LcAvila/grade_moldes/src/main/webapp/assets/images/pecas/_substituidas/187.png

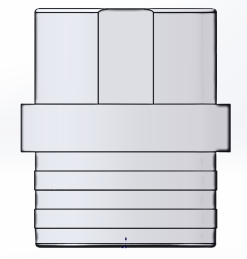
src/main/webapp/assets/images/pecas/_substituidas/187.png
