LcAvila/grade_moldes/src/main/webapp/assets/Produtos/00-00 - BASE DE DADOS/Embalagens/Caixas Master/Textura Papelão.png

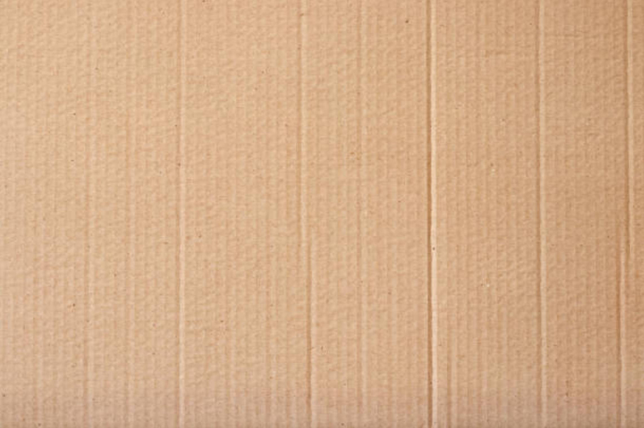
src/main/webapp/assets/Produtos/00-00 - BASE DE DADOS/Embalagens/Caixas Master/Textura Papelão.png
