LcAvila/grade_moldes/docs/desenhos-extraidos.md

# Desenhos extraídos das planilhas

Repositório: `C:\Users\Avila\AppData\Local\Temp\opencode\pastas`

| Molde | Peça injetada | Desenho da grade | Origem |
|---|---|---|---|
| **11A** | – | – | `C:\Users\Avila\AppData\Local\Temp\opencode\pastas\02-Cavidade não conforme\Colas\Bicos\Bico Frasco de Cola - Molde 11A\01-23.01.25 - Bico para frasco de cola 40g e 90g - 16 cav. - Molde 11A.xlsx` |
| **69** | – | – | `C:\Users\Avila\AppData\Local\Temp\opencode\pastas\02-Cavidade não conforme\Lapiseiras\Botões\Botão Lapiseira Turbo - 8 Cav - Molde 69\01-13.09.2018-Botão Lapiseira Turbo Plus - 8 Cav. - Molde 69.xls` |
| **81** | – | – | `C:\Users\Avila\AppData\Local\Temp\opencode\pastas\02-Cavidade não conforme\Reabastecedores\Anel\2017\03 - 28-04-17 - Anel Para Reabastecedor - 8 Cav. - Molde 81.xls` |
| **89** | – | – | `C:\Users\Avila\AppData\Local\Temp\opencode\pastas\02-Cavidade não conforme\Lapiseiras\Corpos\Corpo Lapiseira Aluno - 16 Cav - Molde 89\2019\01-05.02.19-Corpo Lapiseira Aluno - 16 Cav. - Molde 89.xls` |
| **97** | assets/images/pecas/97.png (1920×1080) | assets/desenhos/97-grade.svg (356×365) | `02-Cavidade não conforme\Esferográficas\Tampinhas\Tampinha Esf. - 64 Cav - Molde 97\2023\06- 21.07.23-Tampinha Esferográfica - Molde 97.xls` |
| **98** | assets/images/pecas/98.png (235×240) | assets/desenhos/98-grade.svg (356×365) | `02-Cavidade não conforme\Esferográficas\Conexão\Conexão Esf. - 64 Cav-Molde 98\2024\06-11.11.24-Conexão Esf. - 64 cav. - Molde 98.xls` |
| **101** | assets/images/pecas/101.png (1920×1080) | assets/desenhos/101-grade.svg (356×365) | `02-Cavidade não conforme\Hidrográficas\Tampinha\Tampinha Hidrog. Neo Pen - 64 Cav - Mol.101\2025\18-05.12.24-Tampinha Neo Pen - Molde 101.xls` |
| **107** | – | – | `C:\Users\Avila\AppData\Local\Temp\opencode\pastas\02-Cavidade não conforme\Esferográficas\Tampas\Tampa Esf. Top- 64 Cav- Molde 107\2025\10 -04.04.25 -Tampa Esf. Top-Economic - 64 cav. - Molde 107.xls` |
| **108** | – | assets/desenhos/108-grade.svg (467×465) | `02-Cavidade não conforme\Esferográficas\Corpos\Corpo 07- 64Cav - Molde 108\2020\01-06.02.20-Corpo Esf. 07-Econ. - Molde 108.xls` |
| **109** | – | assets/desenhos/109-grade.svg (538×544) | `02-Cavidade não conforme\Hidrográficas\Tampinha\Tampinha Hidrog. Color - 48 Cav - Molde 109\2025\04-14.05.25-Tampinha Hidr. Color - 48 cav. - Molde 109 (PP).xls` |
| **110** | assets/images/pecas/110.png (776×322) | assets/desenhos/110-grade.svg (538×544) | `02-Cavidade não conforme\Hidrográficas\Tampa\Tampa Hidrog. Color - 48 Cav - Molde 110\2025\05-11.02.25- Tampa Hidr. Color - 48 cav. - Molde 110 -.xls` |
| **115** | – | – | `C:\Users\Avila\AppData\Local\Temp\opencode\pastas\02-Cavidade não conforme\Esferográficas\Corpos\Corpo 07- 64 Cav - Molde 115\2018\05-25.06.18-Corpo Esf. 07 - 64 Cav. - Molde 115.xls` |
| **116** | – | – | `C:\Users\Avila\AppData\Local\Temp\opencode\pastas\02-Cavidade não conforme\Marcadores\Corpos Marcadores\Corpo Marcador Pincel - 16 Cav - Molde 116\2019\07-08.07.19-Corpo Pincel Permanente. - 16 cav. - Molde 116.xlsx` |
| **116A** | – | – | `C:\Users\Avila\AppData\Local\Temp\opencode\pastas\02-Cavidade não conforme\Marcadores\Corpos Marcadores\Corpo Marcador Q.B. - 16 Cav - Molde 116A\2025\02- 16.01.25 - Corpo Marcador Q.B. - 16 cav. - Molde 116A.xlsx` |
| **117** | – | – | `C:\Users\Avila\AppData\Local\Temp\opencode\pastas\02-Cavidade não conforme\Esferográficas\Tampas\Tampa Esf. 07- 64 Cav - Molde 117\2024\03-08.07.24-Tampa Esf. 07 - 64 cav. - Molde 117.xls` |
| **120** | – | assets/desenhos/120-grade.svg (467×465) | `02-Cavidade não conforme\Hidrográficas\Corpo\Corpo Hidrog. HNG - 64 Cav - Molde 120\2020\06-20.08.20-Corpo Hid. Neo Pen Gigante - 64 cav. - Molde 120.xls` |
| **121** | – | – | `C:\Users\Avila\AppData\Local\Temp\opencode\pastas\02-Cavidade não conforme\Hidrográficas\Corpo\Corpo Hidrog. HNM - 64 Cav - Molde 121\2025\05-23.05.25- Corpo Hid. Neo Pen Mirim - 64 cav. - Molde 121.xls` |
| **122** | – | – | `C:\Users\Avila\AppData\Local\Temp\opencode\pastas\02-Cavidade não conforme\Hidrográficas\Tampa\Tampa Hidrog. Neo Pen - 48 Cav - Molde 122\2025\04- 04.06.25- Tampa Neo Pen - 48 cav. - Molde 122.xls` |
| **128** | assets/images/pecas/128.png (1920×1080) | – | `02-Cavidade não conforme\Diversos\Apagador - Molde 128\2023\01-03.10.23-Apagador para Q.B. - 1 cav. - Molde 128.xlsx` |
| **129** | – | assets/desenhos/129-grade.svg (602×401) | `02-Cavidade não conforme\Colas\Tampas\Tampa para Cola 1000g - Molde 129\01-10-04-2025-Tampa para frasco de cola 500g e 1000g - 4 cav.xlsx` |
| **137** | – | – | `C:\Users\Avila\AppData\Local\Temp\opencode\pastas\02-Cavidade não conforme\Lapiseiras\Corpos\Corpo Lapiseira Turbo - 8 Cav - Molde 137\2018\02-16.03.18-Corpo Lapiseira Turbo Plus - 08 Cav. - Molde 137.xls` |
| **138** | – | – | `C:\Users\Avila\AppData\Local\Temp\opencode\pastas\02-Cavidade não conforme\Esferográficas\Corpos\Corpo Top - 64 Cav - Molde 138\2018\06-20.09.18-Corpo Esf. Top - 64 Cav. - Molde 138.xls` |
| **139** | – | – | `C:\Users\Avila\AppData\Local\Temp\opencode\pastas\02-Cavidade não conforme\Esferográficas\Tampas\Tampa Esf. Top- 64 Cav - Molde 139\2025\04-09.06.25-Tampa Esf. Top-Economic - 64 cav. - Molde 139.xls` |
| **140** | assets/images/pecas/140.png (1920×1080) | assets/desenhos/140-grade.svg (356×365) | `02-Cavidade não conforme\Esferográficas\Tampinhas\Tampinha Esf. - 64 Cav - Molde 140\2024\04-02.09.24 - Tampinha Esferográfica - Molde 140.xls` |
| **143** | – | assets/desenhos/143-grade.svg (467×465) | `02-Cavidade não conforme\Esferográficas\Corpos\Corpo 07-Economic - 64 Cav - Molde 143\2020\01-09.12.19Corpo Esf. 07-Econ. - Molde 143.xls` |
| **144** | – | – | `C:\Users\Avila\AppData\Local\Temp\opencode\pastas\02-Cavidade não conforme\Hidrográficas\Corpo\Corpo Hidrog. HNG - 64 Cav - Molde 144\2016\02-22-02-16-Corpo NPG-64Cav-Mol 144-Lamb 47-21-1.xls` |
| **145A** | – | – | `C:\Users\Avila\AppData\Local\Temp\opencode\pastas\02-Cavidade não conforme\Colas\Tampas\Tampa para Cola 40 e 90g - Molde 145A\06 - 16.06.25- Tampa para frasco de cola 40g e 90g - 16 cav. - Molde 145A.xlsx` |
| **145B** | – | – | `C:\Users\Avila\AppData\Local\Temp\opencode\pastas\02-Cavidade não conforme\Marcadores\Tampas Marcadores\Tampa Marcador Pincel - 16 Cav - Molde 145B\2025\03 - 19.03.25 - Tampa Pincel - 16 cav. - Molde 145B.xlsx` |
| **145C** | – | – | `C:\Users\Avila\AppData\Local\Temp\opencode\pastas\02-Cavidade não conforme\Marcadores\Tampinhas Marcadores\Tampinha Marc. Pincel e Q.B. - 16 Cav - Molde 145C\2025\03 - 03.06.25 - Tampinha Pincel-Q.B. - 16 cav. - Molde 145C.xlsx` |
| **145D** | – | – | `C:\Users\Avila\AppData\Local\Temp\opencode\pastas\02-Cavidade não conforme\Reabastecedores\Tampas\Tampa p- Reabastecedor Q.B.- 16 Cav-Molde 145D\2024\05-29.11.24-Tampa Reab. Q.B. - 16 cav. - Molde 145D.xlsx` |
| **145E** | – | – | `C:\Users\Avila\AppData\Local\Temp\opencode\pastas\02-Cavidade não conforme\Reabastecedores\Tampas\Tampa p- Reabastecedor Pincel- 16 Cav-Molde 145E\2025\01-09.06.25 -Tampa Reab. Pincel - Molde 145E.xlsx` |
| **146** | assets/images/pecas/146.png (1920×1080) | assets/desenhos/146-grade.svg (356×365) | `02-Cavidade não conforme\Hidrográficas\Tampinha\Tampinha Hidrog. Neo Pen - 64 Cav - Mol.146\2024\06-07.10.24-Tampinha Neo Pen - Molde 146.xls` |
| **147A** | – | – | `C:\Users\Avila\AppData\Local\Temp\opencode\pastas\02-Cavidade não conforme\Hidrográficas\Tampa\Tampa Hidrog. Color - 32 Cav - Molde 147A\2024\02- 18.12.24 - Tampa Hidr. Color - 32 cav. - Molde 147A.xls` |
| **147B** | – | – | `C:\Users\Avila\AppData\Local\Temp\opencode\pastas\02-Cavidade não conforme\Hidrográficas\Tampinha\Tampinha Hidrog. Color - 32 Cav - Molde 147B\2025\01-29.10.22-Tampinha Hidr. Color - 32 cav. - Molde 147B.xls` |
| **148** | assets/images/pecas/148.png (1920×1080) | – | `02-Cavidade não conforme\Hidrográficas\Corpo\Corpo Hidrog. Color - 64 Cav - Molde 148\2025\02 - 12.02.25 - Corpo Hid. Color - 64 cav. - Molde 148.xls` |
| **150** | assets/images/pecas/150.png (709×258) | – | `02-Cavidade não conforme\Hidrográficas\Microline\Conexão Microline - 16 Cav- Molde 150\2025\04-17.06.25-Conexão Microline - 16 cav. - Molde 150.xlsx` |
| **151** | – | – | `C:\Users\Avila\AppData\Local\Temp\opencode\pastas\02-Cavidade não conforme\Hidrográficas\Microline\Tampinha Microline - 16 Cav - Molde 151\2025\02- 06.02.25- Tampinha Microline - 16 cav. - Molde 151.xlsx` |
| **152** | – | – | `C:\Users\Avila\AppData\Local\Temp\opencode\pastas\02-Cavidade não conforme\Hidrográficas\Microline\Tampa Microline - 16 Cav - Molde 152\2020\04-18.11.20-Tampa Hidr. Microline - 16 cav. - Molde 152.xlsx` |
| **153** | – | – | `C:\Users\Avila\AppData\Local\Temp\opencode\pastas\02-Cavidade não conforme\Esferográficas\Corpos\Corpo 07 Plus- 16 Cav - Molde 153\2019\02-08-05-2019 - Corpo Esf. 07 Plus - 16 cav. - Molde 153.xlsx` |
| **154** | assets/images/pecas/154.png (1249×702) | – | `02-Cavidade não conforme\Esferográficas\Tampas\Tampa Esf. 07 Plus- 16 Cav- Molde 154\2019\02-11.03.19-Tampa Esf. 07 Plus - 16 cav. - Molde 154.xlsx` |
| **156** | assets/images/pecas/156.png (1920×1080) | assets/desenhos/156-grade.svg (885×537) | `02-Cavidade não conforme\Esferográficas\Tampinhas\Tampinha Esf. - 16 Cav - Molde 156\2020\01-06-08-20-Tampinha Esf. - 16 cav. - Molde 156.xlsx` |
| **157** | assets/images/pecas/157.png (1920×1080) | – | `02-Cavidade não conforme\Reabastecedores\Bico\Bico p- Reabastecedor - 16 Cav - Molde 157\2025\01-25.01.25-Bico para reabastecedor - 16 cav. - Molde 157.xlsx` |
| **158** | – | – | `C:\Users\Avila\AppData\Local\Temp\opencode\pastas\02-Cavidade não conforme\Lapiseiras\Botões\Botão Lapiseira Técnico - 16 Cav - Molde 158\2024\02-20.08.24 - Botão lapiseira Técnico - 16 cav. - Molde 158.xlsx` |
| **159** | – | – | `C:\Users\Avila\AppData\Local\Temp\opencode\pastas\02-Cavidade não conforme\Lapiseiras\Corpos\Corpo Lapiseira Técnico - 16 Cav - Molde 159\2024\02-07.08.24-Corpo Lap. Técnico - 16 cav. - Molde 159.xlsx` |
| **160** | – | – | `C:\Users\Avila\AppData\Local\Temp\opencode\pastas\02-Cavidade não conforme\Lapiseiras\Dianteiras\Dianteira Lapiseira Técnico - 16 Cav-Molde 160\2024\03-29.10.24-Dianteira Lap. Técnico - 16 cav. - Molde 160.xlsx` |
| **161** | – | – | `C:\Users\Avila\AppData\Local\Temp\opencode\pastas\02-Cavidade não conforme\Marcadores\Tampas Marcadores\Tampa Marcador Q.B. - 12 Cav-Molde 161\2017\01-04.01.17-Tampa MarcQ.B. - 12 Cav. - Molde 161.xls` |
| **162** | – | – | `C:\Users\Avila\AppData\Local\Temp\opencode\pastas\02-Cavidade não conforme\Marcadores\Tampas Marcadores\Tampa Marcador Destaq - 16 Cav - Molde 162\2025\03-05.06.25-Tampa Marc. Destaq - 16 cav.xlsx` |
| **163** | – | – | `C:\Users\Avila\AppData\Local\Temp\opencode\pastas\02-Cavidade não conforme\Marcadores\Tampinhas Marcadores\Tampinha Marcador Destaq - 16 Cav - Molde 163\2025\01 - 21.01.25 - Tampinha Marc. Destaq - 16 cav. - Molde 163.xlsx` |
| **164** | – | – | `C:\Users\Avila\AppData\Local\Temp\opencode\pastas\02-Cavidade não conforme\Marcadores\Corpos Marcadores\Corpo Marcador Destaq - 16 Cav - Molde 164\2025\04-06.06.25-Corpo Marc. Destaq - 16 cav.xlsx` |
| **165** | – | assets/desenhos/165-grade.svg (534×519) | `02-Cavidade não conforme\Esferográficas\Corpos\Corpo 07- 64 Cav - Molde 165\2025\01- 25.02.25-Corpo Esf. 07-Econ. - Molde 165.xls` |
| **167** | – | – | `C:\Users\Avila\AppData\Local\Temp\opencode\pastas\02-Cavidade não conforme\Esferográficas\Tampinhas\Tampinha Esf. - 64 Cav - Molde 167\2014\01-25-11-2014-Tampinha Esf. -64Cav.-Mol.167-Cor.SW 1308.xls` |
| **167A** | assets/images/pecas/167A.png (240×241) | assets/desenhos/167A-grade.svg (356×365) | `02-Cavidade não conforme\Esferográficas\Conexão\Conexão Esf. - 64 Cav. Molde 167A\2024\04 - 03.10.24 - Conexão Esf. - 64 cav. - Molde 167A -.xls` |
| **168** | – | assets/desenhos/168-grade.svg (356×365) | `02-Cavidade não conforme\Esferográficas\Conexão\Conexão Esf. - 64 Cav-Molde 168\2024\01-24.04.24-Conexão Esf. - 64 cav. - Molde 168.xls` |
| **169** | – | – | `C:\Users\Avila\AppData\Local\Temp\opencode\pastas\02-Cavidade não conforme\Hidrográficas\Tampa\Tampa Hidrog. Neo Pen - 64 Cav - Molde 169\2025\04-17.06.25-Tampa Neo Pen - 64 cav. - Molde 169 - - - Copia.xls` |
| **173** | assets/images/pecas/173.png (1034×331) | – | `02-Cavidade não conforme\Hidrográficas\Esferográficas Especiais\Tampa Tinteiro- 8 Cav - Molde 173\22-03-2022-Tampa para Esf. Tinteiro - 8 cav. - Molde 173.xlsx` |
| **181** | – | – | `C:\Users\Avila\AppData\Local\Temp\opencode\pastas\02-Cavidade não conforme\Esferográficas\Tampas\Tampa Esf. 07- 64 Cav - Molde 181\2025\04- 15.05.25- Tampa Esf. 07 - 64 cav. - Molde 181.xls` |
| **183** | – | – | `C:\Users\Avila\AppData\Local\Temp\opencode\pastas\02-Cavidade não conforme\Esferográficas\Corpos\Corpo 07 Vip retrátil - 24 Cav - molde 183\2025\02-22.02.25- Corpo 07 Esf. 07 Vip retrátil - 24 cav - Copia.xls` |
| **184** | – | – | `C:\Users\Avila\AppData\Local\Temp\opencode\pastas\02-Cavidade não conforme\Esferográficas\Clip Esf 07 VIP Retrátil - 24 Cav - Molde 184\2025\01-07.02.25- Clip Esf. 07 Vip retrátil - 24 cav. - Molde 184.xls` |
| **185** | – | – | `C:\Users\Avila\AppData\Local\Temp\opencode\pastas\02-Cavidade não conforme\Esferográficas\Botão Vip\2025\01-18.01.25- Botão Esf. 07 Vip retrátil - 24 cav. - Molde 185.xls` |
| **186** | assets/images/pecas/186.png (1000×230) | – | `02-Cavidade não conforme\Esferográficas\Estojo Magister - 8 cav. - Molde 186\05- 31.01.25 - Corpo de estojo Magister - 8 cav. - Molde 186.xlsx` |
| **187** | assets/images/pecas/187.png (247×259) | – | `02-Cavidade não conforme\Esferográficas\Conector para estojo Magister - Molde 187\08-24-01-25-Conector para estojo de esferográfica - Molde 187.xlsx` |
| **188** | – | – | `C:\Users\Avila\AppData\Local\Temp\opencode\pastas\02-Cavidade não conforme\Colas\Bicos\Bico Para Frasco de Cola - 16 Cav. - Molde 188\05-15.05.25 - Bico para frasco de cola 40g e 90g - 16 cav. - Molde 188.xlsx` |
| **189** | assets/images/pecas/189.png (1129×623) | – | `02-Cavidade não conforme\Marcadores\Tampas Marcadores\Tampa Marcador Q.B. - 16 Cav. - Molde 189\2025\03-21.05.25-Tampa Marc. Q.B. - 16 cav. - Molde 189.xlsx` |
| **190** | – | assets/desenhos/190-grade.svg (534×519) | `02-Cavidade não conforme\Esferográficas\Corpos\Corpo Top - 64 Cav - Molde 190\2025\03-26.05.25-Corpo Esf. Top-Jet Lux - Molde 190.xls` |
| **191** | – | – | `C:\Users\Avila\AppData\Local\Temp\opencode\pastas\02-Cavidade não conforme\Marcadores\Corpos Marcadores\Corpo Marcador Pincel - 16 Cav - Molde 191\2025\02-12.02.25- Corpo Pincel Permanente. - 16 cav. - Molde 191 -.xlsx` |
| **192** | – | assets/desenhos/192-grade.svg (534×519) | `02-Cavidade não conforme\Esferográficas\Corpos\Corpo 07 - 64 cav - Molde 192\2025\03-11.02.25- Corpo Esf. 07 - 64 cav. - Molde  192.xls` |
| **193** | – | – | `C:\Users\Avila\AppData\Local\Temp\opencode\pastas\02-Cavidade não conforme\Hidrográficas\Microline\Tampa Microline - 32 Cav - Molde 193\2025\01-17.01.25-Tampa Hidr. Microline - 32 cav. - Molde 193.xls` |
| **194** | – | assets/desenhos/194-grade.svg (534×519) | `02-Cavidade não conforme\Hidrográficas\Corpo\Corpo Hidrog. HNG - 64 Cav - Molde 194\2024\06-21.03.24- Corpo Hid. Neo Pen Gigante - 64 cav. - Molde 194.xls` |
| **195** | – | – | `C:\Users\Avila\AppData\Local\Temp\opencode\pastas\02-Cavidade não conforme\Hidrográficas\Corpo\Corpo Hidrog. HNM - 64 Cav - Molde 195\2022\08-21.09.2022-Corpo Hid. Neo Pen Mirim - 64 cav. - Molde 195.xls` |
| **197** | – | assets/desenhos/197-grade.svg (534×519) | `02-Cavidade não conforme\Esferográficas\Corpos\Corpo 07 - 64 cav - Molde 197\2025\01-05.02.25-Corpo Esf. 07-Econ. - Molde 197.xls` |
| **199** | – | assets/desenhos/199-grade.svg (534×519) | `02-Cavidade não conforme\Hidrográficas\Corpo\Corpo Hidrog. HNG - 64 Cav - Molde 199\2025\06-11.06.25-Corpo Hid. Neo Pen Gigante - 64 cav. - Molde 199.xls` |
| **200** | – | assets/desenhos/200-grade.svg (554×550) | `02-Cavidade não conforme\Esferográficas\Conexão\Conexão Esf. - 96 Cav-Molde 200\03-17-04-2025-Conexão Esf. - 96 cav. - Molde 200.xlsx` |
| **202** | – | – | `C:\Users\Avila\AppData\Local\Temp\opencode\pastas\02-Cavidade não conforme\Colas\Arruela\01-22-11-23-Arruela de vedação para cola - 2 cav. - Molde 202.xlsx` |
