LcAvila/grade_moldes/src/main/webapp/assets/images/molde 188/informações bico cola molde 188.txt

BICO PARA FRASCO DE COLA 40G E 90G					
Molde 188 - Compactor CEM-002					

Cota		Nomenclatura					
A		FURO MENOR					
A1		TOPO					
B		FURO MAIOR					
B1		DIÂMETRO DO FURO MAIOR					
C		DIÂMETRO MAIOR					
D		ANEL DE VEDAÇÃO
