LcAvila/grade_moldes/src/main/webapp/assets/images/molde 202/informações arruela molde 202.txt

Arruela de vedação					
Molde 202                                                           					

Legenda															
															
		Cota		Nomenclatura											
		A		DIÂMETRO MAIOR											
		B		DIÂMETRO MENOR
