LcAvila/grade_moldes/src/main/webapp/assets/Produtos/00-00 - BASE DE DADOS/Embalagens/Caixas Master/25.10.03.01-R00 - 16612 - Caixa Master N°01 (Paletização).pdf

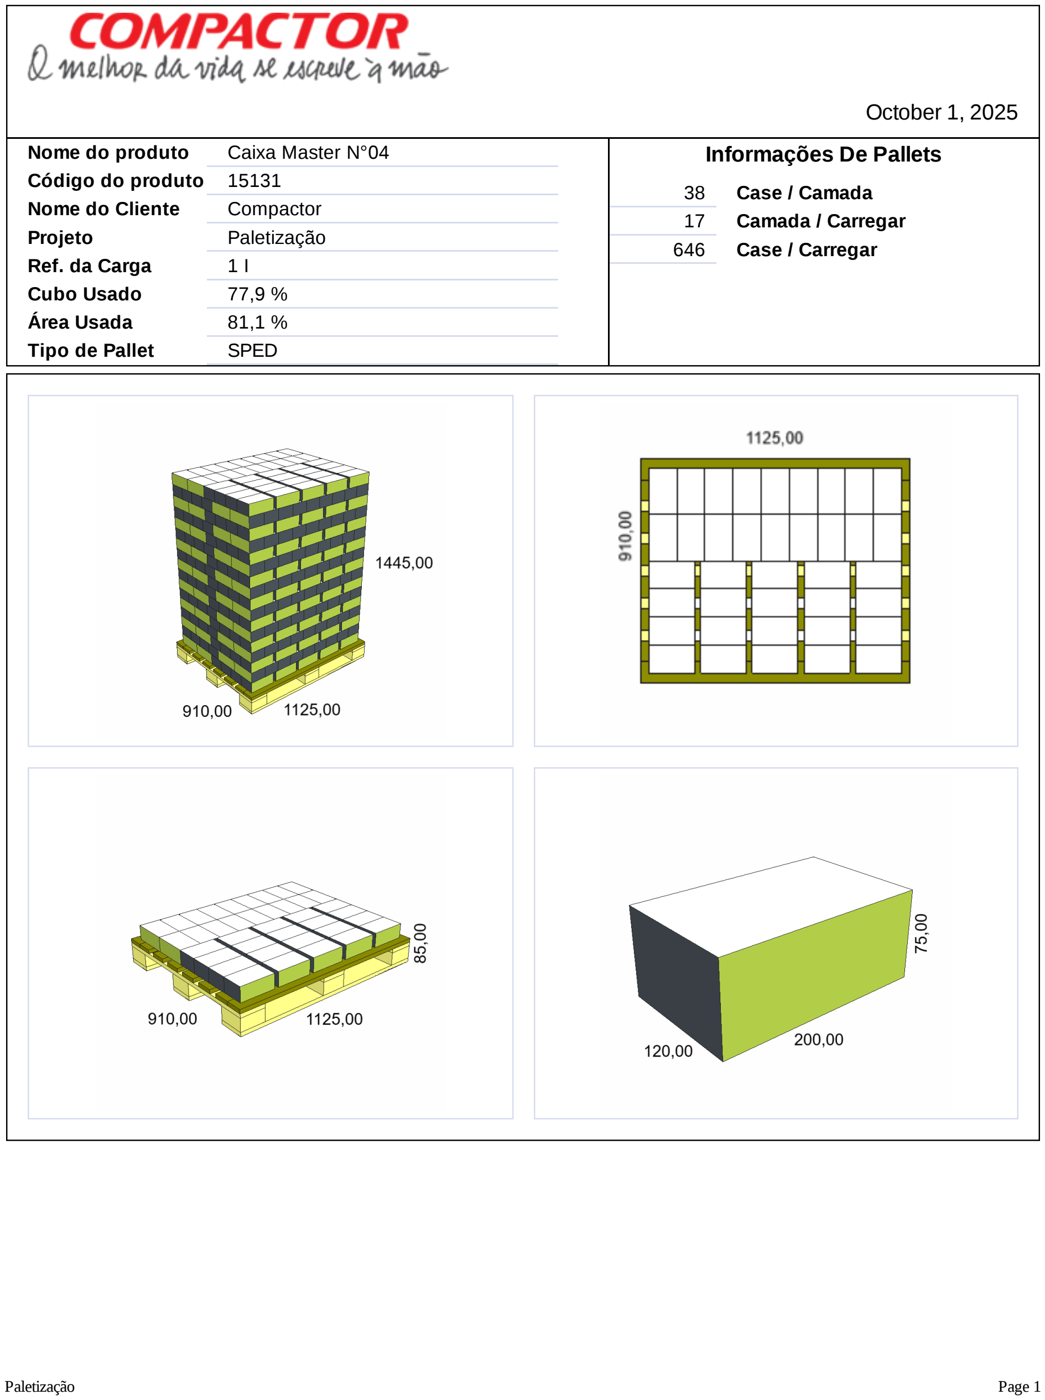
[picture p3: page 1]

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
age 1

O

c

t

o

b

e

r

1, 2

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
aixa

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
tizaçã

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
1 I Cubo Usado | 77,9
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
Paletização | Page 2
Dimensões | Peso
ComprimentLoargura | Altura | Líquido | Bruto
Case (ID) | 200,00 | 120,00 | 75,00 mm | 1,0000 kg | 1,5000 kg
Case (OD) | 205,00 | 125,00 | 85,00 mm | 1,0000 kg | 1,5000 kg
Produto | 1125,00 | 910,00 | 1445,00 mm | 646,0000 kg | 969,0000 kg
Carregar | 1200,00 | 1000,00 | 1590,00 mm | 969,0000 kg | 996,0000 kg
Suspensão | -37,50 | -45,00 | mm

Para uma caixa com C= ? cm, L= ? cm e A= ? cm feita com Papelão Ondulado onda B (resist. coluna: ? kgf/cm), contendo um peso máximo de ? kg/caixa, usada em mercado interno, temos:
:: Empilhamento máximo de ? caixas. Obs.: o empilhamento máximo foi limitado pela altura útil (empilhamento sem limitação: ? caixas)

:: O peso máximo suportado pela última caixa é de ? kg.
:: Estes cálculos são meramente orientativos.

Criador do Relatório : suporte@compactor.com.br
