LcAvila/grade_moldes/src/main/webapp/assets/Produtos/00-00 - BASE DE DADOS/Embalagens/Caixas Master/25.10.03.04-R00 - 15876 - Caixa Master N°06 (Paletização).pdf

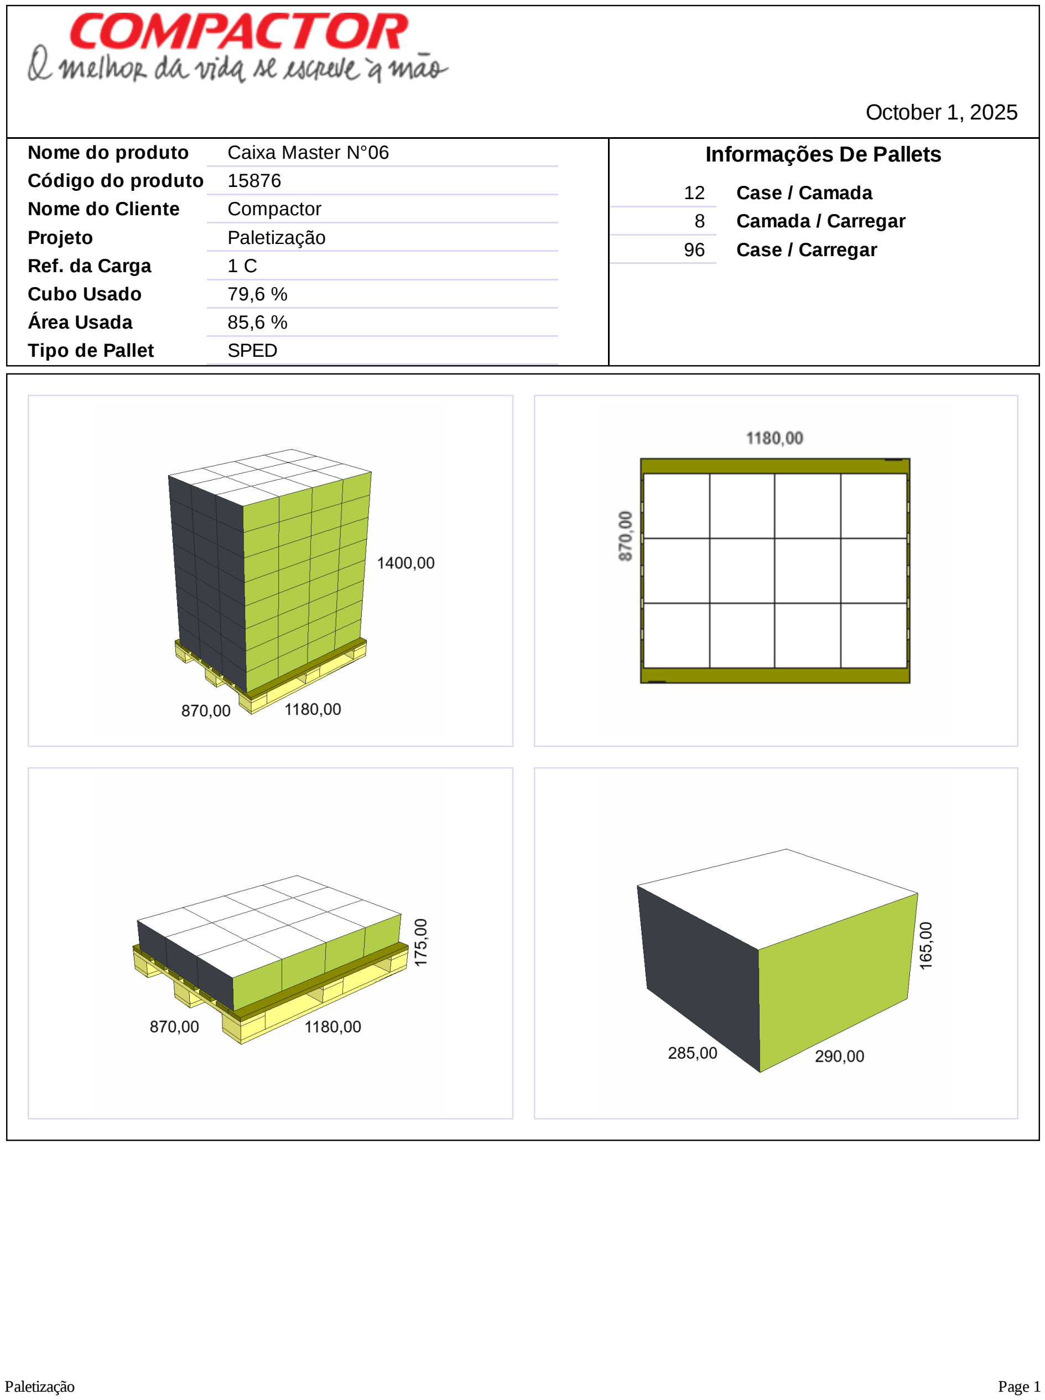
[picture p9: page 1]

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
age 1

O

c

t

o

b

e

r

1, 2

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
aixa

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
tizaçã

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
Paletização | Page 2
Dimensões | Peso
ComprimentLoargura | Altura | Líquido | Bruto
Case (ID) | 290,00 | 285,00 | 165,00 mm | 1,0000 kg | 1,5000 kg
Case (OD) | 295,00 | 290,00 | 175,00 mm | 1,0000 kg | 1,5000 kg
Produto | 1180,00 | 870,00 | 1400,00 mm | 96,0000 kg | 144,0000 kg
Carregar | 1200,00 | 1000,00 | 1545,00 mm | 144,0000 kg | 171,0000 kg
Suspensão | -10,00 | -65,00 | mm

Para uma caixa com C= ? cm, L= ? cm e A= ? cm feita com Papelão Ondulado onda B (resist. coluna: ? kgf/cm), contendo um peso máximo de ? kg/caixa, usada em mercado interno, temos:
:: Empilhamento máximo de ? caixas. Obs.: o empilhamento máximo foi limitado pela altura útil (empilhamento sem limitação: ? caixas)

:: O peso máximo suportado pela última caixa é de ? kg.
:: Estes cálculos são meramente orientativos.

Criador do Relatório : suporte@compactor.com.br
