LcAvila/grade_moldes/src/main/webapp/assets/Produtos/00-00 - BASE DE DADOS/Embalagens/Caixas Master/25.10.03.08-R00 - 15836 - Caixa Master N°10 (Paletização).pdf

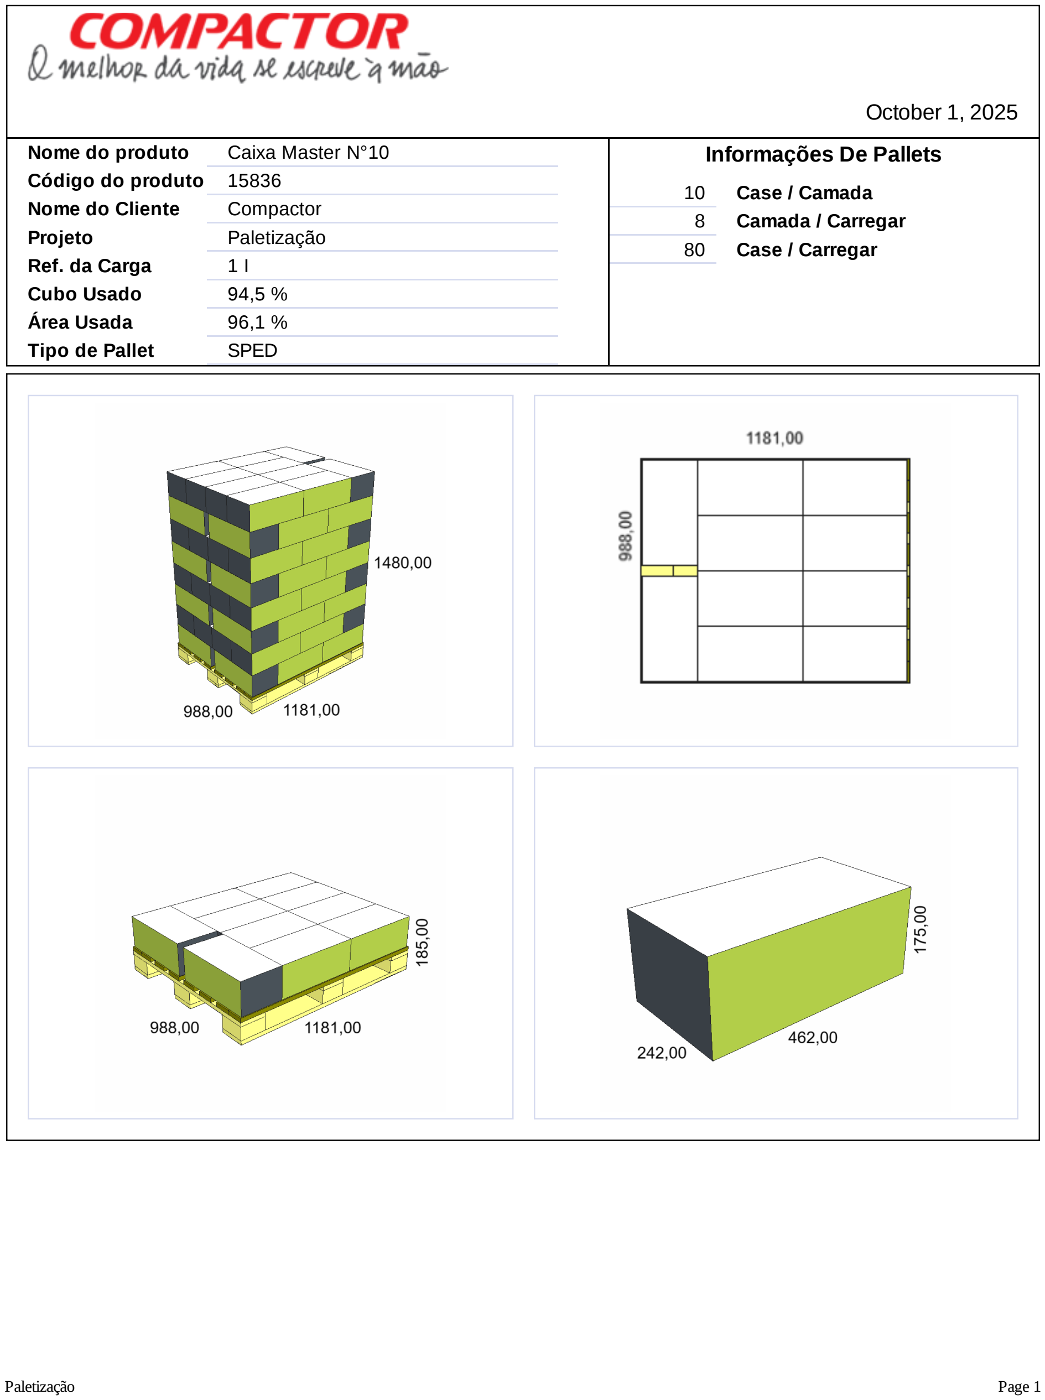
[picture p12: page 1]

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
age 1

O

c

t

o

b

e

r

1, 2

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
aixa

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
tizaçã

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
1 I Cubo Usado | 94,5
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
Paletização | Page 2
Dimensões | Peso
ComprimentLoargura | Altura | Líquido | Bruto
Case (ID) | 462,00 | 242,00 | 175,00 mm | 1,0000 kg | 1,5000 kg
Case (OD) | 467,00 | 247,00 | 185,00 mm | 1,0000 kg | 1,5000 kg
Produto | 1181,00 | 988,00 | 1480,00 mm | 80,0000 kg | 120,0000 kg
Carregar | 1200,00 | 1000,00 | 1625,00 mm | 120,0000 kg | 147,0000 kg
Suspensão | -9,50 | -6,00 | mm

Para uma caixa com C= ? cm, L= ? cm e A= ? cm feita com Papelão Ondulado onda B (resist. coluna: ? kgf/cm), contendo um peso máximo de ? kg/caixa, usada em mercado interno, temos:
:: Empilhamento máximo de ? caixas. Obs.: o empilhamento máximo foi limitado pela altura útil (empilhamento sem limitação: ? caixas)

:: O peso máximo suportado pela última caixa é de ? kg.
:: Estes cálculos são meramente orientativos.

Criador do Relatório : suporte@compactor.com.br
