LcAvila/grade_moldes/src/main/webapp/assets/Produtos/00-00 - BASE DE DADOS/Embalagens/Caixas Master/25.10.03.09-R00 - 15124 - Caixa Master N°11 (Paletização).pdf

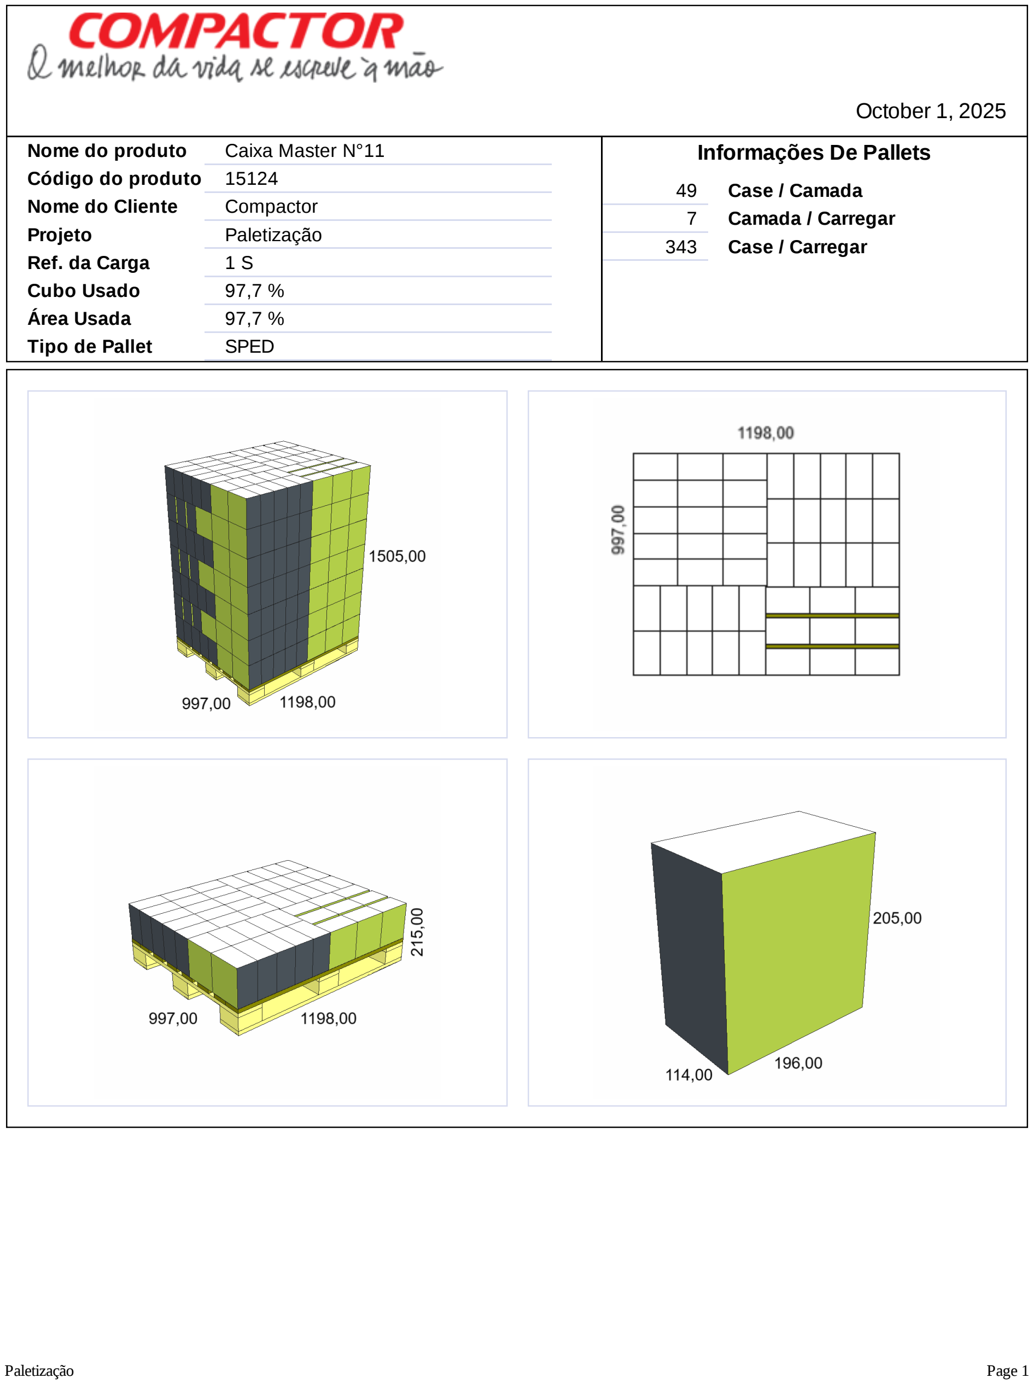
[picture p13: page 1]

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
age 1

O

c

t

o

b

e

r

1, 2

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
aixa

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
tizaçã

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
Paletização | Page 2
Dimensões | Peso
ComprimentLoargura | Altura | Líquido | Bruto
Case (ID) | 196,00 | 114,00 | 205,00 mm | 1,0000 kg | 1,5000 kg
Case (OD) | 201,00 | 119,00 | 215,00 mm | 1,0000 kg | 1,5000 kg
Produto | 1198,00 | 997,00 | 1505,00 mm | 343,0000 kg | 514,5000 kg
Carregar | 1200,00 | 1000,00 | 1650,00 mm | 514,5000 kg | 541,5000 kg
Suspensão | -1,00 | -1,50 | mm

Para uma caixa com C= ? cm, L= ? cm e A= ? cm feita com Papelão Ondulado onda B (resist. coluna: ? kgf/cm), contendo um peso máximo de ? kg/caixa, usada em mercado interno, temos:
:: Empilhamento máximo de ? caixas. Obs.: o empilhamento máximo foi limitado pela altura útil (empilhamento sem limitação: ? caixas)

:: O peso máximo suportado pela última caixa é de ? kg.
:: Estes cálculos são meramente orientativos.

Criador do Relatório : suporte@compactor.com.br
