LcAvila/grade_moldes/src/main/webapp/assets/Produtos/00-00 - BASE DE DADOS/Embalagens/Caixas Master/25.10.03.100-R00 - 17081 - Caixa Master N°120 (Paletização).pdf

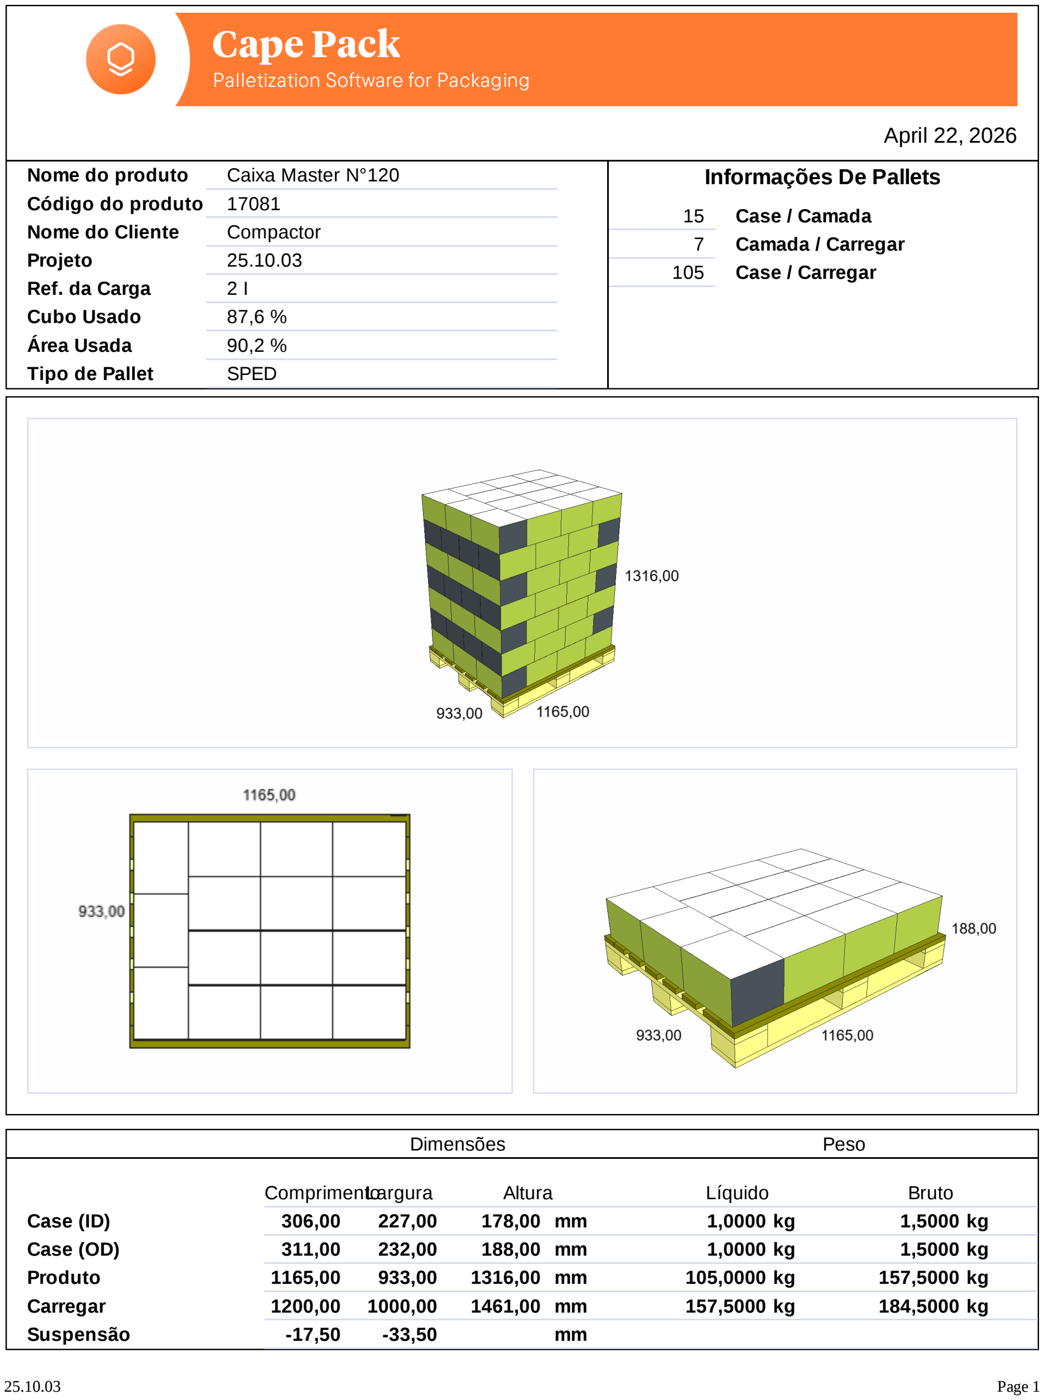
[picture p15: page 1]

25.10.03 | Page 1

April 22, 2026

Nome do produto Caixa Master N°120 Código do produto 17081
Nome do Cliente | Compactor
Projeto | 25.10.03
Ref. da Carga | 2 I
Cubo Usado | 87,6 %
Área Usada | 90,2 %
Tipo de Pallet | SPED

Informações De Pallets

15 | Case / Camada
7 | Camada / Carregar
105 | Case / Carregar
Dimensões | Peso
ComprimentLoargura | Altura | Líquido | Bruto
Case (ID) | 306,00 | 227,00 | 178,00 mm | 1,0000 kg | 1,5000 kg
Case (OD) | 311,00 | 232,00 | 188,00 mm | 1,0000 kg | 1,5000 kg
Produto | 1165,00 | 933,00 | 1316,00 mm | 105,0000 kg | 157,5000 kg
Carregar | 1200,00 | 1000,00 | 1461,00 mm | 157,5000 kg | 184,5000 kg
Suspensão | -17,50 | -33,50 | mm

25.10.03 | Page 2

Para uma caixa com C= ? cm, L= ? cm e A= ? cm feita com Papelão Ondulado onda B (resist. coluna: ? kgf/cm), contendo um peso máximo de ? kg/caixa, usada em mercado interno, temos:
:: Empilhamento máximo de ? caixas. Obs.: o empilhamento máximo foi limitado pela altura útil (empilhamento sem limitação: ? caixas)

:: O peso máximo suportado pela última caixa é de ? kg.
:: Estes cálculos são meramente orientativos.

Criador do Relatório : suporte@compactor.com.br
