LcAvila/grade_moldes/src/main/webapp/assets/Produtos/00-00 - BASE DE DADOS/Embalagens/Caixas Master/25.10.03.101-R00 - 17100 - Caixa Master N°121 (Paletização).pdf

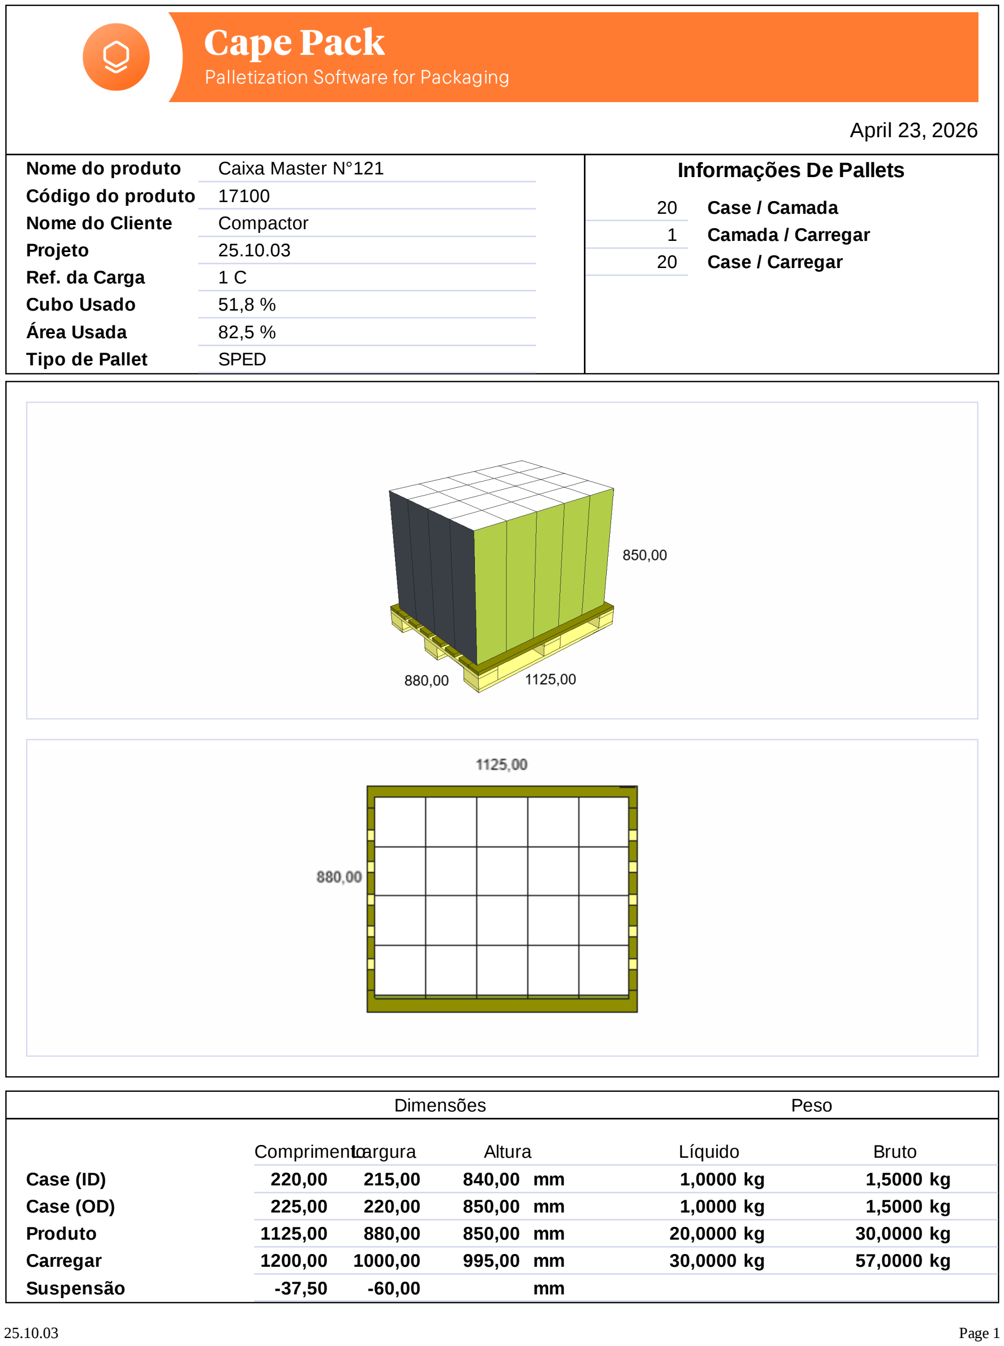
[picture p16: page 1]

25.10.03 | Page 1

April 23, 2026

Nome do produto Caixa Master N°121 Código do produto 17100
Nome do Cliente | Compactor
Projeto | 25.10.03
Ref. da Carga | 1 C
Cubo Usado | 51,8 %
Área Usada | 82,5 %
Tipo de Pallet | SPED

Informações De Pallets

20 | Case / Camada
1 | Camada / Carregar
20 | Case / Carregar
Dimensões | Peso
ComprimentLoargura | Altura | Líquido | Bruto
Case (ID) | 220,00 | 215,00 | 840,00 mm | 1,0000 kg | 1,5000 kg
Case (OD) | 225,00 | 220,00 | 850,00 mm | 1,0000 kg | 1,5000 kg
Produto | 1125,00 | 880,00 | 850,00 mm | 20,0000 kg | 30,0000 kg
Carregar | 1200,00 | 1000,00 | 995,00 mm | 30,0000 kg | 57,0000 kg
Suspensão | -37,50 | -60,00 | mm

25.10.03 | Page 2

Para uma caixa com C= ? cm, L= ? cm e A= ? cm feita com Papelão Ondulado onda B (resist. coluna: ? kgf/cm), contendo um peso máximo de ? kg/caixa, usada em mercado interno, temos:
:: Empilhamento máximo de ? caixas. Obs.: o empilhamento máximo foi limitado pela altura útil (empilhamento sem limitação: ? caixas)

:: O peso máximo suportado pela última caixa é de ? kg.
:: Estes cálculos são meramente orientativos.

Criador do Relatório : suporte@compactor.com.br
