LcAvila/grade_moldes/src/main/webapp/assets/Produtos/00-00 - BASE DE DADOS/Embalagens/Caixas Master/25.10.03.102-R00 - 17109 - Caixa Master N°122 (Paletização).pdf

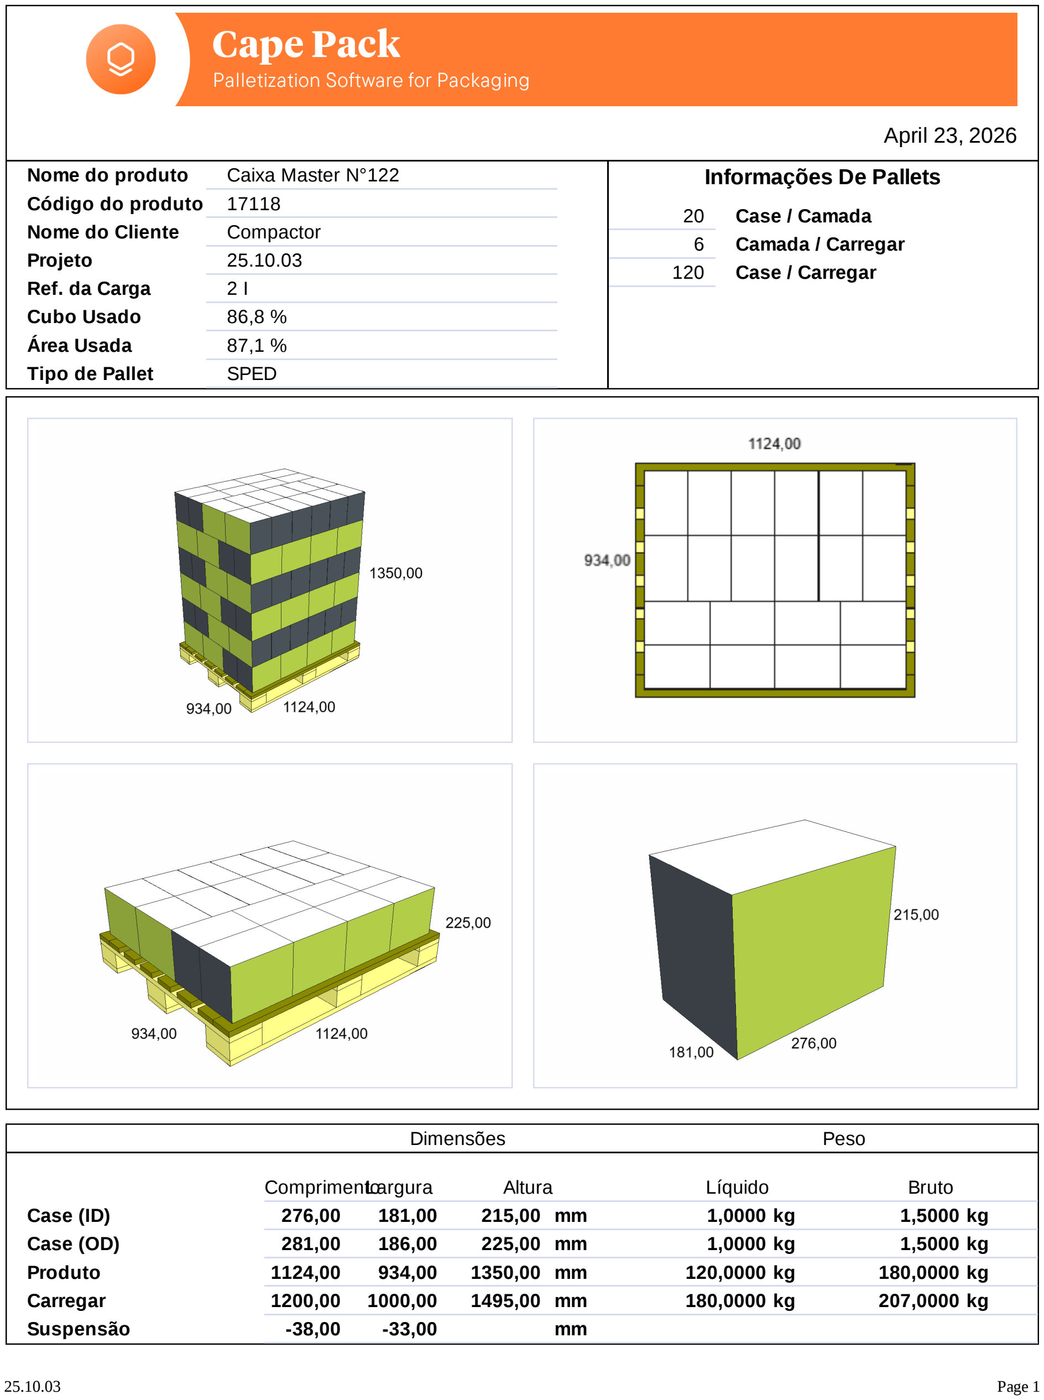
[picture p17: page 1]

25.10.03 | Page 1

April 23, 2026

Nome do produto Caixa Master N°122 Código do produto 17118
Nome do Cliente | Compactor
Projeto | 25.10.03
Ref. da Carga | 2 I
Cubo Usado | 86,8 %
Área Usada | 87,1 %
Tipo de Pallet | SPED

Informações De Pallets

20 | Case / Camada
6 | Camada / Carregar
120 | Case / Carregar
Dimensões | Peso
ComprimentLoargura | Altura | Líquido | Bruto
Case (ID) | 276,00 | 181,00 | 215,00 mm | 1,0000 kg | 1,5000 kg
Case (OD) | 281,00 | 186,00 | 225,00 mm | 1,0000 kg | 1,5000 kg
Produto | 1124,00 | 934,00 | 1350,00 mm | 120,0000 kg | 180,0000 kg
Carregar | 1200,00 | 1000,00 | 1495,00 mm | 180,0000 kg | 207,0000 kg
Suspensão | -38,00 | -33,00 | mm

25.10.03 | Page 2

Para uma caixa com C= ? cm, L= ? cm e A= ? cm feita com Papelão Ondulado onda B (resist. coluna: ? kgf/cm), contendo um peso máximo de ? kg/caixa, usada em mercado interno, temos:
:: Empilhamento máximo de ? caixas. Obs.: o empilhamento máximo foi limitado pela altura útil (empilhamento sem limitação: ? caixas)

:: O peso máximo suportado pela última caixa é de ? kg.
:: Estes cálculos são meramente orientativos.

Criador do Relatório : suporte@compactor.com.br
