LcAvila/grade_moldes/src/main/webapp/assets/Produtos/00-00 - BASE DE DADOS/Embalagens/Caixas Master/25.10.03.13-R00 - 15596 - Caixa Master N°16 (Paletização).pdf

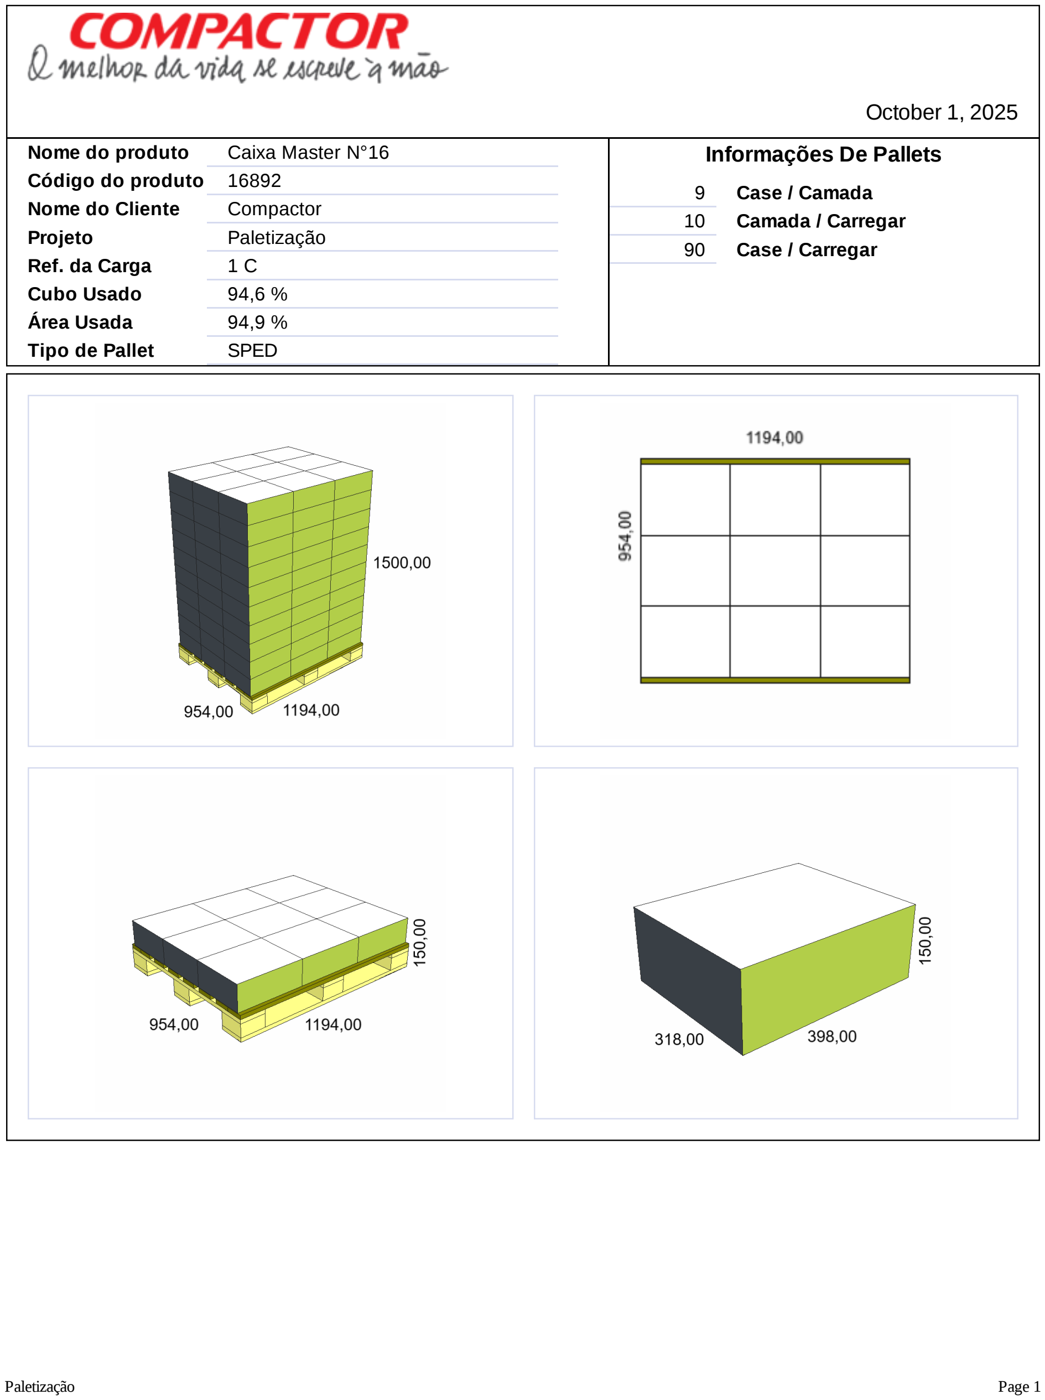
[picture p20: page 1]

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
age 1

O

c

t

o

b

e

r

1, 2

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
aixa

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
tizaçã

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
Paletização | Page 2
Dimensões | Peso
ComprimentLoargura | Altura | Líquido | Bruto
Case (ID) | 398,00 | 318,00 | 150,00 mm | 1,0000 kg | 1,5000 kg
Case (OD) | 398,00 | 318,00 | 150,00 mm | 1,0000 kg | 1,5000 kg
Produto | 1194,00 | 954,00 | 1500,00 mm | 90,0000 kg | 135,0000 kg
Carregar | 1200,00 | 1000,00 | 1645,00 mm | 135,0000 kg | 162,0000 kg
Suspensão | -3,00 | -23,00 | mm

Para uma caixa com C= ? cm, L= ? cm e A= ? cm feita com Papelão Ondulado onda B (resist. coluna: ? kgf/cm), contendo um peso máximo de ? kg/caixa, usada em mercado interno, temos:
:: Empilhamento máximo de ? caixas. Obs.: o empilhamento máximo foi limitado pela altura útil (empilhamento sem limitação: ? caixas)

:: O peso máximo suportado pela última caixa é de ? kg.
:: Estes cálculos são meramente orientativos.

Criador do Relatório : suporte@compactor.com.br
