LcAvila/grade_moldes/src/main/webapp/assets/Produtos/00-00 - BASE DE DADOS/Embalagens/Caixas Master/25.10.03.17-R00 - 15227 - Caixa Master N°20 (Paletização).pdf

P

a


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
age 1

O

c

t

o

b

e

r

1, 2

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
aixa

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
tizaçã

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
1 I Cubo Usado | 89,0
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
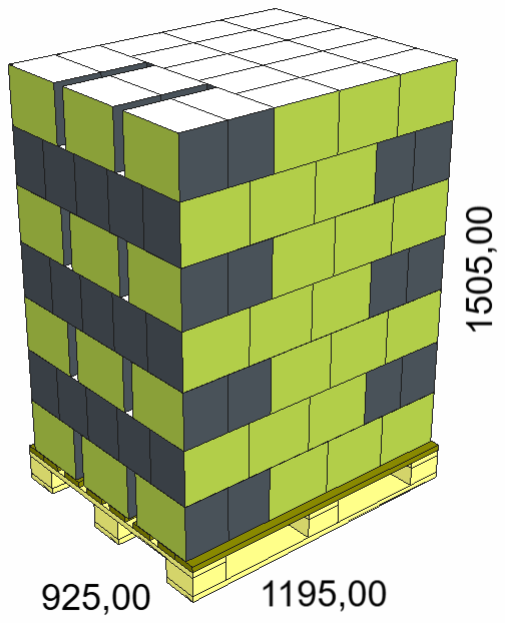
[picture p27: figure]
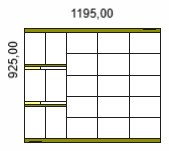
[picture p28: figure]
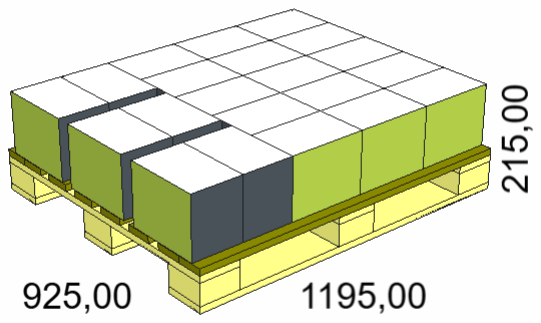
[picture p29: figure]
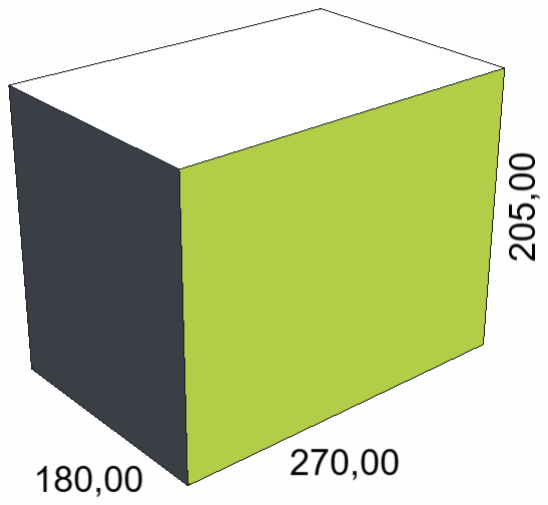
[picture p30: figure]

Paletização | Page 2
Dimensões | Peso
ComprimentLoargura | Altura | Líquido | Bruto
Case (ID) | 270,00 | 180,00 | 205,00 mm | 1,0000 kg | 1,5000 kg
Case (OD) | 275,00 | 185,00 | 215,00 mm | 1,0000 kg | 1,5000 kg
Produto | 1195,00 | 925,00 | 1505,00 mm | 147,0000 kg | 220,5000 kg
Carregar | 1200,00 | 1000,00 | 1650,00 mm | 220,5000 kg | 247,5000 kg
Suspensão | -2,50 | -37,50 | mm

Para uma caixa com C= ? cm, L= ? cm e A= ? cm feita com Papelão Ondulado onda B (resist. coluna: ? kgf/cm), contendo um peso máximo de ? kg/caixa, usada em mercado interno, temos:
:: Empilhamento máximo de ? caixas. Obs.: o empilhamento máximo foi limitado pela altura útil (empilhamento sem limitação: ? caixas)

:: O peso máximo suportado pela última caixa é de ? kg.
:: Estes cálculos são meramente orientativos.

Criador do Relatório : suporte@compactor.com.br
