LcAvila/grade_moldes/src/main/webapp/assets/Produtos/00-00 - BASE DE DADOS/Embalagens/Caixas Master/25.10.03.18-R00 - 15904 - Caixa Master N°21 (Paletização).pdf

P

a


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
age 1

O

c

t

o

b

e

r

1, 2

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
aixa

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
tizaçã

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
1 I Cubo Usado | 77,6
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
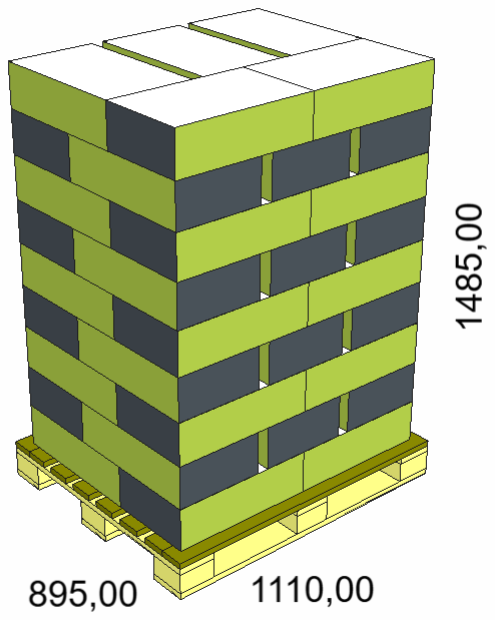
[picture p31: figure]
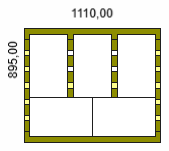
[picture p32: figure]
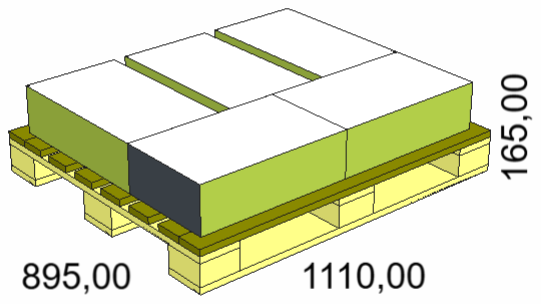
[picture p33: figure]
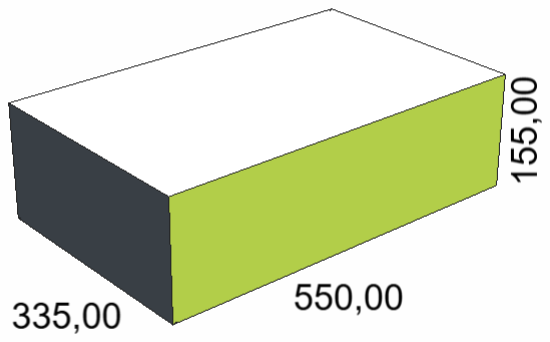
[picture p34: figure]

Paletização | Page 2
Dimensões | Peso
ComprimentLoargura | Altura | Líquido | Bruto
Case (ID) | 550,00 | 335,00 | 155,00 mm | 1,0000 kg | 1,5000 kg
Case (OD) | 555,00 | 340,00 | 165,00 mm | 1,0000 kg | 1,5000 kg
Produto | 1110,00 | 895,00 | 1485,00 mm | 45,0000 kg | 67,5000 kg
Carregar | 1200,00 | 1000,00 | 1630,00 mm | 67,5000 kg | 94,5000 kg
Suspensão | -45,00 | -52,50 | mm

Para uma caixa com C= ? cm, L= ? cm e A= ? cm feita com Papelão Ondulado onda B (resist. coluna: ? kgf/cm), contendo um peso máximo de ? kg/caixa, usada em mercado interno, temos:
:: Empilhamento máximo de ? caixas. Obs.: o empilhamento máximo foi limitado pela altura útil (empilhamento sem limitação: ? caixas)

:: O peso máximo suportado pela última caixa é de ? kg.
:: Estes cálculos são meramente orientativos.

Criador do Relatório : suporte@compactor.com.br
