LcAvila/grade_moldes/src/main/webapp/assets/Produtos/00-00 - BASE DE DADOS/Embalagens/Caixas Master/25.10.03.19-R00 - 15006 - Caixa Master N°22 (Paletização).pdf

P

a


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
age 1

O

c

t

o

b

e

r

1, 2

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
aixa

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
tizaçã

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
1 I Cubo Usado | 65,2
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
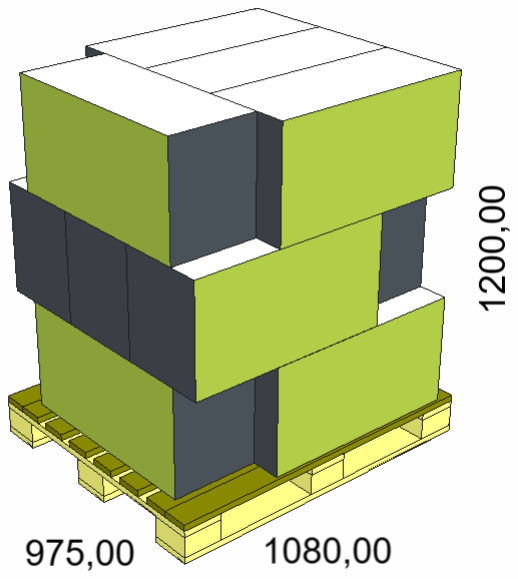
[picture p35: figure]
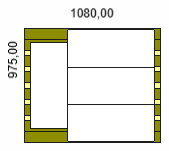
[picture p36: figure]
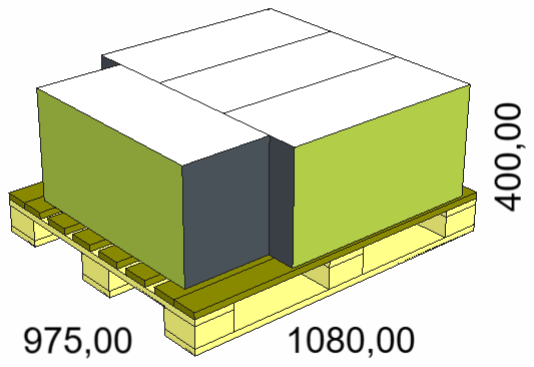
[picture p37: figure]
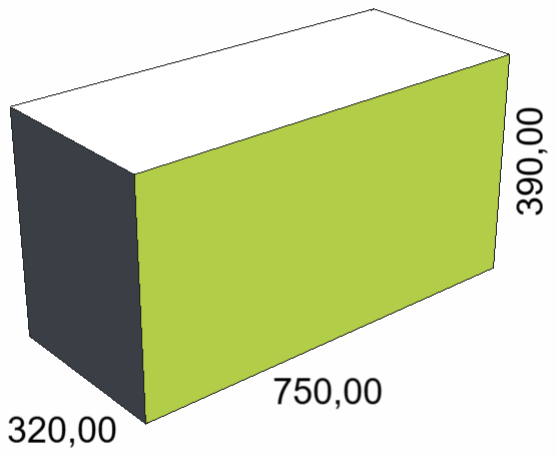
[picture p38: figure]

Paletização | Page 2
Dimensões | Peso
ComprimentLoargura | Altura | Líquido | Bruto
Case (ID) | 750,00 | 320,00 | 390,00 mm | 1,0000 kg | 1,5000 kg
Case (OD) | 755,00 | 325,00 | 400,00 mm | 1,0000 kg | 1,5000 kg
Produto | 1080,00 | 975,00 | 1200,00 mm | 12,0000 kg | 18,0000 kg
Carregar | 1200,00 | 1000,00 | 1345,00 mm | 18,0000 kg | 45,0000 kg
Suspensão | -60,00 | -12,50 | mm

Para uma caixa com C= ? cm, L= ? cm e A= ? cm feita com Papelão Ondulado onda B (resist. coluna: ? kgf/cm), contendo um peso máximo de ? kg/caixa, usada em mercado interno, temos:
:: Empilhamento máximo de ? caixas. Obs.: o empilhamento máximo foi limitado pela altura útil (empilhamento sem limitação: ? caixas)

:: O peso máximo suportado pela última caixa é de ? kg.
:: Estes cálculos são meramente orientativos.

Criador do Relatório : suporte@compactor.com.br
