LcAvila/grade_moldes/src/main/webapp/assets/Produtos/00-00 - BASE DE DADOS/Embalagens/Caixas Master/25.10.03.21-R00 - 15913 - Caixa Master N°24 (Paletização).pdf

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
age 1

O

c

t

o

b

e

r

1, 2

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
aixa

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
tizaçã

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
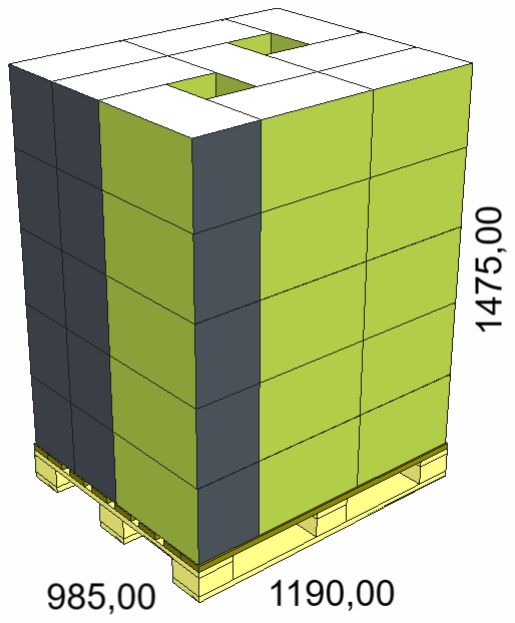
[picture p39: figure]
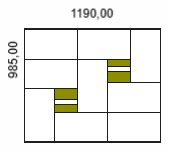
[picture p40: figure]
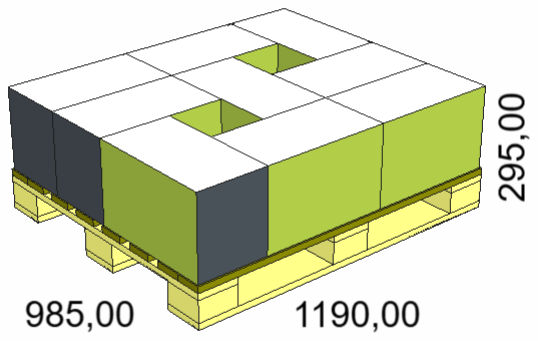
[picture p41: figure]
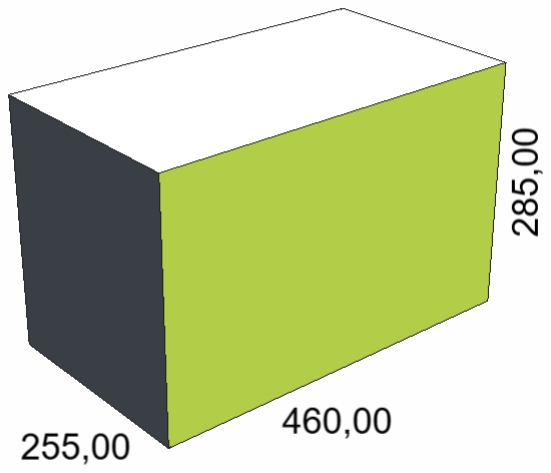
[picture p42: figure]

Paletização | Page 2
Dimensões | Peso
ComprimentLoargura | Altura | Líquido | Bruto
Case (ID) | 460,00 | 255,00 | 285,00 mm | 1,0000 kg | 1,5000 kg
Case (OD) | 465,00 | 260,00 | 295,00 mm | 1,0000 kg | 1,5000 kg
Produto | 1190,00 | 985,00 | 1475,00 mm | 45,0000 kg | 67,5000 kg
Carregar | 1200,00 | 1000,00 | 1620,00 mm | 67,5000 kg | 94,5000 kg
Suspensão | -5,00 | -7,50 | mm

Para uma caixa com C= ? cm, L= ? cm e A= ? cm feita com Papelão Ondulado onda B (resist. coluna: ? kgf/cm), contendo um peso máximo de ? kg/caixa, usada em mercado interno, temos:
:: Empilhamento máximo de ? caixas. Obs.: o empilhamento máximo foi limitado pela altura útil (empilhamento sem limitação: ? caixas)

:: O peso máximo suportado pela última caixa é de ? kg.
:: Estes cálculos são meramente orientativos.

Criador do Relatório : suporte@compactor.com.br
