LcAvila/grade_moldes/src/main/webapp/assets/Produtos/00-00 - BASE DE DADOS/Embalagens/Caixas Master/25.10.03.23-R00 - 15231 - Caixa Master N°26 (Paletização).pdf

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
age 1

O

c

t

o

b

e

r

1, 2

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
aixa

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
tizaçã

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
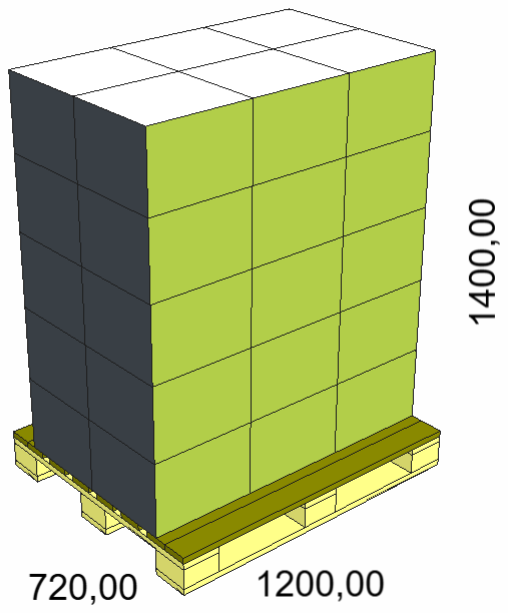
[picture p47: figure]
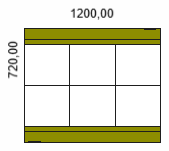
[picture p48: figure]
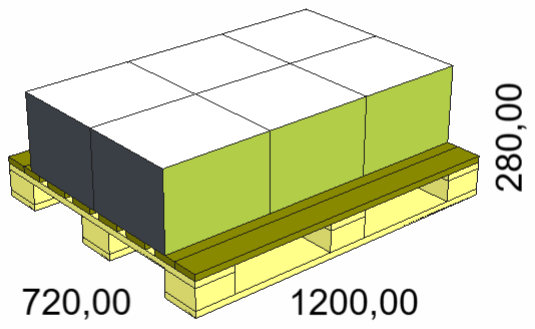
[picture p49: figure]
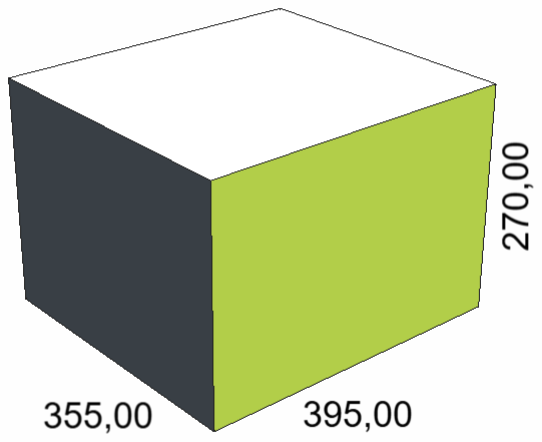
[picture p50: figure]

Paletização | Page 2
Dimensões | Peso
ComprimentLoargura | Altura | Líquido | Bruto
Case (ID) | 395,00 | 355,00 | 270,00 mm | 1,0000 kg | 1,5000 kg
Case (OD) | 400,00 | 360,00 | 280,00 mm | 1,0000 kg | 1,5000 kg
Produto | 1200,00 | 720,00 | 1400,00 mm | 30,0000 kg | 45,0000 kg
Carregar | 1200,00 | 1000,00 | 1545,00 mm | 45,0000 kg | 72,0000 kg
Suspensão | 0,00 | -140,00 | mm

Para uma caixa com C= ? cm, L= ? cm e A= ? cm feita com Papelão Ondulado onda B (resist. coluna: ? kgf/cm), contendo um peso máximo de ? kg/caixa, usada em mercado interno, temos:
:: Empilhamento máximo de ? caixas. Obs.: o empilhamento máximo foi limitado pela altura útil (empilhamento sem limitação: ? caixas)

:: O peso máximo suportado pela última caixa é de ? kg.
:: Estes cálculos são meramente orientativos.

Criador do Relatório : suporte@compactor.com.br
