LcAvila/grade_moldes/src/main/webapp/assets/Produtos/00-00 - BASE DE DADOS/Embalagens/Caixas Master/25.10.03.24-R00 - 15235 - Caixa Master N°27 (Paletização).pdf

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
age 1

O

c

t

o

b

e

r

1, 2

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
aixa

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
tizaçã

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
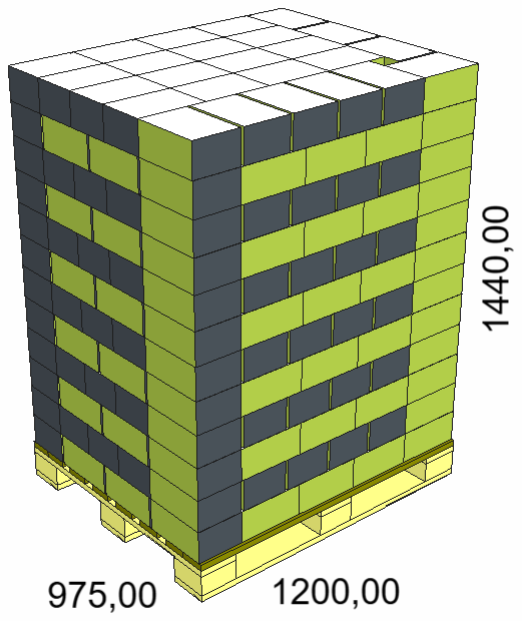
[picture p51: figure]
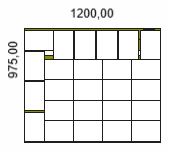
[picture p52: figure]
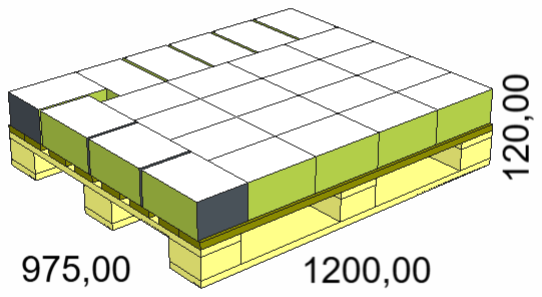
[picture p53: figure]
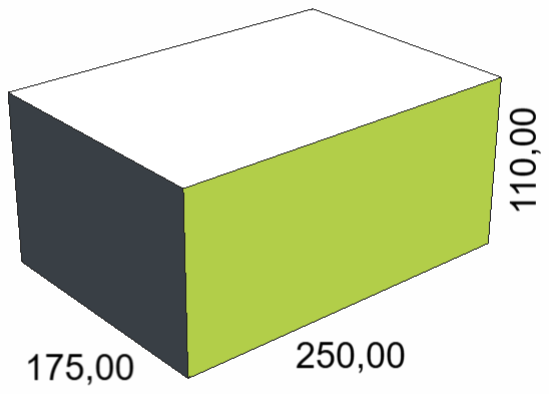
[picture p54: figure]

Paletização | Page 2
Dimensões | Peso
ComprimentLoargura | Altura | Líquido | Bruto
Case (ID) | 250,00 | 175,00 | 110,00 mm | 1,0000 kg | 1,5000 kg
Case (OD) | 255,00 | 180,00 | 120,00 mm | 1,0000 kg | 1,5000 kg
Produto | 1200,00 | 975,00 | 1440,00 mm | 300,0000 kg | 450,0000 kg
Carregar | 1200,00 | 1000,00 | 1585,00 mm | 450,0000 kg | 477,0000 kg
Suspensão | 0,00 | -12,50 | mm

Para uma caixa com C= ? cm, L= ? cm e A= ? cm feita com Papelão Ondulado onda B (resist. coluna: ? kgf/cm), contendo um peso máximo de ? kg/caixa, usada em mercado interno, temos:
:: Empilhamento máximo de ? caixas. Obs.: o empilhamento máximo foi limitado pela altura útil (empilhamento sem limitação: ? caixas)

:: O peso máximo suportado pela última caixa é de ? kg.
:: Estes cálculos são meramente orientativos.

Criador do Relatório : suporte@compactor.com.br
