LcAvila/grade_moldes/src/main/webapp/assets/Produtos/00-00 - BASE DE DADOS/Embalagens/Caixas Master/25.10.03.27-R00 - 15007 - Caixa Master N°30 (Paletização).pdf

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
age 1

O

c

t

o

b

e

r

1, 2

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
aixa

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
tizaçã

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
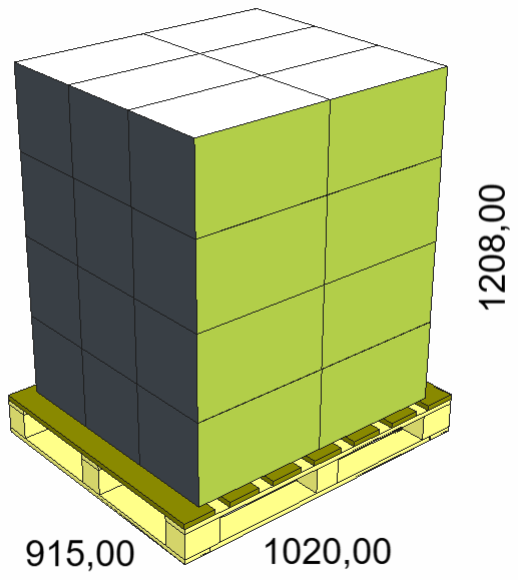
[picture p63: figure]
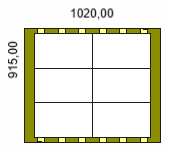
[picture p64: figure]
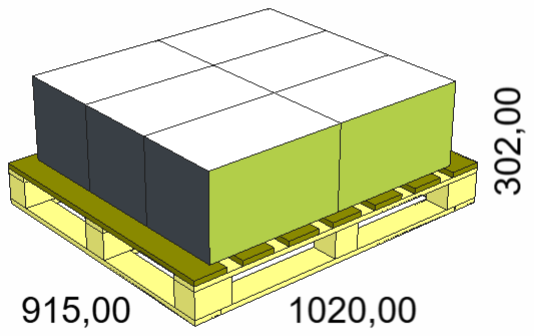
[picture p65: figure]
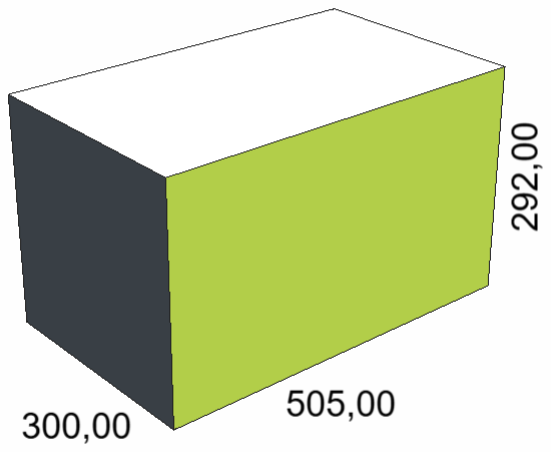
[picture p66: figure]

Paletização | Page 2
Dimensões | Peso
ComprimentLoargura | Altura | Líquido | Bruto
Case (ID) | 505,00 | 300,00 | 292,00 mm | 1,0000 kg | 1,0000 kg
Case (OD) | 510,00 | 305,00 | 302,00 mm | 1,0000 kg | 1,0000 kg
Produto | 1020,00 | 915,00 | 1208,00 mm | 24,0000 kg | 24,0000 kg
Carregar | 1200,00 | 1000,00 | 1358,00 mm | 24,0000 kg | 49,0000 kg
Suspensão | -90,00 | -42,50 | mm

Para uma caixa com C= ? cm, L= ? cm e A= ? cm feita com Papelão Ondulado onda B (resist. coluna: ? kgf/cm), contendo um peso máximo de ? kg/caixa, usada em mercado interno, temos:
:: Empilhamento máximo de ? caixas. Obs.: o empilhamento máximo foi limitado pela altura útil (empilhamento sem limitação: ? caixas)

:: O peso máximo suportado pela última caixa é de ? kg.
:: Estes cálculos são meramente orientativos.

Criador do Relatório : suporte@compactor.com.br
