LcAvila/grade_moldes/src/main/webapp/assets/Produtos/00-00 - BASE DE DADOS/Embalagens/Caixas Master/25.10.03.28-R00 - 15963 - Caixa Master N°31 (Paletização).pdf

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
age 1

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
0, 2

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
aixa

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
tizaçã

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
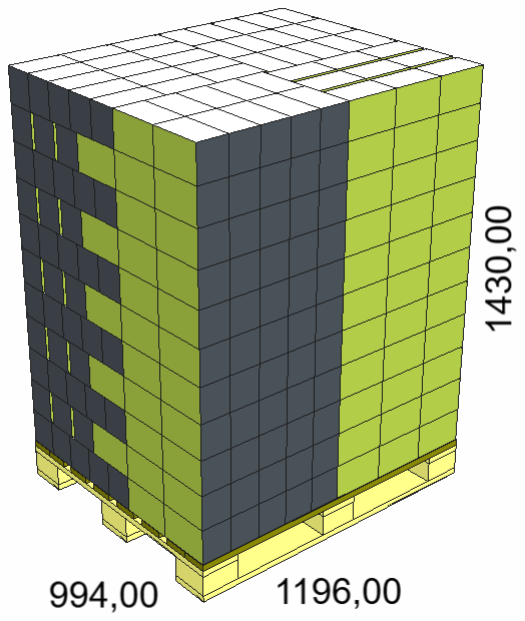
[picture p67: figure]
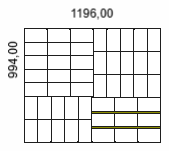
[picture p68: figure]
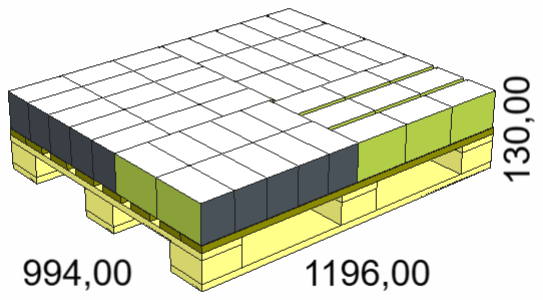
[picture p69: figure]
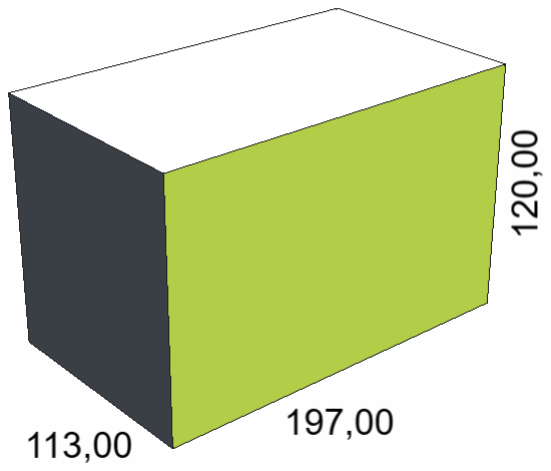
[picture p70: figure]

Paletização | Page 2
Dimensões | Peso
ComprimentLoargura | Altura | Líquido | Bruto
Case (ID) | 197,00 | 113,00 | 120,00 mm | 1,0000 kg | 1,0000 kg
Case (OD) | 202,00 | 118,00 | 130,00 mm | 1,0000 kg | 1,0000 kg
Produto | 1196,00 | 994,00 | 1430,00 mm | 539,0000 kg | 539,0000 kg
Carregar | 1200,00 | 1000,00 | 1575,00 mm | 539,0000 kg | 566,0000 kg
Suspensão | -2,00 | -3,00 | mm

Para uma caixa com C= ? cm, L= ? cm e A= ? cm feita com Papelão Ondulado onda B (resist. coluna: ? kgf/cm), contendo um peso máximo de ? kg/caixa, usada em mercado interno, temos:
:: Empilhamento máximo de ? caixas. Obs.: o empilhamento máximo foi limitado pela altura útil (empilhamento sem limitação: ? caixas)

:: O peso máximo suportado pela última caixa é de ? kg.
:: Estes cálculos são meramente orientativos.

Criador do Relatório : suporte@compactor.com.br
