LcAvila/grade_moldes/src/main/webapp/assets/Produtos/00-00 - BASE DE DADOS/Embalagens/Caixas Master/25.10.03.29-R00 - 15833 - Caixa Master N°32 (Paletização).pdf

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
age 1

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
0, 2

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
aixa

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
tizaçã

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
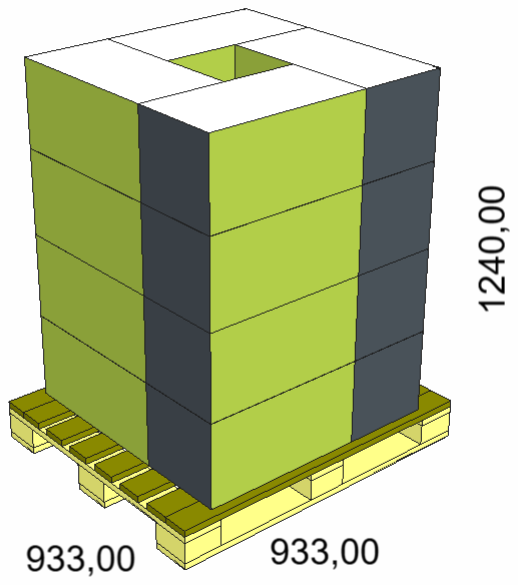
[picture p71: figure]
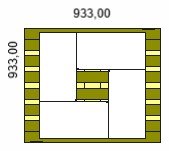
[picture p72: figure]
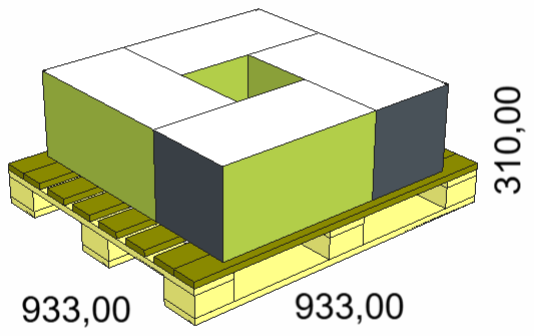
[picture p73: figure]
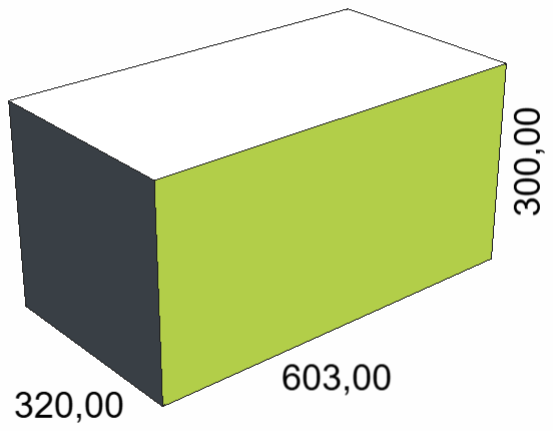
[picture p74: figure]

Paletização | Page 2
Dimensões | Peso
ComprimentLoargura | Altura | Líquido | Bruto
Case (ID) | 603,00 | 320,00 | 300,00 mm | 1,0000 kg | 1,0000 kg
Case (OD) | 608,00 | 325,00 | 310,00 mm | 1,0000 kg | 1,0000 kg
Produto | 933,00 | 933,00 | 1240,00 mm | 16,0000 kg | 16,0000 kg
Carregar | 1200,00 | 1000,00 | 1385,00 mm | 16,0000 kg | 43,0000 kg
Suspensão | -133,50 | -33,50 | mm

Para uma caixa com C= ? cm, L= ? cm e A= ? cm feita com Papelão Ondulado onda B (resist. coluna: ? kgf/cm), contendo um peso máximo de ? kg/caixa, usada em mercado interno, temos:
:: Empilhamento máximo de ? caixas. Obs.: o empilhamento máximo foi limitado pela altura útil (empilhamento sem limitação: ? caixas)

:: O peso máximo suportado pela última caixa é de ? kg.
:: Estes cálculos são meramente orientativos.

Criador do Relatório : suporte@compactor.com.br
