LcAvila/grade_moldes/src/main/webapp/assets/Produtos/00-00 - BASE DE DADOS/Embalagens/Caixas Master/25.10.03.30-R00 - 15834 - Caixa Master N°33 (Paletização).pdf

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
age 1

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
0, 2

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
aixa

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
tizaçã

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
2 I Cubo Usado | 93,4
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
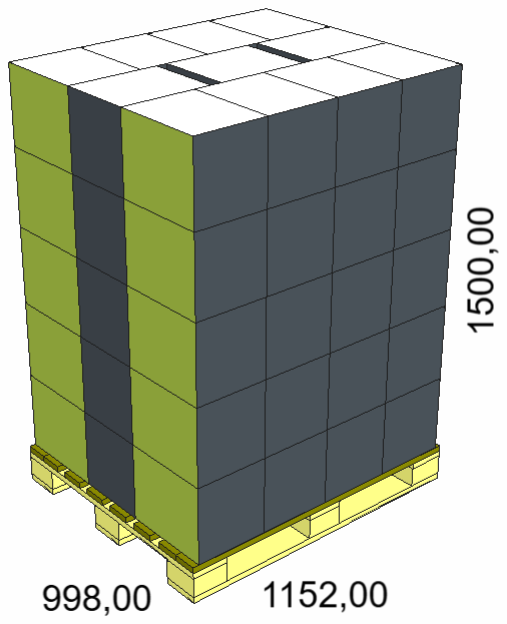
[picture p75: figure]
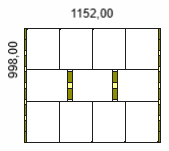
[picture p76: figure]
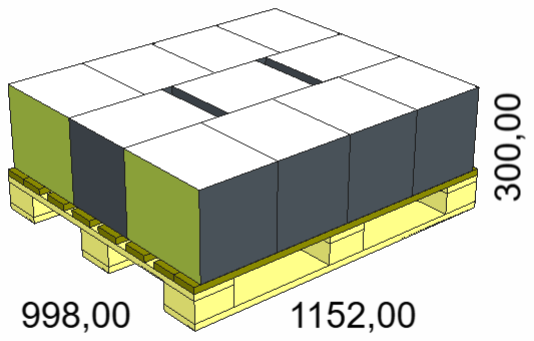
[picture p77: figure]
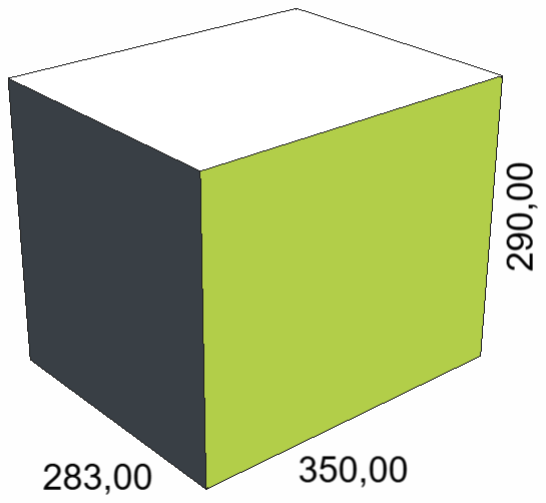
[picture p78: figure]

Paletização | Page 2
Dimensões | Peso
ComprimentLoargura | Altura | Líquido | Bruto
Case (ID) | 350,00 | 283,00 | 290,00 mm | 1,0000 kg | 1,0000 kg
Case (OD) | 355,00 | 288,00 | 300,00 mm | 1,0000 kg | 1,0000 kg
Produto | 1152,00 | 998,00 | 1500,00 mm | 55,0000 kg | 55,0000 kg
Carregar | 1200,00 | 1000,00 | 1645,00 mm | 55,0000 kg | 82,0000 kg
Suspensão | -24,00 | -1,00 | mm

Para uma caixa com C= ? cm, L= ? cm e A= ? cm feita com Papelão Ondulado onda B (resist. coluna: ? kgf/cm), contendo um peso máximo de ? kg/caixa, usada em mercado interno, temos:
:: Empilhamento máximo de ? caixas. Obs.: o empilhamento máximo foi limitado pela altura útil (empilhamento sem limitação: ? caixas)

:: O peso máximo suportado pela última caixa é de ? kg.
:: Estes cálculos são meramente orientativos.

Criador do Relatório : suporte@compactor.com.br
