LcAvila/grade_moldes/src/main/webapp/assets/Produtos/00-00 - BASE DE DADOS/Embalagens/Caixas Master/25.10.03.31-R00 - 15835 - Caixa Master N°34 (Paletização).pdf

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
age 1

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
0, 2

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
aixa

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
tizaçã

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
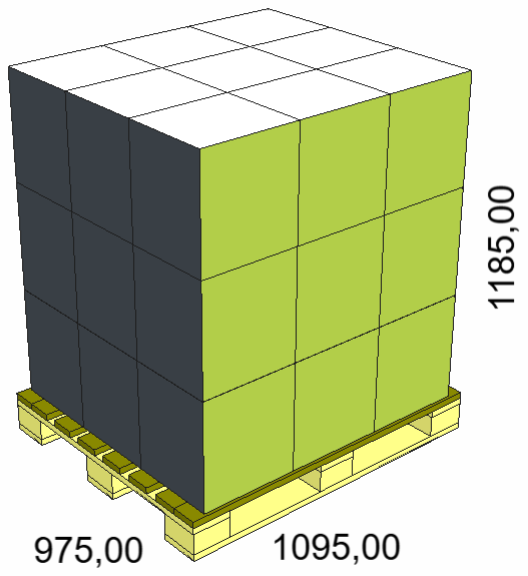
[picture p79: figure]
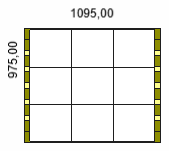
[picture p80: figure]
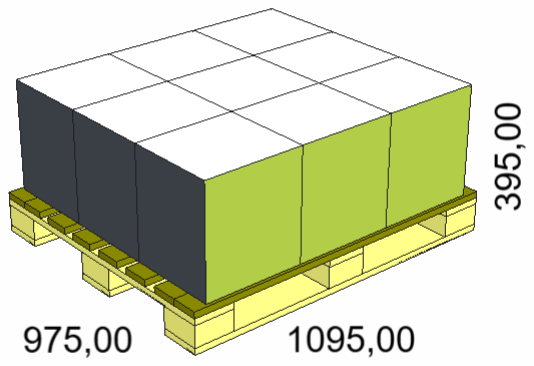
[picture p81: figure]
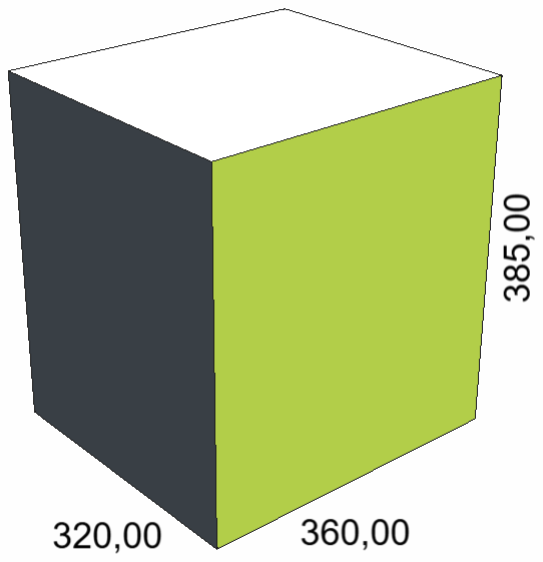
[picture p82: figure]

Paletização | Page 2
Dimensões | Peso
ComprimentLoargura | Altura | Líquido | Bruto
Case (ID) | 360,00 | 320,00 | 385,00 mm | 1,0000 kg | 1,0000 kg
Case (OD) | 365,00 | 325,00 | 395,00 mm | 1,0000 kg | 1,0000 kg
Produto | 1095,00 | 975,00 | 1185,00 mm | 27,0000 kg | 27,0000 kg
Carregar | 1200,00 | 1000,00 | 1330,00 mm | 27,0000 kg | 54,0000 kg
Suspensão | -52,50 | -12,50 | mm

Para uma caixa com C= ? cm, L= ? cm e A= ? cm feita com Papelão Ondulado onda B (resist. coluna: ? kgf/cm), contendo um peso máximo de ? kg/caixa, usada em mercado interno, temos:
:: Empilhamento máximo de ? caixas. Obs.: o empilhamento máximo foi limitado pela altura útil (empilhamento sem limitação: ? caixas)

:: O peso máximo suportado pela última caixa é de ? kg.
:: Estes cálculos são meramente orientativos.

Criador do Relatório : suporte@compactor.com.br
