LcAvila/grade_moldes/docs/inventario-moldes.md

# Inventário de moldes — Compactor

**73 moldes** · gerado a partir do repositório `pastas`.

| Molde | Peça | Família | Cav. | Grades | Anos | Máquina |
|---|---|---|---:|---:|---|---|
| **11A** | Bico Para Frasco De Cola 40G E 90G | Colas | 16 | 1/1 | ––– | ROMI 29 |
| **69** | Botao Lap. Turbo Plus | Lapiseiras | 8 | 0/1 | 2018–2018 | ENGEL 1 |
| **81** | Anel Para Reabastecedor | Reabastecedores | 16 | 0/5 | 2016–2017 | ENGEL 2 |
| **89** | Corpo Lap. Aluno | Lapiseiras | 16 | 3/26 | 2014–2019 | ROMI 40 |
| **97** | Tampinha Esferograficas | Esferográficas | 64 | 33/51 | 2015–2024 | ROMI 37 |
| **98** | Conexao Esferograficas | Esferográficas | 64 | 34/51 | 2014–2025 | ENGEL 33 |
| **101** | Tampinha Neo Pen | Hidrográficas | 64 | 47/62 | 2014–2025 | ENGEL 6 |
| **107** | Tampa Esf. Top/Economic | Esferográficas | 64 | 75/90 | 2014–2025 | ARBURG 50 |
| **108** | Corpo Esferografica 07/Economic | Esferográficas | 64 | 11/33 | 2014–2020 | ENGEL 31 |
| **109** | Tampinha Hidr. Color (Pp) | Hidrográficas | 48 | 55/77 | 2014–2025 | ROMI 30 |
| **110** | Tampa Hidr. Color (Pp) | Hidrográficas | 48 | 60/74 | 2015–2025 | ENGEL 32 |
| **115** | Corpo Esferografica 07 | Esferográficas | 64 | 0/21 | 2014–2018 | ROMI 29 |
| **116** | Corpo Pincel | Marcadores | 16 | 11/40 | 2014–2019 | ROMI 44 |
| **116A** | Corpo Marc. Q.B. | Marcadores | 16 | 49/81 | 2014–2025 | ROMI 9 |
| **117** | Tampa Esf. 07 | Esferográficas | 64 | 28/44 | 2015–2024 | ENGEL 8 |
| **120** | Corpo Neo Pen Gigante | Hidrográficas | 64 | 32/46 | 2016–2021 | ENGEL 31 |
| **121** | Corpo Hidrografica Neo Pen Mirim | Hidrográficas | 64 | 38/58 | 2014–2025 | ENGEL 32 |
| **122** | Tampa Neo Pen | Hidrográficas | 48 | 30/47 | 2014–2025 | ROMI 44 |
| **128** | Apagador Para Q.B. | Diversos | 1 | 9/9 | 2019–2023 | ROMI 43 |
| **129** | Tampa Para Frasco De Cola 500G E 1000G | Colas | 4 | 1/1 | 2025–2025 | ROMI 45 |
| **137** | Corpo Lapiseira Turbo Plus | Lapiseiras | 8 | 0/16 | 2015–2018 | ROMI 40 |
| **138** | Corpo Esferografica Top/Jet Lux | Esferográficas | 64 | 1/31 | 2014–2018 | ARBURG 36 |
| **139** | Tampa Esf. Top/Economic | Esferográficas | 64 | 36/56 | 2014–2025 | ROMI 45 |
| **140** | Tampinha Esferograficas | Esferográficas | 64 | 19/34 | 2014–2024 | ENGEL 3 |
| **143** | Corpo Esferografica 07/Economic | Esferográficas | 64 | 27/52 | 2014–2022 | ROMI 40 |
| **144** | Corpo Neo Pen Gigante | Hidrográficas | 64 | 0/13 | 2014–2016 | ENGEL 31 |
| **145A** | Tampa Para Frasco De Cola 40G E 90G | Colas | 16 | 1/1 | ––– | – |
| **145B** | Tampa Marc. Pincel | Marcadores | 16 | 45/68 | 2014–2025 | ROMI 29 |
| **145C** | Tampinha Marc. Q.B. | Marcadores | 16 | 28/45 | 2015–2025 | ENGEL 6 |
| **145D** | Tampa Reab. Q.B. | Reabastecedores | 16 | 42/74 | 2014–2024 | ROMI 30 |
| **145E** | Tampa Reab. Pincel | Reabastecedores | 16 | 27/40 | 2014–2025 | ROMI 30 |
| **146** | Tampinha Neo Pen | Hidrográficas | 64 | 27/41 | 2014–2024 | ROMI 43 |
| **147A** | Tampa Hidr. Color | Hidrográficas | 32 | 5/29 | 2014–2024 | ROMI 44 |
| **147B** | Tampinha Hidr. Color | Hidrográficas | 32 | 11/20 | 2014–2025 | ENGEL 32 |
| **148** | Corpo Color (Pp) | Hidrográficas | 64 | 54/71 | 2014–2025 | ROMI 40 |
| **150** | Conexao Microline | Hidrográficas | 16 | 46/92 | 2014–2025 | ROMI 30 |
| **151** | Tampinha Microline | Hidrográficas | 16 | 43/67 | 2014–2025 | ARBURG 36 |
| **152** | Tampa Microline | Hidrográficas | 16 | 18/47 | 2014–2020 | ROMI 38 |
| **153** | Corpo Esf. 07 Plus | Esferográficas | 16 | 3/10 | 2014–2019 | ROMI 40 |
| **154** | Tampa Esf. 07 Plus | Esferográficas | 16 | 2/15 | 2014–2019 | ROMI 29 |
| **156** | Tampinha Esf. | Esferográficas | 16 | 2/3 | 2017–2020 | ENGEL 1 |
| **157** | Bico Reabastecedor Pincel/Q.B. | Reabastecedores | 16 | 44/67 | 2014–2025 | ROMI 29 |
| **158** | Botao Lapiseira Tecnico | Lapiseiras | 16 | 14/25 | 2015–2024 | ROMI 38 |
| **159** | Corpo Lap. Tecnico | Lapiseiras | 16 | 16/30 | 2014–2024 | ENGEL 31 |
| **160** | Dianteira Lap. Tecnico | Lapiseiras | 16 | 20/26 | 2016–2024 | ENGEL 5 |
| **161** | Tampa Marcador Q.B. | Marcadores | 12 | 0/21 | 2014–2017 | ROMI 29 |
| **162** | Tampa Marc. Destaq | Marcadores | 16 | 42/69 | 2015–2025 | ARBURG 50 |
| **163** | Tampinha Marc. Destaq | Marcadores | 16 | 33/56 | 2014–2025 | ENGEL 6 |
| **164** | Corpo Marc. Destaq | Marcadores | 16 | 46/75 | 2015–2025 | ROMI 40 |
| **165** | Corpo Esferografica 07/Economic | Esferográficas | 64 | 49/54 | 2018–2025 | ARBURG 51 |
| **167** | Tampinha Esferograficas | Esferográficas | 64 | 0/1 | 2014–2014 | ROMI 43 |
| **167A** | Conexao Esferograficas | Esferográficas | 64 | 28/45 | 2012–2024 | ENGEL 33 |
| **168** | Conexao Esferograficas | Esferográficas | 64 | 23/28 | 2014–2024 | ROMI 43 |
| **169** | Tampa Neo Pen | Hidrográficas | 64 | 41/62 | 2014–2025 | ARBURG 50 |
| **173** | Tampa Para Tinteiro | Esferográficas | 8 | 2/4 | 2022–2022 | ARBURG 36 |
| **181** | Tampa Esf. 07 | Esferográficas | 64 | 36/55 | 2014–2025 | ENGEL 7 |
| **183** | Corpo 07 Vip Retratil | Esferográficas | 24 | 38/52 | 2016–2025 | ROMI 44 |
| **184** | Clip 07 Vip Retratil | Esferográficas | 24 | 34/57 | 2016–2025 | ROMI 39 |
| **185** | Botao 07 Vip Retratil | Esferográficas | 24 | 37/52 | 2016–2025 | ROMI 40 |
| **186** | Corpo De Estojo Magister | Esferográficas | 8 | 10/10 | ––– | ROMI 45 |
| **187** | Conector Para Tubo De Esferografica Brinde | Esferográficas | 4 | 15/15 | ––– | ROMI 45 |
| **188** | Bico Para Frasco De Cola 40G E 90G | Colas | 16 | 1/1 | ––– | ENGEL 6 |
| **189** | Tampa Marc. Q.B. | Marcadores | 16 | 67/83 | 2017–2025 | ENGEL 35 |
| **190** | Corpo Esferografica Top/Jet Lux | Esferográficas | 64 | 62/62 | 2018–2025 | ARBURG 52 |
| **191** | Corpo Pincel | Marcadores | 16 | 40/40 | 2020–2025 | ROMI 9 |
| **192** | Corpo Esferografica 07 | Esferográficas | 64 | 45/45 | 2019–2025 | ARBURG 52 |
| **193** | Tampa Microline | Hidrográficas | 32 | 38/38 | 2020–2025 | ENGEL 32 |
| **194** | Corpo Neo Pen Gigante | Hidrográficas | 64 | 46/46 | 2021–2025 | ARBURG 49 |
| **195** | Corpo Neo Pen Mirim | Hidrográficas | 64 | 10/10 | 2021–2022 | ENGEL 32 |
| **197** | Corpo Esferografica 07/Economic | Esferográficas | 64 | 23/23 | 2022–2025 | ARBURG 49 |
| **199** | Corpo Neo Pen Gigante | Hidrográficas | 64 | 30/30 | 2023–2025 | ARBURG 49 |
| **200** | Conexao Esferograficas | Esferográficas | 96 | 4/4 | 2025–2025 | ENGEL 33 |
| **202** | Arruela De Vedacao | Colas | 2 | 1/1 | ––– | ROMI 39 |
