LcAvila/grade_moldes/graphify-out/converted/01-22-11-23-Arruela-de-vedacao-para-cola-2-cav.-Molde-202_e144b434.md

<!-- converted from 01-22-11-23-Arruela-de-vedacao-para-cola-2-cav.-Molde-202.xlsx -->

## Sheet: Plan1
|  |  | CAVIDADES NÃO CONFORMES |  |  |  |  |  |  |  | Arruela de vedação |  |  |  |  |  |  |  |  |  |  |  |  |  |  |
| --- | --- | --- | --- | --- | --- | --- | --- | --- | --- | --- | --- | --- | --- | --- | --- | --- | --- | --- | --- | --- | --- | --- | --- | --- |
|  |  |  |  |  |  |  |  |  |  | Molde 202 |  |  |  |  |  |  |  |  |  |  |  |  |  |  |
| Cav. | Desvio | Data | Vedação |  |  |  | Controlador |  |  |  |  |  |  |  |  |  |  |  |  |  |  |  |  |  |
| 1 |  |  | S: |  | N: |  |  |  |  |  |  |  |  |  |  |  |  |  |  |  |  |  |  |  |
| 2 |  |  | S: |  | N: |  |  |  |  |  |  |  |  |  |  |  |  |  |  |  |  |  |  |  |
|  |  |  |  |  |  |  |  | LEGENDA: |  |  |  |  |  |  |  |  |  |  |  |  |  |  |  |  |
|  |  |  |  |  |  |  |  | F.P.F.Q. - Frente do pino de formato quebrada |  |  |  |  |  |  |  |  |  |  |  |  |  |  |  |  |
|  |  |  |  |  |  |  |  | P.F.Q. - Pino do formato Quebrado |  |  |  |  |  |  |  |  |  |  |  |  |  |  |  |  |
|  |  |  |  |  |  |  |  | V.P.F. - Vedada pela ferramentaria |  |  |  |  |  |  |  |  |  |  |  |  |  |  |  |  |
|  |  |  |  |  |  |  |  | REB. - Rebarba (especificar região da rebarba) |  |  |  |  |  |  |  |  |  |  |  |  |  |  |  |  |
|  |  |  |  |  |  |  |  | B.V. - Bucha Virada |  |  |  |  |  |  |  |  |  |  |  |  |  |  |  |  |
|  |  |  |  |  |  |  |  | C.P.Q. - Contra pino quebrado |  |  |  |  |  |  |  |  |  |  |  |  |  |  |  |  |
|  |  |  |  |  |  |  |  | B.B.F.Q. - Boca da bucha do formato quebrada |  |  |  |  |  |  |  |  |  |  |  |  |  |  |  |  |
|  |  |  |  |  |  |  |  | INFORMAÇÕES DE ENTRADA DO MOLDE |  |  |  |  |  |  |  |  |  |  |  |  |  |  |  |  |
|  |  |  |  |  |  |  |  | Material: |  | TPE |  |  |  |  |  |  |  |  |  |  |  |  |  |  |
|  |  |  |  |  |  |  |  | Máquina: |  | ROMI 39 |  |  |  |  |  |  |  |  |  |  |  |  |  |  |
|  |  |  |  |  |  |  |  | Controlador resp.(abertura do documento): |  | MARLON |  |  |  |  |  |  |  |  |  |  |  |  |  |  |
|  |  |  |  |  |  |  |  | Data da entrada do molde: |  | 2023-11-22 00:00:00 |  |  |  |  |  |  |  |  |  |  |  |  |  |  |
|  |  |  |  |  |  |  |  | Data de atualização da grade/Responsável: |  |  |  |  |  |  |  |  |  |  |  |  |  |  |  |  |
|  |  |  |  |  |  |  |  | Observações adicionais: |  |  |  |  |  |  |  |  |  |  |  |  |  |  |  |  |
|  |  |  |  |  |  |  |  | Revisão 05 - Data 20/Março/2020 |  |  |  |  |  |  |  |  |  |  |  |  |  |  |  |  |
