LcAvila/grade_moldes/graphify-out/converted/08-24-01-25-Conector para estojo de esferográfica - Molde 187_7891b1ad.md

<!-- converted from 08-24-01-25-Conector para estojo de esferográfica - Molde 187.xlsx -->

## Sheet: Plan1
|  |  | CAVIDADES NÃO CONFORMES |  |  |  |  |  |  |  | Conector para tubo de esferográfica brinde |  |  |  |  |  |  |  |  |  |  |  |  |  |  |
| --- | --- | --- | --- | --- | --- | --- | --- | --- | --- | --- | --- | --- | --- | --- | --- | --- | --- | --- | --- | --- | --- | --- | --- | --- |
|  |  |  |  |  |  |  |  |  |  | Molde 187 |  |  |  |  |  |  |  |  |  |  |  |  |  |  |
| Cav. | Desvio | Data | Vedação |  |  |  | Controlador |  |  |  |  |  |  |  |  |  |  |  |  |  |  |  |  |  |
| 1 |  |  | S: |  | N: |  |  |  |  |  |  |  |  |  |  |  |  |  |  |  |  |  |  |  |
| 2 |  |  | S: |  | N: |  |  |  |  |  |  |  |  |  |  |  |  |  |  |  |  |  |  |  |
| 3 |  |  | S: |  | N: |  |  |  |  |  |  |  |  |  |  |  |  |  |  |  |  |  |  |  |
| 4 |  |  | S: |  | N: |  |  |  |  |  |  |  |  |  |  |  |  |  |  |  |  |  |  |  |
|  |  |  |  |  |  |  |  | LEGENDA: |  |  |  |  |  |  |  |  |  |  |  |  |  |  |  |  |
|  |  |  |  |  |  |  |  | F.P.F.Q. - Frente do pino de formato quebrada |  |  |  |  |  |  |  |  |  |  |  |  |  |  |  |  |
|  |  |  |  |  |  |  |  | P.F.Q. - Pino do formato Quebrado |  |  |  |  |  |  |  |  |  |  |  |  |  |  |  |  |
|  |  |  |  |  |  |  |  | V.P.F. - Vedada pela ferramentaria |  |  |  |  |  |  |  |  |  |  |  |  |  |  |  |  |
|  |  |  |  |  |  |  |  | REB. - Rebarba (especificar região da rebarba) |  |  |  |  |  |  |  |  |  |  |  |  |  |  |  |  |
|  |  |  |  |  |  |  |  | B.V. - Bucha Virada |  |  |  |  |  |  |  |  |  |  |  |  |  |  |  |  |
|  |  |  |  |  |  |  |  | C.P.Q. - Contra pino quebrado |  |  |  |  |  |  |  |  |  |  |  |  |  |  |  |  |
|  |  |  |  |  |  |  |  | B.B.F.Q. - Boca da bucha do formato quebrada |  |  |  |  |  |  |  |  |  |  |  |  |  |  |  |  |
|  |  |  |  |  |  |  |  | INFORMAÇÕES DE ENTRADA DO MOLDE |  |  |  |  |  |  |  |  |  |  |  |  |  |  |  |  |
|  |  |  |  |  |  |  |  | Material: |  | TPE |  |  |  |  |  |  |  |  |  |  |  |  |  |  |
|  |  |  |  |  |  |  |  | Máquina: |  | ROMI 45 |  |  |  |  |  |  |  |  |  |  |  |  |  |  |
|  |  |  |  |  |  |  |  | Controlador resp.(abertura do documento): |  | JONAS |  |  |  |  |  |  |  |  |  |  |  |  |  |  |
|  |  |  |  |  |  |  |  | Data da entrada do molde: |  | 2025-01-24 00:00:00 |  |  |  |  |  |  |  |  |  |  |  |  |  |  |
|  |  |  |  |  |  |  |  | Data de atualização da grade/Responsável: |  |  |  |  |  |  |  |  |  |  |  |  |  |  |  |  |
|  |  |  |  |  |  |  |  | Observações adicionais: |  |  |  |  |  |  |  |  |  |  |  |  |  |  |  |  |
|  |  |  |  |  |  |  |  | Revisão 05 - Data 20/Março/2020 |  |  |  |  |  |  |  |  |  |  |  |  |  |  |  |  |
