LcAvila/grade_moldes/graphify-out/converted/Corpo Dianteiro - Duo Plus_109addbd.md

<!-- converted from Corpo Dianteiro - Duo Plus.xlsx -->

## Sheet: Plan1
|  |  | CAVIDADES NÃO CONFORMES |  |  |  |  |  |  |  | CORPO DIANTEIRO DUO PLUS |  |  |  |  |  |  |  |  |  |  |  |  |  |  |
| --- | --- | --- | --- | --- | --- | --- | --- | --- | --- | --- | --- | --- | --- | --- | --- | --- | --- | --- | --- | --- | --- | --- | --- | --- |
| Cav. | Desvio | Data | Vedação |  |  |  | Controlador |  |  |  |  |  |  |  |  |  |  |  |  |  |  |  |  |  |
| 1 | Ø INTERNO ARRANHADO | 2023-12-19 00:00:00 | S: |  | N: | X | DIOGO |  |  |  |  |  |  |  |  |  |  |  |  |  |  |  |  |  |
| 2 | Ø INTERNO ARRANHADO | 2023-12-19 00:00:00 | S: |  | N: | X | DIOGO |  |  |  |  |  |  |  |  |  |  |  |  |  |  |  |  |  |
| 3 | Ø INTERNO ARRANHADO | 2023-12-19 00:00:00 | S: |  | N: | X | DIOGO |  |  |  |  |  |  |  |  |  |  |  |  |  |  |  |  |  |
| 4 | Ø INTERNO ARRANHADO | 2023-12-19 00:00:00 | S: |  | N: | X | DIOGO |  |  |  |  |  |  |  |  |  |  |  |  |  |  |  |  |  |
|  |  |  |  |  |  |  |  | LEGENDA: |  |  |  |  |  |  |  |  |  |  |  |  |  |  |  |  |
|  |  |  |  |  |  |  |  | F.P.F.Q. - Frente do pino de formato quebrada |  |  |  |  |  |  |  |  |  |  |  |  |  |  |  |  |
|  |  |  |  |  |  |  |  | P.F.Q. - Pino do formato Quebrado |  |  |  |  |  |  |  |  |  |  |  |  |  |  |  |  |
|  |  |  |  |  |  |  |  | V.P.F. - Vedada pela ferramentaria |  |  |  |  |  |  |  |  |  |  |  |  |  |  |  |  |
|  |  |  |  |  |  |  |  | REB. - Rebarba (especificar região da rebarba) |  |  |  |  |  |  |  |  |  |  |  |  |  |  |  |  |
|  |  |  |  |  |  |  |  | B.V. - Bucha Virada |  |  |  |  |  |  |  |  |  |  |  |  |  |  |  |  |
|  |  |  |  |  |  |  |  | C.P.Q. - Contra pino quebrado |  |  |  |  |  |  |  |  |  |  |  |  |  |  |  |  |
|  |  |  |  |  |  |  |  | B.B.F.Q. - Boca da bucha do formato quebrada |  |  |  |  |  |  |  |  |  |  |  |  |  |  |  |  |
|  |  |  |  |  |  |  |  | INFORMAÇÕES DE ENTRADA DO MOLDE |  |  |  |  |  |  |  |  |  |  |  |  |  |  |  |  |
|  |  |  |  |  |  |  |  | Material: |  | POLICARBONATO |  |  |  |  |  |  |  |  |  |  |  |  |  |  |
|  |  |  |  |  |  |  |  | Máquina: |  | ARBURG 51 |  |  |  |  |  |  |  |  |  |  |  |  |  |  |
|  |  |  |  |  |  |  |  | Controlador resp.(abertura do documento): |  | DIOGO |  |  |  |  |  |  |  |  |  |  |  |  |  |  |
|  |  |  |  |  |  |  |  | Data da entrada do molde: |  | 2023-12-19 00:00:00 |  |  |  |  |  |  |  |  |  |  |  |  |  |  |
|  |  |  |  |  |  |  |  | Data de atualização da grade/Responsável: |  |  |  |  |  |  |  |  |  |  |  |  |  |  |  |  |
|  |  |  |  |  |  |  |  | Observações adicionais: |  |  |  |  |  |  |  |  |  |  |  |  |  |  |  |  |
|  |  |  |  |  |  |  |  | Revisão 05 - Data 20/Março/2020 |  |  |  |  |  |  |  |  |  |  |  |  |  |  |  |  |
