LcAvila/grade_moldes/referencias/Cavidades-nao-conformes-Molde-168.pdf

# CAVIDADES NÃO CONFORMES

### CONEXÕES ESFEROGRÁFICAS

### Molde 168

Coreano SW 1307

Esquerda | Direita
Cav | Desvio | Data | Vedado | Controlador | Cav | Desvio | Data | Vedado | Controlador
1 | | 29/08/2026 | N | | 33 | | 29/08/2026 | N
2 | | 29/08/2026 | N | | 34 | | 29/08/2026 | N
3 | | 29/08/2026 | N | | 35 | | 29/08/2026 | N
4 | | 29/08/2026 | N | | 36 | | 29/08/2026 | N
5 | | 29/08/2026 | N | | 37 | | 29/08/2026 | N
6 | | 29/08/2026 | N | | 38 | | 29/08/2026 | N
7 | | 29/08/2026 | N | | 39 | | 29/08/2026 | N
8 | | 29/08/2026 | N | | 40 | | 29/08/2026 | N
9 | | 29/08/2026 | N | | 41 | | 29/08/2026 | N
10 | | 29/08/2026 | N | | 42 | | 29/08/2026 | N
11 | | 29/08/2026 | N | | 43 | | 29/08/2026 | N
12 | | 29/08/2026 | N | | 44 | | 29/08/2026 | N
13 | | 29/08/2026 | N | | 45 | | 29/08/2026 | N
14 | | 29/08/2026 | N | | 46 | | 29/08/2026 | N
15 | | 29/08/2026 | N | | 47 | | 29/08/2026 | N
16 | | 29/08/2026 | N | | 48 | | 29/08/2026 | N
17 | | 29/08/2026 | N | | 49 | | 29/08/2026 | N
18 | | 29/08/2026 | N | | 50 | | 29/08/2026 | N
19 | | 29/08/2026 | N | | 51 | | 29/08/2026 | N
20 | | 29/08/2026 | N | | 52 | | 29/08/2026 | N
21 | | 29/08/2026 | N | | 53 | | 29/08/2026 | N
22 | | 29/08/2026 | N | | 54 | | 29/08/2026 | N
23 | | 29/08/2026 | N | | 55 | | 29/08/2026 | N
24 | | 29/08/2026 | N | | 56 | | 29/08/2026 | N
25 | | 29/08/2026 | N | | 57 | | 29/08/2026 | N
26 | | 29/08/2026 | N | | 58 | | 29/08/2026 | N
27 | | 29/08/2026 | N | | 59 | | 29/08/2026 | N
28 | | 29/08/2026 | N | | 60 | | 29/08/2026 | N
29 | | 29/08/2026 | N | | 61 | | 29/08/2026 | N
30 | | 29/08/2026 | N | | 62 | | 29/08/2026 | N
29/08/2026, 14:48 | Cavidades não conformes - Molde 168
file:///C:/Users/Avila/Documents/Cavidade não conforme/index (7).html | 1/3

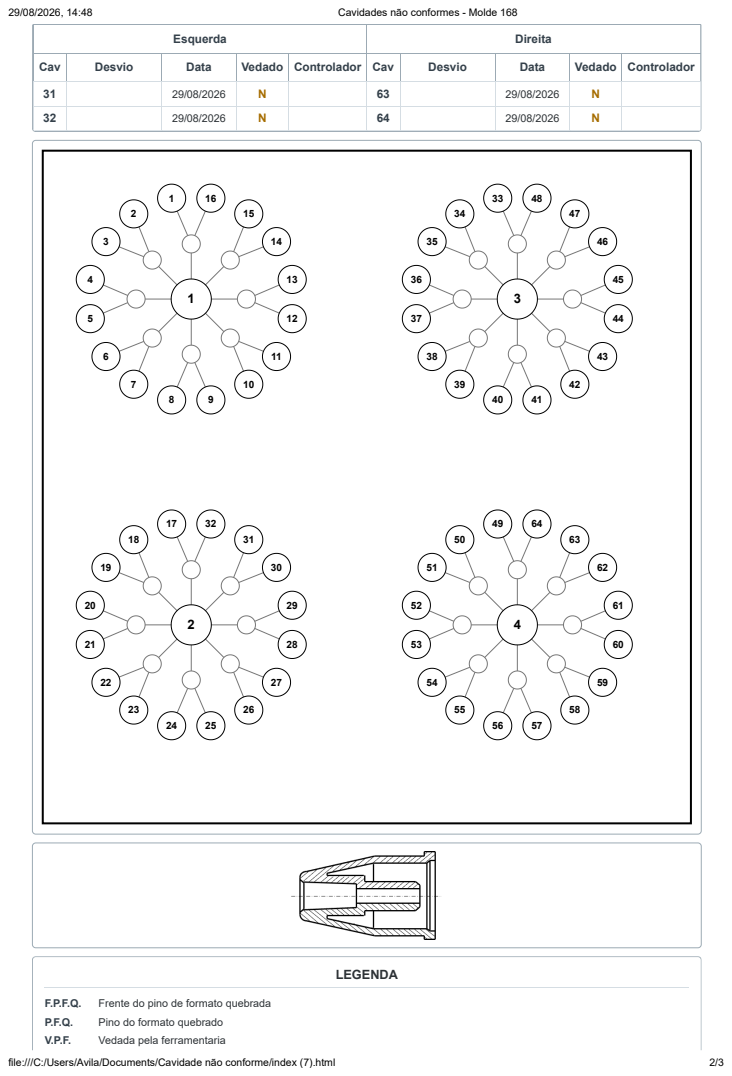
[picture p83: page 2]
LEGENDA; Frente do pino de formato quebrada; Pino do formato quebrado; Vedada pela ferramentaria; file:///C:/Users/Avila/Documents/Cavidade não conforme/index (7).html

Esquerda | Direita

Cav | Desvio | Data | Vedado | Controlador | Cav | Desvio | Data | Vedado | Controlador

REB. | Rebarba - especificar região
B.V. | Bucha virada
C.P.Q. | Contra pino quebrado
B.B.F.Q. Boca da bucha do formato quebrada

### INFORMAÇÕES DE ENTRADA DO MOLDE

Material | POLIPROPILENO PP
Máquinas | ENGEL 33

Controlador resp. abertura

Data da entrada do molde

Atualização / responsável

Observações adicionais

Revisão | 05 | - Data 20 Março 2020
file:///C:/Users/Avila/Documents/Cavidade não conforme/index (7).html | 3/3
