LcAvila/grade_moldes/referencias/cavidade-molde-168.jpg

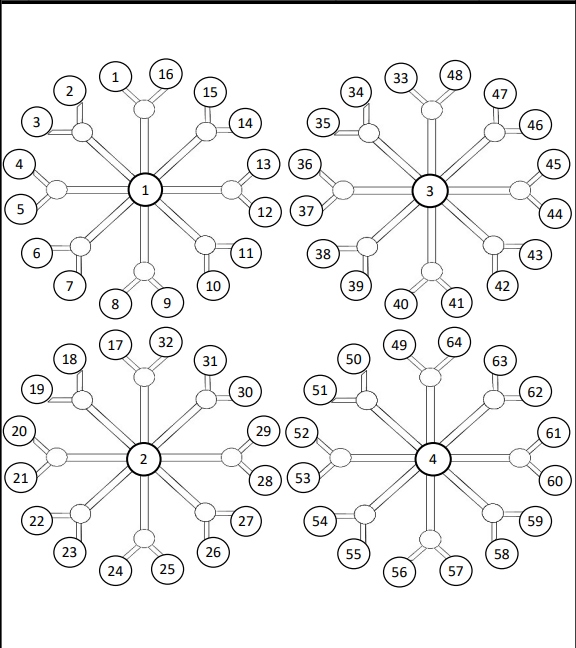
referencias/cavidade-molde-168.jpg
