LcAvila/grade_moldes/src/main/webapp/assets/desenhos/originais/109-grade.png

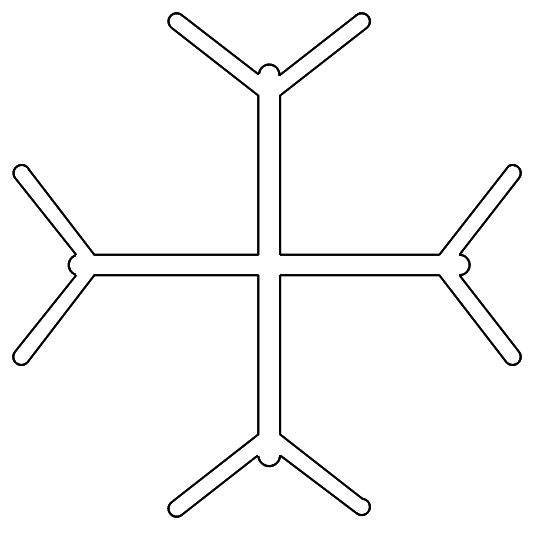
src/main/webapp/assets/desenhos/originais/109-grade.png
