LcAvila/grade_moldes/src/main/webapp/assets/desenhos/originais/129-grade.png

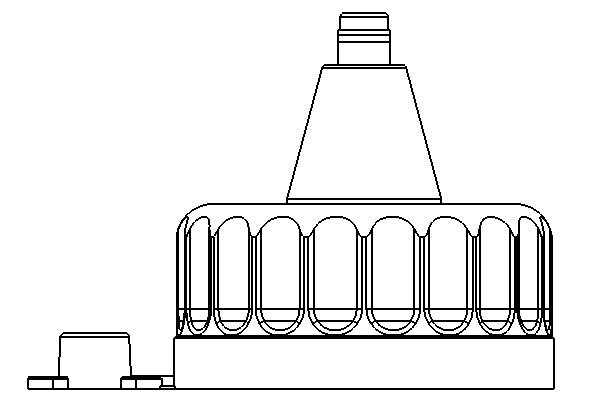
src/main/webapp/assets/desenhos/originais/129-grade.png
