LcAvila/grade_moldes/src/main/webapp/assets/desenhos/originais/156-grade.png

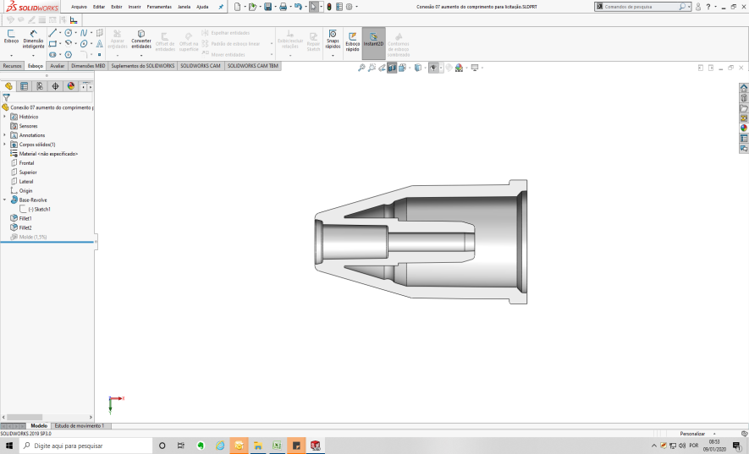
src/main/webapp/assets/desenhos/originais/156-grade.png
