LcAvila/grade_moldes/src/main/webapp/assets/desenhos/originais/168-grade.png

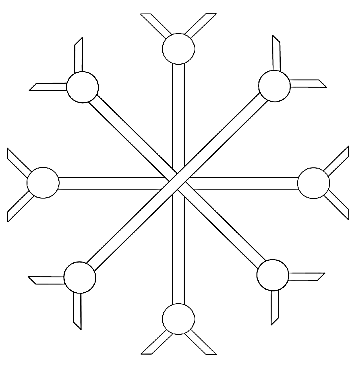
src/main/webapp/assets/desenhos/originais/168-grade.png
