LcAvila/grade_moldes/src/main/webapp/assets/desenhos/originais/192-grade.png

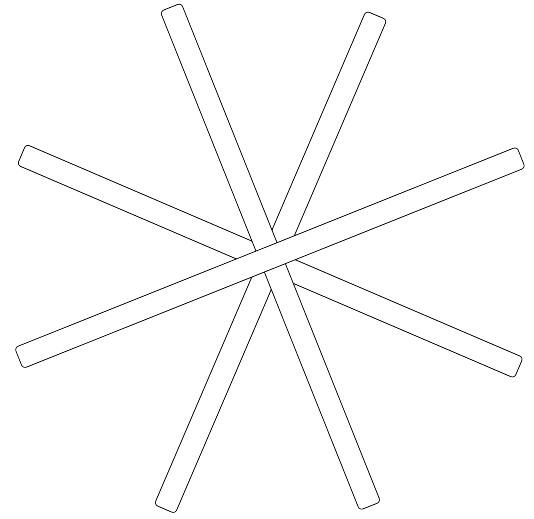
src/main/webapp/assets/desenhos/originais/192-grade.png
