LcAvila/grade_moldes/src/main/webapp/assets/desenhos/originais/200-grade.png

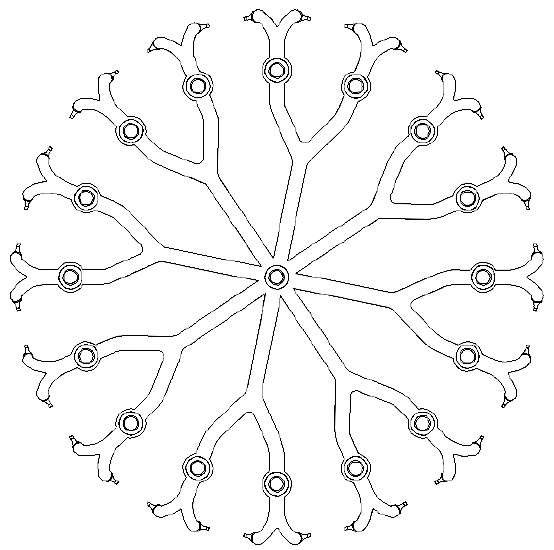
src/main/webapp/assets/desenhos/originais/200-grade.png
