LcAvila/grade_moldes/src/main/webapp/assets/imagens e grades moldes/Colas/Arruela/grade - molde 202.png

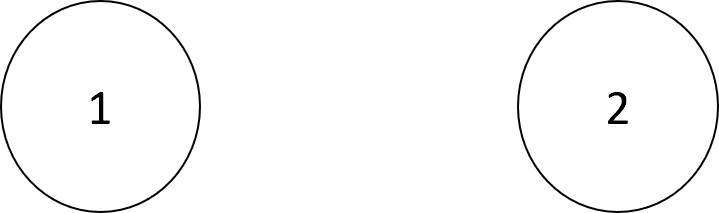
src/main/webapp/assets/imagens e grades moldes/Colas/Arruela/grade - molde 202.png
