LcAvila/grade_moldes/src/main/webapp/assets/imagens e grades moldes/Colas/Bicos/Bico Frasco de Cola - Molde 11A/grade - molde 11A.png

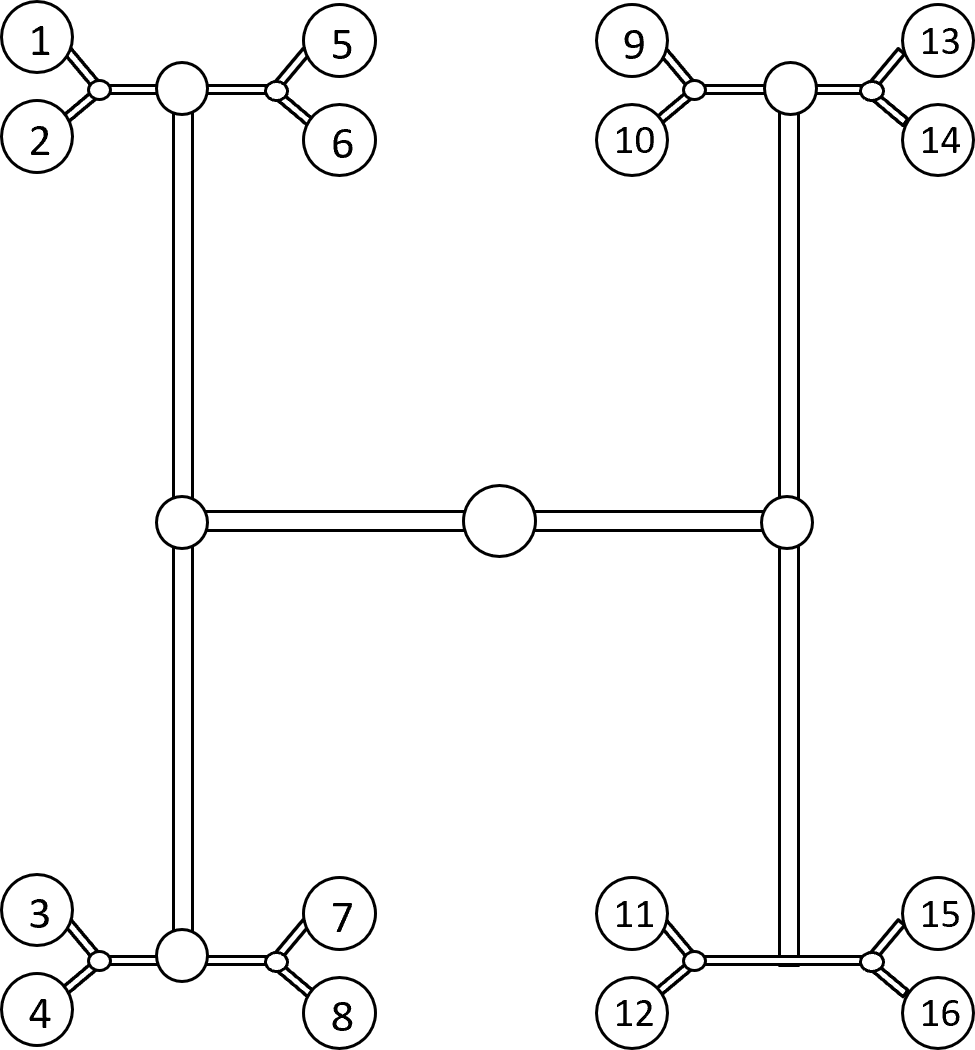
src/main/webapp/assets/imagens e grades moldes/Colas/Bicos/Bico Frasco de Cola - Molde 11A/grade - molde 11A.png
