LcAvila/grade_moldes/src/main/webapp/assets/imagens e grades moldes/Colas/Tampas/Tampa para Cola 40 e 90g - Molde 145A/grade - molde 145A.png

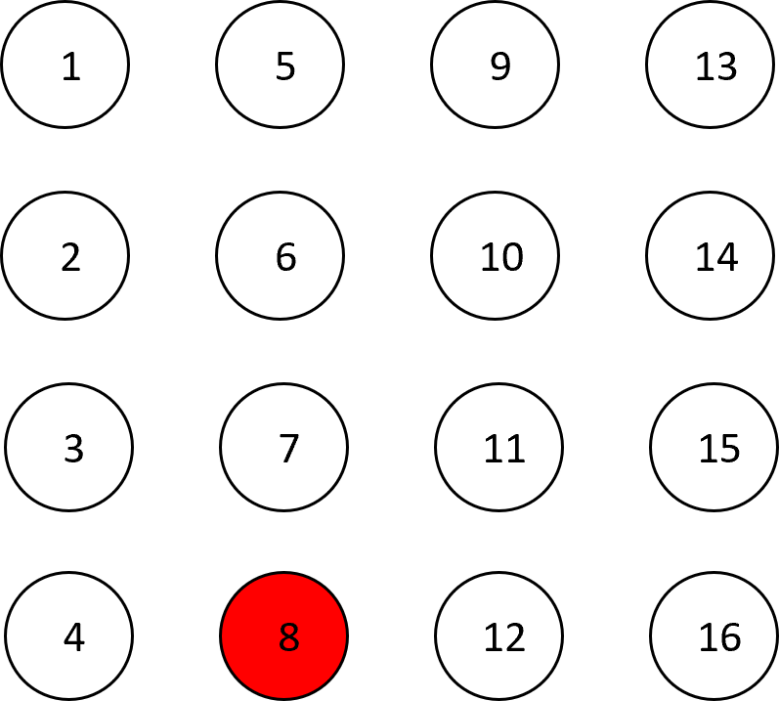
src/main/webapp/assets/imagens e grades moldes/Colas/Tampas/Tampa para Cola 40 e 90g - Molde 145A/grade - molde 145A.png
