LcAvila/grade_moldes/src/main/webapp/assets/imagens e grades moldes/Colas/Tampas/Tampa para Cola 1000g - Molde 129/grade - molde 129.png

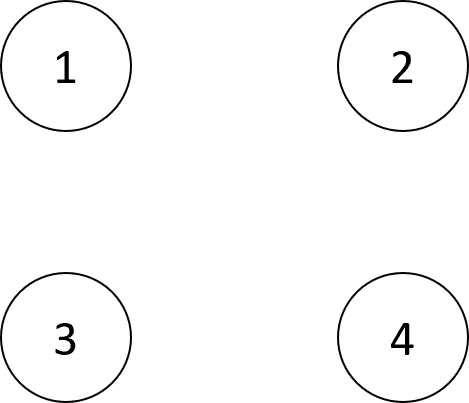
src/main/webapp/assets/imagens e grades moldes/Colas/Tampas/Tampa para Cola 1000g - Molde 129/grade - molde 129.png
