LcAvila/grade_moldes/src/main/webapp/assets/imagens e grades moldes/Diversos/Apagador - Molde 128/desenho - molde 128.png

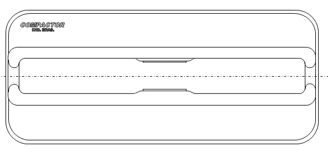
src/main/webapp/assets/imagens e grades moldes/Diversos/Apagador - Molde 128/desenho - molde 128.png
