LcAvila/grade_moldes/src/main/webapp/assets/imagens e grades moldes/Esferográficas/Botão Vip/grade - molde 185.png

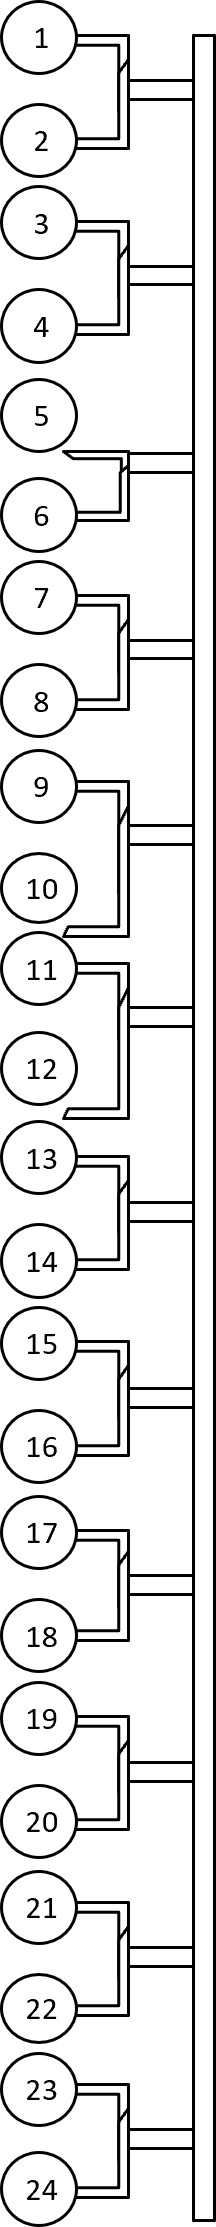
src/main/webapp/assets/imagens e grades moldes/Esferográficas/Botão Vip/grade - molde 185.png
