LcAvila/grade_moldes/src/main/webapp/assets/imagens e grades moldes/Esferográficas/Clip Esf 07 VIP Retrátil - 24 Cav - Molde 184/grade - molde 184.png

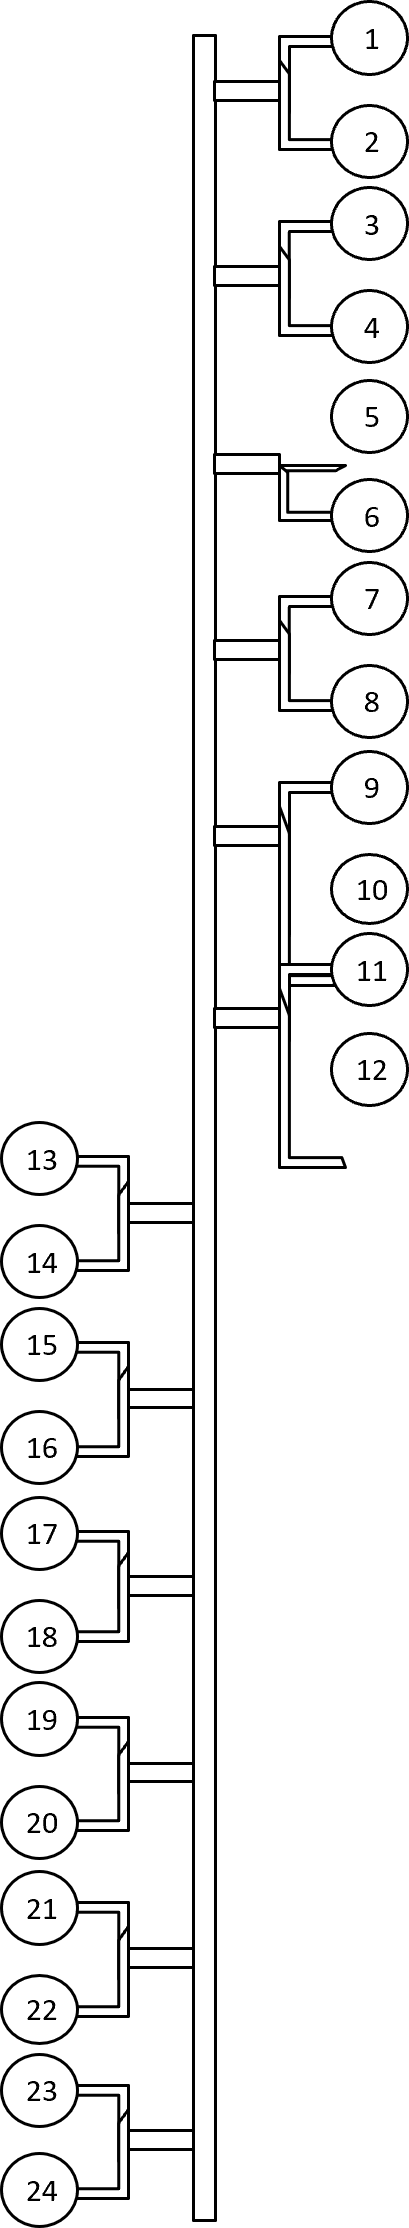
src/main/webapp/assets/imagens e grades moldes/Esferográficas/Clip Esf 07 VIP Retrátil - 24 Cav - Molde 184/grade - molde 184.png
