LcAvila/grade_moldes/src/main/webapp/assets/imagens e grades moldes/Esferográficas/Conector para estojo Magister - Molde 187/desenho - molde 187.png

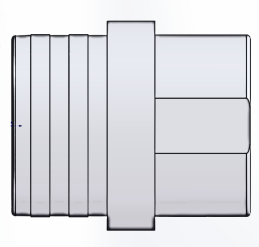
src/main/webapp/assets/imagens e grades moldes/Esferográficas/Conector para estojo Magister - Molde 187/desenho - molde 187.png
