LcAvila/grade_moldes/src/main/webapp/assets/imagens e grades moldes/Esferográficas/Conexão/Conexão Esf. - 16 Cav.-Molde 156/desenho molde 156.png

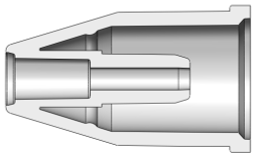
src/main/webapp/assets/imagens e grades moldes/Esferográficas/Conexão/Conexão Esf. - 16 Cav.-Molde 156/desenho molde 156.png
