LcAvila/grade_moldes/src/main/webapp/assets/imagens e grades moldes/Esferográficas/Conexão/Conexão Esf. - 16 Cav.-Molde 156/grade molde 156 - conexão.png

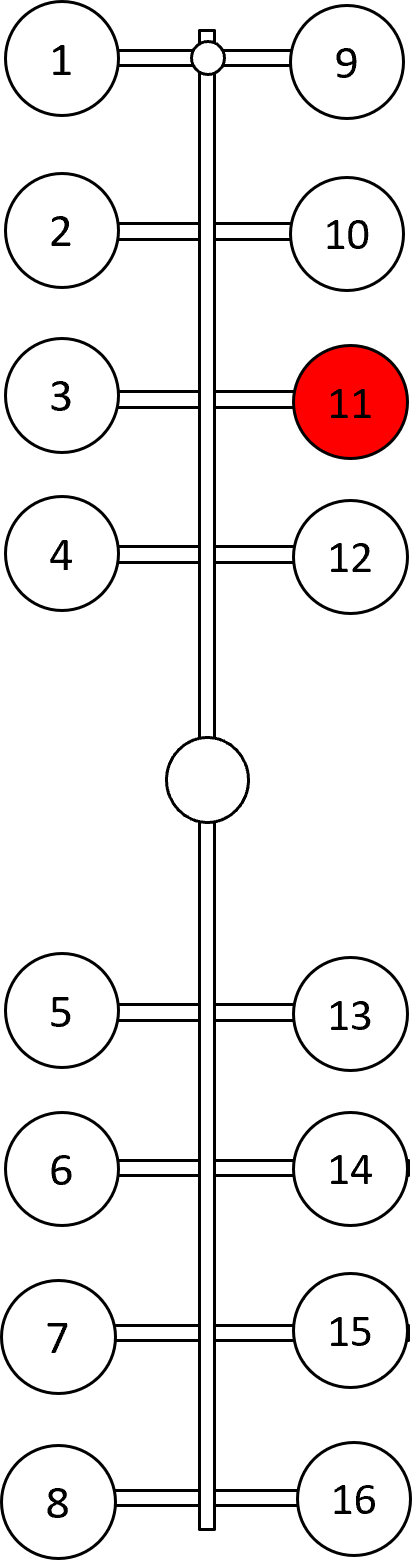
src/main/webapp/assets/imagens e grades moldes/Esferográficas/Conexão/Conexão Esf. - 16 Cav.-Molde 156/grade molde 156 - conexão.png
