LcAvila/grade_moldes/src/main/webapp/assets/imagens e grades moldes/Esferográficas/Conexão/Conexão Esf. - 64 Cav-Molde 98/desenho - molde 98.png

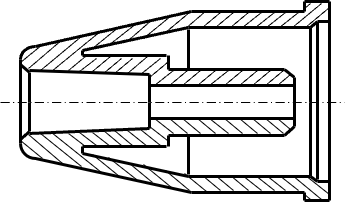
src/main/webapp/assets/imagens e grades moldes/Esferográficas/Conexão/Conexão Esf. - 64 Cav-Molde 98/desenho - molde 98.png
