LcAvila/grade_moldes/src/main/webapp/assets/imagens e grades moldes/Esferográficas/Conexão/Conexão Esf. - 96 Cav-Molde 200/grade - molde 200.png

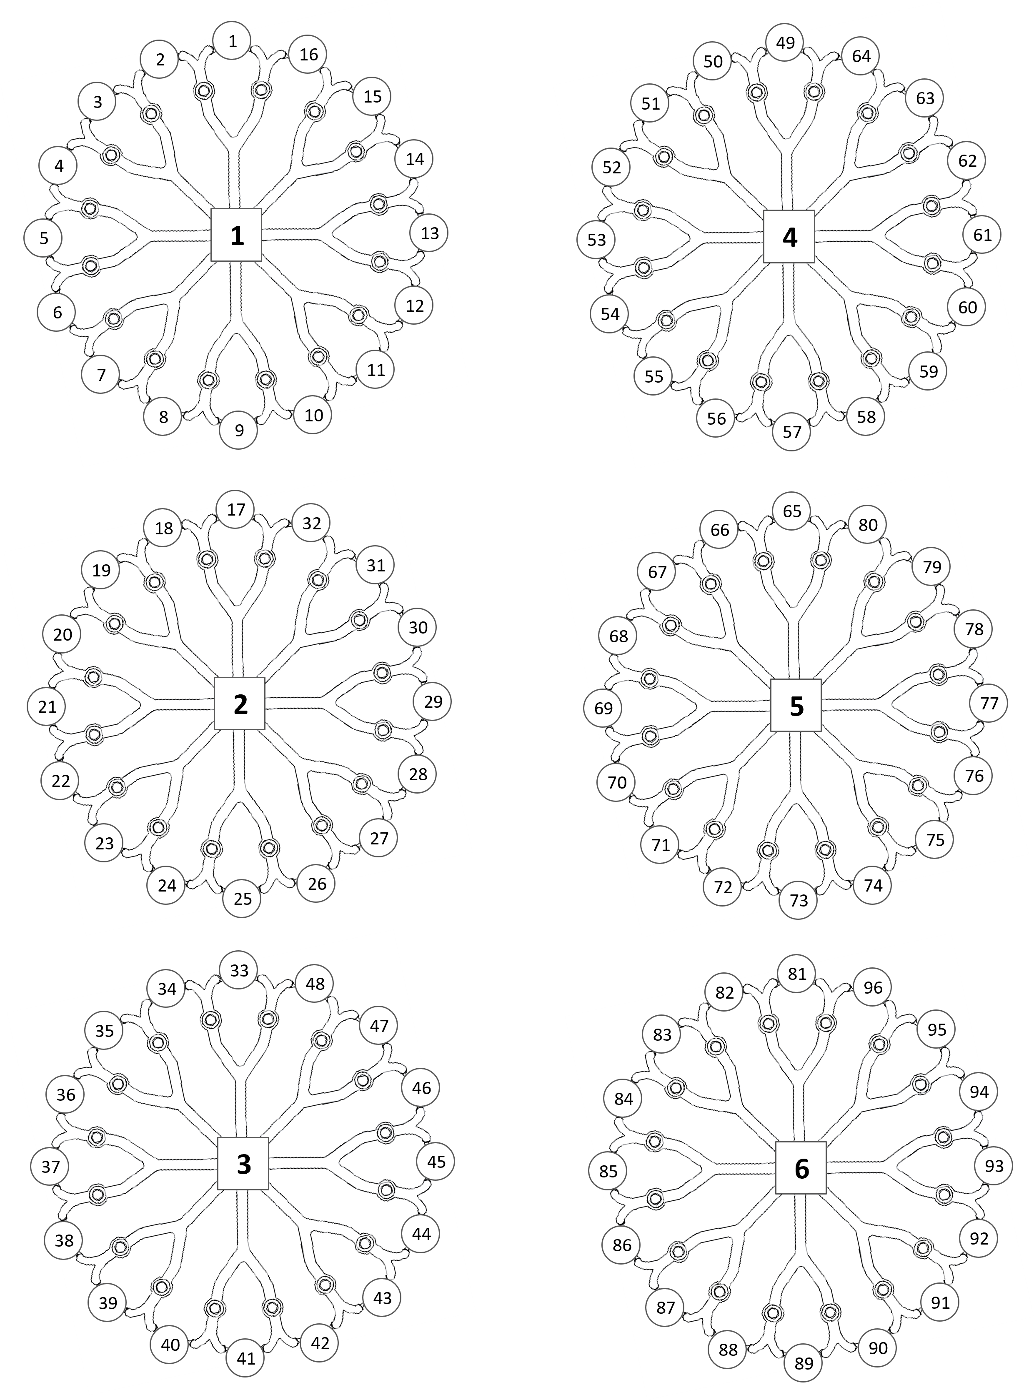
src/main/webapp/assets/imagens e grades moldes/Esferográficas/Conexão/Conexão Esf. - 96 Cav-Molde 200/grade - molde 200.png
