LcAvila/grade_moldes/src/main/webapp/assets/imagens e grades moldes/Esferográficas/Corpos/Corpo 07 - 64 cav - Molde 192/grade - molde 192.png

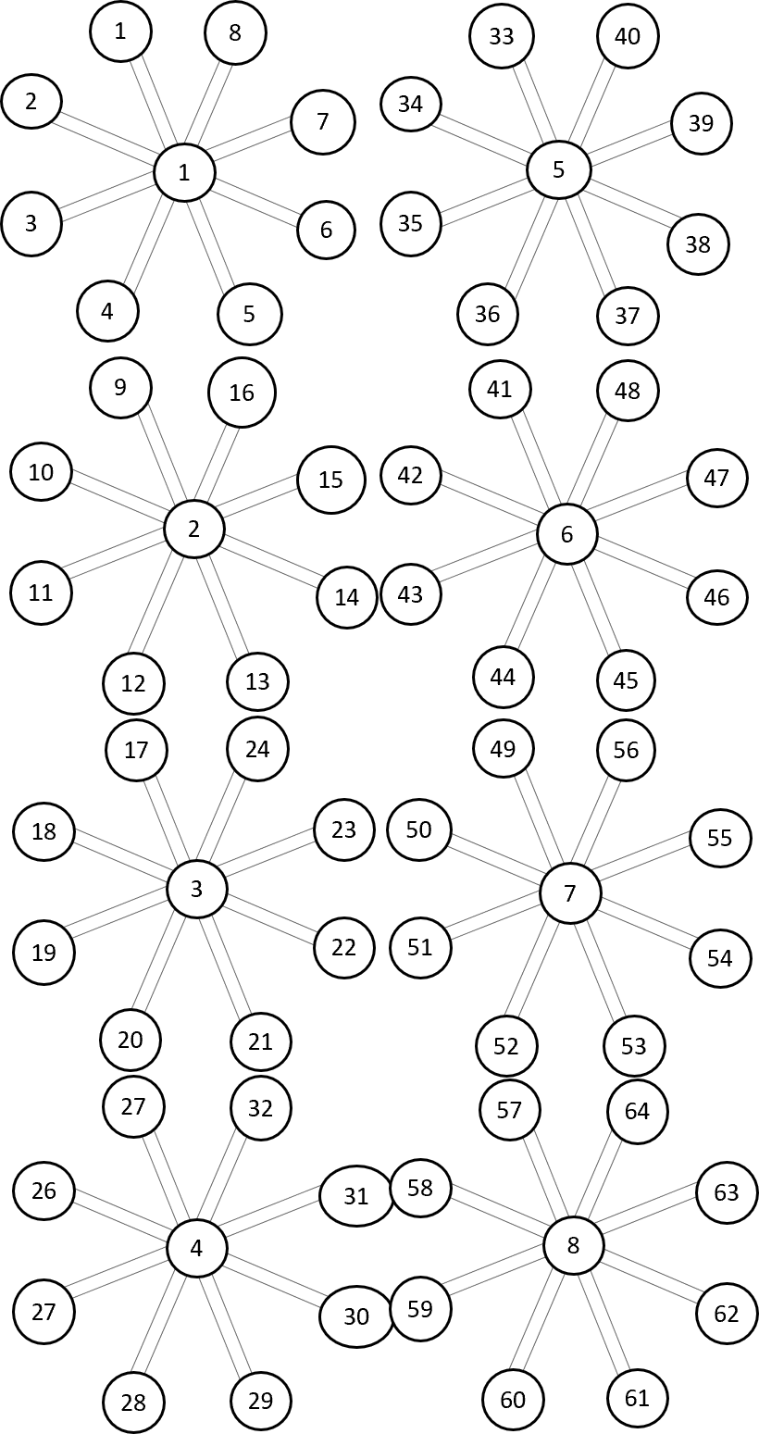
src/main/webapp/assets/imagens e grades moldes/Esferográficas/Corpos/Corpo 07 - 64 cav - Molde 192/grade - molde 192.png
