LcAvila/grade_moldes/src/main/webapp/assets/imagens e grades moldes/Esferográficas/Corpos/Corpo 07 - 64 cav - Molde 197/grade - molde 197.png

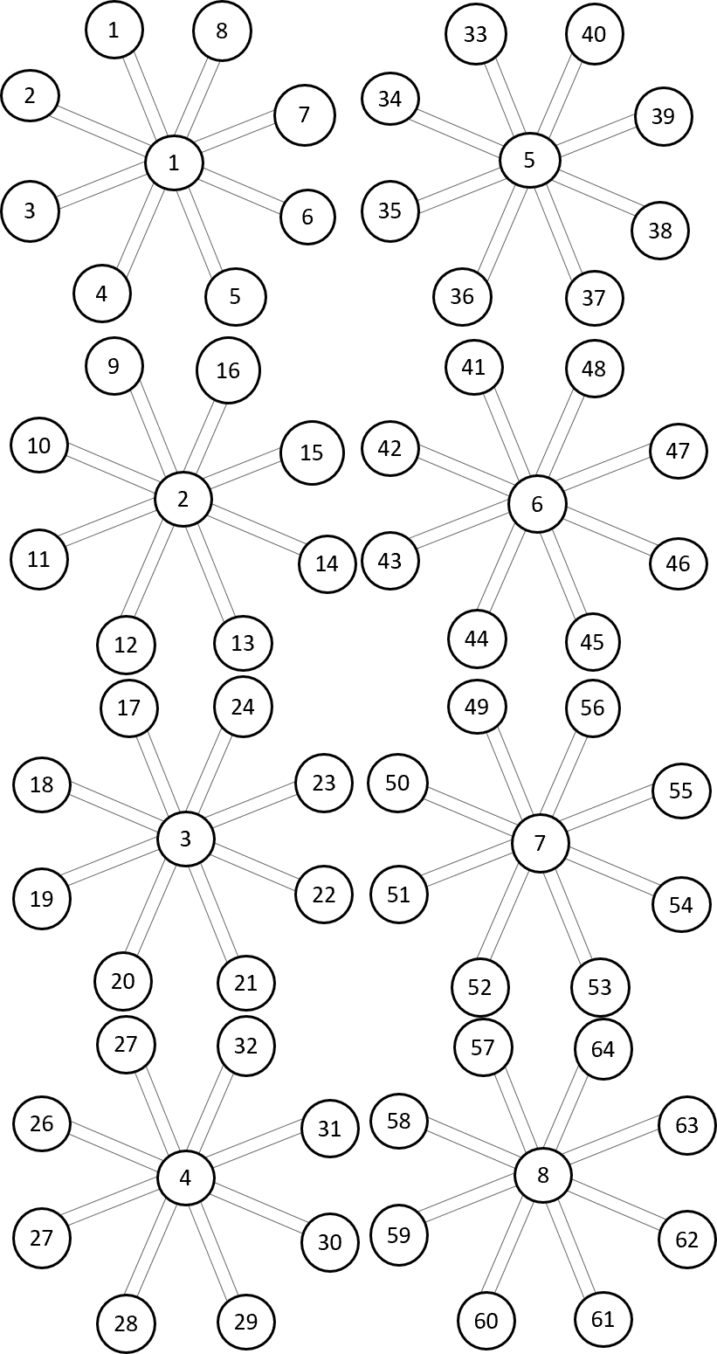
src/main/webapp/assets/imagens e grades moldes/Esferográficas/Corpos/Corpo 07 - 64 cav - Molde 197/grade - molde 197.png
