LcAvila/grade_moldes/src/main/webapp/assets/imagens e grades moldes/Esferográficas/Corpos/Corpo 07 Plus- 16 Cav - Molde 153/grade - molde 153.png

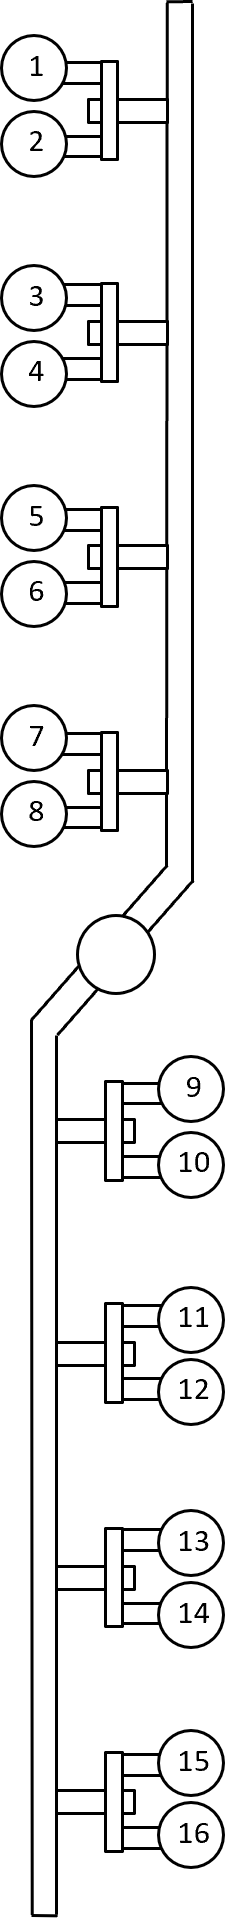
src/main/webapp/assets/imagens e grades moldes/Esferográficas/Corpos/Corpo 07 Plus- 16 Cav - Molde 153/grade - molde 153.png
