LcAvila/grade_moldes/src/main/webapp/assets/imagens e grades moldes/Esferográficas/Corpos/Corpo 07- 64 Cav - Molde 165/grade - molde 165.png

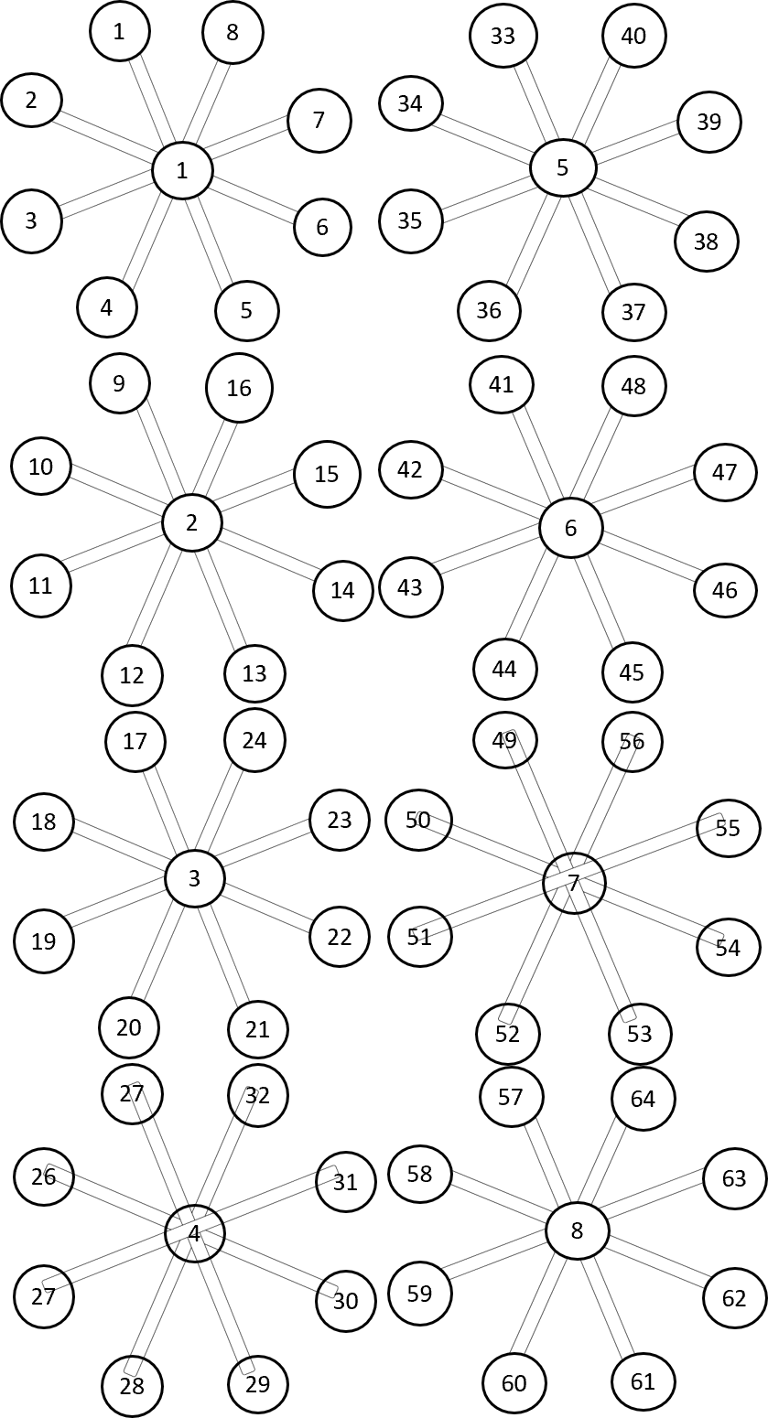
src/main/webapp/assets/imagens e grades moldes/Esferográficas/Corpos/Corpo 07- 64 Cav - Molde 165/grade - molde 165.png
