LcAvila/grade_moldes/src/main/webapp/assets/imagens e grades moldes/Esferográficas/Corpos/Corpo 07- 64Cav - Molde 108/grade - molde 108.png

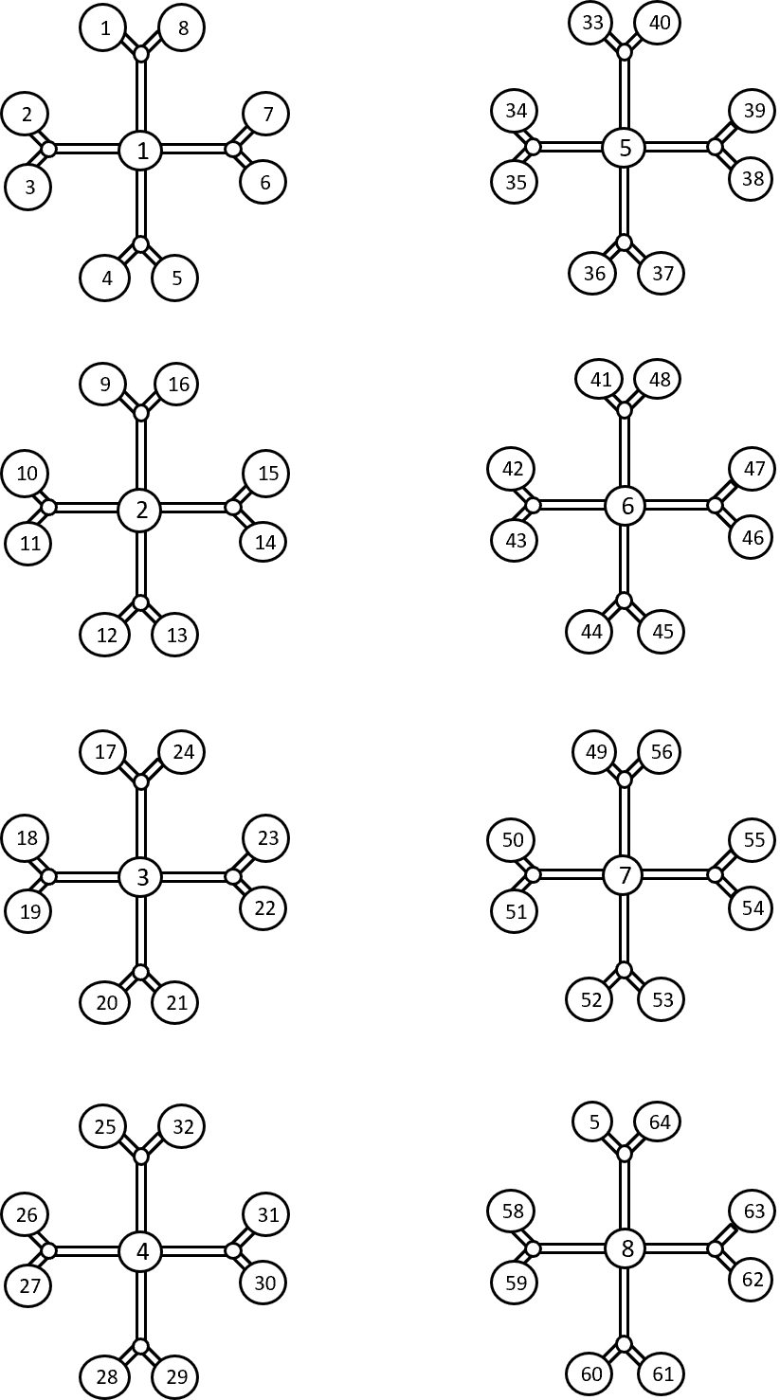
src/main/webapp/assets/imagens e grades moldes/Esferográficas/Corpos/Corpo 07- 64Cav - Molde 108/grade - molde 108.png
