LcAvila/grade_moldes/src/main/webapp/assets/imagens e grades moldes/Esferográficas/Corpos/Corpo Estojo Magister - 8 cav. - Molde 186/grade - molde 186.png

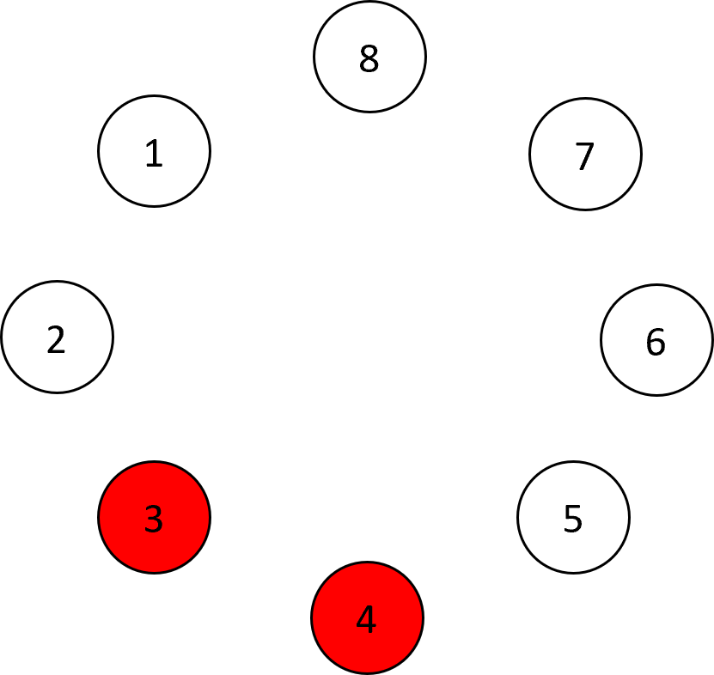
src/main/webapp/assets/imagens e grades moldes/Esferográficas/Corpos/Corpo Estojo Magister - 8 cav. - Molde 186/grade - molde 186.png
