LcAvila/grade_moldes/src/main/webapp/assets/imagens e grades moldes/Esferográficas/Corpos/Corpo Top - 64 Cav - Molde 190/grade - molde 190.png

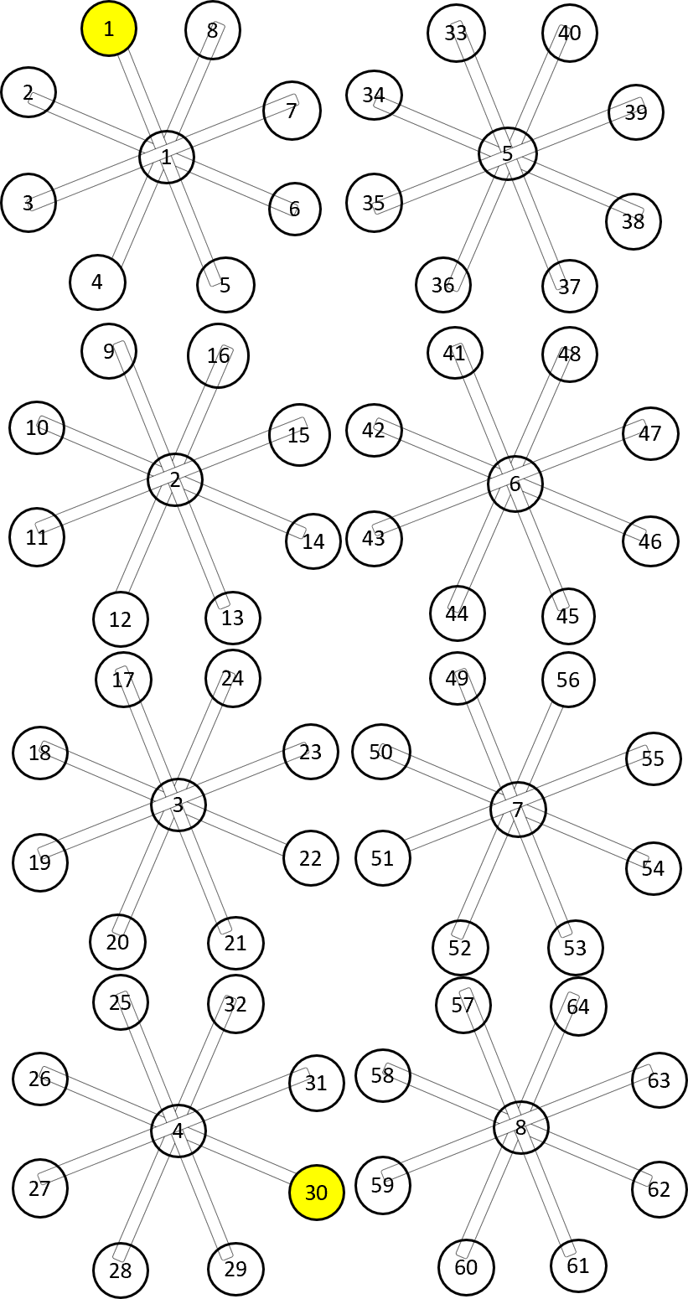
src/main/webapp/assets/imagens e grades moldes/Esferográficas/Corpos/Corpo Top - 64 Cav - Molde 190/grade - molde 190.png
