LcAvila/grade_moldes/src/main/webapp/assets/imagens e grades moldes/Esferográficas/Tampinhas/Tampinha Esf. - 16 Cav - Molde 156/grade - molde 156.png

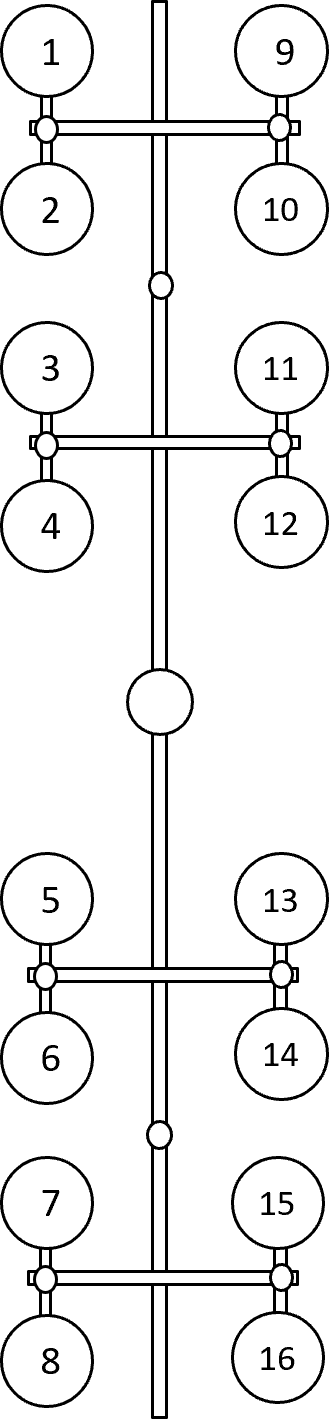
src/main/webapp/assets/imagens e grades moldes/Esferográficas/Tampinhas/Tampinha Esf. - 16 Cav - Molde 156/grade - molde 156.png
