LcAvila/grade_moldes/src/main/webapp/assets/imagens e grades moldes/Hidrográficas/Corpo/Corpo Hidrog. HNG - 64 Cav - Molde 199/grade - molde 199.png

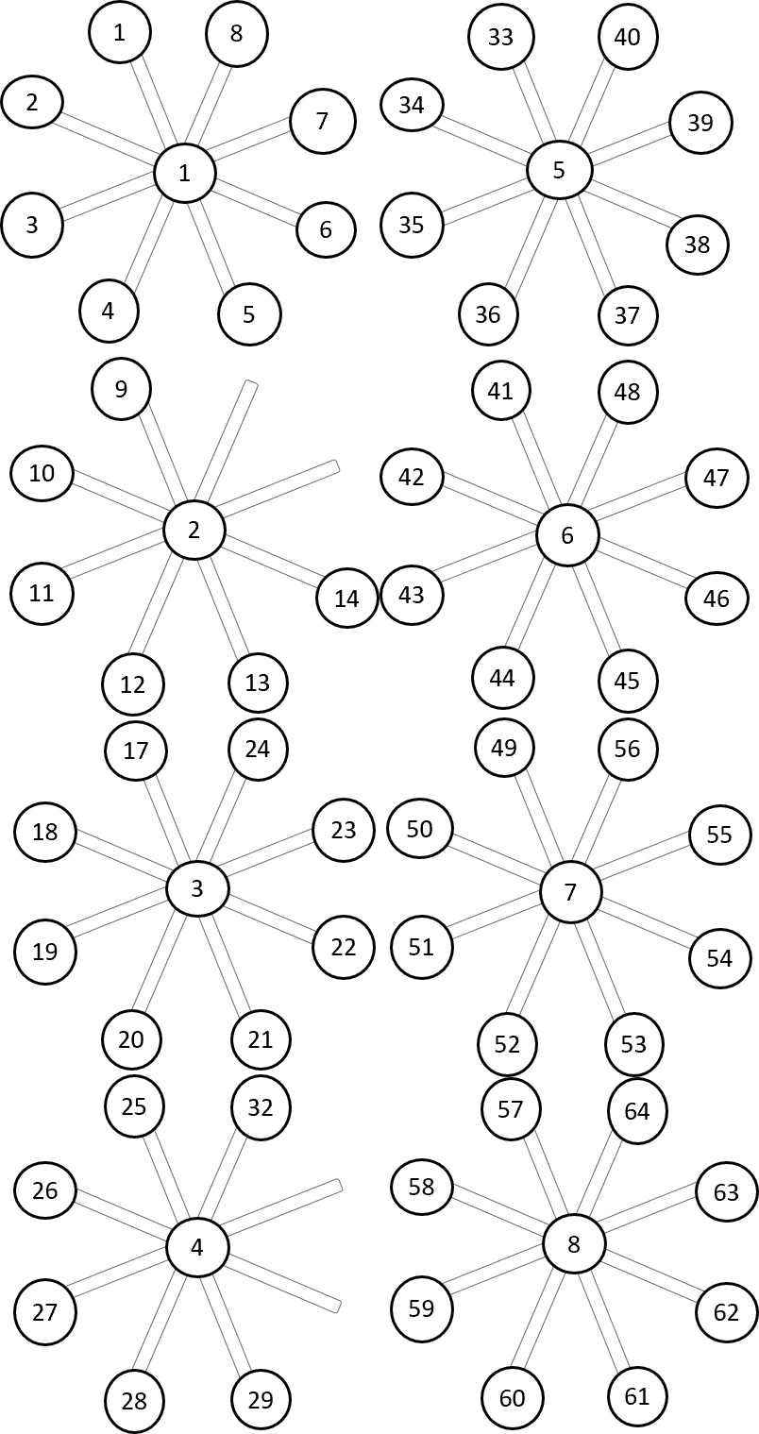
src/main/webapp/assets/imagens e grades moldes/Hidrográficas/Corpo/Corpo Hidrog. HNG - 64 Cav - Molde 199/grade - molde 199.png
