LcAvila/grade_moldes/src/main/webapp/assets/imagens e grades moldes/Hidrográficas/Microline/Conexão Microline - 16 Cav- Molde 150/grade - molde 150.png

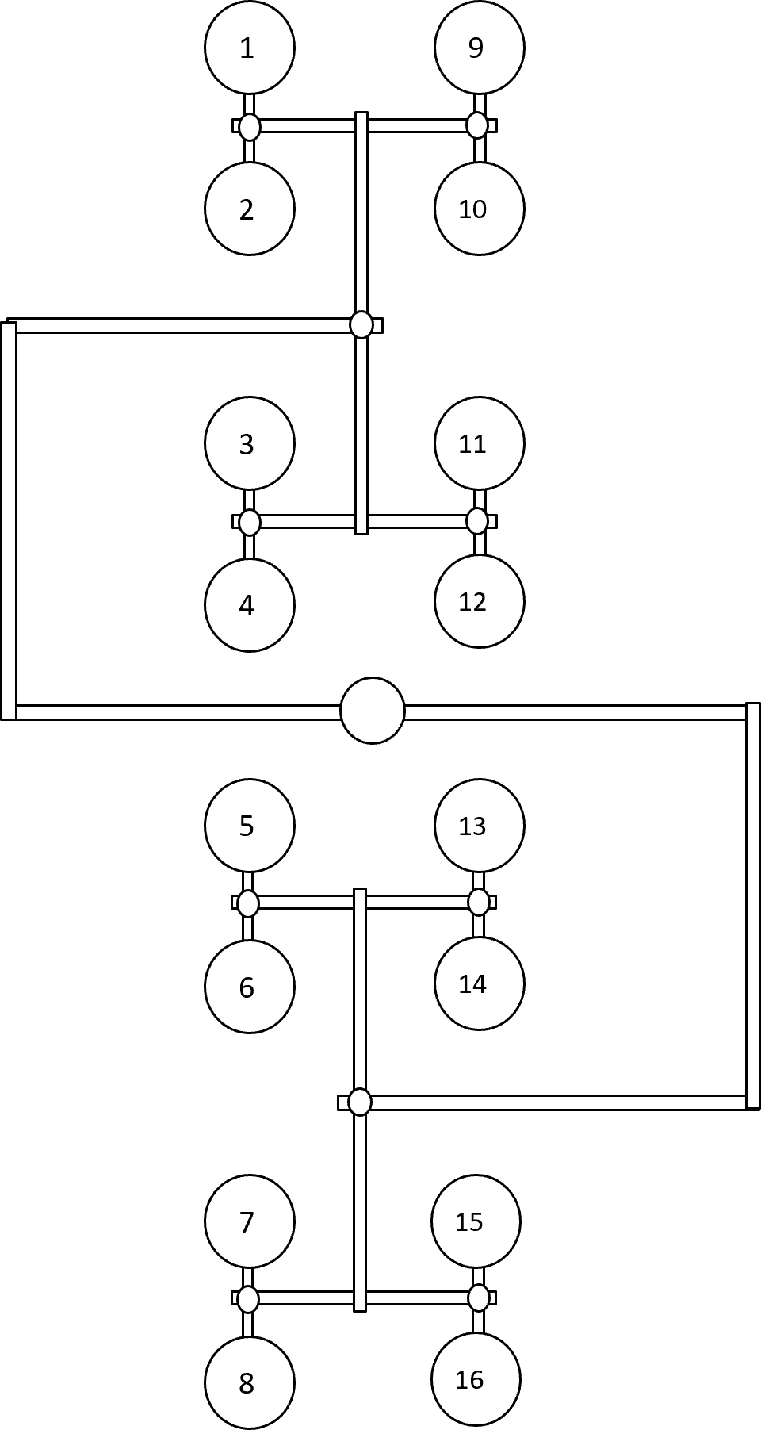
src/main/webapp/assets/imagens e grades moldes/Hidrográficas/Microline/Conexão Microline - 16 Cav- Molde 150/grade - molde 150.png
