LcAvila/grade_moldes/src/main/webapp/assets/imagens e grades moldes/Hidrográficas/Microline/Tampa Microline - 16 Cav - Molde 152/grade - molde 152.png

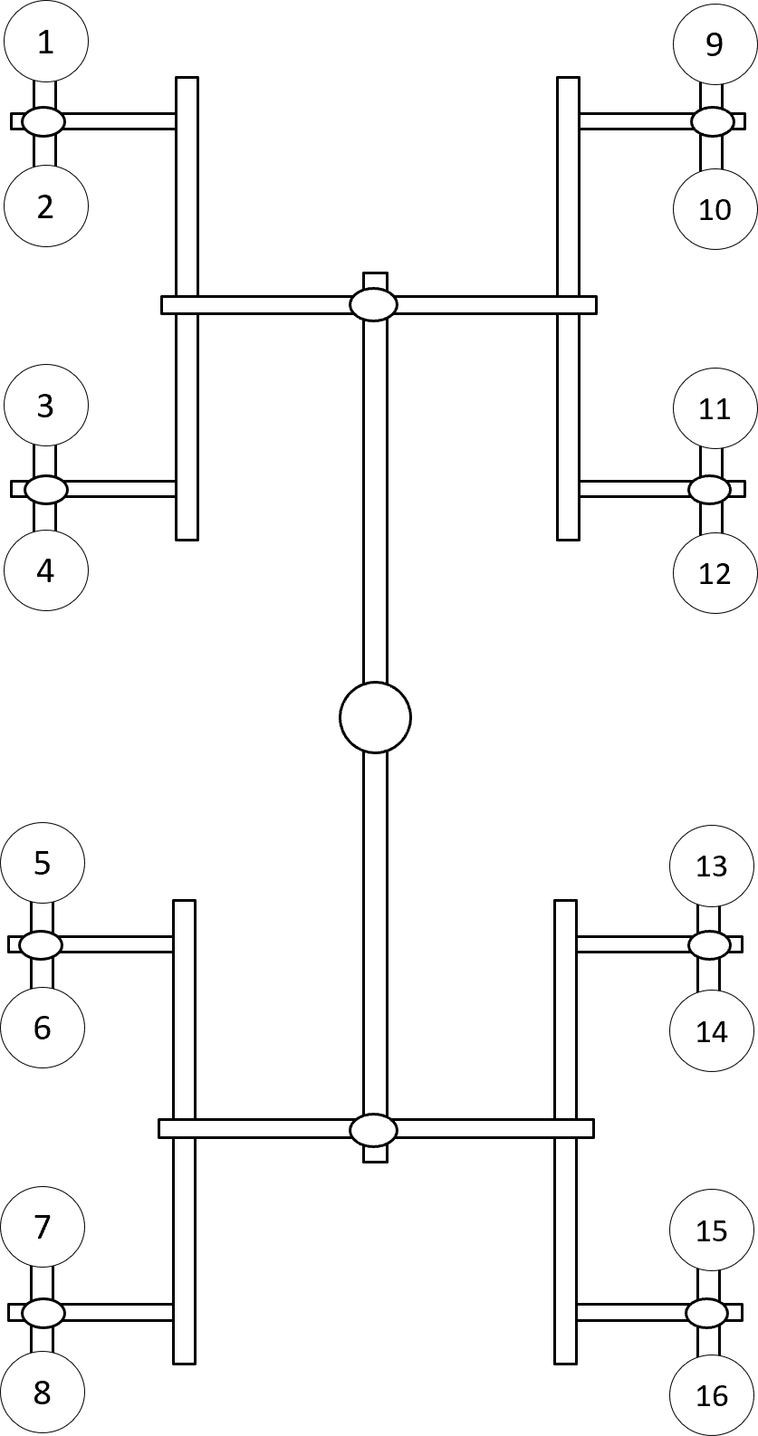
src/main/webapp/assets/imagens e grades moldes/Hidrográficas/Microline/Tampa Microline - 16 Cav - Molde 152/grade - molde 152.png
