LcAvila/grade_moldes/src/main/webapp/assets/imagens e grades moldes/Hidrográficas/Microline/Tampa Microline - 32 Cav - Molde 193/grade - molde 193.png

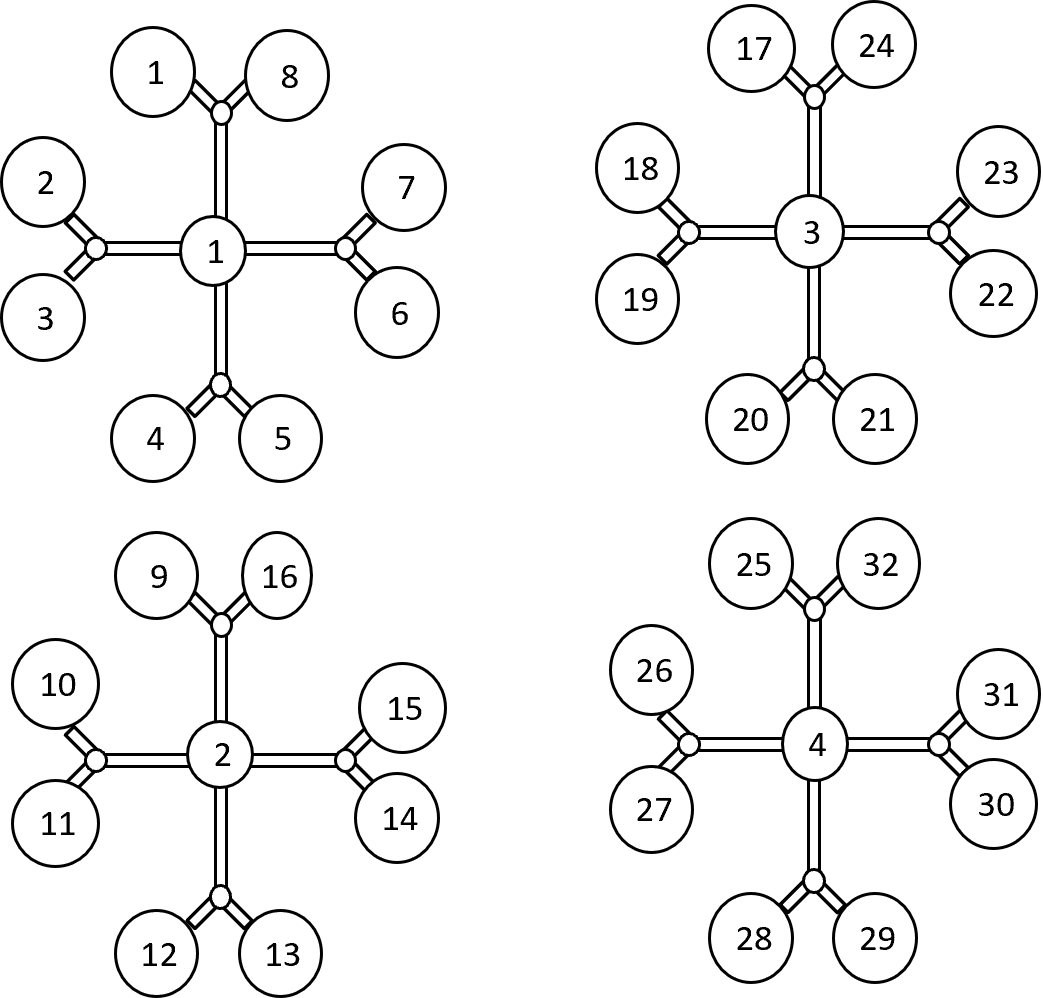
src/main/webapp/assets/imagens e grades moldes/Hidrográficas/Microline/Tampa Microline - 32 Cav - Molde 193/grade - molde 193.png
