LcAvila/grade_moldes/src/main/webapp/assets/imagens e grades moldes/Hidrográficas/Microline/Tampinha Microline - 16 Cav - Molde 151/grade - molde 151.png

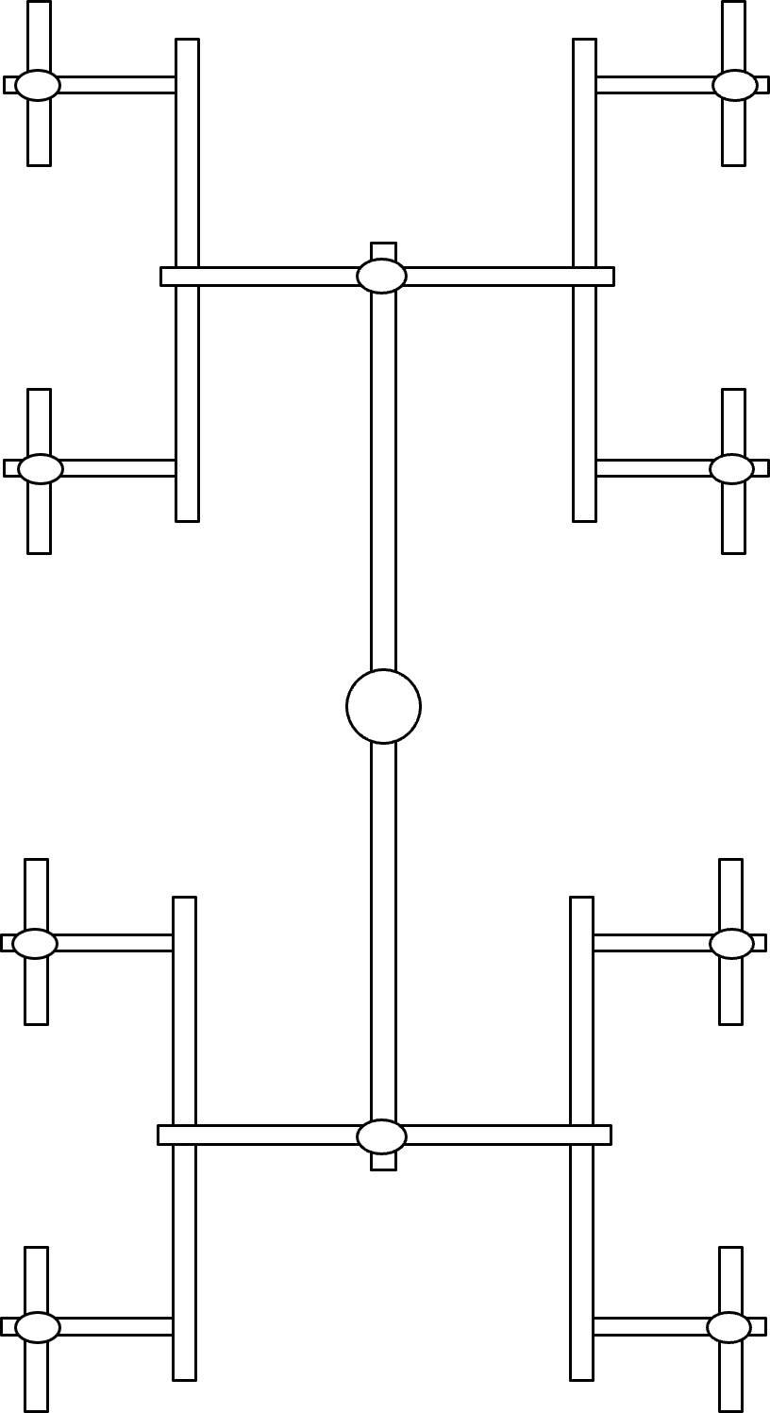
src/main/webapp/assets/imagens e grades moldes/Hidrográficas/Microline/Tampinha Microline - 16 Cav - Molde 151/grade - molde 151.png
