LcAvila/grade_moldes/src/main/webapp/assets/imagens e grades moldes/Hidrográficas/Tampa/Tampa Hidrog. Color - 32 Cav - Molde 147A/grade - molde 147A.png

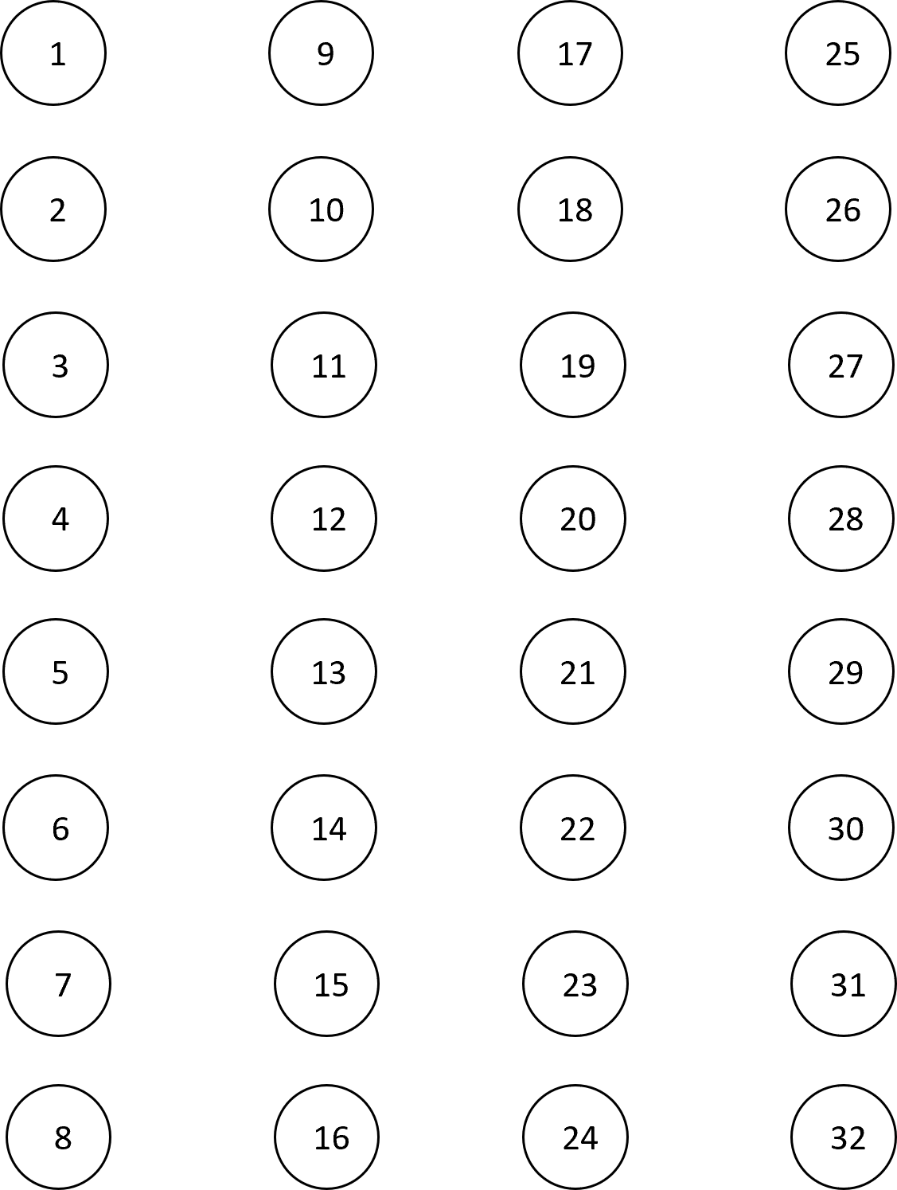
src/main/webapp/assets/imagens e grades moldes/Hidrográficas/Tampa/Tampa Hidrog. Color - 32 Cav - Molde 147A/grade - molde 147A.png
