LcAvila/grade_moldes/src/main/webapp/assets/imagens e grades moldes/Hidrográficas/Tampa/Tampa Hidrog. Color - 48 Cav - Molde 110/grade - molde 110.png

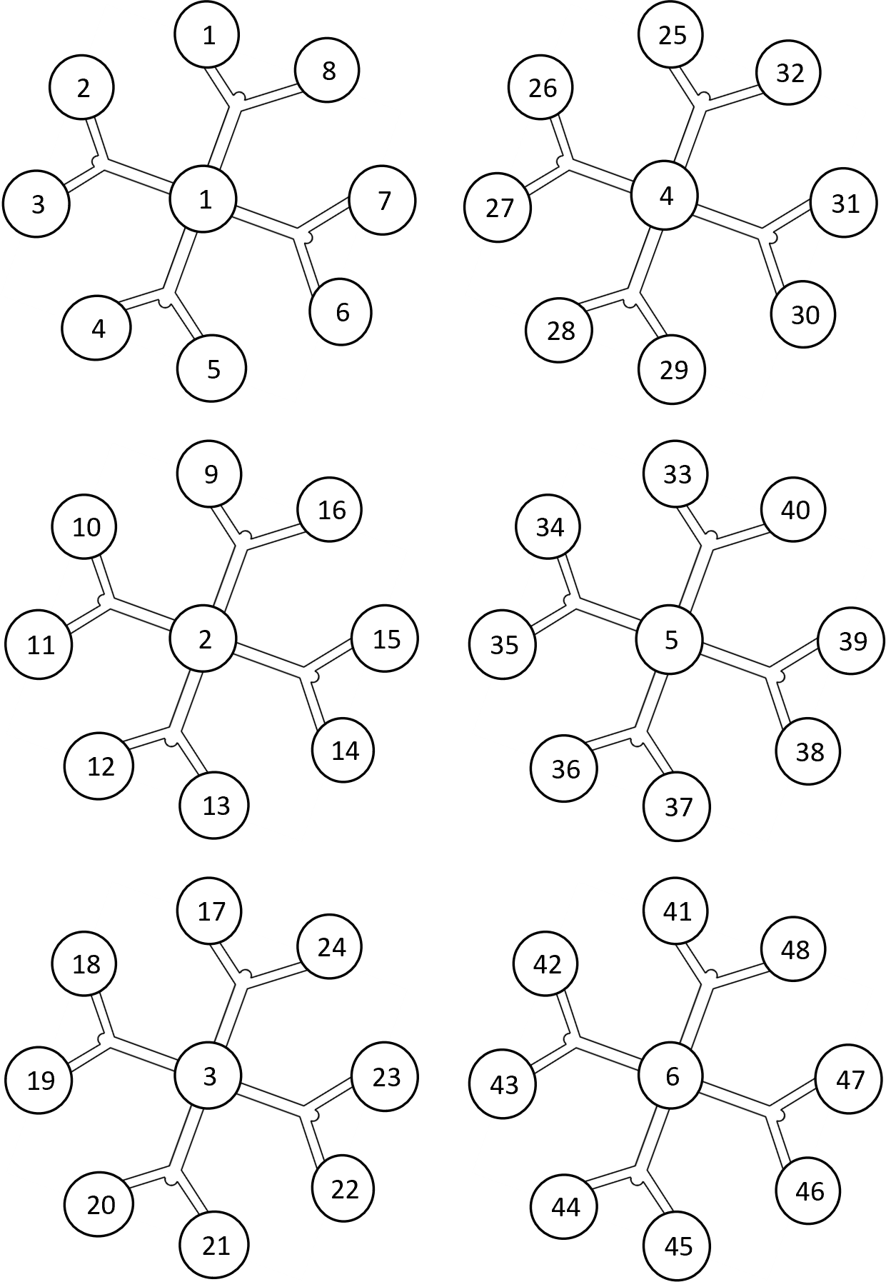
src/main/webapp/assets/imagens e grades moldes/Hidrográficas/Tampa/Tampa Hidrog. Color - 48 Cav - Molde 110/grade - molde 110.png
