LcAvila/grade_moldes/src/main/webapp/assets/imagens e grades moldes/Hidrográficas/Tampa/Tampa Hidrog. Neo Pen - 64 Cav - Molde 169/grade - molde 169.png

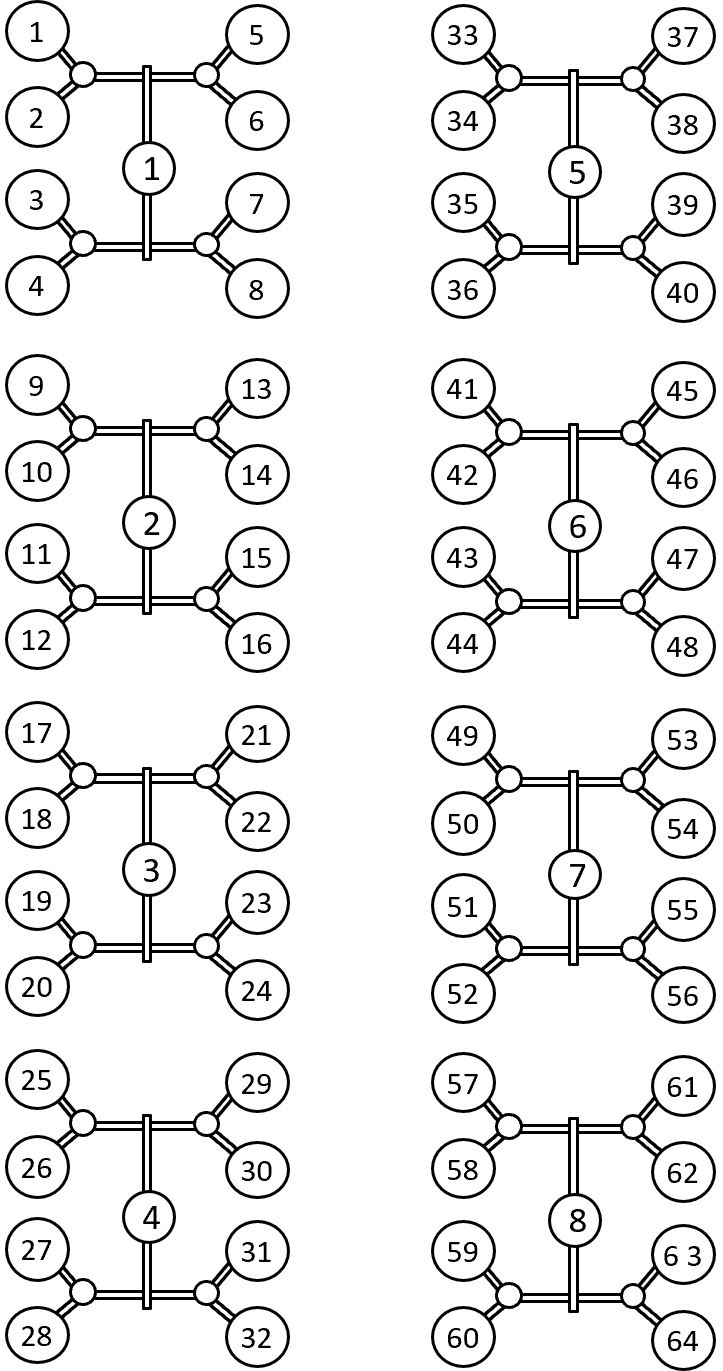
src/main/webapp/assets/imagens e grades moldes/Hidrográficas/Tampa/Tampa Hidrog. Neo Pen - 64 Cav - Molde 169/grade - molde 169.png
