LcAvila/grade_moldes/src/main/webapp/assets/imagens e grades moldes/Lapiseiras/Botões/Botão Lapiseira Técnico - 16 Cav - Molde 158/desenho - molde 158.png

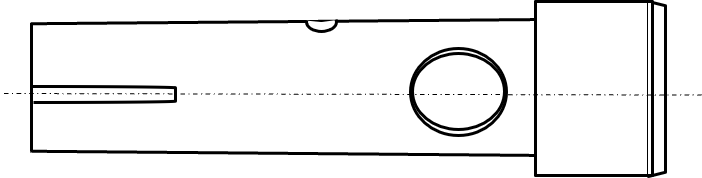
src/main/webapp/assets/imagens e grades moldes/Lapiseiras/Botões/Botão Lapiseira Técnico - 16 Cav - Molde 158/desenho - molde 158.png
