LcAvila/grade_moldes/src/main/webapp/assets/imagens e grades moldes/Lapiseiras/Corpos/Corpo Lapiseira Aluno - 16 Cav - Molde 89/grade - molde 89.png

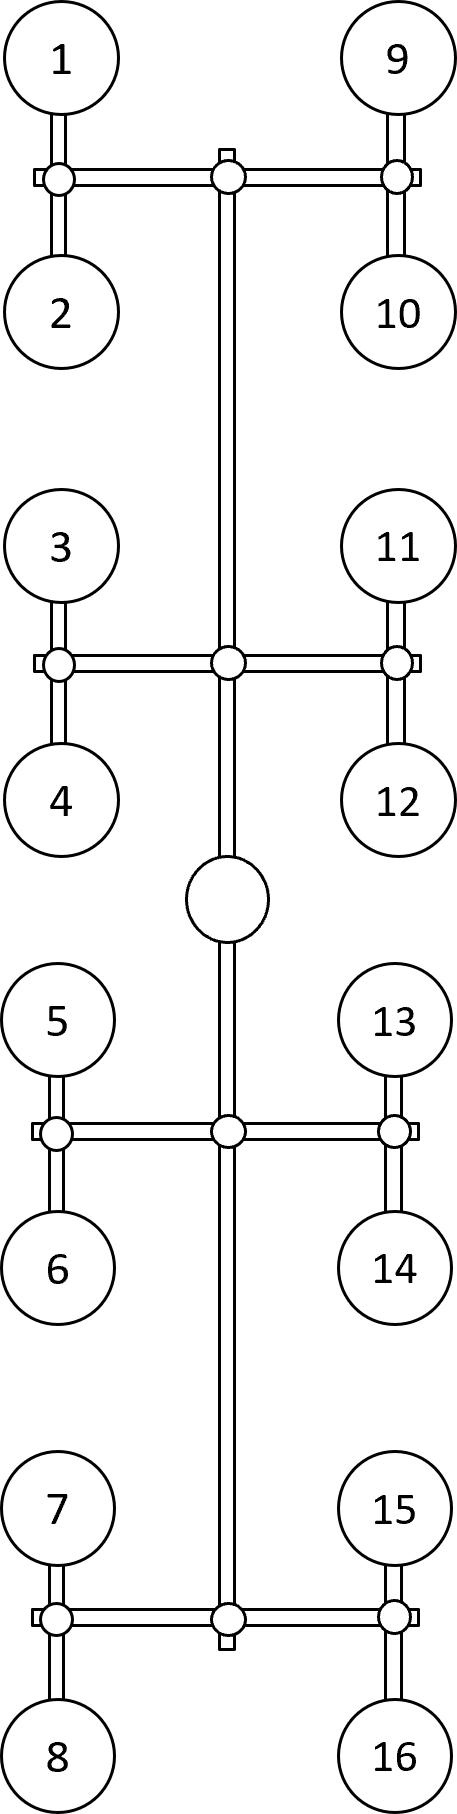
src/main/webapp/assets/imagens e grades moldes/Lapiseiras/Corpos/Corpo Lapiseira Aluno - 16 Cav - Molde 89/grade - molde 89.png
