LcAvila/grade_moldes/src/main/webapp/assets/imagens e grades moldes/Lapiseiras/Corpos/Corpo Lapiseira Técnico - 16 Cav - Molde 159/grade - molde 159.png

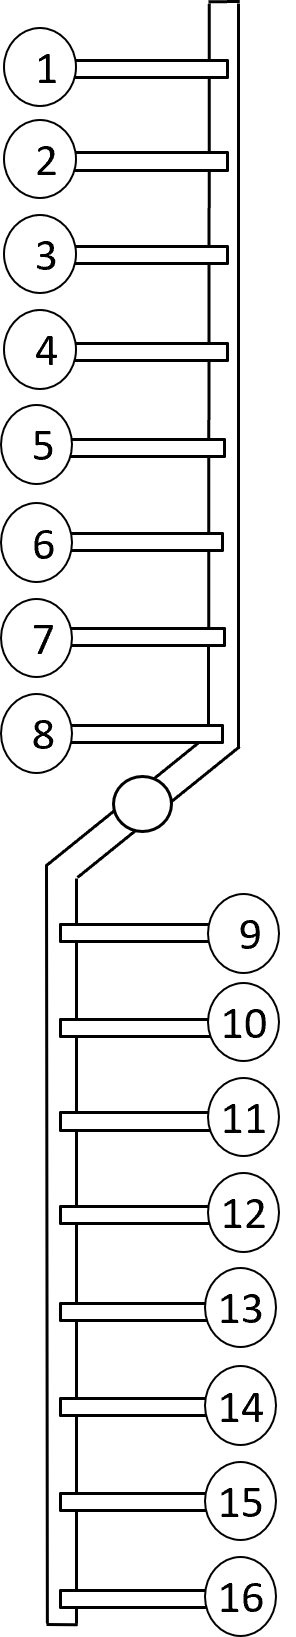
src/main/webapp/assets/imagens e grades moldes/Lapiseiras/Corpos/Corpo Lapiseira Técnico - 16 Cav - Molde 159/grade - molde 159.png
