LcAvila/grade_moldes/src/main/webapp/assets/imagens e grades moldes/Lapiseiras/Dianteiras/Dianteira Lapiseira Técnico - 16 Cav-Molde 160/grade - molde 160.png

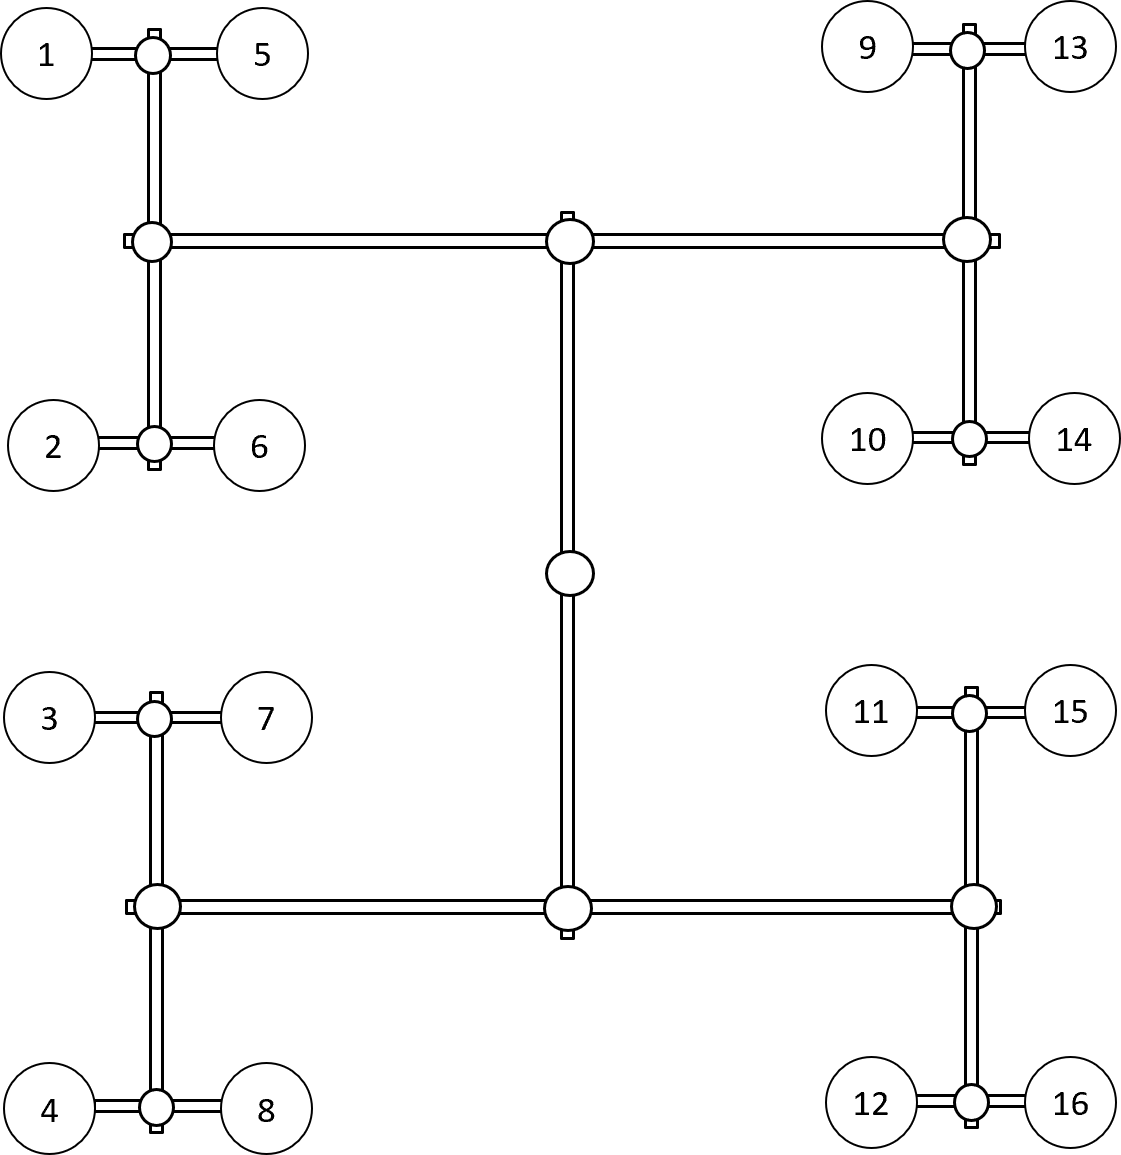
src/main/webapp/assets/imagens e grades moldes/Lapiseiras/Dianteiras/Dianteira Lapiseira Técnico - 16 Cav-Molde 160/grade - molde 160.png
