LcAvila/grade_moldes/src/main/webapp/assets/imagens e grades moldes/Marcadores/Corpos Marcadores/Corpo Marcador Destaq - 16 Cav - Molde 164/grade - molde 164.png

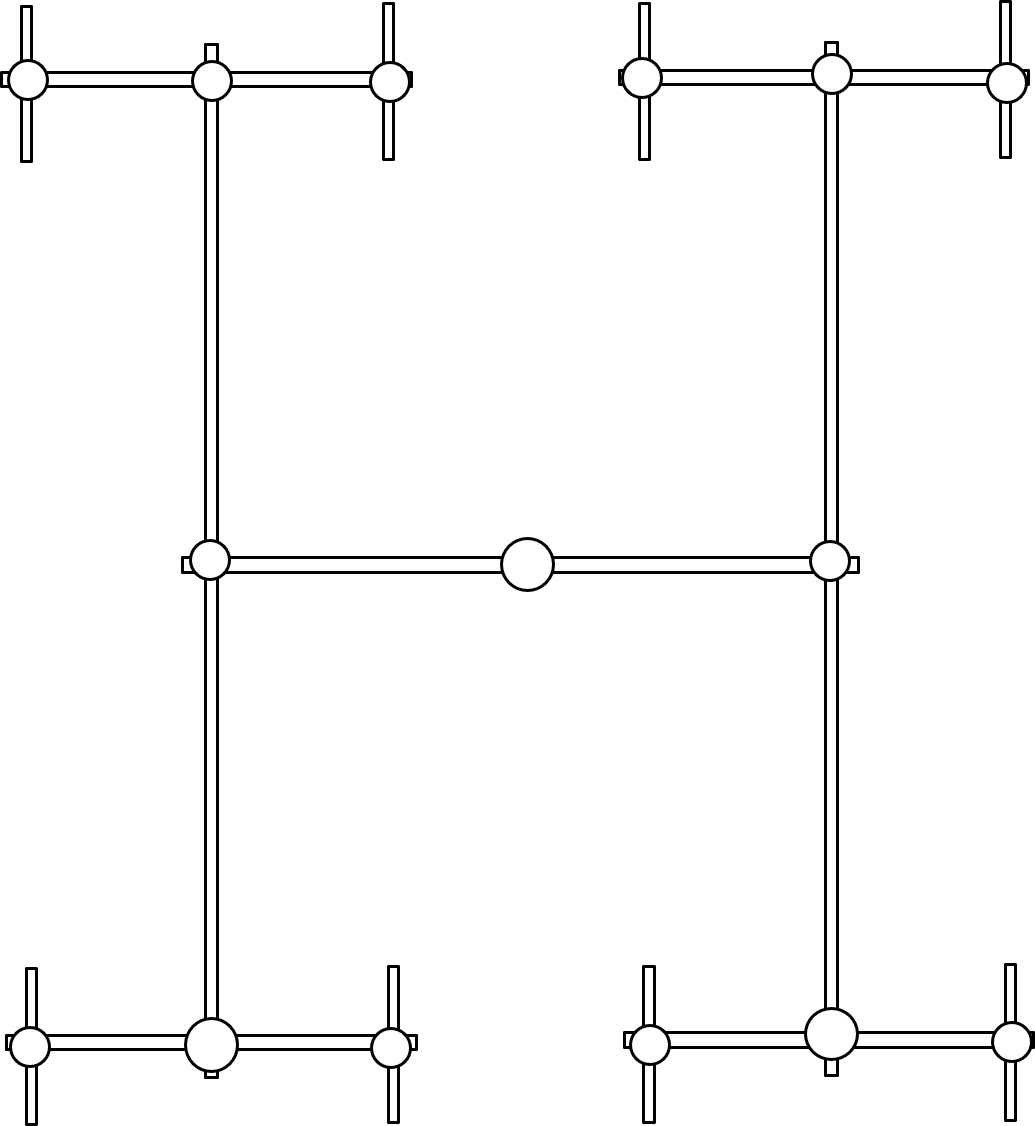
src/main/webapp/assets/imagens e grades moldes/Marcadores/Corpos Marcadores/Corpo Marcador Destaq - 16 Cav - Molde 164/grade - molde 164.png
