LcAvila/grade_moldes/src/main/webapp/assets/imagens e grades moldes/Marcadores/Corpos Marcadores/Corpo Marcador Pincel - 16 Cav - Molde 191/grade - molde 191.png

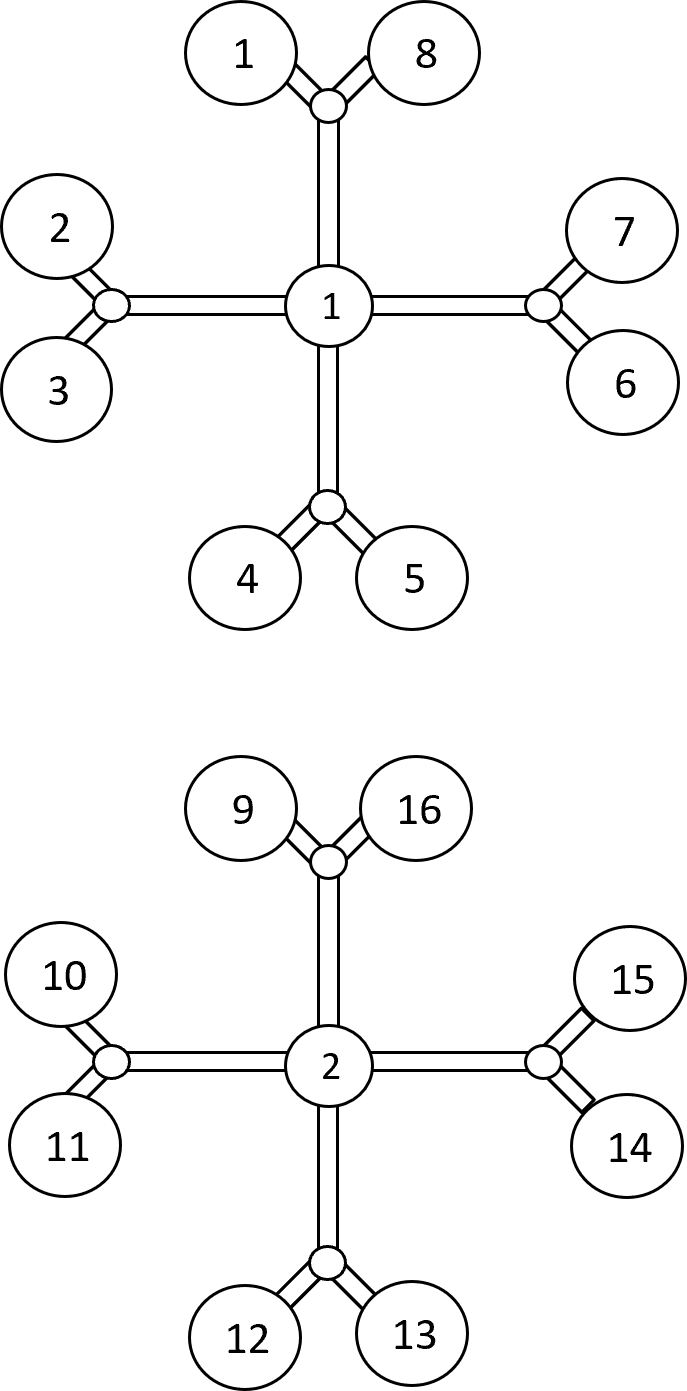
src/main/webapp/assets/imagens e grades moldes/Marcadores/Corpos Marcadores/Corpo Marcador Pincel - 16 Cav - Molde 191/grade - molde 191.png
