LcAvila/grade_moldes/src/main/webapp/assets/imagens e grades moldes/Marcadores/Tampas Marcadores/Tampa Marcador Destaq - 16 Cav - Molde 162/desenho - molde 162.png

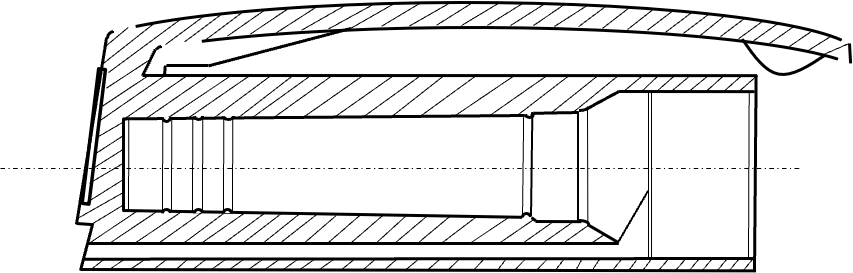
src/main/webapp/assets/imagens e grades moldes/Marcadores/Tampas Marcadores/Tampa Marcador Destaq - 16 Cav - Molde 162/desenho - molde 162.png
