LcAvila/grade_moldes/src/main/webapp/assets/imagens e grades moldes/Marcadores/Tampas Marcadores/Tampa Marcador Pincel - 16 Cav - Molde 145B/grade - molde 145B.png

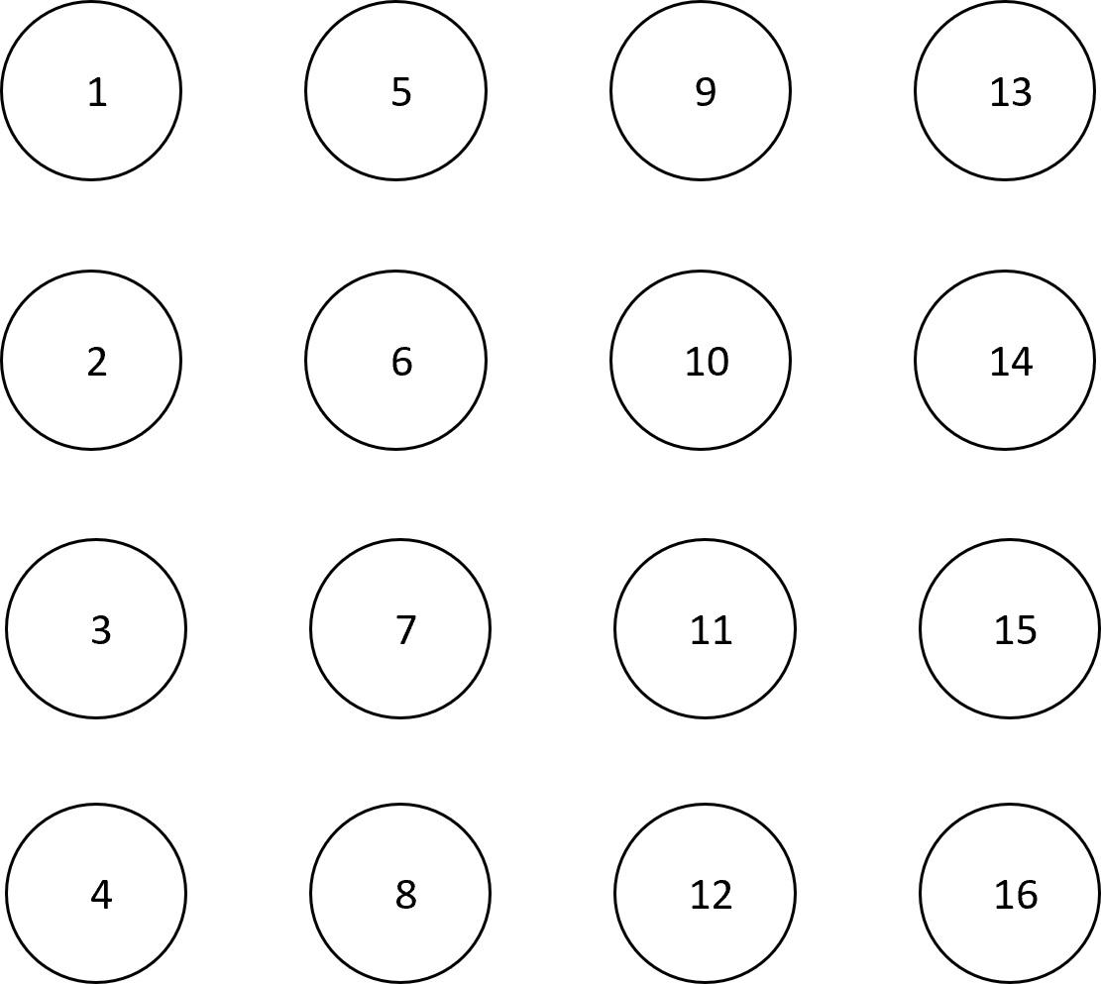
src/main/webapp/assets/imagens e grades moldes/Marcadores/Tampas Marcadores/Tampa Marcador Pincel - 16 Cav - Molde 145B/grade - molde 145B.png
