LcAvila/grade_moldes/src/main/webapp/assets/imagens e grades moldes/Marcadores/Tampas Marcadores/Tampa Marcador Q.B. - 16 Cav. - Molde 189/desenho - molde 189.png

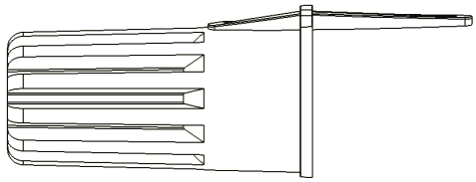
src/main/webapp/assets/imagens e grades moldes/Marcadores/Tampas Marcadores/Tampa Marcador Q.B. - 16 Cav. - Molde 189/desenho - molde 189.png
