LcAvila/grade_moldes/src/main/webapp/assets/imagens e grades moldes/Marcadores/Tampinhas Marcadores/Tampinha Marc. Pincel e Q.B. - 16 Cav - Molde 145C/desenho - molde 145C.png

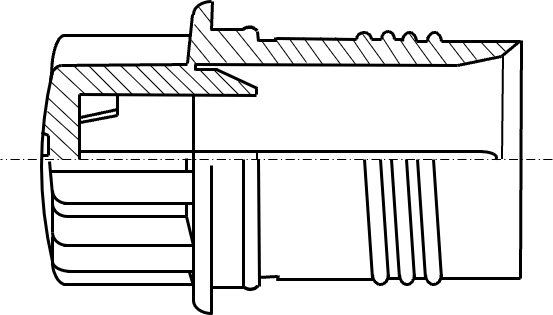
src/main/webapp/assets/imagens e grades moldes/Marcadores/Tampinhas Marcadores/Tampinha Marc. Pincel e Q.B. - 16 Cav - Molde 145C/desenho - molde 145C.png
