LcAvila/grade_moldes/src/main/webapp/assets/imagens e grades moldes/Marcadores/Tampinhas Marcadores/Tampinha Marcador Destaq - 16 Cav - Molde 163/desenho - molde 163.png

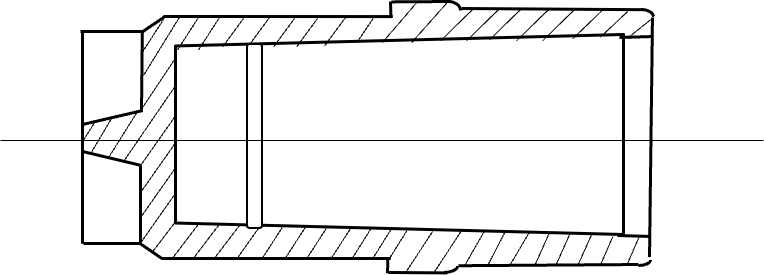
src/main/webapp/assets/imagens e grades moldes/Marcadores/Tampinhas Marcadores/Tampinha Marcador Destaq - 16 Cav - Molde 163/desenho - molde 163.png
