LcAvila/grade_moldes/src/main/webapp/assets/imagens e grades moldes/Reabastecedores/Bico/Bico p- Reabastecedor - 16 Cav - Molde 157/grade - molde 157.png

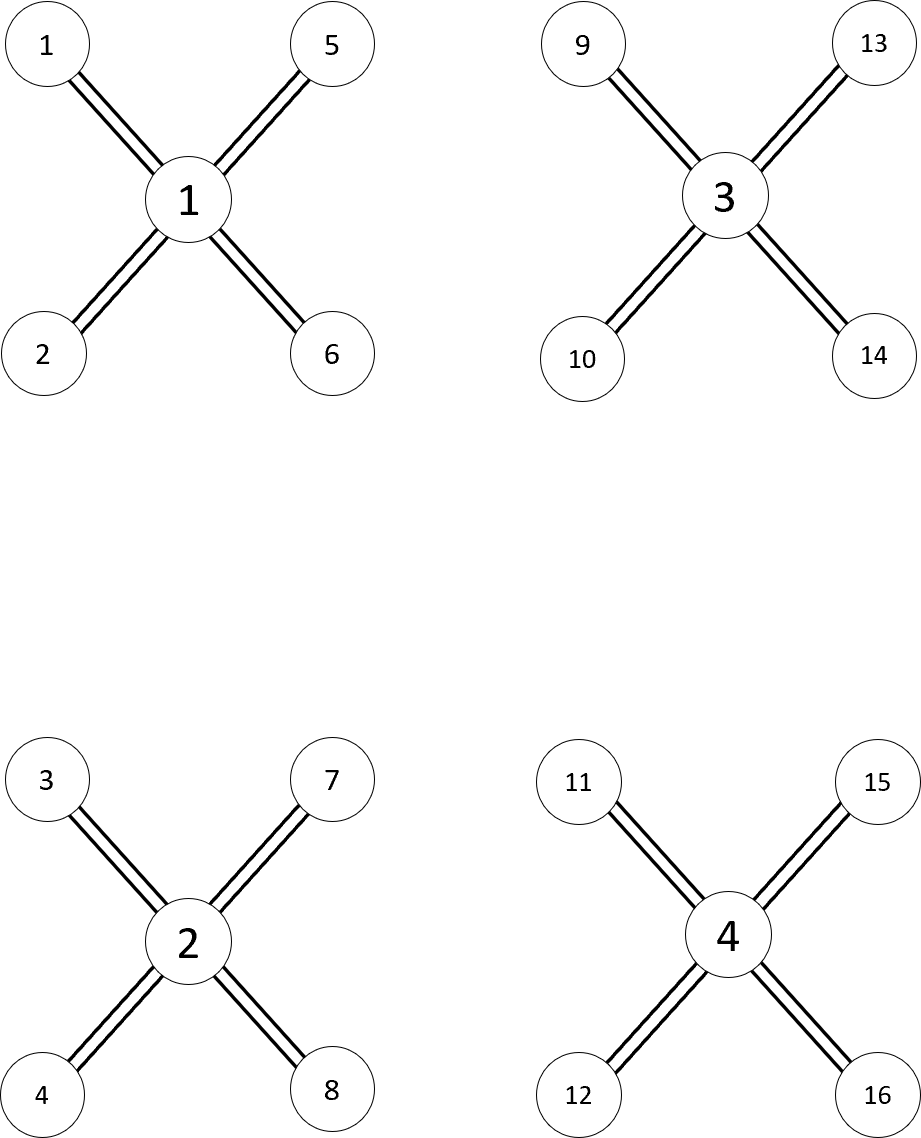
src/main/webapp/assets/imagens e grades moldes/Reabastecedores/Bico/Bico p- Reabastecedor - 16 Cav - Molde 157/grade - molde 157.png
