LcAvila/grade_moldes/src/main/webapp/assets/imagens e grades moldes/Reabastecedores/Tampas/Tampa p- Reabastecedor Pincel- 16 Cav-Molde 145E/grade - molde 145E.png

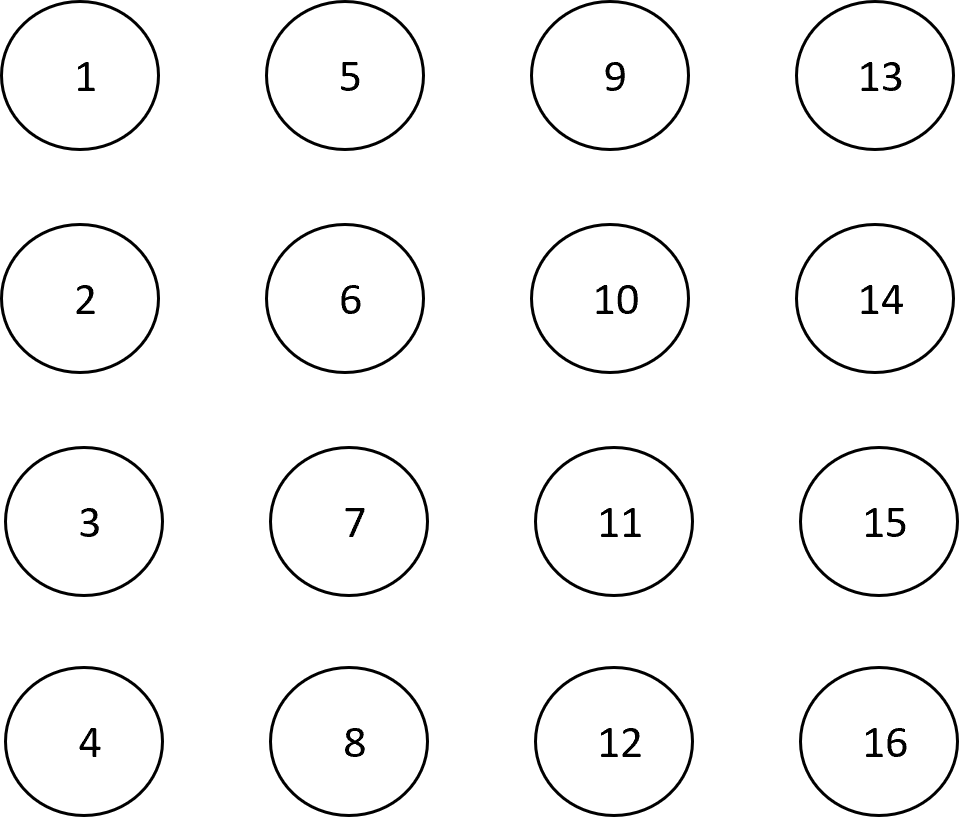
src/main/webapp/assets/imagens e grades moldes/Reabastecedores/Tampas/Tampa p- Reabastecedor Pincel- 16 Cav-Molde 145E/grade - molde 145E.png
