LcAvila/grade_moldes/src/main/webapp/assets/images/molde 11A/bico molde 11A.png

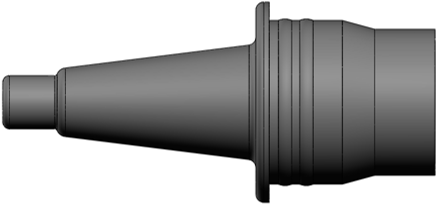
src/main/webapp/assets/images/molde 11A/bico molde 11A.png
