LcAvila/grade_moldes/src/main/webapp/assets/images/molde 11A/cotas.png

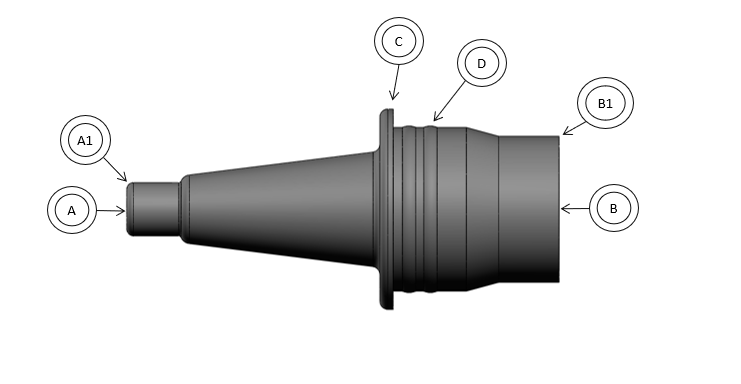
src/main/webapp/assets/images/molde 11A/cotas.png
