LcAvila/grade_moldes/src/main/webapp/assets/images/molde 188/cota.png

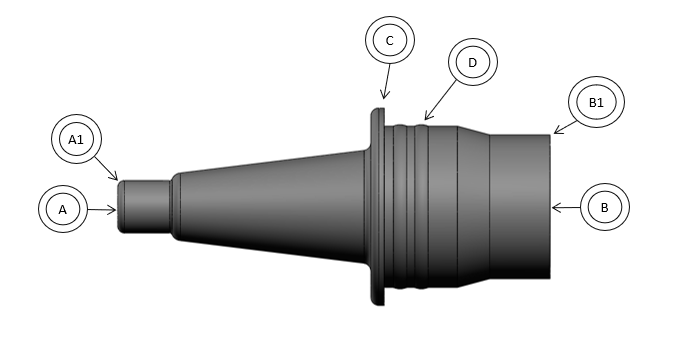
src/main/webapp/assets/images/molde 188/cota.png
