LcAvila/grade_moldes/src/main/webapp/assets/images/molde 202/cota molde 202.png

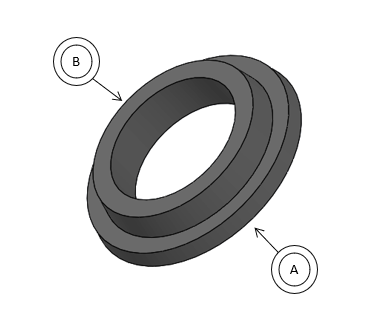
src/main/webapp/assets/images/molde 202/cota molde 202.png
