LcAvila/grade_moldes/src/main/webapp/assets/images/pecas/101.png

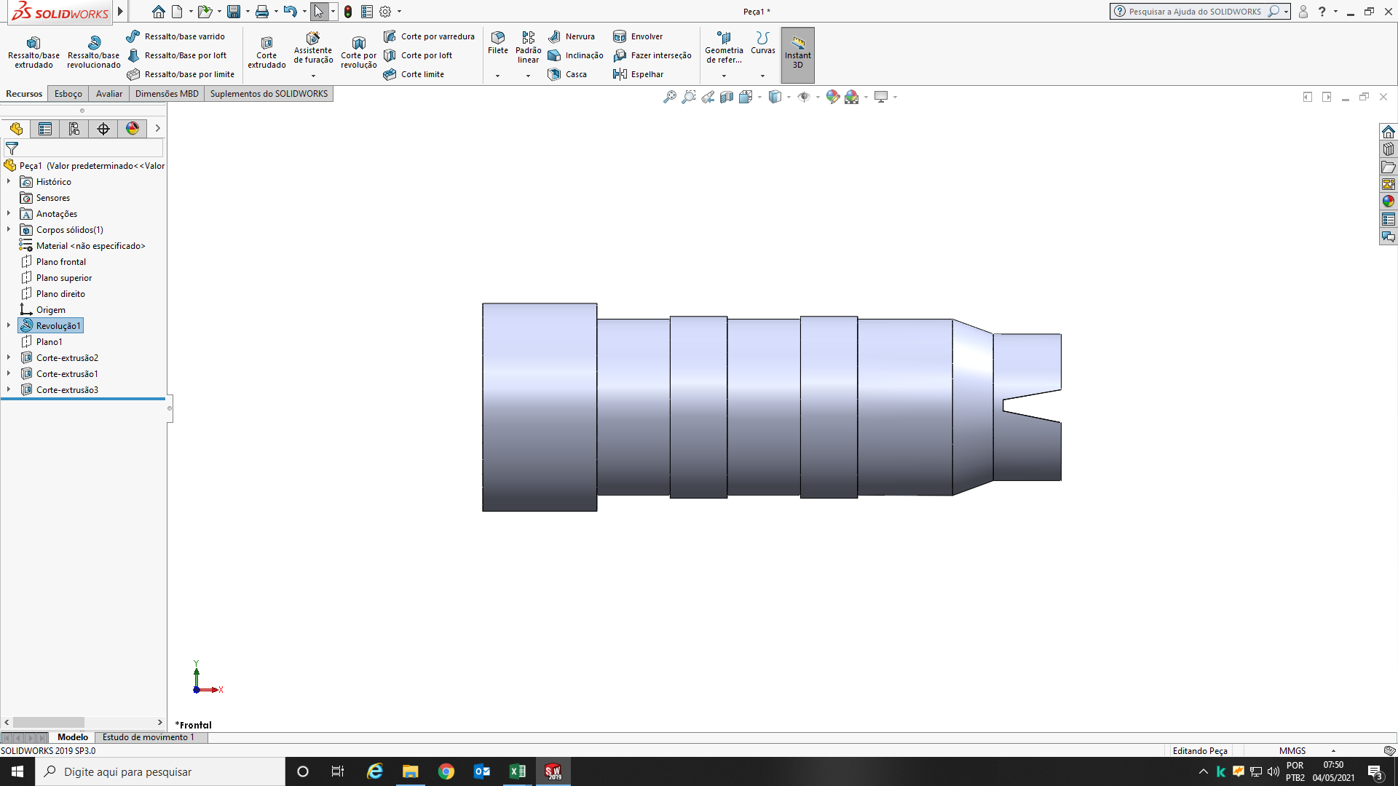
src/main/webapp/assets/images/pecas/101.png
