LcAvila/grade_moldes/src/main/webapp/assets/images/pecas/116A.png

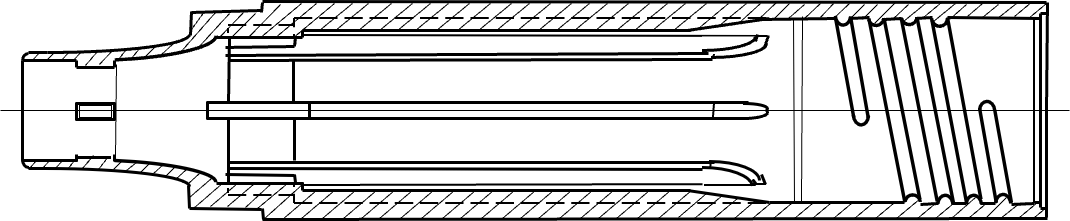
src/main/webapp/assets/images/pecas/116A.png
