LcAvila/grade_moldes/src/main/webapp/assets/images/pecas/145A.png

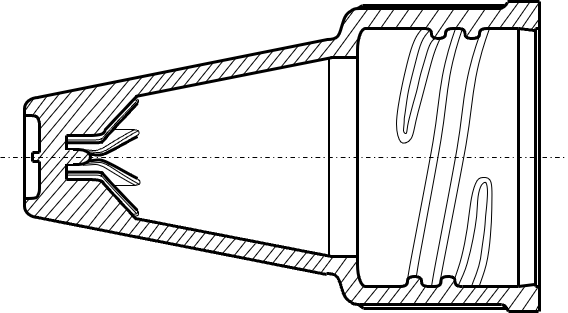
src/main/webapp/assets/images/pecas/145A.png
