LcAvila/grade_moldes/src/main/webapp/assets/images/pecas/145D.png

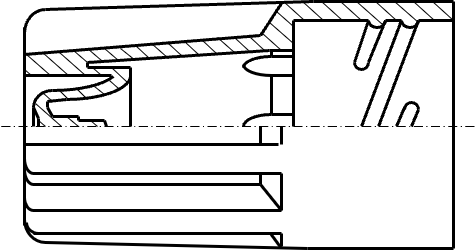
src/main/webapp/assets/images/pecas/145D.png
