LcAvila/grade_moldes/src/main/webapp/assets/images/pecas/145E.png

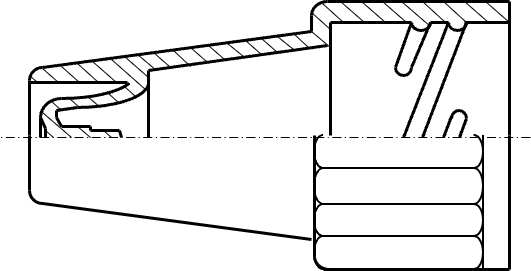
src/main/webapp/assets/images/pecas/145E.png
