LcAvila/grade_moldes/src/main/webapp/assets/images/pecas/147A.png

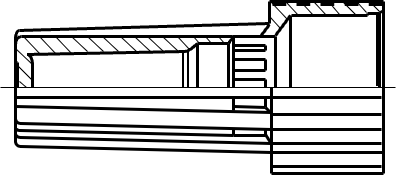
src/main/webapp/assets/images/pecas/147A.png
