LcAvila/grade_moldes/src/main/webapp/assets/images/pecas/150.png

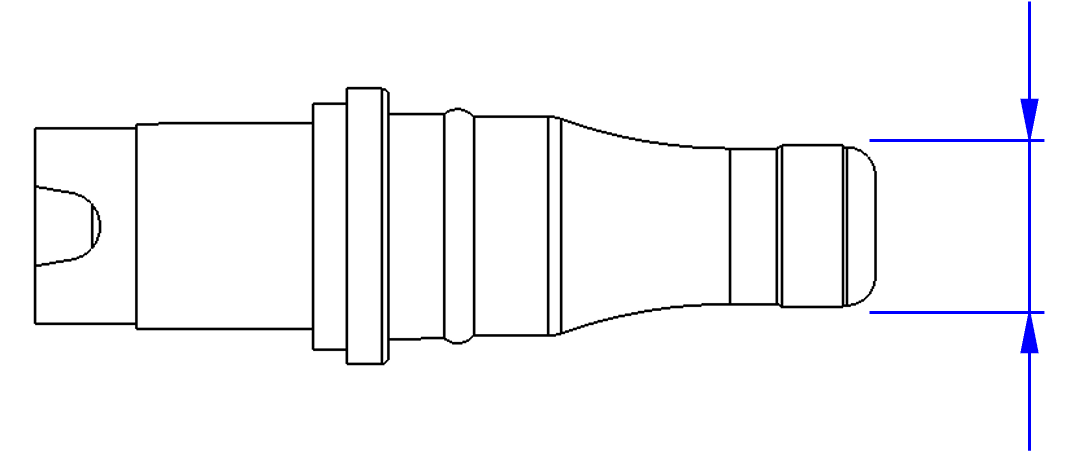
src/main/webapp/assets/images/pecas/150.png
