LcAvila/grade_moldes/src/main/webapp/assets/images/pecas/156.png

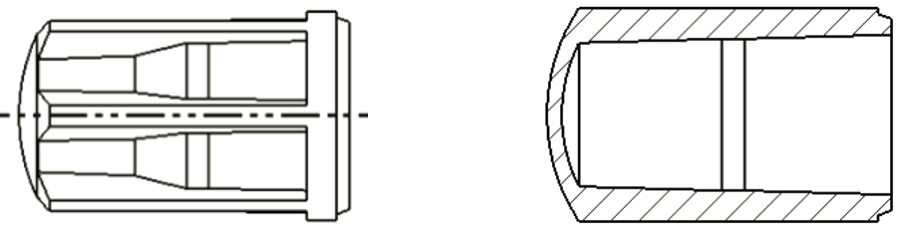
src/main/webapp/assets/images/pecas/156.png
