LcAvila/grade_moldes/src/main/webapp/assets/images/pecas/160.png

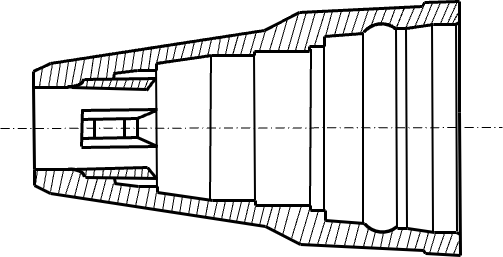
src/main/webapp/assets/images/pecas/160.png
