LcAvila/grade_moldes/src/main/webapp/assets/images/pecas/167.png

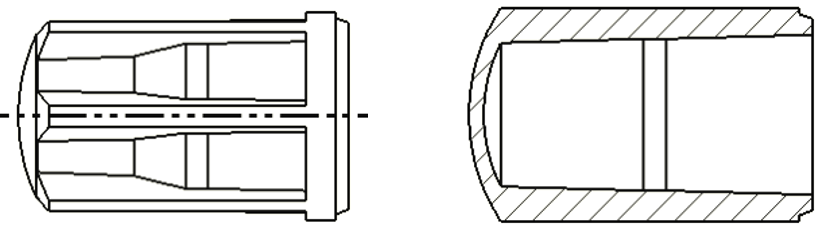
src/main/webapp/assets/images/pecas/167.png
