LcAvila/grade_moldes/src/main/webapp/assets/images/pecas/184.png

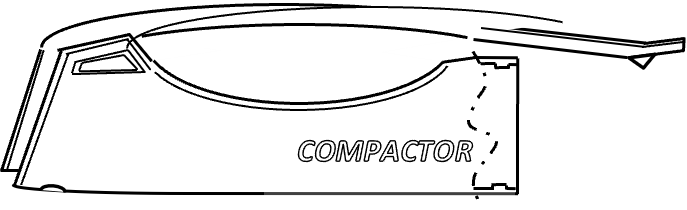
src/main/webapp/assets/images/pecas/184.png
