LcAvila/grade_moldes/src/main/webapp/assets/images/pecas/202.png

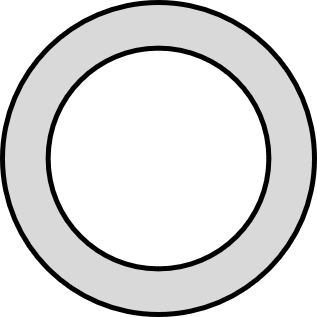
src/main/webapp/assets/images/pecas/202.png
