LcAvila/grade_moldes/src/main/webapp/assets/images/pecas/_substituidas/150.png

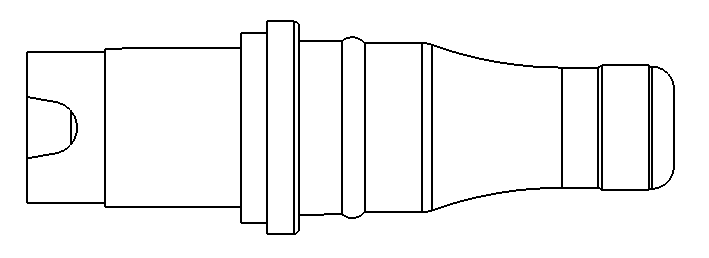
src/main/webapp/assets/images/pecas/_substituidas/150.png
