LcAvila/grade_moldes/src/main/webapp/assets/images/pecas/_substituidas/154.png

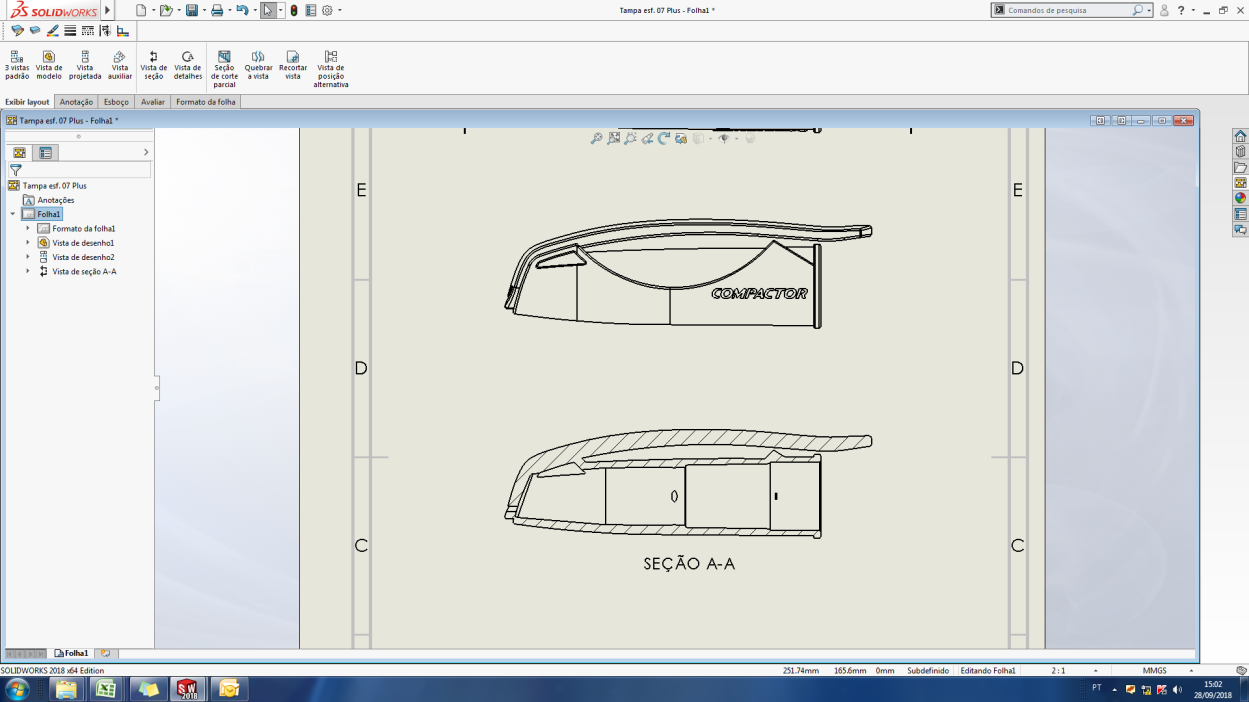
src/main/webapp/assets/images/pecas/_substituidas/154.png
