LcAvila/grade_moldes/src/main/webapp/assets/images/pecas/_substituidas/157.png

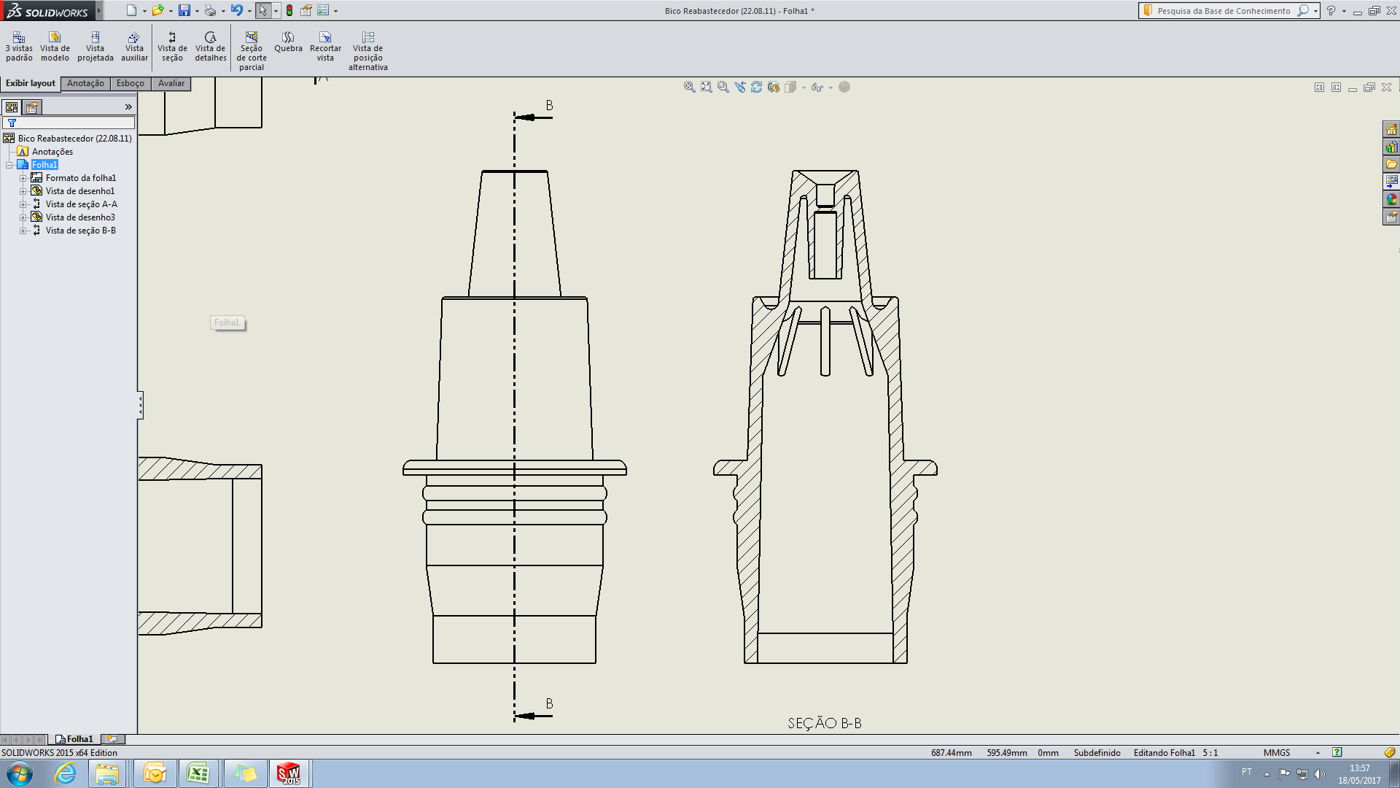
src/main/webapp/assets/images/pecas/_substituidas/157.png
