LcAvila/grade_moldes/src/main/webapp/assets/images/pecas/_substituidas/189.png

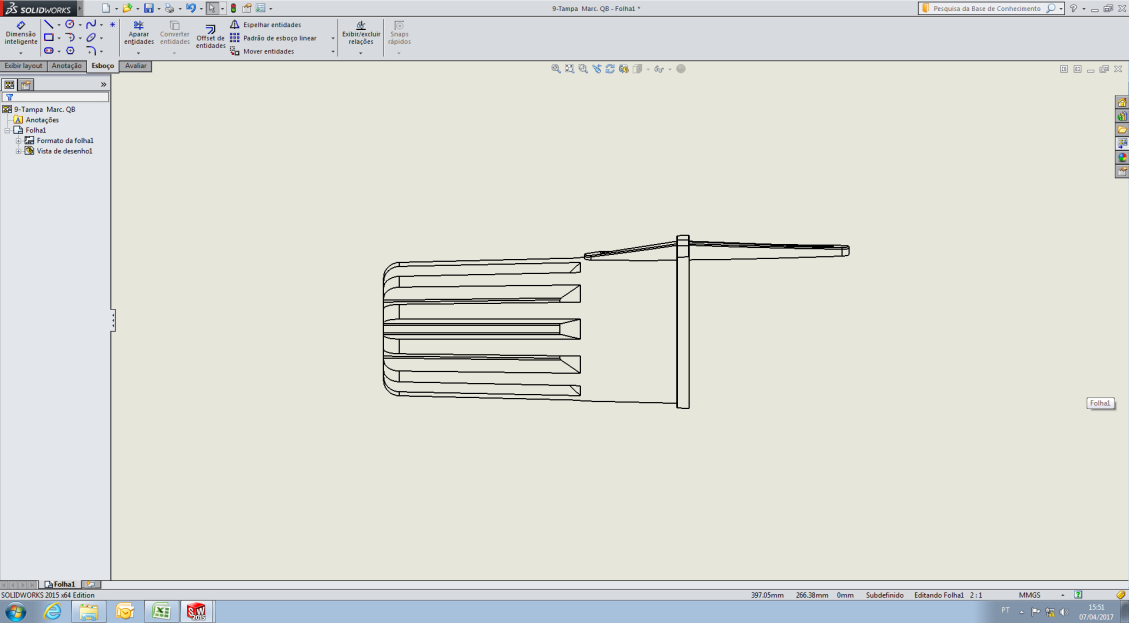
src/main/webapp/assets/images/pecas/_substituidas/189.png
