LcAvila/grade_moldes/src/main/webapp/assets/documentos/RQ 7.5.1-XX - Check-list de validação de entradas de molde (1).xlsx

Sheet: JANEIRO 2026
 |  | CHECK-LIST DE VALIDAÇÃO DE ENTRADAS DE MOLDE |  |  |  |  |  |  |  |  |  |  |  | RQ 7.5.1-XX
 |  |  |  |  |  |  |  |  |  |  |  |  |  | Data: 14/03/2025
 |  |  |  |  |  |  |  |  |  |  |  |  |  | Rev.: 00
Nº DO MOLDE | QUANTIDADE TOTAL DE CAVIDADES NO MOLDE | QUANTIDADE DE CAVIDADES ATIVAS | MATÉRIA PRIMA | DATA DE ENTRADA | SITUAÇÃO DA ENTRADA DO MOLDE | PONTOS VERIFICÁVEIS |  |  |  |  |  | CONTROLADOR | STATUS | OBSERVAÇÕES
 |  |  |  |  |  | REBARBAS | MANCHAS | FUROS ANTIASFIXIANTES DESOBSTRUÍDOS | OUTROS ASPECTOS VISUAIS | DIMENSIONAL | ESTANQUEIDADE
116A | 16 | 14 | PP | 2026-01-10 | RETORNO PARA PRODUÇÃO | C | C | NA | C | C | NA | VAGNER | APROVADO
197 | 64 | 64 | PS | 2026-01-12 | RETORNO PARA PRODUÇÃO | C | C | NA | C | NA | NA | YURI | APROVADO
165 | 64 | 64 | PS | 2026-01-12 | RETORNO PARA PRODUÇÃO | C | C | NA | C | NA | NA | ROGER | APROVADO
181 | 64 | 64 | PP | 2026-01-13 | RETORNO PARA PRODUÇÃO | C | C | NA | C | NA | NA | HEITOR | APROVADO
207 | 1 | 1 | PS | 2026-01-13 | RETORNO PARA PRODUÇÃO | C | C | NA | C | NA | NA | MÁRCIO | APROVADO
110 | 48 | 41 | PP | 2026-01-14 | RETORNO PARA PRODUÇÃO | C | C | NA | C | NA | C | JONAS | APROVADO
122 | 48 | 45 | PP | 2026-01-14 | RETORNO PARA PRODUÇÃO | C | C | NA | C | NA | C | MARLON | APROVADO | CAVIDADES 18, 19 E 30 ENTUPIDAS
121 | 64 | 64 | PP | 2026-01-15 | RETORNO PARA PRODUÇÃO | C | C | NA | C | NA | NA | ROGER | APROVADO | CAVIDADES 29 E 60 VEDADAS. REBARBA NO Ø MAIOR
107 | 64 | 64 | PP | 2026-01-17 | RETORNO PARA PRODUÇÃO | C | C | C | C | NA | NA | VAGNER | APROVADO
169 | 64 | 63 | PP | 2026-01-20 | RETORNO PARA PRODUÇÃO | C | C | C | C | NA | C | ROGER | APROVADO
191 | 16 | 14 | PP | 2026-01-20 | RETORNO PARA PRODUÇÃO | C | C | NA | C | C | NA | ROGER | APROVADO | CAVIDADES 1 E 2 VEDADAS. CAVIDA 8 COM REBARBA NA PASSAGEM DE AR
110 | 48 | 42 | PP | 2026-01-20 | RETORNO PARA PRODUÇÃO | C | C | C | C | NA | C | YURI | APROVADO
109 | 48 | 48 | PP | 2026-01-21 | RETORNO PARA PRODUÇÃO | C | C | NA | C | C | NA | MARLON | APROVADO
164 | 16 | 16 | PP | 2026-01-23 | RETORNO PARA PRODUÇÃO | C | C | NA | C | C | NA | ROGER | APROVADO
192 | 64 | 64 | PS | 2026-01-23 | RETORNO PARA PRODUÇÃO | C | C | NA | C | NA | NA | MARLON | APROVADO
145A | 16 | 15 | PP | 2026-01-26 | RETORNO PARA PRODUÇÃO | C | C | NA | C | NA | NA | HEITOR | APROVADO | CAV. 8 VEDADA DEVIDO A REBARBA NO DIAMETRO MAIOR
117 | 64 | 42 | PP | 2026-01-24 | RETORNO PARA PRODUÇÃO | NC | C | NC | C | NA | NA | MARLON | APROVADO | CAV. 15, 20, 21, 22, 40 E 52 V.P.F / ZONA 4 E 8 DESLIGADAS (REB. NA PASSAGEM DE AR).
197 | 64 | 64 | PS | 2026-01-26 | RETORNO PARA PRODUÇÃO | C | C | NA | C | NA | NA | MARLON | APROVADO | TROCA DO PINO DO FORMATO CAV. 31
116A | 16 | 14 | PP | 2026-01-27 | RETORNO PARA PRODUÇÃO | C | C | NA | C | C | NA | VAGNER | APROVADO
185 | 24 | 24 | PP | 2026-01-27 | RETORNO PARA PRODUÇÃO | C | NC | NA | C | C | NA | JONAS | APROVADO
183 | 24 | 24 | pp | 2026-01-29 | RETORNO PARA PRODUÇÃO | C | C | NA | C | C | NA | HEITOR | APROVADO
122 | 48 | 47 | PP | 2026-01-30 | RETORNO PARA PRODUÇÃO | C | C | C | C | NA | C | MARLON | APROVADO | CAV. 19 V.P.F.
101 | 64 | 62 | PP | 2026-01-29 | RETORNO PARA PRODUÇÃO | C | C | NA | C | C | NA | JONAS | APROVADO

Sheet: FEVEIRO 2026
 |  | CHECK-LIST DE VALIDAÇÃO DE ENTRADAS DE MOLDE |  |  |  |  |  |  |  |  |  |  |  | RQ 7.5.1-XX
 |  |  |  |  |  |  |  |  |  |  |  |  |  | Data: 14/03/2025
 |  |  |  |  |  |  |  |  |  |  |  |  |  | Rev.: 00
Nº DO MOLDE | QUANTIDADE TOTAL DE CAVIDADES NO MOLDE | QUANTIDADE DE CAVIDADES ATIVAS | MATÉRIA PRIMA | DATA DE ENTRADA | SITUAÇÃO DA ENTRADA DO MOLDE | PONTOS VERIFICÁVEIS |  |  |  |  |  | CONTROLADOR | STATUS | OBSERVAÇÕES
 |  |  |  |  |  | REBARBAS | MANCHAS | FUROS ANTIASFIXIANTES DESOBSTRUÍDOS | OUTROS ASPECTOS VISUAIS | DIMENSIONAL | ESTANQUEIDADE
109 | 48 | 48 | PP | 2026-02-05 | RETORNO PARA PRODUÇÃO | C | C | NA | C | C | NA | YURI | APROVADO
189 | 16 | 14 | PP | 2026-02-05 | RETORNO PARA PRODUÇÃO | C | C | NA | C | C | C | HEITOR | APROVADO | CAV 1 VEDADA POR FALTA DE PEÇA PARA REPOSIÇÃO.
194 | 64 | 64 | PP | 2026-02-05 | RETORNO PARA PRODUÇÃO | C | C | NA | C | NA | NA | HEITOR | APROVADO | DESOBSTRUÇÃO DAS CAVIDADES. TROCA DA BUCHA DO FORMATO DA CAV. 31
184 | 24 | 24 | ABS | 2026-02-05 | RETORNO PARA PRODUÇÃO | C | C | NA | C | NA | NA | JONAS | APROVADO
122 | 48 | 47 | PP | 2026-02-06 | TROCA DE MAQUINA | C | C | C | C | NA | C | MARLON | APROVADO | MOLDE TRANSFERIDO PARA ENGEL 7
163 | 16 | 16 | PP | 2026-02-06 | RETORNO PARA PRODUÇÃO | C | C | NA | C | C | NA | MARLON | APROVADO
191 | 16 | 15 | PP | 2026-02-07 | RETORNO PARA PRODUÇÃO | NC | C | NA | C | C | NA | JONAS | APROVADO | CAV 02 VEDADA REB. NO FURO
145B | 16 | 10 | PP | 2026-02-11 | RETORNO PARA PRODUÇÃO | NC | C | NA | C | C | C | YURI | APROVADO | CAV 6 VEDADA PINO DE FORMATO DANIFICADO E NÃO HÁ PEÇAS PARA SUBSTITUIÇÃO E CAV 15 VEDADA REB. NA ARESTA DO COPINHO
116A | 16 | 14 | PP | 2026-02-24 | RETORNO PARA PRODUÇÃO | C | C | NA | C | C | NA | VAGNER | APROVADO
162 | 16 | 16 | PP | 2026-02-25 | RETORNO PARA PRODUÇÃO | C | C | NA | C | C | C | VAGNER | APROVADO
145C | 16 | 15 | PP | 2026-02-03 | RETORNO PARA PRODUÇÃO | C | C | NA | C | C | NA | VAGNER | APROVADO
107 | 64 | 64 | PP | 2026-02-10 | RETORNO PARA PRODUÇÃO | C | C | C | C | NA | NA | VAGNER | APROVADO
110 | 48 | 46 | PP | 2026-02-26 | RETORNO PARA PRODUÇÃO | C | C | NA | C | NA | C | RENAN | APROVADO
116A | 16 | 14 | PP | 2026-02-26 | RETORNO PÓS-AJUSTE | C | C | NA | C | C | NA | VAGNER | APROVADO | TROCA DO PINO DO FORMATO CAVIDADE 07 .
145E | 16 | 15 | PP | 2026-02-26 | RETORNO PARA PRODUÇÃO | C | C | NA | C | NA | NA | HEITOR | APROVADO | TROCA DE TODAS AS PONTEIRAS, DE TODAS AS RESISTENCIAS DOS BICOS E DE DUAS RESISTENCIAS MANIFOLD

Sheet: MARÇO 2026
 |  | CHECK-LIST DE VALIDAÇÃO DE ENTRADAS DE MOLDE |  |  |  |  |  |  |  |  |  |  |  | RQ 7.5.1-XX
 |  |  |  |  |  |  |  |  |  |  |  |  |  | Data: 14/03/2025
 |  |  |  |  |  |  |  |  |  |  |  |  |  | Rev.: 00
Nº DO MOLDE | QUANTIDADE TOTAL DE CAVIDADES NO MOLDE | QUANTIDADE DE CAVIDADES ATIVAS | MATÉRIA PRIMA | DATA DE ENTRADA | SITUAÇÃO DA ENTRADA DO MOLDE | PONTOS VERIFICÁVEIS |  |  |  |  |  | CONTROLADOR | STATUS | OBSERVAÇÕES
 |  |  |  |  |  | REBARBAS | MANCHAS | FUROS ANTIASFIXIANTES DESOBSTRUÍDOS | OUTROS ASPECTOS VISUAIS | DIMENSIONAL | ESTANQUEIDADE
145D | 16 | 10 | PP | 2026-03-03 | RETORNO PARA PRODUÇÃO | C | C | NA | C | NA | NA | MATHEUS | APROVADO | MOLDE TRABALHANDO COM 6 CAVIDADES A MENOS (BUCHAS QUEBRADAS).
194 | 64 | 64 | PP | 2026-03-03 | RETORNO PARA PRODUÇÃO | C | C | NA | C | NA | NA | HEITOR | APROVADO | LIMPEZA E LUBRIFICAÇÃO GERAL.
140 | 64 | 64 | PP | 2026-03-03 | RETORNO PARA PRODUÇÃO | C | C | NA | C | NA | NA | MATHEUS | APROVADO | FEITA A TROCA DA BUCHA, GUIA E PINO DO FORMATO.
107 | 64 | 63 | PP | 2026-03-04 | RETORNO PARA PRODUÇÃO | C | C | C | C | NA | NA | JONAS | APROVADO | CAV 50 VEDADA POR FALTA DE REPOSIÇÃO.
157 | 16 | 16 | PP | 2026-03-04 | RETORNO PARA PRODUÇÃO | C | C | NA | C | C | C | MATHEUS | APROVADO | FEITA A TROCA DO PINO FORMATO DA CAVIDADE 5.
163 | 16 | 14 | PP | 2026-03-06 | TROCA DE MAQUINA | C | C | NA | C | C | NA | YURI | APROVADO | MOLDE SAIU DA ENGEL 05 PARA ENGEL 06
122 | 48 | 44 | PP | 2026-03-06 | RETORNO PARA PRODUÇÃO | C | C | C | NC | NA | C | YURI | APROVADO | CAV 02 COM REPUXADO INTERNO
110 | 48 | 42 | PP | 2026-03-05 | RETORNO PARA PRODUÇÃO | C | C | C | C | NA | C | ROGER | APROVADO | TROCA DO BICO QUENTE ZONA 4
96 | 96 | 96 | PP | 2026-03-06 | RETORNO PARA PRODUÇÃO | C | C | NA | C | NA | NA | ROGER | APROVADO | DESOBISTRUÍDAS AS CAVIDADES 11,2,37,43,50,22,55 E 34
199 | 64 | 62 | PP | 2026-03-05 | RETORNO PÓS-AJUSTE | C | C | NA | C | C | NA | MATHEUS | APROVADO | FEITO A TROCA DO CONTRA PINO QUBERADO DA CAVIDADE 33.
189 | 16 | 14 | PP | 2026-03-12 | RETORNO PARA PRODUÇÃO | C | C | NA | C | NA | C | MATHEUS | APROVADO | CAV: 1 VEDADA (CONTRAPINO QUEBRADO).
110 | 48 | 46 | PP | 2026-03-12 | RETORNO PARA PRODUÇÃO | NC | C | C | C | NA | C | YURI | APROVADO | CAV 06 E 35 VEDADA REB NO Ø MAIOR. FOI COLOCADO PINOS EXTRATORES CENTRAIS NA PLACA DO GALHO E RESOLVIDO O PROBLEMA DE VAZAMENTO NA CAV 47.
117 | 48 | 48 | PP | 2026-03-13 | RETORNO PARA PRODUÇÃO | C | C | C | C | C | NA | JONAS | APROVADO
201 | 96 | 96 | PP | 2026-03-13 | RETORNO PARA PRODUÇÃO | C | C | NA | C | NA | NA | YURI | APROVADO
146 | 64 | 64 | PP | 2026-03-14 | RETORNO PÓS-AJUSTE | C | C | NA | C | C | NA | MATHEUS | APROVADO | FEITO A LIMPEZA E LUBRIFICAÇÃO DO MOLDE.
148 | 64 | 64 | PP | 2026-03-17 | RETORNO PARA PRODUÇÃO | C | C | NA | C | C | NA | JONAS | APROVADO
145A | 16 | 15 | PP | 2026-03-17 | RETORNO PARA PRODUÇÃO | C | C | NA | C | NA | C | MATHEUS | APROVADO | CAVIDADE 8 VEDADA POR FALTA DE PEÇA DE REPOSIÇÃO.
151 | 16 | 16 | PP | 2026-03-18 | RETORNO PARA PRODUÇÃO | C | C | NA | C | C | NA | MATHEUS | APROVADO
145A | 16 | 12 | PP | 2026-03-19 | RETORNO PÓS-AJUSTE | C | C | NA | NC | NA | NA | YURI | APROVADO | CAV 05,06,07 E 08 VEDADA, PINO DE VEDAÇÃO FURANDO. FOI REALIZADO AJUSTE NAS PONTEIRAS DAS CAV 03,06,07 E 11 PARA RESOLVER O PROBLEMA DE PEÇAS FURANDO.
151 | 16 | 16 | PP | 2026-03-19 | RETORNO PÓS-AJUSTE | C | C | NA | C | C | NA | VAGNER | APROVADO | TROCA DO PINO DO FORMATO CAVIDADE 04, 07, 10 e 13
110 | 48 | 45 | PP | 2026-03-20 | RETORNO PÓS-AJUSTE | C | C | C | C | NA | C | JONAS | APROVADO | MODIFICAÇÃO FEITA NO PINO PUXADOR CENTRAL DO GALHO
159 | 16 | 16 | ABS | 2026-03-24 | RETORNO PARA PRODUÇÃO | C | C | NA | C | NA | NA | MATHEUS | APROVADO
207 | 1 | 1 | PS | 2026-03-25 | RETORNO PARA PRODUÇÃO | C | C | NA | C | NA | NA | MATHEUS | APROVADO
164 | 16 | 16 | PP | 2026-03-26 | RETORNO PARA PRODUÇÃO | C | C | NA | C | C | NA | VAGNER | APROVADO
192 | 48 | 48 | PS | 2026-03-26 | RETORNO PÓS-AJUSTE | C | C | NA | C | NA | NA | ROGER | APROVADO | TROCA DO TERMOPAN DA ZONA 10. TROCA DA BUCHA DO FORMATO DA CAVIDADE 03
184 | 24 | 24 | ABS | 2026-03-26 | RETORNO PARA PRODUÇÃO | C | C | NA | C | NA | NA | ROGER | APROVADO
159 | 16 | 16 | ABS | 2026-03-27 | RETORNO PÓS-AJUSTE | C | C | NA | C | NA | NA | VAGNER | APROVADO
117 | 64 | 53 | PP | 2026-03-31 | RETORNO PARA PRODUÇÃO | C | C | NA | C | NA | NA | ROGER | APROVADO | ZONA 4 DESLIGADA APÓS IDENTIFICAR CAVIDADES COM REBARBAS NA PASSAGEM DE AR

Sheet: ABRIL 2026
 |  | CHECK-LIST DE VALIDAÇÃO DE ENTRADAS DE MOLDE |  |  |  |  |  |  |  |  |  |  |  | RQ 7.5.1-XX
 |  |  |  |  |  |  |  |  |  |  |  |  |  | Data: 14/03/2025
 |  |  |  |  |  |  |  |  |  |  |  |  |  | Rev.: 00
Nº DO MOLDE | QUANTIDADE TOTAL DE CAVIDADES NO MOLDE | QUANTIDADE DE CAVIDADES ATIVAS | MATÉRIA PRIMA | DATA DE ENTRADA | SITUAÇÃO DA ENTRADA DO MOLDE | PONTOS VERIFICÁVEIS |  |  |  |  |  | CONTROLADOR | STATUS | OBSERVAÇÕES
 |  |  |  |  |  | REBARBAS | MANCHAS | FUROS ANTIASFIXIANTES DESOBSTRUÍDOS | OUTROS ASPECTOS VISUAIS | DIMENSIONAL | ESTANQUEIDADE
194 | 64 | 64 | PP | 2026-04-01 | RETORNO PARA PRODUÇÃO | C | C | NA | C | NA | NA | JONAS | APROVADO
145 C | 16 | 16 | PP | 2026-04-01 | RETORNO PARA PRODUÇÃO | C | C | NA | C | C | NA | BRENDA | APROVADO
191 | 16 | 16 | PP | 2026-04-02 | RETORNO PARA PRODUÇÃO | C | C | NA | C | C | NA | MATHEUS | APROVADO
199 | 64 | 63 | PP | 2026-04-07 | RETORNO PARA PRODUÇÃO | C | C | NA | C | C | NA | MÁRCIO | APROVADO
162 | 16 | 16 | PP | 2026-04-08 | RETORNO PARA PRODUÇÃO | C | C | NA | C | NA | C | YURI | APROVADO
107 | 64 | 64 | PP | 2026-04-08 | RETORNO PARA PRODUÇÃO | C | C | C | C | NA | NA | BRENDA | APROVADO
188 | 16 | 16 | PP | 2026-04-08 | RETORNO PARA PRODUÇÃO | C | C | NA | C | C | NA | MATHEUS | APROVADO | FEITO A TROCA DO INSERTO DO PINO DO FORMATO.
169 | 64 | 59 | PP | 2026-04-10 | RETORNO PARA PRODUÇÃO | C | C | C | C | NA | C | BRENDA | APROVADO
194 | 64 | 64 | PP | 2026-04-13 | RETORNO PÓS-AJUSTE | C | C | NA | C | C | NA | MÁRCIO | APROVADO
183 | 24 | 24 | PS | 2026-04-23 | RETORNO PARA PRODUÇÃO | C | C | NA | C | NA | NA | VAGNER | APROVADO
121 | 64 | 64 | PP | 2026-04-24 | RETORNO PARA PRODUÇÃO | C | C | NA | C | C | NA | BRENDA | APROVADO | FORAM TROCADAS 2 BUCHAS GUIA DO FORMATO CAV 29 E 60 E UMA BUCHA DO FORMATO CAV 60
139 | 64 | 56 | PP | 2026-04-24 | RETORNO PARA PRODUÇÃO | C | C | C | C | NA | NA | VAGNER | APROVADO | CAVIDADE 56 CLIPS FORA DA POSIÇÃO . ZONA 07 VEDADA.
107 | 64 | 64 | PP | 2026-04-27 | RETORNO PARA PRODUÇÃO | C | C | C | C | NA | NA | VAGNER | APROVADO
139 | 64 | 64 | PP | 2026-04-28 | RETORNO PÓS-AJUSTE | C | C | NA | C | NA | NA | YURI | APROVADO | CAVIDADE 56 FOI COLOCADO O CLIPS NA POSIÇÃO.
197 | 64 | 62 | PS | 2026-04-30 | RETORNO PARA PRODUÇÃO | C | C | NA | C | NA | NA | YURI | APROVADO | LIMPEZA E LUBRIFICAÇÃO GERAL

Sheet: MAIO 2026
 |  | CHECK-LIST DE VALIDAÇÃO DE ENTRADAS DE MOLDE |  |  |  |  |  |  |  |  |  |  |  | RQ 7.5.1-XX
 |  |  |  |  |  |  |  |  |  |  |  |  |  | Data: 14/03/2025
 |  |  |  |  |  |  |  |  |  |  |  |  |  | Rev.: 00
Nº DO MOLDE | QUANTIDADE TOTAL DE CAVIDADES NO MOLDE | QUANTIDADE DE CAVIDADES ATIVAS | MATÉRIA PRIMA | DATA DE ENTRADA | SITUAÇÃO DA ENTRADA DO MOLDE | PONTOS VERIFICÁVEIS |  |  |  |  |  | CONTROLADOR | STATUS | OBSERVAÇÕES
 |  |  |  |  |  | REBARBAS | MANCHAS | FUROS ANTIASFIXIANTES DESOBSTRUÍDOS | OUTROS ASPECTOS VISUAIS | DIMENSIONAL | ESTANQUEIDADE
116A | 16 | 14 | PP | 2026-05-04 | RETORNO PARA PRODUÇÃO | NC | C | NA | C | C | NA | YURI | APROVADO | CAV 12 VEDADA (REB. ÁREA DE ENCAIXE DA TAMPA) DESOBSTRUÇÃO DAS CAVIDADES 01,12,13
181 | 64 | 64 | PP | 2026-05-04 | RETORNO PARA PRODUÇÃO | C | C | C | C | NA | NA | BRENDA | APROVADO | FORAM SUBSTITUÍDOS TODOS OS BICOS QUENTES POR NOVOS MODELOS.
193 | 32 | 31 | PP | 2026-05-04 | RETORNO PARA PRODUÇÃO | C | C | C | C | NA | C | BRENDA | APROVADO
201 | 96 | 96 | PP | 2026-05-04 | RETORNO PARA PRODUÇÃO | C | C | NA | C | NA | NA | YURI | APROVADO
194 | 64 | 64 | PP | 2026-05-04 | RETORNO PARA PRODUÇÃO | C | C | NA | C | C | NA | VAGNER | APROVADO
189 | 16 | 15 | PP | 2026-05-04 | RETORNO PARA PRODUÇÃO | C | C | NA | C | NA | C | MATHEUS | APROVADO
107 | 64 | 64 | PP | 2026-05-05 | RETORNO PARA PRODUÇÃO | C | C | C | C | NA | NA | VAGNER | APROVADO
148 | 64 | 64 | PP | 2026-05-06 | RETORNO PARA PRODUÇÃO | C | C | NA | C | NA | NA | YURI | APROVADO | FOI FEITA MODIFICAÇÃO NO CANAL DOS GALHOS
192 | 64 | 64 | PS | 2026-05-08 | RETORNO PARA PRODUÇÃO | C | C | NA | C | NA | NA | YURI | APROVADO
151 | 16 | 16 | PP | 2026-05-09 | RETORNO PARA PRODUÇÃO | C | C | NA | C | C | NA | MATHEUS | APROVADO
117 | 64 | 55 | pp | 2026-05-09 | RETORNO PARA PRODUÇÃO | C | C | C | C | NA | NA | YURI | APROVADO | CAVIDADES 29, 30 E 61 FORAM TRANSFERIDAS PARA AS POSIÇÕES 21, 22 E 62 RESPECTIVAMENTO. CAVIDADE 55 VEDADA.
162 | 16 | 16 | PP | 2026-05-08 | RETORNO PARA PRODUÇÃO | C | C | NA | C | NA | C | VAGNER | APROVADO
190 | 64 | 32 | PS | 2026-05-07 | RETORNO PARA PRODUÇÃO | C | C | NA | C | NA | NA | VAGNER | APROVADO
117 | 64 | 48 | PP | 2026-05-11 | RETORNO PARA PRODUÇÃO | C | C | C | C | NA | NA | VAGNER | APROVADO | CAVIDADES 01, 03, 08, 19, 22 e 43 VEDADAS.
190 | 64 | 32 | PS | 2026-05-12 | RETORNO PARA PRODUÇÃO | C | C | NA | C | NA | NA | BRENDA | APROVADO | TROCA DOS PINOS DO FORMATO DAS CAVIDADES: 12, 20, 22 e 56. MOTIVO: ARRANHÃO INTERNO.
188 | 16 | 16 | PP | 2026-05-13 | RETORNO PARA PRODUÇÃO | C | C | NA | C | C | NA | BRENDA | APROVADO | TROCA DO - DOS PINOS SO FORMATO CAVIDADE: 03,04,10,13 E 14.
169 | 64 | 61 | PP | 2026-05-12 | RETORNO PÓS-AJUSTE | C | C | C | C | NA | C | MÁRCIO | APROVADO | TROCA DAS BUCHAS E GUUIAS NOS PIVOS DO FORMATO
150 | 16 | 15 | PP | 2026-05-14 | RETORNO PARA PRODUÇÃO | C | C | NA | C | C | NA | MÁRCIO | APROVADO | CAV. 05 VEDADA (FALTA DE PEÇA PARA REPOSIÇÃO)
162 | 16 | 16 | PP | 2026-05-15 | RETORNO PÓS-AJUSTE | C | C | NA | C | NA | C | MATHEUS | APROVADO | FOI REALIZADA A TROCA DO PINO DO FORMATO NA CAV: 7.
181 | 64 | 61 | pp | 2026-05-14 | RETORNO PÓS-AJUSTE | C | C | C | C | NA | NA | MÁRCIO | APROVADO
150 | 16 | 15 | PP | 2026-05-15 | RETORNO PÓS-AJUSTE | C | C | NA | C | C | NA | VAGNER | APROVADO
11A | 16 | 15 | PP | 2026-05-18 | RETORNO PARA PRODUÇÃO | C | C | NA | C | C | NA | MÁRCIO | APROVADO | CAV. 13 - V.P.F
145D | 16 | 14 | PP | 2026-05-19 | RETORNO PARA PRODUÇÃO | C | C | NA | C | NA | NA | JONAS | APROVADO
150 | 16 | 14 | PP | 2026-05-25 | RETORNO PÓS-AJUSTE | C | C | NA | C | C | NA | VAGNER | APROVADO | CAV .13 VEDADA
11A | 16 | 15 | PP | 2026-05-27 | RETORNO PÓS-AJUSTE | C | C | NA | C | C | NA | YURI | APROVADO | TROCA DO INSERTO DA CAV 03
194 | 64 | 64 | PP | 2026-05-27 | RETORNO PÓS-AJUSTE | C | C | NA | C | C | NA | VAGNER | APROVADO
150 | 16 | 14 | pp | 2026-05-28 | RETORNO PÓS-AJUSTE | c | c | NA | C | C | NA | BRENDA | APROVADO | DESOBSTRUÇÃO CAVIDADE 14.
150 | 16 | 14 | PP | 2026-05-29 | RETORNO PÓS-AJUSTE | C | C | NA | C | C | NA | YURI | APROVADO | DESOBSTRUÇÃO CAVIDADE 08.
122 | 48 | 48 | PP | 2026-05-29 | RETORNO PARA PRODUÇÃO | C | C | C | C | NA | C | BRENDA | APROVADO

Sheet: JUNHO 2026
 |  | CHECK-LIST DE VALIDAÇÃO DE ENTRADAS DE MOLDE |  |  |  |  |  |  |  |  |  |  |  | RQ 7.5.1-XX
 |  |  |  |  |  |  |  |  |  |  |  |  |  | Data: 14/03/2025
 |  |  |  |  |  |  |  |  |  |  |  |  |  | Rev.: 00
Nº DO MOLDE | QUANTIDADE TOTAL DE CAVIDADES NO MOLDE | QUANTIDADE DE CAVIDADES ATIVAS | MATÉRIA PRIMA | DATA DE ENTRADA | SITUAÇÃO DA ENTRADA DO MOLDE | PONTOS VERIFICÁVEIS |  |  |  |  |  | CONTROLADOR | STATUS | OBSERVAÇÕES
 |  |  |  |  |  | REBARBAS | MANCHAS | FUROS ANTIASFIXIANTES DESOBSTRUÍDOS | OUTROS ASPECTOS VISUAIS | DIMENSIONAL | ESTANQUEIDADE
145C | 16 | 15 | PP | 2026-06-01 | RETORNO PARA PRODUÇÃO | C | C | NA | C | NA | NA | BRENDA | APROVADO | MANUTENÇÃO PREVENTIVA.
146 | 64 | 63 | PP | 2026-06-01 | RETORNO PARA PRODUÇÃO | NC | C | NA | C | C | NA | BRENDA | APROVADO | REB. NO Ø MAIOR. VEDADA CAV. 36-13 E 15
163 | 16 | 16 | PP | 2026-06-02 | RETORNO PARA PRODUÇÃO | C | C | NA | C | C | NA | BRENDA | APROVADO | COMPLETAMOS O MOLDE COM TODAS AS NOVAS BUCHAS DO FORMATO BASEADO NA UTLIMA EXPERIÊNCIA.
185 | 24 | 24 | PP | 2026-06-02 | RETORNO PARA PRODUÇÃO | C | C | NA | C | C | NA | YURI | APROVADO
199 | 64 | 63 | PP | 2026-06-02 | RETORNO PARA PRODUÇÃO | C | C | NA | C | C | NA | BRENDA | APROVADO | DESCONTAMINAÇÃO DO CANAL QUENTE.
109 | 48 | 48 | PP | 2026-06-03 | RETORNO PARA PRODUÇÃO | C | C | NA | C | C | NA | VAGNER | APROVADO | PEÇAS NUMERADAS
169 | 64 | 64 | PP | 2026-06-08 | RETORNO PÓS-AJUSTE | C | C | NA | C | C | C | MÁRCIO | APROVADO
163 | 16 | 16 | PP | 2026-06-08 | RETORNO PÓS-AJUSTE | C | C | NA | C | C | NA | MÁRCIO | APROVADO
163 | 16 | 14 | PP | 2026-06-09 | RETORNO PÓS-AJUSTE | C | C | NA | C | C | NA | VAGNER | APROVADO
162 | 16 | 16 | PP | 2026-06-11 | RETORNO PARA PRODUÇÃO | C | C | NA | C | NA | C | YURI | APROVADO | LIMPEZA E LUBRIFICAÇÃO.
163 | 16 | 16 | PP | 2026-06-11 | RETORNO PÓS-AJUSTE | C | C | NA | C | C | NA | VAGNER | APROVADO
145B | 16 | 15 | PP | 2026-06-12 | RETORNO PÓS-AJUSTE | C | C | NA | C | NA | C | BRENDA | APROVADO | CAVIDADE 6 VEDADA.
158 | 16 | 13 | PP | 2026-06-16 | RETORNO PARA PRODUÇÃO | C | C | NA | C | NA | NA | VAGNER | APROVADO
183 | 24 | 24 | PS | 2026-06-17 | RETORNO PARA PRODUÇÃO | C | C | NA | C | NA | NA | MÁRCIO | APROVADO
194 | 64 | 64 | PP | 2026-06-17 | RETORNO PARA PRODUÇÃO | C | C | NA | C | C | NA | MATHEUS | APROVADO
145C | 16 | 16 | PP | 2026-06-18 | RETORNO PARA PRODUÇÃO | C | C | NA | C | C | NA | VAGNER | APROVADO
145E | 16 | 15 | PP | 2026-06-19 | RETORNO PARA PRODUÇÃO | C | C | NA | C | NA | NA | YURI | APROVADO
190 | 64 | 64 | PS | 2026-06-19 | RETORNO PARA PRODUÇÃO | C | C | NA | NC | NA | NA | MÁRCIO | REPROVADO | O MOLDE APRESENTOU ARRANHADO EXTERNO NA REGIÃO DA TAMPINHA EM 52 CAVIDADES. MOLDE RETORNOU PARA FERRAMENTARIA.
110 | 48 | 48 | PP | 2026-06-22 | RETORNO PARA PRODUÇÃO | C | C | C | C | NA | C | JONAS | APROVADO
139 | 64 | 60 | PP | 2026-06-23 | RETORNO PARA PRODUÇÃO | C | C | C | C | NA | NA | BRENDA | APROVADO | TROCA DO PINO DO FORMATO. CAV. 15
190 | 64 | 64 | PP | 2026-06-23 | RETORNO PARA PRODUÇÃO | C | C | NA | C | NA | NA | VAGNER | APROVADO
148 | 64 | 64 | PP | 2026-06-24 | RETORNO PARA PRODUÇÃO | C | C | NA | C | NA | NA | MATHEUS | APROVADO
157 | 16 | 16 | PP | 2026-06-24 | RETORNO PARA PRODUÇÃO | C | C | NA | C | C | C | YURI | APROVADO
183 | 24 | 24 | PS | 2026-06-24 | RETORNO PARA PRODUÇÃO | C | NC | NA | C | NA | NA | MÁRCIO | APROVADO | CORPO TRANSLUCIDO SAINDO COM PINTAS PRETAS DURANDE INJEÇÃO, FOI SOLICITADO A TROCA PARA CORPO OPACO.
172 | 8 | 4 | PP | 2026-06-25 | RETORNO PARA PRODUÇÃO | C | C | NA | C | NA | NA | YURI | APROVADO | LIMPEZA E LUBRIFICAÇÃO.
193 | 32 | 32 | pp | 2026-06-25 | RETORNO PARA PRODUÇÃO | C | C | C | C | NA | C | MATHEUS | APROVADO
200 | 96 | 96 | PP | 2026-06-26 | RETORNO PÓS-AJUSTE | C | C | NA | C | NA | NA | MÁRCIO | APROVADO
169 | 64 | 64 | PP | 2026-06-26 | RETORNO PÓS-AJUSTE | C | C | C | C | NA | C | VAGNER | APROVADO
110 | 48 | 48 | PP | 2026-06-29 | RETORNO PÓS-AJUSTE | C | C | C | NC | NA | C | JONAS | APROVADO | CAVIDADE 23 DESENTUPIDA. CAV 13, 38 E 45 VEDADA FALHANDO
185 | 24 | 24 | POM | 2026-06-30 | TROCA DE MAQUINA | C | C | NA | C | C | NA | MÁRCIO | APROVADO
190 | 64 | 64 | PP | 2026-06-30 | RETORNO PÓS-AJUSTE | C | C | NA | C | NA | NA | VAGNER | APROVADO

Sheet: JULHO 2026
 |  | CHECK-LIST DE VALIDAÇÃO DE ENTRADAS DE MOLDE |  |  |  |  |  |  |  |  |  |  |  | RQ 7.5.1-XX
 |  |  |  |  |  |  |  |  |  |  |  |  |  | Data: 14/03/2025
 |  |  |  |  |  |  |  |  |  |  |  |  |  | Rev.: 00
Nº DO MOLDE | QUANTIDADE TOTAL DE CAVIDADES NO MOLDE | QUANTIDADE DE CAVIDADES ATIVAS | MATÉRIA PRIMA | DATA DE ENTRADA | SITUAÇÃO DA ENTRADA DO MOLDE | PONTOS VERIFICÁVEIS |  |  |  |  |  | CONTROLADOR | STATUS | OBSERVAÇÕES
 |  |  |  |  |  | REBARBAS | MANCHAS | FUROS ANTIASFIXIANTES DESOBSTRUÍDOS | OUTROS ASPECTOS VISUAIS | DIMENSIONAL | ESTANQUEIDADE
145D | 16 | 16 | PP | 2026-07-01 | RETORNO PARA PRODUÇÃO | C | C | NA | C | NA | NA | SILAS | APROVADO
181 | 64 | 64 | PP | 2026-07-01 | RETORNO PARA PRODUÇÃO | C | C | NA | C | NA | NA | SILAS | APROVADO
11A | 16 | 15 | PEBD 80% PEAD 20% | 2026-07-01 | RETORNO PARA PRODUÇÃO | C | C | NA | C | NA | NA | SILAS | APROVADO
189 | 16 | 15 | PP | 2026-07-01 | RETORNO PARA PRODUÇÃO | C | C | NA | C | C | C | VAGNER | APROVADO
116A | 16 | 14 | PP | 2026-07-02 | RETORNO PÓS-AJUSTE | C | C | NA | C | C | NA | YURI | APROVADO | TROCA DO PINO EXTRATOR DO GALHO E LIMPEZA DA CAV 13
185 | 24 | 24 | PP | 2026-07-06 | RETORNO PÓS-AJUSTE | C | C | NA | C | C | NA | SILAS | APROVADO
197 | 64 | 64 | PS | 2026-07-07 | RETORNO PÓS-AJUSTE | C | C | NA | C | NA | NA | BRENDA | APROVADO | LIMPEZA E LUBRIFICAÇÃO GERAL. FOI TROCADA BUCHA NA CAVIDADE 50 MOTIVO ESTAVA ARRANHANDO PRODUTO.
116A | 16 | 14 | PP | 2026-07-08 | RETORNO PARA PRODUÇÃO | C | C | NA | C | C | NA | YURI | APROVADO | TROCA DO PINO EXTRATOR DO GALHO
183 | 24 | 24 | PS | 2026-07-15 | RETORNO PARA PRODUÇÃO | NC | C | NA | NC | NA | NA | YURI | APROVADO | CAV 24 COM CONTRAÇÃO E REBARBA
203 | 2 | 2 | PP | 2026-07-15 | RETORNO PARA PRODUÇÃO | C | C | NA | C | C | NA | JONAS | APROVADO | CAV 01 E 04 VEDADA POR FALTA DE PEÇÃS PARA REPOSIÇÃO.
164 | 16 | 16 | PP | 2026-07-16 | RETORNO PARA PRODUÇÃO | C | C | NA | C | C | NA | VAGNER | APROVADO
184 | 24 | 24 | ABS | 2026-07-18 | RETORNO PARA PRODUÇÃO | C | C | C | C | NA | NA | BRENDA | APROVADO
184 | 24 | 24 | ABS | 2026-07-20 | RETORNO PARA PRODUÇÃO | C | C | C | C | NA | NA | SILAS | APROVADO
183 | 24 | 24 | PS | 2026-07-22 | RETORNO PÓS-AJUSTE | C | C | NA | C | NA | NA | SILAS | APROVADO
110 | 48 | 48 | PP | 2026-07-21 | RETORNO PÓS-AJUSTE | C | C | C | NC | C | NC | MARCIO | REPROVADO | COPINHO FALHADO
169 | 64 | 48 | PP | 2026-07-22 | RETORNO PÓS-AJUSTE | C | C | C | C | NA | C | BRENDA | APROVADO | FOI TROCADO OS SENSORES DO BICO 7 E 8.
110 | 48 | 48 | PP | 2026-07-23 | RETORNO PÓS-AJUSTE | C | C | C | C | NA | C | MÁRCIO | APROVADO
183 | 24 | 24 | PS | 2026-07-23 | RETORNO PÓS-AJUSTE | C | C | NA | C | NA | NA | MÁRCIO | APROVADO
163 | 16 | 16 | PP | 2026-07-28 | RETORNO PARA PRODUÇÃO | C | C | NA | C | C | NA | MÁRCIO | APROVADO
191 | 16 | 16 | PP | 2026-07-30 | RETORNO PARA PRODUÇÃO | C | C | NA | C | C | NA | SILAS | APROVADO

Sheet: AGOSTO 2026
 |  | CHECK-LIST DE VALIDAÇÃO DE ENTRADAS DE MOLDE |  |  |  |  |  |  |  |  |  |  |  | RQ 7.5.1-XX
 |  |  |  |  |  |  |  |  |  |  |  |  |  | Data: 14/03/2025
 |  |  |  |  |  |  |  |  |  |  |  |  |  | Rev.: 00
Nº DO MOLDE | QUANTIDADE TOTAL DE CAVIDADES NO MOLDE | QUANTIDADE DE CAVIDADES ATIVAS | MATÉRIA PRIMA | DATA DE ENTRADA | SITUAÇÃO DA ENTRADA DO MOLDE | PONTOS VERIFICÁVEIS |  |  |  |  |  | CONTROLADOR | STATUS | OBSERVAÇÕES
 |  |  |  |  |  | REBARBAS | MANCHAS | FUROS ANTIASFIXIANTES DESOBSTRUÍDOS | OUTROS ASPECTOS VISUAIS | DIMENSIONAL | ESTANQUEIDADE
107 | 64 | 64 | PP | 2026-08-01 | RETORNO PARA PRODUÇÃO | C | C | C | C | NA | NA | JONAS | APROVADO | OS PROBLEMAS DA GRADE DO MOLDE, IDENTIFICADOS NO MOLDE, FORAM RESOLVIDOS.
139 | 64 | 59 | PP | 2026-08-04 | RETORNO PARA PRODUÇÃO | C | C | C | C | NA | NA | MÁRCIO | APROVADO | CAV's 23, 25, 31, 34 e 63 V.P.F
165 | 64 | 64 | PS | 2026-08-04 | RETORNO PÓS-AJUSTE | C | C | NA | C | NA | NA | ROGER | APROVADO | TROCA DA BUCHA DE GUIA DA COLUNA DA PLACA 7.
200 | 96 | 96 | PP | 2026-08-05 | RETORNO PÓS-AJUSTE | C | C | NA | C | NA | NA | MÁRCIO | APROVADO | FOI DADO FOLGA NOS CONTRA-PINOS 14, 32, 53, 55, 56, 58, 59, 63, 64, 69, 82 E 96. FOI VEDADA AS CAVIDADES 58 E 59 DEVIDO A BOLHAS NO INTERIOR DA CONEXÃO.
203 | 4 | 1 | POLIACETAL | 2026-08-06 | RETORNO PÓS-AJUSTE | C | C | NA | C | C | NA | MÁRCIO | APROVADO | TROCA DO PINO DO FORMATO E CONTRABUCHA CAV. 03
146 | 64 | 64 | PP | 2026-08-06 | RETORNO PARA PRODUÇÃO | C | C | NA | C | C | C | ROGER | APROVADO
207 | NA | NA | PP | 2026-08-10 | RETORNO PARA PRODUÇÃO | C | C | NA | C | NA | NA | HEITOR | APROVADO | COR ESTAVA UM POUCO DIVERGENTE DO PADRÃO. FOI RESOLVIDO O PROBLEMA.
110 | 48 | 48 | PP | 2026-08-11 | RETORNO PARA PRODUÇÃO | C | C | C | C | NA | C | VAGNER | APROVADO
207 | 1 | 1 | PP | 2026-08-11 | RETORNO PARA PRODUÇÃO | C | C | NA | C | NA | NA | VAGNER | APROVADO
201 | 96 | 96 | pp | 2026-08-12 | RETORNO PARA PRODUÇÃO | C | C | NA | C | NA | NA | JONAS | APROVADO | LIMPEZA E LUBRIFICAÇÃO
169 | 64 | 64 | PP | 2026-08-11 | RETORNO PARA PRODUÇÃO | C | C | NA | C | NA | C | BRENDA | APROVADO | DESCONTAMINAÇÃO DO CANAL QUENTE
200 | 96 | 96 | PP | 2026-08-14 | RETORNO PÓS-AJUSTE | C | C | NA | NC | NA | NA | YURI | APROVADO | FURADA NA BASE (CAV 63) BOLHA NÃO ATRAVESSOU
199 | 64 | 64 | PP | 2026-08-14 | RETORNO PARA PRODUÇÃO | C | C | NA | C | C | NA | VAGNER | APROVADO
145d | 16 | 13 | PP | 2026-08-17 | RETORNO PARA PRODUÇÃO | C | C | NA | C | NA | NA | VAGNER | APROVADO
162 | 16 | 16 | PP | 2026-08-18 | RETORNO PÓS-AJUSTE | C | C | NA | C | NA | C | VAGNER | APROVADO | TROCA DE PINO CAVIDADE 16
162 | 16 | 16 | PP | 2026-08-19 | RETORNO PÓS-AJUSTE | C | C | NA | C | NA | C | VAGNER | APROVADO
98 | 64 | 64 | PP | 2026-08-20 | RETORNO PARA PRODUÇÃO | C | C | NA | C | NA | NA | VAGNER | APROVADO
193 | 32 | 32 | PP | 2026-08-20 | RETORNO PARA PRODUÇÃO | C | C | C | C | NA | C | VAGNER | APROVADO
162 | 16 | 16 | PP | 2026-08-25 | RETORNO PÓS-AJUSTE | C | C | NA | C | NA | C | VAGNER | APROVADO | TROCA DE PINO CAVIDADE 05 e 06 .
185 | 24 | 24 | PP | 2026-08-25 | RETORNO PARA PRODUÇÃO | C | C | NA | C | C | NA | VAGNER | APROVADO
179 | 4 | 4 |  | 2026-08-27 | RETORNO PARA PRODUÇÃO | C | C | NA | C | NA | NA | VAGNER | APROVADO
204 | 4 | 4 | POLIACETAL | 2026-08-29 | RETORNO PARA PRODUÇÃO | C | C | NA | C | C | NA | VAGNER | APROVADO

Sheet: SETEMBRO 2026
 |  | CHECK-LIST DE VALIDAÇÃO DE ENTRADAS DE MOLDE |  |  |  |  |  |  |  |  |  |  |  | RQ 7.5.1-XX
 |  |  |  |  |  |  |  |  |  |  |  |  |  | Data: 14/03/2025
 |  |  |  |  |  |  |  |  |  |  |  |  |  | Rev.: 00
Nº DO MOLDE | QUANTIDADE TOTAL DE CAVIDADES NO MOLDE | QUANTIDADE DE CAVIDADES ATIVAS | MATÉRIA PRIMA | DATA DE ENTRADA | SITUAÇÃO DA ENTRADA DO MOLDE | PONTOS VERIFICÁVEIS |  |  |  |  |  | CONTROLADOR | STATUS | OBSERVAÇÕES
 |  |  |  |  |  | REBARBAS | MANCHAS | FUROS ANTIASFIXIANTES DESOBSTRUÍDOS | OUTROS ASPECTOS VISUAIS | DIMENSIONAL | ESTANQUEIDADE
192 | 64 | 64 | PP | 2026-09-01 | TROCA DE MAQUINA | C | C | NA | C | NA | NA | VAGNER | APROVADO
169 | 64 | 60 | PP | 2026-09-01 | TROCA DE MAQUINA | C | C | C | C | NA | C | MÁRCIO | APROVADO
11A | 16 | 15 | PEAD 20% + PEBD 80% | 2026-09-02 | RETORNO PARA PRODUÇÃO | C | C | NA | C | C | NA | MÁRCIO | APROVADO
139 | 64 | 59 | PP | 2026-09-04 | RETORNO PARA PRODUÇÃO | C | C | C | C | NA | NA | MÁRCIO | APROVADO
164 | 16 | 16 | PP | 2026-09-04 |  | C | C | NA | C | C | NA | BRENDA | APROVADO
190 | 64 | 63 | PS | 2026-09-08 | RETORNO PARA PRODUÇÃO | C | C | NA | C | NA | NA | VAGNER | APROVADO
145C | 16 | 16 | PP | 2026-09-08 | RETORNO PARA PRODUÇÃO | C | C | NA | C | C | NA | BRENDA | APROVADO
162 | 24 | 24 | PP | 2026-09-09 | RETORNO PÓS-AJUSTE | C | C | NA | C | NA | C | MÁRCIO | APROVADO
199 | 64 | 58 | PP | 2026-09-09 | RETORNO PÓS-AJUSTE | C | C | NA | C | C | NA | MÁRCIO | APROVADO
168 | 64 | 61 | PP | 2026-09-10 | RETORNO PARA PRODUÇÃO | C | C | NA | C | NA | NA | BRENDA | APROVADO
116A | 16 | 14 | PP | 2026-09-11 | RETORNO PÓS-AJUSTE | C | C | NA | C | C | NA | VAGNER | APROVADO
184 | 24 | 24 | ABS | 11//09/2026 | RETORNO PARA PRODUÇÃO | C | C | NA | C | NA | NA | BRENDA | APROVADO | TROCA DE 01 BUCHA DE GUIA DO PINO DO FORMATO.
162 | 24 | 24 | PP | 11//09/2026 | RETORNO PÓS-AJUSTE | C | C | NA | C | NA | C | MÁRCIO | APROVADO
11A | 16 | 15 | PEAD 20% + PEBD 80% | 2026-09-14 | RETORNO PÓS-AJUSTE | C | C | NA | C | C | NA | JONAS | APROVADO | TROCA DO INSERTO DO PINO DO FORMATO NA CAV 9.
157 | 16 | 16 | PP | 2026-09-21 | RETORNO PARA PRODUÇÃO | C | C | NA | C | C | C | YURI | APROVADO | INJETAR 24H E RETIRAR PARA ANÁLISE.
148 | 64 | 64 | PP | 2026-09-22 | RETORNO PARA PRODUÇÃO | C | C | NA | C | NA | NA | BRENDA | APROVADO | LIMPEZA E LUBRIFICAÇÃO GERAL
191 | 16 | 16 | PP | 2026-09-24 | RETORNO PARA PRODUÇÃO | C | C | NA | C | C | NA | JEFFERSON | APROVADO

Sheet: OUTUBRO 2026
 |  | CHECK-LIST DE VALIDAÇÃO DE ENTRADAS DE MOLDE |  |  |  |  |  |  |  |  |  |  |  | RQ 7.5.1-XX
 |  |  |  |  |  |  |  |  |  |  |  |  |  | Data: 14/03/2025
 |  |  |  |  |  |  |  |  |  |  |  |  |  | Rev.: 00
Nº DO MOLDE | QUANTIDADE TOTAL DE CAVIDADES NO MOLDE | QUANTIDADE DE CAVIDADES ATIVAS | MATÉRIA PRIMA | DATA DE ENTRADA | SITUAÇÃO DA ENTRADA DO MOLDE | PONTOS VERIFICÁVEIS |  |  |  |  |  | CONTROLADOR | STATUS | OBSERVAÇÕES
 |  |  |  |  |  | REBARBAS | MANCHAS | FUROS ANTIASFIXIANTES DESOBSTRUÍDOS | OUTROS ASPECTOS VISUAIS | DIMENSIONAL | ESTANQUEIDADE
116A | 16 | 14 | PP | 2026-10-01 | RETORNO PARA PRODUÇÃO | C | C | NA | C | C | NA | BRENDA | APROVADO
145B | 16 | 13 | PP | 2026-10-01 | RETORNO PARA PRODUÇÃO | C | C | NA | C | C | C | MÁRCIO | APROVADO | CAVIDADES 1, 5 E 10 ENTUPIDAS
181 | 64 | 64 | PP | 2026-10-09 | RETORNO PARA PRODUÇÃO | C | C | C | C | NA | NA | BRENDA | APROVADO
190 | 64 | 64 | PP | 2026-10-09 | RETORNO PARA PRODUÇÃO | C | C | NA | C | NA | NA | BRENDA | APROVADO
116A | 16 | 16 | PP | 2026-10-15 | RETORNO PÓS-AJUSTE | C | C | NA | C | C | NA | MÁRCIO | APROVADO
181 | 64 | 64 | PP | 2026-10-15 | RETORNO PÓS-AJUSTE | C | C | C | C | NA | NA | MÁRCIO | APROVADO
145C | 16 | 16 | PEBD | 2026-10-16 | RETORNO PÓS-AJUSTE | C | C | NA | C | C | NA | JEFFERSON | APROVADO
165 | 65 | 65 | PS | 2026-10-20 | RETORNO PÓS-AJUSTE | C | C | NA | C | NA | NA | MÁRCIO | APROVADO
194 | 64 | 64 | PP | 2026-10-20 | RETORNO PARA PRODUÇÃO | C | C | NA | C | NA | NA | YURI | APROVADO | LIMPEZA E LUBRIFICAÇÃO GERAL.
188 | 16 | 16 | PEAD 20% + PEBD 80% | 2026-10-21 | RETORNO PARA PRODUÇÃO | C | C | NA | C | C | NA | FERNANDO | APROVADO | FOI EFETUADA A TROCA DA PLACA 11
189 | 16 | 15 | PP | 2026-10-21 | RETORNO PARA PRODUÇÃO | C | C | NA | C | C | C | MÁRCIO | APROVADO | CAVIDADE 1 V.P.F
116A | 16 | 16 | PP | 2026-10-22 | RETORNO PÓS-AJUSTE | C | C | C | C | C | NA | FERNANDO | APROVADO | LIMPEZA GERAL.
188 | 16 | 16 | PEAD 20% + PEBD 80% | 2026-10-23 | RETORNO PARA PRODUÇÃO | C | C | C | C | C | NA | FERNANDO | APROVADO | TROCA DE 01 ISERTO DO PINO DO FORMATO DA CAVIDADE 10
192 | 64 | 64 | PS | 2026-10-26 | RETORNO PÓS-AJUSTE | C | C | NA | C | NA | NA | MÁRCIO | APROVADO
116A | 16 | 16 | PP | 2026-10-27 | TROCA DE MAQUINA | C | C | NA | C | C | NA | MÁRCIO | APROVADO

Sheet: NOVEMBRO 2026
 |  | CHECK-LIST DE VALIDAÇÃO DE ENTRADAS DE MOLDE |  |  |  |  |  |  |  |  |  |  |  | RQ 7.5.1-XX
 |  |  |  |  |  |  |  |  |  |  |  |  |  | Data: 14/03/2025
 |  |  |  |  |  |  |  |  |  |  |  |  |  | Rev.: 00
Nº DO MOLDE | QUANTIDADE TOTAL DE CAVIDADES NO MOLDE | QUANTIDADE DE CAVIDADES ATIVAS | MATÉRIA PRIMA | DATA DE ENTRADA | SITUAÇÃO DA ENTRADA DO MOLDE | PONTOS VERIFICÁVEIS |  |  |  |  |  | CONTROLADOR | STATUS | OBSERVAÇÕES
 |  |  |  |  |  | REBARBAS | MANCHAS | FUROS ANTIASFIXIANTES DESOBSTRUÍDOS | OUTROS ASPECTOS VISUAIS | DIMENSIONAL | ESTANQUEIDADE

Sheet: DEZEMBRO 2026
 |  | CHECK-LIST DE VALIDAÇÃO DE ENTRADAS DE MOLDE |  |  |  |  |  |  |  |  |  |  |  | RQ 7.5.1-XX
 |  |  |  |  |  |  |  |  |  |  |  |  |  | Data: 14/03/2025
 |  |  |  |  |  |  |  |  |  |  |  |  |  | Rev.: 00
Nº DO MOLDE | QUANTIDADE TOTAL DE CAVIDADES NO MOLDE | QUANTIDADE DE CAVIDADES ATIVAS | MATÉRIA PRIMA | DATA DE ENTRADA | SITUAÇÃO DA ENTRADA DO MOLDE | PONTOS VERIFICÁVEIS |  |  |  |  |  | CONTROLADOR | STATUS | OBSERVAÇÕES
 |  |  |  |  |  | REBARBAS | MANCHAS | FUROS ANTIASFIXIANTES DESOBSTRUÍDOS | OUTROS ASPECTOS VISUAIS | DIMENSIONAL | ESTANQUEIDADE

Sheet: Plan2
 | RETORNO PARA PRODUÇÃO | C | LIBERADO
 | RETORNO PÓS-AJUSTE | NC | REPROVADO
 | MOLDE NOVO | NA
 | TROCA DE MAQUINA
ABS
PEAD
PEAD 20% + PEBD 80%
PEBD
POLIACETAL
POLICABORNATO
PP
PS
SANTOPRENE
TPE
