LcAvila/grade_moldes/src/main/webapp/assets/Produtos/00-00 - BASE DE DADOS/Embalagens/Caixas Master/Caixas.xlsx

Componente | Descrição | Un | consultar narrativa pelo EN0703 | Seq | Item | Descrição | Un | Quantidade | Perda | Prop | Qtde Liquida | Início | Término | L.Compon | SALDO ALM 26-09-2025
15003 | CX.MASTER 19L Nº12(412X246X195) | UN |  | 10 | 939 | MARCADOR COMPACTOR MAXX Q.B.(NOVO)-CX/12 | UN | 0.002083 | 0 | 100 | 0.002083 | 2003-08-01 | 401768 |  | 832
15003 | CX.MASTER 19L Nº12(412X246X195) |  |  | 10 | 950 | MARCADOR COMPACTOR MAXX LUX AV-CX/12 | UN | 0.025 | 0 | 100 | 0.025 | 2003-08-29 | 2958465 |  | 832
15003 | CX.MASTER 19L Nº12(412X246X195) |  |  | 10 | 1248 | ESFEROGRAFICA VIP TRANSPARENTE-DI/12 | UN | 0.125 | 0 | 100 | 0.125 | 2005-11-01 | 2958465 |  | 832
15003 | CX.MASTER 19L Nº12(412X246X195) |  |  | 10 | 1250 | ESFEROGRAFICA DYNAMIX-DI/12 | UN | 0.125 | 0 | 100 | 0.125 | 2005-09-01 | 2958465 |  | 832
15003 | CX.MASTER 19L Nº12(412X246X195) |  |  | 30 | 1536 | TRI PEN COMPACTOR - DI/12 | UN | 0.083333 | 0 | 100 | 0.083333 | 2007-11-28 | 2958465 |  | 832
15005 | CX.MASTER 19L Nº18(380X302X166) | UN |  | 10 | 71000 | HIDROGRAFICA NEO-PEN-GIGANTE C/6-PCT/5 | UN | 0.033333 | 0 | 100 | 0.033333 | 2018-11-30 | 767010 |  | 3468
15005 | CX.MASTER 19L Nº18(380X302X166) |  |  | 10 | 77000 | HIDROGRAFICA NEO-PEN-MIRIM C/12-PCT/5 | UN | 0.05 | 0 | 100 | 0.05 | 2018-11-15 | 767010 |  | 3468
15005 | CX.MASTER 19L Nº18(380X302X166) |  |  | 10 | 882001 | PINCEL MARCADOR AVULSO-CX/12 AZUL | UN | 0.04 | 0 | 100 | 0.04 | 2018-05-01 | 767010 |  | 3468
15005 | CX.MASTER 19L Nº18(380X302X166) |  |  | 10 | 882002 | PINCEL MARCADOR AVULSO-CX/12 VERMELHA | UN | 0.04 | 0 | 100 | 0.04 | 2015-05-01 | 767010 |  | 3468
15005 | CX.MASTER 19L Nº18(380X302X166) |  |  | 10 | 882003 | PINCEL MARCADOR AVULSO-CX/12 VERDE | UN | 0.04 | 0 | 100 | 0.04 | 2018-05-01 | 767010 |  | 3468
15005 | CX.MASTER 19L Nº18(380X302X166) |  |  | 10 | 882004 | PINCEL MARCADOR AVULSO-CX/12 PRETA | UN | 0.04 | 0 | 100 | 0.04 | 2018-05-01 | 767010 |  | 3468
15005 | CX.MASTER 19L Nº18(380X302X166) |  |  | 10 | 1600001 | MARCADOR COMPACTOR QB AVULSO-CX/12 AZUL | UN | 0.04 | 0 | 100 | 0.04 | 2015-07-28 | 2958465 |  | 3468
15005 | CX.MASTER 19L Nº18(380X302X166) |  |  | 10 | 1600002 | MARCADOR COMPACTOR QB AVULSO-CX/12 VERMELHA | UN | 0.04 | 0 | 100 | 0.04 | 2015-07-28 | 2958465 |  | 3468
15005 | CX.MASTER 19L Nº18(380X302X166) |  |  | 10 | 1600003 | MARCADOR COMPACTOR QB AVULSO-CX/12 VERDE | UN | 0.04 | 0 | 100 | 0.04 | 2015-07-28 | 2958465 |  | 3468
15005 | CX.MASTER 19L Nº18(380X302X166) |  |  | 10 | 1600004 | MARCADOR COMPACTOR QB AVULSO-CX/12 PRETA | UN | 0.04 | 0 | 100 | 0.04 | 2015-07-28 | 2958465 |  | 3468
15005 | CX.MASTER 19L Nº18(380X302X166) |  |  | 10 | 1600007 | MARCADOR COMPACTOR QB AVULSO-CX/12 LARANJA | UN | 0.04 | 0 | 100 | 0.04 | 2024-04-10 | 2958465 |  | 3468
15005 | CX.MASTER 19L Nº18(380X302X166) |  |  | 10 | 1600008 | MARCADOR COMPACTOR QB AVULSO-CX/12 VIOLETA | UN | 0.04 | 0 | 100 | 0.04 | 2024-04-10 | 2958465 |  | 3468
15005 | CX.MASTER 19L Nº18(380X302X166) |  |  | 10 | 1600014 | MARCADOR COMPACTOR QB AVULSO-CX/12 ROSA | UN | 0.04 | 0 | 100 | 0.04 | 2015-07-28 | 2958465 |  | 3468
15005 | CX.MASTER 19L Nº18(380X302X166) |  |  | 10 | 1600015 | MARCADOR COMPACTOR QB AVULSO-CX/12 TURQUESA | UN | 0.04 | 0 | 100 | 0.04 | 2024-04-10 | 2958465 |  | 3468
15005 | CX.MASTER 19L Nº18(380X302X166) |  |  | 10 | 166 | ESFEROGRAFICA LOOP-CT/12 | UN | 0.02 | 0 | 100 | 0.02 | 2001-04-01 | 767010 |  | 3468
15005 | CX.MASTER 19L Nº18(380X302X166) |  |  | 5 | 1845999 | ESFEROGRAFICA SLIDER RAVE XB DI/30-AZUL | UN | 1 | 0 | 100 | 1 | 2024-03-01 | 2958465 |  | 3468
15005 | CX.MASTER 19L Nº18(380X302X166) |  |  | 10 | 1923001 | ESFEROGRAFICA SLIDER RAVE XB DI/30 -ACRILICO AZUL | UN | 1 | 0 | 100 | 1 | 2024-11-01 | 2958465 |  | 3468
15005 | CX.MASTER 19L Nº18(380X302X166) |  |  | 10 | 1926001 | ESFEROGRAFICA 07 VIP RETRATIL CX/12 -AZUL | UN | 0.027778 | 0 | 100 | 0.027778 | 2019-10-27 | 2958465 |  | 3468
15005 | CX.MASTER 19L Nº18(380X302X166) |  |  | 10 | 1926004 | ESFEROGRAFICA 07 VIP RETRATIL CX/12 -PRETA | UN | 0.027778 | 0 | 100 | 0.027778 | 2019-10-27 | 2958465 |  | 3468
15005 | CX.MASTER 19L Nº18(380X302X166) |  |  | 10 | 2269000 | HIDROGRAFICA NEO-PEN-GIGANTE C/6 CORES PASTEIS-PCT/5 | UN | 0.033333 | 0 | 100 | 0.033333 | 2019-05-01 | 2958465 |  | 3468
15005 | CX.MASTER 19L Nº18(380X302X166) |  |  | 10 | 2467000 | ESFEROGRAFICA TAKE 4 AZUL ESCURO - CX/10 | UN | 0.02 | 0 | 100 | 0.02 | 2022-04-01 | 401766 |  | 3468
15005 | CX.MASTER 19L Nº18(380X302X166) |  |  | 10 | 2469000 | ESFEROGRAFICA TAKE 4 BRANCO - CX/10 | UN | 0.02 | 0 | 100 | 0.02 | 2022-04-01 | 401766 |  | 3468
15005 | CX.MASTER 19L Nº18(380X302X166) |  |  | 10 | 2571001 | ESFEROGRAFICA 07 VIP RETRATIL AZUL PASTEL CX/12 - AZUL | UN | 0.027778 | 0 | 100 | 0.027778 | 2021-04-01 | 401766 |  | 3468
15005 | CX.MASTER 19L Nº18(380X302X166) |  |  | 10 | 2573001 | ESFEROGRAFICA 07 VIP RETRATIL AMARELO PASTEL CX/12- AZUL | UN | 0.027778 | 0 | 100 | 0.027778 | 2021-04-01 | 401766 |  | 3468
15005 | CX.MASTER 19L Nº18(380X302X166) |  |  | 10 | 2575001 | ESFEROGRAFICA 07 VIP RETRATIL VERDE PASTEL CX/12- AZUL | UN | 0.027778 | 0 | 100 | 0.027778 | 2021-04-01 | 401766 |  | 3468
15005 | CX.MASTER 19L Nº18(380X302X166) |  |  | 10 | 2577001 | ESFEROGRAFICA 07 VIP RETRATIL ROSA PASTEL CX/12- AZUL | UN | 0.027778 | 0 | 100 | 0.027778 | 2021-04-01 | 401766 |  | 3468
15005 | CX.MASTER 19L Nº18(380X302X166) |  |  | 10 | 2579001 | ESFEROGRAFICA 07 VIP RETRATIL LILÁS PASTEL CX/12- AZUL | UN | 0.027778 | 0 | 100 | 0.027778 | 2021-04-01 | 401766 |  | 3468
15005 | CX.MASTER 19L Nº18(380X302X166) |  |  | 10 | 2770001 | ESFEROGRAFICA 07 VIP RETRATIL FINA CX/12 -AZUL | UN | 0.027778 | 0 | 100 | 0.027778 | 2022-05-25 | 2958465 |  | 3468
15005 | CX.MASTER 19L Nº18(380X302X166) |  |  | 10 | 2770004 | ESFEROGRAFICA 07 VIP RETRATIL FINA CX/12 -PRETA | UN | 0.027778 | 0 | 100 | 0.027778 | 2022-05-25 | 2958465 |  | 3468
15005 | CX.MASTER 19L Nº18(380X302X166) |  |  | 10 | 3176001 | ESFEROGRAFICA SLIDER RAVE COLOUR XB DI/30 - AZUL | UN | 1 | 0 | 100 | 1 | 2024-07-01 | 2958465 |  | 3468
15005 | CX.MASTER 19L Nº18(380X302X166) |  |  | 10 | 3229000 | ESFEROGRAFICA TAKE 4 PRETA - CX/10 | UN | 0.02 | 0 | 100 | 0.02 | 2024-08-13 | 401766 |  | 3468
15005 | CX.MASTER 19L Nº18(380X302X166) |  |  | 10 | 3231999 | ESFEROGRAFICA TAKE 4 DI/30 ACRILICO- SORTIDO | UN | 1 | 0 | 100 | 1 | 2024-11-01 | 2958465 |  | 3468
15005 | CX.MASTER 19L Nº18(380X302X166) |  |  | 10 | 3232999 | ESFEROGRAFICA VIZZ M GELCO DI/150 ACRILICO - SORTIDO | UN | 1 | 0 | 100 | 1 | 2024-11-01 | 2958465 |  | 3468
15005 | CX.MASTER 19L Nº18(380X302X166) |  |  | 10 | 3331000 | ESFEROGRAFICA TAKE 4 LILAS- CX/10 | UN | 0.02 | 0 | 100 | 0.02 | 2024-12-11 | 401766 |  | 3468
15005 | CX.MASTER 19L Nº18(380X302X166) |  |  | 10 | 489 | MARCADOR MAXX(Q.B)-CX/12 | UN | 0.033333 | 0 | 100 | 0.033333 | 2001-09-01 | 767010 |  | 3468
15005 | CX.MASTER 19L Nº18(380X302X166) |  |  | 10 | 593 | ESFEROGRAFICA ICY-CT/12 | UN | 0.02 | 0 | 100 | 0.02 | 2000-08-01 | 767010 |  | 3468
15005 | CX.MASTER 19L Nº18(380X302X166) |  |  | 10 | 853 | MARCADOR BRILLANT-DI/18 | UN | 0.041667 | 0 | 100 | 0.041667 | 2007-03-29 | 2958465 |  | 3468
15005 | CX.MASTER 19L Nº18(380X302X166) |  |  | 10 | 32163 | SAMPLECARD TECNICO CX/80 - PDV | UN | 1 | 0 | 100 | 1 | 2012-05-08 | 2958465 |  | 3468
15005 | CX.MASTER 19L Nº18(380X302X166) |  |  | 10 | 32164 | SAMPLECARD DESTAQ CX/80 - PDV | UN | 1 | 0 | 100 | 1 | 2012-05-08 | 2958465 |  | 3468
15005 | CX.MASTER 19L Nº18(380X302X166) |  |  | 10 | 32165 | SAMPLECARD 07 PLUS CX/80 - PDV | UN | 1 | 0 | 100 | 1 | 2012-05-08 | 2958465 |  | 3468
15005 | CX.MASTER 19L Nº18(380X302X166) |  |  | 10 | 32166 | SAMPLECARD 07 B 1.2MM CX/80 - PDV | UN | 1 | 0 | 100 | 1 | 2012-05-08 | 2958465 |  | 3468
15005 | CX.MASTER 19L Nº18(380X302X166) |  |  | 10 | 32167 | SAMPLECARD SLIDER CX/80 - PDV | UN | 1 | 0 | 100 | 1 | 2012-05-09 | 2958465 |  | 3468
15005 | CX.MASTER 19L Nº18(380X302X166) |  |  | 10 | 32171 | SAMPLECARD MINIMAXX CX/80 - PDV | UN | 0.0125 | 0 | 100 | 0.0125 | 2012-05-30 | 2958465 |  | 3468
15005 | CX.MASTER 19L Nº18(380X302X166) |  |  | 10 | B00166 | ESF. LOOP-CT/12 | UN | 0.02 | 0 | 100 | 0.02 | 2001-03-23 | 767010 |  | 3468
15005 | CX.MASTER 19L Nº18(380X302X166) |  |  | 10 | B002570027 | LAPISEIRA TECNICO PRETA 2,0mm-GRAVADA P/BRINDE | UN | 0.01 | 0 | 100 | 0.01 | 2023-07-17 | 401766 |  | 3468
15005 | CX.MASTER 19L Nº18(380X302X166) |  |  | 10 | R000073001 | HIDROGRAFICA NEO-PEN-GIGANTE AVULSO-DZ AZUL (CRR) | UN | 0.0125 | 0 | 100 | 0.0125 | 2018-02-08 | 401768 |  | 3468
15005 | CX.MASTER 19L Nº18(380X302X166) |  |  | 10 | R000073002 | HIDROGRAFICA NEO-PEN-GIGANTE AVULSO-DZ VERMELHA (CRR) | UN | 0.0125 | 0 | 100 | 0.0125 | 2018-02-08 | 401768 |  | 3468
15005 | CX.MASTER 19L Nº18(380X302X166) |  |  | 10 | R000073004 | HIDROGRAFICA NEO-PEN-GIGANTE AVULSO-DZ PRETA (CRR) | UN | 0.0125 | 0 | 100 | 0.0125 | 2018-02-08 | 401768 |  | 3468
15005 | CX.MASTER 19L Nº18(380X302X166) |  |  | 10 | R000095000 | COMPASSO JOLLY-CX/12 (CRR) | UN | 0.025 | 0 | 100 | 0.025 | 2018-02-08 | 401768 |  | 3468
15005 | CX.MASTER 19L Nº18(380X302X166) |  |  | 10 | R000882001 | PINCEL MARCADOR AVULSO-CX/12 AZUL (CRR) | UN | 0.02 | 0 | 100 | 0.02 | 2018-07-09 | 2958465 |  | 3468
15005 | CX.MASTER 19L Nº18(380X302X166) |  |  | 10 | R000882002 | PINCEL MARCADOR AVULSO-CX/12 VERMELHA (CRR) | UN | 0.02 | 0 | 100 | 0.02 | 2018-07-09 | 2958465 |  | 3468
15005 | CX.MASTER 19L Nº18(380X302X166) |  |  | 5 | R000882003 | PINCEL MARCADOR AVULSO-CX/12 VERDE (CRR) | UN | 0.04 | 0 | 100 | 0.04 | 2019-04-30 | 2958465 |  | 3468
15005 | CX.MASTER 19L Nº18(380X302X166) |  |  | 10 | R000882004 | PINCEL MARCADOR AVULSO-CX/12 PRETA (CRR) | UN | 0.02 | 0 | 100 | 0.02 | 2018-07-09 | 2958465 |  | 3468
15005 | CX.MASTER 19L Nº18(380X302X166) |  |  | 10 | R001552000 | HIDROGRAFICA COMPACTOR COLOR C/24-PCT/5 (CRR) | UN | 0.25 | 0 | 100 | 0.25 | 2018-02-08 | 401768 |  | 3468
15005 | CX.MASTER 19L Nº18(380X302X166) |  |  | 10 | R001600001 | MARCADOR COMPACTOR QB AVULSO-CX/12 AZUL (CRR) | UN | 0.02 | 0 | 100 | 0.02 | 2018-07-09 | 2958465 |  | 3468
15005 | CX.MASTER 19L Nº18(380X302X166) |  |  | 10 | R001600002 | MARCADOR COMPACTOR QB AVULSO-CX/12 VERMELHA (CRR) | UN | 0.02 | 0 | 100 | 0.02 | 2018-07-09 | 2958465 |  | 3468
15005 | CX.MASTER 19L Nº18(380X302X166) |  |  | 10 | R001600003 | MARCADOR COMPACTOR QB AVULSO-CX/12 VERDE (CRR) | UN | 0.02 | 0 | 100 | 0.02 | 2018-07-09 | 2958465 |  | 3468
15005 | CX.MASTER 19L Nº18(380X302X166) |  |  | 90 | R001600004 | MARCADOR COMPACTOR QB AVULSO-CX/12 PRETA (CRR) | UN | 0.02 | 0 | 100 | 0.02 | 2018-07-09 | 2958465 |  | 3468
15005 | CX.MASTER 19L Nº18(380X302X166) |  |  | 10 | R001600014 | MARCADOR COMPACTOR QB AVULSO-CX/12 ROSA (CRR) | UN | 0.02 | 0 | 100 | 0.02 | 2018-07-09 | 2958465 |  | 3468
15005 | CX.MASTER 19L Nº18(380X302X166) |  |  | 10 | R001926002 | ESFEROGRÁFICA 07 VIP RETRÁTIL CX/12 VERMELHA (CRR) | UN | 0.027778 | 0 | 100 | 0.027778 | 2025-04-01 | 401768 |  | 3468
15005 | CX.MASTER 19L Nº18(380X302X166) |  |  | 10 | R001926007 | ESFEROGRÁFICA 07 VIP RETRÁTIL CX/12 LARANJA (CRR) | UN | 0.027778 | 0 | 100 | 0.027778 | 2025-04-01 | 401768 |  | 3468
15005 | CX.MASTER 19L Nº18(380X302X166) |  |  | 10 | R001926014 | ESFEROGRÁFICA 07 VIP RETRÁTIL CX/12 ROSA (CRR) | UN | 0.027778 | 0 | 100 | 0.027778 | 2025-04-01 | 401768 |  | 3468
15005 | CX.MASTER 19L Nº18(380X302X166) |  |  | 10 | R002267000 | HIDROGRAFICA NEO-PEN-GIGANTE C/6 CORES PASTEIS (CRR) | UN | 0.006667 | 0 | 100 | 0.006667 | 2021-02-26 | 2958465 |  | 3468
15005 | CX.MASTER 19L Nº18(380X302X166) |  |  | 10 | R002269000 | HIDROGRAFICA NEO-PEN-GIGANTE C/6 CORES PASTEIS-PCT/5 (CRR) | UN | 0.033333 | 0 | 100 | 0.033333 | 2019-07-23 | 2958465 |  | 3468
15007 | CX.MASTER 44L Nº30(505X300X292) | UN |  | 10 | 74007 | HIDROGRAFICA NEO-PEN-GIGANTE AVULSO-LARANJA | UN | 1 | 0 | 100 | 1 | 2019-02-01 | 2958465 |  | 1173
15007 | CX.MASTER 44L Nº30(505X300X292) |  |  | 10 | 75000 | HIDROGRAFICA NEO-PEN-MIRIM C/24-PCT/5 | UN | 0.041667 | 0 | 100 | 0.041667 | 2021-12-01 | 401766 |  | 1173
15007 | CX.MASTER 44L Nº30(505X300X292) |  |  | 10 | 2542000 | MICROLINE ESTOJO (VAZIO) | UN | 0.02 | 0 | 100 | 0.02 | 2024-03-01 | 2958465 |  | 1173
15007 | CX.MASTER 44L Nº30(505X300X292) |  |  | 10 | 3090000 | HIDROGRAFICA NEO-PEN-MIRIM HARIBO C/24-PCT/5 | UN | 0.041667 | 0 | 100 | 0.041667 | 2024-06-21 | 401766 |  | 1173
15007 | CX.MASTER 44L Nº30(505X300X292) |  |  | 10 | 3102000 | ESTOJO MENTOS FRUIT - CX/5 | UN | 0.1 | 0 | 100 | 0.1 | 2024-11-22 | 2958465 |  | 1173
15007 | CX.MASTER 44L Nº30(505X300X292) |  |  | 10 | 3103000 | ESTOJO MENTOS MINT- CX/5 | UN | 0.1 | 0 | 100 | 0.1 | 2024-11-22 | 2958465 |  | 1173
15007 | CX.MASTER 44L Nº30(505X300X292) |  |  | 10 | 3320000 | ESTOJO FRUIT-TELLA MORANGO ESPIRAL - CX/5 | UN | 0.1 | 0 | 100 | 0.1 | 2024-11-22 | 2958465 |  | 1173
15007 | CX.MASTER 44L Nº30(505X300X292) |  |  | 10 | 3330000 | ESTOJO FRUIT-TELLA FRUIT- CX/5 | UN | 0.1 | 0 | 100 | 0.1 | 2024-11-22 | 2958465 |  | 1173
15007 | CX.MASTER 44L Nº30(505X300X292) |  |  | 10 | 493 | KIT C/4MAXX+APAGADOR E 4REFIS | UN | 0.01667 | 0 | 100 | 0.01667 | 1999-12-20 | 767010 |  | 1173
15007 | CX.MASTER 44L Nº30(505X300X292) |  |  | 10 | 882 | PINCEL MARCADOR AVULSO-CX/12 | UN | 0.02 | 0 | 100 | 0.02 | 2002-09-01 | 767010 |  | 1173
15007 | CX.MASTER 44L Nº30(505X300X292) |  |  | 10 | 1382 | ESFEROGRAFICA FACE-DI/24 | UN | 0.055556 | 0 | 100 | 0.055556 | 2006-05-02 | 2958465 |  | 1173
15007 | CX.MASTER 44L Nº30(505X300X292) |  |  | 10 | 35069 | CARTUCHO EMBALADO MIRIM C/24 (LICITAÇÃO) | UN | 0.008333 | 0 | 100 | 0.008333 | 2025-03-19 | 401766 |  | 1173
15007 | CX.MASTER 44L Nº30(505X300X292) |  |  | 10 | R000075000 | HIDROGRAFICA NEO-PEN-MIRIM C/24-PCT/5 (CRR) | UN | 0.041667 | 0 | 100 | 0.041667 | 2021-12-01 | 401766 |  | 1173
15007 | CX.MASTER 44L Nº30(505X300X292) |  |  | 10 | R000077000 | HIDROGRAFICA NEO-PEN-MIRIM C/12-PCT/5 (CRR) | UN | 0.020833 | 0 | 100 | 0.020833 | 2018-02-20 | 767010 |  | 1173
15123 | CX.MASTER 05L Nº08(215X110X237) | UN |  | 10 | 120 | ESFEROGRAFICA LOOP-BL/1 | UN | 0.025 | 0 | 100 | 0.025 | 2000-10-13 | 767010 |  | 539
15123 | CX.MASTER 05L Nº08(215X110X237) |  |  | 10 | 1971001 | ESFEROGRAFICA SENATOR PRATA-AZUL | UN | 0.038462 | 0 | 100 | 0.038462 | 2019-04-02 | 2958465 |  | 539
15123 | CX.MASTER 05L Nº08(215X110X237) |  |  | 10 | 1972001 | ESFEROGRAFICA SENATOR AZUL-AZUL | UN | 0.038462 | 0 | 100 | 0.038462 | 2019-04-02 | 2958465 |  | 539
15123 | CX.MASTER 05L Nº08(215X110X237) |  |  | 10 | 1973001 | ESFEROGRAFICA SENATOR VERMELHA-AZUL | UN | 0.038462 | 0 | 100 | 0.038462 | 2019-04-02 | 2958465 |  | 539
15123 | CX.MASTER 05L Nº08(215X110X237) |  |  | 10 | 2084001 | ESFEROGRAFICA SENATOR PRETA-AZUL | UN | 0.038462 | 0 | 100 | 0.038462 | 2019-04-02 | 2958465 |  | 539
15123 | CX.MASTER 05L Nº08(215X110X237) |  |  | 10 | 2147001 | ESFEROGRAFICA SENATOR ROSA-AZUL | UN | 0.038462 | 0 | 100 | 0.038462 | 2019-04-02 | 2958465 |  | 539
15123 | CX.MASTER 05L Nº08(215X110X237) |  |  | 10 | 2148001 | ESFEROGRAFICA SENATOR BRANCA-AZUL | UN | 0.038462 | 0 | 100 | 0.038462 | 2019-04-02 | 2958465 |  | 539
15123 | CX.MASTER 05L Nº08(215X110X237) |  |  | 10 | 2416001 | ESFEROGRAFICA EPSILON TOUCH PRETO/DOURADO-AZUL | UN | 0.038462 | 0 | 100 | 0.038462 | 2019-11-29 | 401658 |  | 539
15123 | CX.MASTER 05L Nº08(215X110X237) |  |  | 10 | 2417001 | ESFEROGRAFICA EPSILON TOUCH BRANCA/CINZA-AZUL | UN | 0.038462 | 0 | 100 | 0.038462 | 2019-11-29 | 401658 |  | 539
15123 | CX.MASTER 05L Nº08(215X110X237) |  |  | 10 | 2746999 | MICROLINE COMBO C/192 -SORTIDO | UN | 1 | 0 | 100 | 1 | 2021-11-23 | 2958465 |  | 539
15123 | CX.MASTER 05L Nº08(215X110X237) |  |  | 10 | 2952001 | ESFEROGRAFICA RIO PRETA-AZUL | UN | 0.038462 | 0 | 100 | 0.038462 | 2023-11-15 | 2958465 |  | 539
15123 | CX.MASTER 05L Nº08(215X110X237) |  |  | 10 | 2953001 | ESFEROGRAFICA RIO TOUCH PRETA-AZUL | UN | 0.038462 | 0 | 100 | 0.038462 | 2023-11-15 | 2958465 |  | 539
15123 | CX.MASTER 05L Nº08(215X110X237) |  |  | 10 | 2969001 | ESFEROGRAFICA RIO AMARELA-AZUL | UN | 0.038462 | 0 | 100 | 0.038462 | 2024-02-28 | 2958465 |  | 539
15123 | CX.MASTER 05L Nº08(215X110X237) |  |  | 10 | 2970001 | ESFEROGRAFICA RIO ROSE-AZUL | UN | 0.038462 | 0 | 100 | 0.038462 | 2024-02-28 | 2958465 |  | 539
15123 | CX.MASTER 05L Nº08(215X110X237) |  |  | 10 | 2971001 | ESFEROGRAFICA RIO AZUL-AZUL | UN | 0.038462 | 0 | 100 | 0.038462 | 2024-02-28 | 2958465 |  | 539
15123 | CX.MASTER 05L Nº08(215X110X237) |  |  | 10 | 2972001 | ESFEROGRAFICA RIO PINK-AZUL | UN | 0.038462 | 0 | 100 | 0.038462 | 2024-02-28 | 2958465 |  | 539
15123 | CX.MASTER 05L Nº08(215X110X237) |  |  | 10 | 2973001 | ESFEROGRAFICA RIO VERDE-AZUL | UN | 0.038462 | 0 | 100 | 0.038462 | 2024-02-28 | 2958465 |  | 539
15123 | CX.MASTER 05L Nº08(215X110X237) |  |  | 10 | 3104000 | ESFEROGRAFICA TAKE 4 NFL BRANCO | UN | 0.038462 | 0 | 100 | 0.038462 | 2025-01-01 | 2958465 |  | 539
15123 | CX.MASTER 05L Nº08(215X110X237) |  |  | 10 | 3106000 | ESFEROGRAFICA RECO NFL BRANCA 725M-AZUL | UN | 0.038462 | 0 | 100 | 0.038462 | 2025-01-01 | 2958465 |  | 539
15123 | CX.MASTER 05L Nº08(215X110X237) |  |  | 10 | 3106001 | ESFEROGRAFICA RECO NFL BRANCA 725M-AZUL | UN | 0.038462 | 0 | 100 | 0.038462 | 2025-01-01 | 2958465 |  | 539
15123 | CX.MASTER 05L Nº08(215X110X237) |  |  | 10 | 3108001 | ESFEROGRAFICA SENATOR NFL BRANCA-AZUL | UN | 0.038462 | 0 | 100 | 0.038462 | 2025-01-01 | 2958465 |  | 539
15123 | CX.MASTER 05L Nº08(215X110X237) |  |  | 70 | 3333000 | ESFEROGRAFICA TAKE 4 NFL PHILADELPHIA EAGLES BRANCO | UN | 0.038462 | 0 | 100 | 0.038462 | 2025-01-01 | 2958465 |  | 539
15123 | CX.MASTER 05L Nº08(215X110X237) |  |  | 70 | 3334000 | ESFEROGRAFICA TAKE 4 NFL GREEN BAY PACKERS BRANCO | UN | 0.038462 | 0 | 100 | 0.038462 | 2025-01-01 | 2958465 |  | 539
15123 | CX.MASTER 05L Nº08(215X110X237) |  |  | 50 | 3335001 | ESFEROGRAFICA RECO NFL PHILADELPHIA EAGLES BRANCA 725M | UN | 0.038462 | 0 | 100 | 0.038462 | 2025-01-16 | 2958465 |  | 539
15123 | CX.MASTER 05L Nº08(215X110X237) |  |  | 50 | 3336001 | ESFEROGRAFICA RECO NFL GREEN BAY PACKERS BRANCA 725M -AZUL | UN | 0.038462 | 0 | 100 | 0.038462 | 2025-01-16 | 2958465 |  | 539
15123 | CX.MASTER 05L Nº08(215X110X237) |  |  | 10 | 3337001 | ESFEROGRAFICA SENATOR NFL PHILADELPHIA EAGLES BRANCA-AZUL | UN | 0.038462 | 0 | 100 | 0.038462 | 2025-01-13 | 2958465 |  | 539
15123 | CX.MASTER 05L Nº08(215X110X237) |  |  | 10 | 3338001 | ESFEROGRAFICA SENATOR NFL GREEN BAY PACKERS BRANCA-AZUL | UN | 0.038462 | 0 | 100 | 0.038462 | 2025-01-13 | 2958465 |  | 539
15123 | CX.MASTER 05L Nº08(215X110X237) |  |  | 10 | 514 | MARCADOR MAXX(Q.B)+1CARTUCHO-BL/1 | UN | 0.025 | 0 | 100 | 0.025 | 2000-07-27 | 767010 |  | 539
15123 | CX.MASTER 05L Nº08(215X110X237) |  |  | 10 | 626 | ESFEROGRAFICA 07 ACO-BL/2 | UN | 0.025 | 0 | 100 | 0.025 | 2000-12-26 | 767010 |  | 539
15123 | CX.MASTER 05L Nº08(215X110X237) |  |  | 15 | B001945001 | ROLLER ONE BUSINESS GRAVADA-AZUL | UN | 0.04 | 0 | 100 | 0.04 | 2023-04-01 | 2958465 |  | 539
15123 | CX.MASTER 05L Nº08(215X110X237) |  |  | 10 | B001971001 | ESFEROGRAFICA SENATOR PRATA GRAVADA-AZUL | UN | 0.038462 | 0 | 100 | 0.038462 | 2015-10-19 | 2958465 |  | 539
15123 | CX.MASTER 05L Nº08(215X110X237) |  |  | 10 | B001972001 | ESFEROGRAFICA SENATOR AZUL GRAVADA-AZUL | UN | 0.038462 | 0 | 100 | 0.038462 | 2015-09-30 | 2958465 |  | 539
15123 | CX.MASTER 05L Nº08(215X110X237) |  |  | 10 | B001973001 | ESFEROGRAFICA SENATOR VERMELHO GRAVADA-AZUL | UN | 0.038462 | 0 | 100 | 0.038462 | 2015-10-19 | 2958465 |  | 539
15123 | CX.MASTER 05L Nº08(215X110X237) |  |  | 10 | B002084001 | ESFEROGRAFICA SENATOR PRETA GRAVADA-AZUL | UN | 0.038462 | 0 | 100 | 0.038462 | 2016-09-23 | 2958465 |  | 539
15123 | CX.MASTER 05L Nº08(215X110X237) |  |  | 10 | B002147001 | ESFEROGRAFICA SENATOR ROSA GRAVADA-AZUL | UN | 0.038462 | 0 | 100 | 0.038462 | 2017-04-26 | 2958465 |  | 539
15123 | CX.MASTER 05L Nº08(215X110X237) |  |  | 10 | B002148001 | ESFEROGRAFICA SENATOR BRANCA GRAVADA-AZUL | UN | 0.038462 | 0 | 100 | 0.038462 | 2017-04-26 | 2958465 |  | 539
15123 | CX.MASTER 05L Nº08(215X110X237) |  |  | 10 | B002373001 | ROLLER ONE CHANGE GRAVADA-AZUL | UN | 0.038462 | 0 | 100 | 0.038462 | 2022-11-24 | 2958465 |  | 539
15123 | CX.MASTER 05L Nº08(215X110X237) |  |  | 10 | B002952001 | ESFEROGRAFICA RIO PRETA GRAVADA-AZUL | UN | 0.038462 | 0 | 100 | 0.038462 | 2025-04-14 | 2958465 |  | 539
15123 | CX.MASTER 05L Nº08(215X110X237) |  |  | 10 | B002953001 | ESFEROGRAFICA RIO TOUCH PRETA GRAVADA-AZUL | UN | 0.038462 | 0 | 100 | 0.038462 | 2025-04-14 | 2958465 |  | 539
15123 | CX.MASTER 05L Nº08(215X110X237) |  |  | 10 | B002969001 | ESFEROGRAFICA RIO AMARELA GRAVADA-AZUL | UN | 0.038462 | 0 | 100 | 0.038462 | 2025-04-14 | 2958465 |  | 539
15123 | CX.MASTER 05L Nº08(215X110X237) |  |  | 10 | B002970001 | ESFEROGRAFICA RIO ROSE GRAVADA-AZUL | UN | 0.038462 | 0 | 100 | 0.038462 | 2025-04-14 | 2958465 |  | 539
15123 | CX.MASTER 05L Nº08(215X110X237) |  |  | 10 | B002971001 | ESFEROGRAFICA RIO AZUL GRAVADA-AZUL | UN | 0.038462 | 0 | 100 | 0.038462 | 2025-04-14 | 2958465 |  | 539
15123 | CX.MASTER 05L Nº08(215X110X237) |  |  | 10 | B002972001 | ESFEROGRAFICA RIO PINK GRAVADA-AZUL | UN | 0.038462 | 0 | 100 | 0.038462 | 2025-04-14 | 2958465 |  | 539
15123 | CX.MASTER 05L Nº08(215X110X237) |  |  | 10 | B002973001 | ESFEROGRAFICA RIO VERDE GRAVADA-AZUL | UN | 0.038462 | 0 | 100 | 0.038462 | 2025-04-14 | 2958465 |  | 539
15123 | CX.MASTER 05L Nº08(215X110X237) |  |  | 10 | I001945001 | ROLLER ONE BUSINESS(i) -AZUL | UN | 0.038462 | 0 | 100 | 0.038462 | 2022-05-25 | 401766 |  | 539
15123 | CX.MASTER 05L Nº08(215X110X237) |  |  | 10 | I001971001 | ESFEROGRAFICA(i) SENATOR PRATA -AZUL | UN | 0.038462 | 0 | 100 | 0.038462 | 2022-05-25 | 2958465 |  | 539
15123 | CX.MASTER 05L Nº08(215X110X237) |  |  | 10 | I001972001 | ESFEROGRAFICA(i) SENATOR AZUL -AZUL | UN | 0.038462 | 0 | 100 | 0.038462 | 2022-05-25 | 2958465 |  | 539
15123 | CX.MASTER 05L Nº08(215X110X237) |  |  | 10 | I001973001 | ESFEROGRAFICA(i) SENATOR VERMELHO -AZUL | UN | 0.038462 | 0 | 100 | 0.038462 | 2022-05-25 | 2958465 |  | 539
15123 | CX.MASTER 05L Nº08(215X110X237) |  |  | 10 | I002084001 | ESFEROGRAFICA(i) SENATOR PRETA -AZUL | UN | 0.038462 | 0 | 100 | 0.038462 | 2022-05-25 | 2958465 |  | 539
15123 | CX.MASTER 05L Nº08(215X110X237) |  |  | 10 | I002147001 | ESFEROGRAFICA(i) SENATOR ROSA -AZUL | UN | 0.038462 | 0 | 100 | 0.038462 | 2022-05-25 | 2958465 |  | 539
15123 | CX.MASTER 05L Nº08(215X110X237) |  |  | 10 | I002148001 | ESFEROGRAFICA(i) SENATOR BRANCA -AZUL | UN | 0.038462 | 0 | 100 | 0.038462 | 2022-05-25 | 2958465 |  | 539
15123 | CX.MASTER 05L Nº08(215X110X237) |  |  | 10 | I002373001 | ROLLER(i) ONE CHANGE-AZUL | UN | 0.038462 | 0 | 100 | 0.038462 | 2022-11-24 | 2958465 |  | 539
15123 | CX.MASTER 05L Nº08(215X110X237) |  |  | 10 | I002952001 | ESFEROGRAFICA RIO(i) PRETA-AZUL | UN | 0.038462 | 0 | 100 | 0.038462 | 2025-04-14 | 2958465 |  | 539
15123 | CX.MASTER 05L Nº08(215X110X237) |  |  | 10 | I002953001 | ESFEROGRAFICA RIO(i) TOUCH PRETA-AZUL | UN | 0.038462 | 0 | 100 | 0.038462 | 2025-04-14 | 2958465 |  | 539
15123 | CX.MASTER 05L Nº08(215X110X237) |  |  | 10 | I002969001 | ESFEROGRAFICA RIO(i) AMARELA-AZUL | UN | 0.038462 | 0 | 100 | 0.038462 | 2025-04-14 | 2958465 |  | 539
15123 | CX.MASTER 05L Nº08(215X110X237) |  |  | 10 | I002970001 | ESFEROGRAFICA RIO(i) ROSE-AZUL | UN | 0.038462 | 0 | 100 | 0.038462 | 2025-04-14 | 2958465 |  | 539
15123 | CX.MASTER 05L Nº08(215X110X237) |  |  | 10 | I002971001 | ESFEROGRAFICA RIO(i) AZUL-AZUL | UN | 0.038462 | 0 | 100 | 0.038462 | 2025-04-14 | 2958465 |  | 539
15123 | CX.MASTER 05L Nº08(215X110X237) |  |  | 10 | I002972001 | ESFEROGRAFICA RIO(i) PINK-AZUL | UN | 0.038462 | 0 | 100 | 0.038462 | 2025-04-14 | 2958465 |  | 539
15123 | CX.MASTER 05L Nº08(215X110X237) |  |  | 10 | I002973001 | ESFEROGRAFICA RIO(i) VERDE-AZUL | UN | 0.038462 | 0 | 100 | 0.038462 | 2025-04-14 | 2958465 |  | 539
15124 | CX.MASTER 04L Nº11(196X114X205) | UN |  | 30 | 1235000 | APAGADOR COMPACTOR - S/MARCADOR | UN | 0.04 | 0 | 100 | 0.04 | 2015-11-20 | 2958465 |  | 2211
15124 | CX.MASTER 04L Nº11(196X114X205) |  |  | 10 | 1383 | MARCADOR WINDOW-DI/12 | UN | 1 | 0 | 100 | 1 | 2006-06-28 | 2958465 |  | 2211
15124 | CX.MASTER 04L Nº11(196X114X205) |  |  | 10 | 1584 | LAPISEIRA ALUNO 0,7-BL/1 | UN | 0.05 | 0 | 100 | 0.05 | 2008-06-18 | 2958465 |  | 2211
15124 | CX.MASTER 04L Nº11(196X114X205) |  |  | 5 | B001796001 | CANETA TINTEIRO MOD.01-GOLD BLACK GRAVADA-AZUL | UN | 0.166667 | 0 | 100 | 0.166667 | 2019-05-01 | 2958465 |  | 2211
15124 | CX.MASTER 04L Nº11(196X114X205) |  |  | 10 | B001798001 | CANETA TINTEIRO MOD.01-CHROME BLACK GRAVADA-AZUL | UN | 0.166667 | 0 | 100 | 0.166667 | 2019-05-01 | 2958465 |  | 2211
15124 | CX.MASTER 04L Nº11(196X114X205) |  |  | 10 | B001800001 | CANETA TINTEIRO MOD.01-WHITE GRAVADA-AZUL | UN | 0.166667 | 0 | 100 | 0.166667 | 2019-05-01 | 2958465 |  | 2211
15124 | CX.MASTER 04L Nº11(196X114X205) |  |  | 10 | B001806001 | ROLLER DUO PLUS MOD.301-CHROME BLACK GRAVADA-AZUL | UN | 0.166667 | 0 | 100 | 0.166667 | 2017-11-03 | 2958465 |  | 2211
15124 | CX.MASTER 04L Nº11(196X114X205) |  |  | 10 | B001808001 | ROLLER DUO PLUS MOD.301-WHITE GRAVADA-AZUL | UN | 0.166667 | 0 | 100 | 0.166667 | 2017-11-03 | 2958465 |  | 2211
15124 | CX.MASTER 04L Nº11(196X114X205) |  |  | 5 | B001834001 | CANETA TINTEIRO MOD.01-GOLD BLACK+FRASCO GRAVADA-AZUL | UN | 0.166667 | 0 | 100 | 0.166667 | 2023-11-15 | 2958465 |  | 2211
15124 | CX.MASTER 04L Nº11(196X114X205) |  |  | 5 | B002331001 | CANETA TINTEIRO MOD.01-VERDE OLIVE GRAVADA -AZUL | UN | 0.166667 | 0 | 100 | 0.166667 | 2023-11-15 | 2958465 |  | 2211
15124 | CX.MASTER 04L Nº11(196X114X205) |  |  | 5 | B002332001 | CANETA TINTEIRO MOD.01-NAVY BLUE GRAVADA -AZUL | UN | 0.166667 | 0 | 100 | 0.166667 | 2023-11-15 | 2958465 |  | 2211
15124 | CX.MASTER 04L Nº11(196X114X205) |  |  | 5 | B002333001 | CANETA TINTEIRO MOD.01-DEMONSTRATOR GRAVADA-AZUL | UN | 0.166667 | 0 | 100 | 0.166667 | 2023-11-15 | 2958465 |  | 2211
15124 | CX.MASTER 04L Nº11(196X114X205) |  |  | 5 | B002340001 | CANETA TINTEIRO MOD.01-PINK GRAVADA-AZUL | UN | 0.166667 | 0 | 100 | 0.166667 | 2023-11-15 | 2958465 |  | 2211
15124 | CX.MASTER 04L Nº11(196X114X205) |  |  | 5 | B002342001 | CANETA TINTEIRO MOD.01-AMARELO NEON GRAVADA-AZUL | UN | 0.166667 | 0 | 100 | 0.166667 | 2023-11-15 | 2958465 |  | 2211
15124 | CX.MASTER 04L Nº11(196X114X205) |  |  | 10 | B002795001 | ROLLER CEOD SHINY POWDER PINK GRAVADA - AZUL | UN | 0.166667 | 0 | 100 | 0.166667 | 2023-11-15 | 2958465 |  | 2211
15124 | CX.MASTER 04L Nº11(196X114X205) |  |  | 10 | B002796001 | ROLLER CEOD SHINY GRAPHITE GRAVADA- AZUL | UN | 0.166667 | 0 | 100 | 0.166667 | 2023-11-15 | 2958465 |  | 2211
15124 | CX.MASTER 04L Nº11(196X114X205) |  |  | 10 | B002797001 | ROLLER CEOD SHINY BLUE GRAVADA- AZUL | UN | 0.166667 | 0 | 100 | 0.166667 | 2023-11-15 | 2958465 |  | 2211
15124 | CX.MASTER 04L Nº11(196X114X205) |  |  | 10 | B002798001 | ROLLER CEOD SHINY LIGHT GOLD GRAVADA- AZUL | UN | 0.166667 | 0 | 100 | 0.166667 | 2023-11-15 | 2958465 |  | 2211
15124 | CX.MASTER 04L Nº11(196X114X205) |  |  | 10 | B002799001 | ROLLER CEOD SHINY BRONZE GRAVADA - AZUL | UN | 0.166667 | 0 | 100 | 0.166667 | 2023-11-15 | 2958465 |  | 2211
15124 | CX.MASTER 04L Nº11(196X114X205) |  |  | 5 | I001796001 | CANETA TINTEIRO(i) MOD.01-GOLD BLACK -AZUL | UN | 0.166667 | 0 | 100 | 0.166667 | 2022-05-25 | 2958465 |  | 2211
15124 | CX.MASTER 04L Nº11(196X114X205) |  |  | 10 | I001798001 | CANETA TINTEIRO(i) MOD.01-CHROME BLACK -AZUL | UN | 0.166667 | 0 | 100 | 0.166667 | 2022-05-25 | 2958465 |  | 2211
15124 | CX.MASTER 04L Nº11(196X114X205) |  |  | 10 | I001800001 | CANETA TINTEIRO(i) MOD.01-WHITE -AZUL | UN | 0.166667 | 0 | 100 | 0.166667 | 2022-05-25 | 2958465 |  | 2211
15124 | CX.MASTER 04L Nº11(196X114X205) |  |  | 10 | I001806001 | ROLLER(i) DUO PLUS MOD.301-CHROME BLACK -AZUL | UN | 0.166667 | 0 | 100 | 0.166667 | 2022-05-25 | 2958465 |  | 2211
15124 | CX.MASTER 04L Nº11(196X114X205) |  |  | 10 | I001808001 | ROLLER(i) DUO PLUS MOD.301-WHITE -AZUL | UN | 0.166667 | 0 | 100 | 0.166667 | 2022-05-25 | 2958465 |  | 2211
15124 | CX.MASTER 04L Nº11(196X114X205) |  |  | 5 | I001834001 | CANETA(i) TINTEIRO MOD.01-GOLD BLACK+FRASCO DE TINTEIRO-AZUL | UN | 0.166667 | 0 | 100 | 0.166667 | 2023-11-15 | 2958465 |  | 2211
15124 | CX.MASTER 04L Nº11(196X114X205) |  |  | 5 | I002331001 | CANETA(i) TINTEIRO MOD.01-VERDE OLIVE-AZUL | UN | 0.166667 | 0 | 100 | 0.166667 | 2023-11-15 | 2958465 |  | 2211
15124 | CX.MASTER 04L Nº11(196X114X205) |  |  | 5 | I002332001 | CANETA(i) TINTEIRO MOD.01-NAVY BLUE-AZUL | UN | 0.166667 | 0 | 100 | 0.166667 | 2023-11-15 | 2958465 |  | 2211
15124 | CX.MASTER 04L Nº11(196X114X205) |  |  | 5 | I002333001 | CANETA(i) TINTEIRO MOD.01-DEMONSTRATOR-AZUL | UN | 0.166667 | 0 | 100 | 0.166667 | 2023-11-15 | 2958465 |  | 2211
15124 | CX.MASTER 04L Nº11(196X114X205) |  |  | 5 | I002340001 | CANETA(i) TINTEIRO MOD.01-PINK-AZUL | UN | 0.166667 | 0 | 100 | 0.166667 | 2023-11-15 | 2958465 |  | 2211
15124 | CX.MASTER 04L Nº11(196X114X205) |  |  | 5 | I002342001 | CANETA(i) TINTEIRO MOD.01-AMARELO NEON-AZUL | UN | 0.166667 | 0 | 100 | 0.166667 | 2023-11-15 | 2958465 |  | 2211
15124 | CX.MASTER 04L Nº11(196X114X205) |  |  | 10 | I002795001 | ROLLER(i) CEOD SHINY POWER PINK - AZUL | UN | 0.166667 | 0 | 100 | 0.166667 | 2023-11-15 | 2958465 |  | 2211
15124 | CX.MASTER 04L Nº11(196X114X205) |  |  | 10 | I002796001 | ROLLER(i) CEOD SHINY GRAPHITE - AZUL | UN | 0.166667 | 0 | 100 | 0.166667 | 2023-11-15 | 2958465 |  | 2211
15124 | CX.MASTER 04L Nº11(196X114X205) |  |  | 10 | I002797001 | ROLLER(i) CEOD SHINY BLUE - AZUL | UN | 0.166667 | 0 | 100 | 0.166667 | 2023-11-15 | 2958465 |  | 2211
15124 | CX.MASTER 04L Nº11(196X114X205) |  |  | 10 | I002798001 | ROLLER(i) CEOD SHINY LIGHT GOLD - AZUL | UN | 0.166667 | 0 | 100 | 0.166667 | 2023-11-15 | 2958465 |  | 2211
15124 | CX.MASTER 04L Nº11(196X114X205) |  |  | 10 | I002799001 | ROLLER(i) CEOD SHINY BRONZE -AZUL | UN | 0.166667 | 0 | 100 | 0.166667 | 2023-11-15 | 2958465 |  | 2211
15131 | CX.MASTER 01L Nº04(200X120X75) | UN |  | 10 | 1393076 | TINTEIRO MOD.02 40ml- CX/1-FRESH ORANGE | UN | 0.166667 | 0 | 100 | 0.166667 | 2017-06-08 | 2958465 |  | 59
15131 | CX.MASTER 01L Nº04(200X120X75) |  |  | 10 | 1393077 | TINTEIRO MOD.02 40ml- CX/1-SKYLIGHT BLUE | UN | 0.166667 | 0 | 100 | 0.166667 | 2017-06-08 | 2958465 |  | 59
15131 | CX.MASTER 01L Nº04(200X120X75) |  |  | 10 | 1393078 | TINTEIRO MOD.02 40ml- CX/1-SKINY PINK | UN | 0.166667 | 0 | 100 | 0.166667 | 2017-06-08 | 2958465 |  | 59
15131 | CX.MASTER 01L Nº04(200X120X75) |  |  | 10 | 1393079 | TINTEIRO MOD.02 40ml- CX/1-FOREST GREEN | UN | 0.166667 | 0 | 100 | 0.166667 | 2018-11-14 | 401768 |  | 59
15131 | CX.MASTER 01L Nº04(200X120X75) |  |  | 10 | 2180001 | MARCADOR CREATIVE-CX/6-AZUL | UN | 0.125 | 0 | 100 | 0.125 | 2025-08-14 | 2958465 |  | 59
15131 | CX.MASTER 01L Nº04(200X120X75) |  |  | 10 | 2180002 | MARCADOR CREATIVE-CX/6-VERMELHA | UN | 0.125 | 0 | 100 | 0.125 | 2025-08-14 | 2958465 |  | 59
15131 | CX.MASTER 01L Nº04(200X120X75) |  |  | 10 | 2180003 | MARCADOR CREATIVE-CX/6-VERDE | UN | 0.125 | 0 | 100 | 0.125 | 2025-08-14 | 2958465 |  | 59
15131 | CX.MASTER 01L Nº04(200X120X75) |  |  | 10 | 2180004 | MARCADOR CREATIVE-CX/6-PRETA | UN | 0.125 | 0 | 100 | 0.125 | 2025-08-14 | 2958465 |  | 59
15131 | CX.MASTER 01L Nº04(200X120X75) |  |  | 10 | 2180005 | MARCADOR CREATIVE-CX/6-MARROM | UN | 0.125 | 0 | 100 | 0.125 | 2025-08-14 | 2958465 |  | 59
15131 | CX.MASTER 01L Nº04(200X120X75) |  |  | 10 | 2180006 | MARCADOR CREATIVE-CX/6-AMARELO | UN | 0.125 | 0 | 100 | 0.125 | 2025-08-14 | 2958465 |  | 59
15131 | CX.MASTER 01L Nº04(200X120X75) |  |  | 10 | 2180007 | MARCADOR CREATIVE-CX/6-LARANJA | UN | 0.125 | 0 | 100 | 0.125 | 2025-08-14 | 2958465 |  | 59
15131 | CX.MASTER 01L Nº04(200X120X75) |  |  | 10 | 2180008 | MARCADOR CREATIVE-CX/6-VIOLETA | UN | 0.125 | 0 | 100 | 0.125 | 2025-08-14 | 2958465 |  | 59
15131 | CX.MASTER 01L Nº04(200X120X75) |  |  | 10 | 2180010 | MARCADOR CREATIVE-CX/6-AZUL CLARO | UN | 0.125 | 0 | 100 | 0.125 | 2025-08-14 | 2958465 |  | 59
15131 | CX.MASTER 01L Nº04(200X120X75) |  |  | 10 | 2180014 | MARCADOR CREATIVE-CX/6-ROSA | UN | 0.125 | 0 | 100 | 0.125 | 2025-08-14 | 2958465 |  | 59
15131 | CX.MASTER 01L Nº04(200X120X75) |  |  | 10 | 2180030 | MARCADOR CREATIVE-CX/6-PRATA | UN | 0.125 | 0 | 100 | 0.125 | 2025-08-14 | 2958465 |  | 59
15131 | CX.MASTER 01L Nº04(200X120X75) |  |  | 10 | 2180036 | MARCADOR CREATIVE-CX/6-OURO | UN | 0.125 | 0 | 100 | 0.125 | 2025-08-14 | 2958465 |  | 59
15131 | CX.MASTER 01L Nº04(200X120X75) |  |  | 10 | 2180037 | MARCADOR CREATIVE-CX/6-AZUL METALICA | UN | 0.125 | 0 | 100 | 0.125 | 2025-08-14 | 2958465 |  | 59
15131 | CX.MASTER 01L Nº04(200X120X75) |  |  | 10 | 2180038 | MARCADOR CREATIVE-CX/6-VERMELHA METALICA | UN | 0.125 | 0 | 100 | 0.125 | 2025-08-14 | 2958465 |  | 59
15131 | CX.MASTER 01L Nº04(200X120X75) |  |  | 10 | 2180039 | MARCADOR CREATIVE-CX/6-VERDE METALICA | UN | 0.125 | 0 | 100 | 0.125 | 2025-08-14 | 2958465 |  | 59
15131 | CX.MASTER 01L Nº04(200X120X75) |  |  | 10 | 2180041 | MARCADOR CREATIVE-CX/6-COBRE METALICA | UN | 0.125 | 0 | 100 | 0.125 | 2025-08-14 | 2958465 |  | 59
15131 | CX.MASTER 01L Nº04(200X120X75) |  |  | 10 | 2235001 | TINTEIRO MOD.02 30ml- CX/1-AZUL | UN | 0.166667 | 0 | 100 | 0.166667 | 2022-06-21 | 2958465 |  | 59
15131 | CX.MASTER 01L Nº04(200X120X75) |  |  | 10 | 2235004 | TINTEIRO MOD.02 30ml- CX/1-PRETA | UN | 0.166667 | 0 | 100 | 0.166667 | 2022-06-21 | 2958465 |  | 59
15131 | CX.MASTER 01L Nº04(200X120X75) |  |  | 10 | 2235076 | TINTEIRO MOD.02 30ml- CX/1-FRESH ORANGE | UN | 0.166667 | 0 | 100 | 0.166667 | 2022-06-21 | 2958465 |  | 59
15131 | CX.MASTER 01L Nº04(200X120X75) |  |  | 10 | 2235077 | TINTEIRO MOD.02 30ml- CX/1-SKYLIGHT BLUE | UN | 0.166667 | 0 | 100 | 0.166667 | 2022-06-21 | 2958465 |  | 59
15131 | CX.MASTER 01L Nº04(200X120X75) |  |  | 10 | 2235078 | TINTEIRO MOD.02 30ml- CX/1-SHINY PINK | UN | 0.166667 | 0 | 100 | 0.166667 | 2022-06-21 | 2958465 |  | 59
15131 | CX.MASTER 01L Nº04(200X120X75) |  |  | 10 | 2235079 | TINTEIRO MOD.02 30ml- CX/1-FOREST GREEN | UN | 0.166667 | 0 | 100 | 0.166667 | 2022-06-21 | 2958465 |  | 59
15131 | CX.MASTER 01L Nº04(200X120X75) |  |  | 10 | 2297000 | APONTADOR 2 EM 1 C/BORRACHA-BL/1-CX/10 | UN | 1 | 0 | 100 | 1 | 2019-04-02 | 2958465 |  | 59
15131 | CX.MASTER 01L Nº04(200X120X75) |  |  | 10 | 2482004 | MARCADOR CREATIVE F-CX/6-PRETA | UN | 0.125 | 0 | 100 | 0.125 | 2025-08-14 | 2958465 |  | 59
15131 | CX.MASTER 01L Nº04(200X120X75) |  |  | 10 | 2482036 | MARCADOR CREATIVE F-CX/6-OURO | UN | 0.125 | 0 | 100 | 0.125 | 2025-08-14 | 2958465 |  | 59
15131 | CX.MASTER 01L Nº04(200X120X75) |  |  | 10 | 3138999 | MARCADOR JOB HARIBO(REPOSIÇÃO) C/25-SORTIDO | UN | 1 | 0 | 100 | 1 | 2025-06-01 | 401768 |  | 59
15138 | CX.MASTER 28L Nº41(572X298X165) | UN |  | 10 | 33507 | ESFEROGRAFICAS 07 VIP RETRÁTIL P/ ESPOSITOR PDV | UN | 1 | 0 | 100 | 1 | 2020-07-22 | 2958465 |  | 450
15138 | CX.MASTER 28L Nº41(572X298X165) |  |  | 10 | R000944016 | ESFEROGRAFICA JET LUX- DI/112 PURPURA (CRR) | UN | 0.125 | 0 | 100 | 0.125 | 2019-12-31 | 401766 |  | 450
15138 | CX.MASTER 28L Nº41(572X298X165) |  |  | 10 | R001676001 | ESFEROGRAFICA 07 BRASIL - DI/112 AZUL (CRR) | UN | 0.125 | 0 | 100 | 0.125 | 2020-07-01 | 401766 |  | 450
15199 | CX.MASTER 21L Nº13(435X325X150) | UN |  | 10 | 851001 | ESFEROGRAFICA 07-CX/100-AZUL | UN | 0.0833 | 0 | 100 | 0.0833 | 2020-07-01 | 401766 |  | 2375
15199 | CX.MASTER 21L Nº13(435X325X150) |  |  | 10 | 851002 | ESFEROGRAFICA 07-CX/100-VERMELHA | UN | 0.0833 | 0 | 100 | 0.0833 | 2020-07-01 | 401766 |  | 2375
15199 | CX.MASTER 21L Nº13(435X325X150) |  |  | 10 | 851003 | ESFEROGRAFICA 07-CX/100-VERDE | UN | 0.0833 | 0 | 100 | 0.0833 | 2020-07-01 | 401766 |  | 2375
15199 | CX.MASTER 21L Nº13(435X325X150) |  |  | 10 | 851004 | ESFEROGRAFICA 07-CX/100-PRETA | UN | 0.0833 | 0 | 100 | 0.0833 | 2020-07-01 | 401766 |  | 2375
15199 | CX.MASTER 21L Nº13(435X325X150) |  |  | 100 | 852001 | ESFEROGRAFICA TOP 2000-CX/100 AZUL | UN | 0.083333 | 0 | 100 | 0.083333 | 2019-04-01 | 401766 |  | 2375
15199 | CX.MASTER 21L Nº13(435X325X150) |  |  | 90 | 852002 | ESFEROGRAFICA TOP 2000-CX/100 VERMELHA | UN | 0.083333 | 0 | 100 | 0.083333 | 2019-04-01 | 401766 |  | 2375
15199 | CX.MASTER 21L Nº13(435X325X150) |  |  | 90 | 852003 | ESFEROGRAFICA TOP 2000-CX/100 VERDE | UN | 0.083333 | 0 | 100 | 0.083333 | 2019-04-01 | 401766 |  | 2375
15199 | CX.MASTER 21L Nº13(435X325X150) |  |  | 90 | 852004 | ESFEROGRAFICA TOP 2000-CX/100 PRETA | UN | 0.083333 | 0 | 100 | 0.083333 | 2019-04-01 | 401766 |  | 2375
15199 | CX.MASTER 21L Nº13(435X325X150) |  |  | 100 | 1987001 | ESFEROGRAFICA ECONOMIC -CX/100 AZUL | UN | 0.083333 | 0 | 100 | 0.083333 | 2019-04-01 | 401766 |  | 2375
15199 | CX.MASTER 21L Nº13(435X325X150) |  |  | 100 | 1987002 | ESFEROGRAFICA ECONOMIC -CX/100 VERMELHA | UN | 0.083333 | 0 | 100 | 0.083333 | 2019-04-01 | 401766 |  | 2375
15199 | CX.MASTER 21L Nº13(435X325X150) |  |  | 100 | 1987004 | ESFEROGRAFICA ECONOMIC -CX/100 PRETA | UN | 0.083333 | 0 | 100 | 0.083333 | 2019-04-01 | 401766 |  | 2375
15199 | CX.MASTER 21L Nº13(435X325X150) |  |  | 10 | 2430001 | ESFEROGRAFICA ECONOMIC FINA-CX/100 AZUL | UN | 0.083333 | 0 | 100 | 0.083333 | 2019-12-12 | 401766 |  | 2375
15199 | CX.MASTER 21L Nº13(435X325X150) |  |  | 10 | 2430002 | ESFEROGRAFICA ECONOMIC FINA-CX/100 VERMELHA | UN | 0.083333 | 0 | 100 | 0.083333 | 2019-12-12 | 401766 |  | 2375
15199 | CX.MASTER 21L Nº13(435X325X150) |  |  | 10 | 2430004 | ESFEROGRAFICA ECONOMIC FINA-CX/100 PRETA | UN | 0.083333 | 0 | 100 | 0.083333 | 2019-12-12 | 401766 |  | 2375
15199 | CX.MASTER 21L Nº13(435X325X150) |  |  | 10 | 3112000 | COMBO 6 ESFER.ECONOMIC -CX/100 AZUL+9 GIGANTE C/12-PCT/5 | Un | 1 | 0 | 100 | 1 | 2025-02-01 | 2958465 |  | 2375
15199 | CX.MASTER 21L Nº13(435X325X150) |  |  | 10 | 3113000 | COMBO 6 ESFER.ECONOMIC -CX/100 VERMELHA+9 GIGANTE C/12-PCT/5 | Un | 1 | 0 | 100 | 1 | 2025-02-01 | 2958465 |  | 2375
15199 | CX.MASTER 21L Nº13(435X325X150) |  |  | 10 | 3114000 | COMBO 6 ESFER.ECONOMIC -CX/100 PRETA+9 GIGANTE C/12-PCT/5 | Un | 1 | 0 | 100 | 1 | 2025-02-01 | 2958465 |  | 2375
15199 | CX.MASTER 21L Nº13(435X325X150) |  |  | 10 | 34389 | ESFER. 07 VIP P/ACOES DE MKT-01 (COMPACTOR) | UN | 0.001 | 0 | 100 | 0.001 | 2023-12-20 | 2958465 |  | 2375
15199 | CX.MASTER 21L Nº13(435X325X150) |  |  | 100 | 35066 | ESF. ECONOMIC EM CX/100 P/COMBO AZUL | UN | 0.083333 | 0 | 100 | 0.083333 | 2025-02-19 | 401766 |  | 2375
15199 | CX.MASTER 21L Nº13(435X325X150) |  |  | 100 | 35067 | ESF. ECONOMIC EM CX/100 P/COMBO VERMELHO | UN | 0.083333 | 0 | 100 | 0.083333 | 2025-02-19 | 401766 |  | 2375
15199 | CX.MASTER 21L Nº13(435X325X150) |  |  | 100 | 35068 | ESF. ECONOMIC EM CX/100 P/COMBO PRETO | UN | 0.083333 | 0 | 100 | 0.083333 | 2025-02-19 | 401766 |  | 2375
15199 | CX.MASTER 21L Nº13(435X325X150) |  |  | 10 | B001970001 | ESFEROGRAFICA LIKE BRANCA OPACA GRAVADA-AZUL | UN | 0.002 | 0 | 100 | 0.002 | 2019-01-01 | 2958465 |  | 2375
15199 | CX.MASTER 21L Nº13(435X325X150) |  |  | 10 | R000851001 | ESFEROGRAFICA 07-CX/100-AZUL (CRR) | UN | 0.0833 | 0 | 100 | 0.0833 | 2020-07-01 | 401766 |  | 2375
15199 | CX.MASTER 21L Nº13(435X325X150) |  |  | 10 | R000851002 | ESFEROGRAFICA 07-CX/100-VERMELHA (CRR) | UN | 0.0833 | 0 | 100 | 0.0833 | 2020-07-01 | 401766 |  | 2375
15199 | CX.MASTER 21L Nº13(435X325X150) |  |  | 10 | R000851003 | ESFEROGRAFICA 07-CX/100-VERDE (CRR) | UN | 0.0833 | 0 | 100 | 0.0833 | 2020-07-01 | 401766 |  | 2375
15199 | CX.MASTER 21L Nº13(435X325X150) |  |  | 10 | R000851004 | ESFEROGRAFICA 07-CX/100-PRETA (CRR) | UN | 0.0833 | 0 | 100 | 0.0833 | 2020-07-01 | 401766 |  | 2375
15199 | CX.MASTER 21L Nº13(435X325X150) |  |  | 10 | R000852001 | ESFEROGRAFICA TOP 2000-CX/100 AZUL (CRR) | UN | 0.0833 | 0 | 100 | 0.0833 | 2019-12-31 | 401766 |  | 2375
15199 | CX.MASTER 21L Nº13(435X325X150) |  |  | 10 | R000852002 | ESFEROGRAFICA TOP 2000-CX/100 VERMELHA (CRR) | UN | 0.0833 | 0 | 100 | 0.0833 | 2019-12-31 | 401766 |  | 2375
15199 | CX.MASTER 21L Nº13(435X325X150) |  |  | 10 | R000852003 | ESFEROGRAFICA TOP 2000-CX/100 VERDE (CRR) | UN | 0.0833 | 0 | 100 | 0.0833 | 2019-12-31 | 401766 |  | 2375
15199 | CX.MASTER 21L Nº13(435X325X150) |  |  | 10 | R000852004 | ESFEROGRAFICA TOP 2000-CX/100 PRETA (CRR) | UN | 0.0833 | 0 | 100 | 0.0833 | 2019-12-31 | 401766 |  | 2375
15199 | CX.MASTER 21L Nº13(435X325X150) |  |  | 10 | R001987001 | ESFEROGRAFICA ECONOMIC -CX/100 AZUL (CRR) | UN | 0.0833 | 0 | 100 | 0.0833 | 2019-12-31 | 401766 |  | 2375
15199 | CX.MASTER 21L Nº13(435X325X150) |  |  | 100 | R001987002 | ESFEROGRAFICA ECONOMIC -CX/100 VERMELHA (CRR) | UN | 0.083333 | 0 | 100 | 0.083333 | 2020-09-02 | 401766 |  | 2375
15199 | CX.MASTER 21L Nº13(435X325X150) |  |  | 10 | R001987004 | ESFEROGRAFICA ECONOMIC -CX/100 PRETA (CRR) | UN | 0.0833 | 0 | 100 | 0.0833 | 2019-12-31 | 401766 |  | 2375
15199 | CX.MASTER 21L Nº13(435X325X150) |  |  | 10 | S000084000 | HIDROGRAFICA COMPACTOR COLOR C/6-SCC | UN | 0.01 | 0 | 100 | 0.01 | 2023-04-20 | 2958465 |  | 2375
15199 | CX.MASTER 21L Nº13(435X325X150) |  |  | 10 | S002877000 | HIDROGRAFICA COMPACTOR COLOR PASTEL C/6-SCC | UN | 0.01 | 0 | 100 | 0.01 | 2023-10-09 | 2958465 |  | 2375
15225 | CX.MASTER 06L Nº05(215X165X186) | UN |  | 10 | 73001 | HIDROGRAFICA NEO-PEN-GIGANTE AVULSO-DZ AZUL | UN | 0.033333 | 0 | 100 | 0.033333 | 2015-10-24 | 767010 |  | 5525
15225 | CX.MASTER 06L Nº05(215X165X186) |  |  | 10 | 73002 | HIDROGRAFICA NEO-PEN-GIGANTE AVULSO-DZ VERMELHA | UN | 0.033333 | 0 | 100 | 0.033333 | 2015-10-24 | 767010 |  | 5525
15225 | CX.MASTER 06L Nº05(215X165X186) |  |  | 10 | 73004 | HIDROGRAFICA NEO-PEN-GIGANTE AVULSO-DZ PRETA | UN | 0.033333 | 0 | 100 | 0.033333 | 2015-10-24 | 767010 |  | 5525
15225 | CX.MASTER 06L Nº05(215X165X186) |  |  | 10 | 85001 | HIDROGRAFICA COMPACTOR COLOR AVULSO-DZ AZUL | UN | 0.066667 | 0 | 100 | 0.066667 | 2018-06-20 | 767010 |  | 5525
15225 | CX.MASTER 06L Nº05(215X165X186) |  |  | 10 | 85002 | HIDROGRAFICA COMPACTOR COLOR AVULSO-DZ VERMELHO | UN | 0.066667 | 0 | 100 | 0.066667 | 2018-06-20 | 767010 |  | 5525
15225 | CX.MASTER 06L Nº05(215X165X186) |  |  | 10 | 85003 | HIDROGRAFICA COMPACTOR COLOR AVULSO-DZ VERDE | UN | 0.066667 | 0 | 100 | 0.066667 | 2018-06-20 | 767010 |  | 5525
15225 | CX.MASTER 06L Nº05(215X165X186) |  |  | 10 | 85004 | HIDROGRAFICA COMPACTOR COLOR AVULSO-DZ PRETA | UN | 0.066667 | 0 | 100 | 0.066667 | 2018-06-20 | 767010 |  | 5525
15225 | CX.MASTER 06L Nº05(215X165X186) |  |  | 10 | 896000 | COLA POLAR BRANCA 250 g-CX/12 | UN | 1 | 0 | 100 | 1 | 2015-10-20 | 767010 |  | 5525
15225 | CX.MASTER 06L Nº05(215X165X186) |  |  | 10 | 910000 | COLA POLAR ISOPOR 250 g-CX/12 | UN | 1 | 0 | 100 | 1 | 2017-05-30 | 2958465 |  | 5525
15225 | CX.MASTER 06L Nº05(215X165X186) |  |  | 10 | 1394001 | CANETA TINTEIRO SOLO M -AZUL | UN | 0.033333 | 0 | 100 | 0.033333 | 2024-10-01 | 2958465 |  | 5525
15225 | CX.MASTER 06L Nº05(215X165X186) |  |  | 10 | 1546001 | MICROLINE AVULSO-CX/12 AZUL | UN | 0.033333 | 0 | 100 | 0.033333 | 2015-10-26 | 2958465 |  | 5525
15225 | CX.MASTER 06L Nº05(215X165X186) |  |  | 40 | 1546002 | MICROLINE AVULSO-CX/12 VERMELHA | UN | 0.033333 | 0 | 100 | 0.033333 | 2018-07-01 | 401766 |  | 5525
15225 | CX.MASTER 06L Nº05(215X165X186) |  |  | 30 | 1546003 | MICROLINE AVULSO-CX/12 VERDE | UN | 0.033333 | 0 | 100 | 0.033333 | 2018-07-01 | 401766 |  | 5525
15225 | CX.MASTER 06L Nº05(215X165X186) |  |  | 10 | 1546004 | MICROLINE AVULSO-CX/12 PRETA | UN | 0.033333 | 0 | 100 | 0.033333 | 2015-10-26 | 2958465 |  | 5525
15225 | CX.MASTER 06L Nº05(215X165X186) |  |  | 10 | 1546005 | MICROLINE AVULSO-CX/12 MARROM | UN | 0.033333 | 0 | 100 | 0.033333 | 2018-07-01 | 401766 |  | 5525
15225 | CX.MASTER 06L Nº05(215X165X186) |  |  | 10 | 1546006 | MICROLINE AVULSO-CX/12 AMARELO | UN | 0.033333 | 0 | 100 | 0.033333 | 2015-10-26 | 2958465 |  | 5525
15225 | CX.MASTER 06L Nº05(215X165X186) |  |  | 10 | 1546007 | MICROLINE AVULSO-CX/12 LARANJA | UN | 0.033333 | 0 | 100 | 0.033333 | 2018-07-01 | 401766 |  | 5525
15225 | CX.MASTER 06L Nº05(215X165X186) |  |  | 10 | 1546008 | MICROLINE AVULSO-CX/12 VIOLETA | UN | 0.033333 | 0 | 100 | 0.033333 | 2018-07-01 | 401766 |  | 5525
15225 | CX.MASTER 06L Nº05(215X165X186) |  |  | 10 | 1546010 | MICROLINE AVULSO-CX/12 AZUL CLARO | UN | 0.033333 | 0 | 100 | 0.033333 | 2018-07-01 | 401766 |  | 5525
15225 | CX.MASTER 06L Nº05(215X165X186) |  |  | 10 | 1546011 | MICROLINE AVULSO-CX/12 VERDE CLARO | UN | 0.033333 | 0 | 100 | 0.033333 | 2015-10-26 | 2958465 |  | 5525
15225 | CX.MASTER 06L Nº05(215X165X186) |  |  | 10 | 1546012 | MICROLINE AVULSO-CX/12 LILAS | UN | 0.033333 | 0 | 100 | 0.033333 | 2015-10-26 | 2958465 |  | 5525
15225 | CX.MASTER 06L Nº05(215X165X186) |  |  | 10 | 1546013 | MICROLINE AVULSO-CX/12 CINZA | UN | 0.033333 | 0 | 100 | 0.033333 | 2021-07-02 | 2958465 |  | 5525
15225 | CX.MASTER 06L Nº05(215X165X186) |  |  | 10 | 1546014 | MICROLINE AVULSO-CX/12 ROSA | UN | 0.033333 | 0 | 100 | 0.033333 | 2018-07-01 | 401766 |  | 5525
15225 | CX.MASTER 06L Nº05(215X165X186) |  |  | 10 | 1546015 | MICROLINE AVULSO-CX/12 TURQUESA | UN | 0.033333 | 0 | 100 | 0.033333 | 2021-07-05 | 401766 |  | 5525
15225 | CX.MASTER 06L Nº05(215X165X186) |  |  | 10 | 1546026 | MICROLINE AVULSO-CX/12 VERDE OLIVA | UN | 0.033333 | 0 | 100 | 0.033333 | 2021-08-02 | 401766 |  | 5525
15225 | CX.MASTER 06L Nº05(215X165X186) |  |  | 10 | 1546031 | MICROLINE AVULSO-CX/12 AZUL CELESTE | UN | 0.033333 | 0 | 100 | 0.033333 | 2021-07-06 | 401766 |  | 5525
15225 | CX.MASTER 06L Nº05(215X165X186) |  |  | 10 | 1546045 | MICROLINE AVULSO-CX/12 CARMIM | UN | 0.033333 | 0 | 100 | 0.033333 | 2021-07-06 | 401766 |  | 5525
15225 | CX.MASTER 06L Nº05(215X165X186) |  |  | 10 | 1546050 | MICROLINE AVULSO-CX/12 ROSA PELE | UN | 0.033333 | 0 | 100 | 0.033333 | 2021-07-06 | 401766 |  | 5525
15225 | CX.MASTER 06L Nº05(215X165X186) |  |  | 10 | 1546095 | MICROLINE AVULSO-CX/12 MARROM OCRE | UN | 0.033333 | 0 | 100 | 0.033333 | 2021-07-06 | 401766 |  | 5525
15225 | CX.MASTER 06L Nº05(215X165X186) |  |  | 10 | 1546096 | MICROLINE AVULSO-CX/12 VERDE CITRICO | UN | 0.033333 | 0 | 100 | 0.033333 | 2021-07-06 | 401766 |  | 5525
15225 | CX.MASTER 06L Nº05(215X165X186) |  |  | 10 | 1548000 | MICROLINE POTE C/12 | UN | 0.083333 | 0 | 100 | 0.083333 | 2018-11-15 | 2958465 |  | 5525
15225 | CX.MASTER 06L Nº05(215X165X186) |  |  | 10 | 1834001 | CANETA TINTEIRO MOD.01-GOLD BLACK+FRASCO DE TINTEIRO-AZUL | UN | 0.25 | 0 | 100 | 0.25 | 2016-03-29 | 2958465 |  | 5525
15225 | CX.MASTER 06L Nº05(215X165X186) |  |  | 10 | 2018001 | CANETA TINTEIRO SOLO M PRETA-AZUL | UN | 0.033333 | 0 | 100 | 0.033333 | 2018-03-22 | 2958465 |  | 5525
15225 | CX.MASTER 06L Nº05(215X165X186) |  |  | 10 | 2019001 | CANETA TINTEIRO SOLO M VIOLETA-AZUL | UN | 0.033333 | 0 | 100 | 0.033333 | 2024-10-01 | 2958465 |  | 5525
15225 | CX.MASTER 06L Nº05(215X165X186) |  |  | 10 | 2020001 | CANETA TINTEIRO SOLO M BRANCA-AZUL | UN | 0.033333 | 0 | 100 | 0.033333 | 2024-10-01 | 2958465 |  | 5525
15225 | CX.MASTER 06L Nº05(215X165X186) |  |  | 10 | 2106001 | CANETA TINTEIRO SOLO M TAUPE-AZUL | UN | 0.033333 | 0 | 100 | 0.033333 | 2024-10-01 | 2958465 |  | 5525
15225 | CX.MASTER 06L Nº05(215X165X186) |  |  | 10 | 2107001 | CANETA TINTEIRO SOLO M MINT-AZUL | UN | 0.033333 | 0 | 100 | 0.033333 | 2024-10-01 | 2958465 |  | 5525
15225 | CX.MASTER 06L Nº05(215X165X186) |  |  | 10 | 2116001 | CANETA TINTEIRO RAY DEEP BLUE/LIGHT GREY-AZUL | UN | 0.033333 | 0 | 100 | 0.033333 | 2024-10-01 | 2958465 |  | 5525
15225 | CX.MASTER 06L Nº05(215X165X186) |  |  | 10 | 2117001 | CANETA TINTEIRO RAY WHITE/DARK GREY-AZUL | UN | 0.033333 | 0 | 100 | 0.033333 | 2018-03-23 | 2958465 |  | 5525
15225 | CX.MASTER 06L Nº05(215X165X186) |  |  | 10 | 2118001 | ROLLER RAY DEEP BLUE/LIGHT GREY-AZUL | UN | 0.033333 | 0 | 100 | 0.033333 | 2024-10-01 | 2958465 |  | 5525
15225 | CX.MASTER 06L Nº05(215X165X186) |  |  | 10 | 2119001 | ROLLER RAY WHITE/DARK GREY-AZUL | UN | 0.033333 | 0 | 100 | 0.033333 | 2024-10-01 | 2958465 |  | 5525
15225 | CX.MASTER 06L Nº05(215X165X186) |  |  | 10 | 2209001 | CANETA TINTEIRO SOLO M VERDE LIMAO-AZUL | UN | 0.033333 | 0 | 100 | 0.033333 | 2024-10-01 | 2958465 |  | 5525
15225 | CX.MASTER 06L Nº05(215X165X186) |  |  | 10 | 2210001 | CANETA TINTEIRO SOLO M LILÁS-AZUL | UN | 0.033333 | 0 | 100 | 0.033333 | 2024-10-01 | 2958465 |  | 5525
15225 | CX.MASTER 06L Nº05(215X165X186) |  |  | 10 | 2211001 | CANETA TINTEIRO SOLO M VERMELHA-AZUL | UN | 0.033333 | 0 | 100 | 0.033333 | 2024-10-01 | 2958465 |  | 5525
15225 | CX.MASTER 06L Nº05(215X165X186) |  |  | 10 | 2212001 | CANETA TINTEIRO SOLO M GRAFITE-AZUL | UN | 0.033333 | 0 | 100 | 0.033333 | 2024-10-01 | 2958465 |  | 5525
15225 | CX.MASTER 06L Nº05(215X165X186) |  |  | 10 | 2213001 | CANETA TINTEIRO SOLO M BRONZE-AZUL | UN | 0.033333 | 0 | 100 | 0.033333 | 2024-10-01 | 2958465 |  | 5525
15225 | CX.MASTER 06L Nº05(215X165X186) |  |  | 10 | 2214001 | CANETA TINTEIRO SOLO M PRATA-AZUL | UN | 0.033333 | 0 | 100 | 0.033333 | 2024-10-01 | 2958465 |  | 5525
15225 | CX.MASTER 06L Nº05(215X165X186) |  |  | 10 | 2365000 | COLA SILICONE 250 G -DI/12 | UN | 1 | 0 | 100 | 1 | 2022-11-09 | 2958465 |  | 5525
15225 | CX.MASTER 06L Nº05(215X165X186) |  |  | 10 | 2447000 | COLA POLAR ARTE 250 g-CX/12 | UN | 1 | 0 | 100 | 1 | 2020-03-25 | 2958465 |  | 5525
15225 | CX.MASTER 06L Nº05(215X165X186) |  |  | 10 | 2460001 | HIDROGRAFICA COMPACTOR COLOR BRUSH AZUL ESCURO-CX/12 | UN | 0.066667 | 0 | 100 | 0.066667 | 2020-10-29 | 767010 |  | 5525
15225 | CX.MASTER 06L Nº05(215X165X186) |  |  | 10 | 2460002 | HIDROGRAFICA COMPACTOR COLOR BRUSH VERMELHO-CX/12 | UN | 0.066667 | 0 | 100 | 0.066667 | 2020-11-26 | 767010 |  | 5525
15225 | CX.MASTER 06L Nº05(215X165X186) |  |  | 10 | 2460003 | HIDROGRAFICA COMPACTOR COLOR BRUSH VERD.ESC.-CX/12 | UN | 0.066667 | 0 | 100 | 0.066667 | 2020-11-26 | 767010 |  | 5525
15225 | CX.MASTER 06L Nº05(215X165X186) |  |  | 10 | 2460004 | HIDROGRAFICA COMPACTOR COLOR BRUSH PRETO-CX/12 | UN | 0.066667 | 0 | 100 | 0.066667 | 2020-11-26 | 767010 |  | 5525
15225 | CX.MASTER 06L Nº05(215X165X186) |  |  | 10 | 2460005 | HIDROGRAFICA COMPACTOR COLOR BRUSH MARROM-CX/12 | UN | 0.066667 | 0 | 100 | 0.066667 | 2020-11-26 | 767010 |  | 5525
15225 | CX.MASTER 06L Nº05(215X165X186) |  |  | 10 | 2460006 | HIDROGRAFICA COMPACTOR COLOR BRUSH AMARELO-CX/12 | UN | 0.066667 | 0 | 100 | 0.066667 | 2020-11-26 | 767010 |  | 5525
15225 | CX.MASTER 06L Nº05(215X165X186) |  |  | 10 | 2460007 | HIDROGRAFICA COMPACTOR COLOR BRUSH LARANJA-CX/12 | UN | 0.066667 | 0 | 100 | 0.066667 | 2020-11-26 | 767010 |  | 5525
15225 | CX.MASTER 06L Nº05(215X165X186) |  |  | 10 | 2460008 | HIDROGRAFICA COMPACTOR COLOR BRUSH VIOLETA-CX/12 | UN | 0.066667 | 0 | 100 | 0.066667 | 2020-11-26 | 767010 |  | 5525
15225 | CX.MASTER 06L Nº05(215X165X186) |  |  | 10 | 2460010 | HIDROGRAFICA COMPACTOR COLOR BRUSH AZ. CLARO-CX/12 | UN | 0.066667 | 0 | 100 | 0.066667 | 2020-11-26 | 767010 |  | 5525
15225 | CX.MASTER 06L Nº05(215X165X186) |  |  | 10 | 2460011 | HIDROGRAFICA COMPACTOR COLOR BRUSH VD.CLARO-CX/12 | UN | 0.066667 | 0 | 100 | 0.066667 | 2020-11-26 | 767010 |  | 5525
15225 | CX.MASTER 06L Nº05(215X165X186) |  |  | 10 | 2460012 | HIDROGRAFICA COMPACTOR COLOR BRUSH LILAS-CX/12 | UN | 0.066667 | 0 | 100 | 0.066667 | 2020-12-23 | 767010 |  | 5525
15225 | CX.MASTER 06L Nº05(215X165X186) |  |  | 10 | 2460013 | HIDROGRAFICA COMPACTOR COLOR BRUSH CINZA-CX/12 | UN | 0.066667 | 0 | 100 | 0.066667 | 2020-12-23 | 767010 |  | 5525
15225 | CX.MASTER 06L Nº05(215X165X186) |  |  | 10 | 2460014 | HIDROGRAFICA COMPACTOR COLOR BRUSH ROSA-CX/12 | UN | 0.066667 | 0 | 100 | 0.066667 | 2020-11-26 | 767010 |  | 5525
15225 | CX.MASTER 06L Nº05(215X165X186) |  |  | 10 | 2460015 | HIDROGRAFICA COMPACTOR COLOR BRUSH TURQUESA-CX/12 | UN | 0.066667 | 0 | 100 | 0.066667 | 2020-12-23 | 767010 |  | 5525
15225 | CX.MASTER 06L Nº05(215X165X186) |  |  | 10 | 2460021 | HIDROGRAFICA COMPACTOR COLOR BRUSH AMARELO OURO-CX/12 | UN | 0.066667 | 0 | 100 | 0.066667 | 2020-12-23 | 767010 |  | 5525
15225 | CX.MASTER 06L Nº05(215X165X186) |  |  | 10 | 2460026 | HIDROGRAFICA COMPACTOR COLOR BRUSH VERDE OLIVA-CX/12 | UN | 0.066667 | 0 | 100 | 0.066667 | 2020-12-23 | 767010 |  | 5525
15225 | CX.MASTER 06L Nº05(215X165X186) |  |  | 10 | 2460031 | HIDROGRAFICA COMPACTOR COLOR BRUSH AZUL CELESTE-CX/12 | UN | 0.066667 | 0 | 100 | 0.066667 | 2020-12-23 | 767010 |  | 5525
15225 | CX.MASTER 06L Nº05(215X165X186) |  |  | 10 | 2460034 | HIDROGRAFICA COMPACTOR COLOR BRUSH VIOLETA CLARO-CX/12 | UN | 0.066667 | 0 | 100 | 0.066667 | 2020-12-23 | 767010 |  | 5525
15225 | CX.MASTER 06L Nº05(215X165X186) |  |  | 10 | 2460042 | HIDROGRAFICA COMPACTOR COLOR BRUSH MARROM CLARO-CX/12 | UN | 0.066667 | 0 | 100 | 0.066667 | 2020-12-23 | 767010 |  | 5525
15225 | CX.MASTER 06L Nº05(215X165X186) |  |  | 10 | 2460043 | HIDROGRAFICA COMPACTOR COLOR BRUSH LARANJA CLARO-CX/12 | UN | 0.066667 | 0 | 100 | 0.066667 | 2020-12-23 | 767010 |  | 5525
15225 | CX.MASTER 06L Nº05(215X165X186) |  |  | 10 | 2460044 | HIDROGRAFICA COMPACTOR COLOR BRUSH AMARELO CREME-CX/12 | UN | 0.066667 | 0 | 100 | 0.066667 | 2020-12-23 | 767010 |  | 5525
15225 | CX.MASTER 06L Nº05(215X165X186) |  |  | 10 | 2460045 | HIDROGRAFICA COMPACTOR COLOR BRUSH CARMIM-CX/12 | UN | 0.066667 | 0 | 100 | 0.066667 | 2020-12-23 | 767010 |  | 5525
15225 | CX.MASTER 06L Nº05(215X165X186) |  |  | 10 | 2460048 | HIDROGRAFICA COMPACTOR COLOR BRUSH MAGENTA-CX/12 | UN | 0.066667 | 0 | 100 | 0.066667 | 2020-12-23 | 767010 |  | 5525
15225 | CX.MASTER 06L Nº05(215X165X186) |  |  | 10 | 2460050 | HIDROGRAFICA COMPACTOR COLOR BRUSH ROSA PELE-CX/12 | UN | 0.066667 | 0 | 100 | 0.066667 | 2020-12-23 | 767010 |  | 5525
15225 | CX.MASTER 06L Nº05(215X165X186) |  |  | 10 | 2460092 | HIDROGRAFICA COMPACTOR COLOR BRUSH PALHA-CX/12 | UN | 0.066667 | 0 | 100 | 0.066667 | 2020-12-23 | 767010 |  | 5525
15225 | CX.MASTER 06L Nº05(215X165X186) |  |  | 10 | 2460093 | HIDROGRAFICA COMPACTOR COLOR BRUSH LILAS LAVANDA-CX/12 | UN | 0.066667 | 0 | 100 | 0.066667 | 2020-12-23 | 767010 |  | 5525
15225 | CX.MASTER 06L Nº05(215X165X186) |  |  | 10 | 2460094 | HIDROGRAFICA COMPACTOR COLOR BRUSH AMARELO LIMAO-CX/12 | UN | 0.066667 | 0 | 100 | 0.066667 | 2020-12-23 | 767010 |  | 5525
15225 | CX.MASTER 06L Nº05(215X165X186) |  |  | 10 | 2460095 | HIDROGRAFICA COMPACTOR COLOR BRUSH MARROM OCRE-CX/12 | UN | 0.066667 | 0 | 100 | 0.066667 | 2020-12-23 | 767010 |  | 5525
15225 | CX.MASTER 06L Nº05(215X165X186) |  |  | 10 | 2460096 | HIDROGRAFICA COMPACTOR COLOR BRUSH VERDE CITRICO-CX/12 | UN | 0.066667 | 0 | 100 | 0.066667 | 2020-12-23 | 767010 |  | 5525
15225 | CX.MASTER 06L Nº05(215X165X186) |  |  | 10 | 2460097 | HIDROGRAFICA COMPACTOR COLOR BRUSH OCRE-CX/12 | UN | 0.066667 | 0 | 100 | 0.066667 | 2020-12-23 | 767010 |  | 5525
15225 | CX.MASTER 06L Nº05(215X165X186) |  |  | 10 | 2460098 | HIDROGRAFICA COMPACTOR COLOR BRUSH VERDE LIMAO-CX/12 | UN | 0.066667 | 0 | 100 | 0.066667 | 2020-12-23 | 767010 |  | 5525
15225 | CX.MASTER 06L Nº05(215X165X186) |  |  | 10 | 2460099 | HIDROGRAFICA COMPACTOR COLOR BRUSH AZUL COBALTO-CX/12 | UN | 0.066667 | 0 | 100 | 0.066667 | 2020-12-23 | 767010 |  | 5525
15225 | CX.MASTER 06L Nº05(215X165X186) |  |  | 10 | 2460100 | HIDROGRAFICA COMPACTOR COLOR BRUSH CORAL-CX/12 | UN | 0.066667 | 0 | 100 | 0.066667 | 2020-12-23 | 767010 |  | 5525
15225 | CX.MASTER 06L Nº05(215X165X186) |  |  | 10 | 2460101 | HIDROGRAFICA COMPACTOR COLOR BRUSH ROSA SECO-CX/12 | UN | 0.066667 | 0 | 100 | 0.066667 | 2020-12-23 | 767010 |  | 5525
15225 | CX.MASTER 06L Nº05(215X165X186) |  |  | 10 | 2460102 | HIDROGRAFICA COMPACTOR COLOR BRUSH VERMELHO GRENA-CX/12 | UN | 0.066667 | 0 | 100 | 0.066667 | 2020-12-23 | 767010 |  | 5525
15225 | CX.MASTER 06L Nº05(215X165X186) |  |  | 10 | 2460103 | HIDROGRAFICA COMPACTOR COLOR BRUSH CINZA PRATA-CX/12 | UN | 0.066667 | 0 | 100 | 0.066667 | 2020-12-23 | 767010 |  | 5525
15225 | CX.MASTER 06L Nº05(215X165X186) |  |  | 10 | 2745000 | MICROLINE POTE C/20 | UN | 0.083333 | 0 | 100 | 0.083333 | 2021-10-20 | 2958465 |  | 5525
15225 | CX.MASTER 06L Nº05(215X165X186) |  |  | 10 | 2790001 | CANETA TINTEIRO CEOD SHINY POWDER PINK M -AZUL | UN | 0.033333 | 0 | 100 | 0.033333 | 2024-10-01 | 2958465 |  | 5525
15225 | CX.MASTER 06L Nº05(215X165X186) |  |  | 10 | 2791001 | CANETA TINTEIRO CEOD SHINY GRAPHITE M -AZUL | UN | 0.033333 | 0 | 100 | 0.033333 | 2024-10-01 | 2958465 |  | 5525
15225 | CX.MASTER 06L Nº05(215X165X186) |  |  | 10 | 2792001 | CANETA TINTEIRO CEOD SHINY BLUE M -AZUL | UN | 0.033333 | 0 | 100 | 0.033333 | 2024-10-01 | 2958465 |  | 5525
15225 | CX.MASTER 06L Nº05(215X165X186) |  |  | 10 | 2793001 | CANETA TINTEIRO CEOD SHINY LIGHT GOLD M -AZUL | UN | 0.033333 | 0 | 100 | 0.033333 | 2024-10-01 | 2958465 |  | 5525
15225 | CX.MASTER 06L Nº05(215X165X186) |  |  | 10 | 2794001 | CANETA TINTEIRO CEOD SHINY BRONZE GOLD M -AZUL | UN | 0.033333 | 0 | 100 | 0.033333 | 2024-10-01 | 2958465 |  | 5525
15225 | CX.MASTER 06L Nº05(215X165X186) |  |  | 10 | 2795001 | ROLLER CEOD SHINY POWDER PINK - AZUL | UN | 0.033333 | 0 | 100 | 0.033333 | 2024-10-01 | 2958465 |  | 5525
15225 | CX.MASTER 06L Nº05(215X165X186) |  |  | 10 | 2796001 | ROLLER CEOD SHINY GRAPHITE - AZUL | UN | 0.033333 | 0 | 100 | 0.033333 | 2024-10-01 | 2958465 |  | 5525
15225 | CX.MASTER 06L Nº05(215X165X186) |  |  | 10 | 2797001 | ROLLER CEOD SHINY BLUE - AZUL | UN | 0.033333 | 0 | 100 | 0.033333 | 2024-10-01 | 2958465 |  | 5525
15225 | CX.MASTER 06L Nº05(215X165X186) |  |  | 10 | 2798001 | ROLLER CEOD SHINY LIGHT GOLD - AZUL | UN | 0.033333 | 0 | 100 | 0.033333 | 2024-10-01 | 2958465 |  | 5525
15225 | CX.MASTER 06L Nº05(215X165X186) |  |  | 10 | 2799001 | ROLLER CEOD SHINY BRONZE - AZUL | UN | 0.033333 | 0 | 100 | 0.033333 | 2024-10-01 | 2958465 |  | 5525
15225 | CX.MASTER 06L Nº05(215X165X186) |  |  | 10 | 2800001 | CANETA TINTEIRO SOLO PINK M -AZUL | UN | 0.033333 | 0 | 100 | 0.033333 | 2024-10-01 | 2958465 |  | 5525
15225 | CX.MASTER 06L Nº05(215X165X186) |  |  | 10 | 2801001 | CANETA TINTEIRO SOLO TURQUOISE M -AZUL | UN | 0.033333 | 0 | 100 | 0.033333 | 2024-10-01 | 2958465 |  | 5525
15225 | CX.MASTER 06L Nº05(215X165X186) |  |  | 10 | 2985080 | MICROLINE ART COLOR AVULSO-CX/12 LARANJA PASTEL 588 | UN | 0.033333 | 0 | 100 | 0.033333 | 2024-03-15 | 2958465 |  | 5525
15225 | CX.MASTER 06L Nº05(215X165X186) |  |  | 10 | 2985081 | MICROLINE ART COLOR AVULSO-CX/12 AMARELO PASTEL 590 | UN | 0.033333 | 0 | 100 | 0.033333 | 2024-03-15 | 2958465 |  | 5525
15225 | CX.MASTER 06L Nº05(215X165X186) |  |  | 10 | 2985082 | MICROLINE ART COLOR AVULSO-CX/12 AZUL PASTEL 592 | UN | 0.033333 | 0 | 100 | 0.033333 | 2024-03-15 | 2958465 |  | 5525
15225 | CX.MASTER 06L Nº05(215X165X186) |  |  | 10 | 2985084 | MICROLINE ART COLOR AVULSO-CX/12 LILAS PASTEL 522 | UN | 0.033333 | 0 | 100 | 0.033333 | 2024-03-15 | 2958465 |  | 5525
15225 | CX.MASTER 06L Nº05(215X165X186) |  |  | 10 | 2985085 | MICROLINE ART COLOR AVULSO-CX/12 ROSA PASTEL 593 | UN | 0.033333 | 0 | 100 | 0.033333 | 2024-03-15 | 2958465 |  | 5525
15225 | CX.MASTER 06L Nº05(215X165X186) |  |  | 10 | 2985086 | MICROLINE ART COLOR AVULSO-CX/12 AZUL PASTEL 532 | UN | 0.033333 | 0 | 100 | 0.033333 | 2024-03-15 | 2958465 |  | 5525
15225 | CX.MASTER 06L Nº05(215X165X186) |  |  | 10 | 2985088 | MICROLINE ART COLOR AVULSO-CX/12 AMARELO PASTEL 589 | UN | 0.033333 | 0 | 100 | 0.033333 | 2024-03-15 | 2958465 |  | 5525
15225 | CX.MASTER 06L Nº05(215X165X186) |  |  | 10 | 2985089 | MICROLINE ART COLOR AVULSO-CX/12 VERDE PASTEL 591 | UN | 0.033333 | 0 | 100 | 0.033333 | 2024-03-15 | 2958465 |  | 5525
15225 | CX.MASTER 06L Nº05(215X165X186) |  |  | 10 | 513 | MARCADOR BRILLANT+1CARTUCHO-BL/1 | UN | 0.05 | 0 | 100 | 0.05 | 2009-08-27 | 2958465 |  | 5525
15225 | CX.MASTER 06L Nº05(215X165X186) |  |  | 100 | 32907 | MARCADOR ESPECIAL - AZUL | UN | 0.01 | 0 | 100 | 0.01 | 2019-04-01 | 401766 |  | 5525
15225 | CX.MASTER 06L Nº05(215X165X186) |  |  | 100 | 32908 | MARCADOR ESPECIAL - VERMELHO | UN | 0.01 | 0 | 100 | 0.01 | 2019-04-01 | 401766 |  | 5525
15225 | CX.MASTER 06L Nº05(215X165X186) |  |  | 10 | 34252 | MARCADOR ESPECIAL - PRETO | UN | 0.01 | 0 | 100 | 0.01 | 2023-02-01 | 2958465 |  | 5525
15225 | CX.MASTER 06L Nº05(215X165X186) |  |  | 10 | B001394001 | CANETA TINTEIRO SOLO M GRAVADA-AZUL | UN | 0.033333 | 0 | 100 | 0.033333 | 2024-10-01 | 2958465 |  | 5525
15225 | CX.MASTER 06L Nº05(215X165X186) |  |  | 10 | B001674001 | ESFEROGRAFICA SLIDER MEMO XB GRAVADA-AZUL | UN | 0.002 | 0 | 100 | 0.002 | 2018-09-12 | 401658 |  | 5525
15225 | CX.MASTER 06L Nº05(215X165X186) |  |  | 10 | B001772001 | ESFEROGRAFICA SLIDER RAVE XB GRAVADA-AZUL | UN | 0.002 | 0 | 100 | 0.002 | 2018-09-12 | 401658 |  | 5525
15225 | CX.MASTER 06L Nº05(215X165X186) |  |  | 10 | B002101001 | ESFEROGRAFICA SLIDER EDGE XB PRETA GRAVADA -AZUL | UN | 0.002 | 0 | 100 | 0.002 | 2018-09-12 | 401658 |  | 5525
15225 | CX.MASTER 06L Nº05(215X165X186) |  |  | 10 | B002243001 | ESFEROGRAFICA SLIDER TOUCH PRETA E BRANCA GRAVADA -AZUL | UN | 0.002 | 0 | 100 | 0.002 | 2018-09-12 | 401658 |  | 5525
15225 | CX.MASTER 06L Nº05(215X165X186) |  |  | 10 | B002256001 | ESFEROGRAFICA SLIDER EDGE XB PRETA E BRANCA GRAVADA-AZUL | UN | 0.002 | 0 | 100 | 0.002 | 2018-09-12 | 401658 |  | 5525
15225 | CX.MASTER 06L Nº05(215X165X186) |  |  | 10 | B002270001 | ESFEROGRAFICA SLIDER MEMO XB PRETA GRAVADA-AZUL | UN | 0.002 | 0 | 100 | 0.002 | 2018-09-12 | 401658 |  | 5525
15225 | CX.MASTER 06L Nº05(215X165X186) |  |  | 10 | B002271001 | ESFEROGRAFICA SLIDER RAVE XB PRETA GRAVADA-AZUL | UN | 0.002 | 0 | 100 | 0.002 | 2018-09-12 | 401658 |  | 5525
15225 | CX.MASTER 06L Nº05(215X165X186) |  |  | 10 | B002468000 | ESFEROGRAFICA TAKE 4 GRAVADA AZUL ESCURO | UN | 0.02 | 0 | 100 | 0.02 | 2022-09-19 | 2958465 |  | 5525
15225 | CX.MASTER 06L Nº05(215X165X186) |  |  | 10 | B002470000 | ESFEROGRAFICA TAKE 4 GRAVADA BRANCO | UN | 0.02 | 0 | 100 | 0.02 | 2022-08-19 | 2958465 |  | 5525
15225 | CX.MASTER 06L Nº05(215X165X186) |  |  | 10 | B003332000 | ESFEROGRAFICA TAKE 4 GRAVADA LILAS | UN | 0.02 | 0 | 100 | 0.02 | 2024-12-16 | 2958465 |  | 5525
15225 | CX.MASTER 06L Nº05(215X165X186) |  |  | 10 | B00594 | ESFEROGRAFICA ICY | UN | 0.002 | 0 | 100 | 0.002 | 2018-09-12 | 401658 |  | 5525
15225 | CX.MASTER 06L Nº05(215X165X186) |  |  | 10 | B01247 | ESFEROGRAFICA DESIGNA GRAVADA | UN | 0.002 | 0 | 100 | 0.002 | 2018-09-12 | 401658 |  | 5525
15225 | CX.MASTER 06L Nº05(215X165X186) |  |  | 10 | I001394001 | CANETA TINTEIRO(i) SOLO M -AZUL | UN | 0.033333 | 0 | 100 | 0.033333 | 2024-10-01 | 2958465 |  | 5525
15225 | CX.MASTER 06L Nº05(215X165X186) |  |  | 10 | I001772001 | ESFEROGRAFICA(i) SLIDER RAVE XB -AZUL | UN | 0.002 | 0 | 100 | 0.002 | 2022-05-19 | 401766 |  | 5525
15225 | CX.MASTER 06L Nº05(215X165X186) |  |  | 10 | I002086001 | ESFEROGRAFICA LOOX(i) AMARELA TRANSLUCIDA -AZUL | UN | 0.002 | 0 | 100 | 0.002 | 2022-05-25 | 2958465 |  | 5525
15225 | CX.MASTER 06L Nº05(215X165X186) |  |  | 10 | I002087001 | ESFEROGRAFICA LOOX(i) VERMELHA TRANSLUCIDA -AZUL | UN | 0.002 | 0 | 100 | 0.002 | 2022-05-25 | 2958465 |  | 5525
15225 | CX.MASTER 06L Nº05(215X165X186) |  |  | 10 | I002088001 | ESFEROGRAFICA LOOX(i) AZUL TRANSLUCIDA -AZUL | UN | 0.002 | 0 | 100 | 0.002 | 2022-05-25 | 2958465 |  | 5525
15225 | CX.MASTER 06L Nº05(215X165X186) |  |  | 10 | I002256001 | ESFEROGRAFICA(i) SLIDER EDGE XB PRETA E BRANCA -AZUL | UN | 0.002 | 0 | 100 | 0.002 | 2022-05-25 | 401658 |  | 5525
15225 | CX.MASTER 06L Nº05(215X165X186) |  |  | 10 | I002271001 | ESFEROGRAFICA(i) SLIDER RAVE XB PRETA -AZUL | UN | 0.002 | 0 | 100 | 0.002 | 2022-05-19 | 401766 |  | 5525
15225 | CX.MASTER 06L Nº05(215X165X186) |  |  | 10 | I002468000 | ESFEROGRAFICA(i) TAKE 4 AZUL ESCURO | UN | 0.02 | 0 | 100 | 0.02 | 2022-11-24 | 2958465 |  | 5525
15225 | CX.MASTER 06L Nº05(215X165X186) |  |  | 10 | I002470000 | ESFEROGRAFICA(i) TAKE 4 BRANCO | UN | 0.02 | 0 | 100 | 0.02 | 2022-11-24 | 2958465 |  | 5525
15225 | CX.MASTER 06L Nº05(215X165X186) |  |  | 10 | I003332000 | ESFEROGRAFICA(i) TAKE 4 LILAS | UN | 0.02 | 0 | 100 | 0.02 | 2024-12-16 | 2958465 |  | 5525
15225 | CX.MASTER 06L Nº05(215X165X186) |  |  | 10 | I00594 | ESFEROGRAFICA ICY(i) | UN | 0.002 | 0 | 100 | 0.002 | 2022-05-25 | 401658 |  | 5525
15225 | CX.MASTER 06L Nº05(215X165X186) |  |  | 10 | R000085001 | HIDROGRAFICA COMPACTOR COLOR AVULSO-DZ AZUL (CRR) | UN | 0.066667 | 0 | 100 | 0.066667 | 2021-07-26 | 767010 |  | 5525
15225 | CX.MASTER 06L Nº05(215X165X186) |  |  | 10 | R000085002 | HIDROGRAFICA COMPACTOR COLOR AVULSO-DZ VERMELHO (CRR) | UN | 0.066667 | 0 | 100 | 0.066667 | 2017-12-15 | 2958465 |  | 5525
15225 | CX.MASTER 06L Nº05(215X165X186) |  |  | 10 | R000085003 | HIDROGRAFICA COMPACTOR COLOR AVULSO-DZ VERDE (CRR) | UN | 0.066667 | 0 | 100 | 0.066667 | 2022-06-29 | 2958465 |  | 5525
15225 | CX.MASTER 06L Nº05(215X165X186) |  |  | 10 | R000085004 | HIDROGRAFICA COMPACTOR COLOR AVULSO-DZ PRETA (CRR) | UN | 0.066667 | 0 | 100 | 0.066667 | 2021-07-26 | 767010 |  | 5525
15225 | CX.MASTER 06L Nº05(215X165X186) |  |  | 10 | R000085008 | HIDROGRAFICA COMPACTOR COLOR AVULSO-DZ VIOLETA (CRR) | UN | 0.066667 | 0 | 100 | 0.066667 | 2018-07-01 | 401766 |  | 5525
15225 | CX.MASTER 06L Nº05(215X165X186) |  |  | 10 | R000085010 | HIDROGRAFICA COMPACTOR COLOR AVULSO-DZ AZ.CLARO (CRR) | UN | 0.066667 | 0 | 100 | 0.066667 | 2018-07-01 | 401766 |  | 5525
15225 | CX.MASTER 06L Nº05(215X165X186) |  |  | 10 | R000085011 | HIDROGRAFICA COMPACTOR COLOR AVULSO-DZ VER.CLARO (CRR) | UN | 0.066667 | 0 | 100 | 0.066667 | 2018-07-01 | 401766 |  | 5525
15225 | CX.MASTER 06L Nº05(215X165X186) |  |  | 10 | R000085013 | HIDROGRAFICA COMPACTOR COLOR AVULSO-DZ CINZA (CRR) | UN | 0.066667 | 0 | 100 | 0.066667 | 2018-07-01 | 401766 |  | 5525
15225 | CX.MASTER 06L Nº05(215X165X186) |  |  | 10 | R000085014 | HIDROGRAFICA COMPACTOR COLOR AVULSO-DZ ROSA (CRR) | UN | 0.066667 | 0 | 100 | 0.066667 | 2018-07-01 | 401766 |  | 5525
15225 | CX.MASTER 06L Nº05(215X165X186) |  |  | 40 | R001546002 | MICROLINE AVULSO-CX/12 VERMELHA (CRR) | UN | 0.033333 | 0 | 100 | 0.033333 | 2018-07-01 | 401766 |  | 5525
15225 | CX.MASTER 06L Nº05(215X165X186) |  |  | 30 | R001546003 | MICROLINE AVULSO-CX/12 VERDE (CRR) | UN | 0.033333 | 0 | 100 | 0.033333 | 2018-07-01 | 401766 |  | 5525
15225 | CX.MASTER 06L Nº05(215X165X186) |  |  | 10 | R001546005 | MICROLINE AVULSO-CX/12 MARROM (CRR) | UN | 0.033333 | 0 | 100 | 0.033333 | 2018-07-01 | 401766 |  | 5525
15225 | CX.MASTER 06L Nº05(215X165X186) |  |  | 10 | R001546006 | MICROLINE AVULSO-CX/12 AMARELO (CRR) | UN | 0.033333 | 0 | 100 | 0.033333 | 2020-11-27 | 2958465 |  | 5525
15225 | CX.MASTER 06L Nº05(215X165X186) |  |  | 10 | R001546007 | MICROLINE AVULSO-CX/12 LARANJA (CRR) | UN | 0.033333 | 0 | 100 | 0.033333 | 2018-07-01 | 401766 |  | 5525
15225 | CX.MASTER 06L Nº05(215X165X186) |  |  | 10 | R001546008 | MICROLINE AVULSO-CX/12 VIOLETA (CRR) | UN | 0.033333 | 0 | 100 | 0.033333 | 2018-07-01 | 401766 |  | 5525
15225 | CX.MASTER 06L Nº05(215X165X186) |  |  | 10 | R001546010 | MICROLINE AVULSO-CX/12 AZUL CLARO (CRR) | UN | 0.033333 | 0 | 100 | 0.033333 | 2018-07-01 | 401766 |  | 5525
15225 | CX.MASTER 06L Nº05(215X165X186) |  |  | 10 | R001546014 | MICROLINE AVULSO-CX/12 ROSA (CRR) | UN | 0.033333 | 0 | 100 | 0.033333 | 2018-07-01 | 401766 |  | 5525
15225 | CX.MASTER 06L Nº05(215X165X186) |  |  | 10 | R001548000 | MICROLINE ESTOJO C/12 (CRR) | UN | 0.083333 | 0 | 100 | 0.083333 | 2019-01-01 | 401768 |  | 5525
15225 | CX.MASTER 06L Nº05(215X165X186) |  |  | 10 | R002460001 | HIDROGRAFICA COMPACTOR COLOR BRUSH AZUL ESCURO-CX/12 (CRR) | Un | 0.066667 | 0 | 100 | 0.066667 | 2023-04-10 | 2958465 |  | 5525
15225 | CX.MASTER 06L Nº05(215X165X186) |  |  | 10 | R002460002 | HIDROGRAFICA COMPACTOR COLOR BRUSH VERMELHO-CX/12 (CRR) | Un | 0.066667 | 0 | 100 | 0.066667 | 2023-04-10 | 2958465 |  | 5525
15225 | CX.MASTER 06L Nº05(215X165X186) |  |  | 10 | R002460003 | HIDROGRAFICA COMPACTOR COLOR BRUSH VERD.ESCURO-CX/12 (CRR) | Un | 0.066667 | 0 | 100 | 0.066667 | 2023-04-10 | 2958465 |  | 5525
15225 | CX.MASTER 06L Nº05(215X165X186) |  |  | 10 | R002460004 | HIDROGRAFICA COMPACTOR COLOR BRUSH PRETO-CX/12 (CRR) | Un | 0.066667 | 0 | 100 | 0.066667 | 2023-04-10 | 2958465 |  | 5525
15225 | CX.MASTER 06L Nº05(215X165X186) |  |  | 10 | R002460005 | HIDROGRAFICA COMPACTOR COLOR BRUSH MARROM-CX/12 (CRR) | Un | 0.066667 | 0 | 100 | 0.066667 | 2023-04-10 | 2958465 |  | 5525
15225 | CX.MASTER 06L Nº05(215X165X186) |  |  | 10 | R002460006 | HIDROGRAFICA COMPACTOR COLOR BRUSH AMARELO-CX/12 (CRR) | Un | 0.066667 | 0 | 100 | 0.066667 | 2023-04-10 | 2958465 |  | 5525
15225 | CX.MASTER 06L Nº05(215X165X186) |  |  | 10 | R002460007 | HIDROGRAFICA COMPACTOR COLOR BRUSH LARANJA-CX/12 (CRR) | Un | 0.066667 | 0 | 100 | 0.066667 | 2023-04-10 | 2958465 |  | 5525
15225 | CX.MASTER 06L Nº05(215X165X186) |  |  | 10 | R002460008 | HIDROGRAFICA COMPACTOR COLOR BRUSH VIOLETA-CX/12 (CRR) | Un | 0.066667 | 0 | 100 | 0.066667 | 2023-04-10 | 2958465 |  | 5525
15225 | CX.MASTER 06L Nº05(215X165X186) |  |  | 10 | R002460010 | HIDROGRAFICA COMPACTOR COLOR BRUSH AZ. CLARO-CX/12 (CRR) | Un | 0.066667 | 0 | 100 | 0.066667 | 2023-04-10 | 2958465 |  | 5525
15225 | CX.MASTER 06L Nº05(215X165X186) |  |  | 10 | R002460011 | HIDROGRAFICA COMPACTOR COLOR BRUSH VD.CLARO-CX/12 (CRR) | Un | 0.066667 | 0 | 100 | 0.066667 | 2023-04-10 | 2958465 |  | 5525
15225 | CX.MASTER 06L Nº05(215X165X186) |  |  | 10 | R002460012 | HIDROGRAFICA COMPACTOR COLOR BRUSH LILAS-CX/12 (CRR) | Un | 0.066667 | 0 | 100 | 0.066667 | 2023-04-10 | 2958465 |  | 5525
15225 | CX.MASTER 06L Nº05(215X165X186) |  |  | 10 | R002460013 | HIDROGRAFICA COMPACTOR COLOR BRUSH CINZA-CX/12 (CRR) | Un | 0.066667 | 0 | 100 | 0.066667 | 2023-04-10 | 2958465 |  | 5525
15225 | CX.MASTER 06L Nº05(215X165X186) |  |  | 10 | R002460014 | HIDROGRAFICA COMPACTOR COLOR BRUSH ROSA-CX/12 (CRR) | Un | 0.066667 | 0 | 100 | 0.066667 | 2023-04-10 | 2958465 |  | 5525
15225 | CX.MASTER 06L Nº05(215X165X186) |  |  | 10 | R002460015 | HIDROGRAFICA COMPACTOR COLOR BRUSH TURQUESA-CX/12 (CRR) | Un | 0.066667 | 0 | 100 | 0.066667 | 2023-04-10 | 2958465 |  | 5525
15225 | CX.MASTER 06L Nº05(215X165X186) |  |  | 10 | R002460021 | HIDROGRAFICA COMPACTOR COLOR BRUSH AMARELO OURO-CX/12 (CRR) | Un | 0.066667 | 0 | 100 | 0.066667 | 2023-04-10 | 2958465 |  | 5525
15225 | CX.MASTER 06L Nº05(215X165X186) |  |  | 10 | R002460026 | HIDROGRAFICA COMPACTOR COLOR BRUSH VERDE OLIVA-CX/12 (CRR) | Un | 0.066667 | 0 | 100 | 0.066667 | 2023-04-10 | 2958465 |  | 5525
15225 | CX.MASTER 06L Nº05(215X165X186) |  |  | 10 | R002460031 | HIDROGRAFICA COMPACTOR COLOR BRUSH AZUL CELESTE-CX/12 (CRR) | Un | 0.066667 | 0 | 100 | 0.066667 | 2023-04-10 | 2958465 |  | 5525
15225 | CX.MASTER 06L Nº05(215X165X186) |  |  | 10 | R002460034 | HIDROGRAFICA COMPACTOR COLOR BRUSH VIOLETA CLARO-CX/12 (CRR) | Un | 0.066667 | 0 | 100 | 0.066667 | 2023-04-10 | 2958465 |  | 5525
15225 | CX.MASTER 06L Nº05(215X165X186) |  |  | 10 | R002460042 | HIDROGRAFICA COMPACTOR COLOR BRUSH MARROM CLARO-CX/12 (CRR) | Un | 0.066667 | 0 | 100 | 0.066667 | 2023-04-10 | 2958465 |  | 5525
15225 | CX.MASTER 06L Nº05(215X165X186) |  |  | 10 | R002460043 | HIDROGRAFICA COMPACTOR COLOR BRUSH LARANJA CLARO-CX/12 (CRR) | Un | 0.066667 | 0 | 100 | 0.066667 | 2023-04-10 | 2958465 |  | 5525
15225 | CX.MASTER 06L Nº05(215X165X186) |  |  | 10 | R002460044 | HIDROGRAFICA COMPACTOR COLOR BRUSH AMARELO CREME-CX/12 (CRR) | Un | 0.066667 | 0 | 100 | 0.066667 | 2023-04-10 | 2958465 |  | 5525
15225 | CX.MASTER 06L Nº05(215X165X186) |  |  | 10 | R002460045 | HIDROGRAFICA COMPACTOR COLOR BRUSH CARMIM-CX/12 (CRR) | Un | 0.066667 | 0 | 100 | 0.066667 | 2023-04-10 | 2958465 |  | 5525
15225 | CX.MASTER 06L Nº05(215X165X186) |  |  | 10 | R002460048 | HIDROGRAFICA COMPACTOR COLOR BRUSH MAGENTA-CX/12 (CRR) | Un | 0.066667 | 0 | 100 | 0.066667 | 2023-04-10 | 2958465 |  | 5525
15225 | CX.MASTER 06L Nº05(215X165X186) |  |  | 10 | R002460050 | HIDROGRAFICA COMPACTOR COLOR BRUSH ROSA PELE-CX/12 (CRR) | Un | 0.066667 | 0 | 100 | 0.066667 | 2023-04-10 | 2958465 |  | 5525
15225 | CX.MASTER 06L Nº05(215X165X186) |  |  | 10 | R002460092 | HIDROGRAFICA COMPACTOR COLOR BRUSH PALHA-CX/12 (CRR) | Un | 0.066667 | 0 | 100 | 0.066667 | 2023-04-10 | 2958465 |  | 5525
15225 | CX.MASTER 06L Nº05(215X165X186) |  |  | 10 | R002460093 | HIDROGRAFICA COMPACTOR COLOR BRUSH LILAS LAVANDA-CX/12 (CRR) | Un | 0.066667 | 0 | 100 | 0.066667 | 2023-04-10 | 2958465 |  | 5525
15225 | CX.MASTER 06L Nº05(215X165X186) |  |  | 10 | R002460094 | HIDROGRAFICA COMPACTOR COLOR BRUSH AMARELO LIMAO-CX/12 (CRR) | Un | 0.066667 | 0 | 100 | 0.066667 | 2023-04-10 | 2958465 |  | 5525
15225 | CX.MASTER 06L Nº05(215X165X186) |  |  | 10 | R002460095 | HIDROGRAFICA COMPACTOR COLOR BRUSH MARROM OCRE-CX/12 (CRR) | Un | 0.066667 | 0 | 100 | 0.066667 | 2023-04-10 | 2958465 |  | 5525
15225 | CX.MASTER 06L Nº05(215X165X186) |  |  | 10 | R002460096 | HIDROGRAFICA COMPACTOR COLOR BRUSH VERDE CITRICO-CX/12 (CRR) | Un | 0.066667 | 0 | 100 | 0.066667 | 2023-04-10 | 2958465 |  | 5525
15225 | CX.MASTER 06L Nº05(215X165X186) |  |  | 10 | R002460097 | HIDROGRAFICA COMPACTOR COLOR BRUSH OCRE-CX/12 (CRR) | Un | 0.066667 | 0 | 100 | 0.066667 | 2023-04-10 | 2958465 |  | 5525
15225 | CX.MASTER 06L Nº05(215X165X186) |  |  | 10 | R002460098 | HIDROGRAFICA COMPACTOR COLOR BRUSH VERDE LIMAO-CX/12 (CRR) | Un | 0.066667 | 0 | 100 | 0.066667 | 2023-04-10 | 2958465 |  | 5525
15225 | CX.MASTER 06L Nº05(215X165X186) |  |  | 10 | R002460099 | HIDROGRAFICA COMPACTOR COLOR BRUSH AZUL COBALTO-CX/12 (CRR) | Un | 0.066667 | 0 | 100 | 0.066667 | 2023-04-10 | 2958465 |  | 5525
15225 | CX.MASTER 06L Nº05(215X165X186) |  |  | 10 | R002460100 | HIDROGRAFICA COMPACTOR COLOR BRUSH CORAL-CX/12 (CRR) | Un | 0.066667 | 0 | 100 | 0.066667 | 2023-04-10 | 2958465 |  | 5525
15225 | CX.MASTER 06L Nº05(215X165X186) |  |  | 10 | R002460101 | HIDROGRAFICA COMPACTOR COLOR BRUSH ROSA SECO-CX/12 (CRR) | Un | 0.066667 | 0 | 100 | 0.066667 | 2023-04-10 | 2958465 |  | 5525
15225 | CX.MASTER 06L Nº05(215X165X186) |  |  | 10 | R002460102 | HIDROGRAFICA COMPACTOR COLOR BRUSH VERMELHO GRENA-CX/12(CRR) | Un | 0.066667 | 0 | 100 | 0.066667 | 2023-04-10 | 2958465 |  | 5525
15225 | CX.MASTER 06L Nº05(215X165X186) |  |  | 10 | R002460103 | HIDROGRAFICA COMPACTOR COLOR BRUSH CINZA PRATA-CX/12 (CRR) | Un | 0.066667 | 0 | 100 | 0.066667 | 2023-04-10 | 2958465 |  | 5525
15226 | CX.MASTER 10L Nº15(310X220X160) | UN |  | 10 | 912000 | COLA POLAR ISOPOR 500 g-CX/12 | UN | 1 | 0 | 100 | 1 | 2020-05-30 | 767010 |  | 729
15231 | CX.MASTER 37L Nº26(395X355X270) | UN |  | 10 | 1200000 | COLA POLAR MADEIRA 90 g-DI/12 | UN | 0.083333 | 0 | 100 | 0.083333 | 2020-06-15 | 767010 |  | 153
15231 | CX.MASTER 37L Nº26(395X355X270) |  |  | 10 | 2602000 | COLA POLAR BRANCA 90g(GALINHA PINTADINHA)-DI/12 | UN | 0.083333 | 0 | 100 | 0.083333 | 2021-06-08 | 767010 |  | 153
15231 | CX.MASTER 37L Nº26(395X355X270) |  |  | 10 | 2826000 | COLA DE SILICONE 90g -DI/12 | UN | 0.083333 | 0 | 100 | 0.083333 | 2022-08-24 | 2958465 |  | 153
15231 | CX.MASTER 37L Nº26(395X355X270) |  |  | 10 | B001404000 | TRI PEN METALIC PRATA-DOURADA - GRAVADA | UN | 0.010417 | 0 | 100 | 0.010417 | 2019-02-01 | 2958465 |  | 153
15231 | CX.MASTER 37L Nº26(395X355X270) |  |  | 10 | B001615001 | ESFEROGRAFICA COMPACTOR SMART GRAVADA--AZUL | UN | 0.010417 | 0 | 100 | 0.010417 | 2019-03-19 | 2958465 |  | 153
15231 | CX.MASTER 37L Nº26(395X355X270) |  |  | 10 | B002001000 | TRI PEN METALIC PRETA GRAVADA | UN | 0.010417 | 0 | 100 | 0.010417 | 2018-03-23 | 2958465 |  | 153
15231 | CX.MASTER 37L Nº26(395X355X270) |  |  | 10 | B002003001 | ESFEROGRAFICA COMPACTOR SMART PRATA GRAVADA-AZUL | UN | 0.010417 | 0 | 100 | 0.010417 | 2019-03-19 | 2958465 |  | 153
15231 | CX.MASTER 37L Nº26(395X355X270) |  |  | 10 | B002018001 | CANETA TINTEIRO SOLO M PRETA GRAVADA-AZUL | UN | 0.010417 | 0 | 100 | 0.010417 | 2019-03-19 | 2958465 |  | 153
15231 | CX.MASTER 37L Nº26(395X355X270) |  |  | 10 | B002019001 | CANETA TINTEIRO SOLO M VIOLETA GRAVADA- AZUL | UN | 0.010417 | 0 | 100 | 0.010417 | 2019-03-19 | 2958465 |  | 153
15231 | CX.MASTER 37L Nº26(395X355X270) |  |  | 10 | B002020001 | CANETA TINTEIRO SOLO M BRANCA GRAVADA- AZUL | UN | 0.010417 | 0 | 100 | 0.010417 | 2019-03-19 | 2958465 |  | 153
15231 | CX.MASTER 37L Nº26(395X355X270) |  |  | 10 | B002106001 | CANETA TINTEIRO SOLO M TAUPE GRAVADA-AZUL | UN | 0.010417 | 0 | 100 | 0.010417 | 2019-03-19 | 2958465 |  | 153
15231 | CX.MASTER 37L Nº26(395X355X270) |  |  | 10 | B002107001 | CANETA TINTEIRO SOLO M MINT GRAVADA-AZUL | UN | 0.010417 | 0 | 100 | 0.010417 | 2019-03-19 | 2958465 |  | 153
15231 | CX.MASTER 37L Nº26(395X355X270) |  |  | 10 | B002116001 | CANETA TINTEIRO RAY DEEP BLUE/LIGHT GREY GRAVADA-AZUL | UN | 0.010417 | 0 | 100 | 0.010417 | 2019-03-19 | 2958465 |  | 153
15231 | CX.MASTER 37L Nº26(395X355X270) |  |  | 10 | B002117001 | CANETA TINTEIRO RAY WHITE/DARK GREY GRAVADA-AZUL | UN | 0.010417 | 0 | 100 | 0.010417 | 2019-03-19 | 2958465 |  | 153
15231 | CX.MASTER 37L Nº26(395X355X270) |  |  | 10 | B002118001 | ROLLER RAY DEEP BLUE/LIGHT GREY GRAVADA-AZUL | UN | 0.010417 | 0 | 100 | 0.010417 | 2019-03-19 | 2958465 |  | 153
15231 | CX.MASTER 37L Nº26(395X355X270) |  |  | 10 | B002119001 | ROLLER RAY WHITE/DARK GREY GRAVADA-AZUL | UN | 0.010417 | 0 | 100 | 0.010417 | 2019-03-19 | 2958465 |  | 153
15231 | CX.MASTER 37L Nº26(395X355X270) |  |  | 10 | B002209001 | CANETA TINTEIRO SOLO M VERDE LIMÃO GRAVADA- AZUL | UN | 0.010417 | 0 | 100 | 0.010417 | 2019-03-19 | 2958465 |  | 153
15231 | CX.MASTER 37L Nº26(395X355X270) |  |  | 10 | B002210001 | CANETA TINTEIRO SOLO M LILÁS GRAVADA-AZUL | UN | 0.010417 | 0 | 100 | 0.010417 | 2019-03-19 | 2958465 |  | 153
15231 | CX.MASTER 37L Nº26(395X355X270) |  |  | 10 | B002211001 | CANETA TINTEIRO SOLO M VERMELHA GRAVADA-AZUL | UN | 0.010417 | 0 | 100 | 0.010417 | 2019-03-19 | 2958465 |  | 153
15231 | CX.MASTER 37L Nº26(395X355X270) |  |  | 10 | B002212001 | CANETA TINTEIRO SOLO M GRAFITE GRAVADA-AZUL | UN | 0.010417 | 0 | 100 | 0.010417 | 2019-03-19 | 2958465 |  | 153
15231 | CX.MASTER 37L Nº26(395X355X270) |  |  | 10 | B002213001 | CANETA TINTEIRO SOLO M BRONZE GRAVADA-AZUL | UN | 0.010417 | 0 | 100 | 0.010417 | 2019-03-19 | 2958465 |  | 153
15231 | CX.MASTER 37L Nº26(395X355X270) |  |  | 10 | B002214001 | CANETA TINTEIRO SOLO M PRATA GRAVADA-AZUL | UN | 0.010417 | 0 | 100 | 0.010417 | 2019-03-19 | 2958465 |  | 153
15231 | CX.MASTER 37L Nº26(395X355X270) |  |  | 10 | B002216004 | ROLLER SOLO PRETA GRAVADA- PRETA | UN | 0.010417 | 0 | 100 | 0.010417 | 2021-02-19 | 2958465 |  | 153
15231 | CX.MASTER 37L Nº26(395X355X270) |  |  | 10 | B002790001 | CANETA TINTEIRO CEOD SHINY POWDER PINK M GRAVADA -AZUL | UN | 0.010417 | 0 | 100 | 0.010417 | 2023-11-14 | 2958465 |  | 153
15231 | CX.MASTER 37L Nº26(395X355X270) |  |  | 10 | B002791001 | CANETA TINTEIRO CEOD SHINY GRAPHITE M GRAVADA -AZUL | UN | 0.010417 | 0 | 100 | 0.010417 | 2023-11-14 | 2958465 |  | 153
15231 | CX.MASTER 37L Nº26(395X355X270) |  |  | 10 | B002792001 | CANETA TINTEIRO CEOD SHINY BLUE M GRAVADA -AZUL | UN | 0.010417 | 0 | 100 | 0.010417 | 2023-11-14 | 2958465 |  | 153
15231 | CX.MASTER 37L Nº26(395X355X270) |  |  | 10 | B002793001 | CANETA TINTEIRO CEOD SHINY LIGHT GOLD M GRAVADA -AZUL | UN | 0.010417 | 0 | 100 | 0.010417 | 2023-11-14 | 2958465 |  | 153
15231 | CX.MASTER 37L Nº26(395X355X270) |  |  | 10 | B002794001 | CANETA TINTEIRO CEOD SHINY BRONZE GOLD M GRAVADA-AZUL | UN | 0.010417 | 0 | 100 | 0.010417 | 2023-11-14 | 2958465 |  | 153
15231 | CX.MASTER 37L Nº26(395X355X270) |  |  | 10 | B002800001 | CANETA TINTEIRO SOLO PINK M GRAVADA-AZUL | UN | 0.010417 | 0 | 100 | 0.010417 | 2023-11-15 | 2958465 |  | 153
15231 | CX.MASTER 37L Nº26(395X355X270) |  |  | 10 | B002801001 | CANETA TINTEIRO SOLO TURQUOISE M GRAVADA-AZUL | UN | 0.010417 | 0 | 100 | 0.010417 | 2023-11-15 | 2958465 |  | 153
15231 | CX.MASTER 37L Nº26(395X355X270) |  |  | 10 | B002864000 | TRI PEN METALIC ROSE-GRAVADA | UN | 0.010417 | 0 | 100 | 0.010417 | 2022-12-07 | 2958465 |  | 153
15231 | CX.MASTER 37L Nº26(395X355X270) |  |  | 10 | B002865000 | TRI PEN METALIC INOX-GRAVADA | UN | 0.010417 | 0 | 100 | 0.010417 | 2022-12-07 | 2958465 |  | 153
15231 | CX.MASTER 37L Nº26(395X355X270) |  |  | 10 | I001404000 | TRI PEN(i) METALIC PRATA-DOURADA | UN | 0.010417 | 0 | 100 | 0.010417 | 2022-05-24 | 2958465 |  | 153
15231 | CX.MASTER 37L Nº26(395X355X270) |  |  | 10 | I001615001 | ESFEROGRAFICA(i) COMPACTOR SMART --AZUL | UN | 0.010417 | 0 | 100 | 0.010417 | 2022-05-25 | 2958465 |  | 153
15231 | CX.MASTER 37L Nº26(395X355X270) |  |  | 10 | I002001000 | TRI PEN(i) METALIC PRETA | UN | 0.010417 | 0 | 100 | 0.010417 | 2022-05-25 | 2958465 |  | 153
15231 | CX.MASTER 37L Nº26(395X355X270) |  |  | 10 | I002002001 | ESFEROGRAFICA(i) COMPACTOR SMART LILAS - AZUL | UN | 0.010417 | 0 | 100 | 0.010417 | 2022-05-25 | 2958465 |  | 153
15231 | CX.MASTER 37L Nº26(395X355X270) |  |  | 10 | I002003001 | ESFEROGRAFICA(i) COMPACTOR SMART PRATA -AZUL | UN | 0.010417 | 0 | 100 | 0.010417 | 2022-05-25 | 2958465 |  | 153
15231 | CX.MASTER 37L Nº26(395X355X270) |  |  | 10 | I002018001 | CANETA TINTEIRO(i) SOLO M PRETA -AZUL | UN | 0.010417 | 0 | 100 | 0.010417 | 2022-05-24 | 2958465 |  | 153
15231 | CX.MASTER 37L Nº26(395X355X270) |  |  | 10 | I002019001 | CANETA TINTEIRO(i) SOLO M VIOLETA - AZUL | UN | 0.010417 | 0 | 100 | 0.010417 | 2022-05-25 | 2958465 |  | 153
15231 | CX.MASTER 37L Nº26(395X355X270) |  |  | 10 | I002020001 | CANETA TINTEIRO(i) SOLO M BRANCA - AZUL | UN | 0.010417 | 0 | 100 | 0.010417 | 2022-05-25 | 2958465 |  | 153
15231 | CX.MASTER 37L Nº26(395X355X270) |  |  | 10 | I002106001 | CANETA TINTEIRO(i) SOLO M TAUPE -AZUL | UN | 0.010417 | 0 | 100 | 0.010417 | 2022-05-25 | 2958465 |  | 153
15231 | CX.MASTER 37L Nº26(395X355X270) |  |  | 10 | I002107001 | CANETA TINTEIRO(i) SOLO M MINT -AZUL | UN | 0.010417 | 0 | 100 | 0.010417 | 2022-05-25 | 2958465 |  | 153
15231 | CX.MASTER 37L Nº26(395X355X270) |  |  | 10 | I002116001 | CANETA TINTEIRO(i) RAY DEEP BLUE/LIGHT GREY -AZUL | UN | 0.010417 | 0 | 100 | 0.010417 | 2022-05-25 | 2958465 |  | 153
15231 | CX.MASTER 37L Nº26(395X355X270) |  |  | 10 | I002117001 | CANETA TINTEIRO(i) RAY WHITE/DARK GREY -AZUL | UN | 0.010417 | 0 | 100 | 0.010417 | 2022-05-25 | 2958465 |  | 153
15231 | CX.MASTER 37L Nº26(395X355X270) |  |  | 10 | I002118001 | ROLLER(i) RAY DEEP BLUE/LIGHT GREY -AZUL | UN | 0.010417 | 0 | 100 | 0.010417 | 2022-05-24 | 2958465 |  | 153
15231 | CX.MASTER 37L Nº26(395X355X270) |  |  | 10 | I002119001 | ROLLER(i) RAY WHITE/DARK GREY -AZUL | UN | 0.010417 | 0 | 100 | 0.010417 | 2022-05-25 | 2958465 |  | 153
15231 | CX.MASTER 37L Nº26(395X355X270) |  |  | 10 | I002209001 | CANETA TINTEIRO(i) SOLO M VERDE LIMÃO - AZUL | UN | 0.010417 | 0 | 100 | 0.010417 | 2022-05-25 | 2958465 |  | 153
15231 | CX.MASTER 37L Nº26(395X355X270) |  |  | 10 | I002210001 | CANETA TINTEIRO(i) SOLO M LILÁS -AZUL | UN | 0.010417 | 0 | 100 | 0.010417 | 2022-05-25 | 2958465 |  | 153
15231 | CX.MASTER 37L Nº26(395X355X270) |  |  | 10 | I002211001 | CANETA TINTEIRO(i) SOLO M VERMELHA -AZUL | UN | 0.010417 | 0 | 100 | 0.010417 | 2022-05-25 | 2958465 |  | 153
15231 | CX.MASTER 37L Nº26(395X355X270) |  |  | 10 | I002212001 | CANETA TINTEIRO(i) SOLO M GRAFITE -AZUL | UN | 0.010417 | 0 | 100 | 0.010417 | 2022-05-25 | 2958465 |  | 153
15231 | CX.MASTER 37L Nº26(395X355X270) |  |  | 10 | I002213001 | CANETA TINTEIRO(i) SOLO M BRONZE -AZUL | UN | 0.010417 | 0 | 100 | 0.010417 | 2022-05-25 | 2958465 |  | 153
15231 | CX.MASTER 37L Nº26(395X355X270) |  |  | 10 | I002214001 | CANETA TINTEIRO(i) SOLO M PRATA -AZUL | UN | 0.010417 | 0 | 100 | 0.010417 | 2022-05-23 | 2958465 |  | 153
15231 | CX.MASTER 37L Nº26(395X355X270) |  |  | 10 | I002216001 | ROLLER SOLO(i) PRETA - AZUL | UN | 0.010417 | 0 | 100 | 0.010417 | 2022-05-25 | 2958465 |  | 153
15231 | CX.MASTER 37L Nº26(395X355X270) |  |  | 10 | I002790001 | CANETA TINTEIRO(i) CEOD SHINY POWDER PINK M -AZUL | UN | 0.010417 | 0 | 100 | 0.010417 | 2023-11-14 | 2958465 |  | 153
15231 | CX.MASTER 37L Nº26(395X355X270) |  |  | 10 | I002791001 | CANETA TINTEIRO(i) CEOD SHINY GRAPHITE M-AZUL | UN | 0.010417 | 0 | 100 | 0.010417 | 2023-11-14 | 2958465 |  | 153
15231 | CX.MASTER 37L Nº26(395X355X270) |  |  | 10 | I002792001 | CANETA TINTEIRO(i) CEOD SHINY BLUE M M-AZUL | UN | 0.010417 | 0 | 100 | 0.010417 | 2023-11-14 | 2958465 |  | 153
15231 | CX.MASTER 37L Nº26(395X355X270) |  |  | 10 | I002793001 | CANETA TINTEIRO(i) CEOD SHINY LIGHT GOLD M-AZUL | UN | 0.010417 | 0 | 100 | 0.010417 | 2023-11-14 | 2958465 |  | 153
15231 | CX.MASTER 37L Nº26(395X355X270) |  |  | 10 | I002794001 | CANETA TINTEIRO(i) CEOD SHINY BRONZE GOLD M-AZUL | UN | 0.010417 | 0 | 100 | 0.010417 | 2023-11-14 | 2958465 |  | 153
15231 | CX.MASTER 37L Nº26(395X355X270) |  |  | 10 | I002800001 | CANETA(i) TINTEIRO SOLO PINK M -AZUL | UN | 0.010417 | 0 | 100 | 0.010417 | 2023-11-15 | 2958465 |  | 153
15231 | CX.MASTER 37L Nº26(395X355X270) |  |  | 10 | I002801001 | CANETA(i) TINTEIRO SOLO TURQUOISE M -AZUL | UN | 0.010417 | 0 | 100 | 0.010417 | 2023-11-15 | 2958465 |  | 153
15231 | CX.MASTER 37L Nº26(395X355X270) |  |  | 10 | I002864000 | TRI PEN(i) METALIC ROSA | UN | 0.010417 | 0 | 100 | 0.010417 | 2022-12-07 | 2958465 |  | 153
15231 | CX.MASTER 37L Nº26(395X355X270) |  |  | 10 | I002865000 | TRI PEN(i) METALIC PRATA-PRATA | UN | 0.010417 | 0 | 100 | 0.010417 | 2022-12-07 | 2958465 |  | 153
15234 | CX.MASTER 08L Nº17(265X240X140) | UN |  | 10 | 1653036 | MARCADOR POWER EXTRA FINO-CX/12-OURO | UN | 0.033333 | 0 | 100 | 0.033333 | 2019-01-01 | 2958465 |  | 741
15234 | CX.MASTER 08L Nº17(265X240X140) |  |  | 10 | 1657017 | ESFEROGRAFICA 07 GEL-CX/12 BRANCA | UN | 0.038462 | 0 | 100 | 0.038462 | 2024-05-28 | 2958465 |  | 741
15234 | CX.MASTER 08L Nº17(265X240X140) |  |  | 10 | 1657030 | ESFEROGRAFICA 07 GEL-CX/12 PRATA | UN | 0.038462 | 0 | 100 | 0.038462 | 2019-03-28 | 2958465 |  | 741
15234 | CX.MASTER 08L Nº17(265X240X140) |  |  | 10 | 1657036 | ESFEROGRAFICA 07 GEL-CX/12 OURO | UN | 0.038462 | 0 | 100 | 0.038462 | 2019-03-28 | 2958465 |  | 741
15234 | CX.MASTER 08L Nº17(265X240X140) |  |  | 10 | 171 | ESFEROGRAFICA MENTYPE | UN | 0.038462 | 0 | 100 | 0.038462 | 2006-09-18 | 2958465 |  | 741
15234 | CX.MASTER 08L Nº17(265X240X140) |  |  | 10 | 173 | ESFEROGRAFICA MENTYPE BLUE ICE | UN | 0.038462 | 0 | 100 | 0.038462 | 2006-09-18 | 2958465 |  | 741
15234 | CX.MASTER 08L Nº17(265X240X140) |  |  | 10 | 2004004 | ESFEROGRAFICA ID VERDE - PRETA | UN | 0.025 | 0 | 100 | 0.025 | 2016-09-01 | 2958465 |  | 741
15234 | CX.MASTER 08L Nº17(265X240X140) |  |  | 10 | 2006001 | ESFEROGRAFICA DESIGNA PRATA-AZUL | UN | 0.05 | 0 | 100 | 0.05 | 2016-03-14 | 2958465 |  | 741
15234 | CX.MASTER 08L Nº17(265X240X140) |  |  | 10 | 2007004 | ESFEROGRAFICA DESIGNA PRETA-PRETA | UN | 0.05 | 0 | 100 | 0.05 | 2016-03-14 | 2958465 |  | 741
15234 | CX.MASTER 08L Nº17(265X240X140) |  |  | 10 | 1207 | COLA+ MULTIUSO 25 g-DI/12 | UN | 0.083333 | 0 | 100 | 0.083333 | 2005-05-18 | 2958465 |  | 741
15234 | CX.MASTER 08L Nº17(265X240X140) |  |  | 10 | 1389 | MARCADOR POWER FINO-CX/12 | UN | 0.033333 | 0 | 100 | 0.033333 | 2014-11-20 | 2958465 |  | 741
15234 | CX.MASTER 08L Nº17(265X240X140) |  |  | 10 | 1395 | CANETA DESIGNA | UN | 0.05 | 0 | 100 | 0.05 | 2006-07-21 | 2958465 |  | 741
15234 | CX.MASTER 08L Nº17(265X240X140) |  |  | 10 | 1653 | MARCADOR POWER EXTRA FINO-CX/12 | UN | 0.033333 | 0 | 100 | 0.033333 | 2011-12-16 | 2958465 |  | 741
15234 | CX.MASTER 08L Nº17(265X240X140) |  |  | 10 | 1656 | ESFEROGRAFICA ID | UN | 0.025 | 0 | 0 | 0 | 2009-11-24 | 2958465 |  | 741
15234 | CX.MASTER 08L Nº17(265X240X140) |  |  | 10 | 1657 | ESFEROGRAFICA 07 GEL-CX/12 | UN | 0.038462 | 0 | 100 | 0.038462 | 2013-11-29 | 2958465 |  | 741
15234 | CX.MASTER 08L Nº17(265X240X140) |  |  | 10 | 1825 | LAPISEIRA TURBO 05mm-CX/12 | UN | 0.041667 | 0 | 100 | 0.041667 | 2014-11-11 | 2958465 |  | 741
15234 | CX.MASTER 08L Nº17(265X240X140) |  |  | 10 | 1826 | LAPISEIRA TURBO 07mm-CX/12 | UN | 0.041667 | 0 | 100 | 0.041667 | 2014-11-11 | 2958465 |  | 741
15234 | CX.MASTER 08L Nº17(265X240X140) |  |  | 20 | B00173 | ESF. MENTYPE BLUE ICE | UN | 0.05 | 0 | 100 | 0.05 | 2007-12-07 | 2958465 |  | 741
15234 | CX.MASTER 08L Nº17(265X240X140) |  |  | 30 | B01032 | ESF. SENATOR | UN | 0.002 | 0 | 100 | 0.002 | 2007-12-05 | 2958465 |  | 741
15235 | CX.MASTER 04L Nº27(250X175X110) | UN |  | 10 | 1404000 | TRI PEN METALIC PRATA-DOURADA | UN | 0.038462 | 0 | 100 | 0.038462 | 2024-06-01 | 2958465 |  | 150
15235 | CX.MASTER 04L Nº27(250X175X110) |  |  | 10 | 1820643 | MARCADOR COMPACTOR QB-BL/4-1AZ/1VM/2PR | UN | 0.2 | 0 | 100 | 0.2 | 2019-10-01 | 401766 |  | 150
15235 | CX.MASTER 04L Nº27(250X175X110) |  |  | 10 | 1901000 | TRI PEN COMPACTOR PLASTICA PRETA | UN | 0.038462 | 0 | 100 | 0.038462 | 2024-06-01 | 2958465 |  | 150
15235 | CX.MASTER 04L Nº27(250X175X110) |  |  | 10 | 2001000 | TRI PEN METALIC PRETA | UN | 0.038462 | 0 | 100 | 0.038462 | 2024-06-01 | 2958465 |  | 150
15235 | CX.MASTER 04L Nº27(250X175X110) |  |  | 10 | 2485000 | HIDROGRAFICA COMPACTOR COLOR BRUSH BL/10-CX/5 | UN | 1 | 0 | 100 | 1 | 2020-10-20 | 401766 |  | 150
15235 | CX.MASTER 04L Nº27(250X175X110) |  |  | 10 | 2864000 | TRI PEN METALIC ROSE | UN | 0.038462 | 0 | 100 | 0.038462 | 2024-06-01 | 2958465 |  | 150
15235 | CX.MASTER 04L Nº27(250X175X110) |  |  | 10 | 2865000 | TRI PEN METALIC INOX | UN | 0.038462 | 0 | 100 | 0.038462 | 2024-06-01 | 2958465 |  | 150
15235 | CX.MASTER 04L Nº27(250X175X110) |  |  | 10 | 2909000 | LAPISEIRA COMPACTOR PROFI 0,7MM -BORDEAUX CX/6 | UN | 0.05 | 0 | 100 | 0.05 | 2024-09-16 | 2958465 |  | 150
15235 | CX.MASTER 04L Nº27(250X175X110) |  |  | 10 | 3055000 | LAPISEIRA COMPACTOR PROFI 0,7MM CX/6 | UN | 0.05 | 0 | 100 | 0.05 | 2024-06-01 | 2958465 |  | 150
15235 | CX.MASTER 04L Nº27(250X175X110) |  |  | 10 | R001661000 | MICROLINE-C/12 (CRR) | UN | 0.1 | 0 | 100 | 0.1 | 2018-07-01 | 401766 |  | 150
15235 | CX.MASTER 04L Nº27(250X175X110) |  |  | 10 | R001820643 | MARCADOR COMPACTOR QB-BL/4-1AZ/1VM/2PR (CRR) | UN | 0.2 | 0 | 100 | 0.2 | 2020-04-07 | 2958465 |  | 150
15236 | CX.MASTER 32L Nº47(410X381X211) | UN |  | 10 | 1715000 | ABC 35mm-CX/5 | UN | 0.033333 | 0 | 100 | 0.033333 | 2019-09-01 | 401766 |  | 475
15236 | CX.MASTER 32L Nº47(410X381X211) |  |  | 10 | 1716000 | ABC 45mm-CX/5 | UN | 0.033333 | 0 | 100 | 0.033333 | 2018-07-01 | 401766 |  | 475
15236 | CX.MASTER 32L Nº47(410X381X211) |  |  | 10 | R000890000 | COLA POLAR BRANCA 40g-DI/12 (CRR) | UN | 0.041667 | 0 | 100 | 0.041667 | 2018-02-08 | 401768 |  | 475
15236 | CX.MASTER 32L Nº47(410X381X211) |  |  | 10 | R001715000 | ABC 35mm-CX/5 (CRR) | UN | 0.033333 | 0 | 100 | 0.033333 | 2018-07-01 | 401766 |  | 475
15236 | CX.MASTER 32L Nº47(410X381X211) |  |  | 10 | R001716000 | ABC 45mm-CX/5 (CRR) | UN | 0.033333 | 0 | 100 | 0.033333 | 2018-07-01 | 401766 |  | 475
15236 | CX.MASTER 32L Nº47(410X381X211) |  |  | 10 | R001748002 | MARCADOR COMPACTOR QB-BL/1-CX/10 VERMELHA (CRR) | UN | 0.047619 | 0 | 100 | 0.047619 | 2018-07-01 | 401766 |  | 475
15594 | CX.MASTER 18L Nº09(443X283X150) | UN |  | 10 | 1533001 | ESFEROGRAFICA 07-CX/25 AZUL | UN | 0.025 | 0 | 100 | 0.025 | 2020-07-01 | 401766 |  | 360
15594 | CX.MASTER 18L Nº09(443X283X150) |  |  | 10 | 1533002 | ESFEROGRAFICA 07-CX/25 VERMELHA | UN | 0.025 | 0 | 100 | 0.025 | 2020-07-01 | 401766 |  | 360
15594 | CX.MASTER 18L Nº09(443X283X150) |  |  | 10 | 1533003 | ESFEROGRAFICA 07-CX/25 VERDE | UN | 0.025 | 0 | 100 | 0.025 | 2020-07-01 | 401766 |  | 360
15594 | CX.MASTER 18L Nº09(443X283X150) |  |  | 10 | 1533004 | ESFEROGRAFICA 07-CX/25 PRETA | UN | 0.025 | 0 | 100 | 0.025 | 2020-07-01 | 401766 |  | 360
15594 | CX.MASTER 18L Nº09(443X283X150) |  |  | 100 | 1534001 | ESFEROGRAFICA TOP 2000-CX/25 AZUL | UN | 0.025 | 0 | 100 | 0.025 | 2019-04-01 | 401766 |  | 360
15594 | CX.MASTER 18L Nº09(443X283X150) |  |  | 100 | 1534002 | ESFEROGRAFICA TOP 2000-CX/25 VERMELHO | UN | 0.025 | 0 | 100 | 0.025 | 2019-04-01 | 401766 |  | 360
15594 | CX.MASTER 18L Nº09(443X283X150) |  |  | 100 | 1534003 | ESFEROGRAFICA TOP 2000-CX/25 VERDE | UN | 0.025 | 0 | 100 | 0.025 | 2019-04-01 | 401766 |  | 360
15594 | CX.MASTER 18L Nº09(443X283X150) |  |  | 100 | 1534004 | ESFEROGRAFICA TOP 2000-CX/25 PRETA | UN | 0.025 | 0 | 100 | 0.025 | 2019-04-01 | 401766 |  | 360
15594 | CX.MASTER 18L Nº09(443X283X150) |  |  | 10 | 1616014 | ESFEROGRAFICA 07 PINK -CX/25 ROSA | UN | 0.025 | 0 | 100 | 0.025 | 2020-07-01 | 401766 |  | 360
15594 | CX.MASTER 18L Nº09(443X283X150) |  |  | 10 | 1677008 | ESFEROGRAFICA 07 VIOLETA -CX/25 VIOLETA | UN | 0.025 | 0 | 100 | 0.025 | 2020-07-01 | 401766 |  | 360
15594 | CX.MASTER 18L Nº09(443X283X150) |  |  | 100 | 2120007 | ESFEROGRAFICA JET LUX- CX/25 LARANJA | UN | 0.025 | 0 | 100 | 0.025 | 2019-04-01 | 401766 |  | 360
15594 | CX.MASTER 18L Nº09(443X283X150) |  |  | 100 | 2120008 | ESFEROGRAFICA JET LUX- CX/25 VIOLETA | UN | 0.025 | 0 | 100 | 0.025 | 2019-04-01 | 401766 |  | 360
15594 | CX.MASTER 18L Nº09(443X283X150) |  |  | 100 | 2120015 | ESFEROGRAFICA JET LUX- CX/25 AZUL TURQUESA | UN | 0.025 | 0 | 100 | 0.025 | 2019-04-01 | 401766 |  | 360
15594 | CX.MASTER 18L Nº09(443X283X150) |  |  | 10 | 2120016 | ESFEROGRAFICA JET LUX- CX/25 PURPURA | UN | 0.025 | 0 | 100 | 0.025 | 2019-04-01 | 401766 |  | 360
15594 | CX.MASTER 18L Nº09(443X283X150) |  |  | 10 | 3274001 | ESFEROGRAFICA COMPACTOR PLUS - CX/25 AZUL | UN | 0.025 | 0 | 100 | 0.025 | 2025-07-02 | 2958465 |  | 360
15594 | CX.MASTER 18L Nº09(443X283X150) |  |  | 10 | 3274002 | ESFEROGRAFICA COMPACTOR PLUS - CX/25 VERMELHA | UN | 0.025 | 0 | 100 | 0.025 | 2025-07-02 | 2958465 |  | 360
15594 | CX.MASTER 18L Nº09(443X283X150) |  |  | 10 | 3274004 | ESFEROGRAFICA COMPACTOR PLUS - CX/25 PRETA | UN | 0.025 | 0 | 100 | 0.025 | 2025-07-02 | 2958465 |  | 360
15594 | CX.MASTER 18L Nº09(443X283X150) |  |  | 190 | 3294001 | ESFEROGRAFICA K15 770 M SORTIDA-CX/25-AZUL | UN | 0.025 | 0 | 100 | 0.025 | 2025-04-07 | 2958465 | LC.17.0002 | 360
15594 | CX.MASTER 18L Nº09(443X283X150) |  |  | 10 | 3299001 | ESFEROGRAFICA K15 770 M AZUL-CX/25-AZUL | UN | 0.025 | 0 | 100 | 0.025 | 2024-09-18 | 2958465 |  | 360
15594 | CX.MASTER 18L Nº09(443X283X150) |  |  | 10 | R001533001 | ESFEROGRAFICA 07-CX/25 AZUL (CRR) | UN | 0.025 | 0 | 100 | 0.025 | 2020-07-01 | 401766 |  | 360
15594 | CX.MASTER 18L Nº09(443X283X150) |  |  | 10 | R001533002 | ESFEROGRAFICA 07-CX/25 VERMELHO (CRR) | UN | 0.025 | 0 | 100 | 0.025 | 2020-07-01 | 401766 |  | 360
15594 | CX.MASTER 18L Nº09(443X283X150) |  |  | 10 | R001533003 | ESFEROGRAFICA 07-CX/25 VERDE (CRR) | UN | 0.025 | 0 | 100 | 0.025 | 2020-07-01 | 401766 |  | 360
15594 | CX.MASTER 18L Nº09(443X283X150) |  |  | 10 | R001533004 | ESFEROGRAFICA 07-CX/25 PRETA (CRR) | UN | 0.025 | 0 | 100 | 0.025 | 2020-07-01 | 401766 |  | 360
15594 | CX.MASTER 18L Nº09(443X283X150) |  |  | 100 | R001534001 | ESFEROGRAFICA TOP 2000-CX/25 AZUL (CRR) | UN | 0.025 | 0 | 100 | 0.025 | 2020-11-27 | 401766 |  | 360
15594 | CX.MASTER 18L Nº09(443X283X150) |  |  | 10 | R001534002 | ESFEROGRAFICA TOP 2000-CX/25 VERMELHO (CRR) | UN | 0.025 | 0 | 100 | 0.025 | 2021-04-27 | 401766 |  | 360
15594 | CX.MASTER 18L Nº09(443X283X150) |  |  | 10 | R001534003 | ESFEROGRAFICA TOP 2000-CX/25 VERDE (CRR) | UN | 0.025 | 0 | 100 | 0.025 | 2019-12-31 | 401766 |  | 360
15594 | CX.MASTER 18L Nº09(443X283X150) |  |  | 10 | R001534004 | ESFEROGRAFICA TOP 2000-CX/25 PRETA (CRR) | UN | 0.025 | 0 | 100 | 0.025 | 2019-12-31 | 401766 |  | 360
15594 | CX.MASTER 18L Nº09(443X283X150) |  |  | 10 | R001616014 | ESFEROGRAFICA 07 PINK -CX/25 ROSA (CRR) | UN | 0.025 | 0 | 100 | 0.025 | 2020-07-01 | 401766 |  | 360
15594 | CX.MASTER 18L Nº09(443X283X150) |  |  | 10 | R001677008 | ESFEROGRAFICA 07 VIOLETA -CX/25 VIOLETA (CRR) | UN | 0.025 | 0 | 100 | 0.025 | 2020-07-01 | 401766 |  | 360
15596 | CX.MASTER 18L Nº16(398X318X150) | UN |  | 10 | 11001 | ESFEROGRAFICA 07-CX/50 AZUL | UN | 0.05 | 0 | 100 | 0.05 | 2020-07-01 | 401766 |  | 2219
15596 | CX.MASTER 18L Nº16(398X318X150) |  |  | 10 | 11002 | ESFEROGRAFICA 07-CX/50 VERMELHA | UN | 0.05 | 0 | 100 | 0.05 | 2020-07-01 | 401766 |  | 2219
15596 | CX.MASTER 18L Nº16(398X318X150) |  |  | 10 | 11003 | ESFEROGRAFICA 07-CX/50 VERDE | UN | 0.05 | 0 | 100 | 0.05 | 2020-07-01 | 401766 |  | 2219
15596 | CX.MASTER 18L Nº16(398X318X150) |  |  | 10 | 11004 | ESFEROGRAFICA 07-CX/50 PRETA | UN | 0.05 | 0 | 100 | 0.05 | 2020-07-01 | 401766 |  | 2219
15596 | CX.MASTER 18L Nº16(398X318X150) |  |  | 100 | 13001 | ESFEROGRAFICA TOP 2000-CX/50 AZUL | UN | 0.05 | 0 | 100 | 0.05 | 2019-04-01 | 401766 |  | 2219
15596 | CX.MASTER 18L Nº16(398X318X150) |  |  | 100 | 13002 | ESFEROGRAFICA TOP 2000-CX/50 VERMELHO | UN | 0.05 | 0 | 100 | 0.05 | 2019-04-01 | 401766 |  | 2219
15596 | CX.MASTER 18L Nº16(398X318X150) |  |  | 100 | 13003 | ESFEROGRAFICA TOP 2000-CX/50 VERDE | UN | 0.05 | 0 | 100 | 0.05 | 2019-04-01 | 401766 |  | 2219
15596 | CX.MASTER 18L Nº16(398X318X150) |  |  | 100 | 13004 | ESFEROGRAFICA TOP 2000-CX/50 PRETA | UN | 0.05 | 0 | 100 | 0.05 | 2019-04-01 | 401766 |  | 2219
15596 | CX.MASTER 18L Nº16(398X318X150) |  |  | 100 | 871001 | ESFEROGRAFICA ECONOMIC -CX/50 AZUL | UN | 0.05 | 0 | 100 | 0.05 | 2019-04-01 | 401766 |  | 2219
15596 | CX.MASTER 18L Nº16(398X318X150) |  |  | 100 | 871002 | ESFEROGRAFICA ECONOMIC -CX/50 VERMELHA | UN | 0.05 | 0 | 100 | 0.05 | 2019-04-01 | 401766 |  | 2219
15596 | CX.MASTER 18L Nº16(398X318X150) |  |  | 100 | 871004 | ESFEROGRAFICA ECONOMIC -CX/50 PRETA | UN | 0.05 | 0 | 100 | 0.05 | 2019-04-01 | 401766 |  | 2219
15596 | CX.MASTER 18L Nº16(398X318X150) |  |  | 100 | 1726001 | ESFEROGRAFICA 07 B 1.2mm-CX/50 AZUL | UN | 0.05 | 0 | 100 | 0.05 | 2019-04-01 | 401766 |  | 2219
15596 | CX.MASTER 18L Nº16(398X318X150) |  |  | 100 | 1726002 | ESFEROGRAFICA 07 B 1.2mm-CX/50 VERMELHA | UN | 0.05 | 0 | 100 | 0.05 | 2019-04-01 | 401766 |  | 2219
15596 | CX.MASTER 18L Nº16(398X318X150) |  |  | 100 | 1726003 | ESFEROGRAFICA 07 B 1.2mm-CX/50 VERDE | UN | 0.05 | 0 | 100 | 0.05 | 2019-04-01 | 401766 |  | 2219
15596 | CX.MASTER 18L Nº16(398X318X150) |  |  | 100 | 1726004 | ESFEROGRAFICA 07 B 1.2mm-CX/50 PRETA | UN | 0.05 | 0 | 100 | 0.05 | 2019-04-01 | 401766 |  | 2219
15596 | CX.MASTER 18L Nº16(398X318X150) |  |  | 10 | 1910014 | ESFEROGRAFICA 07 B 1.2mm PINK-CX/50 ROSA | UN | 0.05 | 0 | 100 | 0.05 | 2019-04-01 | 401766 |  | 2219
15596 | CX.MASTER 18L Nº16(398X318X150) |  |  | 100 | 1912008 | ESFEROGRAFICA 07 B 1.2mm VIOLETA-CX/50 VIOLETA | UN | 0.05 | 0 | 100 | 0.05 | 2019-04-01 | 401766 |  | 2219
15596 | CX.MASTER 18L Nº16(398X318X150) |  |  | 10 | 2428001 | ESFEROGRAFICA ECONOMIC FINA-CX/50 AZUL | UN | 0.05 | 0 | 100 | 0.05 | 2019-12-12 | 401766 |  | 2219
15596 | CX.MASTER 18L Nº16(398X318X150) |  |  | 10 | 2428002 | ESFEROGRAFICA ECONOMIC FINA-CX/50 VERMELHA | UN | 0.05 | 0 | 100 | 0.05 | 2019-12-12 | 401766 |  | 2219
15596 | CX.MASTER 18L Nº16(398X318X150) |  |  | 10 | 2428004 | ESFEROGRAFICA ECONOMIC FINA-CX/50 PRETA | UN | 0.05 | 0 | 100 | 0.05 | 2019-12-12 | 401766 |  | 2219
15596 | CX.MASTER 18L Nº16(398X318X150) |  |  | 10 | 2550999 | ESFEROGRAFICA TAKE 4 BL/1 CX/5-SORTIDO | UN | 0.05 | 0 | 100 | 0.05 | 2022-05-01 | 2958465 |  | 2219
15596 | CX.MASTER 18L Nº16(398X318X150) |  |  | 10 | 2758000 | MICROLINE CARTEIRA C/6-PCT/5 | UN | 0.033333 | 0 | 100 | 0.033333 | 2022-03-08 | 2958465 |  | 2219
15596 | CX.MASTER 18L Nº16(398X318X150) |  |  | 10 | 2784001 | ROLLER ONE BUSINESS BL/1 C/5-AZUL | UN | 0.05 | 0 | 100 | 0.05 | 2022-05-27 | 2958465 |  | 2219
15596 | CX.MASTER 18L Nº16(398X318X150) |  |  | 20 | 2835000 | ESTOJO TUBO CRISTAL | UN | 0.005 | 0 | 100 | 0.005 | 2024-03-01 | 2958465 |  | 2219
15596 | CX.MASTER 18L Nº16(398X318X150) |  |  | 10 | 3049000 | COMBO 10 ESFER.ECONOMIC -CX/50 AZUL+8 GIGANTE C/12-PCT/5 | Un | 1 | 0 | 100 | 1 | 2024-11-01 | 2958465 |  | 2219
15596 | CX.MASTER 18L Nº16(398X318X150) |  |  | 6 | 3050000 | COMBO 10 ESFER.ECONOMIC -CX/50 VERMELHA+8 GIGANTE C/12-PCT/5 | Un | 1 | 0 | 100 | 1 | 2024-11-01 | 2958465 |  | 2219
15596 | CX.MASTER 18L Nº16(398X318X150) |  |  | 6 | 3051000 | COMBO 10 ESFER.ECONOMIC -CX/50 PRETA+8 GIGANTE C/12-PCT/5 | Un | 1 | 0 | 100 | 1 | 2024-11-01 | 2958465 |  | 2219
15596 | CX.MASTER 18L Nº16(398X318X150) |  |  | 10 | 3086001 | MARCA PROPRIA KIT ESFEROGRAFICA C1 1.0mm-CX/50 AZUL | Un | 0.05 | 0 | 100 | 0.05 | 2024-07-18 | 2958465 |  | 2219
15596 | CX.MASTER 18L Nº16(398X318X150) |  |  | 10 | 3086002 | MARCA PROPRIA KIT ESFEROGRAFICA C1 1.0mm-CX/50 VERMELHO | Un | 0.05 | 0 | 100 | 0.05 | 2024-06-20 | 401766 |  | 2219
15596 | CX.MASTER 18L Nº16(398X318X150) |  |  | 10 | 3086004 | MARCA PROPRIA KIT ESFEROGRAFICA C1 1.0mm-CX/50 PRETO | Un | 0.05 | 0 | 100 | 0.05 | 2024-06-20 | 401766 |  | 2219
15596 | CX.MASTER 18L Nº16(398X318X150) |  |  | 10 | 3088001 | MARCA PROPRIA KIT ESFEROGRAFICA C1 FINA-CX/50 AZUL | Un | 0.05 | 0 | 100 | 0.05 | 2024-06-18 | 401766 |  | 2219
15596 | CX.MASTER 18L Nº16(398X318X150) |  |  | 10 | 3088002 | MARCA PROPRIA KIT ESFEROGRAFICA C1 FINA-CX/50 VERMELHA | Un | 0.05 | 0 | 100 | 0.05 | 2024-06-20 | 401766 |  | 2219
15596 | CX.MASTER 18L Nº16(398X318X150) |  |  | 10 | 3088004 | MARCA PROPRIA KIT ESFEROGRAFICA C1 FINA-CX/50 PRETO | Un | 0.05 | 0 | 100 | 0.05 | 2024-06-20 | 401766 |  | 2219
15596 | CX.MASTER 18L Nº16(398X318X150) |  |  | 10 | 3216000 | MARCA PROPRIA KIT 4C 10 ESFER. 1.0mm PR+8 GIGANTE C/12-PCT/5 | Un | 1 | 0 | 100 | 1 | 2024-11-01 | 2958465 |  | 2219
15596 | CX.MASTER 18L Nº16(398X318X150) |  |  | 10 | 3219000 | MARCA PROPRIA KIT 4F 10 ESFER. FINA PR+8 GIGANTE C/12-PCT/5 | Un | 1 | 0 | 100 | 1 | 2024-11-01 | 2958465 |  | 2219
15596 | CX.MASTER 18L Nº16(398X318X150) |  |  | 10 | 3241001 | ESFEROGRAFICA 07 BASIC - CX/50 AZUL | UN | 0.05 | 0 | 100 | 0.05 | 2025-05-22 | 401766 |  | 2219
15596 | CX.MASTER 18L Nº16(398X318X150) |  |  | 10 | 3241002 | ESFEROGRAFICA 07 BASIC - CX/50 VERMELHA | UN | 0.05 | 0 | 100 | 0.05 | 2025-05-22 | 401766 |  | 2219
15596 | CX.MASTER 18L Nº16(398X318X150) |  |  | 10 | 3241004 | ESFEROGRAFICA 07 BASIC - CX/50 PRETA | UN | 0.05 | 0 | 100 | 0.05 | 2025-05-22 | 401766 |  | 2219
15596 | CX.MASTER 18L Nº16(398X318X150) |  |  | 10 | 3252000 | MARCA PROPRIA KIT 6A 10 ESFER. 1.0mm AZ+8 HNG PST C/12-PCT/5 | UN | 1 | 0 | 100 | 1 | 2025-06-06 | 401768 |  | 2219
15596 | CX.MASTER 18L Nº16(398X318X150) |  |  | 10 | 3253000 | MARCA PROPRIA KIT 6B 10 ESFER. 1.0mm VM+8 HNG PST C/12-PCT/5 | UN | 1 | 0 | 100 | 1 | 2025-06-06 | 401766 |  | 2219
15596 | CX.MASTER 18L Nº16(398X318X150) |  |  | 10 | 3254000 | MARCA PROPRIA KIT 6C 10 ESFER. 1.0mm PR+8 HNG PST C/12-PCT/5 | UN | 1 | 0 | 100 | 1 | 2025-06-06 | 401766 |  | 2219
15596 | CX.MASTER 18L Nº16(398X318X150) |  |  | 10 | 3255000 | MARCA PROPRIA KIT 6D 10 ESFER. FINA AZ+8 HNG PST C/12-PCT/5 | UN | 1 | 0 | 100 | 1 | 2025-06-06 | 401766 |  | 2219
15596 | CX.MASTER 18L Nº16(398X318X150) |  |  | 10 | 3256000 | MARCA PROPRIA KIT 6E 10 ESFER. FINA VM+8 HNG PST C/12-PCT/5 | UN | 1 | 0 | 100 | 1 | 2025-06-06 | 401766 |  | 2219
15596 | CX.MASTER 18L Nº16(398X318X150) |  |  | 10 | 3257000 | MARCA PROPRIA KIT 6F 10 ESFER. FINA PR+8 HNG PST C/12-PCT/5 | UN | 1 | 0 | 100 | 1 | 2025-06-06 | 401766 |  | 2219
15596 | CX.MASTER 18L Nº16(398X318X150) |  |  | 10 | 3276001 | ESFEROGRAFICA COMPACTOR PLUS - CX/50 AZUL | UN | 0.05 | 0 | 100 | 0.05 | 2025-07-30 | 2958465 |  | 2219
15596 | CX.MASTER 18L Nº16(398X318X150) |  |  | 10 | 3276002 | ESFEROGRAFICA COMPACTOR PLUS - CX/50 VERMELHA | UN | 0.05 | 0 | 100 | 0.05 | 2025-07-30 | 2958465 |  | 2219
15596 | CX.MASTER 18L Nº16(398X318X150) |  |  | 10 | 3276004 | ESFEROGRAFICA COMPACTOR PLUS - CX/50 PRETA | UN | 0.05 | 0 | 100 | 0.05 | 2025-07-30 | 2958465 |  | 2219
15596 | CX.MASTER 18L Nº16(398X318X150) |  |  | 10 | 3371000 | MARCA PROPRIA KIT 7A 10 ESFER. 1.0mm AZ+40 GIGANTE C/12 AVUL | Un | 1 | 0 | 100 | 1 | 2025-08-01 | 2958465 |  | 2219
15596 | CX.MASTER 18L Nº16(398X318X150) |  |  | 10 | 3372000 | MARCA PROPRIA KIT 7B 10 ESFER. 1.0mm VM+40 GIGANTE C/12 AVUL | Un | 1 | 0 | 100 | 1 | 2025-08-01 | 2958465 |  | 2219
15596 | CX.MASTER 18L Nº16(398X318X150) |  |  | 10 | 3373000 | MARCA PROPRIA KIT 7C 10 ESFER. 1.0mm PR+40 GIGANTE C/12 AVUL | Un | 1 | 0 | 100 | 1 | 2025-08-01 | 2958465 |  | 2219
15596 | CX.MASTER 18L Nº16(398X318X150) |  |  | 10 | 3374000 | MARCA PROPRIA KIT 7D 10 ESFER. FINA AZ+40 GIGANTE C/12 AVULS | Un | 1 | 0 | 100 | 1 | 2025-08-01 | 2958465 |  | 2219
15596 | CX.MASTER 18L Nº16(398X318X150) |  |  | 10 | 3375000 | MARCA PROPRIA KIT 7E 10 ESFER. FINA VM+40 GIGANTE C/12 AVULS | Un | 1 | 0 | 100 | 1 | 2025-08-01 | 2958465 |  | 2219
15596 | CX.MASTER 18L Nº16(398X318X150) |  |  | 10 | 3376000 | MARCA PROPRIA KIT 7F 10 ESFER. FINA PR+40 GIGANTE C/12 AVULS | Un | 1 | 0 | 100 | 1 | 2025-08-01 | 2958465 |  | 2219
15596 | CX.MASTER 18L Nº16(398X318X150) |  |  | 10 | 1726 | ESFEROGRAFICA 07 B 1.2mm-CX/50 | UN | 0.05 | 0 | 100 | 0.05 | 2012-02-13 | 2958465 |  | 2219
15596 | CX.MASTER 18L Nº16(398X318X150) |  |  | 100 | 31444 | ESF.TOP MONTADA P/BRINDE(FLEX) - VERMELHA | UN | 0.001 | 0 | 100 | 0.001 | 2019-04-01 | 401766 |  | 2219
15596 | CX.MASTER 18L Nº16(398X318X150) |  |  | 100 | 32300 | ESF. TOP MONT.P/BRINDE TURQUESA TRANSL. AZUL | UN | 0.001 | 0 | 100 | 0.001 | 2019-04-01 | 401766 |  | 2219
15596 | CX.MASTER 18L Nº16(398X318X150) |  |  | 100 | 32379 | ESF. TOP MONT.P/BRINDE LARANJA TRANSL. AZUL | UN | 0.001 | 0 | 100 | 0.001 | 2019-04-01 | 401766 |  | 2219
15596 | CX.MASTER 18L Nº16(398X318X150) |  |  | 10 | 32381 | ESF. TOP MONT. TRANSLUCIDA VERDE | UN | 0.001 | 0 | 100 | 0.001 | 2020-07-01 | 2958465 |  | 2219
15596 | CX.MASTER 18L Nº16(398X318X150) |  |  | 10 | 32415 | ESF. TOP MONT.P/BRINDE CRISTAL AZUL | UN | 0.001 | 0 | 100 | 0.001 | 2019-04-01 | 401766 |  | 2219
15596 | CX.MASTER 18L Nº16(398X318X150) |  |  | 100 | 32673 | ESF. TOP MONTADA P/BRINDE- CRISTAL - VERMELHA | UN | 0.001 | 0 | 100 | 0.001 | 2019-04-01 | 401766 |  | 2219
15596 | CX.MASTER 18L Nº16(398X318X150) |  |  | 100 | 32829 | ESF. TOP MONT.P/BRINDE CRISTAL 3 AZUL | UN | 0.001 | 0 | 100 | 0.001 | 2019-04-01 | 401766 |  | 2219
15596 | CX.MASTER 18L Nº16(398X318X150) |  |  | 100 | 32833 | ESF. TOP MONT.P/BRINDE BRANCO 3 AZUL | UN | 0.001 | 0 | 100 | 0.001 | 2019-04-01 | 401766 |  | 2219
15596 | CX.MASTER 18L Nº16(398X318X150) |  |  | 100 | 32852 | ESF. TOP MONT.P/BRINDE CRISTAL 6 AZUL | UN | 0.001 | 0 | 100 | 0.001 | 2019-04-01 | 401766 |  | 2219
15596 | CX.MASTER 18L Nº16(398X318X150) |  |  | 100 | 32916 | ESF. TOP MONT.P/BRINDE BRANCO 1 PRETO | UN | 0.001 | 0 | 100 | 0.001 | 2019-04-01 | 401766 |  | 2219
15596 | CX.MASTER 18L Nº16(398X318X150) |  |  | 100 | 33056 | ESF. TOP MONT.P/BRINDE CRISTAL VERMELHA | UN | 0.001 | 0 | 100 | 0.001 | 2019-04-01 | 401766 |  | 2219
15596 | CX.MASTER 18L Nº16(398X318X150) |  |  | 10 | 33988 | ESFER. 07 VIP RETR.(FINA) VERMELHA P/BLISTER | UN | 0.001 | 0 | 100 | 0.001 | 2022-05-25 | 2958465 |  | 2219
15596 | CX.MASTER 18L Nº16(398X318X150) |  |  | 10 | 34016 | ESFER. 07 VIP RETR.(FINA) AZUL P/BLISTER | UN | 0.001 | 0 | 100 | 0.001 | 2022-05-25 | 2958465 |  | 2219
15596 | CX.MASTER 18L Nº16(398X318X150) |  |  | 100 | 34370 | ESF. TOP MONT.P/BRINDE BRANCO 5-AZUL | UN | 0.001 | 0 | 100 | 0.001 | 2023-09-22 | 401766 |  | 2219
15596 | CX.MASTER 18L Nº16(398X318X150) |  |  | 10 | 34382 | ESF. TOP MONT.P/BRINDE BRANCO- AZUL | UN | 0.001 | 0 | 100 | 0.001 | 2023-11-10 | 2958465 |  | 2219
15596 | CX.MASTER 18L Nº16(398X318X150) |  |  | 10 | 34654 | ESF. KIT C1 1.0mm EM CX/50 P/COMBO AZUL | UN | 0.05 | 0 | 100 | 0.05 | 2024-07-29 | 401766 |  | 2219
15596 | CX.MASTER 18L Nº16(398X318X150) |  |  | 10 | 34655 | ESF. KIT C1 1.0mm EM CX/50 P/COMBO VERMELHO | UN | 0.05 | 0 | 100 | 0.05 | 2024-07-18 | 401766 |  | 2219
15596 | CX.MASTER 18L Nº16(398X318X150) |  |  | 10 | 34656 | ESF. KIT C1 1.0mm EM CX/50 P/COMBO PRETO | UN | 0.05 | 0 | 100 | 0.05 | 2024-07-29 | 401766 |  | 2219
15596 | CX.MASTER 18L Nº16(398X318X150) |  |  | 10 | 34657 | ESF. KIT C1 FINA EM CX/50 P/COMBO AZUL | UN | 0.05 | 0 | 100 | 0.05 | 2024-07-29 | 401766 |  | 2219
15596 | CX.MASTER 18L Nº16(398X318X150) |  |  | 10 | 34658 | ESF. KIT C1 FINA EM CX/50 P/COMBO VERMELHA | UN | 0.05 | 0 | 100 | 0.05 | 2024-07-29 | 401766 |  | 2219
15596 | CX.MASTER 18L Nº16(398X318X150) |  |  | 10 | 34659 | ESF. KIT C1 FINA EM CX/50 P/COMBO PRETO | UN | 0.05 | 0 | 100 | 0.05 | 2024-07-29 | 401766 |  | 2219
15596 | CX.MASTER 18L Nº16(398X318X150) |  |  | 10 | 34688 | HIDR. COLOR C/12-PCT/5 (P/COMBO) | Un | 0.125 | 0 | 100 | 0.125 | 2024-07-10 | 401766 |  | 2219
15596 | CX.MASTER 18L Nº16(398X318X150) |  |  | 10 | 34689 | HIDR. COLOR C/6-PCT/10 (P/COMBO) | Un | 0.125 | 0 | 100 | 0.125 | 2024-07-10 | 401766 |  | 2219
15596 | CX.MASTER 18L Nº16(398X318X150) |  |  | 10 | 34691 | HIDR. MIR. C/12-PCT/5 (P/COMBO) | Un | 0.045455 | 0 | 100 | 0.045455 | 2024-07-10 | 401766 |  | 2219
15596 | CX.MASTER 18L Nº16(398X318X150) |  |  | 10 | 34692 | HIDR. COLOR AVULSO DZ-AZUL (P/COMBO) | Un | 0.021739 | 0 | 100 | 0.021739 | 2024-07-10 | 401766 |  | 2219
15596 | CX.MASTER 18L Nº16(398X318X150) |  |  | 10 | 34693 | HIDR. COLOR AVULSO DZ-VERMELHO (P/COMBO) | Un | 0.021739 | 0 | 100 | 0.021739 | 2024-07-10 | 401766 |  | 2219
15596 | CX.MASTER 18L Nº16(398X318X150) |  |  | 10 | 34694 | HIDR. COLOR AVULSO DZ-VERDE (P/COMBO) | Un | 0.021739 | 0 | 100 | 0.021739 | 2024-07-10 | 401766 |  | 2219
15596 | CX.MASTER 18L Nº16(398X318X150) |  |  | 10 | 34695 | HIDR. COLOR AVULSO DZ-PRETO (P/COMBO) | Un | 0.021739 | 0 | 100 | 0.021739 | 2024-07-10 | 401766 |  | 2219
15596 | CX.MASTER 18L Nº16(398X318X150) |  |  | 10 | 34878 | HIDR.COLOR(PP) C/6-PCT/10 (P/COMBO) | Un | 0.125 | 0 | 100 | 0.125 | 2024-10-01 | 401766 |  | 2219
15596 | CX.MASTER 18L Nº16(398X318X150) |  |  | 10 | 34879 | HIDR.COLOR(PP) AVULSO DZ-AZUL (P/COMBO) | Un | 0.021739 | 0 | 100 | 0.021739 | 2024-10-01 | 401766 |  | 2219
15596 | CX.MASTER 18L Nº16(398X318X150) |  |  | 10 | 34880 | HIDR.COLOR(PP) AVULSO DZ-VERMELHO (P/COMBO) | Un | 0.021739 | 0 | 100 | 0.021739 | 2024-10-01 | 401766 |  | 2219
15596 | CX.MASTER 18L Nº16(398X318X150) |  |  | 10 | 34881 | HIDR.COLOR(PP) AVULSO DZ-VERDE (P/COMBO) | Un | 0.021739 | 0 | 100 | 0.021739 | 2024-10-01 | 401766 |  | 2219
15596 | CX.MASTER 18L Nº16(398X318X150) |  |  | 10 | 34882 | HIDR.COLOR(PP) AVULSO DZ-PRETO (P/COMBO) | Un | 0.021739 | 0 | 100 | 0.021739 | 2024-10-01 | 401766 |  | 2219
15596 | CX.MASTER 18L Nº16(398X318X150) |  |  | 100 | 34951 | ESF. ECONOMIC EM CX/50 P/COMBO AZUL | UN | 0.05 | 0 | 100 | 0.05 | 2024-10-03 | 401766 |  | 2219
15596 | CX.MASTER 18L Nº16(398X318X150) |  |  | 100 | 34952 | ESF. ECONOMIC EM CX/50 P/COMBO VERMELHO | UN | 0.05 | 0 | 100 | 0.05 | 2024-10-03 | 401766 |  | 2219
15596 | CX.MASTER 18L Nº16(398X318X150) |  |  | 100 | 34953 | ESF. ECONOMIC EM CX/50 P/COMBO PRETO | UN | 0.05 | 0 | 100 | 0.05 | 2024-10-03 | 401766 |  | 2219
15596 | CX.MASTER 18L Nº16(398X318X150) |  |  | 40 | B000015001 | ESFEROGRAFICA TOP 2000 ESPECIAL -CX/50 GRAVADA-AZUL | UN | 0.05 | 0 | 100 | 0.05 | 2024-01-01 | 2958465 |  | 2219
15596 | CX.MASTER 18L Nº16(398X318X150) |  |  | 10 | B000015002 | ESFEROGRAFICA TOP 2000 ESPECIAL GRAVADA-CX/50-VERMELHA | UN | 0.05 | 0 | 100 | 0.05 | 2020-09-01 | 2958465 |  | 2219
15596 | CX.MASTER 18L Nº16(398X318X150) |  |  | 50 | B000015004 | ESFEROGRAFICA TOP 2000 ESPECIAL GRAVADA--CX/50-PRETA | UN | 0.05 | 0 | 100 | 0.05 | 2024-01-01 | 2958465 |  | 2219
15596 | CX.MASTER 18L Nº16(398X318X150) |  |  | 10 | B001062000 | TRI PEN COMPACTOR TRANSPARENTE C/ESTOJO GRAVADA-CRISTAL | UN | 0.004651 | 0 | 100 | 0.004651 | 2024-07-23 | 2958465 |  | 2219
15596 | CX.MASTER 18L Nº16(398X318X150) |  |  | 10 | B001251001 | ESFEROGRAFICA DYNAMIX GRAVADA-AZUL | UN | 0.001667 | 0 | 100 | 0.001667 | 2024-04-30 | 2958465 |  | 2219
15596 | CX.MASTER 18L Nº16(398X318X150) |  |  | 10 | B001726001 | ESFEROGRAFICA 07 B 1.2 MM GRAVADA-CX/50 AZUL | UN | 0.05 | 0 | 100 | 0.05 | 2018-10-11 | 2958465 |  | 2219
15596 | CX.MASTER 18L Nº16(398X318X150) |  |  | 30 | B001754006 | MARCADOR COMPACTOR DESTAQ D GRAVADA-AMARELO | UN | 0.002 | 0 | 100 | 0.002 | 2024-04-30 | 2958465 |  | 2219
15596 | CX.MASTER 18L Nº16(398X318X150) |  |  | 50 | B001827004 | ESFEROGRAFICA TOP 2000 AMARELA OPACA GRAVADA-CX/50-PRETA | UN | 0.05 | 0 | 100 | 0.05 | 2024-01-01 | 2958465 |  | 2219
15596 | CX.MASTER 18L Nº16(398X318X150) |  |  | 10 | B001828001 | ESFEROGRAFICA TOP 2000 BRANCA OPACA GRAVADA-CX/50-AZUL | UN | 0.05 | 0 | 100 | 0.05 | 2024-01-01 | 2958465 |  | 2219
15596 | CX.MASTER 18L Nº16(398X318X150) |  |  | 30 | B001829004 | ESFEROGRAFICA TOP 2000 PRETA OPACA GRAVADA--CX/50-PRETA | UN | 0.05 | 0 | 100 | 0.05 | 2024-01-01 | 2958465 |  | 2219
15596 | CX.MASTER 18L Nº16(398X318X150) |  |  | 50 | B001830001 | ESFEROGRAFICA TOP 2000 TRANSLUCIDA GRAVADA-AZUL-CX/50-AZ | UN | 0.05 | 0 | 100 | 0.05 | 2024-01-01 | 2958465 |  | 2219
15596 | CX.MASTER 18L Nº16(398X318X150) |  |  | 10 | B001831001 | ESFEROGRAFICA TOP 2000 TRANSLUCIDA VERDE GRAVADA--CX/50-AZ | UN | 0.05 | 0 | 100 | 0.05 | 2024-01-01 | 2958465 |  | 2219
15596 | CX.MASTER 18L Nº16(398X318X150) |  |  | 50 | B001832001 | ESFEROGRAFICA TOP 2000 TRANSLUCIDA LARANJA GRAVADA-CX/50-AZ | UN | 0.05 | 0 | 100 | 0.05 | 2024-01-01 | 2958465 |  | 2219
15596 | CX.MASTER 18L Nº16(398X318X150) |  |  | 50 | B001835001 | ESFEROGRAFICA TOP 2000 CRISTAL GRAVADA-CX/50-AZ | UN | 0.05 | 0 | 100 | 0.05 | 2024-01-01 | 2958465 |  | 2219
15596 | CX.MASTER 18L Nº16(398X318X150) |  |  | 10 | B001856001 | ESFEROGRAFICA ESSENTIAL BRANCA GRAVADA-AZUL | UN | 0.001667 | 0 | 100 | 0.001667 | 2024-04-30 | 2958465 |  | 2219
15596 | CX.MASTER 18L Nº16(398X318X150) |  |  | 10 | B001857001 | ESFEROGRAFICA ESSENTIAL AZUL BRANCA TRANS.GRAVADA-AZUL | UN | 0.001667 | 0 | 100 | 0.001667 | 2024-04-30 | 2958465 |  | 2219
15596 | CX.MASTER 18L Nº16(398X318X150) |  |  | 10 | B001858001 | ESFEROGRAFICA ESSENTIAL AZUL TRANSLUCIDA GRAVADA-AZUL | UN | 0.001667 | 0 | 100 | 0.001667 | 2024-04-30 | 2958465 |  | 2219
15596 | CX.MASTER 18L Nº16(398X318X150) |  |  | 10 | B001860001 | ESFEROGRAFICA EVO ROSA GRAVADA- AZUL | UN | 0.001667 | 0 | 100 | 0.001667 | 2024-04-30 | 2958465 |  | 2219
15596 | CX.MASTER 18L Nº16(398X318X150) |  |  | 10 | B001864001 | ESFEROGRAFICA K1 BIOSAFE GRAVADA-AZUL | UN | 0.001667 | 0 | 100 | 0.001667 | 2024-04-30 | 2958465 |  | 2219
15596 | CX.MASTER 18L Nº16(398X318X150) |  |  | 10 | B001865001 | ROLLER TOPBALL 857 BRANCA GRAVADA-AZUL | UN | 0.002 | 0 | 100 | 0.002 | 2024-04-30 | 2958465 |  | 2219
15596 | CX.MASTER 18L Nº16(398X318X150) |  |  | 10 | B001865004 | ROLLER TOPBALL 857 BRANCA GRAVADA-PRETA | UN | 0.002 | 0 | 100 | 0.002 | 2024-04-30 | 2958465 |  | 2219
15596 | CX.MASTER 18L Nº16(398X318X150) |  |  | 10 | B001887001 | ESFEROGRAFICA ESSENTIAL PRETA GRAVADA-AZUL | UN | 0.001667 | 0 | 100 | 0.001667 | 2024-04-30 | 2958465 |  | 2219
15596 | CX.MASTER 18L Nº16(398X318X150) |  |  | 10 | B001901000 | TRI PEN COMPACTOR PLASTICA PRETA GRAVADA | UN | 0.004651 | 0 | 100 | 0.004651 | 2024-04-30 | 2958465 |  | 2219
15596 | CX.MASTER 18L Nº16(398X318X150) |  |  | 10 | B001917001 | ESFEROGRAFICA ESSENTIAL AZUL BRANCA OPACA GRAVADA-AZUL | UN | 0.001667 | 0 | 100 | 0.001667 | 2024-04-30 | 2958465 |  | 2219
15596 | CX.MASTER 18L Nº16(398X318X150) |  |  | 10 | B001927001 | ESFEROGRAFICA 07 VIP RETRATIL GRAVADA--AZUL | UN | 0.001667 | 0 | 100 | 0.001667 | 2024-04-30 | 2958465 |  | 2219
15596 | CX.MASTER 18L Nº16(398X318X150) |  |  | 10 | B001928001 | ESFEROGRAFICA 07 VIP RETRATIL BRANCO OPACO GRAVADA-AZUL | UN | 0.001667 | 0 | 100 | 0.001667 | 2024-04-30 | 2958465 |  | 2219
15596 | CX.MASTER 18L Nº16(398X318X150) |  |  | 10 | B001929001 | ESFEROGRAFICA 07 VIP RETRATIL PRETO OPACO GRAVADA-AZUL | UN | 0.001667 | 0 | 100 | 0.001667 | 2024-04-30 | 2958465 |  | 2219
15596 | CX.MASTER 18L Nº16(398X318X150) |  |  | 10 | B001930001 | ESFEROGRAFICA 07 VIP RETRATIL CINZA COM AMARELO GRAVADA-AZ | UN | 0.001667 | 0 | 100 | 0.001667 | 2024-04-30 | 2958465 |  | 2219
15596 | CX.MASTER 18L Nº16(398X318X150) |  |  | 10 | B001968001 | ESFEROGRAFICA LIKE VERMELHA OPACA GRAVADA-AZUL | UN | 0.002 | 0 | 100 | 0.002 | 2024-04-30 | 2958465 |  | 2219
15596 | CX.MASTER 18L Nº16(398X318X150) |  |  | 10 | B001969001 | ESFEROGRAFICA LIKE PRETA OPACA GRAVADA-AZUL | UN | 0.002 | 0 | 100 | 0.002 | 2024-04-30 | 2958465 |  | 2219
15596 | CX.MASTER 18L Nº16(398X318X150) |  |  | 10 | B001984001 | ESFEROGRAFICA 07 VIP RETRATIL MULTICOR GRAVADA - AZUL | UN | 0.001667 | 0 | 100 | 0.001667 | 2024-04-30 | 2958465 |  | 2219
15596 | CX.MASTER 18L Nº16(398X318X150) |  |  | 10 | B002024000 | TRI PEN COMPACTOR PLASTICA BRANCA GRAVADA | UN | 0.004651 | 0 | 100 | 0.004651 | 2024-04-30 | 2958465 |  | 2219
15596 | CX.MASTER 18L Nº16(398X318X150) |  |  | 10 | B002025001 | ESFEROGRAFICA EVO BRANCA GRAVADA - AZUL | UN | 0.001667 | 0 | 100 | 0.001667 | 2024-04-30 | 2958465 |  | 2219
15596 | CX.MASTER 18L Nº16(398X318X150) |  |  | 10 | B002026001 | ESFEROGRAFICA EVO VERDE GRAVADA - AZUL | UN | 0.001667 | 0 | 100 | 0.001667 | 2024-04-30 | 2958465 |  | 2219
15596 | CX.MASTER 18L Nº16(398X318X150) |  |  | 10 | B002027001 | ESFEROGRAFICA EVO PRETA GRAVADA - AZUL | UN | 0.001667 | 0 | 100 | 0.001667 | 2024-04-30 | 2958465 |  | 2219
15596 | CX.MASTER 18L Nº16(398X318X150) |  |  | 10 | B002028001 | ESFEROGRAFICA 07 VIP RETRATIL ROSA GRAVADA- AZUL | UN | 0.001667 | 0 | 100 | 0.001667 | 2024-04-30 | 2958465 |  | 2219
15596 | CX.MASTER 18L Nº16(398X318X150) |  |  | 10 | B002029001 | ESFEROGRAFICA 07 VIP RETRATIL TURQUESA GRAVADA- AZUL | UN | 0.001667 | 0 | 100 | 0.001667 | 2024-04-30 | 2958465 |  | 2219
15596 | CX.MASTER 18L Nº16(398X318X150) |  |  | 10 | B002030001 | ESFEROGRAFICA 07 VIP RETRATIL VERMELHA GRAVADA-AZUL | UN | 0.001667 | 0 | 100 | 0.001667 | 2024-04-30 | 2958465 |  | 2219
15596 | CX.MASTER 18L Nº16(398X318X150) |  |  | 10 | B002031001 | ESFEROGRAFICA 07 VIP RETRATIL VERDE GRAVADA - AZUL | UN | 0.001667 | 0 | 100 | 0.001667 | 2024-04-30 | 2958465 |  | 2219
15596 | CX.MASTER 18L Nº16(398X318X150) |  |  | 10 | B002032001 | ESFEROGRAFICA 07 VIP RETRATIL PRETA GRAVADA-AZUL | UN | 0.001667 | 0 | 100 | 0.001667 | 2024-04-30 | 2958465 |  | 2219
15596 | CX.MASTER 18L Nº16(398X318X150) |  |  | 10 | B002033001 | ESFEROGRAFICA 07 VIP RETRATIL LARANJA GRAVADA-AZUL | UN | 0.001667 | 0 | 100 | 0.001667 | 2024-04-30 | 2958465 |  | 2219
15596 | CX.MASTER 18L Nº16(398X318X150) |  |  | 10 | B002034001 | ESFEROGRAFICA 07 VIP RETRATIL VIOLETA GRAVADA-AZUL | UN | 0.001667 | 0 | 100 | 0.001667 | 2024-04-30 | 2958465 |  | 2219
15596 | CX.MASTER 18L Nº16(398X318X150) |  |  | 30 | B002036000 | LAPISEIRA TECNICO PRETA 2,0mm (NOVA) GRAVADA | UN | 0.002 | 0 | 100 | 0.002 | 2024-04-30 | 2958465 |  | 2219
15596 | CX.MASTER 18L Nº16(398X318X150) |  |  | 10 | B002040001 | ESFEROGRAFICA 07 VIP RETRATIL CINZA OPACO GRAVADA- AZUL | UN | 0.001667 | 0 | 100 | 0.001667 | 2024-04-30 | 2958465 |  | 2219
15596 | CX.MASTER 18L Nº16(398X318X150) |  |  | 10 | B002041001 | ESFEROGRAFICA 07 VIP RETRATIL VIOLETA OPACA GRAVADA - AZUL | UN | 0.001667 | 0 | 100 | 0.001667 | 2024-04-30 | 2958465 |  | 2219
15596 | CX.MASTER 18L Nº16(398X318X150) |  |  | 10 | B002042001 | ESFEROGRAFICA 07 VIP RETRATIL ROSA OPACA GRAVADA- AZUL | UN | 0.001667 | 0 | 100 | 0.001667 | 2024-04-30 | 2958465 |  | 2219
15596 | CX.MASTER 18L Nº16(398X318X150) |  |  | 10 | B002043001 | ESFEROGRAFICA 07 VIP RETRATIL LARANJA OPACA GRAVADA-AZUL | UN | 0.001667 | 0 | 100 | 0.001667 | 2024-04-30 | 2958465 |  | 2219
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
