LcAvila/grade_moldes/src/main/webapp/assets/Produtos/00-00 - BASE DE DADOS/23.05.01-15 - ESF. COMPACTOR ECONOMIC.SLDASM

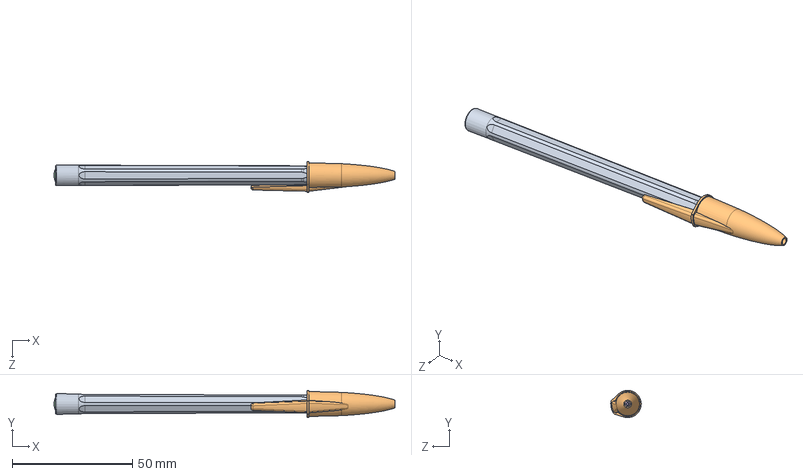
[picture p164: CAD file, 2026-10-30]
src/main/webapp/assets/Produtos/00-00 - BASE DE DADOS/23.05.01-15 - ESF. COMPACTOR ECONOMIC.SLDASM
141.6 x 11.3 x 12.7 mm
23.05.01-01-REV00 - CORPO SEXTAVADO ESF. COMPACTOR
23.05.01-03-REV00 - TAMPA TOP - ECONOMIC - ECONOMIC FINA - JET LUX
23.05.01-06-REV05 - CONEXÃO ESF. PADRÃO (DESENHO)
23.05.01-07-REV00 - TAMPINHA ESF (MOLDE 97 e 140 - 64 CAV)
23.05.01-08-REV00 - TUBO ESF.
23.05.01-10-REV00 PONTEIRA ø1,00mm
