LcAvila/grade_moldes/src/main/webapp/assets/Produtos/00-00 - BASE DE DADOS/Componentes/Reabastecedores/Montagem Modificação Tampa.SLDASM

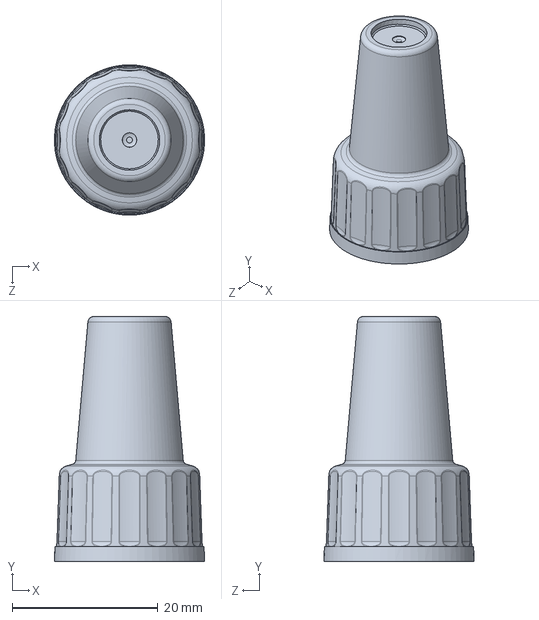
[picture p165: CAD file, 2026-10-30]
src/main/webapp/assets/Produtos/00-00 - BASE DE DADOS/Componentes/Reabastecedores/Montagem Modificação Tampa.SLDASM
20.6 x 33.6 x 20.6 mm
