LcAvila/grade_moldes/src/main/webapp/assets/Produtos/A1-40 - Esf. Buschle 201/PRO-23.06.04-08-REV00 - ESF. BUSCHLER 201 - (EXPLOSÃO).SLDASM

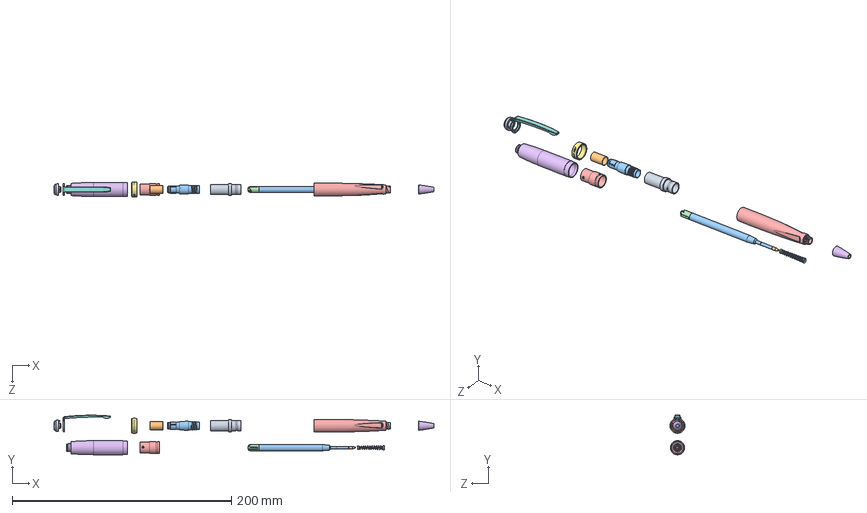
[picture p166: CAD file, 2026-10-30]
src/main/webapp/assets/Produtos/A1-40 - Esf. Buschle 201/PRO-23.06.04-08-REV00 - ESF. BUSCHLER 201 - (EXPLOSÃO).SLDASM
346.7 x 36.2 x 13.8 mm
inserto do mecanismo giratótio
luva do mecanismo
mecanismo giratório
Mola Esf. Buschle
Peça4
Corpo Dianteiro 1
23.06.02-4 - Anel do Corpo
Clips Duo PLUS
Iserto da Tampa
Ponteira p carga 1005
Corpo p carga 1005
Tampinha p carga 1005
CORPO DIANTEIRO 2
CONEXÃO
