LcAvila/grade_moldes/src/main/webapp/assets/Produtos/A1-46 - Office Basics/23.05.01-19 - MONT. ESF. OFFICE BASICS (COMPACTOR) - 3D.SLDASM

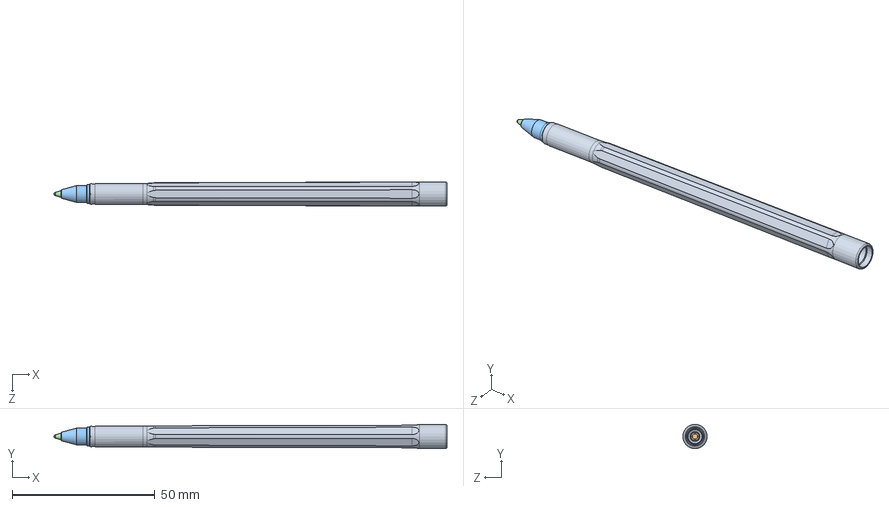
[picture p167: CAD file, 2026-10-30]
src/main/webapp/assets/Produtos/A1-46 - Office Basics/23.05.01-19 - MONT. ESF. OFFICE BASICS (COMPACTOR) - 3D.SLDASM
137.9 x 8.55 x 8.55 mm
COM-23.05.01-01-R00 CORPO SEXTAVADO
COM-23.05.01-08-REV00 TUBO ESF.
COM-23.05.01-06-REV05 CONEXÃO ESF.
COM-23.05.01-10-REV00 PONTEIRA ø1,00mm
