LcAvila/grade_moldes/src/main/webapp/assets/Produtos/00-00 - BASE DE DADOS/23.11.04-06-REV00 - NEO PEN MIRIM - 3D.SLDASM

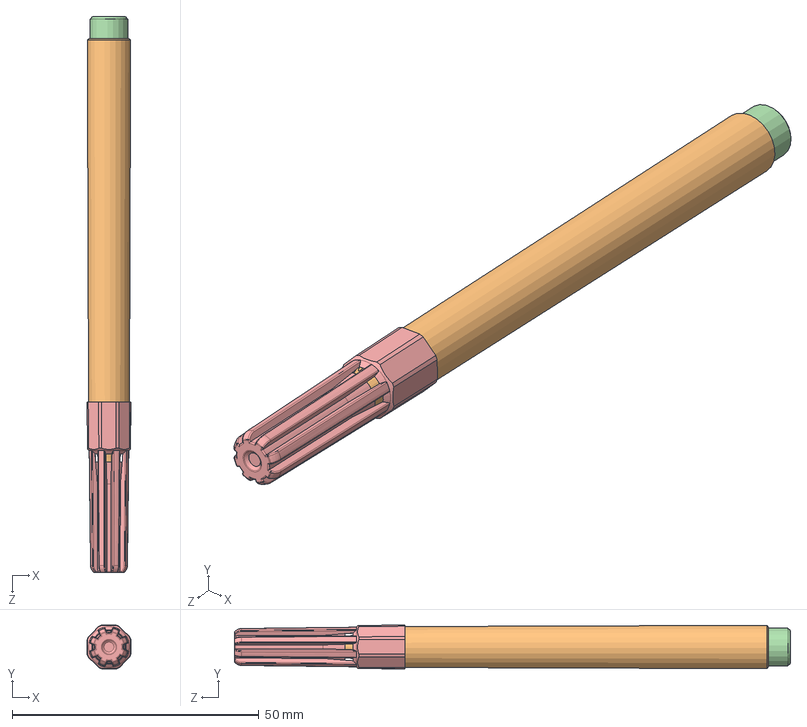
[picture p168: CAD file, 2026-10-30]
src/main/webapp/assets/Produtos/00-00 - BASE DE DADOS/23.11.04-06-REV00 - NEO PEN MIRIM - 3D.SLDASM
8.89 x 8.89 x 112.6 mm
23.06.01-5 - Pavio Neo-Pen- Mirim 3D
23.11.04 - 5 - CORPO NEO PEN MIRIM 3D
23.10.05-5.4 - Ponta Neo-Pen 3D
23.11.04-03-REV00 - TAMPINHA NEO PEN 3D
23.11.04-02-REV00 - TAMPA NEO PEN 3D
