LcAvila/grade_moldes/src/main/webapp/assets/Produtos/00-00 - BASE DE DADOS/Componentes/Hidrográficas e Marcadores/Mecanismo Vai e Volta.SLDASM

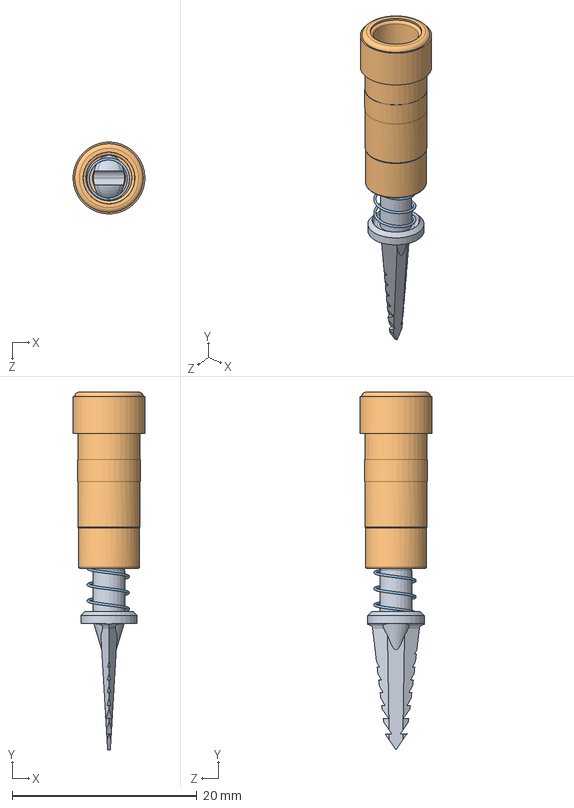
[picture p169: CAD file, 2026-10-30]
src/main/webapp/assets/Produtos/00-00 - BASE DE DADOS/Componentes/Hidrográficas e Marcadores/Mecanismo Vai e Volta.SLDASM
7.79 x 38.8 x 7.79 mm
Fixador de ponta Chapéu
23.11.04-3 - TAMPINHA NEO PEN 3D
mola
