LcAvila/grade_moldes/src/main/webapp/assets/Produtos/00-00 - BASE DE DADOS/Componentes/Esferográficas/23.06.03-10-REV00 - MONT. TAMPA TINTEIRO 01.SLDASM

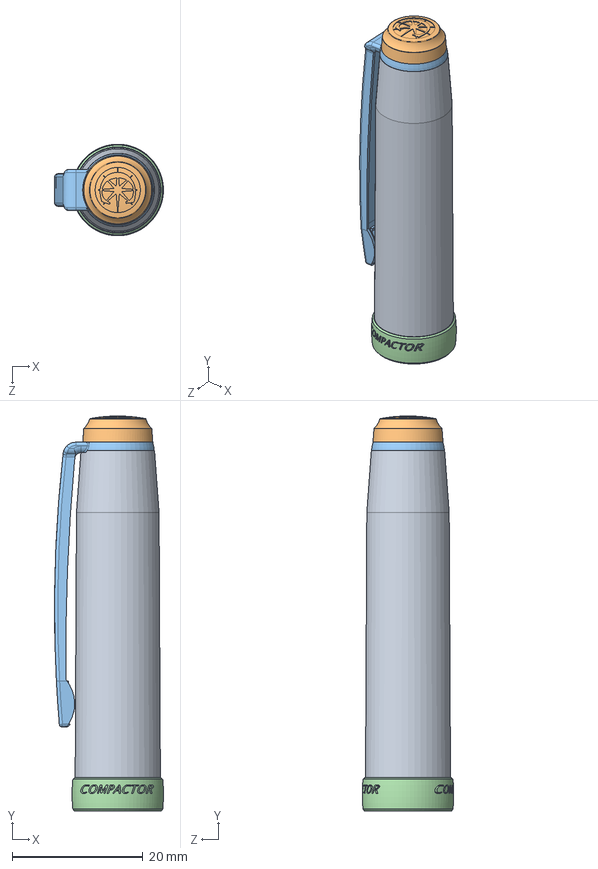
[picture p170: CAD file, 2026-10-30]
src/main/webapp/assets/Produtos/00-00 - BASE DE DADOS/Componentes/Esferográficas/23.06.03-10-REV00 - MONT. TAMPA TINTEIRO 01.SLDASM
16.6 x 60.3 x 14.0 mm
23.06.03-1 - Base da Tampa Tinteiro 01
23.06.02-2 Inserto da tampa com logo
23.06.02-3 - Clips Dourado
23.06.03-2 - Anel para Tinteiro 01 _ Dourado
