LcAvila/grade_moldes/src/main/webapp/assets/Produtos/00-00 - BASE DE DADOS/23.10.05-01-REV07 - COLOR EM PP.SLDASM

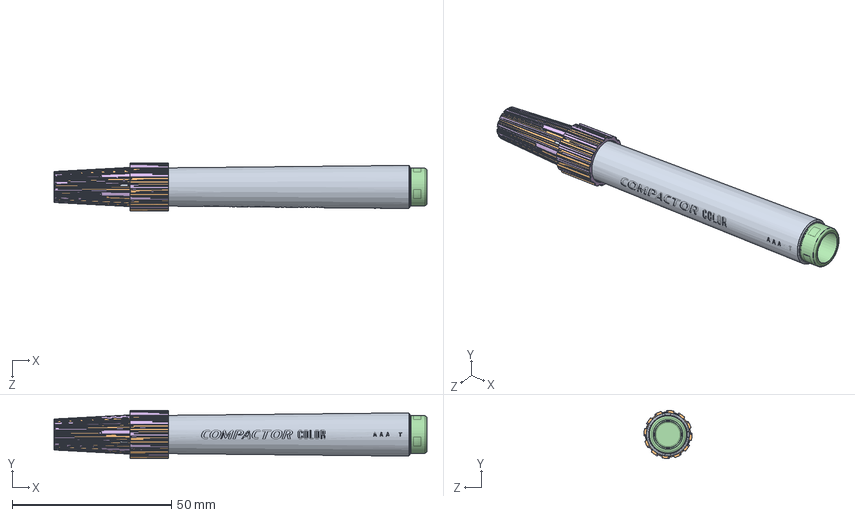
[picture p171: CAD file, 2026-10-30]
src/main/webapp/assets/Produtos/00-00 - BASE DE DADOS/23.10.05-01-REV07 - COLOR EM PP.SLDASM
117.3 x 15.1 x 15.1 mm
23.10.05-04-01-REV01 - CORPO COLOR PP
23.06.01-02-REV00 - PAVIO COMPACTOR COLOR
23.10.05-03_02-REV00 - TAMPINHA COLOR EM PP
23.10.05-05.01 - PONTA COMPACTOR COLOR (POREX)
23.10.05-04.02-REV00 - TAMPA COMPACTOR COLOR 3D
