LcAvila/grade_moldes/src/main/webapp/assets/Produtos/00-00 - BASE DE DADOS/Componentes/Lapiseiras/99.07.18-1-REV01 - Lapiseira Técnico.SLDASM

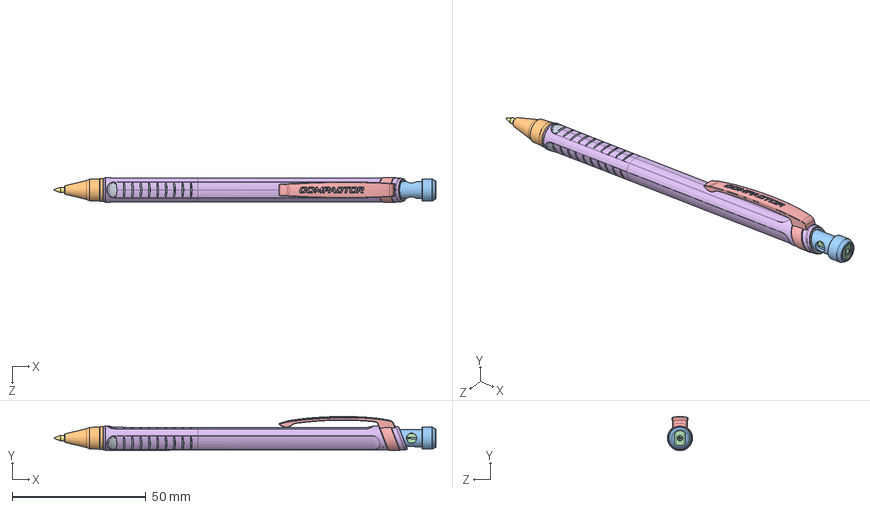
[picture p172: CAD file, 2026-10-30]
src/main/webapp/assets/Produtos/00-00 - BASE DE DADOS/Componentes/Lapiseiras/99.07.18-1-REV01 - Lapiseira Técnico.SLDASM
143.0 x 12.7 x 9.40 mm
Botão Láp. Técnico
Lamina do Apontador dobrado
CLIPS (sharp 2mm assy 2011[1]
Dianteira Lap.Técnico
CORPO TÉCNICO MODIFICADO1
GRAFITE (sharp 2mm assy 2011[1].5.31.sldasm-Part-4-1)
