LcAvila/grade_moldes/src/main/webapp/assets/Produtos/00-00 - BASE DE DADOS/23.05.01-12-REV00 ESF. 07.SLDASM

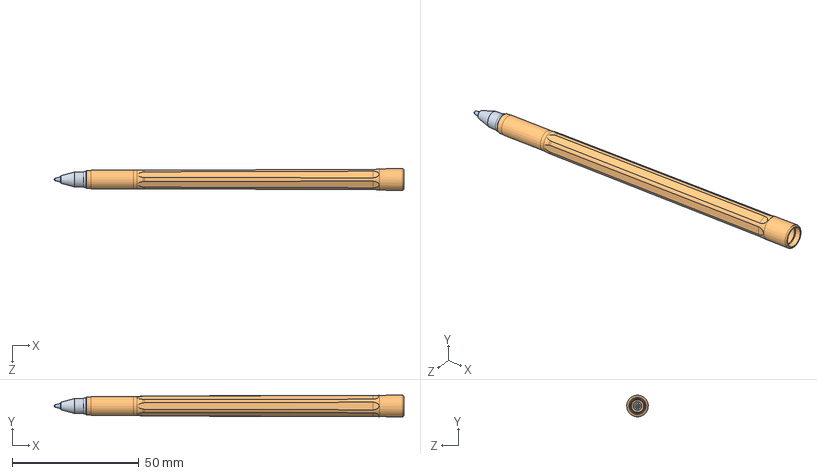
[picture p173: CAD file, 2026-10-30]
src/main/webapp/assets/Produtos/00-00 - BASE DE DADOS/23.05.01-12-REV00 ESF. 07.SLDASM
138.0 x 8.55 x 8.55 mm
23.05.01-06-REV05 - CONEXÃO ESF. PADRÃO (DESENHO)
23.05.01-01-REV00 - CORPO SEXTAVADO ESF. COMPACTOR
23.05.01-09-REV01 - PONTEIRA ø0,8
