LcAvila/grade_moldes/src/main/webapp/assets/Produtos/00-00 - BASE DE DADOS/23.06.03-08-REV00 - MONT. TINTEIRO 01.SLDASM

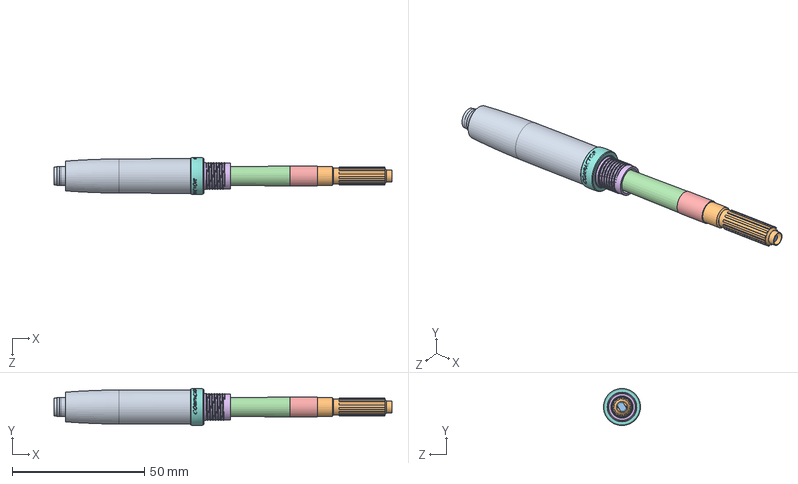
[picture p174: CAD file, 2026-10-30]
src/main/webapp/assets/Produtos/00-00 - BASE DE DADOS/23.06.03-08-REV00 - MONT. TINTEIRO 01.SLDASM
127.6 x 14.0 x 14.0 mm
23.06.03-06-REV00 - MECÂNISMO (PÇ1) TINTEIRO 01
23.06.03-06-REV00 - MECÂNISMO (PÇ2) TINTEIRO 01
23.06.03-06-REV00 - MECÂNISMO (PÇ3) TINTEIRO 01
23.06.03-06-REV00 - LUVA DE MECÂNISMO TINTEIRO 01
23.06.03-03-REV00 - DIANTEIRA CANETA TINTEIRO 01
23.06.03-07-REV00 - PENA DE METAL TINTEIRO 01
23.06.02-01-REV00 - CAPA DIANTEIRA DUO PLUS
23.06.03-02-REV00 - ANEL PARA TINTEIRO 01 (DOURADO)
