LcAvila/grade_moldes/src/main/webapp/assets/Produtos/00-00 - BASE DE DADOS/23.05.01-13 - ESF. COMPACTOR 07B 1,20.SLDASM

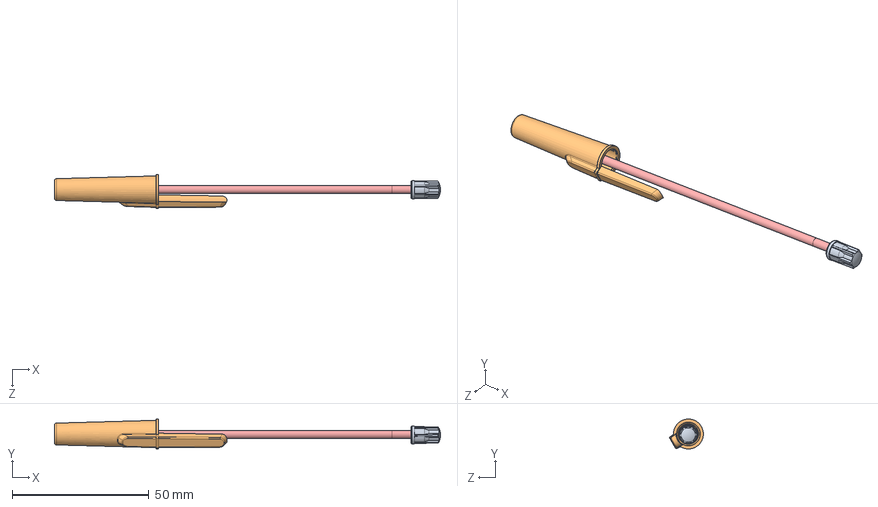
[picture p175: CAD file, 2026-10-30]
src/main/webapp/assets/Produtos/00-00 - BASE DE DADOS/23.05.01-13 - ESF. COMPACTOR 07B 1,20.SLDASM
141.1 x 10.9 x 12.3 mm
23.05.01-07-REV00 - TAMPINHA ESF (MOLDE 97 e 140 - 64 CAV)
23.05.01-05-REV00 - TAMPA 07-DESENHO - MOLDE 117
23.05.01-06-REV05 - CONEXÃO ESF. PADRÃO (DESENHO)
23.05.01-11-REV00 - PONTEIRA ø1,2mm
23.05.01-08-REV00 - TUBO ESF.
