LcAvila/grade_moldes/src/main/webapp/assets/Produtos/00-00 - BASE DE DADOS/Componentes/Lapiseiras/13.03.05-03-REV00-Mecanismo Lap. Técnico.SLDASM

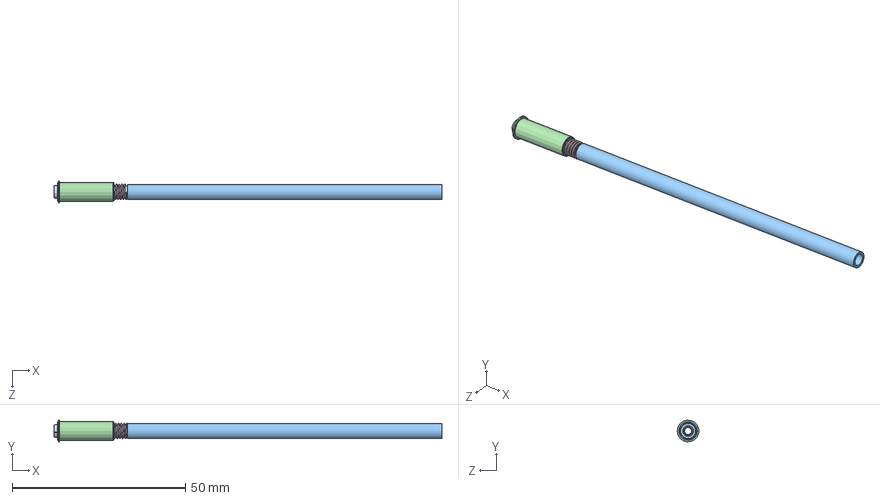
[picture p176: CAD file, 2026-10-30]
src/main/webapp/assets/Produtos/00-00 - BASE DE DADOS/Componentes/Lapiseiras/13.03.05-03-REV00-Mecanismo Lap. Técnico.SLDASM
112.1 x 6.27 x 6.25 mm
Pinça
Luva Lap Técnico (Novo)
Tubo
Conexão do mecanismo
Mola
