LcAvila/grade_moldes/src/main/webapp/assets/Produtos/00-00 - BASE DE DADOS/23.10.04 PINCEL MARCADOR _ 3D.SLDASM

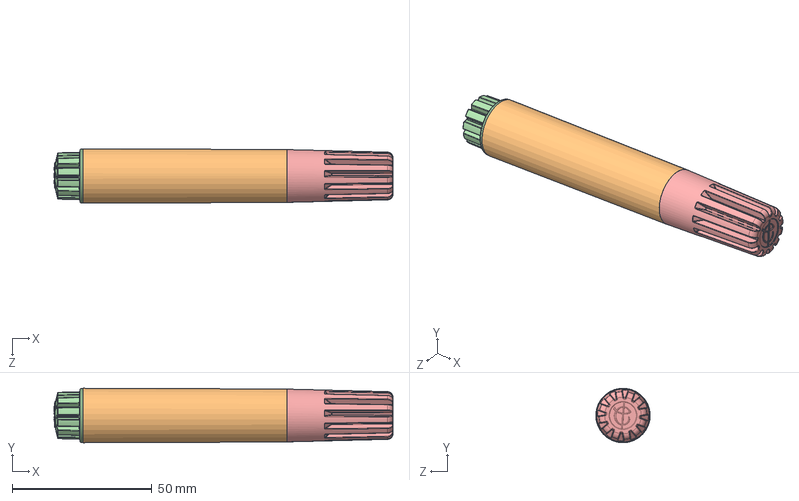
[picture p177: CAD file, 2026-10-30]
src/main/webapp/assets/Produtos/00-00 - BASE DE DADOS/23.10.04 PINCEL MARCADOR _ 3D.SLDASM
121.3 x 19.5 x 19.5 mm
23.06.01-4 - Pavio Pincel e QB 13,5 x 73,0 3D
23.10.04 -1 _ CORPO PINCEL MARCADOR (3D)
23.10.05-5.8 - Ponta Pincel Marcador 3D
24.01.03 - 1 TAMPINHA MARCADORES QB E PINCEL
23.10.04-2 - Tampa Pincel Macador - 3D
