LcAvila/grade_moldes/src/main/webapp/assets/Produtos/00-00 - BASE DE DADOS/24.01.03 Marcador QB _ 3D.SLDASM

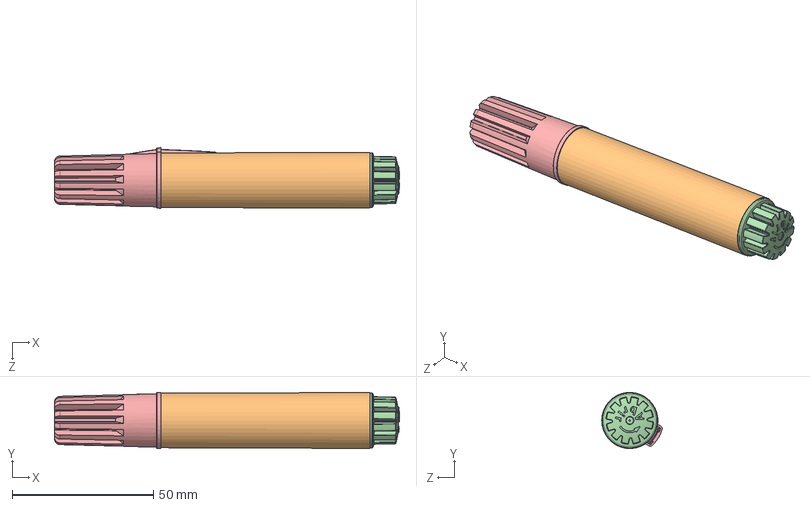
[picture p178: CAD file, 2026-10-30]
src/main/webapp/assets/Produtos/00-00 - BASE DE DADOS/24.01.03 Marcador QB _ 3D.SLDASM
122.1 x 19.9 x 21.4 mm
23.06.01-4 - Pavio Pincel e QB 13,5 x 73,0 3D
24.01.03 - 2 CORPO MARCADOR QB (3D)
23.10.05-5.7 - Ponta QB 3D
24.01.03 - 1 TAMPINHA MARCADORES QB E PINCEL
24.01.03-3.1 - Tampa Marc. QB - 3D
23.06.01-8 - Feltro da Tampa QB 3D
