LcAvila/grade_moldes/src/main/webapp/assets/Produtos/00-00 - BASE DE DADOS/25.11.07-00 - VAI E VOLTA.SLDASM

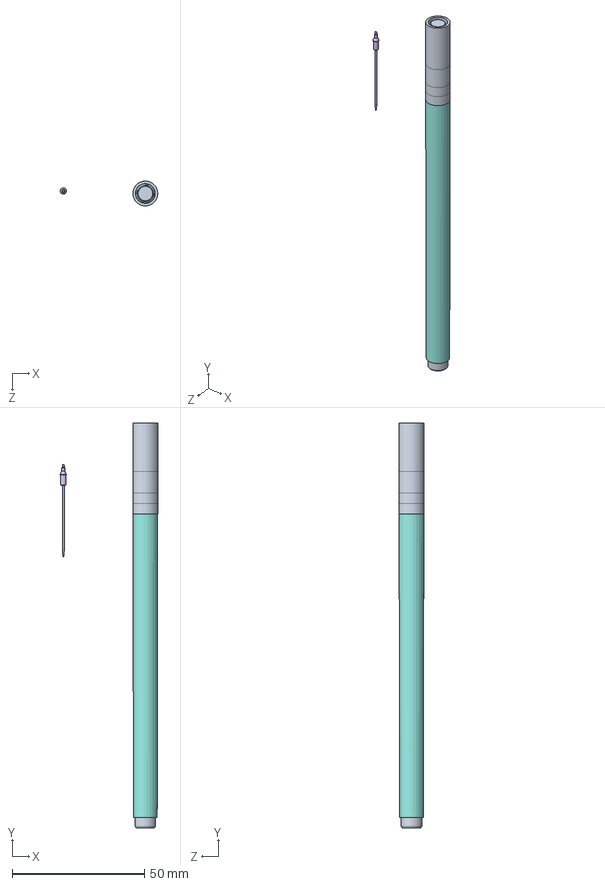
[picture p179: CAD file, 2026-10-30]
src/main/webapp/assets/Produtos/00-00 - BASE DE DADOS/25.11.07-00 - VAI E VOLTA.SLDASM
36.9 x 153.1 x 9.44 mm
23.11.04-3 - TAMPINHA NEO PEN 3D
Pavio Neo-Pen Gigante 99,70mm
Fixador de ponta Conico
mola
Ponta Neo-Pen (Porex)
Fixador de ponta Chapéu
Corpo VAI VEM
18.08.2025-1 - Tampa Neo Pen Premium 7
