LcAvila/grade_moldes/src/main/webapp/assets/Produtos/00-00 - BASE DE DADOS/23.06.02-10-REV00 - CANETA ROLLER DUO PLUS.SLDASM

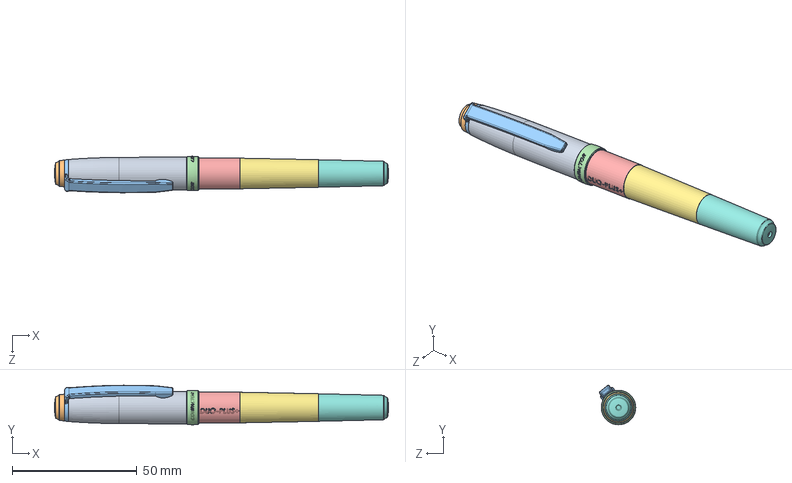
[picture p180: CAD file, 2026-10-30]
src/main/webapp/assets/Produtos/00-00 - BASE DE DADOS/23.06.02-10-REV00 - CANETA ROLLER DUO PLUS.SLDASM
133.7 x 15.8 x 14.6 mm
23.06.02-01-REV00 - CAPA DIANTEIRA DUO PLUS
23.06.02-02-REV00 - INSERTO DA TAMPA
23.06.02-03-REV00 - CLIPS
23.06.02-04-REV00 - ANEL DO CORPO DUO PLUS
23.06.02-05-REV00 - CONECTOR DUO PLUS
23.06.02-07-REV00 - TAMPA INTERNA DUO PLUS
23.06.02-08-REV00 - CAPA TRASEIRA DUO PLUS
23.06.02-09-REV00 - TAMPA TRASEIRA DUO PLUS
23.06.06-01-REV00 - CARGA DUO PLUS (MARCA TEXTO)
23.06.06-01-REV00 - CARGA ONE CHANGE - SCHNEIDER
23.06.02-06-REV00 - DIANTEIRA DUO PLUS
