LcAvila/grade_moldes/src/main/webapp/assets/Produtos/00-00 - BASE DE DADOS/23.06.04-08-REV00 - ESF. BUSCHLER 201.SLDASM

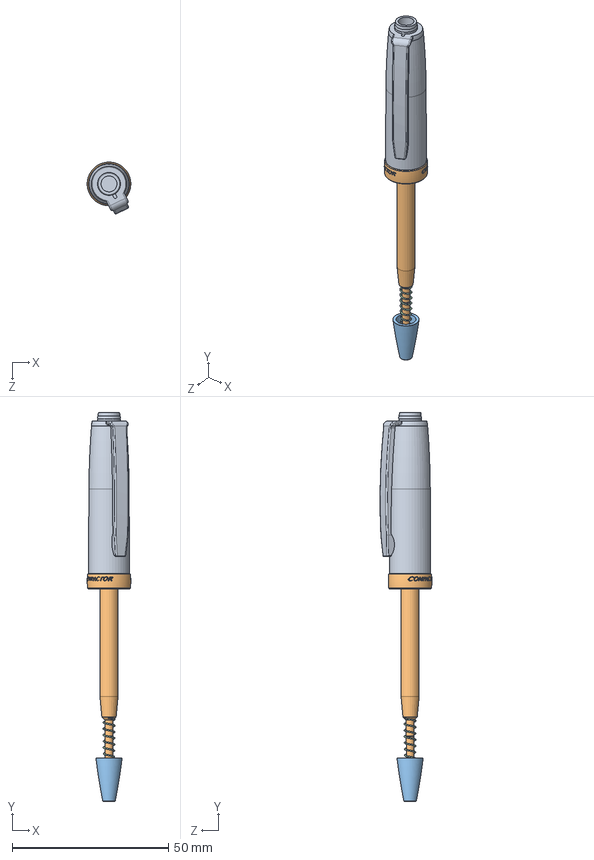
[picture p181: CAD file, 2026-10-30]
src/main/webapp/assets/Produtos/00-00 - BASE DE DADOS/23.06.04-08-REV00 - ESF. BUSCHLER 201.SLDASM
14.0 x 124.5 x 16.6 mm
23.03.01-15-REV00 - CORPO CARGA 1005 e SLID XB - 3D
23.06.04-06-REV00 - DIANTEIRA ESF. BUSCHLER 201
23.06.04-05-REV00 - MOLA ESF. BUSCHLER 201
23.06.04-02-REV00 - INSERTO DO CORPO ESF.B. 201 (BUCHA DO CORPO)
23.06.04-03-REV00 - MECANISMO GIRATÓRIO ESF. B. 201
23.06.02-01-REV00 - CAPA DIANTEIRA DUO PLUS
23.06.04-04-REV00 - LUVA DO MECANISMO ESF.B. 201 (BUCHA INTERNA)
23.06.04-07-REV00 - Inserto Interno da Tampa (Bucha da Tampinha)
23.06.02-03-REV00 - CLIPS
23.06.02-04-REV00 - ANEL PARA TINTEIRO
