LcAvila/grade_moldes/src/main/webapp/assets/Produtos/00-00 - BASE DE DADOS/23.06.05-01-REV00 - ESFEROGRÁFICA SENATOR.SLDASM

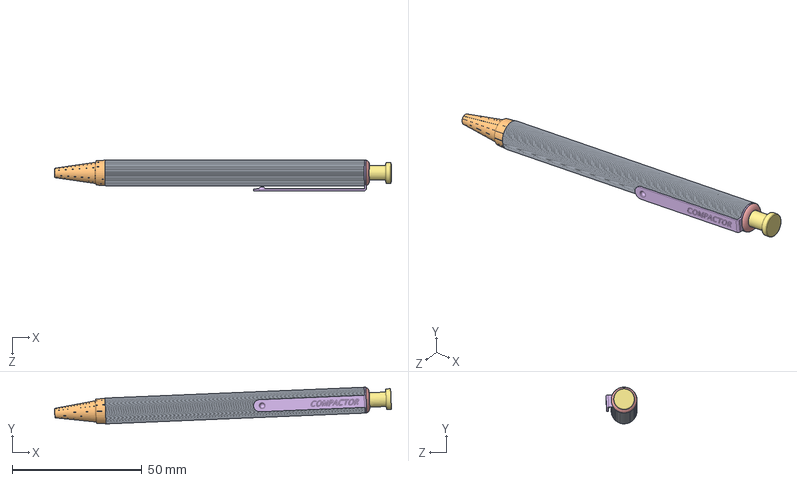
[picture p182: CAD file, 2026-10-30]
src/main/webapp/assets/Produtos/00-00 - BASE DE DADOS/23.06.05-01-REV00 - ESFEROGRÁFICA SENATOR.SLDASM
129.9 x 14.2 x 12.0 mm
23.06.05-11-REV00 - CORPO ALUMÍNIO
23.06.05-02-REV00 - PONTEIRA CROMADA SENATOR
23.06.05-03-REV00 - BUCHA COM ROSCA SENATOR
23.06.05-04-REV00 - MOLA SENATOR N4 D 0.4mm x 30.70mm (2) x 2
23.06.05-08-REV00 - SUPORTE MECANISMO SENATOR
23.06.05-09-REV00 - CLIP SENATOR
23.06.05-10-REV00 - BOTÃO SENATOR
23.06.05-05-REV00 - MOLA SENATOR N2 D 0.2mm x 19.60mm (2)
23.06.05-06-REV00 - FEMEA DO MECANISMO SENATOR
23.06.05-07-REV00 - MACHO DO MECANISMO SENATOR
