LcAvila/grade_moldes/src/main/webapp/assets/Produtos/00-00 - BASE DE DADOS/23.11.04-04-REV00 - NEO PEN GIGANTE.SLDASM

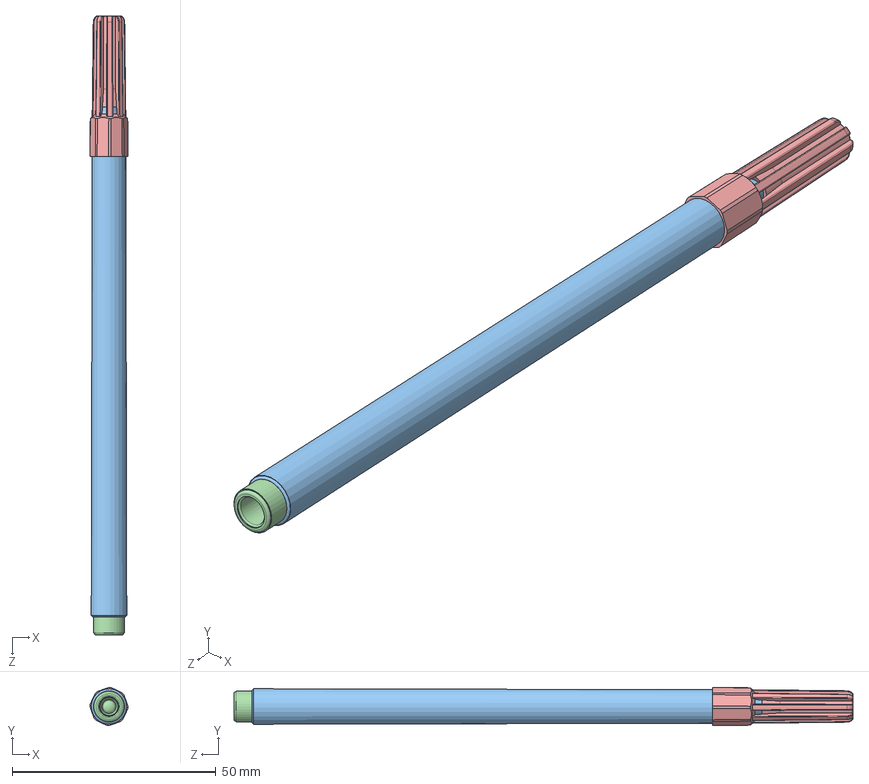
[picture p183: CAD file, 2026-10-30]
src/main/webapp/assets/Produtos/00-00 - BASE DE DADOS/23.11.04-04-REV00 - NEO PEN GIGANTE.SLDASM
9.36 x 9.36 x 152.0 mm
23.06.01-06-REV00 - PAVIO NEO PEN GIGANTE - 2D
23.10.05-05.4-REV00 - PONTA NEO PEN (POREX)
23.11.04-01-REV00 - CORPO NEO PEN GIGANTE 3D
23.11.04-03-REV00 - TAMPINHA NEO PEN 3D
23.11.04-02-REV00 - TAMPA NEO PEN 3D
