LcAvila/grade_moldes/src/main/webapp/assets/Produtos/00-00 - BASE DE DADOS/23.06.08-04-REV00 - MARCADOR DESTAQ 3D.SLDASM

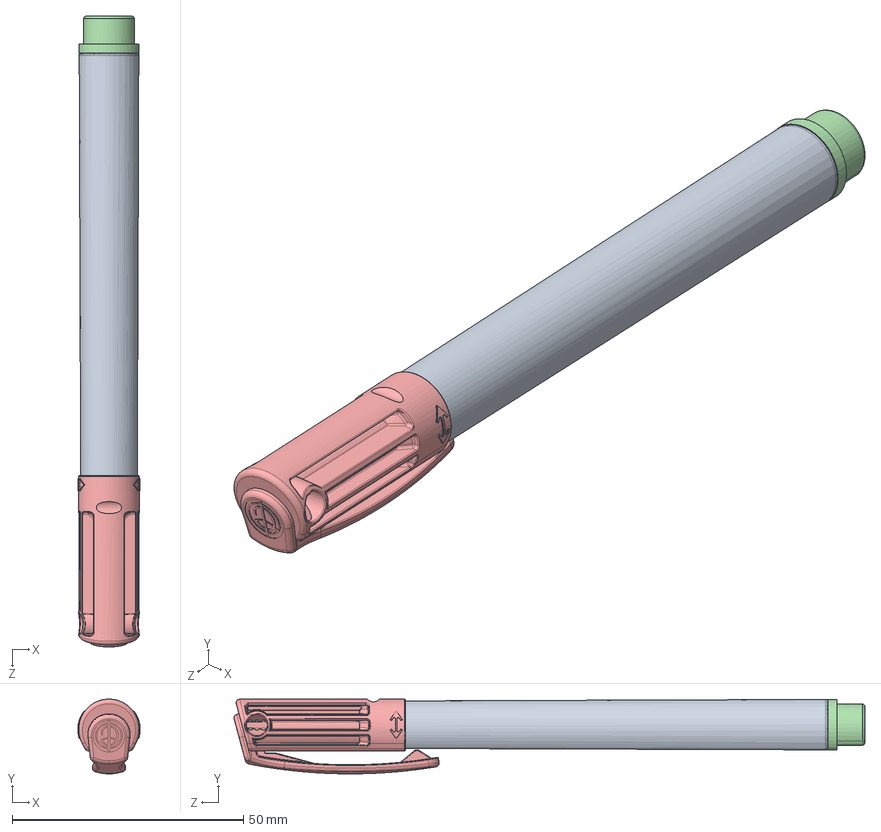
[picture p184: CAD file, 2026-10-30]
src/main/webapp/assets/Produtos/00-00 - BASE DE DADOS/23.06.08-04-REV00 - MARCADOR DESTAQ 3D.SLDASM
13.5 x 16.2 x 136.4 mm
23.06.08-1 _ Corpo Destaq 3D (REV 0)
23.06.01-3 - Pavio Destaq 3D
23.10.05-5.5 - Ponta Chanfrada DESTAQ 3D
23.06.08-2 - TAMPINHA DESTAQ 3D (Rev.00)
23.06.08 - 3_Tampa DESTAQ - 3D (REV 0)
