LcAvila/grade_moldes/src/main/webapp/assets/Produtos/00-00 - BASE DE DADOS/23.05.01-16-REV00 - ESF. COMPACTOR ECONOMIC FINA.SLDASM

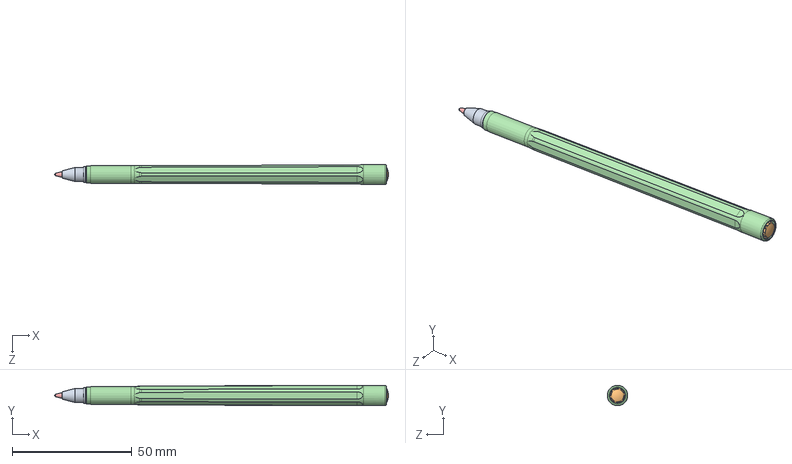
[picture p185: CAD file, 2026-10-30]
src/main/webapp/assets/Produtos/00-00 - BASE DE DADOS/23.05.01-16-REV00 - ESF. COMPACTOR ECONOMIC FINA.SLDASM
139.4 x 8.55 x 8.55 mm
23.05.01-07-REV00 - TAMPINHA ESF (MOLDE 97 e 140 - 64 CAV)
23.05.01-06-REV05 - CONEXÃO ESF. PADRÃO (DESENHO)
23.05.01-08-REV00 - TUBO ESF.
23.05.01-01-REV00 - CORPO SEXTAVADO ESF. COMPACTOR
23.05.01-09-REV01 - PONTEIRA ø0,8
