LcAvila/grade_moldes/src/main/webapp/assets/Produtos/00-00 - BASE DE DADOS/23.05.04-08-REV00 COMPACTOR SMART - 3D.SLDASM

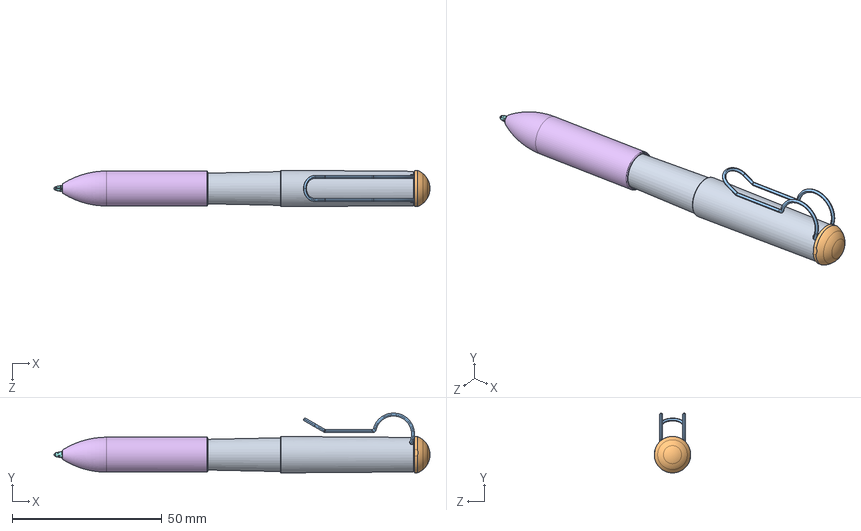
[picture p186: CAD file, 2026-10-30]
src/main/webapp/assets/Produtos/00-00 - BASE DE DADOS/23.05.04-08-REV00 COMPACTOR SMART - 3D.SLDASM
125.7 x 20.0 x 12.2 mm
23.05.04-02-REV00 CAMISA COMPACTOR SMART
23.05.04-03-REV00 TAMPA COMPACTOR SMART
23.05.04-05-REV00 CLIPS COMPACTOR SMART
23.05.04-04-REV00 MECANISMO COMPACTOR SMART
23.05.04-06-REV00 ANEL ELASTICO COMPACTOR SMART
23.05.04-01-REV00 DIANTEIRA COMPACTOR SMART
23.05.04-07-REV00 - MOLA COMPACTOR SMART (TRACIONADO)
23.06.06-01-REV00 Carga 1007
