LcAvila/grade_moldes/src/main/webapp/assets/Produtos/00-00 - BASE DE DADOS/23.05.01-14-REV00 07 POP.SLDASM

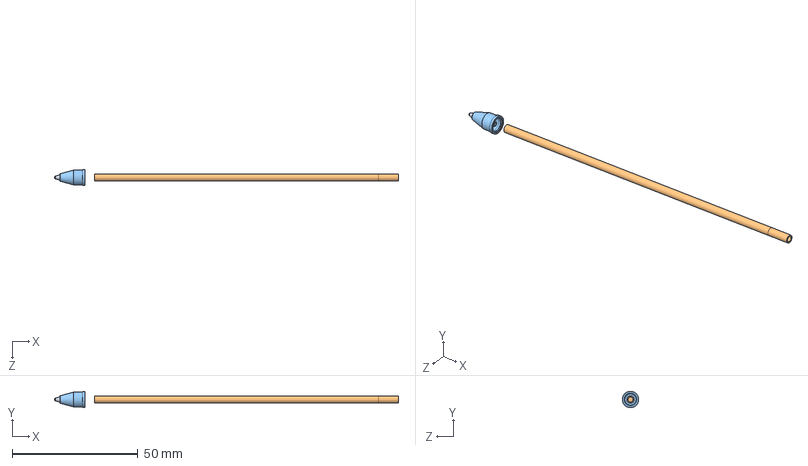
[picture p187: CAD file, 2026-10-30]
src/main/webapp/assets/Produtos/00-00 - BASE DE DADOS/23.05.01-14-REV00 07 POP.SLDASM
136.9 x 6.50 x 6.50 mm
23.05.01-10-REV00 PONTEIRA ø1,00mm
23.05.01-08-REV00 - TUBO ESF.
23.05.01-06-REV05 - CONEXÃO ESF. PADRÃO (DESENHO)
