LcAvila/grade_moldes/src/main/webapp/assets/Produtos/00-00 - BASE DE DADOS/23.05.02-09-REV00 - ESF 07 VIP RETRÁTIL (COMPACTOR).SLDASM

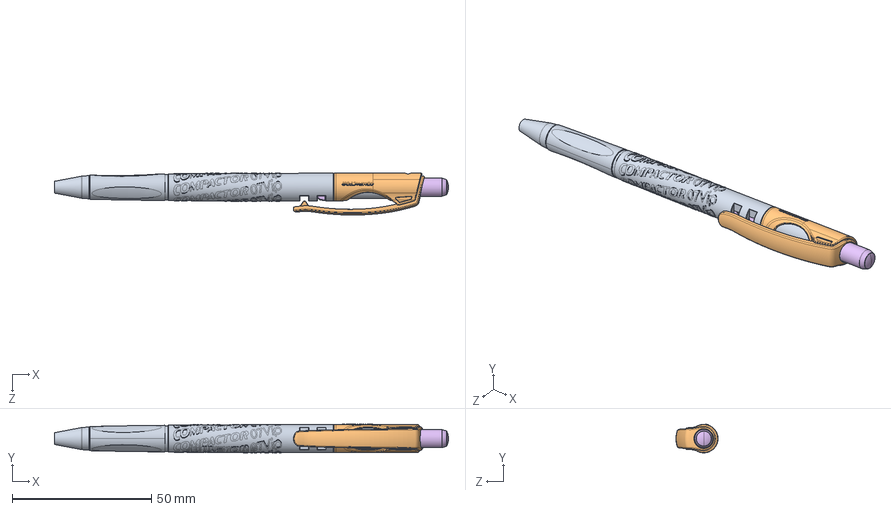
[picture p189: CAD file, 2026-10-30]
src/main/webapp/assets/Produtos/00-00 - BASE DE DADOS/23.05.02-09-REV00 - ESF 07 VIP RETRÁTIL (COMPACTOR).SLDASM
141.6 x 10.3 x 15.1 mm
23.05.01-02REV00 - CORPO VIP RETRÁTIL - 3D
23.05.02-03-REV00 - TAMPA CLIP VIP RETRATIL - 3D
23.05.02-04-REV01 - TUBO DE CARGA VIP RETRÁTIL
23.05.01-10-REV00 PONTEIRA ø1,00mm
23.05.02-07-REV00 MOLA 0,4 (COMPRIMIDA)
23.05.02-02-REV00 BOTÃO VIP RETRÁTIL - 3D
