LcAvila/grade_moldes/src/main/webapp/assets/Produtos/00-00 - BASE DE DADOS/Componentes/Hidrográficas e Marcadores/24.02.02-00 MONT. MICROLINE 3D.SLDASM

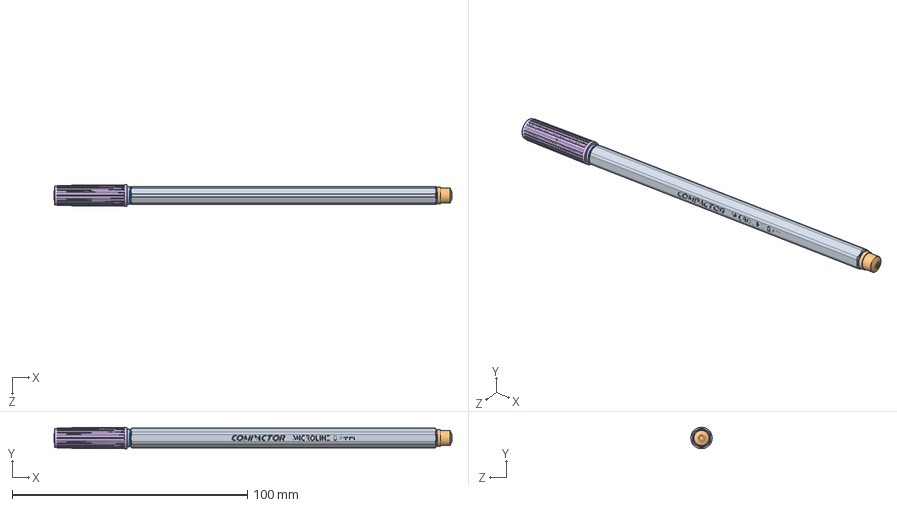
[picture p190: CAD file, 2026-10-30]
src/main/webapp/assets/Produtos/00-00 - BASE DE DADOS/Componentes/Hidrográficas e Marcadores/24.02.02-00 MONT. MICROLINE 3D.SLDASM
169.2 x 9.15 x 9.14 mm
CORPO DE MICROLINE
Tampinha Microline
CONEXÃO MICROLINE
Pavio microline
Ponteira Microline
Tampa Microline -152
