LcAvila/grade_moldes/src/main/webapp/assets/Produtos/00-00 - BASE DE DADOS/Componentes/Esferográficas/23.06.03-09-REV00 - MONT. CORPO TINTEIRO 01.SLDASM

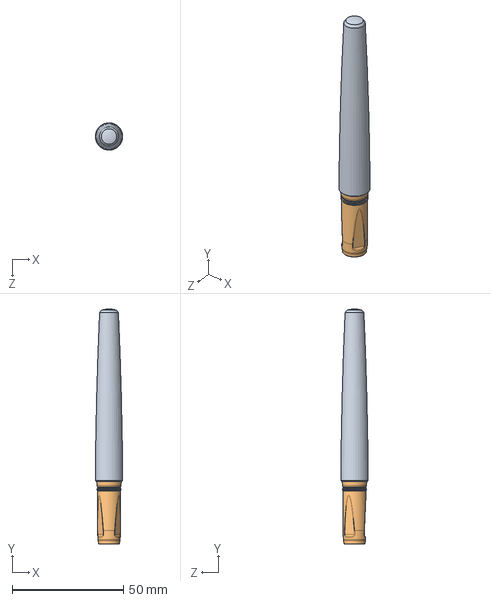
[picture p191: CAD file, 2026-10-30]
src/main/webapp/assets/Produtos/00-00 - BASE DE DADOS/Componentes/Esferográficas/23.06.03-09-REV00 - MONT. CORPO TINTEIRO 01.SLDASM
12.3 x 105.4 x 12.3 mm
23.06.03-4 - Corpo Caneta Tinteiro 01
23.06.03-3 - Dianteira Caneta Tinteiro 01
