LcAvila/grade_moldes/src/main/webapp/assets/imagens e grades moldes/Esferográficas/Conexão/23.05.01-06-REV05 - CONEXÃO ESF. PADRÃO (DESENHO).SLDPRT

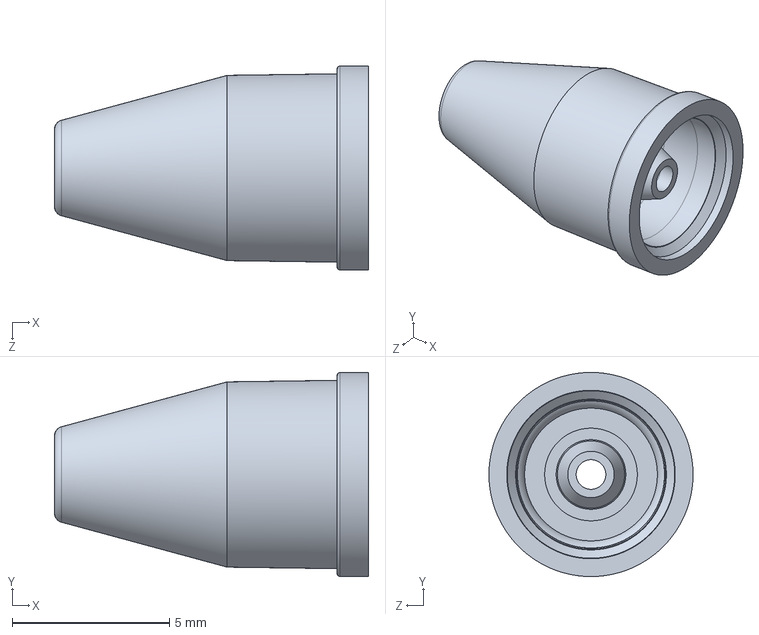
[picture p192: CAD file, 2026-10-29]
src/main/webapp/assets/imagens e grades moldes/Esferográficas/Conexão/23.05.01-06-REV05 - CONEXÃO ESF. PADRÃO (DESENHO).SLDPRT
10.00 x 6.50 x 6.50 mm
