LcAvila/grade_moldes/src/main/webapp/assets/models/molde-107.stl

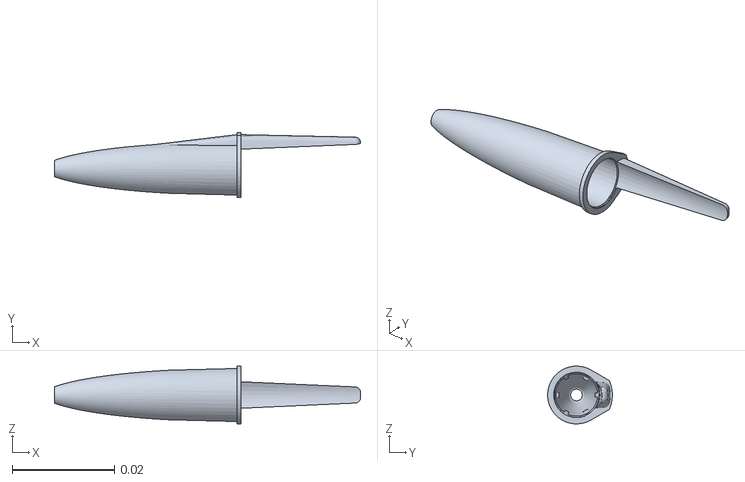
[picture p193: CAD file, 2026-11-05]
src/main/webapp/assets/models/molde-107.stl
0.0599 x 0.0127 x 0.0113
