LcAvila/grade_moldes/src/main/webapp/assets/Produtos/00-00 - BASE DE DADOS/Componentes/Esferográficas/23.06.05-05-REV00 - MOLA SENATOR N2 D 0.2mm x 19.60mm.SLDPRT

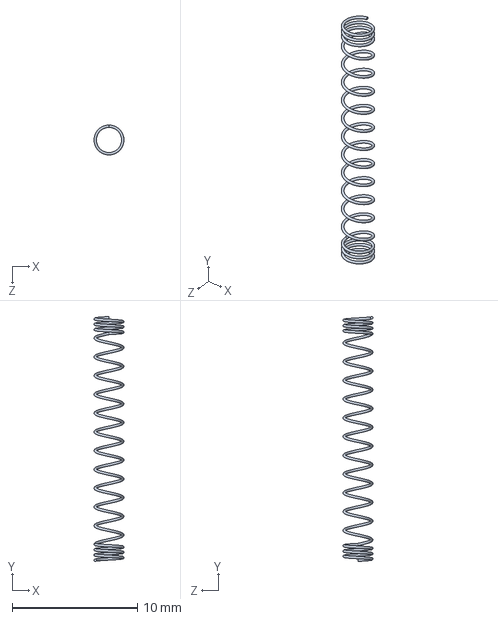
[picture p194: CAD file, 2026-10-30]
src/main/webapp/assets/Produtos/00-00 - BASE DE DADOS/Componentes/Esferográficas/23.06.05-05-REV00 - MOLA SENATOR N2 D 0.2mm x 19.60mm.SLDPRT
2.40 x 19.6 x 2.40 mm
