LcAvila/grade_moldes/src/main/webapp/assets/Produtos/00-00 - BASE DE DADOS/Componentes/Hidrográficas e Marcadores/23.10.04 -1 _ CORPO PINCEL MARCADOR (3D).SLDPRT

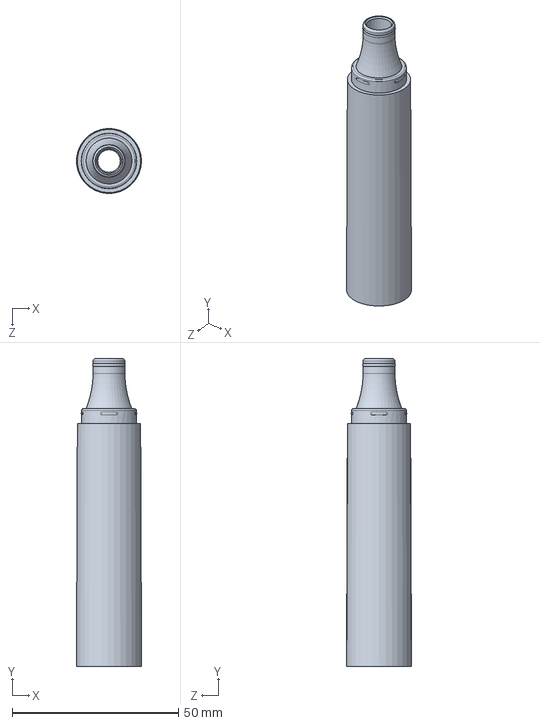
[picture p195: CAD file, 2026-10-30]
src/main/webapp/assets/Produtos/00-00 - BASE DE DADOS/Componentes/Hidrográficas e Marcadores/23.10.04 -1 _ CORPO PINCEL MARCADOR (3D).SLDPRT
19.6 x 92.5 x 19.5 mm
