LcAvila/grade_moldes/src/main/webapp/assets/Produtos/00-00 - BASE DE DADOS/Componentes/Lapiseiras/00.08.23-REV00-Conexão do mecanismo.SLDPRT

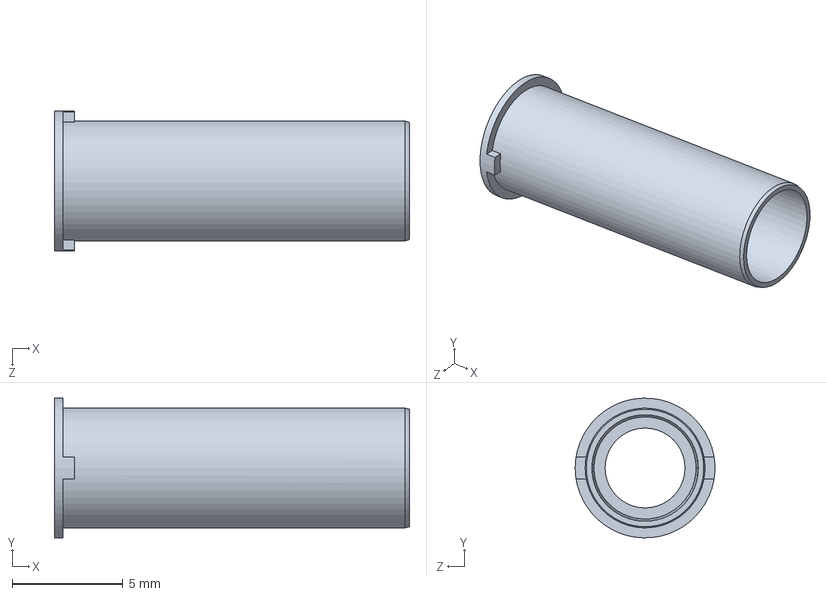
[picture p196: CAD file, 2026-10-30]
src/main/webapp/assets/Produtos/00-00 - BASE DE DADOS/Componentes/Lapiseiras/00.08.23-REV00-Conexão do mecanismo.SLDPRT
16.0 x 6.30 x 6.29 mm
