LcAvila/grade_moldes/src/main/webapp/assets/Produtos/00-00 - BASE DE DADOS/Embalagens/Caixas Master/Caixa Master N°106.SLDPRT

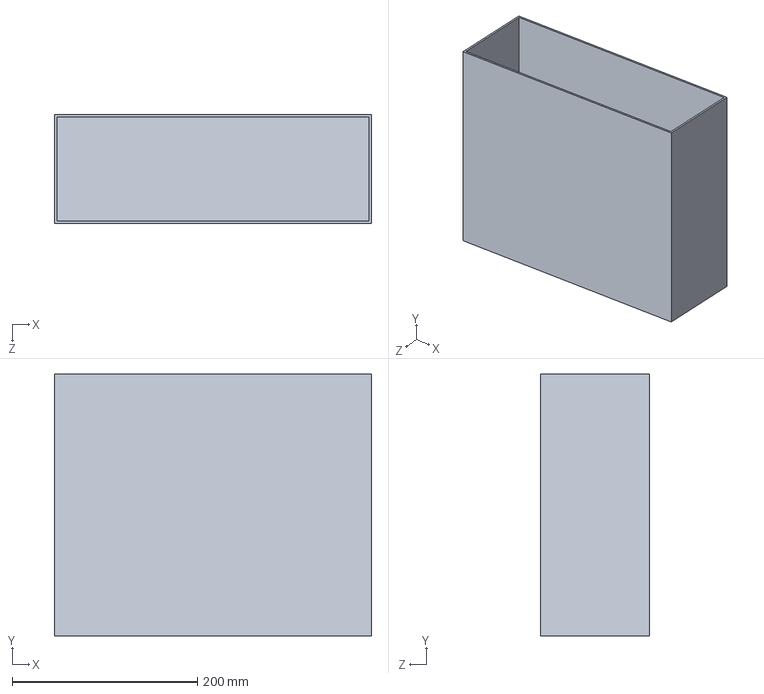
[picture p197: CAD file, 2026-10-30]
src/main/webapp/assets/Produtos/00-00 - BASE DE DADOS/Embalagens/Caixas Master/Caixa Master N°106.SLDPRT
342.2 x 282.6 x 117.2 mm
