LcAvila/grade_moldes/src/main/webapp/assets/Produtos/A2-17 - Destaq/11.12.10-REV00 - PONTA CHANFRADA DESTAQ - 3D.SLDPRT

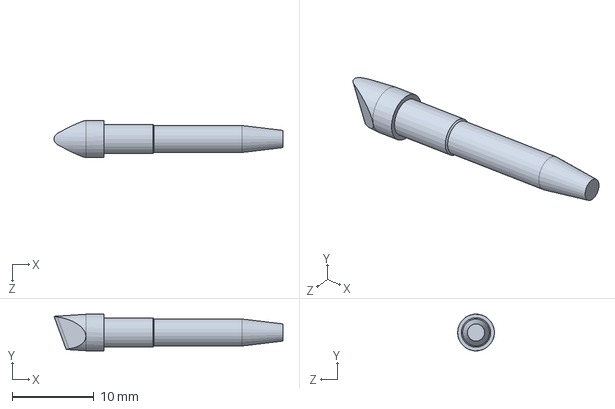
[picture p198: CAD file, 2026-10-30]
src/main/webapp/assets/Produtos/A2-17 - Destaq/11.12.10-REV00 - PONTA CHANFRADA DESTAQ - 3D.SLDPRT
28.0 x 4.49 x 4.50 mm
