LcAvila/grade_moldes/src/main/webapp/assets/Produtos/A2-27 - Vai-e-Volta/23.10.05-05.4-REV00 - PONTA NEO PEN (POREX).SLDPRT

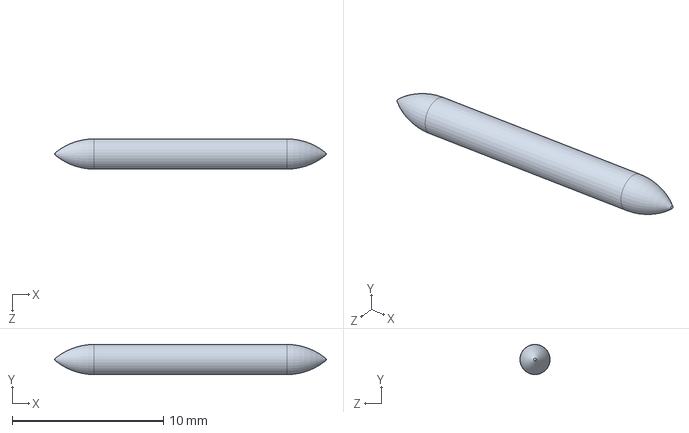
[picture p199: CAD file, 2026-10-30]
src/main/webapp/assets/Produtos/A2-27 - Vai-e-Volta/23.10.05-05.4-REV00 - PONTA NEO PEN (POREX).SLDPRT
18.0 x 1.99 x 2.00 mm
