LcAvila/grade_moldes/src/main/webapp/assets/models/molde-117.stl

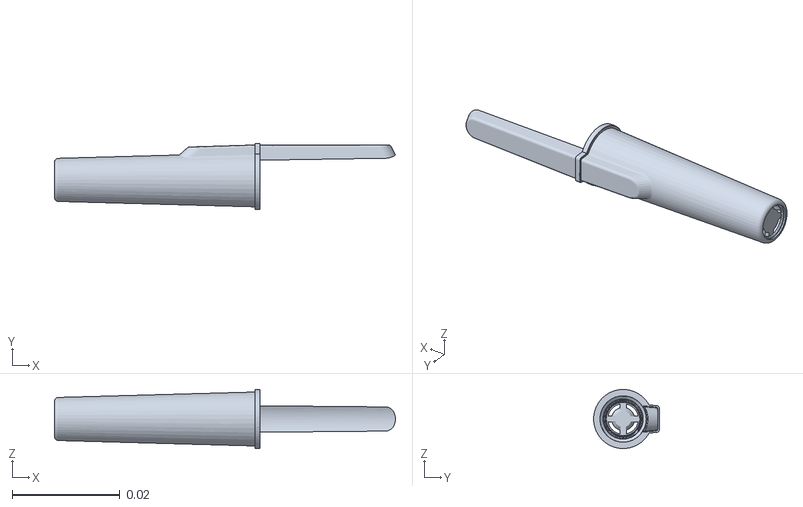
[picture p200: CAD file, 2026-11-05]
src/main/webapp/assets/models/molde-117.stl
0.0632 x 0.0122 x 0.0109
