LcAvila/grade_moldes/src/main/webapp/assets/Produtos/00-00 - BASE DE DADOS/Componentes/Esferográficas/23.06.06-01-REV00 Carga 1007.SLDPRT

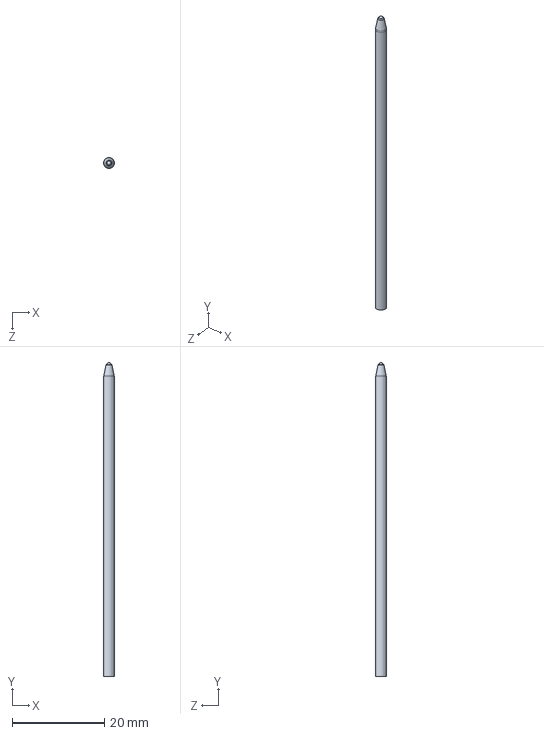
[picture p201: CAD file, 2026-10-30]
src/main/webapp/assets/Produtos/00-00 - BASE DE DADOS/Componentes/Esferográficas/23.06.06-01-REV00 Carga 1007.SLDPRT
2.35 x 68.1 x 2.35 mm
