LcAvila/grade_moldes/src/main/webapp/assets/Produtos/00-00 - BASE DE DADOS/Componentes/Lapiseiras/23.07.02 - 2 - Dianteira Modificada _ Medida Interna.SLDPRT

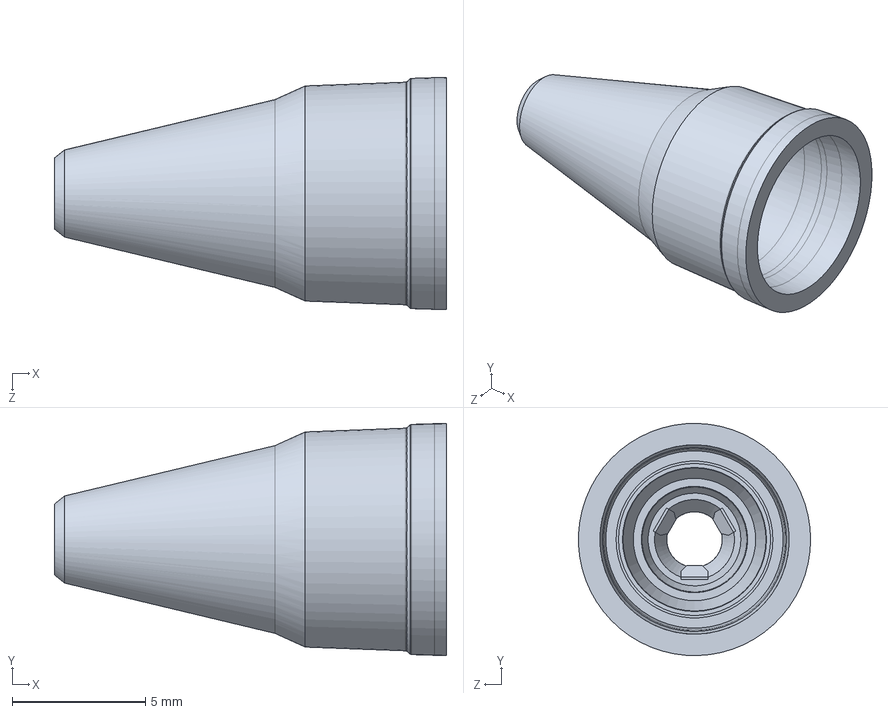
[picture p202: CAD file, 2026-10-30]
src/main/webapp/assets/Produtos/00-00 - BASE DE DADOS/Componentes/Lapiseiras/23.07.02 - 2 - Dianteira Modificada _ Medida Interna.SLDPRT
14.7 x 8.70 x 8.71 mm
