LcAvila/grade_moldes/src/main/webapp/assets/Produtos/00-00 - BASE DE DADOS/Componentes/Reabastecedores/23.10.06-1 (REV 01) - Bico Reabastecedor (PP) (15-08-2025).SLDPRT

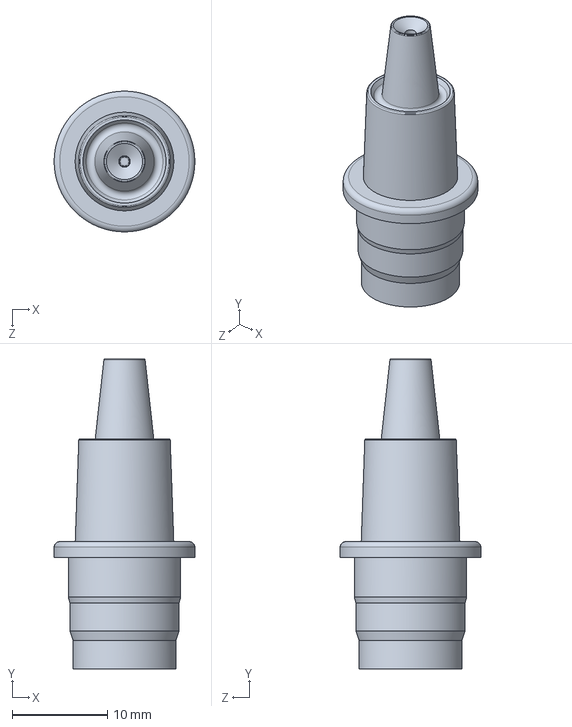
[picture p203: CAD file, 2026-10-30]
src/main/webapp/assets/Produtos/00-00 - BASE DE DADOS/Componentes/Reabastecedores/23.10.06-1 (REV 01) - Bico Reabastecedor (PP) (15-08-2025).SLDPRT
14.8 x 32.6 x 14.8 mm
