LcAvila/grade_moldes/src/main/webapp/assets/Produtos/A2-27 - Vai-e-Volta/23.06.01-06-REV00 - PAVIO NEO PEN GIGANTE - 2D.SLDPRT

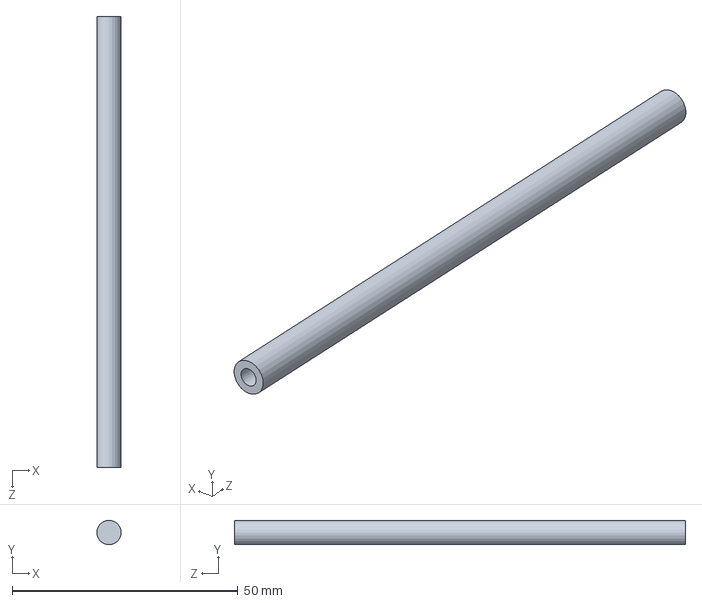
[picture p204: CAD file, 2026-10-30]
src/main/webapp/assets/Produtos/A2-27 - Vai-e-Volta/23.06.01-06-REV00 - PAVIO NEO PEN GIGANTE - 2D.SLDPRT
5.40 x 5.40 x 100.0 mm
