LcAvila/grade_moldes/src/main/webapp/assets/models/molde-184.stl

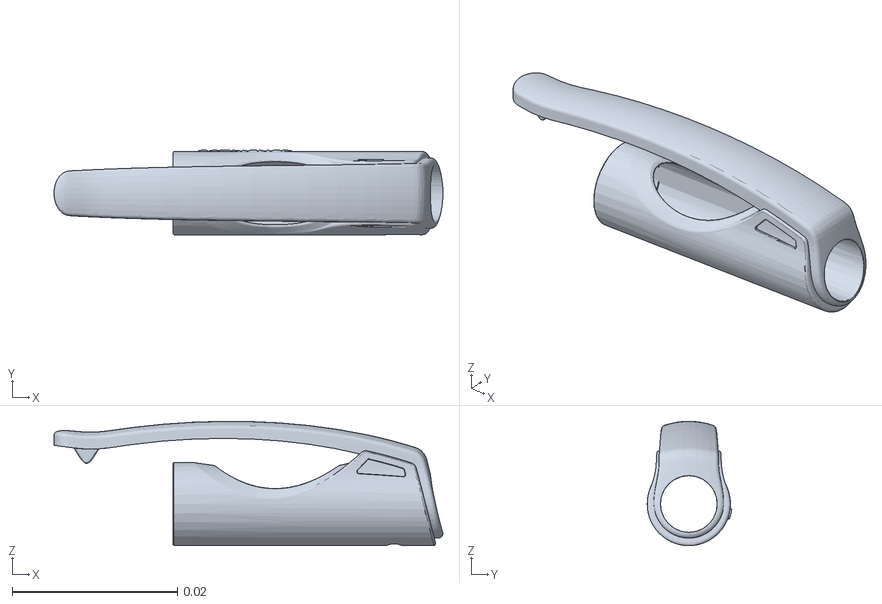
[picture p205: CAD file, 2026-11-05]
src/main/webapp/assets/models/molde-184.stl
0.047 x 0.0102 x 0.015
