LcAvila/grade_moldes/src/main/webapp/assets/Produtos/00-00 - BASE DE DADOS/Componentes/Hidrográficas e Marcadores/Fixador de ponta Vai e Volta.SLDPRT

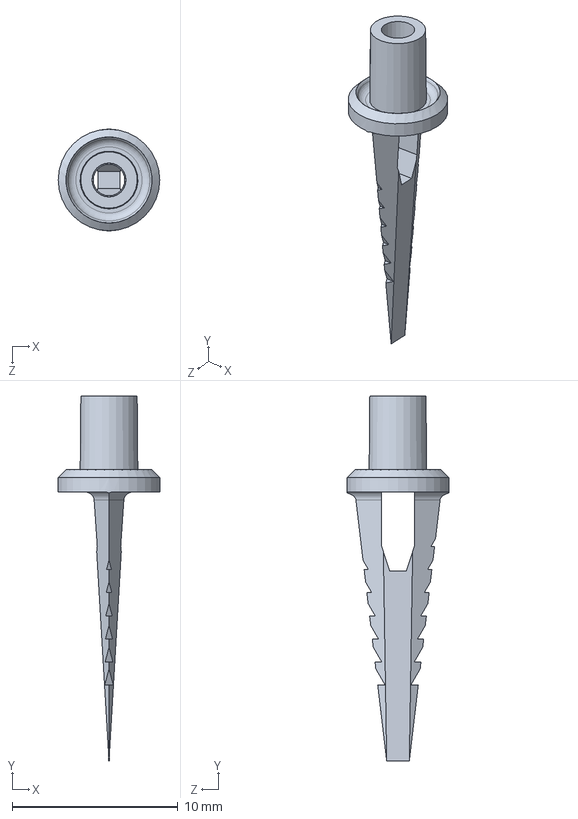
[picture p206: CAD file, 2026-10-30]
src/main/webapp/assets/Produtos/00-00 - BASE DE DADOS/Componentes/Hidrográficas e Marcadores/Fixador de ponta Vai e Volta.SLDPRT
6.14 x 22.1 x 6.14 mm
