LcAvila/grade_moldes/src/main/webapp/assets/Produtos/00-00 - BASE DE DADOS/Componentes/Lapiseiras/16.09.01-3-REV00-CLIPS Lap.Técnico.sldprt

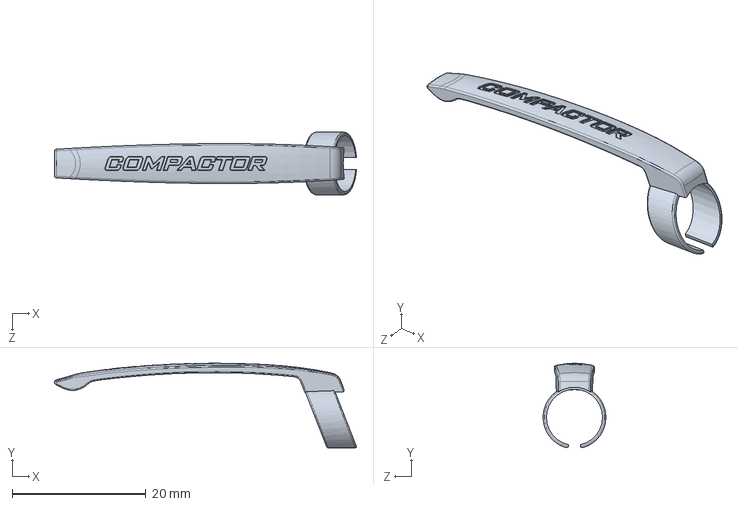
[picture p207: CAD file, 2026-10-30]
src/main/webapp/assets/Produtos/00-00 - BASE DE DADOS/Componentes/Lapiseiras/16.09.01-3-REV00-CLIPS Lap.Técnico.sldprt
45.2 x 12.7 x 9.40 mm
