LcAvila/grade_moldes/src/main/webapp/assets/Produtos/A2-27 - Vai-e-Volta/18.08.2025-01-REV00 - TAMPA NEO PEN VAI E VOLTA 7.SLDPRT

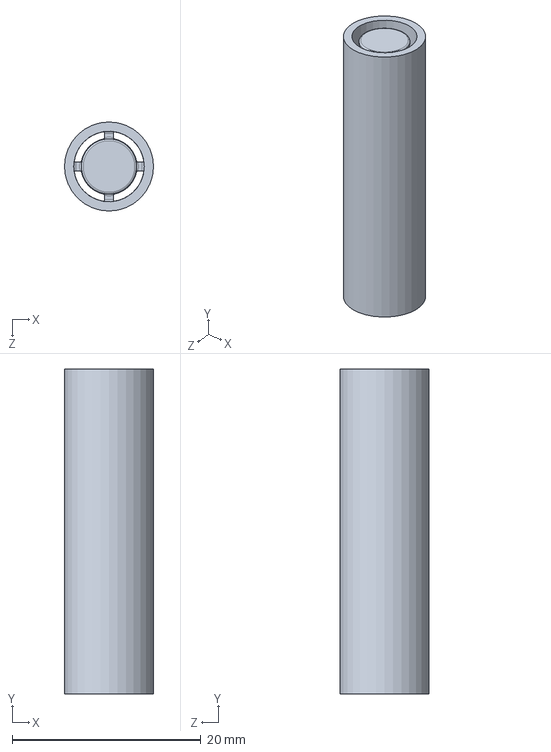
[picture p208: CAD file, 2026-10-30]
src/main/webapp/assets/Produtos/A2-27 - Vai-e-Volta/18.08.2025-01-REV00 - TAMPA NEO PEN VAI E VOLTA 7.SLDPRT
9.43 x 34.4 x 9.43 mm
