LcAvila/grade_moldes/src/main/webapp/assets/models/molde-183.stl

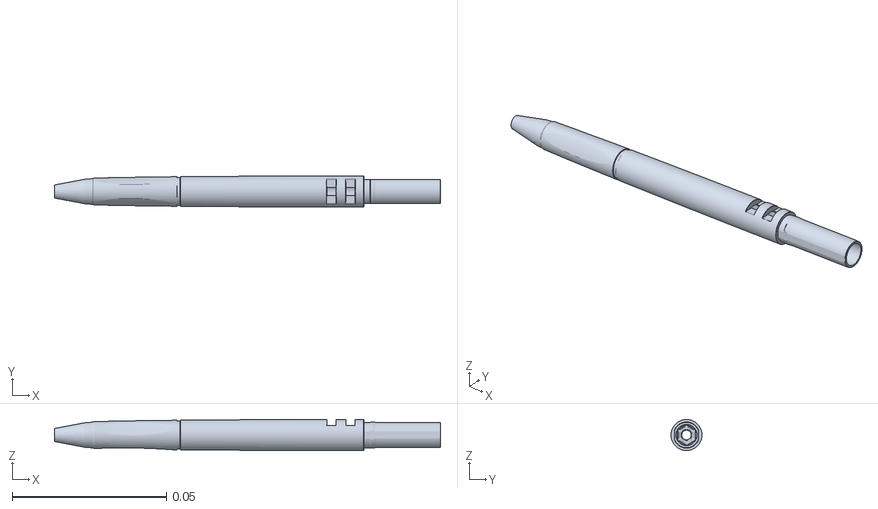
[picture p209: CAD file, 2026-11-05]
src/main/webapp/assets/models/molde-183.stl
0.125 x 0.0101 x 0.0101
