LcAvila/grade_moldes/src/main/webapp/assets/Produtos/00-00 - BASE DE DADOS/Componentes/Esferográficas/23.05.04-06-REV00 ANEL ELASTICO COMPACTOR SMART.SLDPRT

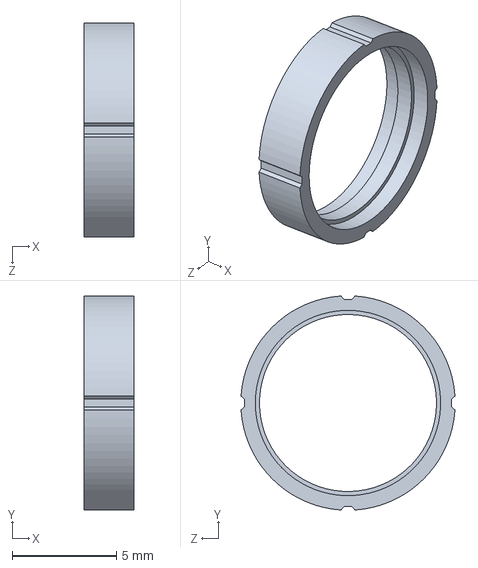
[picture p210: CAD file, 2026-10-30]
src/main/webapp/assets/Produtos/00-00 - BASE DE DADOS/Componentes/Esferográficas/23.05.04-06-REV00 ANEL ELASTICO COMPACTOR SMART.SLDPRT
2.40 x 10.3 x 10.3 mm
