LcAvila/grade_moldes/src/main/webapp/assets/Produtos/A2-27 - Vai-e-Volta/23.11.04-03-REV00 - TAMPINHA NEO PEN VAI E VOLTA 3D.SLDPRT

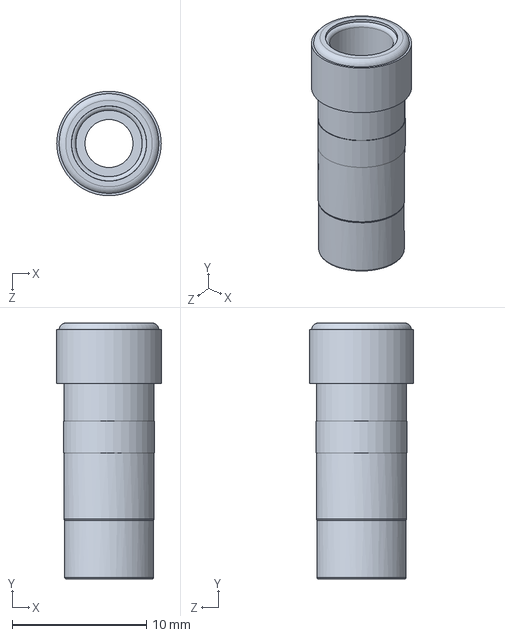
[picture p211: CAD file, 2026-10-30]
src/main/webapp/assets/Produtos/A2-27 - Vai-e-Volta/23.11.04-03-REV00 - TAMPINHA NEO PEN VAI E VOLTA 3D.SLDPRT
7.80 x 19.1 x 7.77 mm
