LcAvila/grade_moldes/src/main/webapp/assets/models/molde-185.stl

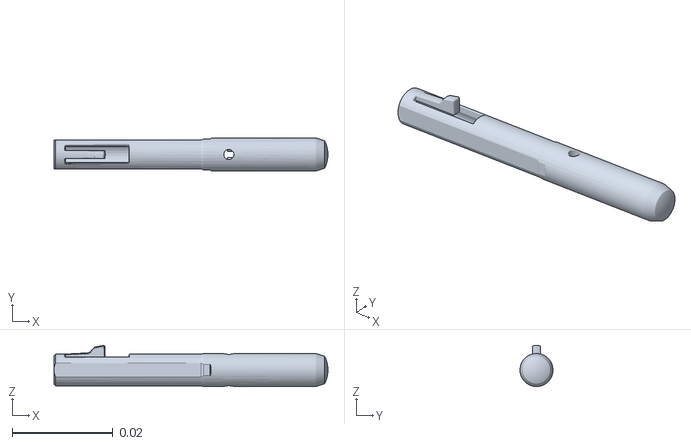
[picture p212: CAD file, 2026-11-05]
src/main/webapp/assets/models/molde-185.stl
0.0543 x 0.00654 x 0.00813
