LcAvila/grade_moldes/src/main/webapp/assets/Produtos/00-00 - BASE DE DADOS/Componentes/Esferográficas/23.05.04-07-REV00 - MOLA COMPACTOR SMART(REPOUSO).SLDPRT

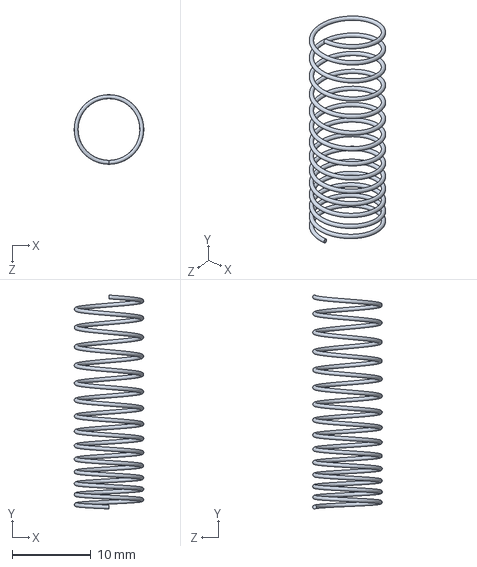
[picture p213: CAD file, 2026-10-30]
src/main/webapp/assets/Produtos/00-00 - BASE DE DADOS/Componentes/Esferográficas/23.05.04-07-REV00 - MOLA COMPACTOR SMART(REPOUSO).SLDPRT
8.85 x 27.2 x 8.85 mm
