LcAvila/grade_moldes/src/main/webapp/assets/Produtos/00-00 - BASE DE DADOS/Componentes/Hidrográficas e Marcadores/23.11.04-02-REV00 - TAMPA NEO PEN 3D.SLDPRT

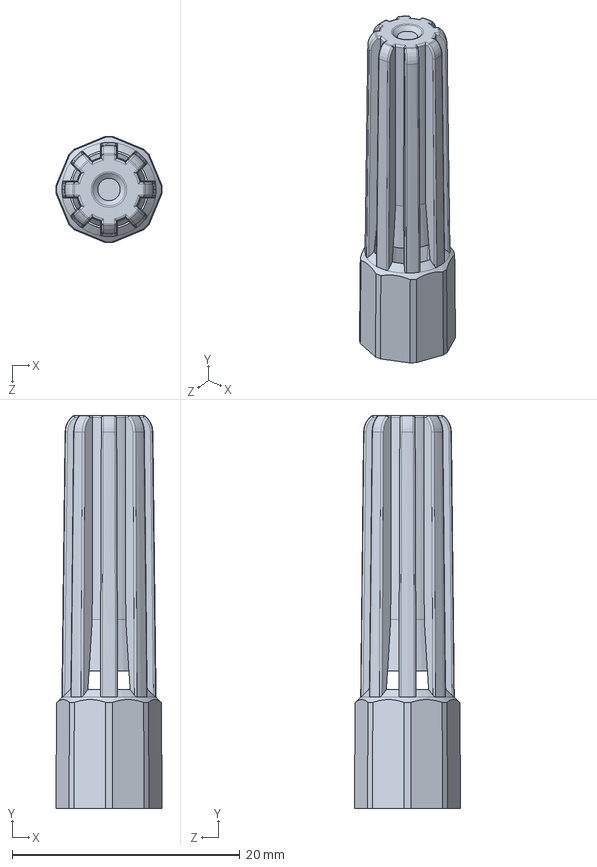
[picture p214: CAD file, 2026-10-30]
src/main/webapp/assets/Produtos/00-00 - BASE DE DADOS/Componentes/Hidrográficas e Marcadores/23.11.04-02-REV00 - TAMPA NEO PEN 3D.SLDPRT
9.34 x 34.5 x 9.34 mm
