LcAvila/grade_moldes/src/main/webapp/assets/models/CAPA DIANTEIRA DUO PLUS.stl

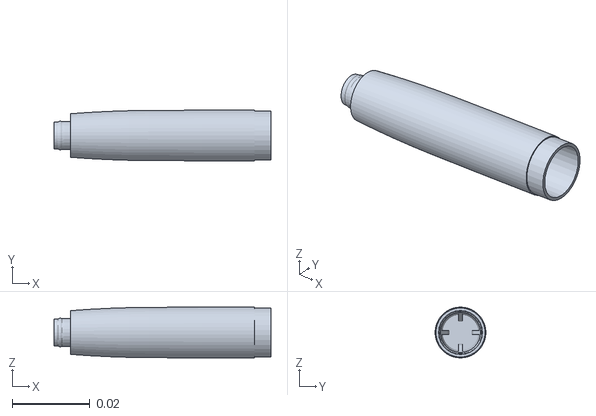
[picture p216: CAD file, 2026-11-05]
src/main/webapp/assets/models/CAPA DIANTEIRA DUO PLUS.stl
0.0557 x 0.013 x 0.013
