LcAvila/grade_moldes/src/main/webapp/assets/Produtos/00-00 - BASE DE DADOS/Componentes/Esferográficas/23.06.02-01-REV00 - CAPA DIANTEIRA DUO PLUS.SLDPRT

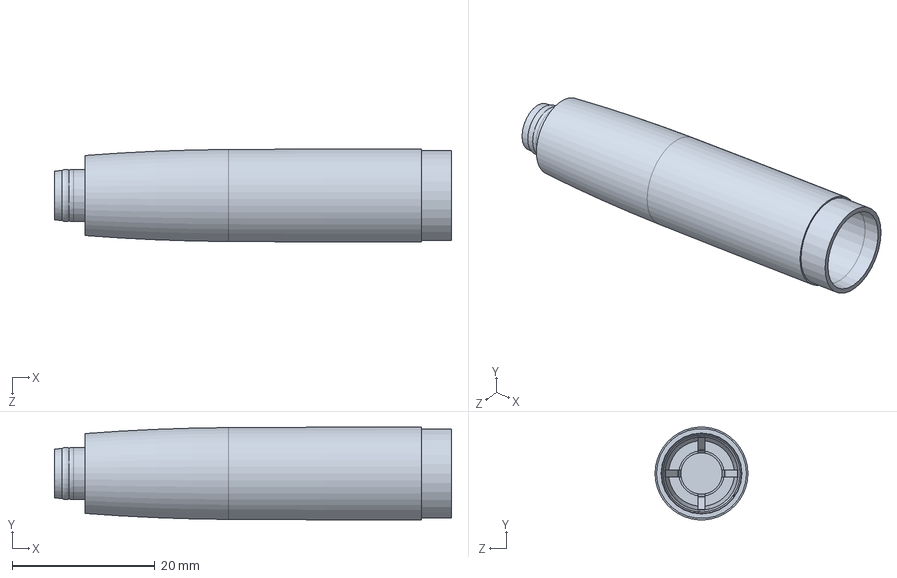
[picture p217: CAD file, 2026-10-30]
src/main/webapp/assets/Produtos/00-00 - BASE DE DADOS/Componentes/Esferográficas/23.06.02-01-REV00 - CAPA DIANTEIRA DUO PLUS.SLDPRT
55.7 x 13.0 x 13.0 mm
