LcAvila/grade_moldes/src/main/webapp/assets/Produtos/00-00 - BASE DE DADOS/Componentes/Hidrográficas e Marcadores/23.06.01-05-REV00 - PAVIO NEO PEN MIRIM - 2D.SLDPRT

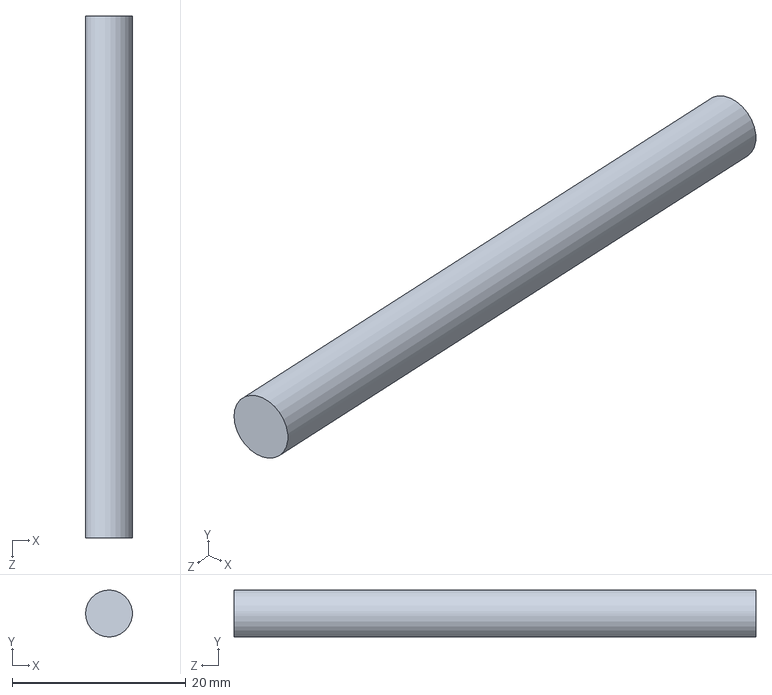
[picture p218: CAD file, 2026-10-30]
src/main/webapp/assets/Produtos/00-00 - BASE DE DADOS/Componentes/Hidrográficas e Marcadores/23.06.01-05-REV00 - PAVIO NEO PEN MIRIM - 2D.SLDPRT
5.40 x 5.39 x 60.0 mm
