LcAvila/grade_moldes/src/main/webapp/assets/Produtos/00-00 - BASE DE DADOS/Componentes/Lapiseiras/13.03.05-REV02-BotãoLapi. Técnico.SLDPRT

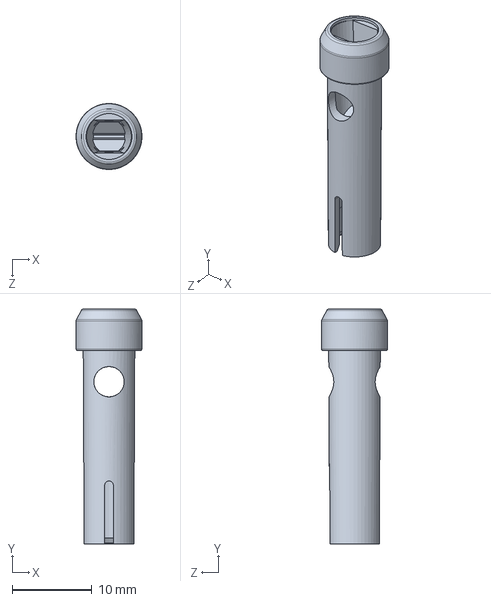
[picture p219: CAD file, 2026-10-30]
src/main/webapp/assets/Produtos/00-00 - BASE DE DADOS/Componentes/Lapiseiras/13.03.05-REV02-BotãoLapi. Técnico.SLDPRT
8.28 x 29.5 x 8.28 mm
