LcAvila/grade_moldes/src/main/webapp/assets/models/molde-200.stl

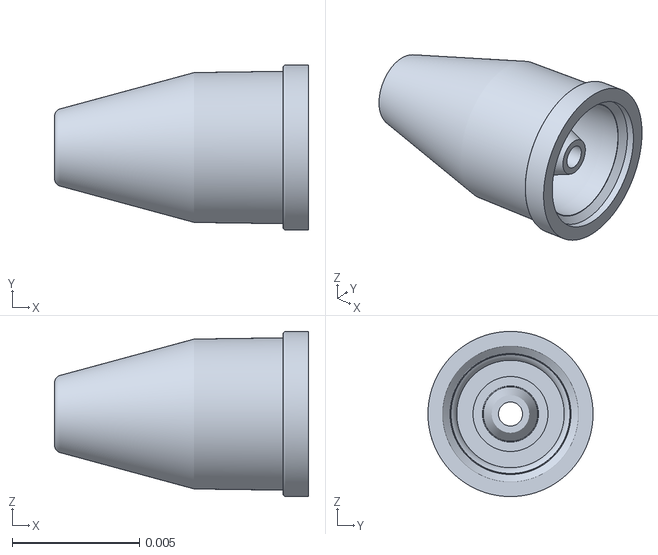
[picture p220: CAD file, 2026-11-05]
src/main/webapp/assets/models/molde-200.stl
0.01 x 0.0065 x 0.0065
