LcAvila/grade_moldes/src/main/webapp/assets/Produtos/00-00 - BASE DE DADOS/Componentes/Esferográficas/23.06.04-06-REV00 - DIANTEIRA ESF. BUSCHLER 201.SLDPRT

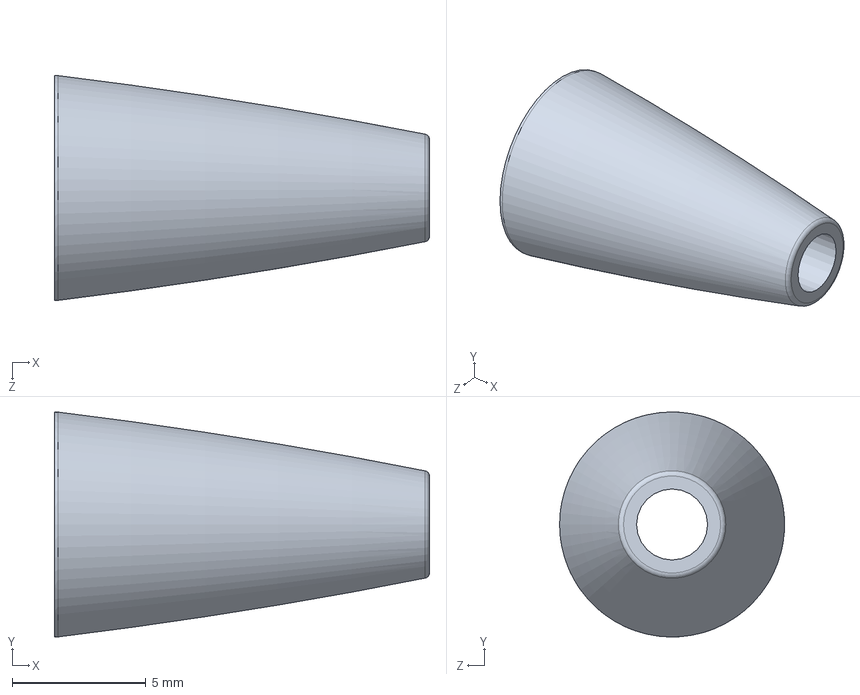
[picture p221: CAD file, 2026-10-30]
src/main/webapp/assets/Produtos/00-00 - BASE DE DADOS/Componentes/Esferográficas/23.06.04-06-REV00 - DIANTEIRA ESF. BUSCHLER 201.SLDPRT
14.0 x 8.40 x 8.39 mm
