LcAvila/grade_moldes/src/main/webapp/assets/Produtos/00-00 - BASE DE DADOS/Componentes/Hidrográficas e Marcadores/24.02.02-01 CORPO MICROLINE 3D.SLDPRT

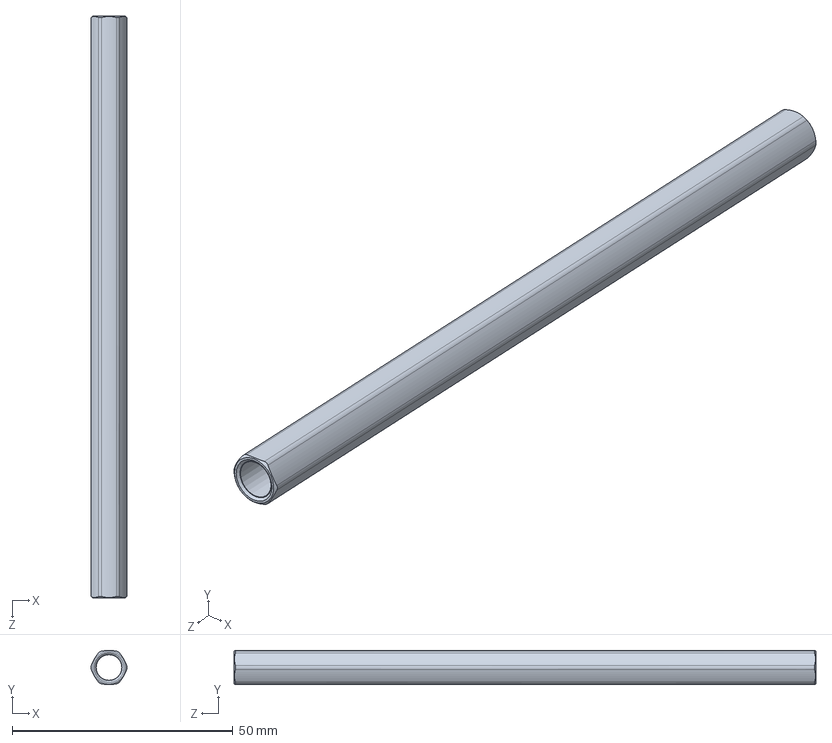
[picture p222: CAD file, 2026-10-30]
src/main/webapp/assets/Produtos/00-00 - BASE DE DADOS/Componentes/Hidrográficas e Marcadores/24.02.02-01 CORPO MICROLINE 3D.SLDPRT
8.25 x 7.70 x 131.7 mm
