LcAvila/grade_moldes/src/main/webapp/assets/models/molde-140.stl

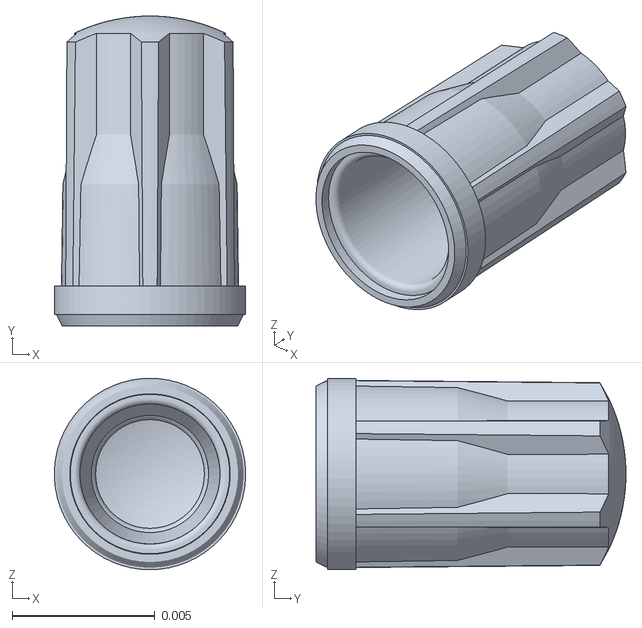
[picture p223: CAD file, 2026-11-05]
src/main/webapp/assets/models/molde-140.stl
0.00669 x 0.0109 x 0.0067
