LcAvila/grade_moldes/src/main/webapp/assets/Produtos/00-00 - BASE DE DADOS/Componentes/Hidrográficas e Marcadores/24.01.03-02-REV00 - CORPO MARCADOR QB - 3D.SLDPRT

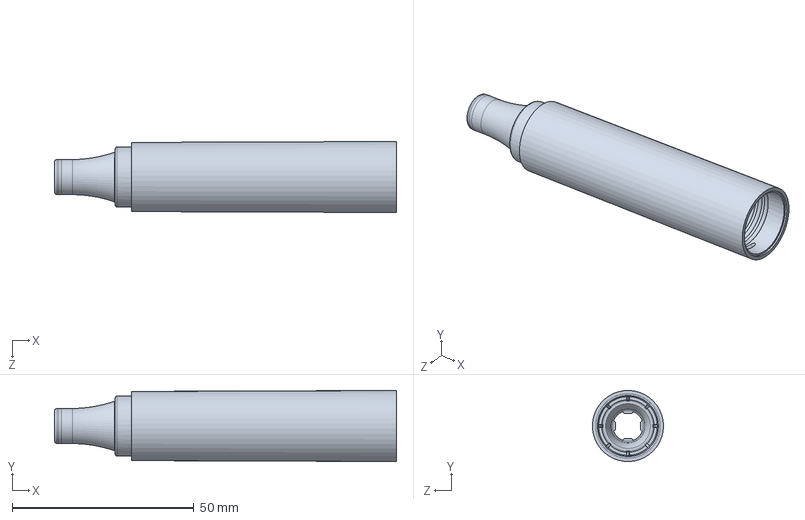
[picture p224: CAD file, 2026-10-30]
src/main/webapp/assets/Produtos/00-00 - BASE DE DADOS/Componentes/Hidrográficas e Marcadores/24.01.03-02-REV00 - CORPO MARCADOR QB - 3D.SLDPRT
94.1 x 19.6 x 19.5 mm
