LcAvila/grade_moldes/src/main/webapp/assets/models/conexao-padrao.stl

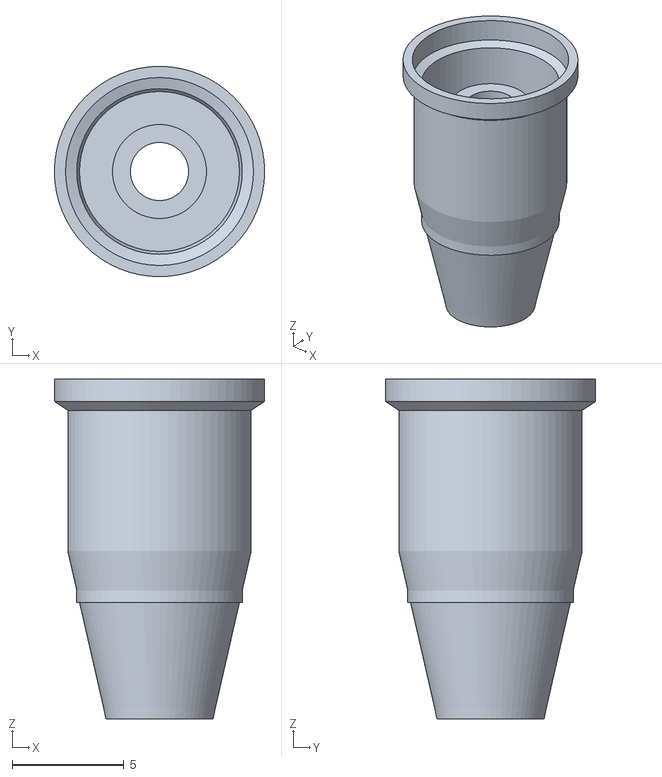
[picture p226: CAD file, 2026-10-29]
src/main/webapp/assets/models/conexao-padrao.stl
9.40 x 9.40 x 15.2
