LcAvila/grade_moldes/src/main/webapp/assets/Produtos/00-00 - BASE DE DADOS/Componentes/Esferográficas/23.06.03-06-REV00 - MECÂNISMO (PÇ3) TINTEIRO 01.SLDPRT

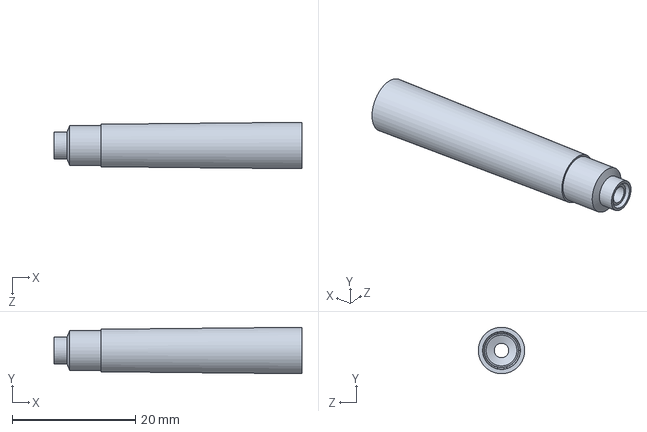
[picture p227: CAD file, 2026-10-30]
src/main/webapp/assets/Produtos/00-00 - BASE DE DADOS/Componentes/Esferográficas/23.06.03-06-REV00 - MECÂNISMO (PÇ3) TINTEIRO 01.SLDPRT
40.3 x 7.54 x 7.55 mm
