LcAvila/grade_moldes/src/main/webapp/assets/Produtos/00-00 - BASE DE DADOS/Componentes/Hidrográficas e Marcadores/24.01.03-1-REV00-TAMPINHA QB E PINCEL.SLDPRT

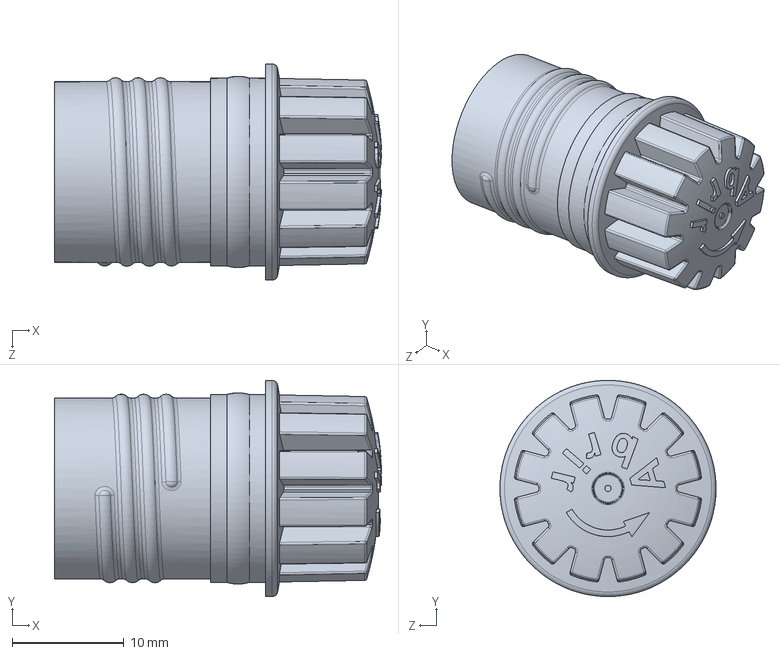
[picture p228: CAD file, 2026-10-30]
src/main/webapp/assets/Produtos/00-00 - BASE DE DADOS/Componentes/Hidrográficas e Marcadores/24.01.03-1-REV00-TAMPINHA QB E PINCEL.SLDPRT
29.3 x 19.4 x 19.4 mm
