LcAvila/grade_moldes/src/main/webapp/assets/Produtos/00-00 - BASE DE DADOS/Componentes/Esferográficas/23.06.05-06-REV00 - FEMEA DO MECANISMO SENATOR.SLDPRT

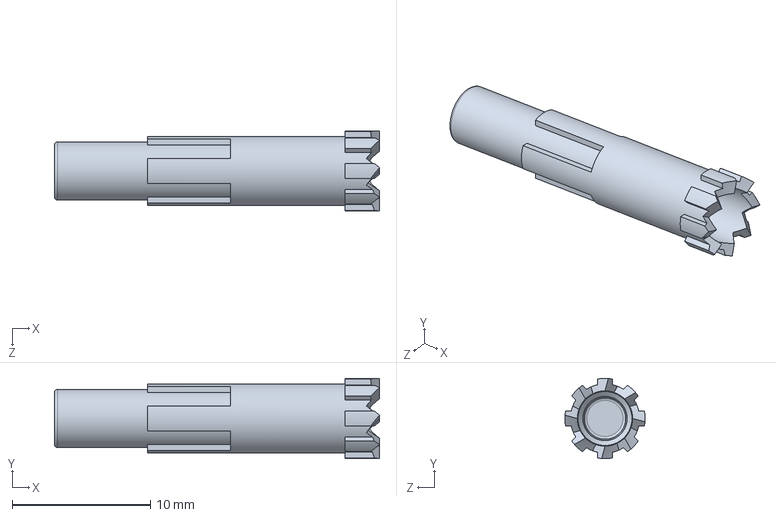
[picture p230: CAD file, 2026-10-30]
src/main/webapp/assets/Produtos/00-00 - BASE DE DADOS/Componentes/Esferográficas/23.06.05-06-REV00 - FEMEA DO MECANISMO SENATOR.SLDPRT
23.5 x 5.80 x 5.80 mm
