LcAvila/grade_moldes/src/main/webapp/assets/Produtos/00-00 - BASE DE DADOS/Componentes/Hidrográficas e Marcadores/25.03.04 -01_2-REV00 - PONTA COM CABEÇA CHANFRADA COMPACTOR COLOR 3D.SLDPRT

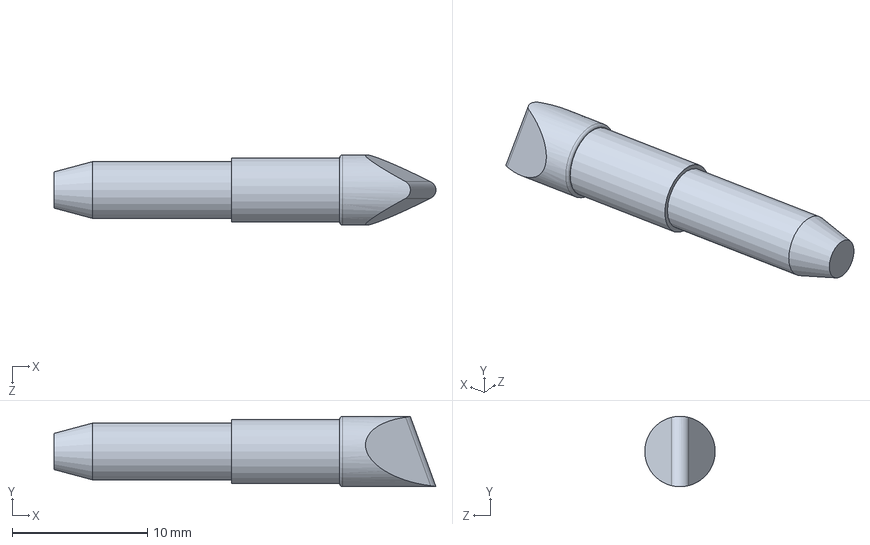
[picture p231: CAD file, 2026-10-30]
src/main/webapp/assets/Produtos/00-00 - BASE DE DADOS/Componentes/Hidrográficas e Marcadores/25.03.04 -01_2-REV00 - PONTA COM CABEÇA CHANFRADA COMPACTOR COLOR 3D.SLDPRT
28.2 x 5.20 x 5.20 mm
