LcAvila/grade_moldes/src/main/webapp/assets/Produtos/00-00 - BASE DE DADOS/Componentes/Lapiseiras/Luva Lap Técnico (Novo).SLDPRT

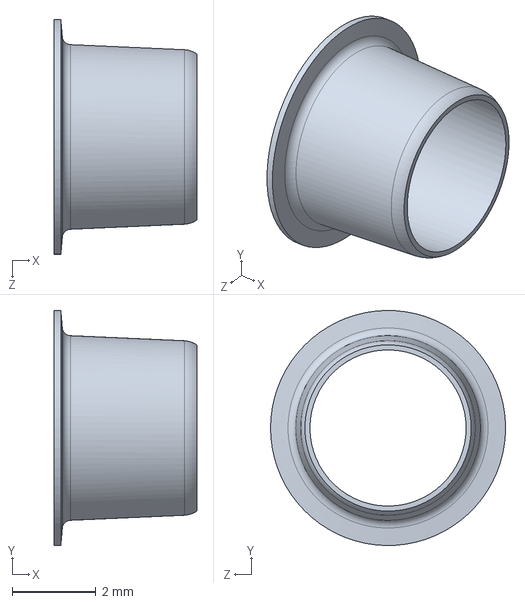
[picture p232: CAD file, 2026-10-30]
src/main/webapp/assets/Produtos/00-00 - BASE DE DADOS/Componentes/Lapiseiras/Luva Lap Técnico (Novo).SLDPRT
3.40 x 5.60 x 5.60 mm
