LcAvila/grade_moldes/src/main/webapp/assets/Produtos/00-00 - BASE DE DADOS/Componentes/Esferográficas/23.03.01-15-REV00 -CARGA 1005 e SLID 710 XB - 3D.SLDPRT

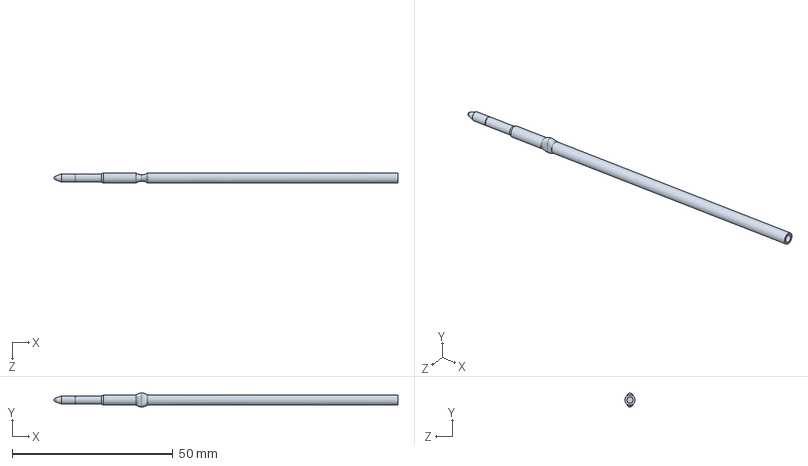
[picture p233: CAD file, 2026-10-30]
src/main/webapp/assets/Produtos/00-00 - BASE DE DADOS/Componentes/Esferográficas/23.03.01-15-REV00 -CARGA 1005 e SLID 710 XB - 3D.SLDPRT
106.8 x 4.36 x 3.20 mm
