LcAvila/grade_moldes/src/main/webapp/assets/Produtos/00-00 - BASE DE DADOS/Componentes/Hidrográficas e Marcadores/23.10.05-03_02-REV00 - TAMPINHA COLOR EM PP.SLDPRT

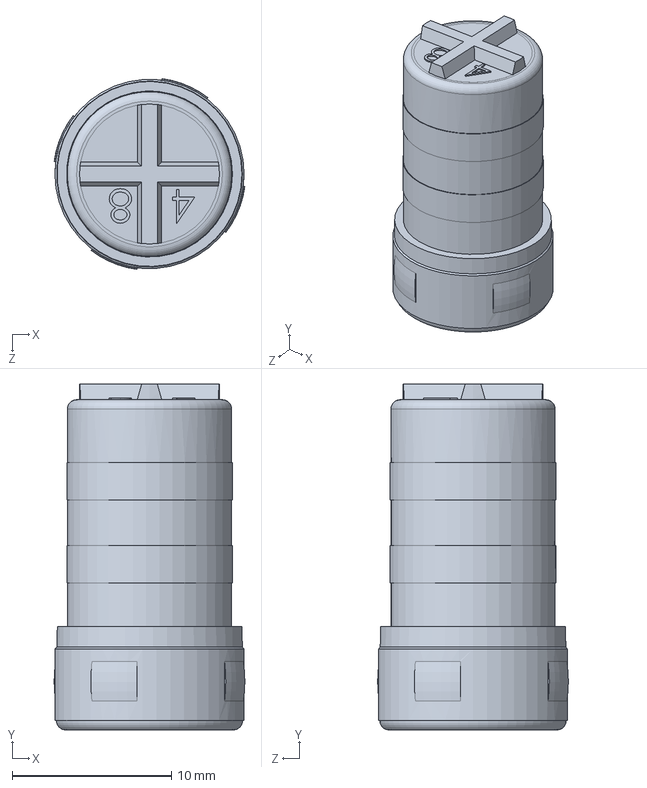
[picture p234: CAD file, 2026-10-30]
src/main/webapp/assets/Produtos/00-00 - BASE DE DADOS/Componentes/Hidrográficas e Marcadores/23.10.05-03_02-REV00 - TAMPINHA COLOR EM PP.SLDPRT
12.0 x 21.7 x 12.0 mm
