LcAvila/grade_moldes/src/main/webapp/assets/Produtos/00-00 - BASE DE DADOS/Componentes/Lapiseiras/16.09.01-01-REV00 - Lâmina  Corrigida.SLDPRT

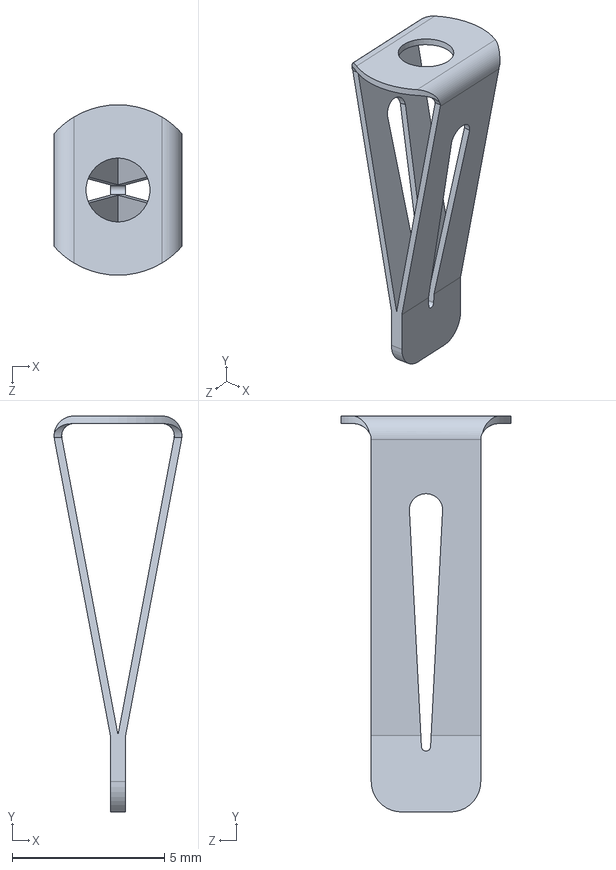
[picture p235: CAD file, 2026-10-30]
src/main/webapp/assets/Produtos/00-00 - BASE DE DADOS/Componentes/Lapiseiras/16.09.01-01-REV00 - Lâmina Corrigida.SLDPRT
4.20 x 13.0 x 5.60 mm
