LcAvila/grade_moldes/src/main/webapp/assets/Produtos/00-00 - BASE DE DADOS/Componentes/Hidrográficas e Marcadores/11.02.09-REV00 - PAVIO MARCA TEXTO (7,00 X 76,50) - 3D.SLDPRT

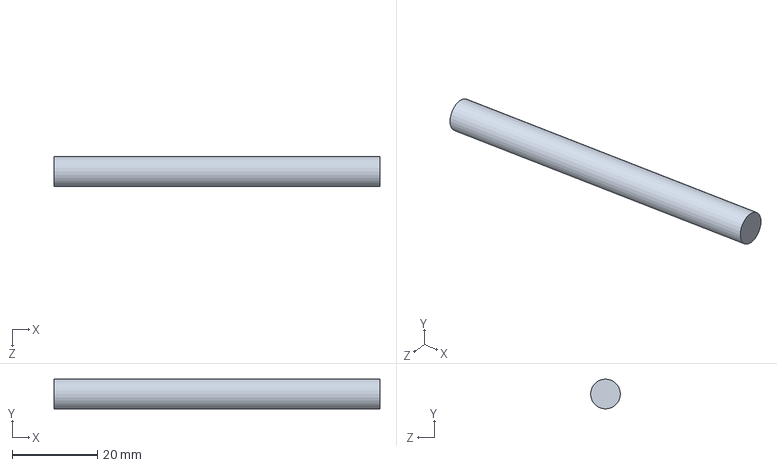
[picture p237: CAD file, 2026-10-30]
src/main/webapp/assets/Produtos/00-00 - BASE DE DADOS/Componentes/Hidrográficas e Marcadores/11.02.09-REV00 - PAVIO MARCA TEXTO (7,00 X 76,50) - 3D.SLDPRT
76.5 x 7.00 x 7.00 mm
