LcAvila/grade_moldes/src/main/webapp/assets/Produtos/00-00 - BASE DE DADOS/Componentes/Lapiseiras/99.07.18-1-CORPO (SHELL123-1).SLDPRT

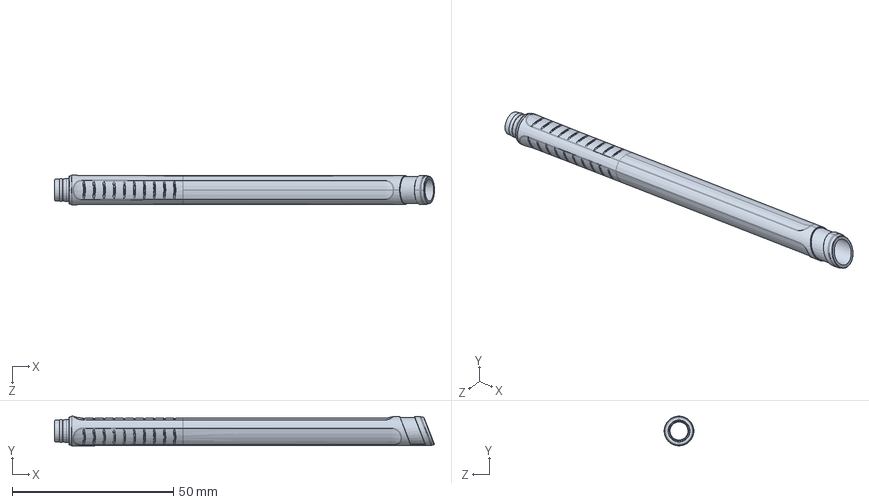
[picture p238: CAD file, 2026-10-30]
src/main/webapp/assets/Produtos/00-00 - BASE DE DADOS/Componentes/Lapiseiras/99.07.18-1-CORPO (SHELL123-1).SLDPRT
117.7 x 9.21 x 9.21 mm
