LcAvila/grade_moldes/src/main/webapp/assets/Produtos/00-00 - BASE DE DADOS/Componentes/Esferográficas/23.05.04-03-REV00 TAMPA COMPACTOR SMART.SLDPRT

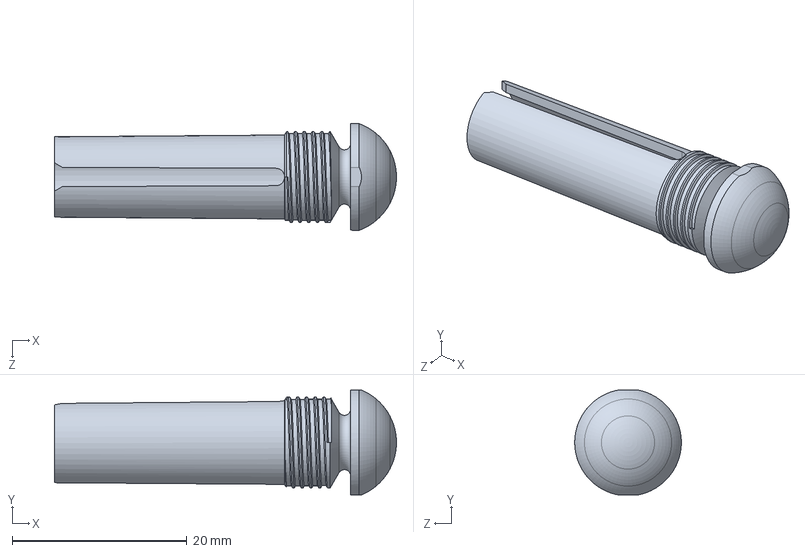
[picture p239: CAD file, 2026-10-30]
src/main/webapp/assets/Produtos/00-00 - BASE DE DADOS/Componentes/Esferográficas/23.05.04-03-REV00 TAMPA COMPACTOR SMART.SLDPRT
39.1 x 12.0 x 12.2 mm
