LcAvila/grade_moldes/src/main/webapp/assets/Produtos/00-00 - BASE DE DADOS/Componentes/Hidrográficas e Marcadores/23.10.05-04.02-REV00 - TAMPA COMPACTOR COLOR 3D.SLDPRT

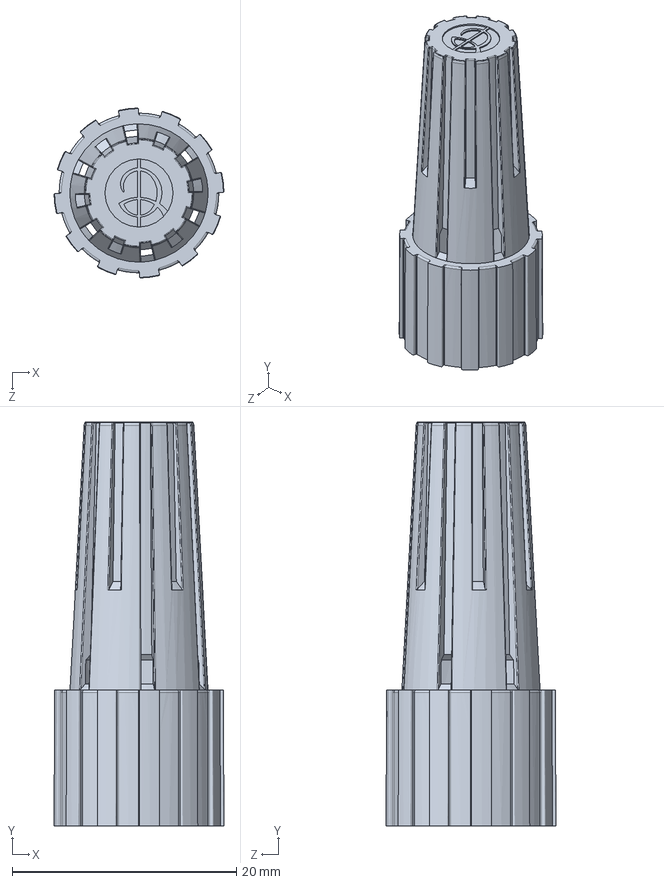
[picture p240: CAD file, 2026-10-30]
src/main/webapp/assets/Produtos/00-00 - BASE DE DADOS/Componentes/Hidrográficas e Marcadores/23.10.05-04.02-REV00 - TAMPA COMPACTOR COLOR 3D.SLDPRT
15.1 x 36.0 x 15.1 mm
