LcAvila/grade_moldes/src/main/webapp/assets/Produtos/00-00 - BASE DE DADOS/Componentes/Esferográficas/23.05.01-10-REV00 MECANISMO.SLDPRT

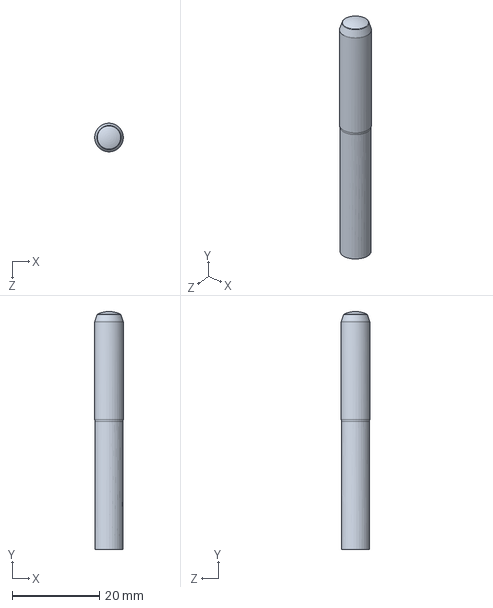
[picture p242: CAD file, 2026-10-30]
src/main/webapp/assets/Produtos/00-00 - BASE DE DADOS/Componentes/Esferográficas/23.05.01-10-REV00 MECANISMO.SLDPRT
6.57 x 54.6 x 6.57 mm
