LcAvila/grade_moldes/src/main/webapp/assets/Produtos/00-00 - BASE DE DADOS/Componentes/Hidrográficas e Marcadores/23.06.08-02-REV01 Corpo Destaq 3D.SLDPRT

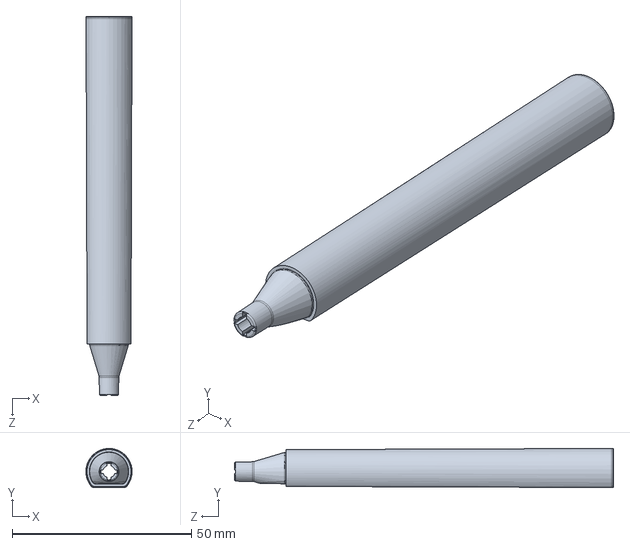
[picture p243: CAD file, 2026-10-30]
src/main/webapp/assets/Produtos/00-00 - BASE DE DADOS/Componentes/Hidrográficas e Marcadores/23.06.08-02-REV01 Corpo Destaq 3D.SLDPRT
12.9 x 10.9 x 105.7 mm
