LcAvila/grade_moldes/src/main/webapp/assets/Produtos/00-00 - BASE DE DADOS/Componentes/Esferográficas/23.05.04-04-REV00 MECANISMO COMPACTOR SMART.SLDPRT

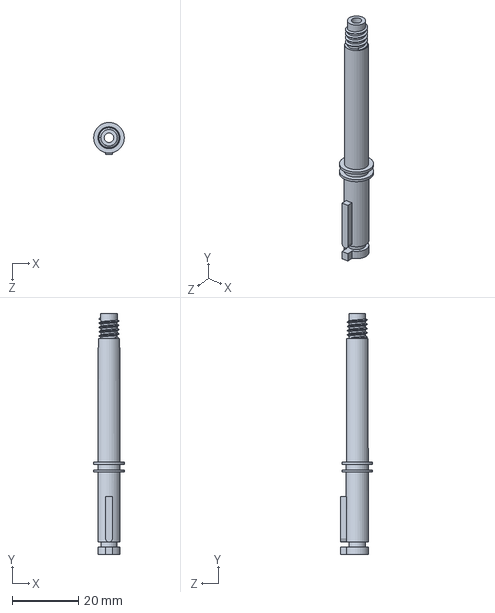
[picture p244: CAD file, 2026-10-30]
src/main/webapp/assets/Produtos/00-00 - BASE DE DADOS/Componentes/Esferográficas/23.05.04-04-REV00 MECANISMO COMPACTOR SMART.SLDPRT
9.30 x 73.0 x 9.73 mm
