LcAvila/grade_moldes/src/main/webapp/assets/Produtos/00-00 - BASE DE DADOS/Componentes/Hidrográficas e Marcadores/COM-23.10.05-05.09 - PONTEIRA MICROLINE.SLDPRT

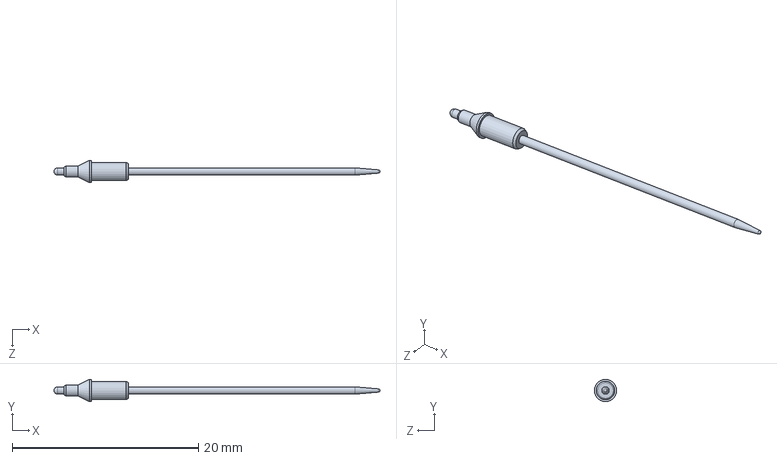
[picture p245: CAD file, 2026-10-30]
src/main/webapp/assets/Produtos/00-00 - BASE DE DADOS/Componentes/Hidrográficas e Marcadores/COM-23.10.05-05.09 - PONTEIRA MICROLINE.SLDPRT
35.0 x 2.40 x 2.40 mm
