LcAvila/grade_moldes/src/main/webapp/assets/Produtos/00-00 - BASE DE DADOS/Componentes/Esferográficas/23.05.02-03-REV00 - TAMPA CLIP VIP RETRATIL - 3D.SLDPRT

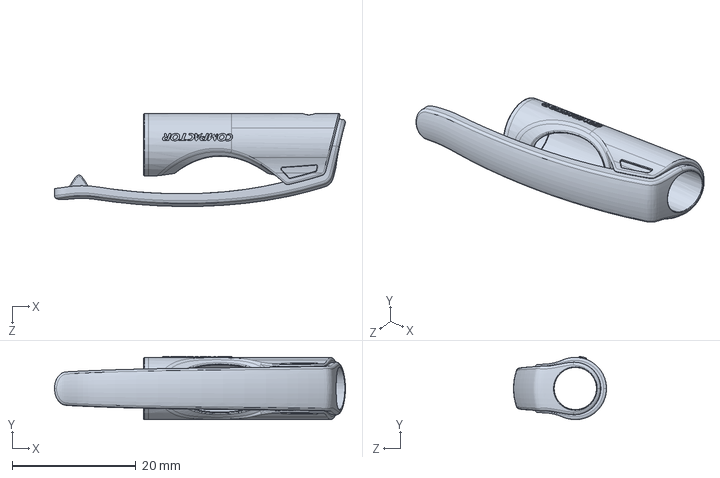
[picture p246: CAD file, 2026-10-30]
src/main/webapp/assets/Produtos/00-00 - BASE DE DADOS/Componentes/Esferográficas/23.05.02-03-REV00 - TAMPA CLIP VIP RETRATIL - 3D.SLDPRT
47.0 x 10.2 x 15.0 mm
