LcAvila/grade_moldes/src/main/webapp/assets/Produtos/00-00 - BASE DE DADOS/Componentes/Hidrográficas e Marcadores/23.11.04-01-REV00 - CORPO NEO PEN GIGANTE 3D.SLDPRT

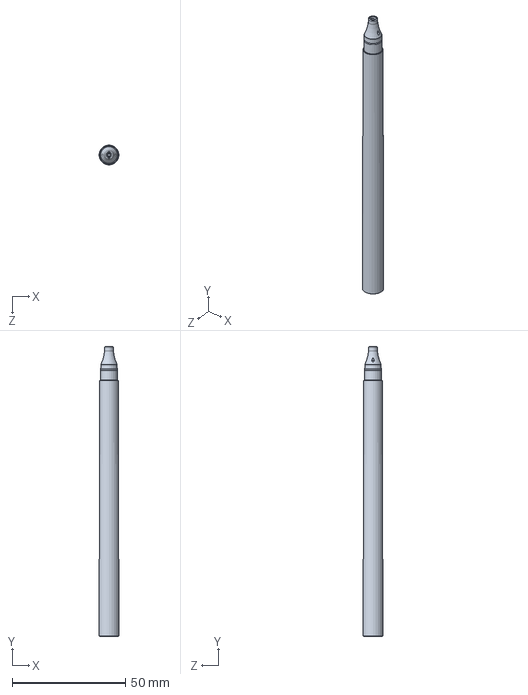
[picture p247: CAD file, 2026-10-30]
src/main/webapp/assets/Produtos/00-00 - BASE DE DADOS/Componentes/Hidrográficas e Marcadores/23.11.04-01-REV00 - CORPO NEO PEN GIGANTE 3D.SLDPRT
8.75 x 128.0 x 8.75 mm
