LcAvila/grade_moldes/src/main/webapp/assets/Produtos/00-00 - BASE DE DADOS/Componentes/Esferográficas/23.06.02-04-REV00 - ANEL PARA TINTEIRO.SLDPRT

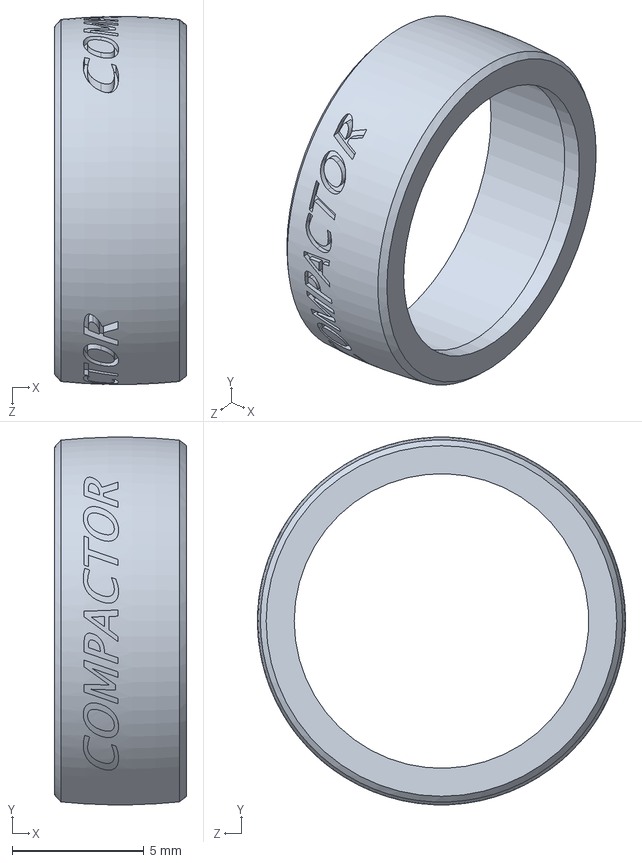
[picture p248: CAD file, 2026-10-30]
src/main/webapp/assets/Produtos/00-00 - BASE DE DADOS/Componentes/Esferográficas/23.06.02-04-REV00 - ANEL PARA TINTEIRO.SLDPRT
5.02 x 14.0 x 14.0 mm
