LcAvila/grade_moldes/src/main/webapp/assets/Produtos/00-00 - BASE DE DADOS/Componentes/Hidrográficas e Marcadores/23.06.01-02-REV00 - PAVIO COMPACTOR COLOR - 3D.SLDPRT

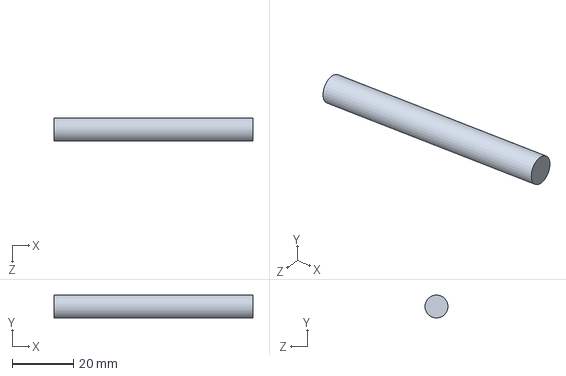
[picture p249: CAD file, 2026-10-30]
src/main/webapp/assets/Produtos/00-00 - BASE DE DADOS/Componentes/Hidrográficas e Marcadores/23.06.01-02-REV00 - PAVIO COMPACTOR COLOR - 3D.SLDPRT
65.0 x 7.49 x 7.50 mm
