LcAvila/grade_moldes/src/main/webapp/assets/Produtos/00-00 - BASE DE DADOS/Componentes/Hidrográficas e Marcadores/Fixador de ponta Chapéu Vai e Volta.SLDPRT

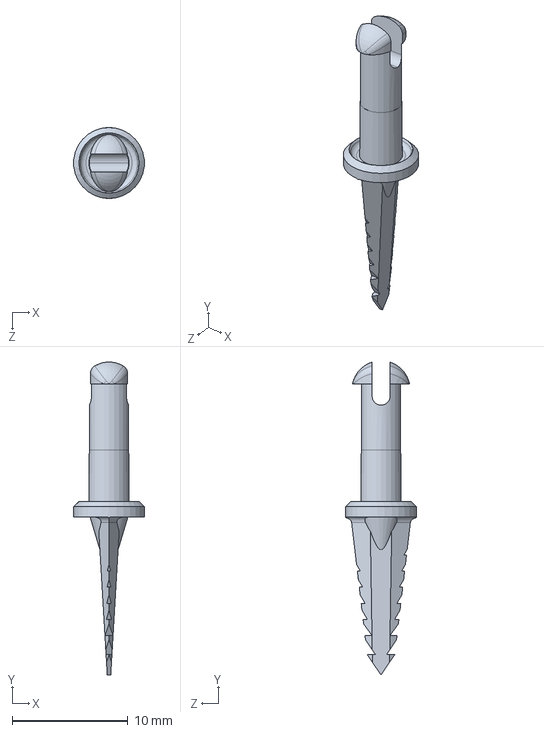
[picture p250: CAD file, 2026-10-30]
src/main/webapp/assets/Produtos/00-00 - BASE DE DADOS/Componentes/Hidrográficas e Marcadores/Fixador de ponta Chapéu Vai e Volta.SLDPRT
6.11 x 27.1 x 6.14 mm
