LcAvila/grade_moldes/src/main/webapp/assets/Produtos/00-00 - BASE DE DADOS/Componentes/Esferográficas/23.05.01-08-REV00 - TUBO ESF..SLDPRT

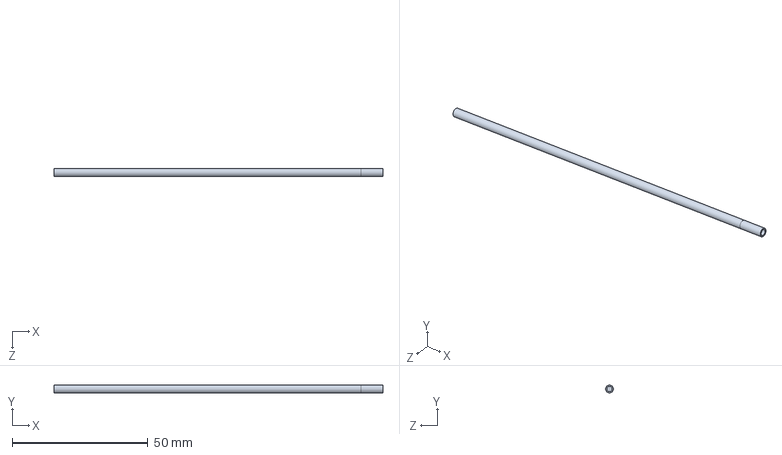
[picture p251: CAD file, 2026-10-30]
src/main/webapp/assets/Produtos/00-00 - BASE DE DADOS/Componentes/Esferográficas/23.05.01-08-REV00 - TUBO ESF..SLDPRT
121.0 x 2.90 x 2.90 mm
