LcAvila/grade_moldes/src/main/webapp/assets/Produtos/00-00 - BASE DE DADOS/Componentes/Hidrográficas e Marcadores/23.06.08-03-REV00 TAMPA DESTAQ - 3D.SLDPRT

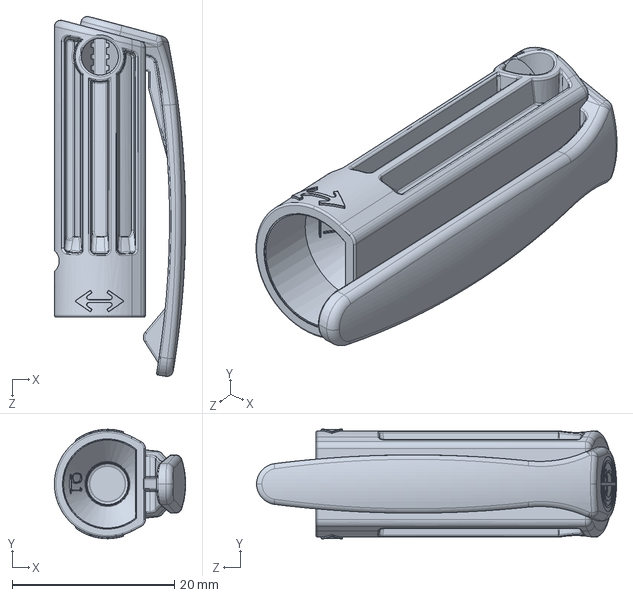
[picture p252: CAD file, 2026-10-30]
src/main/webapp/assets/Produtos/00-00 - BASE DE DADOS/Componentes/Hidrográficas e Marcadores/23.06.08-03-REV00 TAMPA DESTAQ - 3D.SLDPRT
16.2 x 13.5 x 44.4 mm
