LcAvila/grade_moldes/src/main/webapp/assets/Produtos/00-00 - BASE DE DADOS/Componentes/Esferográficas/23.06.05-08-REV00 - SUPORTE MECANISMO SENATOR.SLDPRT

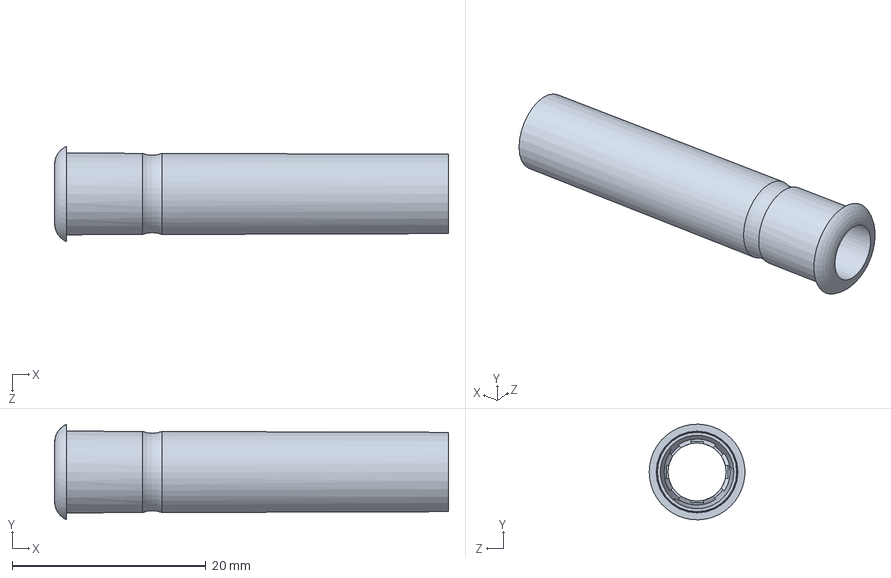
[picture p253: CAD file, 2026-10-30]
src/main/webapp/assets/Produtos/00-00 - BASE DE DADOS/Componentes/Esferográficas/23.06.05-08-REV00 - SUPORTE MECANISMO SENATOR.SLDPRT
40.7 x 9.88 x 9.88 mm
