LcAvila/grade_moldes/src/main/webapp/assets/Produtos/00-00 - BASE DE DADOS/Componentes/Hidrográficas e Marcadores/SW9986-REV03-Tampa Microline -152.SLDPRT

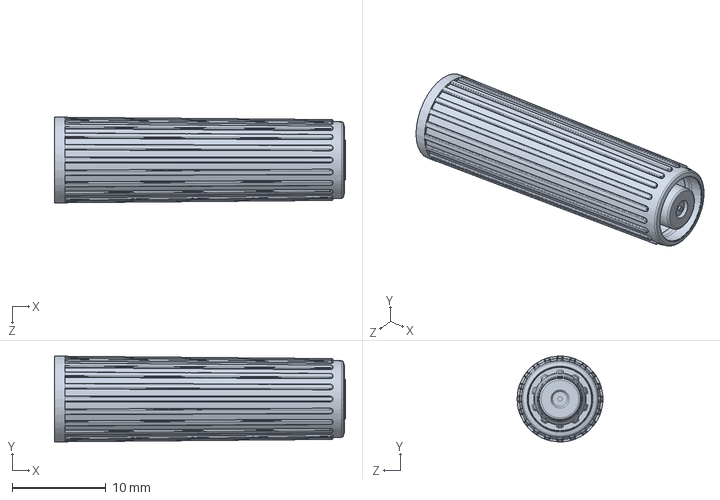
[picture p254: CAD file, 2026-10-30]
src/main/webapp/assets/Produtos/00-00 - BASE DE DADOS/Componentes/Hidrográficas e Marcadores/SW9986-REV03-Tampa Microline -152.SLDPRT
31.0 x 9.14 x 9.15 mm
