LcAvila/grade_moldes/src/main/webapp/assets/Produtos/00-00 - BASE DE DADOS/Componentes/Esferográficas/23.05.02-04-REV01 - TUBO DE CARGA VIP RETRÁTIL.SLDPRT

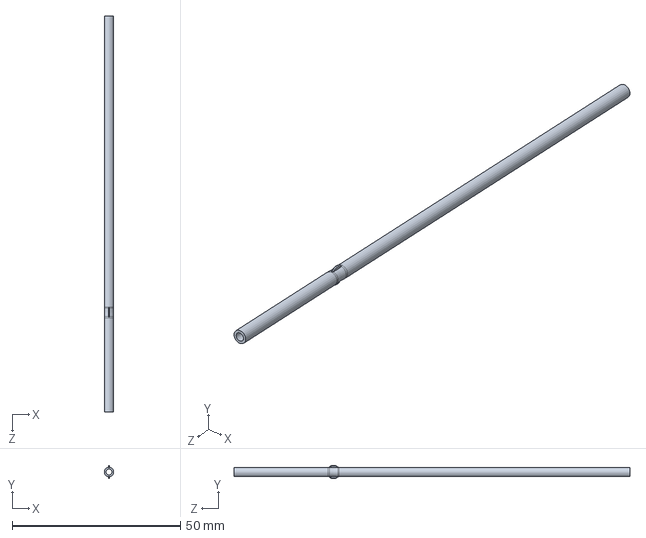
[picture p255: CAD file, 2026-10-30]
src/main/webapp/assets/Produtos/00-00 - BASE DE DADOS/Componentes/Esferográficas/23.05.02-04-REV01 - TUBO DE CARGA VIP RETRÁTIL.SLDPRT
2.80 x 3.97 x 117.7 mm
