LcAvila/grade_moldes/src/main/webapp/assets/Produtos/00-00 - BASE DE DADOS/Componentes/Hidrográficas e Marcadores/24.02.02 - 2 Tampinha Microline 3D.SLDPRT

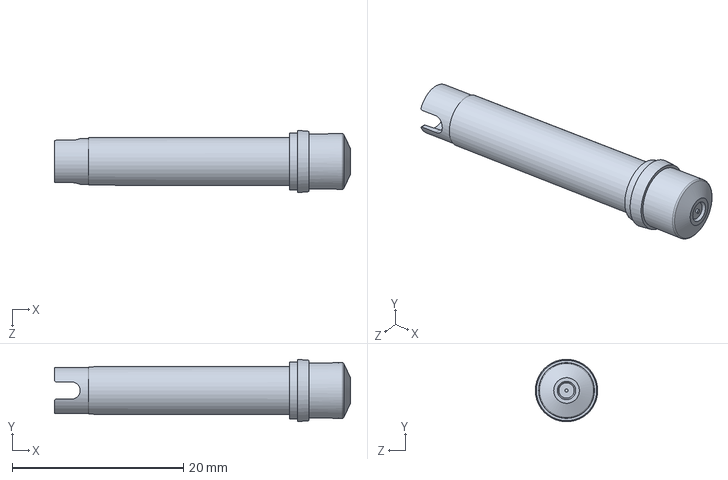
[picture p256: CAD file, 2026-10-30]
src/main/webapp/assets/Produtos/00-00 - BASE DE DADOS/Componentes/Hidrográficas e Marcadores/24.02.02 - 2 Tampinha Microline 3D.SLDPRT
34.6 x 7.29 x 7.29 mm
