LcAvila/grade_moldes/src/main/webapp/assets/Produtos/00-00 - BASE DE DADOS/Componentes/Esferográficas/23.05.02-02-REV00 BOTÃO VIP RETRÁTIL - 3D.SLDPRT

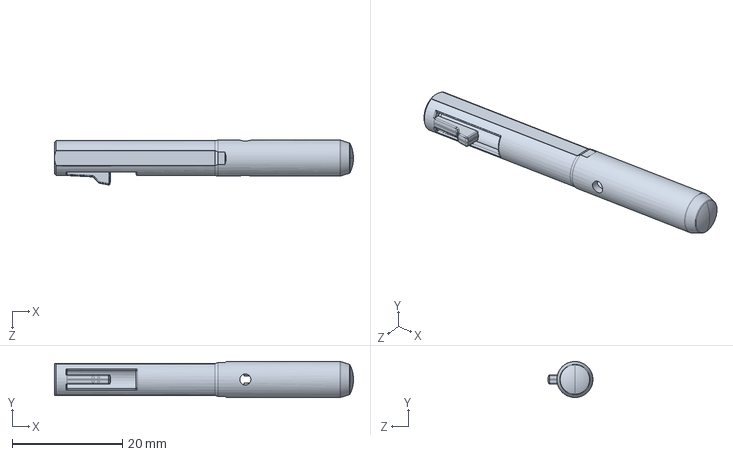
[picture p257: CAD file, 2026-10-30]
src/main/webapp/assets/Produtos/00-00 - BASE DE DADOS/Componentes/Esferográficas/23.05.02-02-REV00 BOTÃO VIP RETRÁTIL - 3D.SLDPRT
54.3 x 6.54 x 8.13 mm
