LcAvila/grade_moldes/src/main/webapp/assets/Produtos/00-00 - BASE DE DADOS/Componentes/Hidrográficas e Marcadores/23.06.01-7 - Pavio microline 3D.SLDPRT

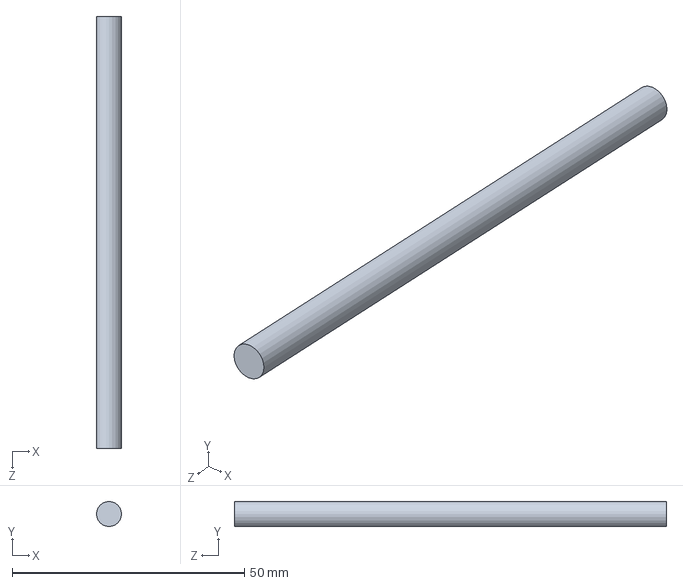
[picture p258: CAD file, 2026-10-30]
src/main/webapp/assets/Produtos/00-00 - BASE DE DADOS/Componentes/Hidrográficas e Marcadores/23.06.01-7 - Pavio microline 3D.SLDPRT
5.40 x 5.40 x 93.0 mm
