LcAvila/grade_moldes/src/main/webapp/assets/Produtos/00-00 - BASE DE DADOS/Componentes/Esferográficas/23.06.05-02-REV00 - PONTEIRA CROMADA SENATOR.SLDPRT

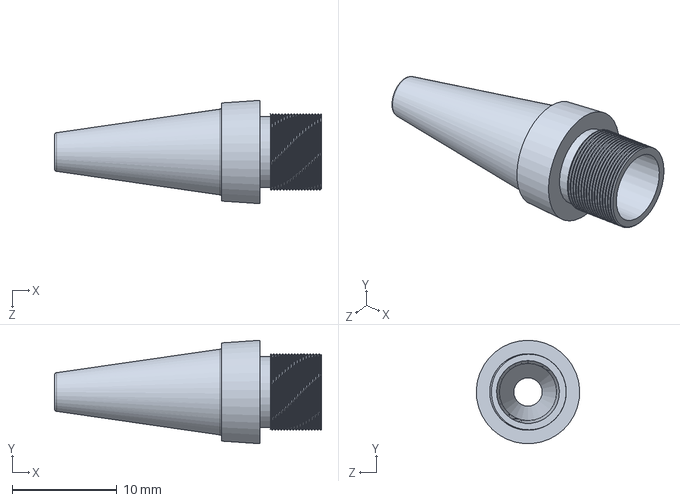
[picture p259: CAD file, 2026-10-30]
src/main/webapp/assets/Produtos/00-00 - BASE DE DADOS/Componentes/Esferográficas/23.06.05-02-REV00 - PONTEIRA CROMADA SENATOR.SLDPRT
25.5 x 9.87 x 9.86 mm
