LcAvila/grade_moldes/src/main/webapp/assets/Produtos/00-00 - BASE DE DADOS/Componentes/Hidrográficas e Marcadores/Tampa Cd- Writer 257.SLDPRT

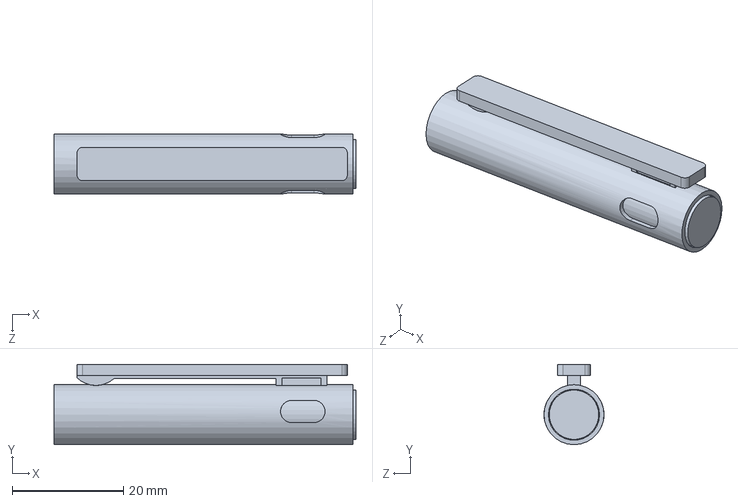
[picture p260: CAD file, 2026-10-30]
src/main/webapp/assets/Produtos/00-00 - BASE DE DADOS/Componentes/Hidrográficas e Marcadores/Tampa Cd- Writer 257.SLDPRT
54.3 x 14.5 x 10.8 mm
