LcAvila/grade_moldes/src/main/webapp/assets/Produtos/00-00 - BASE DE DADOS/Componentes/Esferográficas/23.06.02-03-REV00 - CLIPS.SLDPRT

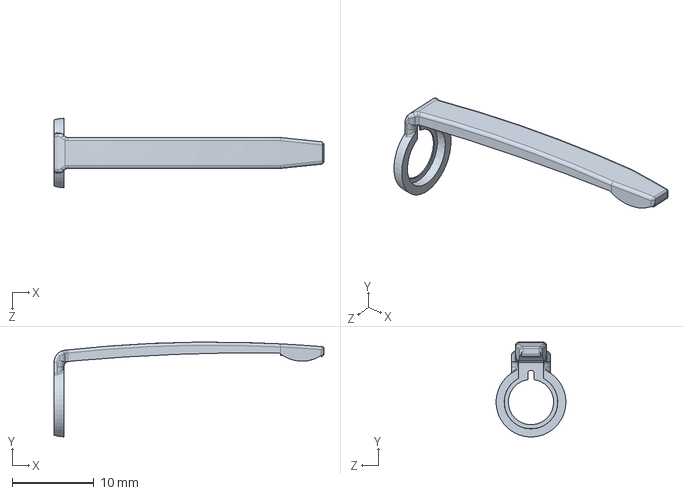
[picture p261: CAD file, 2026-10-30]
src/main/webapp/assets/Produtos/00-00 - BASE DE DADOS/Componentes/Esferográficas/23.06.02-03-REV00 - CLIPS.SLDPRT
33.0 x 11.6 x 8.52 mm
