LcAvila/grade_moldes/src/main/webapp/assets/Produtos/00-00 - BASE DE DADOS/Componentes/Hidrográficas e Marcadores/COM-23.11.04-05 - CORPO NEO PEN MIRIM 3D.SLDPRT

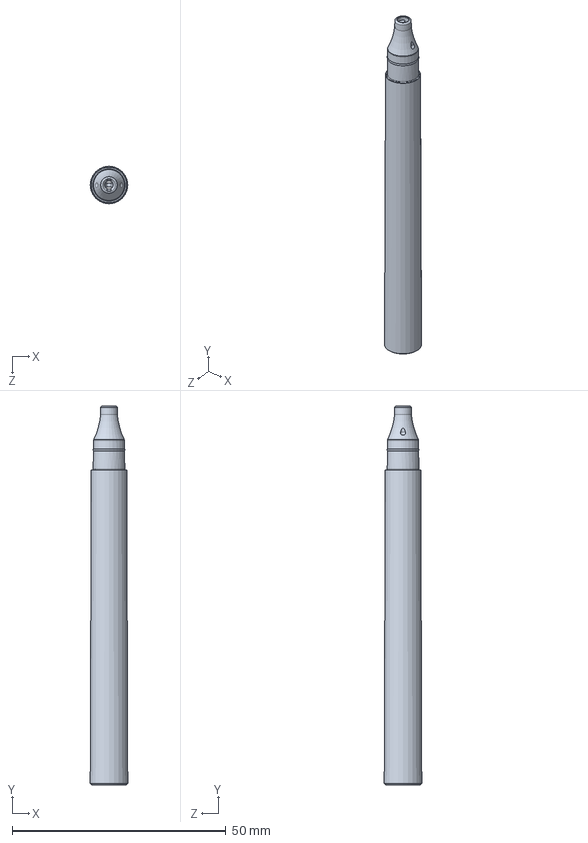
[picture p262: CAD file, 2026-10-30]
src/main/webapp/assets/Produtos/00-00 - BASE DE DADOS/Componentes/Hidrográficas e Marcadores/COM-23.11.04-05 - CORPO NEO PEN MIRIM 3D.SLDPRT
8.79 x 88.6 x 8.79 mm
