LcAvila/grade_moldes/src/main/webapp/assets/Produtos/00-00 - BASE DE DADOS/Componentes/Esferográficas/23.05.04-07-REV00 - MOLA COMPACTOR SMART (TRACIONADO).SLDPRT

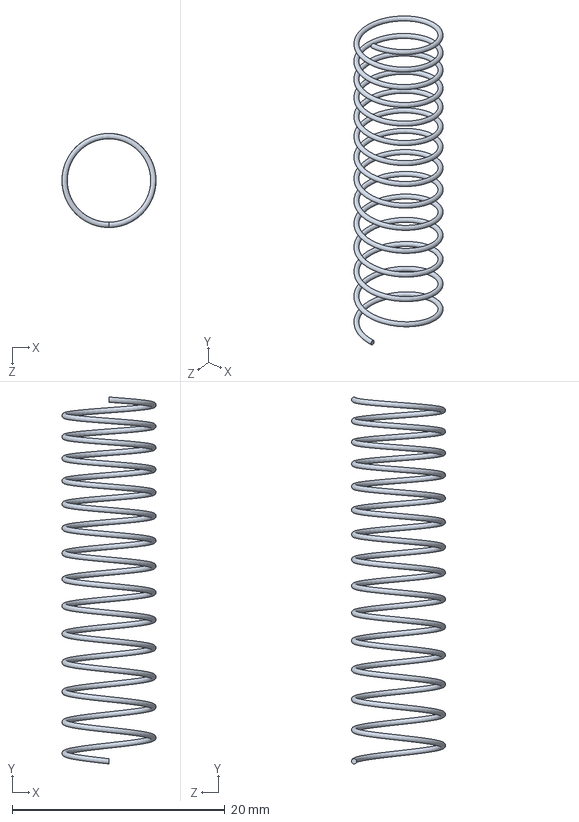
[picture p263: CAD file, 2026-10-30]
src/main/webapp/assets/Produtos/00-00 - BASE DE DADOS/Componentes/Esferográficas/23.05.04-07-REV00 - MOLA COMPACTOR SMART (TRACIONADO).SLDPRT
8.85 x 34.5 x 8.85 mm
