LcAvila/grade_moldes/src/main/webapp/assets/Produtos/00-00 - BASE DE DADOS/Componentes/Esferográficas/23.06.02-07-REV00 - TAMPA INTERNA DUO PLUS.SLDPRT

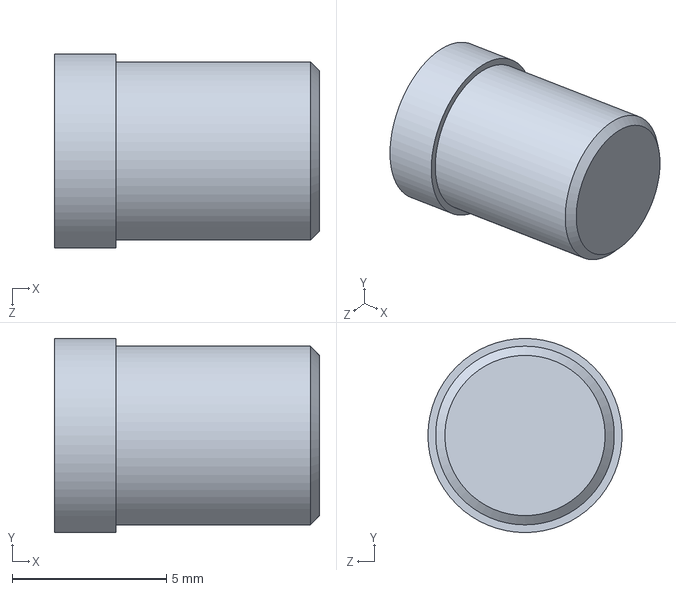
[picture p265: CAD file, 2026-10-30]
src/main/webapp/assets/Produtos/00-00 - BASE DE DADOS/Componentes/Esferográficas/23.06.02-07-REV00 - TAMPA INTERNA DUO PLUS.SLDPRT
8.60 x 6.30 x 6.30 mm
