LcAvila/grade_moldes/src/main/webapp/assets/Produtos/00-00 - BASE DE DADOS/Componentes/Hidrográficas e Marcadores/23.06.01-4 - Pavio Pincel e QB 13,5 x 73,0 3D.SLDPRT

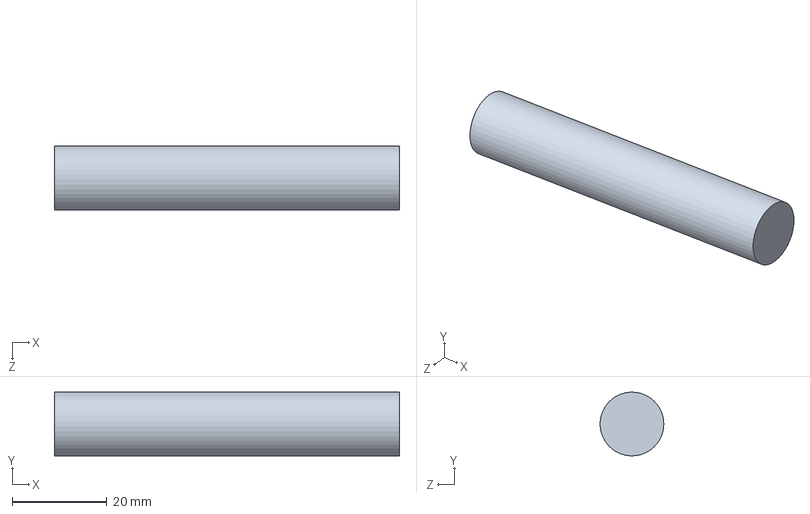
[picture p266: CAD file, 2026-10-30]
src/main/webapp/assets/Produtos/00-00 - BASE DE DADOS/Componentes/Hidrográficas e Marcadores/23.06.01-4 - Pavio Pincel e QB 13,5 x 73,0 3D.SLDPRT
73.0 x 13.5 x 13.5 mm
