LcAvila/grade_moldes/src/main/webapp/assets/Produtos/00-00 - BASE DE DADOS/Componentes/Esferográficas/23.06.03-07-REV00 - PENA DE METAL TINTEIRO 01.SLDPRT

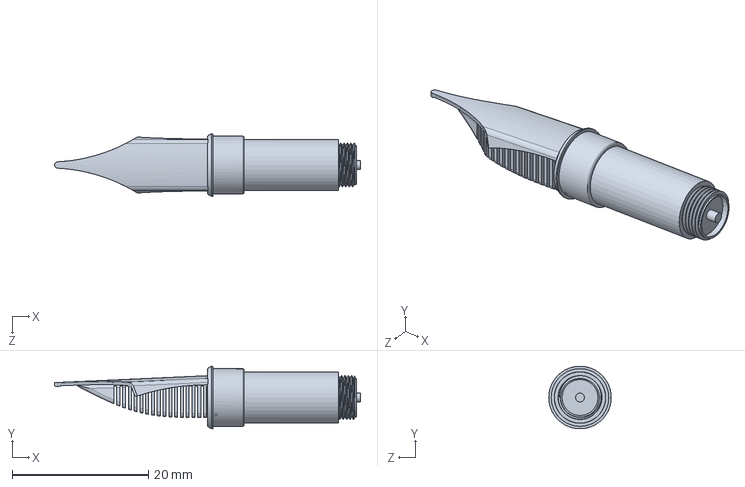
[picture p267: CAD file, 2026-10-30]
src/main/webapp/assets/Produtos/00-00 - BASE DE DADOS/Componentes/Esferográficas/23.06.03-07-REV00 - PENA DE METAL TINTEIRO 01.SLDPRT
45.0 x 9.18 x 9.18 mm
