LcAvila/grade_moldes/src/main/webapp/assets/Produtos/00-00 - BASE DE DADOS/Componentes/Hidrográficas e Marcadores/Corpo VAI e volta.SLDPRT

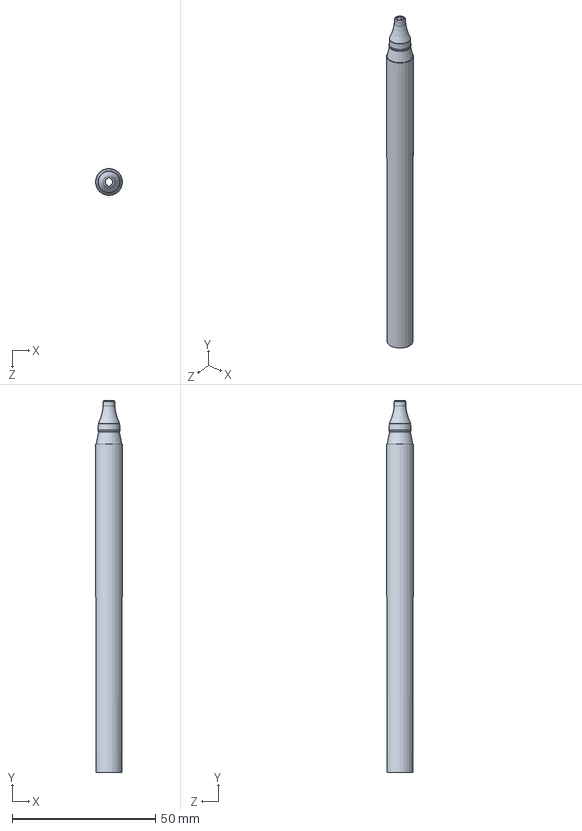
[picture p268: CAD file, 2026-10-30]
src/main/webapp/assets/Produtos/00-00 - BASE DE DADOS/Componentes/Hidrográficas e Marcadores/Corpo VAI e volta.SLDPRT
9.43 x 129.9 x 9.43 mm
