LcAvila/grade_moldes/src/main/webapp/assets/Produtos/00-00 - BASE DE DADOS/Componentes/Esferográficas/23.05.01-01-REV00 - CORPO SEXTAVADO ESF. COMPACTOR.SLDPRT

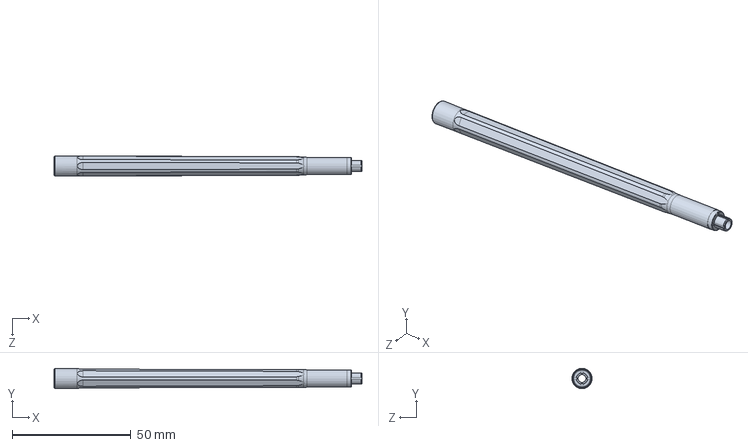
[picture p269: CAD file, 2026-10-30]
src/main/webapp/assets/Produtos/00-00 - BASE DE DADOS/Componentes/Esferográficas/23.05.01-01-REV00 - CORPO SEXTAVADO ESF. COMPACTOR.SLDPRT
129.8 x 8.55 x 8.55 mm
