LcAvila/grade_moldes/src/main/webapp/assets/Produtos/00-00 - BASE DE DADOS/Componentes/Hidrográficas e Marcadores/18.08.2025-01-REV00 - TAMPA NEO PEN PREMIUM.SLDPRT

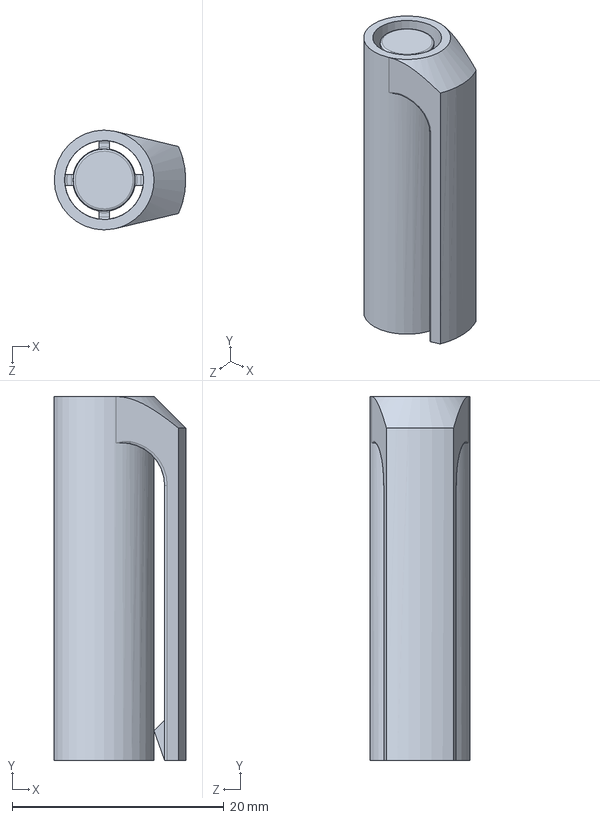
[picture p270: CAD file, 2026-10-30]
src/main/webapp/assets/Produtos/00-00 - BASE DE DADOS/Componentes/Hidrográficas e Marcadores/18.08.2025-01-REV00 - TAMPA NEO PEN PREMIUM.SLDPRT
12.4 x 34.4 x 9.43 mm
