LcAvila/grade_moldes/src/main/webapp/assets/Produtos/00-00 - BASE DE DADOS/Componentes/Esferográficas/23.05.03-01-REV00 - TUBO DE CARGA 07 GEL.SLDPRT

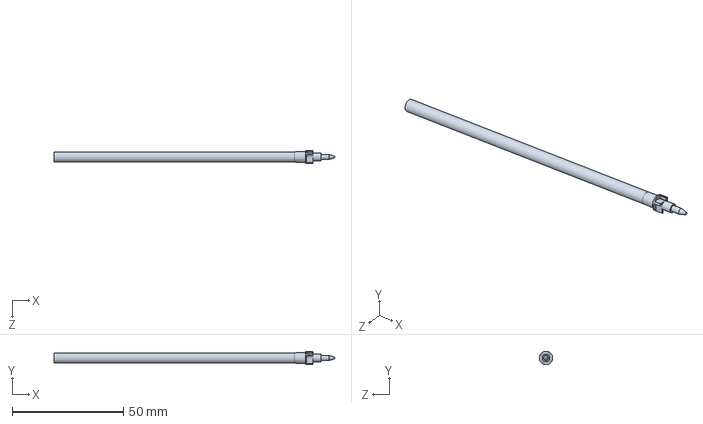
[picture p271: CAD file, 2026-10-30]
src/main/webapp/assets/Produtos/00-00 - BASE DE DADOS/Componentes/Esferográficas/23.05.03-01-REV00 - TUBO DE CARGA 07 GEL.SLDPRT
126.4 x 6.03 x 6.03 mm
