LcAvila/grade_moldes/src/main/webapp/assets/Produtos/00-00 - BASE DE DADOS/Componentes/Hidrográficas e Marcadores/C-04-19-REV01-Tampa Microline -193.SLDPRT

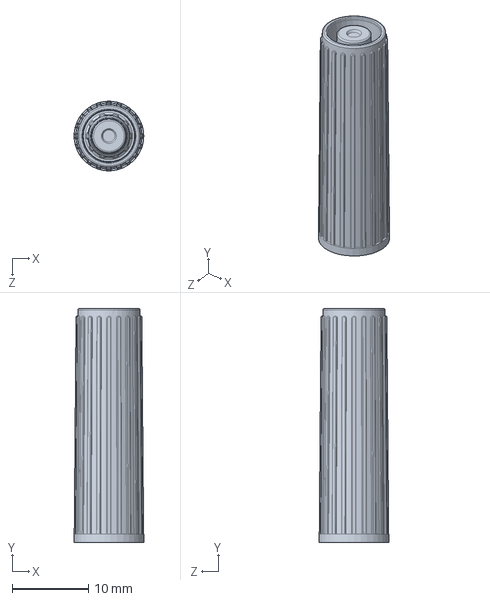
[picture p272: CAD file, 2026-10-30]
src/main/webapp/assets/Produtos/00-00 - BASE DE DADOS/Componentes/Hidrográficas e Marcadores/C-04-19-REV01-Tampa Microline -193.SLDPRT
9.13 x 30.7 x 9.15 mm
