LcAvila/grade_moldes/src/main/webapp/assets/Produtos/00-00 - BASE DE DADOS/Componentes/Esferográficas/23.03.01-15-REV00 - PONTEIRA CARGA 1005 e SLID XB - 3D.SLDPRT

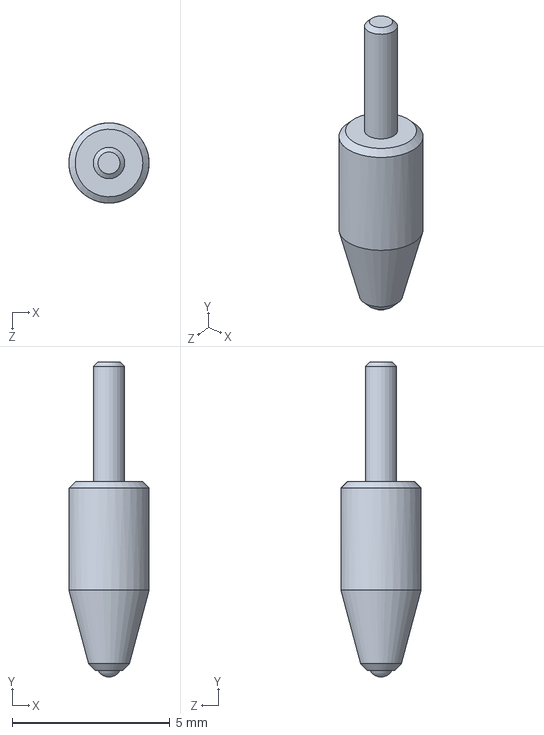
[picture p273: CAD file, 2026-10-30]
src/main/webapp/assets/Produtos/00-00 - BASE DE DADOS/Componentes/Esferográficas/23.03.01-15-REV00 - PONTEIRA CARGA 1005 e SLID XB - 3D.SLDPRT
2.55 x 10.0 x 2.55 mm
