LcAvila/grade_moldes/src/main/webapp/assets/Produtos/00-00 - BASE DE DADOS/Componentes/Hidrográficas e Marcadores/24.01.03-03.01-REV00 - TAMPA MARCADOR QB - 3D.SLDPRT

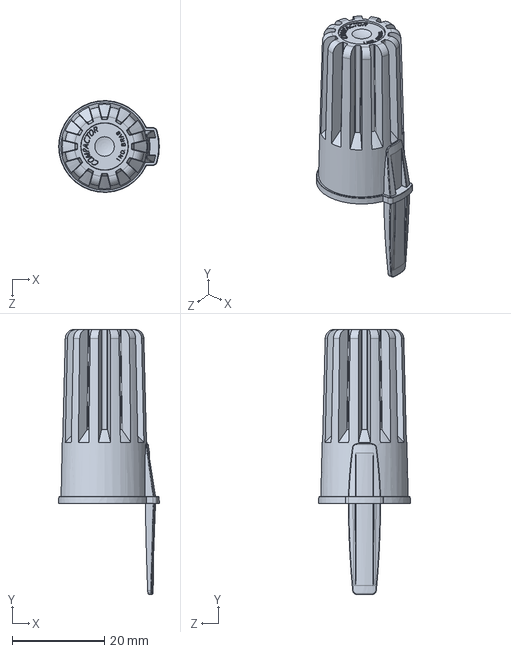
[picture p274: CAD file, 2026-10-30]
src/main/webapp/assets/Produtos/00-00 - BASE DE DADOS/Componentes/Hidrográficas e Marcadores/24.01.03-03.01-REV00 - TAMPA MARCADOR QB - 3D.SLDPRT
21.8 x 57.4 x 19.9 mm
