LcAvila/grade_moldes/src/main/webapp/assets/Produtos/00-00 - BASE DE DADOS/Componentes/Esferográficas/23.05.01-11-REV00 - PONTEIRA ø1,2mm.SLDPRT

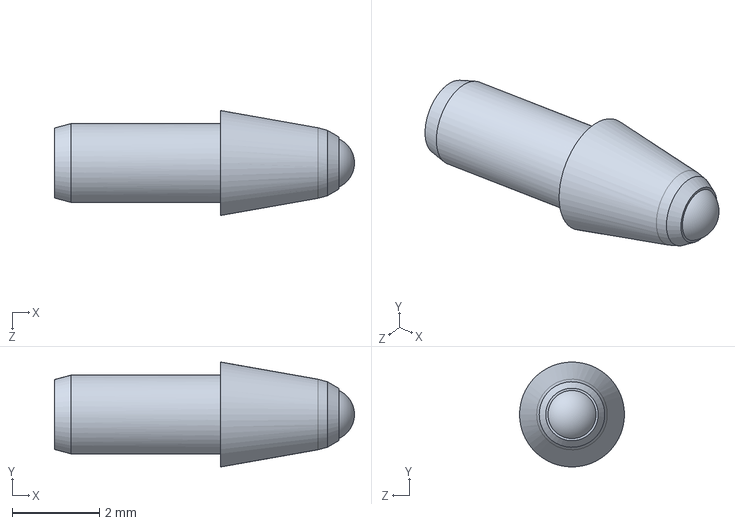
[picture p275: CAD file, 2026-10-30]
src/main/webapp/assets/Produtos/00-00 - BASE DE DADOS/Componentes/Esferográficas/23.05.01-11-REV00 - PONTEIRA ø1,2mm.SLDPRT
6.86 x 2.40 x 2.40 mm
