LcAvila/grade_moldes/src/main/webapp/assets/Produtos/00-00 - BASE DE DADOS/Componentes/Hidrográficas e Marcadores/23.06.08-02-REV00 - TAMPINHA DESTAQ  3D.SLDPRT

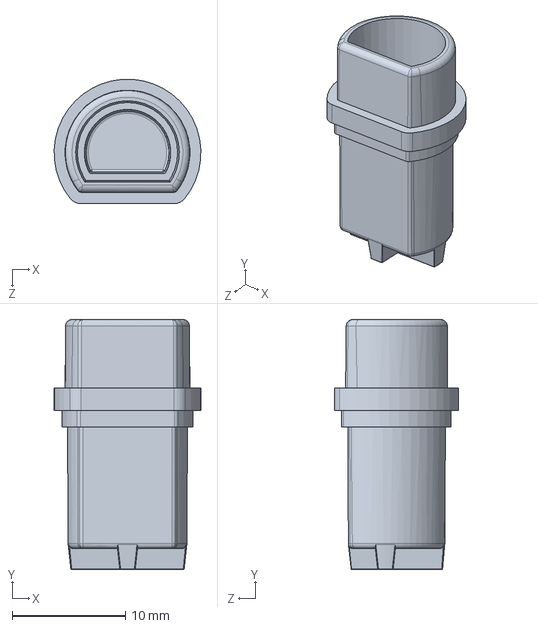
[picture p276: CAD file, 2026-10-30]
src/main/webapp/assets/Produtos/00-00 - BASE DE DADOS/Componentes/Hidrográficas e Marcadores/23.06.08-02-REV00 - TAMPINHA DESTAQ 3D.SLDPRT
13.0 x 22.1 x 11.0 mm
