LcAvila/grade_moldes/src/main/webapp/assets/Produtos/00-00 - BASE DE DADOS/Componentes/Esferográficas/23.06.06-01-REV00 - CARGA DUO PLUS (MARCA TEXTO).SLDPRT

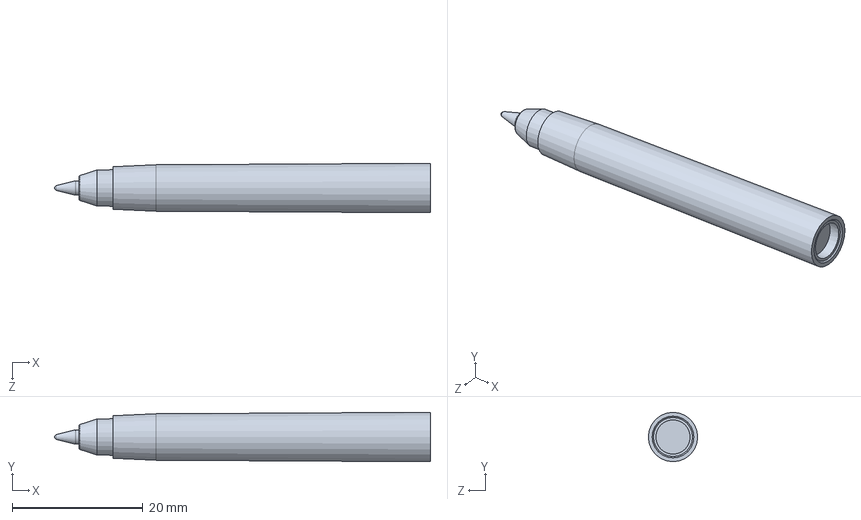
[picture p277: CAD file, 2026-10-30]
src/main/webapp/assets/Produtos/00-00 - BASE DE DADOS/Componentes/Esferográficas/23.06.06-01-REV00 - CARGA DUO PLUS (MARCA TEXTO).SLDPRT
57.4 x 7.55 x 7.55 mm
