LcAvila/grade_moldes/src/main/webapp/assets/Produtos/00-00 - BASE DE DADOS/Componentes/Hidrográficas e Marcadores/15.11.09-REV00 - PONTA MARCADOR QB - 3D.SLDPRT

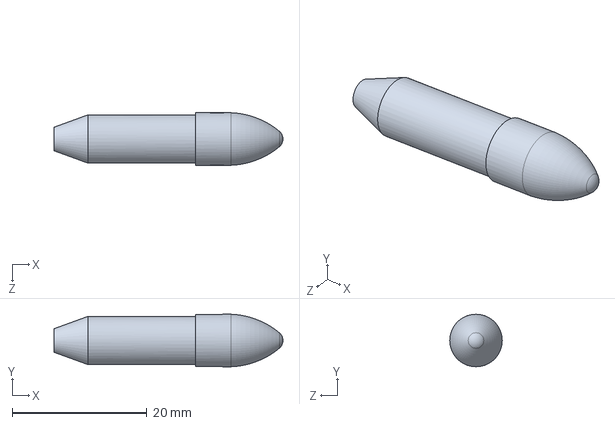
[picture p278: CAD file, 2026-10-30]
src/main/webapp/assets/Produtos/00-00 - BASE DE DADOS/Componentes/Hidrográficas e Marcadores/15.11.09-REV00 - PONTA MARCADOR QB - 3D.SLDPRT
34.0 x 7.80 x 7.80 mm
