LcAvila/grade_moldes/src/main/webapp/assets/Produtos/00-00 - BASE DE DADOS/Componentes/Esferográficas/23.06.04-02-REV00 - INSERTO DO CORPO ESF.B. 201 (BUCHA DO CORPO).SLDPRT

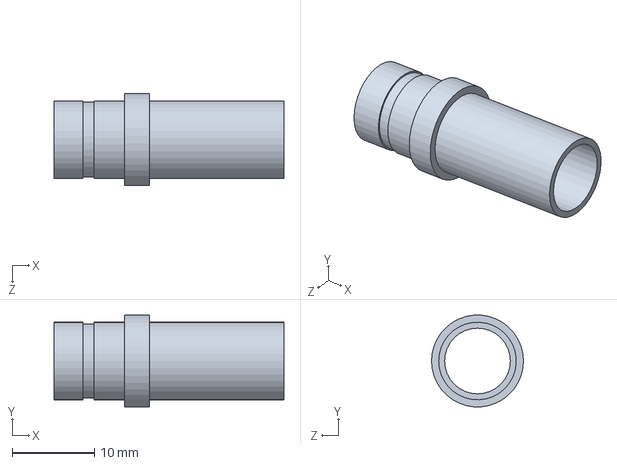
[picture p279: CAD file, 2026-10-30]
src/main/webapp/assets/Produtos/00-00 - BASE DE DADOS/Componentes/Esferográficas/23.06.04-02-REV00 - INSERTO DO CORPO ESF.B. 201 (BUCHA DO CORPO).SLDPRT
28.0 x 11.2 x 11.2 mm
