LcAvila/grade_moldes/src/main/webapp/assets/Produtos/00-00 - BASE DE DADOS/Componentes/Hidrográficas e Marcadores/Ponta Pincel Marcador.SLDPRT

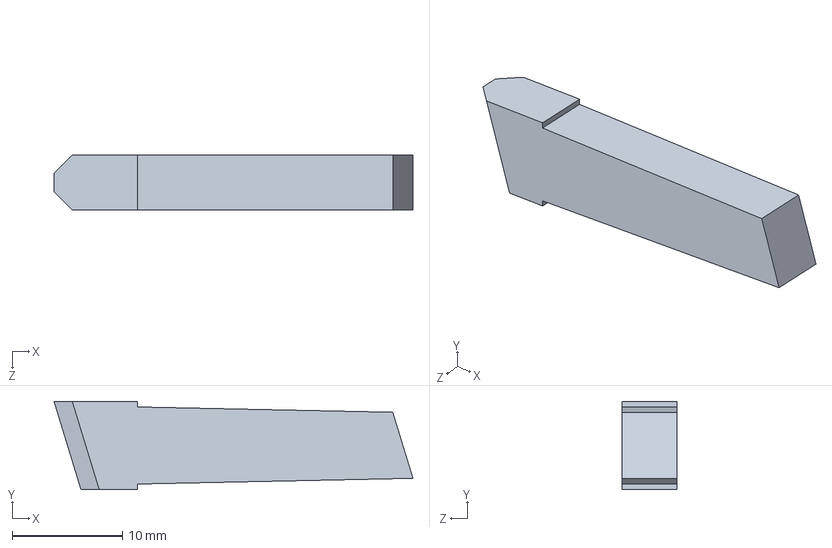
[picture p280: CAD file, 2026-10-30]
src/main/webapp/assets/Produtos/00-00 - BASE DE DADOS/Componentes/Hidrográficas e Marcadores/Ponta Pincel Marcador.SLDPRT
32.6 x 8.00 x 5.00 mm
