LcAvila/grade_moldes/src/main/webapp/assets/Produtos/00-00 - BASE DE DADOS/Componentes/Esferográficas/23.06.05-11-REV00 - CORPO ALUMÍNIO.SLDPRT

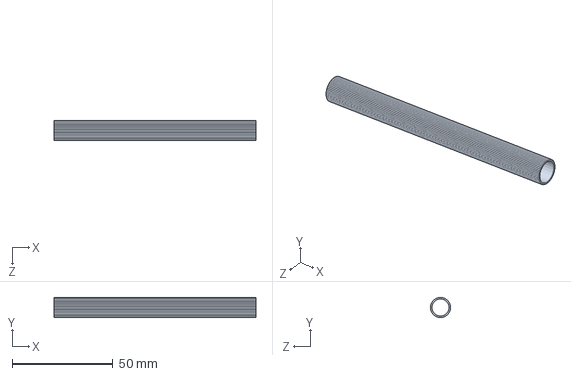
[picture p281: CAD file, 2026-10-30]
src/main/webapp/assets/Produtos/00-00 - BASE DE DADOS/Componentes/Esferográficas/23.06.05-11-REV00 - CORPO ALUMÍNIO.SLDPRT
100.0 x 9.98 x 9.98 mm
