LcAvila/grade_moldes/src/main/webapp/assets/Produtos/00-00 - BASE DE DADOS/Componentes/Esferográficas/23.06.02-04-REV00 - ANEL DO CORPO DUO PLUS.SLDPRT

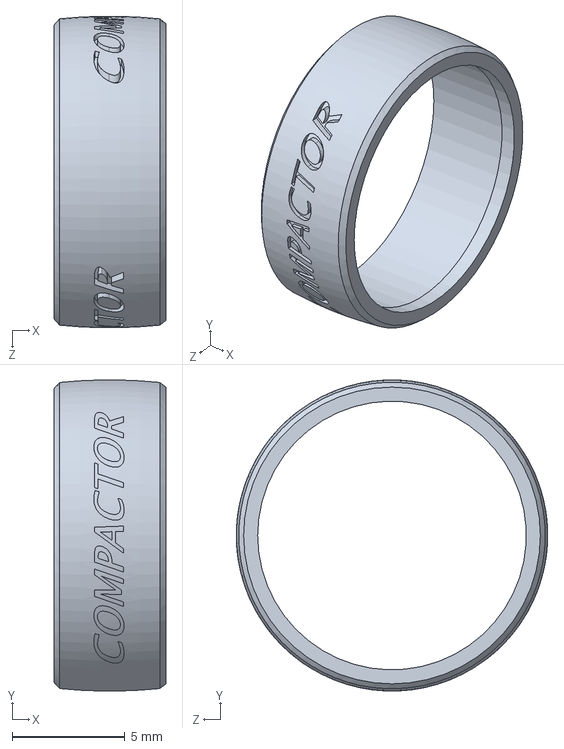
[picture p282: CAD file, 2026-10-30]
src/main/webapp/assets/Produtos/00-00 - BASE DE DADOS/Componentes/Esferográficas/23.06.02-04-REV00 - ANEL DO CORPO DUO PLUS.SLDPRT
4.96 x 13.8 x 13.8 mm
