LcAvila/grade_moldes/src/main/webapp/assets/Produtos/00-00 - BASE DE DADOS/Componentes/Hidrográficas e Marcadores/23.10.05-5.11 - Ponta Microline Art Color 3D.SLDPRT

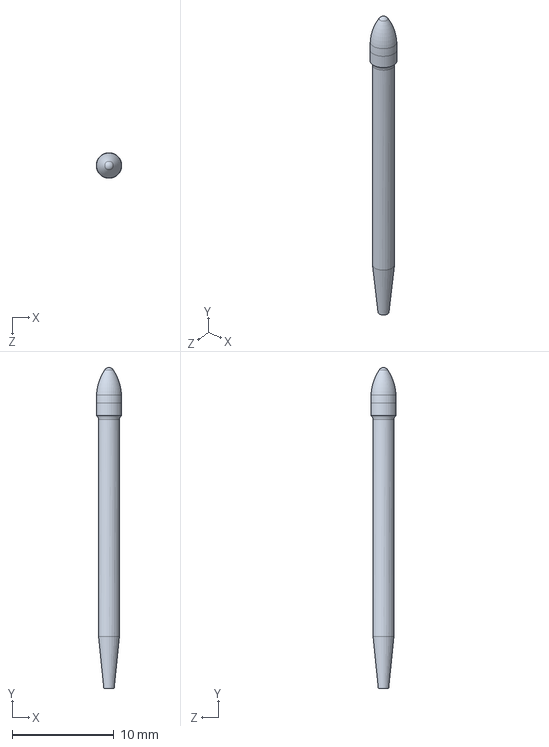
[picture p283: CAD file, 2026-10-30]
src/main/webapp/assets/Produtos/00-00 - BASE DE DADOS/Componentes/Hidrográficas e Marcadores/23.10.05-5.11 - Ponta Microline Art Color 3D.SLDPRT
2.50 x 31.5 x 2.50 mm
