LcAvila/grade_moldes/src/main/webapp/assets/Produtos/00-00 - BASE DE DADOS/Componentes/Esferográficas/23.03.01-15-REV00 -TAMPINHA CARGA 1005 e SLID XB - 3D.SLDPRT

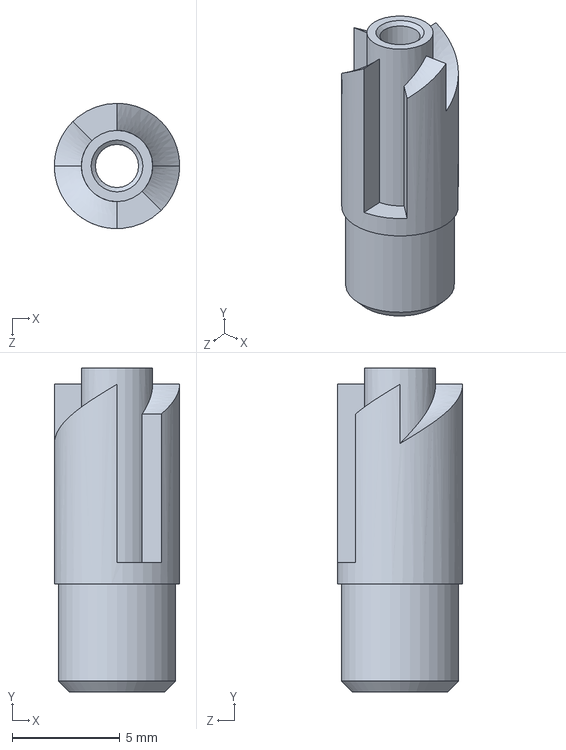
[picture p284: CAD file, 2026-10-30]
src/main/webapp/assets/Produtos/00-00 - BASE DE DADOS/Componentes/Esferográficas/23.03.01-15-REV00 -TAMPINHA CARGA 1005 e SLID XB - 3D.SLDPRT
5.80 x 15.0 x 5.80 mm
