LcAvila/grade_moldes/src/main/webapp/assets/Produtos/00-00 - BASE DE DADOS/Componentes/Hidrográficas e Marcadores/Mola Vai e Volta.SLDPRT

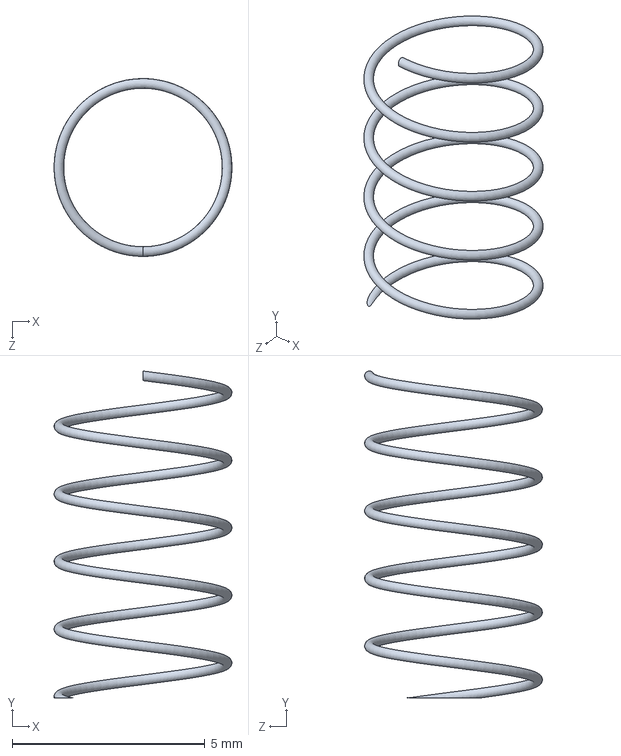
[picture p285: CAD file, 2026-10-30]
src/main/webapp/assets/Produtos/00-00 - BASE DE DADOS/Componentes/Hidrográficas e Marcadores/Mola Vai e Volta.SLDPRT
4.61 x 8.47 x 4.61 mm
