LcAvila/grade_moldes/src/main/webapp/assets/Produtos/00-00 - BASE DE DADOS/Componentes/Esferográficas/23.05.03-04REV00 - CONEXÃO 07 GEL.SLDPRT

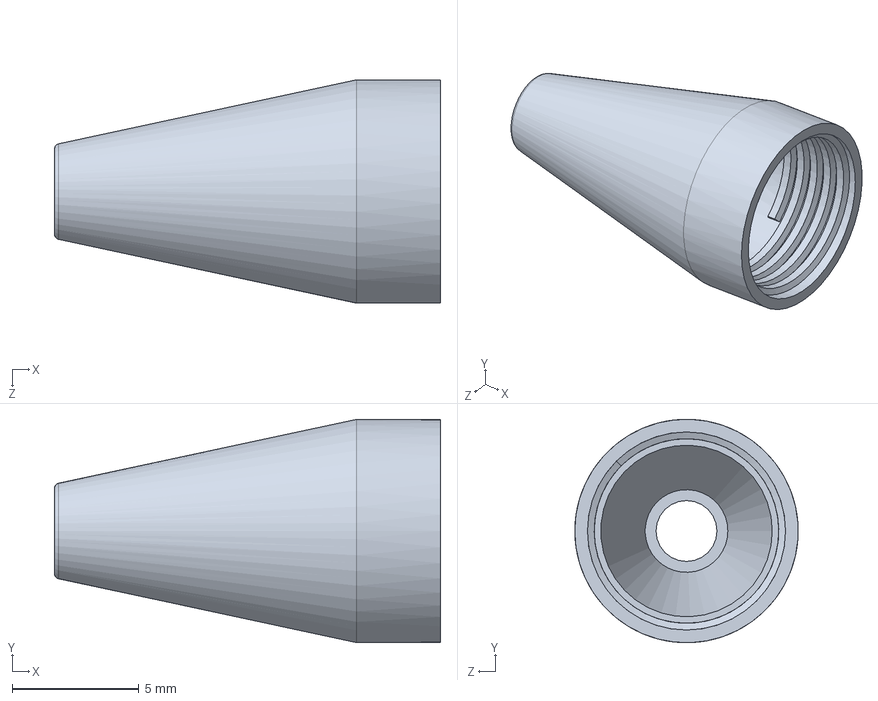
[picture p286: CAD file, 2026-10-30]
src/main/webapp/assets/Produtos/00-00 - BASE DE DADOS/Componentes/Esferográficas/23.05.03-04REV00 - CONEXÃO 07 GEL.SLDPRT
15.2 x 8.79 x 8.80 mm
