LcAvila/grade_moldes/src/main/webapp/assets/Produtos/00-00 - BASE DE DADOS/Componentes/Hidrográficas e Marcadores/23.11.04-03-REV00 - TAMPINHA NEO PEN 3D.SLDPRT

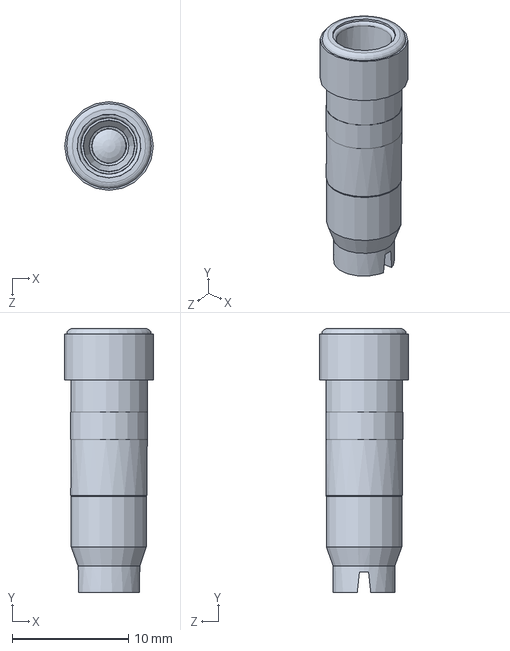
[picture p287: CAD file, 2026-10-30]
src/main/webapp/assets/Produtos/00-00 - BASE DE DADOS/Componentes/Hidrográficas e Marcadores/23.11.04-03-REV00 - TAMPINHA NEO PEN 3D.SLDPRT
7.64 x 22.8 x 7.64 mm
