LcAvila/grade_moldes/src/main/webapp/assets/Produtos/00-00 - BASE DE DADOS/Componentes/Esferográficas/23.06.03-06-REV00 - MECÂNISMO (PÇ1) TINTEIRO 01.SLDPRT

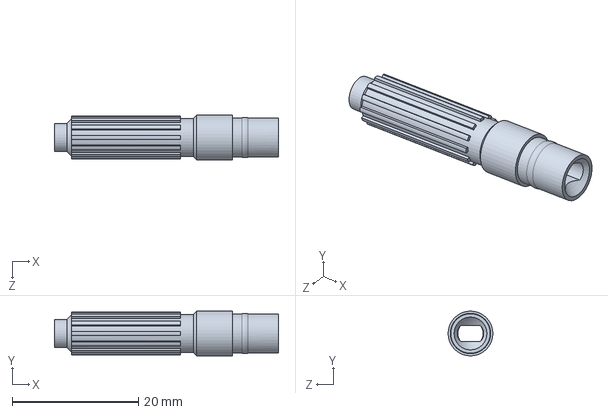
[picture p288: CAD file, 2026-10-30]
src/main/webapp/assets/Produtos/00-00 - BASE DE DADOS/Componentes/Esferográficas/23.06.03-06-REV00 - MECÂNISMO (PÇ1) TINTEIRO 01.SLDPRT
35.5 x 7.10 x 7.10 mm
