LcAvila/grade_moldes/src/main/webapp/assets/Produtos/00-00 - BASE DE DADOS/Componentes/Hidrográficas e Marcadores/23.10.05-04-01-REV01 - CORPO COLOR PP.SLDPRT

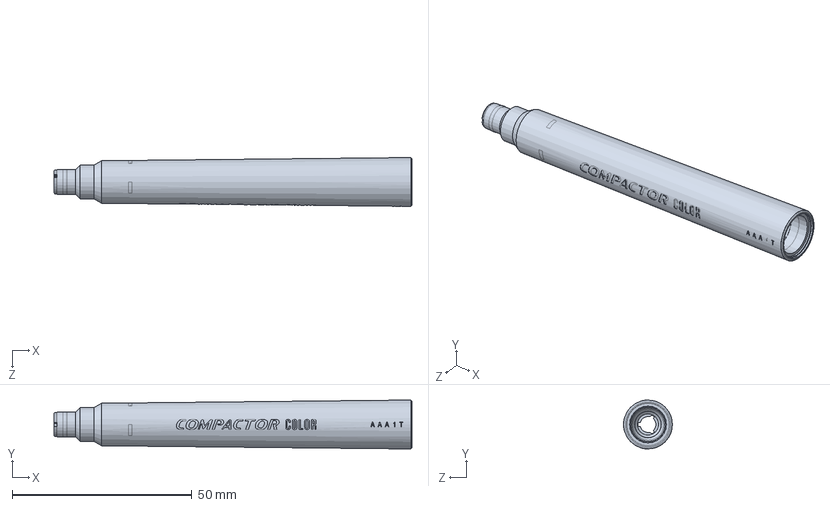
[picture p289: CAD file, 2026-10-30]
src/main/webapp/assets/Produtos/00-00 - BASE DE DADOS/Componentes/Hidrográficas e Marcadores/23.10.05-04-01-REV01 - CORPO COLOR PP.SLDPRT
99.5 x 13.6 x 13.6 mm
