LcAvila/grade_moldes/src/main/webapp/assets/Produtos/00-00 - BASE DE DADOS/Componentes/Esferográficas/23.06.03-02-REV00 - ANEL PARA TINTEIRO 01 (DOURADO).SLDPRT

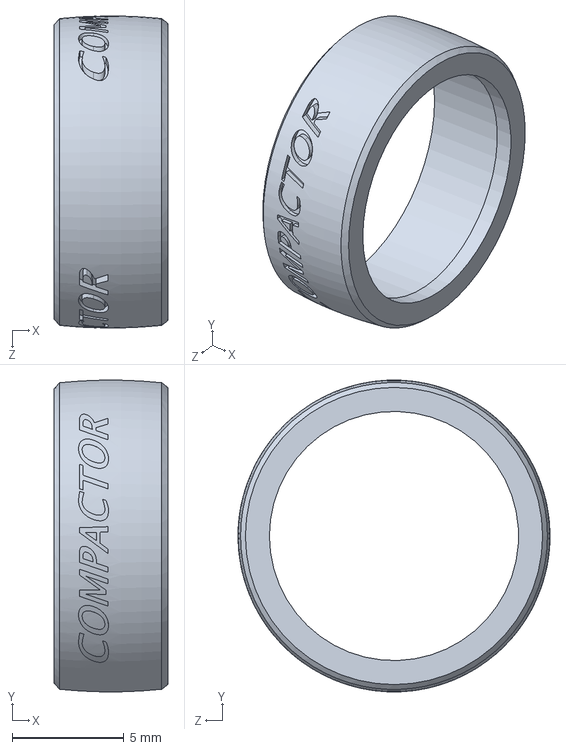
[picture p290: CAD file, 2026-10-30]
src/main/webapp/assets/Produtos/00-00 - BASE DE DADOS/Componentes/Esferográficas/23.06.03-02-REV00 - ANEL PARA TINTEIRO 01 (DOURADO).SLDPRT
5.10 x 14.0 x 14.0 mm
