LcAvila/grade_moldes/src/main/webapp/assets/Produtos/00-00 - BASE DE DADOS/Componentes/Hidrográficas e Marcadores/23.10.05-05.01 - PONTA COMPACTOR COLOR (POREX).SLDPRT

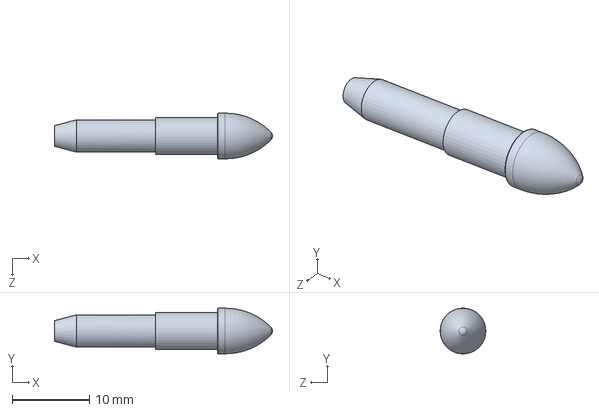
[picture p291: CAD file, 2026-10-30]
src/main/webapp/assets/Produtos/00-00 - BASE DE DADOS/Componentes/Hidrográficas e Marcadores/23.10.05-05.01 - PONTA COMPACTOR COLOR (POREX).SLDPRT
28.2 x 5.90 x 5.91 mm
