LcAvila/grade_moldes/src/main/webapp/assets/Produtos/00-00 - BASE DE DADOS/Componentes/Esferográficas/23.05.04-01-REV00 DIANTEIRA COMPACTOR SMART.SLDPRT

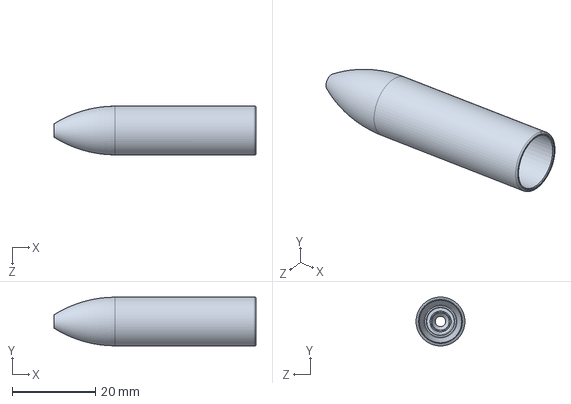
[picture p292: CAD file, 2026-10-30]
src/main/webapp/assets/Produtos/00-00 - BASE DE DADOS/Componentes/Esferográficas/23.05.04-01-REV00 DIANTEIRA COMPACTOR SMART.SLDPRT
48.5 x 11.7 x 11.7 mm
