LcAvila/grade_moldes/src/main/webapp/assets/Produtos/00-00 - BASE DE DADOS/Componentes/Esferográficas/23.05.01-09-REV01 - PONTEIRA ø0,8.SLDPRT

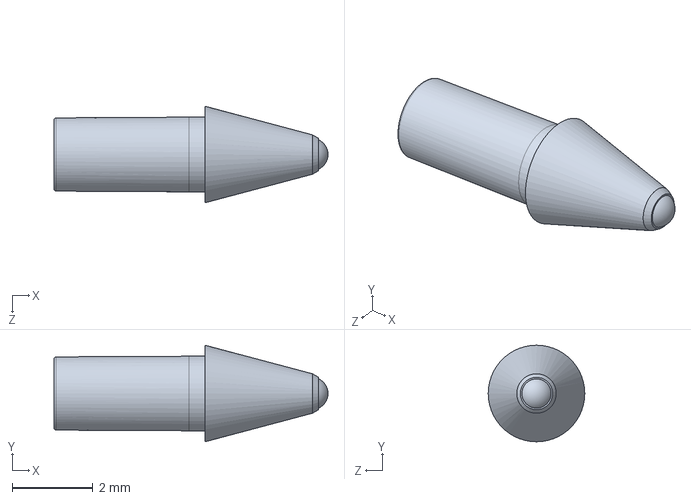
[picture p293: CAD file, 2026-10-30]
src/main/webapp/assets/Produtos/00-00 - BASE DE DADOS/Componentes/Esferográficas/23.05.01-09-REV01 - PONTEIRA ø0,8.SLDPRT
6.81 x 2.40 x 2.40 mm
