LcAvila/grade_moldes/src/main/webapp/assets/Produtos/00-00 - BASE DE DADOS/Componentes/Esferográficas/23.06.03-06-REV00 - MECÂNISMO (PÇ2) TINTEIRO 01.SLDPRT

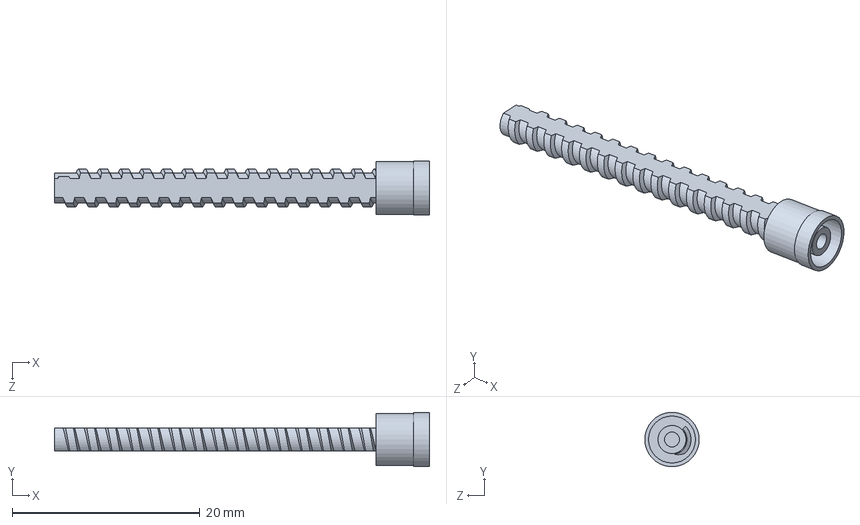
[picture p294: CAD file, 2026-10-30]
src/main/webapp/assets/Produtos/00-00 - BASE DE DADOS/Componentes/Esferográficas/23.06.03-06-REV00 - MECÂNISMO (PÇ2) TINTEIRO 01.SLDPRT
39.9 x 5.78 x 5.80 mm
