LcAvila/grade_moldes/src/main/webapp/assets/Produtos/00-00 - BASE DE DADOS/Componentes/Esferográficas/23.05.01-07-REV00 - TAMPINHA ESF (MOLDE 97 e 140 - 64 CAV).SLDPRT

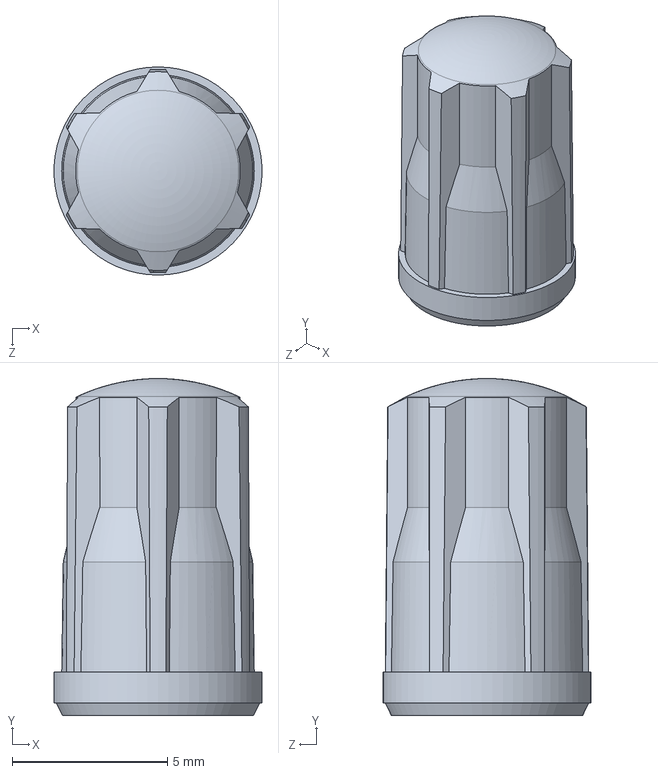
[picture p295: CAD file, 2026-10-30]
src/main/webapp/assets/Produtos/00-00 - BASE DE DADOS/Componentes/Esferográficas/23.05.01-07-REV00 - TAMPINHA ESF (MOLDE 97 e 140 - 64 CAV).SLDPRT
6.69 x 10.9 x 6.70 mm
