LcAvila/grade_moldes/src/main/webapp/assets/Produtos/00-00 - BASE DE DADOS/Componentes/Esferográficas/23.05.01-05-REV00 - TAMPA 07-DESENHO - MOLDE 117.SLDPRT

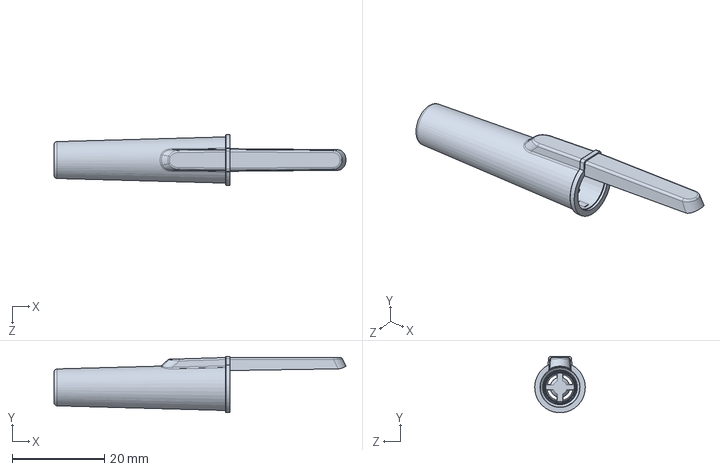
[picture p296: CAD file, 2026-10-30]
src/main/webapp/assets/Produtos/00-00 - BASE DE DADOS/Componentes/Esferográficas/23.05.01-05-REV00 - TAMPA 07-DESENHO - MOLDE 117.SLDPRT
63.2 x 12.2 x 10.9 mm
