LcAvila/grade_moldes/src/main/webapp/assets/Produtos/00-00 - BASE DE DADOS/Componentes/Esferográficas/23.05.04-05-REV00 CLIPS COMPACTOR SMART.SLDPRT

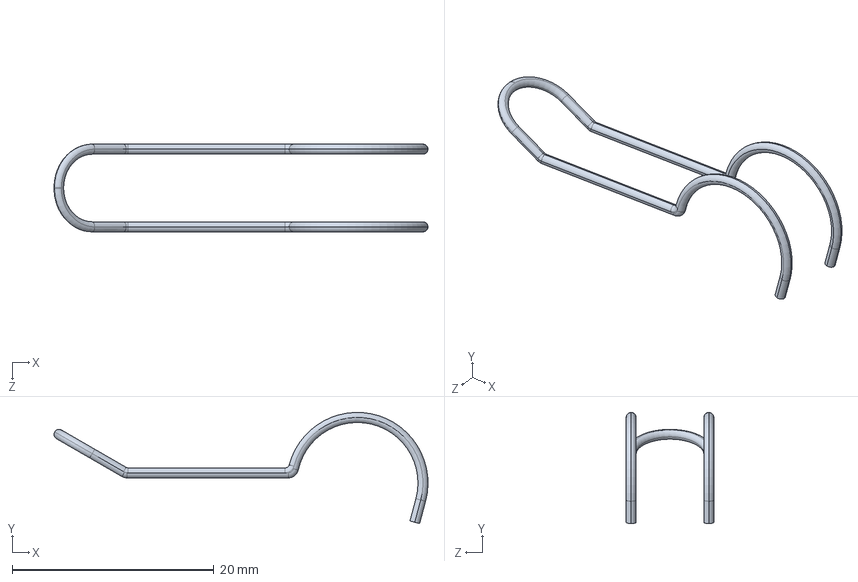
[picture p297: CAD file, 2026-10-30]
src/main/webapp/assets/Produtos/00-00 - BASE DE DADOS/Componentes/Esferográficas/23.05.04-05-REV00 CLIPS COMPACTOR SMART.SLDPRT
37.1 x 11.0 x 8.70 mm
