LcAvila/grade_moldes/src/main/webapp/assets/Produtos/00-00 - BASE DE DADOS/Componentes/Esferográficas/23.06.04-04-REV00 - LUVA DO MECANISMO ESF.B. 201 (BUCHA INTERNA).SLDPRT

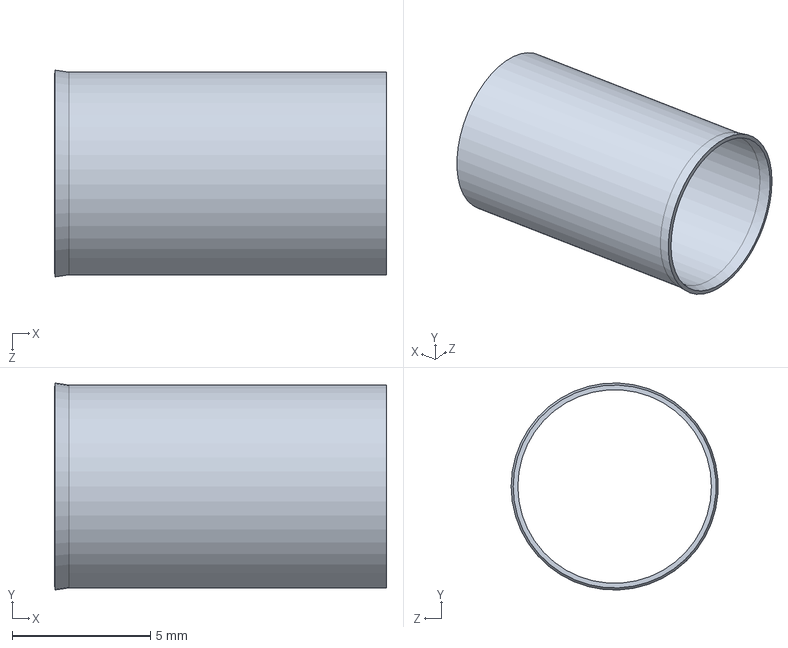
[picture p298: CAD file, 2026-10-30]
src/main/webapp/assets/Produtos/00-00 - BASE DE DADOS/Componentes/Esferográficas/23.06.04-04-REV00 - LUVA DO MECANISMO ESF.B. 201 (BUCHA INTERNA).SLDPRT
12.0 x 7.49 x 7.49 mm
