LcAvila/grade_moldes/src/main/webapp/assets/Produtos/00-00 - BASE DE DADOS/Componentes/Esferográficas/23.06.02-06-REV00 - DIANTEIRA DUO PLUS.SLDPRT

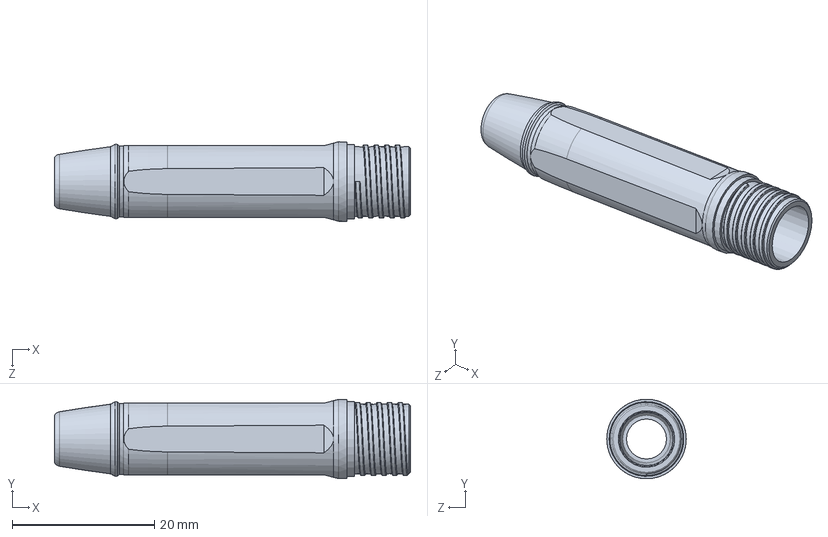
[picture p299: CAD file, 2026-10-30]
src/main/webapp/assets/Produtos/00-00 - BASE DE DADOS/Componentes/Esferográficas/23.06.02-06-REV00 - DIANTEIRA DUO PLUS.SLDPRT
50.1 x 11.2 x 11.2 mm
