LcAvila/grade_moldes/src/main/webapp/assets/Produtos/A1-47 - 07 BASIC/PRO-25.05.01-01-REV00 _ Montagem Esferografica 07 BASIC - 3D.SLDASM

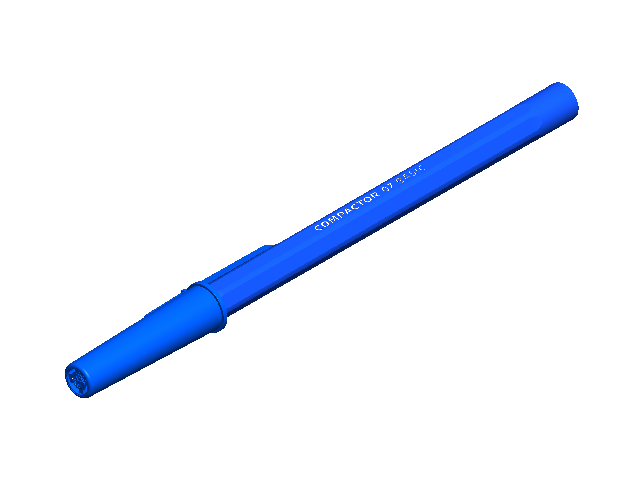
[picture p300: CAD file, 2026-10-30]
src/main/webapp/assets/Produtos/A1-47 - 07 BASIC/PRO-25.05.01-01-REV00 _ Montagem Esferografica 07 BASIC - 3D.SLDASM
COM-23.05.01-01-R00 CORPO SEXTAVADO
COM-23.05.01-07-REV00 TAMPINHA ESF.
COM-23.05.01-05-REV00 TAMPA 07
