LcAvila/grade_moldes/src/main/webapp/assets/Produtos/00-00 - BASE DE DADOS/23.05.03-00-REV00 Mont. 07 Gel.SLDASM

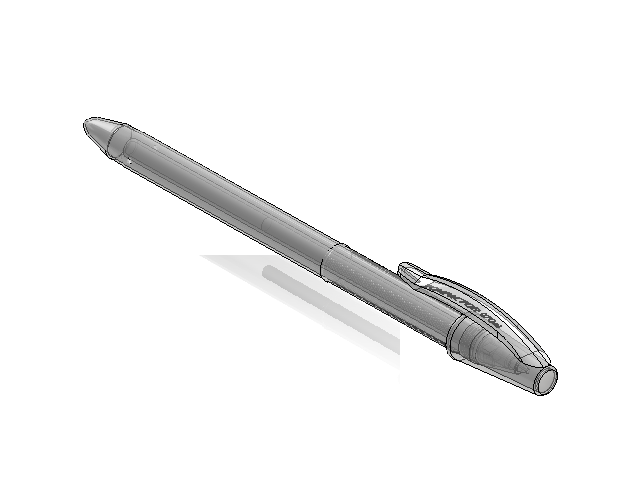
[picture p301: CAD file, 2026-10-30]
src/main/webapp/assets/Produtos/00-00 - BASE DE DADOS/23.05.03-00-REV00 Mont. 07 Gel.SLDASM
23.05.03-01-REV00 - TUBO DE CARGA 07 GEL
23.05.03-02-REV00 - CORPO 07 GEL
23.05.03-04REV00 - CONEXÃO 07 GEL
23.05.03-03-REV00 - TAMPA 07 GEL
