LcAvila/grade_moldes/src/main/webapp/assets/Produtos/00-00 - BASE DE DADOS/Componentes/Esferográficas/23.05.02-06-REV00  CARGA VIP RETRÁTIL.SLDASM

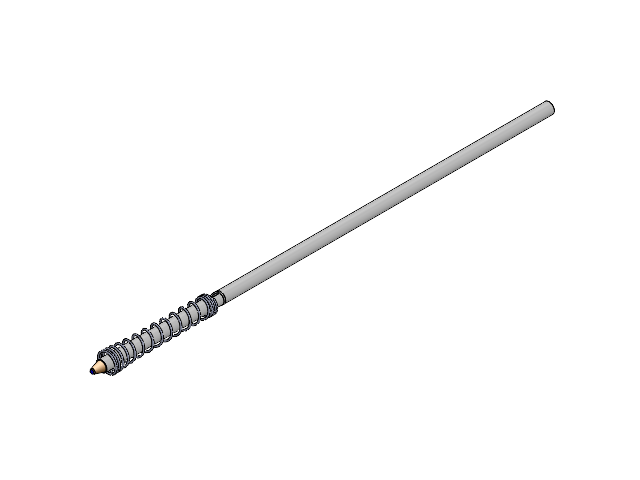
[picture p302: CAD file, 2026-10-30]
src/main/webapp/assets/Produtos/00-00 - BASE DE DADOS/Componentes/Esferográficas/23.05.02-06-REV00 CARGA VIP RETRÁTIL.SLDASM
23.05.02-04-REV01 - TUBO DE CARGA VIP RETRÁTIL
23.05.01-10-REV00 PONTEIRA ø1,00mm
23.05.02-07-REV00 MOLA 0,4 (COMPRIMIDA)
