LcAvila/grade_moldes/src/main/webapp/assets/Produtos/00-00 - BASE DE DADOS/Componentes/Esferográficas/23.06.03-06-REV00 - MECÂNISMO TINTEIRO 01 - 3D.SLDASM

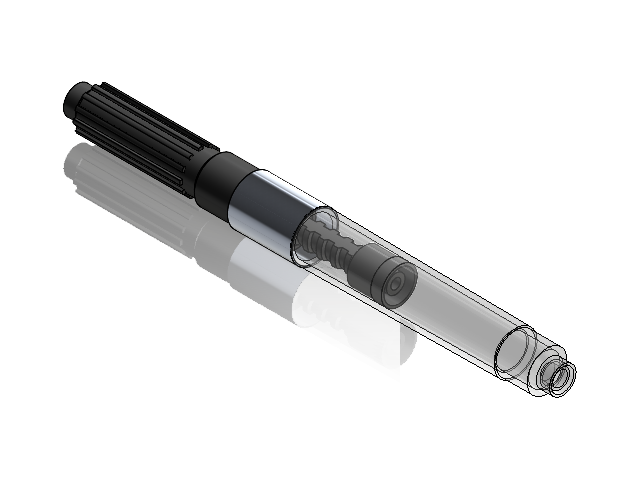
[picture p303: CAD file, 2026-10-30]
src/main/webapp/assets/Produtos/00-00 - BASE DE DADOS/Componentes/Esferográficas/23.06.03-06-REV00 - MECÂNISMO TINTEIRO 01 - 3D.SLDASM
COM-23.06.03-06-REV00 - Mecanismo 1 Tinteiro 01
COM-23.06.03-06-REV00 - Mecanismo 2 Tinteiro 01
COM-23.06.03-06-REV00 - Luva do Mecanismo 1 Tinteiro 01
COM-23.06.03-06-REV00 - Mecanismo 3 Tinteiro 01
