LcAvila/grade_moldes/src/main/webapp/assets/Produtos/00-00 - BASE DE DADOS/Componentes/Esferográficas/23.06.05-13-REV00 - MECANISMO + BOTÃO.SLDASM

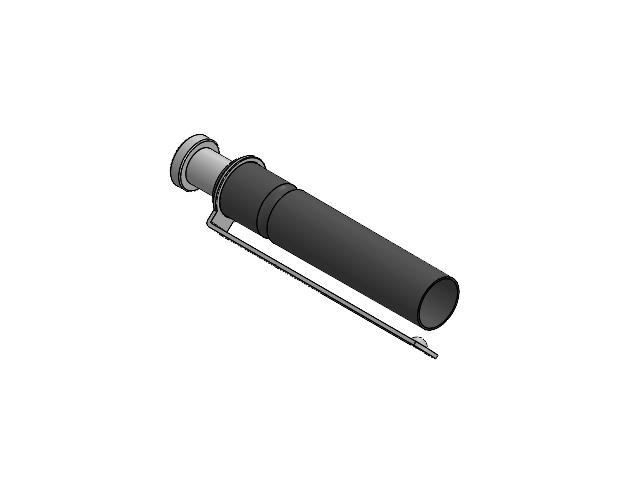
[picture p304: CAD file, 2026-10-30]
src/main/webapp/assets/Produtos/00-00 - BASE DE DADOS/Componentes/Esferográficas/23.06.05-13-REV00 - MECANISMO + BOTÃO.SLDASM
23.06.05-08-REV00 - SUPORTE MECANISMO SENATOR
23.06.05-09-REV00 - CLIP SENATOR
23.06.05-10-REV00 - BOTÃO SENATOR
23.06.05-05-REV00 - MOLA SENATOR N2 D 0.2mm x 19.60mm (2)
23.06.05-06-REV00 - FEMEA DO MECANISMO SENATOR
23.06.05-07-REV00 - MACHO DO MECANISMO SENATOR
