LcAvila/grade_moldes/src/main/webapp/assets/Produtos/00-00 - BASE DE DADOS/Componentes/Esferográficas/23.06.05-14-REV00 - PONTEIRA + CARGA.SLDASM

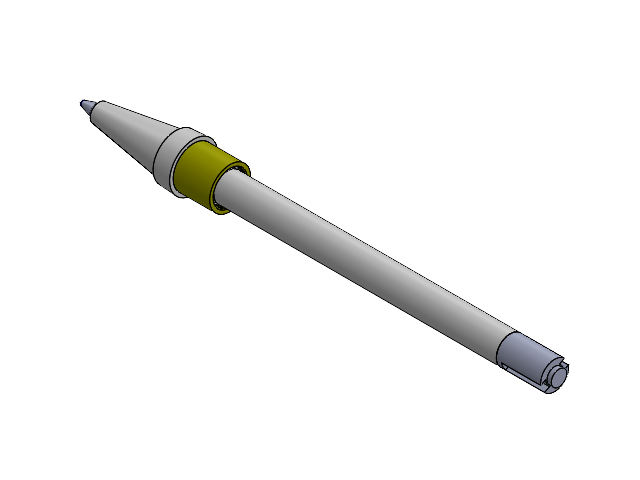
[picture p305: CAD file, 2026-10-30]
src/main/webapp/assets/Produtos/00-00 - BASE DE DADOS/Componentes/Esferográficas/23.06.05-14-REV00 - PONTEIRA + CARGA.SLDASM
23.06.05-02-REV00 - PONTEIRA CROMADA SENATOR
23.06.05-03-REV00 - BUCHA COM ROSCA SENATOR
23.06.05-04-REV00 - MOLA SENATOR N4 D 0.4mm x 30.70mm (2)
