LcAvila/grade_moldes/src/main/webapp/assets/Produtos/00-00 - BASE DE DADOS/Componentes/Esferográficas/23.06.05-12-REV00 - MECANISMO SENATOR.SLDASM

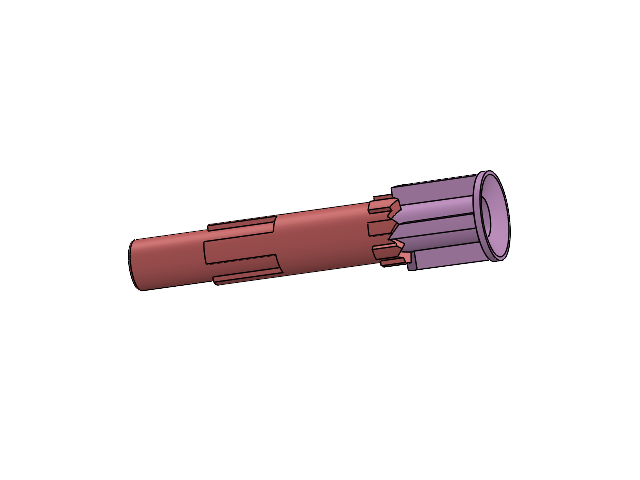
[picture p306: CAD file, 2026-10-30]
src/main/webapp/assets/Produtos/00-00 - BASE DE DADOS/Componentes/Esferográficas/23.06.05-12-REV00 - MECANISMO SENATOR.SLDASM
23.06.05-05-REV00 - MOLA SENATOR N2 D 0.2mm x 19.60mm (2)
23.06.05-06-REV00 - FEMEA DO MECANISMO SENATOR
23.06.05-07-REV00 - MACHO DO MECANISMO SENATOR
