LcAvila/grade_moldes/src/main/webapp/assets/Produtos/00-00 - BASE DE DADOS/Componentes/Esferográficas/23.03.01-15-REV00 -CARGA 1005 e SLID XB - 3D.SLDASM

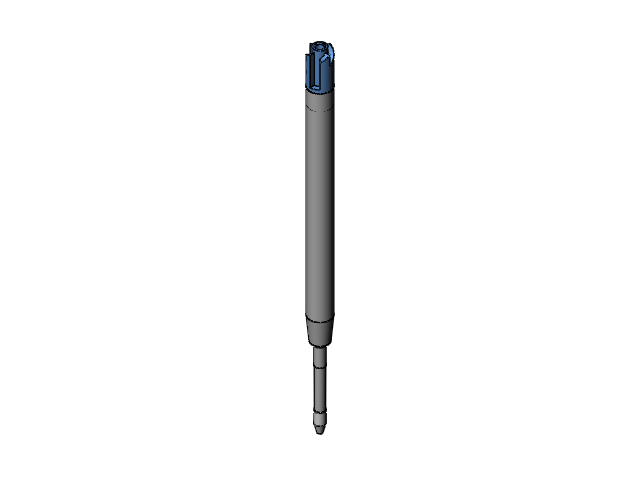
[picture p307: CAD file, 2026-10-30]
src/main/webapp/assets/Produtos/00-00 - BASE DE DADOS/Componentes/Esferográficas/23.03.01-15-REV00 -CARGA 1005 e SLID XB - 3D.SLDASM
23.03.01-15-REV00 - PONTEIRA CARGA 1005 e SLID XB - 3D
23.03.01-15-REV00 - CORPO CARGA 1005 e SLID XB - 3D
23.03.01-15-REV00 -TAMPINHA CARGA 1005 e SLID XB - 3D
