LcAvila/grade_moldes/(list of files, cad)

Other CAD files:
src/main/webapp/assets/Produtos/00-00 - BASE DE DADOS/23.05.01-18-REV00 ESF. COMPACTOR TOP 2000.SLDASM
src/main/webapp/assets/Produtos/00-00 - BASE DE DADOS/2D e PDF/HIDROGRÁFICAS/24.01.03 - 2 CORPO MARCADOR QB.DWG
src/main/webapp/assets/Produtos/00-00 - BASE DE DADOS/Componentes/Hidrográficas e Marcadores/24.01.03-01-REV00 - TAMPINHA MARCADOR QB E PINCEL - 3D.SLDPRT
src/main/webapp/assets/Produtos/00-00 - BASE DE DADOS/Componentes/Hidrográficas e Marcadores/23.10.04-2 - Tampa Pincel Macador - 3D.SLDPRT
src/main/webapp/assets/Produtos/00-00 - BASE DE DADOS/Componentes/Esferográficas/23.06.04-05-REV00 - MOLA ESF. BUSCHLER 201.SLDPRT
src/main/webapp/assets/Produtos/00-00 - BASE DE DADOS/Componentes/Esferográficas/23.05.01-20-REV00 CORPO TOP.SLDPRT
src/main/webapp/assets/Produtos/00-00 - BASE DE DADOS/2D e PDF/ESFEROGRÁFICAS/19.11.06-02-REV00 CONEXÃO 140mm.SLDDRW
src/main/webapp/assets/Produtos/00-00 - BASE DE DADOS/2D e PDF/ESFEROGRÁFICAS/23.05.01-01-REV00 - CORPO SEXTAVADO ESF. COMPACTOR.SLDDRW
src/main/webapp/assets/Produtos/00-00 - BASE DE DADOS/2D e PDF/ESFEROGRÁFICAS/23.05.01-03-REV00 - TAMPA TOP - ECONOMIC - ECONOMIC FINA - JET LUX.SLDDRW
src/main/webapp/assets/Produtos/00-00 - BASE DE DADOS/2D e PDF/ESFEROGRÁFICAS/23.05.01-05-REV00 - TAMPA 07-DESENHO - MOLDE 117.SLDDRW
src/main/webapp/assets/Produtos/00-00 - BASE DE DADOS/2D e PDF/ESFEROGRÁFICAS/23.05.01-06-REV05 - CONEXÃO ESF. PADRÃO (DESENHO).SLDDRW
src/main/webapp/assets/Produtos/00-00 - BASE DE DADOS/2D e PDF/ESFEROGRÁFICAS/23.05.01-07-REV00 - TAMPINHA ESF (MOLDE 97 e 140 - 64 CAV).SLDDRW
src/main/webapp/assets/Produtos/00-00 - BASE DE DADOS/2D e PDF/ESFEROGRÁFICAS/23.05.01-08-REV00 - TUBO ESF..SLDDRW
src/main/webapp/assets/Produtos/00-00 - BASE DE DADOS/2D e PDF/ESFEROGRÁFICAS/23.05.01-09-REV01 - PONTEIRA ø0,8.SLDDRW
src/main/webapp/assets/Produtos/00-00 - BASE DE DADOS/2D e PDF/ESFEROGRÁFICAS/23.05.01-10-REV00 PONTEIRA ø1,00mm.SLDDRW
src/main/webapp/assets/Produtos/00-00 - BASE DE DADOS/2D e PDF/ESFEROGRÁFICAS/23.05.01-11-REV00 - PONTEIRA ø1,2mm.SLDDRW
src/main/webapp/assets/Produtos/00-00 - BASE DE DADOS/2D e PDF/ESFEROGRÁFICAS/23.05.01-12-REV00 ESF. 07.SLDDRW
src/main/webapp/assets/Produtos/00-00 - BASE DE DADOS/2D e PDF/ESFEROGRÁFICAS/23.05.01-13 - ESF. COMPACTOR 07B 1,20.SLDDRW
src/main/webapp/assets/Produtos/00-00 - BASE DE DADOS/2D e PDF/ESFEROGRÁFICAS/23.05.01-14-REV00 07 POP.SLDDRW
src/main/webapp/assets/Produtos/00-00 - BASE DE DADOS/2D e PDF/ESFEROGRÁFICAS/23.05.01-15 - ESF. COMPACTOR ECONOMIC.SLDDRW
src/main/webapp/assets/Produtos/00-00 - BASE DE DADOS/2D e PDF/ESFEROGRÁFICAS/23.05.01-16-REV00 - ESF. COMPACTOR ECONOMIC FINA.SLDDRW
src/main/webapp/assets/Produtos/00-00 - BASE DE DADOS/2D e PDF/ESFEROGRÁFICAS/23.05.01-17-REV00 ESF. COMPACTOR JET LUX.SLDDRW
src/main/webapp/assets/Produtos/00-00 - BASE DE DADOS/2D e PDF/ESFEROGRÁFICAS/23.05.01-18-REV00 ESF. COMPACTOR TOP 2000.SLDDRW
src/main/webapp/assets/Produtos/00-00 - BASE DE DADOS/2D e PDF/ESFEROGRÁFICAS/23.05.02-09-REV00 - ESF 07 VIP RETRÁTIL (COMPACTOR).SLDDRW
src/main/webapp/assets/Produtos/00-00 - BASE DE DADOS/2D e PDF/ESFEROGRÁFICAS/23.05.03-00-REV00 Mont. 07 Gel.SLDDRW
src/main/webapp/assets/Produtos/00-00 - BASE DE DADOS/2D e PDF/ESFEROGRÁFICAS/23.05.04-08-REV00 COMPACTOR SMART - 3D.SLDDRW
src/main/webapp/assets/Produtos/00-00 - BASE DE DADOS/2D e PDF/ESFEROGRÁFICAS/23.06.02-10-REV00 - CANETA ROLLER DUO PLUS.SLDDRW
src/main/webapp/assets/Produtos/00-00 - BASE DE DADOS/2D e PDF/ESFEROGRÁFICAS/23.06.03-08-REV00 - MONT. TINTEIRO 01.SLDDRW
src/main/webapp/assets/Produtos/00-00 - BASE DE DADOS/2D e PDF/ESFEROGRÁFICAS/23.06.04-08-REV00 - ESF. BUSCHLER 201.SLDDRW
src/main/webapp/assets/Produtos/00-00 - BASE DE DADOS/2D e PDF/ESFEROGRÁFICAS/23.06.05-01-REV00 - ESFEROGRÁFICA SENATOR.SLDDRW
src/main/webapp/assets/Produtos/00-00 - BASE DE DADOS/2D e PDF/ESFEROGRÁFICAS/COM-23.03.01-15-REV00 -CARGA 1005 e SLID XB - 2D.SLDDRW
src/main/webapp/assets/Produtos/00-00 - BASE DE DADOS/2D e PDF/ESFEROGRÁFICAS/COM-23.05.01-02REV00 - CORPO VIP RETRÁTIL - 3D.SLDDRW
src/main/webapp/assets/Produtos/00-00 - BASE DE DADOS/2D e PDF/ESFEROGRÁFICAS/COM-23.05.01-02REV00 CORPO TOP.SLDDRW
src/main/webapp/assets/Produtos/00-00 - BASE DE DADOS/2D e PDF/ESFEROGRÁFICAS/COM-23.05.02 - 07-REV01 CARGA VIP RETRÁTIL (PREMEC).SLDDRW
src/main/webapp/assets/Produtos/00-00 - BASE DE DADOS/2D e PDF/ESFEROGRÁFICAS/COM-23.05.02-02-REV00 - BOTÃO VIP RETRÁTIL.SLDDRW
src/main/webapp/assets/Produtos/00-00 - BASE DE DADOS/2D e PDF/ESFEROGRÁFICAS/COM-23.05.02-03-REV00 - TAMPA CLIP VIP RETRATIL.SLDDRW
src/main/webapp/assets/Produtos/00-00 - BASE DE DADOS/2D e PDF/ESFEROGRÁFICAS/COM-23.05.02-04-REV01 - TUBO DE CARGA VIP RETRÁTIL.SLDDRW
src/main/webapp/assets/Produtos/00-00 - BASE DE DADOS/2D e PDF/ESFEROGRÁFICAS/COM-23.05.02-08-REV00 PONTEIRA 07 VIP Ø1,0 - Ø0,8 (PREMEC).SLDDRW
src/main/webapp/assets/Produtos/00-00 - BASE DE DADOS/2D e PDF/ESFEROGRÁFICAS/COM-23.05.03-01-REV00 - TUBO DE CARGA 07 GEL.SLDDRW
src/main/webapp/assets/Produtos/00-00 - BASE DE DADOS/2D e PDF/ESFEROGRÁFICAS/COM-23.05.03-02-REV00 - CORPO 07 GEL.SLDDRW
src/main/webapp/assets/Produtos/00-00 - BASE DE DADOS/2D e PDF/ESFEROGRÁFICAS/COM-23.05.03-03-REV00 - TAMPA 07 GEL.SLDDRW
src/main/webapp/assets/Produtos/00-00 - BASE DE DADOS/2D e PDF/ESFEROGRÁFICAS/COM-23.05.03-04-REV00 - CONEXÃO 07 GEL.SLDDRW
src/main/webapp/assets/Produtos/00-00 - BASE DE DADOS/2D e PDF/ESFEROGRÁFICAS/COM-23.05.04-01-REV00 - DIANTEIRA COMPACTOR SMART.SLDDRW
src/main/webapp/assets/Produtos/00-00 - BASE DE DADOS/2D e PDF/ESFEROGRÁFICAS/COM-23.05.04-02-REV00 - CAMISA COMPACTOR SMART.SLDDRW
src/main/webapp/assets/Produtos/00-00 - BASE DE DADOS/2D e PDF/ESFEROGRÁFICAS/COM-23.05.04-03-REV00 - TAMPA COMPACTOR SMART.SLDDRW
src/main/webapp/assets/Produtos/00-00 - BASE DE DADOS/2D e PDF/ESFEROGRÁFICAS/COM-23.05.04-04-REV00 - MECANISMO COMPACTOR SMART.SLDDRW
src/main/webapp/assets/Produtos/00-00 - BASE DE DADOS/2D e PDF/ESFEROGRÁFICAS/COM-23.05.04-05-REV00 - CLIPS COMPACTOR SMART.SLDDRW
src/main/webapp/assets/Produtos/00-00 - BASE DE DADOS/2D e PDF/ESFEROGRÁFICAS/COM-23.05.04-06-REV00 - ANEL ELÁSTICO COMPACTOR SMART.SLDDRW
src/main/webapp/assets/Produtos/00-00 - BASE DE DADOS/2D e PDF/ESFEROGRÁFICAS/COM-23.05.04-07-REV00 - MOLA COMPACTOR SMART.SLDDRW
src/main/webapp/assets/Produtos/00-00 - BASE DE DADOS/2D e PDF/ESFEROGRÁFICAS/COM-23.06.02-01-REV00 - CAPA DIANTEIRA DUO PLUS (2).SLDDRW
src/main/webapp/assets/Produtos/00-00 - BASE DE DADOS/2D e PDF/ESFEROGRÁFICAS/COM-23.06.02-01-REV00 - CAPA DIANTEIRA DUO PLUS.SLDDRW
src/main/webapp/assets/Produtos/00-00 - BASE DE DADOS/2D e PDF/ESFEROGRÁFICAS/COM-23.06.02-01-REV00 Carga Duo Plus (Marca texto).SLDDRW
src/main/webapp/assets/Produtos/00-00 - BASE DE DADOS/2D e PDF/ESFEROGRÁFICAS/COM-23.06.02-02-REV00 - INSERTO DA TAMPA.SLDDRW
src/main/webapp/assets/Produtos/00-00 - BASE DE DADOS/2D e PDF/ESFEROGRÁFICAS/COM-23.06.02-03-REV00 - CLIPS.SLDDRW
src/main/webapp/assets/Produtos/00-00 - BASE DE DADOS/2D e PDF/ESFEROGRÁFICAS/COM-23.06.02-04-REV00 - ANEL DO CORPO DUO PLUS.SLDDRW
src/main/webapp/assets/Produtos/00-00 - BASE DE DADOS/2D e PDF/ESFEROGRÁFICAS/COM-23.06.02-04-REV00 - ANEL PARA TINTEIRO.SLDDRW
src/main/webapp/assets/Produtos/00-00 - BASE DE DADOS/2D e PDF/ESFEROGRÁFICAS/COM-23.06.02-05-REV00 - CONECTOR DUO PLUS.SLDDRW
src/main/webapp/assets/Produtos/00-00 - BASE DE DADOS/2D e PDF/ESFEROGRÁFICAS/COM-23.06.02-06-REV00 - DIANTEIRA DUO PLUS (2).SLDDRW
src/main/webapp/assets/Produtos/00-00 - BASE DE DADOS/2D e PDF/ESFEROGRÁFICAS/COM-23.06.02-06-REV00 - DIANTEIRA DUO PLUS.SLDDRW
src/main/webapp/assets/Produtos/00-00 - BASE DE DADOS/2D e PDF/ESFEROGRÁFICAS/COM-23.06.02-07-REV00 - TAMPA INTERNA DUO PLUS.SLDDRW
src/main/webapp/assets/Produtos/00-00 - BASE DE DADOS/2D e PDF/ESFEROGRÁFICAS/COM-23.06.02-08-REV00 - CAPA TRASEIRA DUO PLUS (2).SLDDRW
src/main/webapp/assets/Produtos/00-00 - BASE DE DADOS/2D e PDF/ESFEROGRÁFICAS/COM-23.06.02-08-REV00 - CAPA TRASEIRA DUO PLUS.SLDDRW
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
