LcAvila/grade_moldes/src/main/webapp/assets/Produtos/00-00 - BASE DE DADOS/Componentes/Lapiseiras/13.03.05-03-REV00-Mecanismo Lap. Técnico.pdf

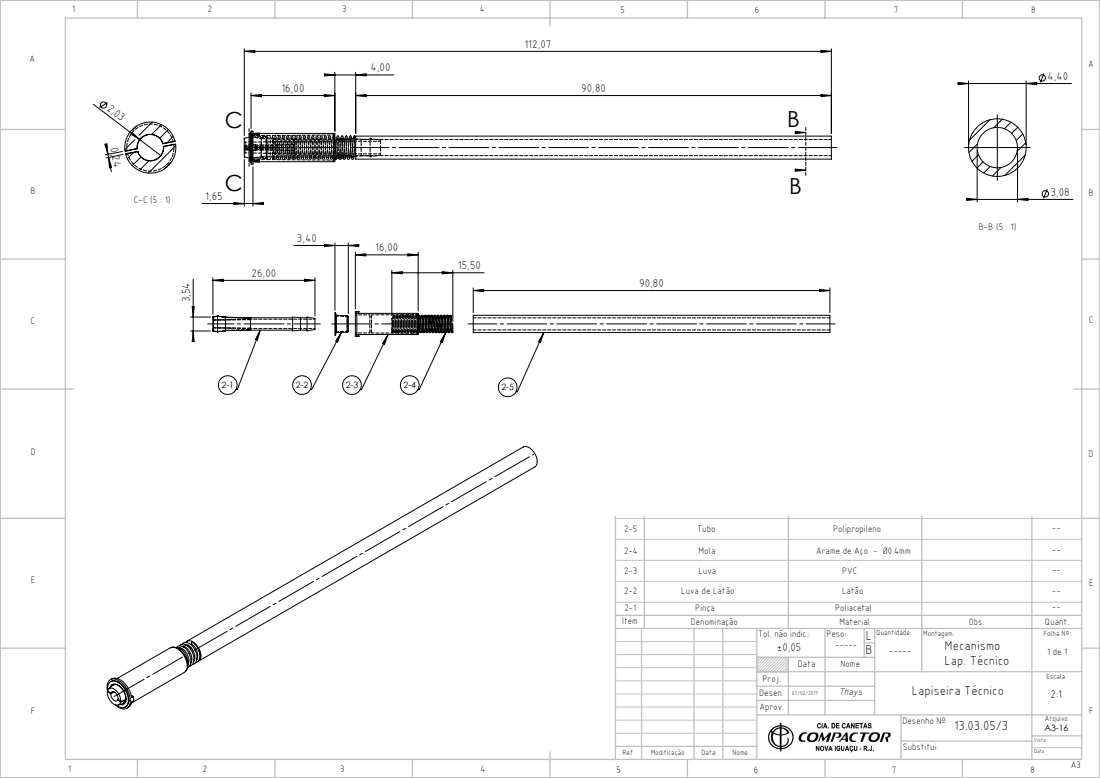
[picture p309: page 1]
Arame de Aço - Ø0.4mm

Tubo
Mola
Luva
Luva de Latão

Item | Denominação | Material | Obs. | Quant.

Tol. não indic.: ±0,05 | Peso: | L | Quantidade: | Montagem: Mecanismo Lap. Técnico | Folha Nº 1 de 1

Data | Nome

Proj. | | | Lapiseira Técnico | Escala 2:1
Desen. | 02/02/2017 | Thays
Aprov.

Desenho Nº 13.03.05/3 | Arquivo A3-16
