LcAvila/grade_moldes/src/main/webapp/assets/Produtos/00-00 - BASE DE DADOS/Componentes/Lapiseiras/13.03.05-REV02-BotãoLapi. Técnico.pdf

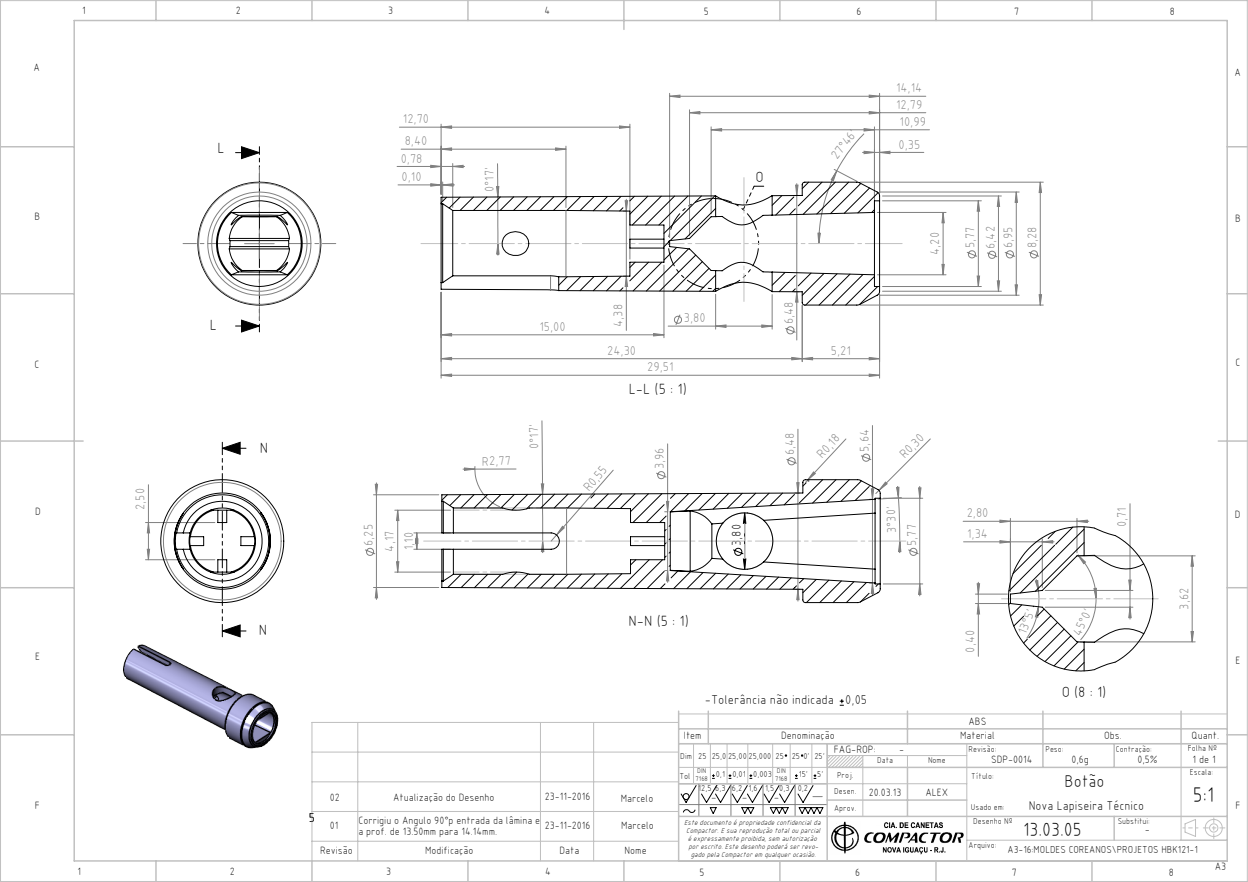
[picture p310: page 1]
Corrigiu o Angulo 90°p entrada da lâmina e; a prof. de 13.50mm para 14.14mm.

O (8 : 1) -Tolerância não indicada 0,05

Item | Denominação | Material | Obs. | Quant.
25 25,0 25,00 25,000 25 25 0' 25' DIN DIN Tol 7168 0,1 0,01 0,003 15' 5' 7168 | FAG-ROP: - | Revisão: SDP-0014 | Peso: 0,6g | Contração: | Folha Nº 1 de 1
Data | Nome | 0,5% Dim

Proj. | | | Título: Botão Usado em: Nova Lapiseira Técnico | Escala: 5:1

02 | Atualização do Desenho | 23-11-2016 | Marcelo | | 12,5 6,3 | 6,2 1,6 | 1,5 0,3 | 0,2 | Desen. | 20.03.13 | ALEX

Aprov.

Este documento é propriedade confidencial da Compactor. E sua reprodução total ou parcial é expressamente proibida, sem autorização por escrito. Este desenho poderá ser revo-gado pela Compactor em qualquer ocasião. | | Desenho Nº 13.03.05 | Substitui: -

Revisão | Modificação | Data | Nome | | | Arquivo: A3-16:MOLDES COREANOS\PROJETOS HBK121-1
