LcAvila/grade_moldes/src/main/webapp/assets/Produtos/00-00 - BASE DE DADOS/Componentes/Lapiseiras/16.09.01-01-REV00 - Lâmina  Corrigida.pdf

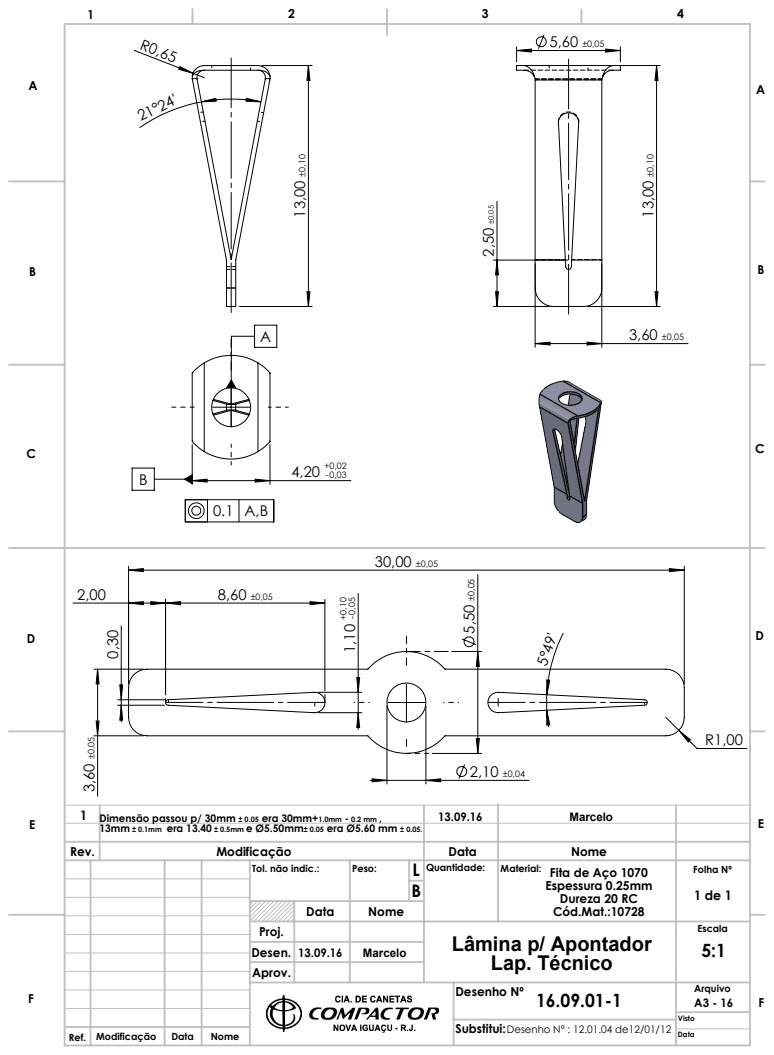
[picture p311: page 1]
Desenho N° : 12.01.04 de12/01/12

1 Dimensão passou p/ 30mm ± 0.05 era 30mm+1.0mm - 0.2 mm , | 13mm ± 0.1mm era 13.40 ± 0.5mm e Ø5.50mm± 0.05 era Ø5.60 mm ± 0.05. | 13.09.16 Marcelo

Rev. | Modificação | Data | Nome

Tol. não indic.: | Peso: | L | Quantidade: | Material: Fita de Aço 1070 Espessura 0.25mm Dureza 20 RC Cód.Mat.:10728 | Folha Nº 1 de 1

Data | Nome
Proj. | | | Lâmina p/ Apontador Lap. Técnico | Escala 5:1
Desen. | 13.09.16 Marcelo
Aprov.

Desenho Nº 16.09.01-1 | Arquivo A3 - 16
