LcAvila/grade_moldes/src/main/webapp/assets/Produtos/00-00 - BASE DE DADOS/Componentes/Lapiseiras/16.09.01-3-REV00-CLIPS Lap.Técnico.pdf

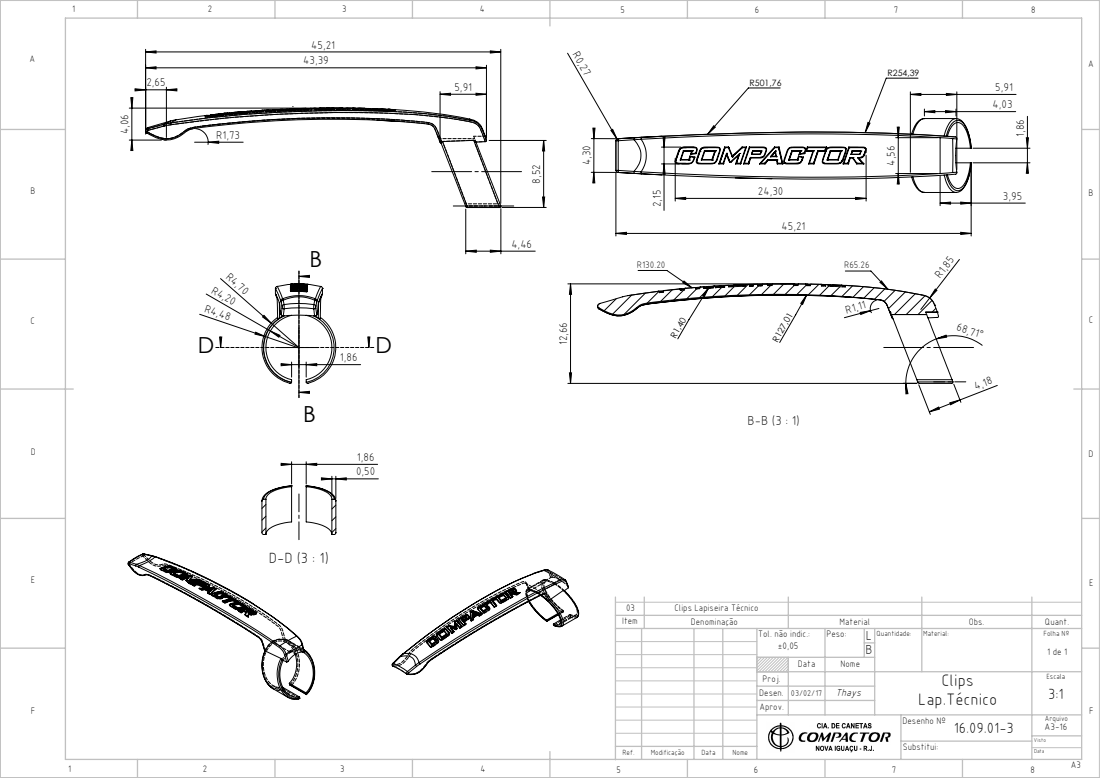
[picture p312: page 1]
Clips Lapiseira Técnico

Item | Denominação | Material | Obs. | Quant.

Tol. não indic.: ±0,05 | Peso: | L | Quantidade: | Material: | Folha Nº 1 de 1

Data | Nome

Proj. | | | Clips | Escala 3:1
Desen. | | Thays | Lap.Técnico 03/02/17
Aprov.

Desenho Nº 16.09.01-3 | Arquivo A3-16
