LcAvila/grade_moldes/src/main/webapp/assets/Produtos/00-00 - BASE DE DADOS/Componentes/Lapiseiras/99.07.18-1-REV01 - Lapiseira Técnico.pdf

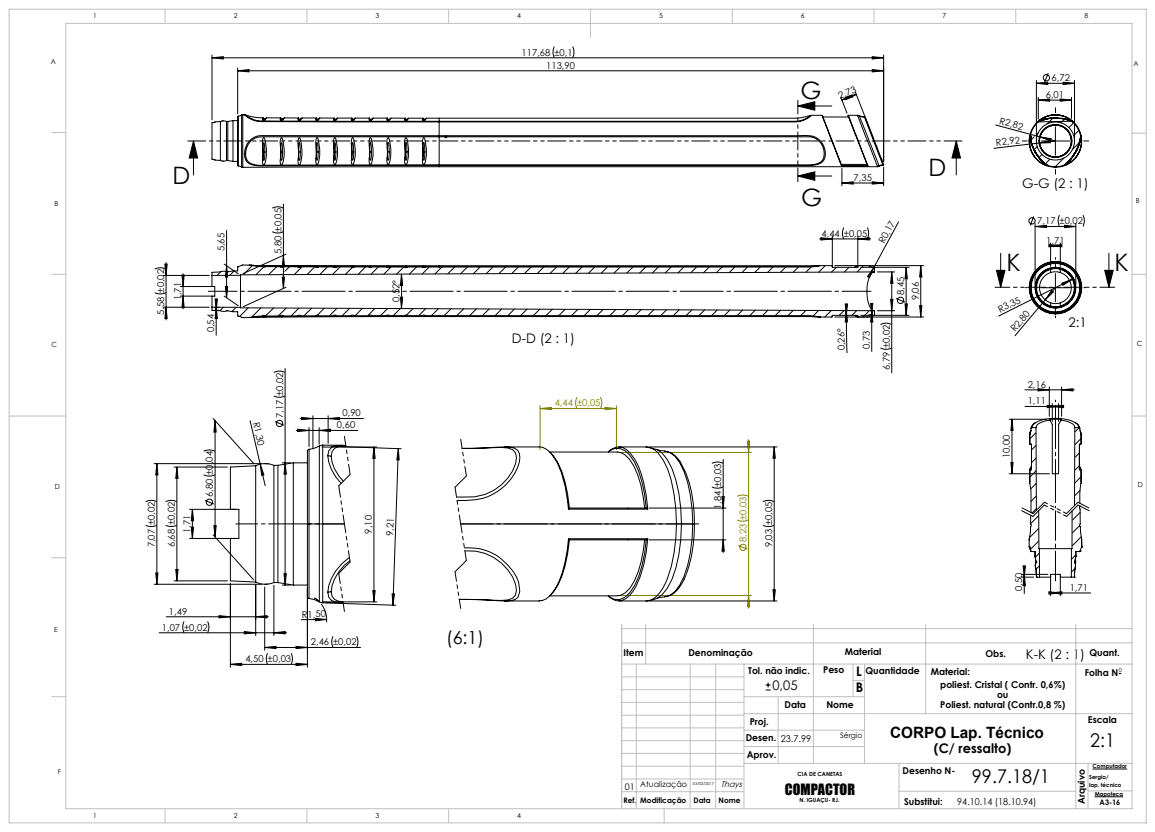
[picture p313: page 1]
DEF C

Item | Denominação | Material | Obs. K-K (2 : 1) | Quant.

Tol. não indic. | Peso | LB | Quantidade | Material: poliest. Cristal ( Contr. 0,6%) ou Poliest. natural (Contr.0,8 %) | Folha N-0

Data | Nome
Proj. | 23.7.99 | | CORPO Lap. Técnico (C/ ressalto) | Escala Arquivo 2:1
Desen. | | Sérgio
Aprov.
CIA DE CANETAS COMPACTOR N. IGUAÇU- RJ. | Desenho N-99.7.18/1 | | Sergio/ Computador lap. técnico

Atualização 01 | | Thays 03/02/2017
Ref. | Modificação | Data | Nome | Substitui: 94.10.14 (18.10.94) | Mapoteca A3-16
