LcAvila/grade_moldes/src/main/webapp/assets/Produtos/00-00 - BASE DE DADOS/2D e PDF/HIDROGRÁFICAS/COM-23.10.05-05.09 - PONTEIRA MICROLINE (DESENHO).pdf

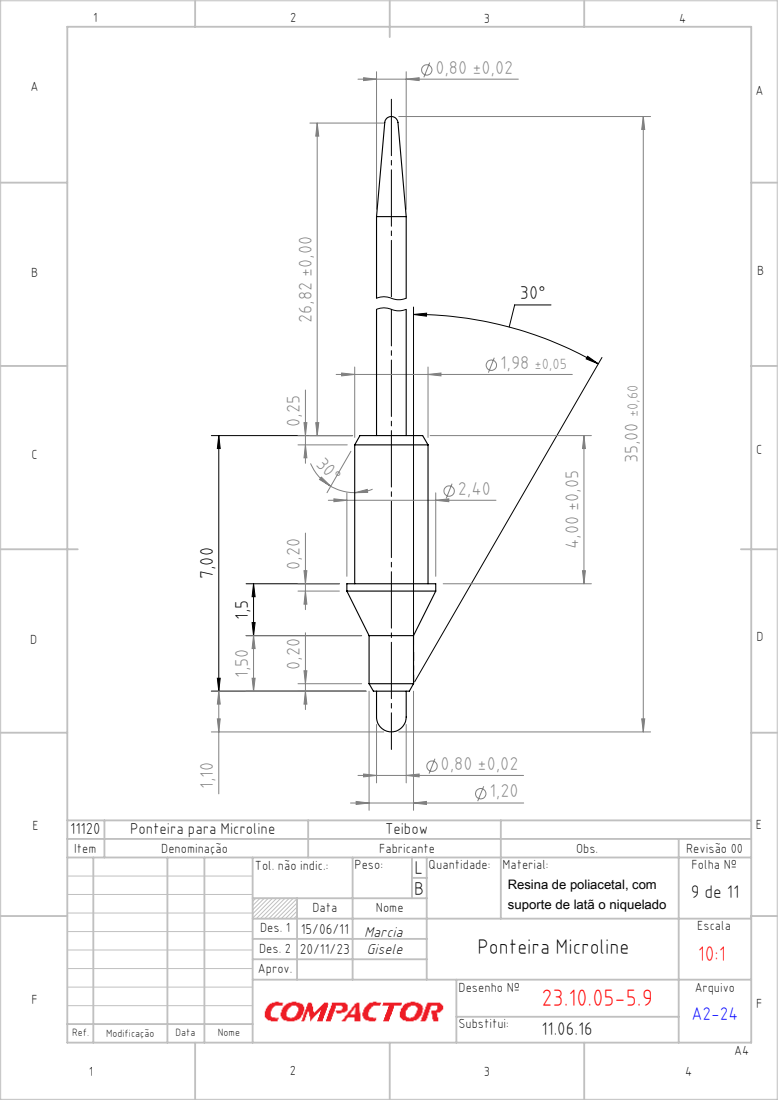
[picture p314: page 1]

11120 | Ponteira para Microline | Teibow
Item | Denominação | Fabricante | Obs. | Revisão 00

Tol. não indic.: | Peso: | L | Quantidade: | Material: Resina de poliacetal, com suporte de latã o niquelado | Folha Nº 9 de 11

Data | Nome

Des. 1 | 15/06/11 | Marcia | Ponteira Microline | Escala 10:1
Des. 2 | 20/11/23 | Gisele
Aprov.

Desenho Nº 23.10.05-5.9 | Arquivo A2-24
