LcAvila/grade_moldes/src/main/webapp/assets/Produtos/00-00 - BASE DE DADOS/Componentes/Lapiseiras/23.07.02 - 2 - Dianteira Modificada _ Medida Interna.PDF

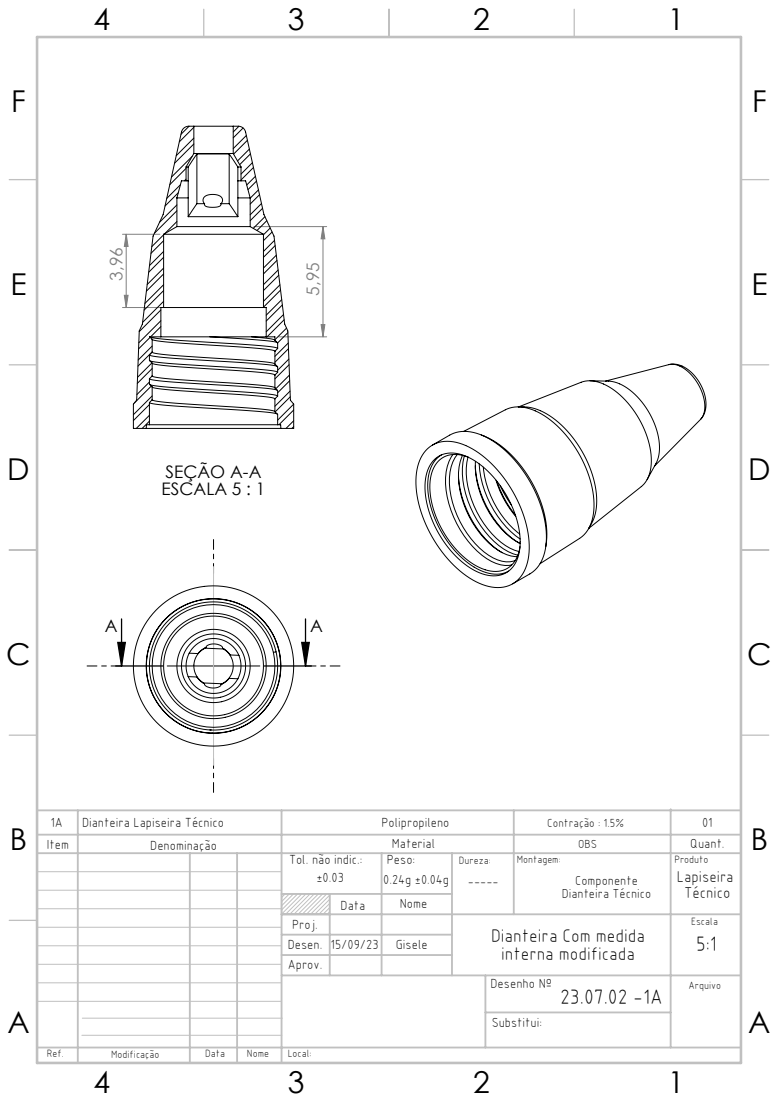
[picture p315: page 1]
SEÇÃO A-A ESCALA 5 : 1

1A | Dianteira Lapiseira Técnico | Polipropileno | Contração : 1.5% | 01
Item | Denominação | Material | OBS | Quant.

Tol. não indic.: ±0.03 | Peso: 0.24g ±0.04g | Dureza: ----- | Montagem: Componente Dianteira Técnico | Produto Lapiseira Técnico

Data | Nome
Proj. | | | interna modificada | Escala 5:1 Dianteira Com medida
Desen. | 15/09/23 | Gisele
Aprov.

Desenho Nº 23.07.02 -1A | Arquivo
