LcAvila/grade_moldes/src/main/webapp/assets/Produtos/00-00 - BASE DE DADOS/2D e PDF/HIDROGRÁFICAS/COM-23.10.05-05.11 - PONTA MICROLINE ART COLOR (DESENHO).pdf

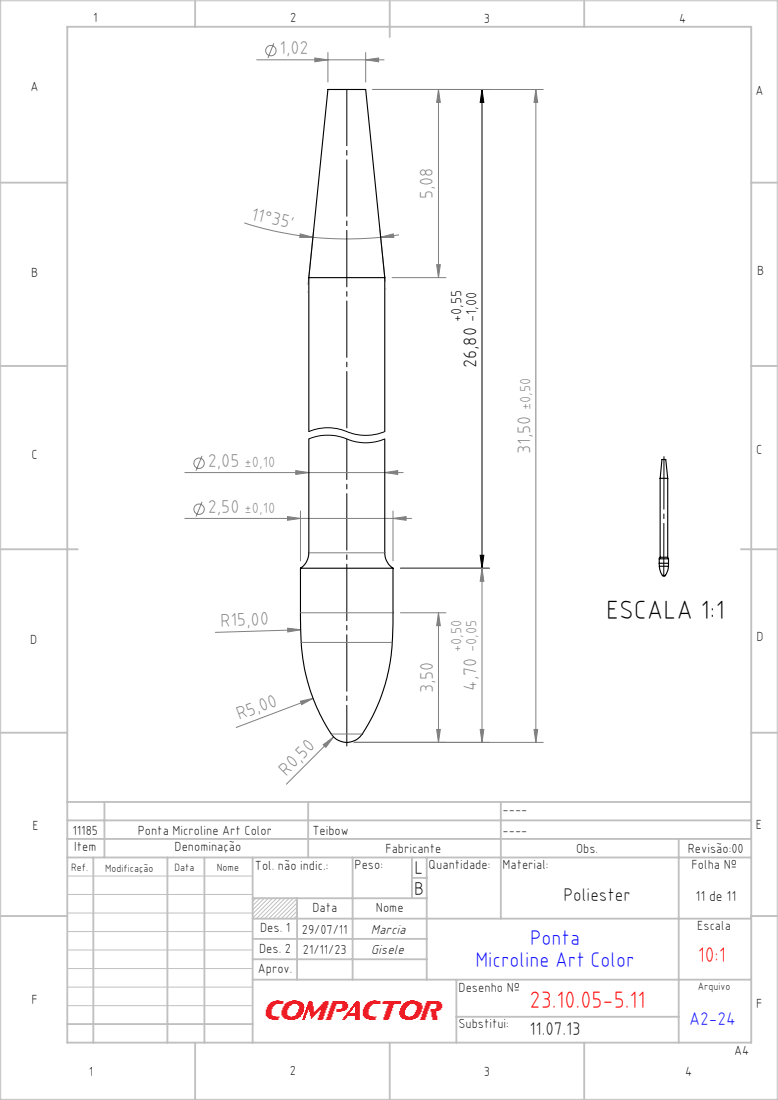
[picture p316: page 1]
ESCALA 1:1

11185 | Ponta Microline Art Color | Teibow | ----
Item | Denominação | Fabricante | Obs. | Revisão:00
Ref. | Modificação | Data | Nome | Tol. não indic.: | Peso: | L | Quantidade: | Material: Poliester | Folha Nº 11 de 11

Data | Nome

Des. 1 | 29/07/11 | Marcia | Ponta Microline Art Color | Escala 10:1
Des. 2 | 21/11/23 | Gisele
Aprov.

Desenho Nº 23.10.05-5.11 | Arquivo A2-24
