LcAvila/grade_moldes/src/main/webapp/assets/Produtos/00-00 - BASE DE DADOS/Embalagens/Caixas Master/25.10.03.01-R00 - 16612 - Caixa Master N°01 (Desenho Técnico).PDF

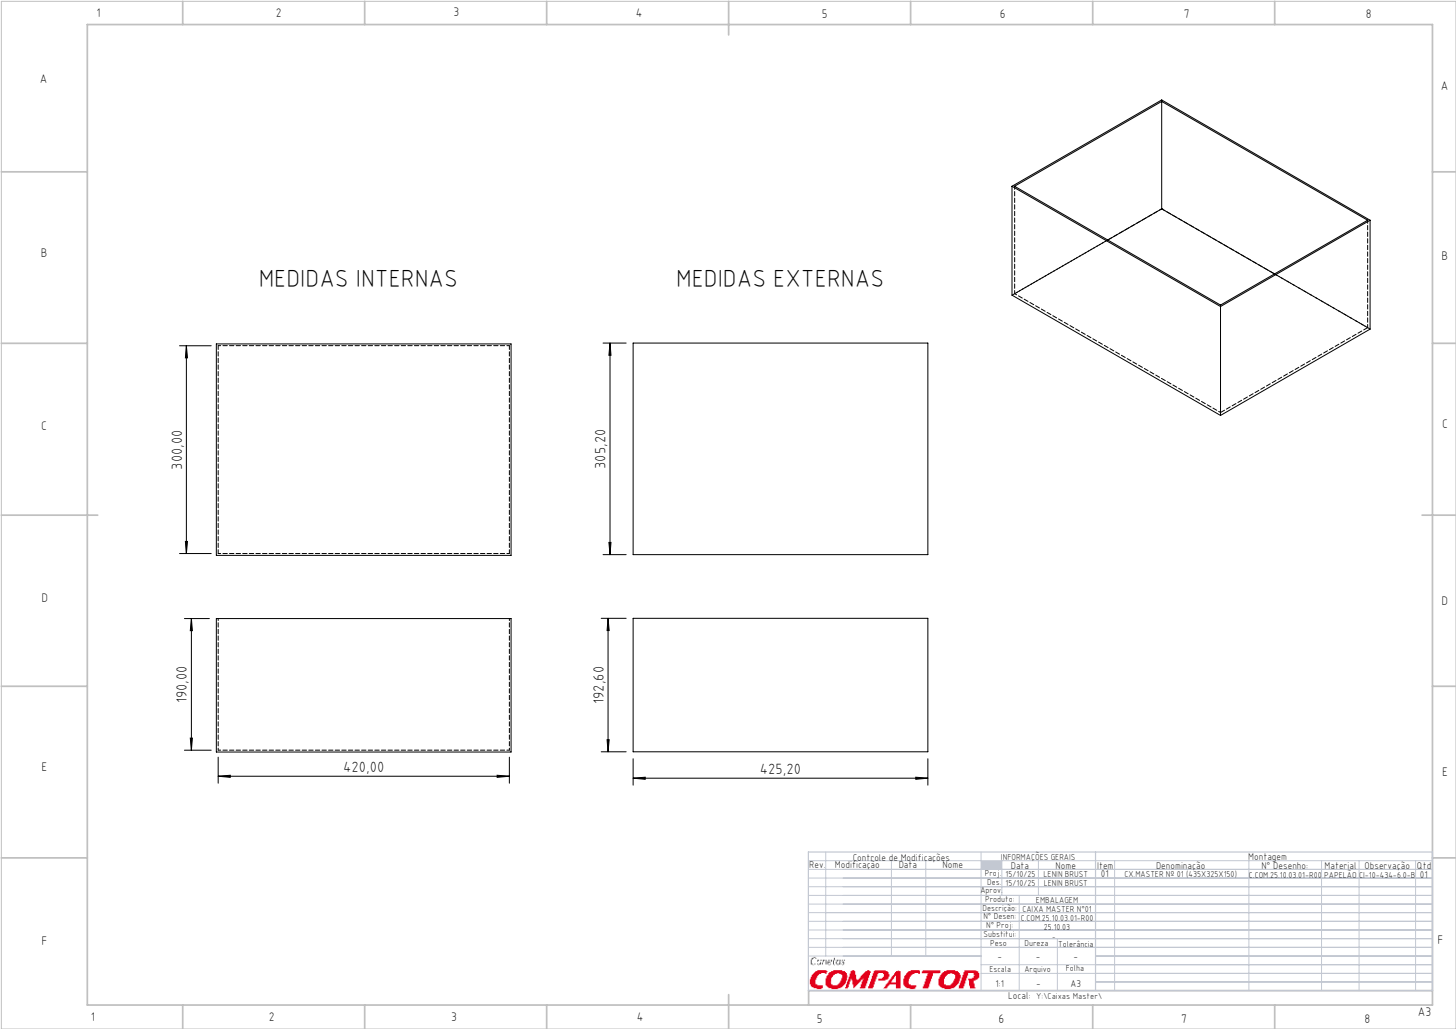
[picture p317: page 1]
MEDIDAS INTERNAS; MEDIDAS EXTERNAS

Controle de Modificações | INFORMAÇÕES GERAIS | Montagem

Rev. | Modificação | Data | Nome | | Data | Nome | Item | Denominação | N° Desenho: | Material | Observação | Qtd

Proj. | 15/10/25 | LENIN BRUST | 01 | CX.MASTER Nº 01 (435X325X150) | C.COM.25.10.03.01-R00 | PAPELÃO CI-10-434-6.0-B | | 01
Des. | 15/10/25 | LENIN BRUST
Aprov.
Produto: | EMBALAGEM
Descrição: | CAIXA MASTER N°01
N° Desen: | C.COM.25.10.03.01-R00
N° Proj: | 25.10.03
Substitui: | -
Peso | Dureza | Tolerância
Escala | Arquivo | Folha
1:1 | - A3

Local: Y:\Caixas Master\
