LcAvila/grade_moldes/src/main/webapp/assets/Produtos/00-00 - BASE DE DADOS/Embalagens/Caixas Master/25.10.03.100-R00 - 17081 - Caixa Master N°120 (Desenho Técnico).PDF

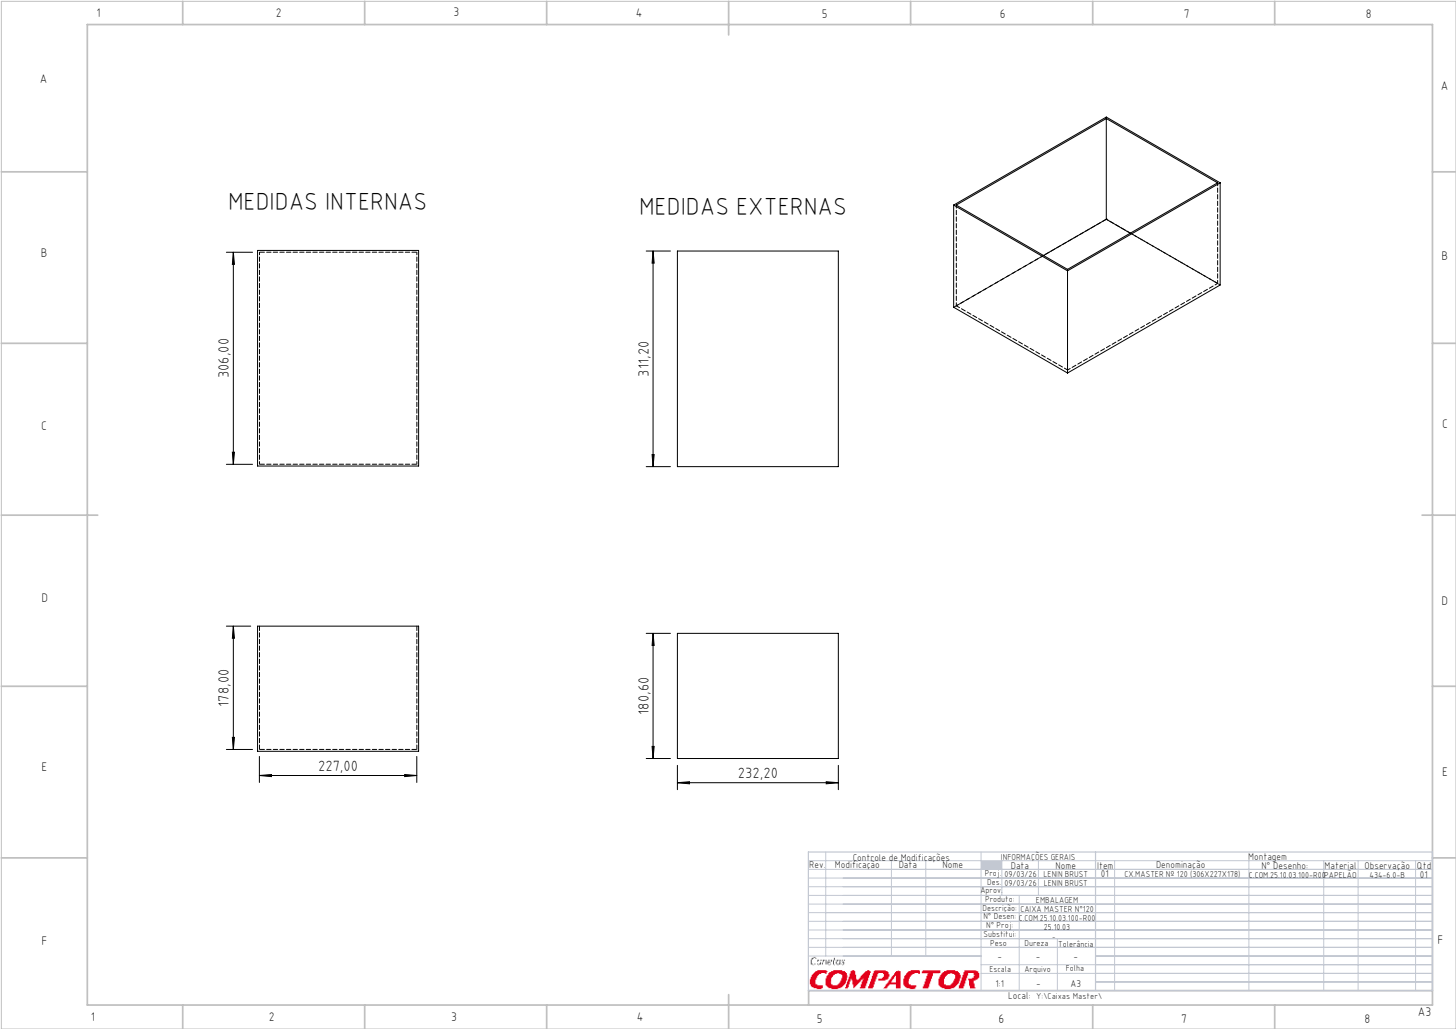
[picture p326: page 1]
MEDIDAS INTERNAS; MEDIDAS EXTERNAS

Controle de Modificações | INFORMAÇÕES GERAIS | Montagem

Rev. | Modificação | Data | Nome | | Data | Nome | Item | Denominação | N° Desenho: | Material | Observação | Qtd

Proj. | 09/03/26 | LENIN BRUST | 01 | CX.MASTER Nº 120 (306X227X178) | C.COM.25.10.03.100-R00 | PAPELÃO | 434-6.0-B | 01
Des. | 09/03/26 | LENIN BRUST
Aprov.
Produto: | EMBALAGEM
Descrição: | CAIXA MASTER N°120
N° Desen: | C.COM.25.10.03.100-R00
N° Proj: | 25.10.03
Substitui: | -
Peso | Dureza | Tolerância
Escala | Arquivo | Folha
1:1 | - A3

Local: Y:\Caixas Master\
