LcAvila/grade_moldes/src/main/webapp/assets/Produtos/00-00 - BASE DE DADOS/Embalagens/Caixas Master/25.10.03.102-R00 - 17109 - Caixa Master N°122 (Desenho Técnico).pdf

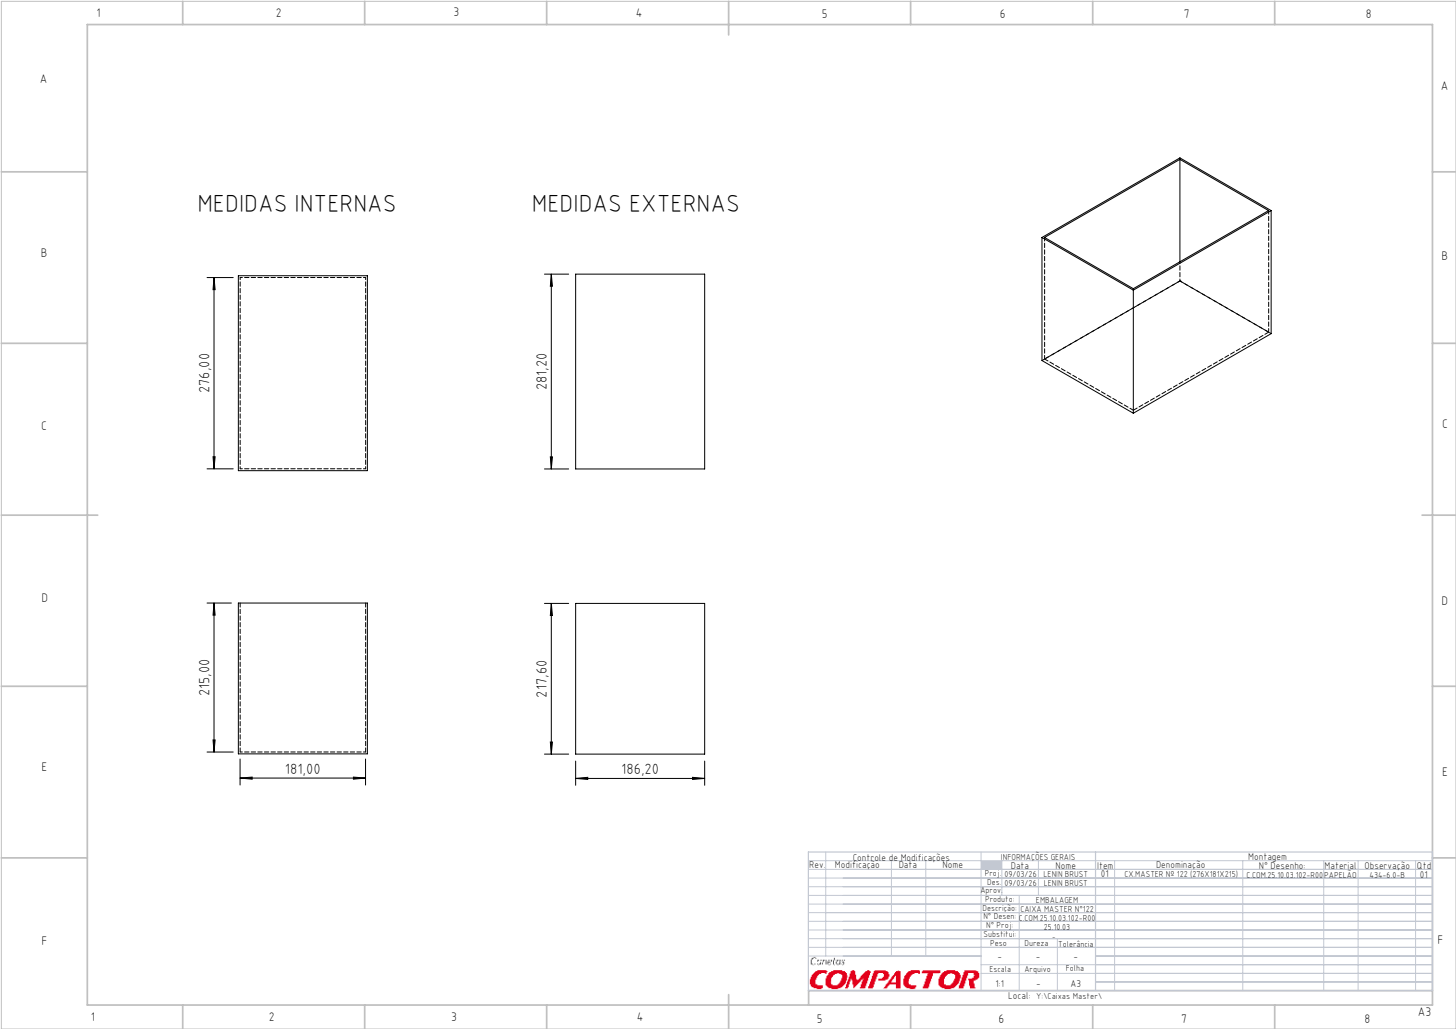
[picture p328: page 1]
MEDIDAS INTERNAS; MEDIDAS EXTERNAS

Controle de Modificações | INFORMAÇÕES GERAIS | Montagem

Rev. | Modificação | Data | Nome | | Data | Nome | Item | Denominação | N° Desenho: | Material | Observação | Qtd

Proj. | 09/03/26 | LENIN BRUST | 01 | CX.MASTER Nº 122 (276X181X215) | C.COM.25.10.03.102-R00 | PAPELÃO | 434-6.0-B | 01
Des. | 09/03/26 | LENIN BRUST
Aprov.
Produto: | EMBALAGEM
Descrição: | CAIXA MASTER N°122
N° Desen: | C.COM.25.10.03.102-R00
N° Proj: | 25.10.03
Substitui: | -
Peso | Dureza | Tolerância
Escala | Arquivo | Folha
1:1 | - A3

Local: Y:\Caixas Master\
