LcAvila/grade_moldes/src/main/webapp/assets/Produtos/00-00 - BASE DE DADOS/Embalagens/Caixas Master/25.10.03.11-R00 - 15119 - Caixa Master N°13 (Desenho Técnico).pdf

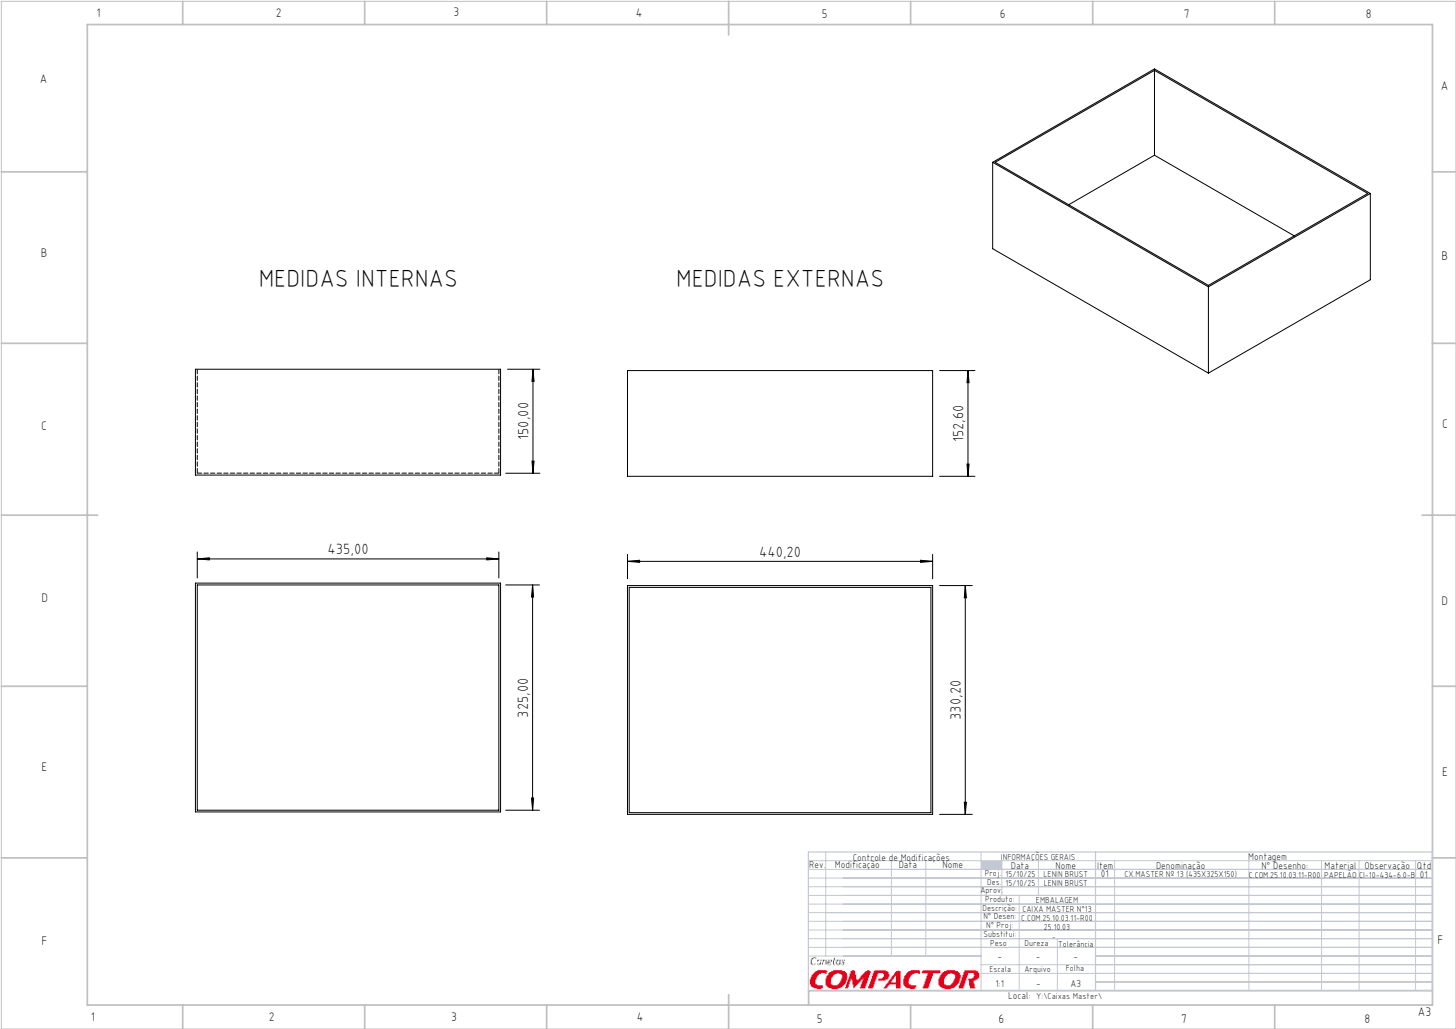
[picture p329: page 1]
MEDIDAS INTERNAS; MEDIDAS EXTERNAS

Controle de Modificações | INFORMAÇÕES GERAIS | Montagem

Rev. | Modificação | Data | Nome | | Data | Nome | Item | Denominação | N° Desenho: | Material | Observação | Qtd

Proj. | 15/10/25 | LENIN BRUST | 01 | CX.MASTER Nº 13 (435X325X150) | C.COM.25.10.03.11-R00 | PAPELÃO CI-10-434-6.0-B | | 01
Des. | 15/10/25 | LENIN BRUST
Aprov.
Produto: | EMBALAGEM
Descrição: | CAIXA MASTER N°13
N° Desen: | C.COM.25.10.03.11-R00
N° Proj: | 25.10.03
Substitui: | -
Peso | Dureza | Tolerância
Escala | Arquivo | Folha
1:1 | - A3

Local: Y:\Caixas Master\
