LcAvila/grade_moldes/src/main/webapp/assets/Produtos/00-00 - BASE DE DADOS/Embalagens/Caixas Master/25.10.03.32-R00 - 15837 - Caixa Master N°35 (Desenho Técnico).pdf

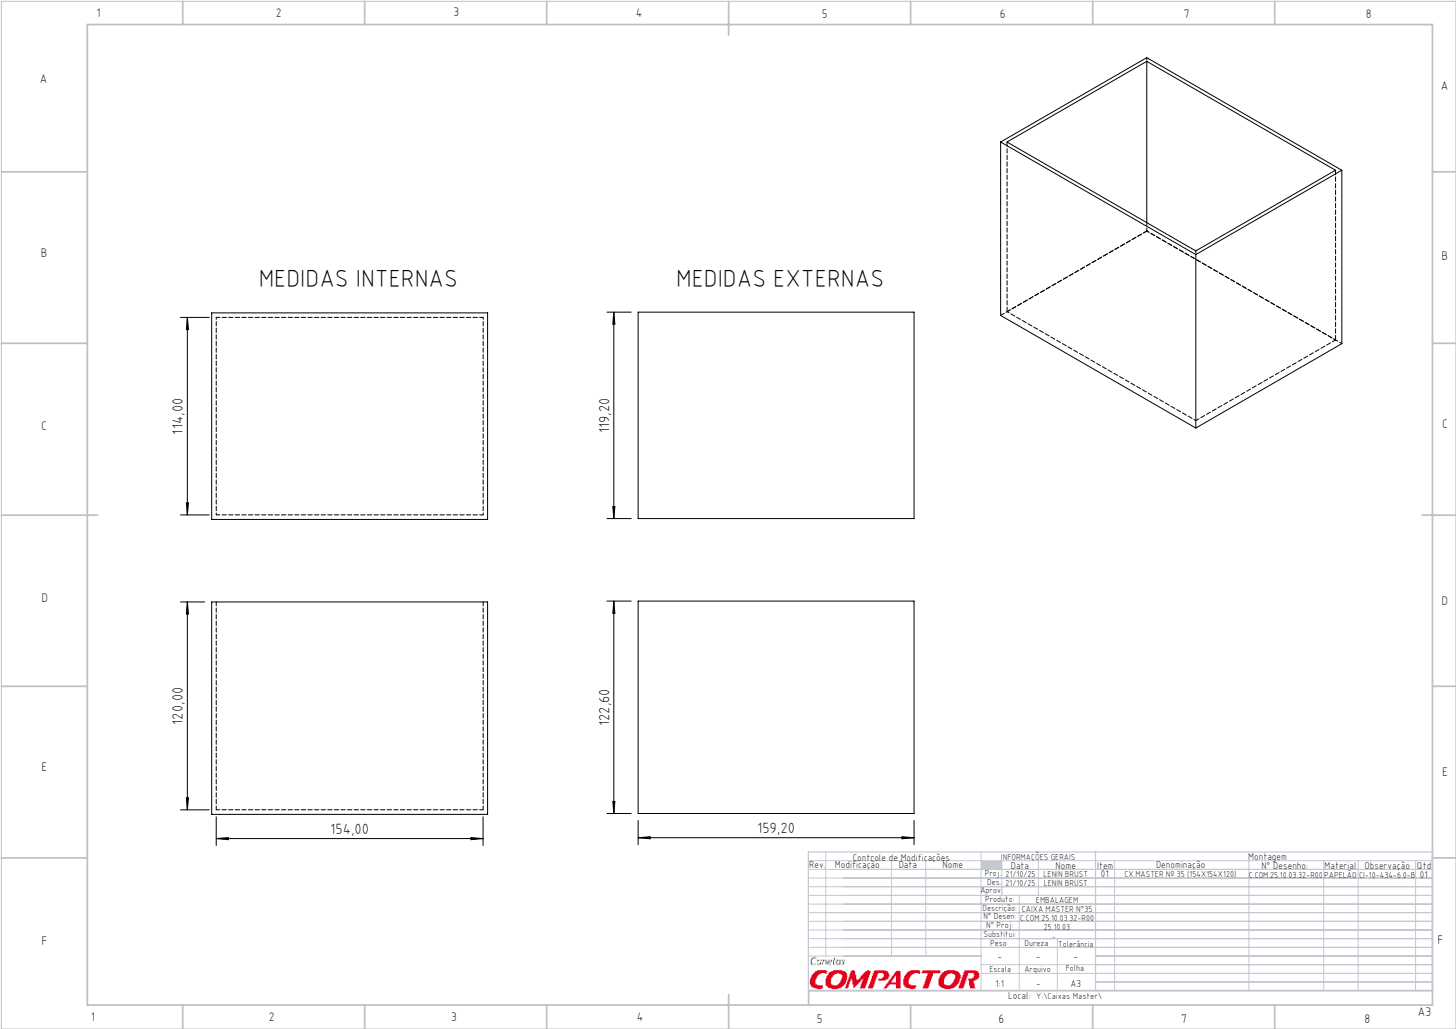
[picture p351: page 1]
MEDIDAS INTERNAS; MEDIDAS EXTERNAS

Controle de Modificações | INFORMAÇÕES GERAIS | Montagem

Rev. | Modificação | Data | Nome | | Data | Nome | Item | Denominação | N° Desenho: | Material | Observação | Qtd

Proj. | 21/10/25 | LENIN BRUST | 01 | CX.MASTER Nº 35 (154X154X120) | C.COM.25.10.03.32-R00 | PAPELÃO CI-10-434-6.0-B | | 01
Des. | 21/10/25 | LENIN BRUST
Aprov.
Produto: | EMBALAGEM
Descrição: | CAIXA MASTER N°35
N° Desen: | C.COM.25.10.03.32-R00
N° Proj: | 25.10.03
Substitui: | -
Peso | Dureza | Tolerância
Escala | Arquivo | Folha
1:1 | - A3

Local: Y:\Caixas Master\
