LcAvila/grade_moldes/(commit log)

2026-10-15 Initial commit: CustomFusionWeb - controle de cavidades nao conformes (tela de grades, persistencia por grade e configuracao de moldes)
2026-10-29 feat: adicionado uma nova forma de visualizar a peça com arquivos CAD, e foi padronizado os svg da grade
2026-11-03 feat: alterações no modal de cadastro de molde
